Ha22yX/Gridopoly/Mechanical/BoardBase/README.md

# Gridopoly 棋盘底板

## 当前交付：16 模块中空环形底板 Full16 R1

2026-10-15，用户提供三张实装照片，确认原三模块角落底板“完美兼容”；同时明确中央留空，允许分成两块或四块打印后稳固拼合。本轮采用 **4 个相同 L 形主件＋8 片连接片**，保持原 R2 孔位、16 mm 板底高度与底面平整设计。每主件承载一角三长；完整环为四角十二长，每边含共享角落共五块。

完整打印及装配说明见 [Full16_R1/README.md](Full16_R1/README.md)。文件入口：[Full16 R1交付目录](deliverables/Gridopoly_BoardBase_Full16_R1/) · [L形主件3MF](deliverables/Gridopoly_BoardBase_Full16_R1/01_L_Quarter_PRINT_4.3mf?raw=true) · [连接片3MF](deliverables/Gridopoly_BoardBase_Full16_R1/02_Splice_Bridge_PRINT_8.3mf?raw=true) · [可编辑Blender工程](deliverables/Gridopoly_BoardBase_Full16_R1/Gridopoly_Full16_R1.blend?raw=true) · [完整归档ZIP](deliverables/Gridopoly_BoardBase_Full16_R1.zip?raw=true)。主框 366 mm 见方，包含外侧连接耳的最大尺寸 406 mm 见方；每个主件 171.35 × 234.35 × 16.8 mm。中央名义 190 mm 见方开口，内侧连接耳局部伸入开口。

三模块实装反馈与新整盘状态分别记录：**原角落首件配合已由用户确认；新整盘的长—长接缝、整圈闭合及拼接承载仍待实装**。历史 R2 检查报告保留其生成时的未打印标志，不回写成新的实测数据。以下为已通过角落试装的 R2 几何与紧固件基线。

## 项目内模型与历史归档

全部底板设计、打印文件、可编辑工程和说明保存在仓库的 `Mechanical/BoardBase/` 内，以下使用可随仓库分发的相对链接；后续版本也按此规则保存，Downloads只作为可选分发副本。以下归档从原交付逐文件复制并核对，原模型、ZIP及冻结检查记录保持不变；包内旧Downloads路径仅记录当时的生成位置。历史STL/3MF保留用于比较和复现，公开文件不表示该历史版本适合新打印。

| 版本 | 项目内入口 | 使用状态 |
|---|---|---|
| Full16 R1 | [目录](deliverables/Gridopoly_BoardBase_Full16_R1/) · [ZIP](deliverables/Gridopoly_BoardBase_Full16_R1.zip?raw=true) | 当前16模块方案；全环打印、试装及拼接承载待验证 |
| 三模块R2 | [目录](deliverables/Gridopoly_BoardBase_Test_R2_PRINT_FRIENDLY/) · [ZIP](deliverables/Gridopoly_BoardBase_Test_R2_PRINT_FRIENDLY.zip?raw=true) | 用户已确认角落实装兼容的基线 |
| 三模块R1 | [历史目录](deliverables/Gridopoly_BoardBase_Test_R1_ONE_PIECE/) · [历史ZIP](deliverables/Gridopoly_BoardBase_Test_R1_ONE_PIECE.zip?raw=true) | 旧底面螺母槽方案，已被R2取代，不作为当前打印依据 |
| R0 | [历史目录](deliverables/Gridopoly_BoardBase_Test_R0/) | 已废弃的独立模块底座，不打印 |

## 三模块首件 R2 基线

基线版本：**R2_PRINT_FRIENDLY，几何复核通过，用户已确认角落实装配合正常**。保持一块连续 L 形底板，固定一个角落 PCB 和相邻两块长边 PCB；每板两颗对角螺丝。12 根支撑柱与底板一体打印，其中 6 根锁紧、6 根辅助承托和定位。照片没有确定所用螺钉的具体牙型、垫片厚度或抗拔强度。

针对 R1 底部螺母槽的槽顶悬空问题，R2 **取消全部底面螺母槽及螺丝通孔，改为从柱顶进入的盲孔与塑料专用螺钉**。打印时平底贴床、柱子向上，底板及柱子由下向上连续生长；不再依赖槽顶桥接。R1 保留归档，不再作为本版紧固件或打印说明。R0 独立模块底座及滑动连接方案仍已废弃。完整 16 模块继续要求一个整体底板、每模块固定位置。

## 交付文件

项目内交付目录：[Gridopoly_BoardBase_Test_R2_PRINT_FRIENDLY](deliverables/Gridopoly_BoardBase_Test_R2_PRINT_FRIENDLY/)；[完整归档ZIP](deliverables/Gridopoly_BoardBase_Test_R2_PRINT_FRIENDLY.zip?raw=true)。

| 文件 | 用途 |
|---|---|
| 整体底板：[3MF](deliverables/Gridopoly_BoardBase_Test_R2_PRINT_FRIENDLY/ONE_PIECE_Corner_Test_R2.3mf?raw=true) / [STL](deliverables/Gridopoly_BoardBase_Test_R2_PRINT_FRIENDLY/ONE_PIECE_Corner_Test_R2.stl?raw=true) | 整体底板打印模型，毫米单位、100% 比例；3MF 不含打印机或耗材预设 |
| 试孔片：[3MF](deliverables/Gridopoly_BoardBase_Test_R2_PRINT_FRIENDLY/Screw_Fit_Coupon_R2.3mf?raw=true) / [STL](deliverables/Gridopoly_BoardBase_Test_R2_PRINT_FRIENDLY/Screw_Fit_Coupon_R2.stl?raw=true) | 可选的螺钉试孔片，先用实际 PLA 与螺钉选择孔径；不是单模块底座 |
| [Gridopoly_OnePiece_Corner_Test_R2.blend](deliverables/Gridopoly_BoardBase_Test_R2_PRINT_FRIENDLY/Gridopoly_OnePiece_Corner_Test_R2.blend?raw=true) | 可编辑场景；默认仅显示打印底板，PCB 参考对象隐藏，可在 Outliner 中取消隐藏；参考对象不打印 |
| `fixture_frame.png` / `fixture_assembled.png` | 底板及装板示意 |
| `mounting_post_section.png` | 实际模型柱截面，说明顶开盲孔和实心底部；仅供查看 |
| `fixture-config.json` / `rebuild_in_blender.py` | 参数及重建来源；重建时新建 R2 场景，保留原有 R1 场景 |
| `verification-report.json` / `assembly-verification.json` | 本版导出网格及装配几何复核记录，须以文件实际版本和状态为准 |
| `README.md` | 本说明 |

不要把 Blender 中的参考 PCB、螺钉、相机或背景地面一起导出打印。试孔片与底板分别导出，避免误认为两个零件需要拼装。

## 尺寸与孔柱

| 项目 | R2 名义值 |
|---|---|
| 底板外接尺寸 | 151 × 151 mm，L 形连续实体 |
| 平板厚度 | 3.5 mm，底面平整、无螺母槽 |
| PCB 底面离桌面 | 16 mm |
| PCB 板厚 | 用户提供约 1.6 mm |
| 最大打印高度 | 16.8 mm，包含未锁紧孔内的定位销 |
| 支撑柱与 PCB 接触外径 | 6 mm |
| 六个锁紧柱盲孔 | 候选直径 2.5 mm，从柱顶向下深 10 mm，孔底距桌面 6 mm |
| 盲孔顶端导向沉孔 | 直径 3.6 mm、深 1.2 mm；孔周接触环保持外径 6 / 内径 3.6 mm |
| 辅助定位销 | 直径 2.8 mm、高 0.8 mm |
| 辅助承托 | 每板第三点与主柱等高；第四点低 0.2 mm，避免四点硬顶 |
| 最大板底突出 | 用户测得两种模块均约 8.1 mm |
| 元件与底板顶面的名义余量 | 16 − 8.1 − 3.5 = **4.4 mm** |

按 PCB 接口文件的原方向、器件面俯视：角落板锁紧左上 TL 和右下 BR；长边板各锁紧右上 TR 和左下 BL。PCB 在底板上旋转后，仍使用其本板对应的这两个孔。孔柱坐标、板间候选间距和一体底板关系均沿用 R1。

## 紧固件与先试孔

- **塑料专用盘头自攻／螺纹成形螺钉：6 颗**，公称螺纹外径 **3.0 mm**、头下长度 **10 mm**，头部外径不超过 **6 mm**。这不是原 R1 的 M3 机螺钉；不要按“M3×10 机螺钉”代购，也不用沉头螺丝压 PCB。
- **垫片：6 片**，内径约 **3.2 mm**、外径不超过 **6 mm**、厚 **1.0 mm**。两片 0.5 mm 可叠为一组，此时共需 12 片。
- **不使用螺母**，也不需要底板拼接螺丝。

名义入柱深度为 10 − 1.6 − 1.0 = **7.4 mm**；扣除顶部 1.2 mm 导向段后，位于小孔段的长度为 **6.2 mm**，实际完整牙型啮合还须扣除螺钉尖端。盲孔底名义余量为 10 − 7.4 = **2.6 mm**。这些为尺寸链计算，不是拧紧或抗拔实测。

**2.5 mm 是待试配的孔径，不代表适合所有 3 mm 螺钉。** 孔径要随塑料、牙型及打印结果选择；[TR 塑料螺钉安装指南](https://www.trfastenings.com/knowledge-base/fasteners-for-plastic/plas-tech-30-installation-guide)也按具体材料和螺钉几何给出孔径建议，其表格不是本 PLA 打印件的验证结果。

建议先打印 **34 × 14 × 16 mm** 的试孔片。三个柱中心依次为 (6,7)、(17,7)、(28,7) mm，孔径依次为 **2.4、2.5、2.6 mm**；(0,0) 角的缺角靠近 **2.4 mm** 端。使用将要装配的同一螺钉，并用约 2.6 mm 的非 PCB 垫块模拟板厚及垫片，控制入柱深度。徒手缓慢试拧，选择能够形成螺纹、轻夹紧且不劈裂或滑牙的孔；不可大力拧入代替选孔。若 2.5 mm 不合适，先改底板孔径再重印，不能整体缩放底板。此结构不适合频繁拆装。

## H2D / PLA 首印

底板平面贴床、柱子向上，保持毫米单位和 100% 比例。151 × 151 mm 可在 H2D 上平放。按 0.4 mm 喷嘴给出起始建议：0.20 mm 层高、4 道墙、顶底各 5 层、约 20% 填充；实际以所用 PLA 和喷嘴配置为准。

R2 从结构上取消了底部槽顶桥接，按无需全局支撑的方向设计；仍需在 Bambu Studio 逐层预览检查柱根、盲孔、导向口与定位销，并确认没有悬空的参考 PCB 被误导入。必要时可加约 5 mm 外侧裙边来降低大平底翘曲。清除毛边后再试装，不要改变整体比例。

原始交付时未执行 Bambu Studio 切片或实打印；2026-10-15 用户随后提供打印件照片并确认角落配合正常。该反馈不能扩展为新 16 模块底板的切片、强度或全环实装通过。

## 首次试装

1. 先完成试孔片配合检查；底板打印冷却后确认平整、柱子无裂纹，孔内无毛边。
2. 先不通电，将一角两长 PCB 自然插好并保持共同板面。不装螺丝，三板应一起自由落到孔柱上；不能拉扯或压弯连接器来对孔。
3. 检查板底元件和焊点不碰底板，柱顶只接触孔周安全环面，USB/DC 等接口与工具仍有操作空间。渲染图不包含全部元件和插头。
4. 每板只在指定两个对角孔放垫片、装螺钉，交替缓慢轻拧到刚好夹紧。遇到显著阻力、柱裂或空转立即停止；不使用电动工具强拧，不靠锁紧力消除翘曲或孔位误差。
5. 检查三板仍共面、底板不摇晃、螺钉不顶穿孔底，接口可插拔。其余辅助柱无需螺钉。

**角落—长边的固定位置已由本次三模块实装反馈确认。** g = 9 mm 原先由用户约 12 mm（角落—长边）、15 mm（长边—长边）的主体直边间距扣除长边接口凸出量推算；新增长边—长边位置仍需在 Full16 R1 的一个 L 形主件上先试装。成功的角落首件不包含长—长接缝，也不等于完整闭环已验证。本设计没有滑块或可调安装位置。

## 检查状态与来源

R2 已独立复核本版导出物：主件为一个闭合连通实体，4944 个唯一顶点、9884 个三角面，尺寸 151 × 151 × 16.8 mm；试孔片也是一个闭合实体，1366 个唯一顶点、2728 个三角面，尺寸 34 × 14 × 16 mm。两者均无边界边、非流形边、反向接边或退化面。各 3MF 采用毫米单位、单对象，几何与对应 STL 一致，压缩包 CRC 检查通过。

按柱向上、沿 +Z 逐层打印的方向，除 z=0 贴床底面外，两件模型均未检测到向下悬挑面（侧壁浮点角度噪声容差 0.01°）。底板与三块带孔 PCB 参考板材的布尔相交体积各小于 1×10⁻¹³ mm³，属数值舍入级别。这些检查不等于切片、打印或元件实物配合验证，也不证明塑料螺纹强度。R1 的板框和孔位来源继续沿用；本段网格结果属于重新检查的 R2。

PCB 来源为长边 PCB2_1 / `7840864f79449b47` 和角落 PCB2_5 / `6f97d7be5a40dd66`。冻结接口从当前工程、Gerber 与钻孔文件核对板框、名义 Ø3.5 mm 安装孔和外径 6 / 内径 3.6 mm 的安全支撑环。111 个底部 XY 排除区仍缺逐件 Z，最高突出采用用户约 8.1 mm 的量测。

冻结数据：[mechanical-interface.json](interfaces/pcb-interface-2026-10-15/mechanical-interface.json)，SHA256：`e78d4cbc840f58c6564f7e6513c5992925e54811c4d39e5e01467c7390e53df6`。交接包内旧 14 mm 高度、可调支架或滑移建议被整体固定底板要求覆盖，原始包不改写。当前实板批次尚未与制造文件哈希绑定，必须通过首件确认实物配合。

## 完整 16 模块方案沿革

继续采用**拼合后整体承力的底板，固定 4 个角落和 12 个长边模块**。2026-10-15 用户已确认角落首件配合，并授权分块打印。

按 g = 9 mm，PCB 周边外宽为 2×80 + 3×54 + 4×9 = **358 mm**；加两侧各 4 mm 余边后主框约 **366 mm**，超过 H2D 常规单喷嘴平放范围 325×320 mm（[Bambu H2D 官方规格](https://cdn1.bambulab.com/documentation/h2d/en/H2D_Laser_Full_Combo_20250305.pdf)）。现已落实为 [Full16 R1 四块主件方案](Full16_R1/README.md)，每道拼缝由内、外两片连接片固定，底板自身承担拼接连接。原三模块文件保持不变，整盘新增模型单独检查和交付。
