Ha22yX/Gridopoly/Docs/gallery/README.md

# From my workbench / 实物照片集

[← English README](../../README.md) · [← 中文README](../../README.zh-CN.md) · [PCB files / PCB设计](../hardware/README.md) · [Print files / 打印模型](../../Mechanical/README.md)

From an empty circuit board to something I can pick up and play with. These are the real parts behind Gridopoly, including the awkward in-between stages.

从一块还没焊元件的PCB，到能拿在手里的棋盘。这些照片记录的是Gridopoly实际做出来的样子，也包括装配到一半的过程。

**All 11 photos added on October 18, 2026 are below.** Click a photo for a larger, unannotated JPEG. The photos show several prototype stages; use the hardware and model guides for current assembly files. Original HEIC files remain untouched; these web copies have been resized, converted to sRGB, and stripped of camera metadata.

**本次11张照片都在下面。** 点击可以查看较大的无标注JPEG。照片包含不同阶段的原型，复刻时请以硬件和模型文档为准。HEIC原文件没有改动；仓库提供缩放、转换为sRGB并移除拍摄元数据的网页版本。

## The whole board / 先看整盘

<table>
  <tr>
    <td align="center" valign="top">
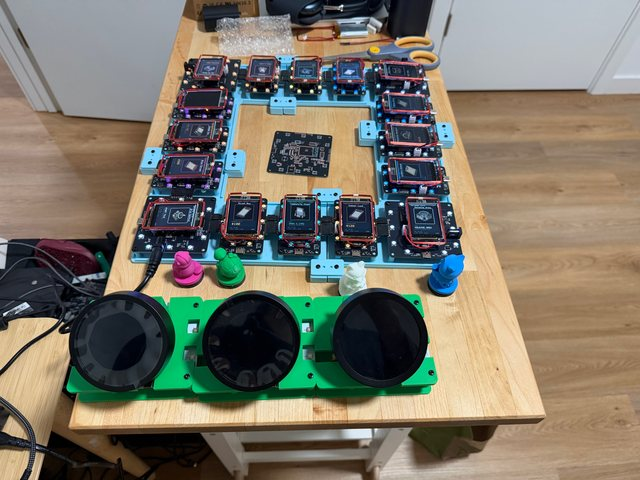
[picture p5: .github/assets/photos/2026-10-18/thumbs/gridopoly-workbench.jpg]
The powered 16-tile board, four pieces and three player consoles in this photo.
      <br />
      <strong>The board on my workbench<br />工作台上的整套原型</strong><br />
      <sub>The powered 16-tile board, four pieces and three player consoles in this photo.<br />照片里是已点亮的16格棋盘、4枚棋子和3台玩家控制器。<br />IMG_1957.HEIC</sub>
    </td>
    <td align="center" valign="top">
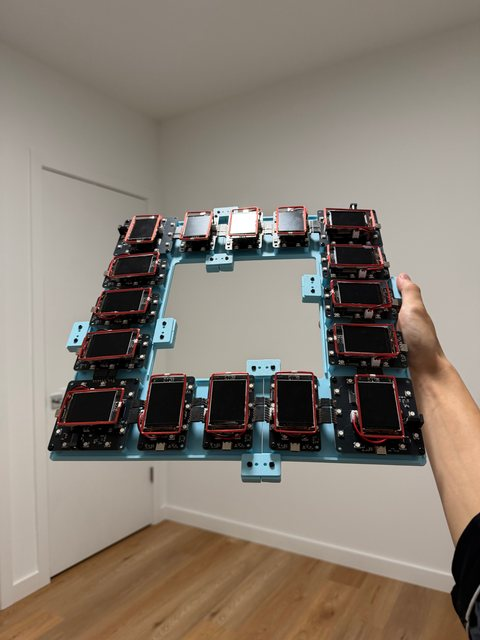
[picture p6: .github/assets/photos/2026-10-18/thumbs/assembled-board-frame.jpg]
The assembled board held upright, with the displays off.
      <br />
      <strong>Sixteen modules, one frame<br />16块模块，拼成一整盘</strong><br />
      <sub>The assembled board held upright, with the displays off.<br />竖起来看的整盘结构；拍摄时屏幕未点亮。<br />IMG_1949.HEIC</sub>
    </td>
  </tr>
</table>

## A controller of your own / 每个人的控制器

<table>
  <tr>
    <td align="center" valign="top">
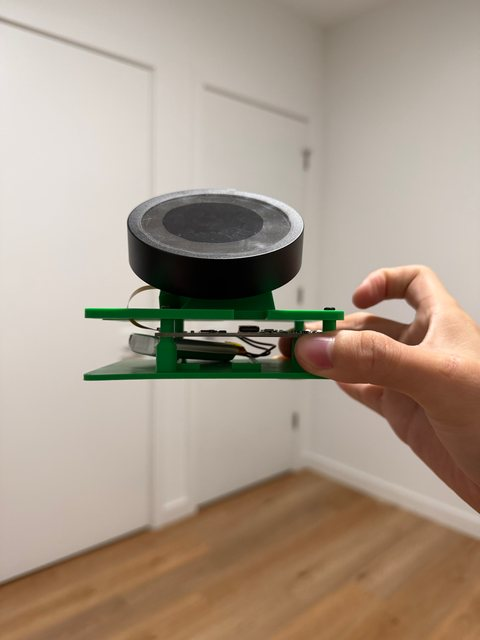
[picture p7: .github/assets/photos/2026-10-18/thumbs/player-console-side.jpg]
The round screen, power board and battery share one printed stand.
      <br />
      <strong>A controller, from the side<br />玩家控制器的侧面</strong><br />
      <sub>The round screen, power board and battery share one printed stand.<br />圆屏、供电板和电池装进同一套打印支架。<br />IMG_1947.HEIC</sub>
    </td>
    <td align="center" valign="top">
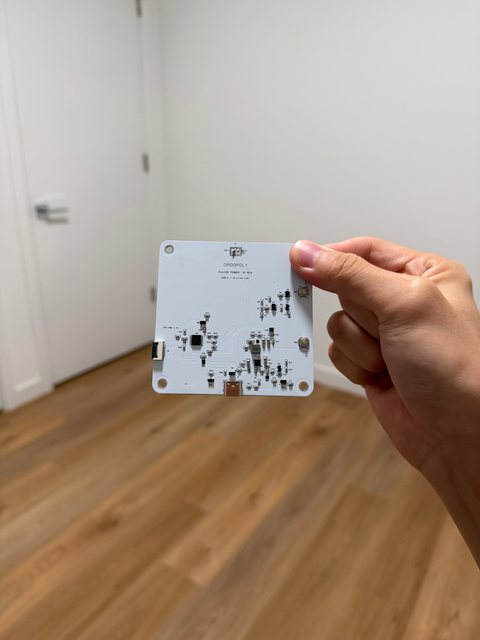
[picture p8: .github/assets/photos/2026-10-18/thumbs/player-power-board.jpg]
The photographed prototype is marked PLAYER POWER R1 RC4.
      <br />
      <strong>The player power board<br />玩家供电板</strong><br />
      <sub>The photographed prototype is marked PLAYER POWER R1 RC4.<br />照片中的原型板标有PLAYER POWER R1 RC4。<br />IMG_1951.HEIC</sub>
    </td>
    <td align="center" valign="top">
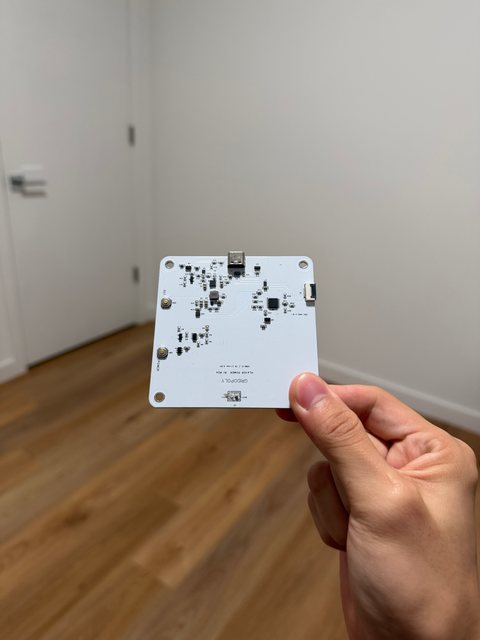
[picture p9: .github/assets/photos/2026-10-18/thumbs/player-power-board-reverse-view.jpg]
A close look at the player power PCB and its connectors.
      <br />
      <strong>Another look at the power board<br />换个角度看供电板</strong><br />
      <sub>A close look at the player power PCB and its connectors.<br />玩家供电PCB和接口的近照。<br />IMG_1950.HEIC</sub>
    </td>
  </tr>
</table>

## What goes into a tile / 拆开看一个格子

<table>
  <tr>
    <td align="center" valign="top">
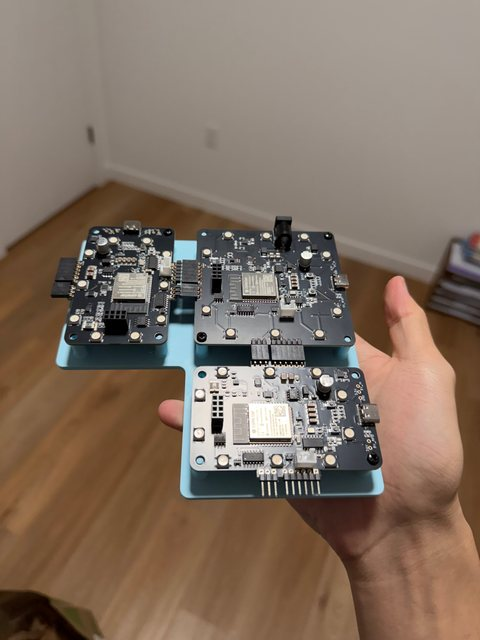
[picture p10: .github/assets/photos/2026-10-18/thumbs/tile-corner-assembly.jpg]
One corner PCB and two long tile PCBs on a printed base.
      <br />
      <strong>How a corner joins the board<br />角落与长边怎样相连</strong><br />
      <sub>One corner PCB and two long tile PCBs on a printed base.<br />一块角落PCB与两块长边PCB，固定在打印底座上。<br />IMG_1948.HEIC</sub>
    </td>
    <td align="center" valign="top">
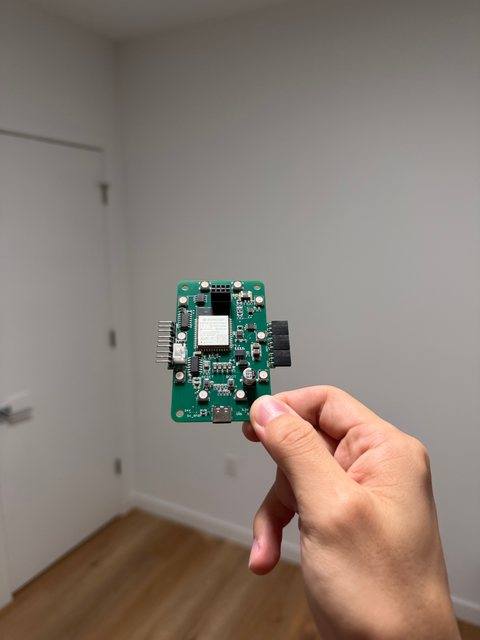
[picture p11: .github/assets/photos/2026-10-18/thumbs/long-tile-pcb.jpg]
The populated long tile PCB, with its ESP32 module and perimeter LEDs.
      <br />
      <strong>Before fitting the display<br />安装屏幕之前</strong><br />
      <sub>The populated long tile PCB, with its ESP32 module and perimeter LEDs.<br />焊好元件的长边PCB，可以看到ESP32模组和周围的LED。<br />IMG_1952.HEIC</sub>
    </td>
    <td align="center" valign="top">
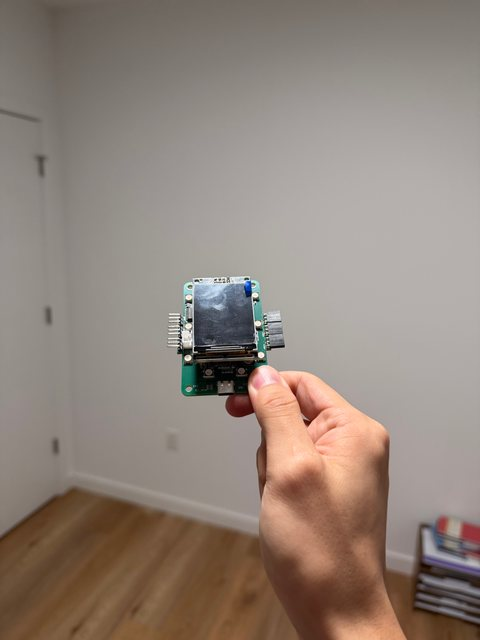
[picture p12: .github/assets/photos/2026-10-18/thumbs/long-tile-with-display.jpg]
The same style of long tile module with the LCD in place.
      <br />
      <strong>With the display fitted<br />装上屏幕之后</strong><br />
      <sub>The same style of long tile module with the LCD in place.<br />长边模块装上LCD后的样子。<br />IMG_1953.HEIC</sub>
    </td>
  </tr>
  <tr>
    <td align="center" valign="top">
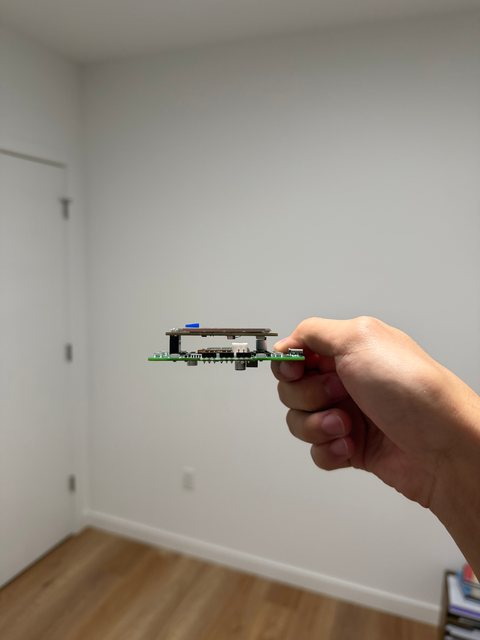
[picture p13: .github/assets/photos/2026-10-18/thumbs/tile-display-side.jpg]
A side view of the LCD, PCB and mounting standoffs.
      <br />
      <strong>A little space underneath<br />屏幕下面留出的空间</strong><br />
      <sub>A side view of the LCD, PCB and mounting standoffs.<br />从侧面看LCD、PCB和安装支柱之间的距离。<br />IMG_1954.HEIC</sub>
    </td>
    <td align="center" valign="top">
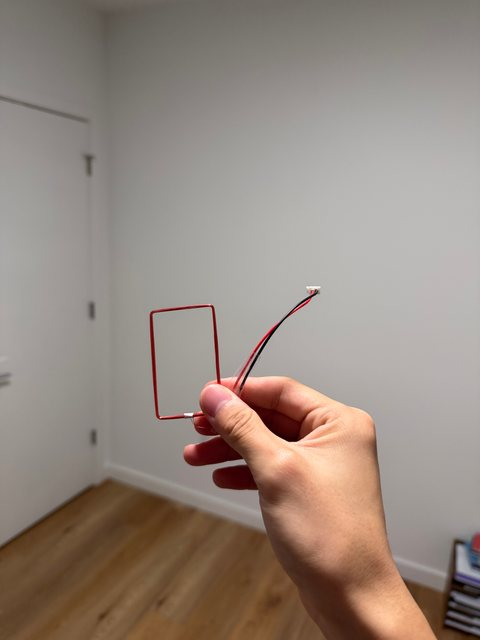
[picture p14: .github/assets/photos/2026-10-18/thumbs/rfid-coil.jpg]
The rectangular RFID antenna before mounting around a display.
      <br />
      <strong>The coil around each tile<br />每个格子的读卡线圈</strong><br />
      <sub>The rectangular RFID antenna before mounting around a display.<br />围到屏幕周围之前的矩形RFID天线。<br />IMG_1955.HEIC</sub>
    </td>
    <td align="center" valign="top">
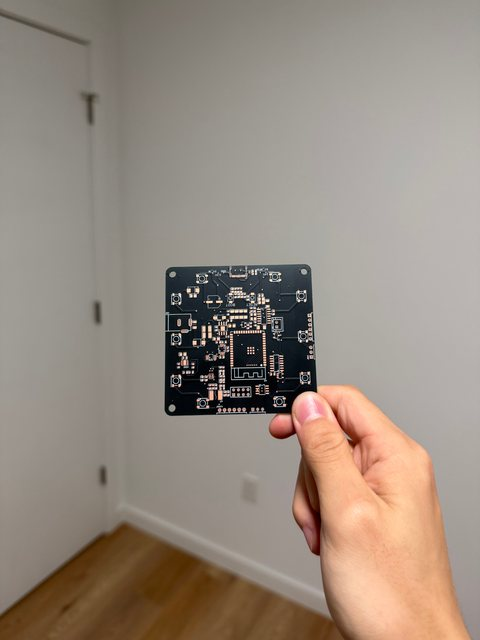
[picture p15: .github/assets/photos/2026-10-18/thumbs/unpopulated-tile-pcb.jpg]
An unpopulated tile PCB: the traces and component pads are visible.
      <br />
      <strong>Before the components go on<br />还没有焊上元件的时候</strong><br />
      <sub>An unpopulated tile PCB: the traces and component pads are visible.<br />尚未贴装的格子PCB，能看到走线和元件焊盘。<br />IMG_1956.HEIC</sub>
    </td>
  </tr>
</table>

## A few labels help / 加上引导线看结构

These are edited, annotated guides based on the real photos. The unannotated views above and below remain available for comparison. / 下面是基于实拍照片制作的标注版；上方和下方保留无标注版本，方便对照。

<table><tr>
<td width="33%" align="center"><a href="../../.github/assets/photos/2026-10-18/annotated/player-console-annotated.jpg">Player console / 玩家控制器, with component labels and leader lines</a><br /><strong>Player console / 玩家控制器</strong></td>
<td width="33%" align="center"><a href="../../.github/assets/photos/2026-10-18/annotated/tile-corner-annotated.jpg">Tile connections / 格子连接, with component labels and leader lines</a><br /><strong>Tile connections / 格子连接</strong></td>
<td width="33%" align="center"><a href="../../.github/assets/photos/2026-10-18/annotated/rfid-piece-annotated.jpg">Figure + tag / 角色与标签, with component labels and leader lines</a><br /><strong>Figure + tag / 角色与标签</strong></td>
</tr></table>

<details>
<summary><strong>Earlier build photos / 之前的开发照片（4张）</strong></summary>

<table>
<tr>
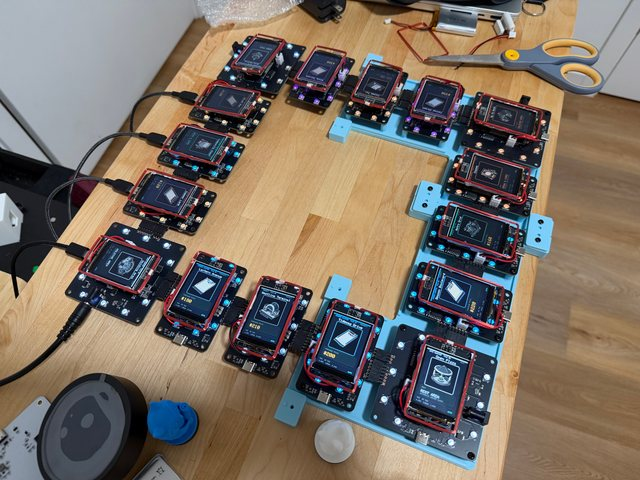
[picture p16: .github/assets/photos/2026-10-18/thumbs/gridopoly-16-tile-board-earlier.jpg]
An earlier workbench view / 早期整盘工作台照片
<td width="50%" align="center"><br /><sub>An earlier workbench view / 早期整盘工作台照片</sub></td>
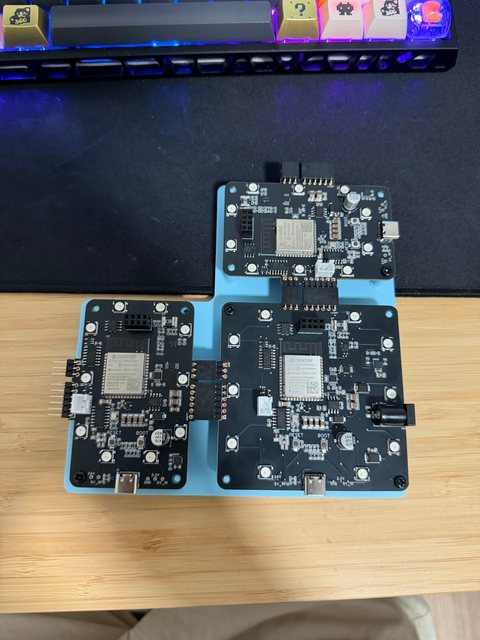
[picture p17: .github/assets/photos/2026-10-18/thumbs/gridopoly-pcbs-and-base-earlier.jpg]
Tile PCBs and a corner base / 格子PCB与角落底座
<td width="50%" align="center"><br /><sub>Tile PCBs and a corner base / 格子PCB与角落底座</sub></td>
</tr>
<tr>
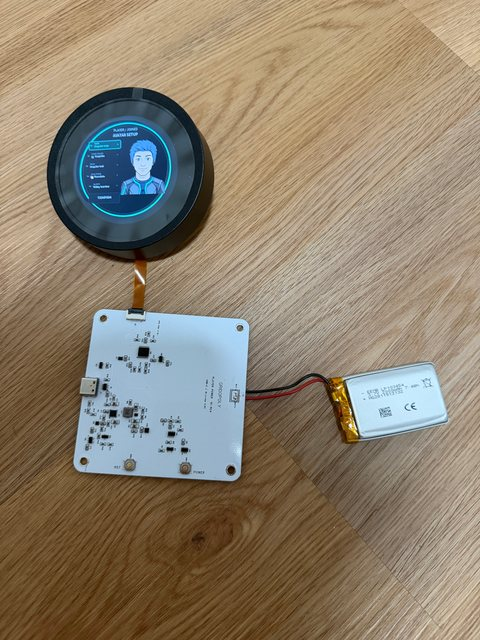
[picture p18: .github/assets/photos/2026-10-18/thumbs/gridopoly-player-console-and-power-earlier.jpg]
Player screen, PCB and battery / 玩家屏、供电板和电池
<td width="50%" align="center"><br /><sub>Player screen, PCB and battery / 玩家屏、供电板和电池</sub></td>
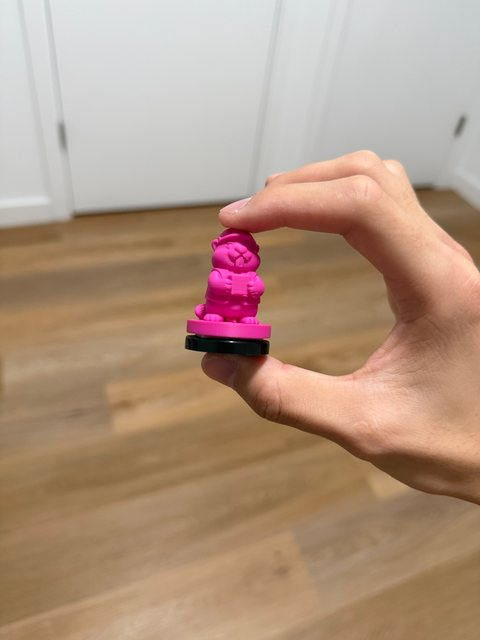
[picture p19: .github/assets/photos/2026-10-18/thumbs/gridopoly-rfid-piece-earlier.jpg]
Printed figure and RFID tag / 打印角色与RFID Tag
<td width="50%" align="center"><br /><sub>Printed figure and RFID tag / 打印角色与RFID Tag</sub></td>
</tr>
</table>

</details>

[Photo sources and editing notes / 照片来源与标注说明](../../.github/assets/photos/README.md) · [Back to the documentation / 返回文档中心](../README.md)
