Ha22yX/Gridopoly/Firmware/TileModule/README.md

# Gridopoly 单格模块正式固件

这是格子模块的正常游戏固件工程。当前源码候选版本为 V0.37，增加地产建房图的RAM按需下载，保留V0.36屏幕旋转180°、V0.35低亮灯效、板型配置、ORDER直邻信标与权威RFID配对（含Tag发布重试）、WS2812B-B-V6时序和有界灯光维护：模块上电后连接树莓派专用热点，
通过HTTP心跳注册、接收显示状态并上报实际ORDER上游。RS485仍未启用。
测试程序仍独立保存在 `Firmware/TileModuleTests/`，不得把循环跑灯、纯色屏幕等
首板测试流程并入本工程。

正式 ESP32-S3 构建明确排除 `demo_engine.cpp`；该文件只保留给 native 状态模型测试，
不会进入格子模块正式固件，也不会在未分配时生成任何本地地产页面。

## V0.37 建房图 RAM 缓存

0级图及非地产图继续嵌入固件，不请求新资源。只有当前已分配地产的`artworkKey`＋`buildingLevel=1..5`进入下载，1～4为房屋、5为旅馆；不会按地图序号选图，也不在分配时预抓五级。权威`assignment.buildingLevel`缺失兼容为0，非整数或超出0～5拒绝；无主及非地产投影为0。

图片路径固定为`/assets/development/v1/tile/{artworkKey}-l{level}.rgb565`，HTTP主机/端口和心跳共用`tile_http_endpoint.h`及本地配置。独立单worker只保留一个在途请求，初始250～2000ms错峰，失败1s起指数退避到30s加jitter，并尊重503/429的Retry-After。离线不启动HTTP，重连错峰；切换地产、退回0级和重复心跳不能清除服务端退避。

160×160 RGB565 LE图必须有精确51200字节Content-Length和共享目录中的CRC；不接受压缩、分块、截断或错误图。最多5张ready＋1张staging，图像PSRAM payload上限307200字节（栈/队列/HTTP对象另计），仅RAM保存，重启清空。下载线程只写staging，主显示线程核对选择代号后发布；切换期间的旧结果丢弃，绘图lease防止LRU回收正在读取的图。分配失败或HTTP错误保留固件0级图和准确等级徽标，不阻塞主循环等网络。

`ART PROBE a1-rivet-row 1`使用同一生产worker/CRC/缓存，显示明显TEST预览，30秒后恢复最新权威页面；可换成目录中任一地产key与1～5级。`ART STATUS`输出请求、发布、命中、内存和失败情况；`ART STOP`立即恢复。该有界本地预览不修改分配、资产、Tag或服务器状态，也不暂停RFID/ORDER。内存按需分配后保留复用，所以`peak_ram`等于当前分配图像字节数。

普通候选仍基于已部署V0.36隔离源码叠加本轮差异，排除共享树中旧COM8 stage2诊断。导出清单记录两份共享头的哈希；若直接用含诊断的共享main构建，清单会标记`normalFirmware=false`，不得用于普通批量更新。测试、候选及实物边界见[专项报告](../../Docs/firmware/tile-development-artwork-cache-2026-10-16.md)。

## V0.36 屏幕方向与恢复（V0.37保留）

`board_config.h`统一指定硬件`kDisplayRotation=2`；LCD和逻辑页面均保持240×320，页面及底栏canvas固定rotation0。整页差分、160×160图片、底栏局部刷新、无PSRAM直接绘制及诊断页均交由同一ST7789方向寄存器旋转，不倒序像素、不交换宽高或额外平移坐标。

已核对固定Adafruit ST7735/ST7789 1.11.0实现：240×320的两组行列偏移均为0；rotation0的MADCTL为MX|MY|RGB，rotation2为RGB，MV不置位。初始化和`DISPLAY SAFE`/恢复时都先在8MHz写入rotation2，再恢复所选绘图速率；显示shadow随控制器初始化失效，下一次提交完整页面。默认SPI仍8MHz，背光保持150。

初始化及`STATUS`新增`DISPLAY-ORIENTATION`，正常应为`rotation=2 degrees=180 width=240 height=320 canvas_rotation=0 footer_rotation=0`。该记录是驱动软件状态，并非LCD寄存器读回或实物方向验收。正常long/corner候选由`59efe7a`基线叠加`5522d179`已提交低亮变更与本次方向/版本差异生成，不含COM8 stage2 RFID诊断；旧V0.35候选和冻结包保留。实际写验、方向/裁切/亮度目视由设备台账另记，构建通过不等于已部署。

## V0.35 灯环亮度与维护（V0.36保留）

所有正常灯效在原有颜色和动画计算后统一缩为V0.34驱动幅值的四分之一（整数向下取整），覆盖连接/故障、地区/所有者/占用、出发/目标及全部配对状态。目标双闪峰值由RGB(23,62,51)变为(5,15,12)，配对成功由(11,54,23)变为(2,13,5)，出发峰值由(59,35,18)变为(14,8,4)；周期和优先级不变。低于4的旧输出量化为0，目标双闪间隔因此为全黑。实际观感需单板目视，不能把驱动幅值比例当作测得的视觉亮度。

`showPixels`在所有发送前强制每通道不超过16/255；当前正常场景的实际最大通道为15/255。维护RGB仍固定8/255并通过同一硬上限，不重复乘四分之一。`kMaximumLedChannel`现在是执行中的上限，V0.34中它只有定义/测试约束，不能只改旧常量就认为已经调暗。没有远程亮度API，`BRIGHTNESS`仍只控制LCD，本轮没有提高背光。

本轮normal long/corner低亮候选从已部署`59efe7a`源基线叠加LED变更独立构建、默认8MHz，不包含COM8的stage2 RFID试读入口。工作区保留该独立诊断源码；直接从当前完整工作区重构建与本轮隔离候选不等价，应核对candidate源码清单。V0.35构建时16板仍为V0.34；2026-10-16开始V0.36逐板升级，实际版本与目视结果见[本次更新](../../Docs/firmware/tile-display-rotation-2026-10-16.md)，旧冻结包不回写。

采用实际 WS2812B-B-V6 数据表的参数：RMT计数16MHz/62.5ns，0码高312.5ns/低937.5ns，1码高625ns/低625ns，显式帧间低电平350µs。V0.33的1码低电平500ns低于该型号580ns最小值；原常规50ms帧间隔已经满足复位时间，不把原80µs显式延时说成所有帧均未复位。

原生ESP-IDF RMT后端核对实际计数时钟，记录初始化、写入、20ms完成等待和停止错误；发送失败后停止自动续发。`STATUS`或`LED STATUS`输出requested_rgb、实际计数时钟、attempted/completed/failed、错误阶段和维护剩余时间。completed仅表示外设完成，不证明数据线波形或实际灯色。

仅显式串口维护命令可以暂时覆盖游戏灯效：`LED OFF 1..30`秒输出全黑；`LED RED|GREEN|BLUE 1..30`秒固定单通道8/255，其余两通道为0；到期永久恢复当前游戏灯效，`LED AUTO`可以提前恢复。没有全白/高亮模式，不写NVS、房间、Tag或服务器分配，重启即回普通模式。未知参数和超长串口整行被拒绝，不执行截断前缀。`BRIGHTNESS`仍只控制LCD背光。

2026-10-15的新时序为软件修正候选，灯环纯白的具体实物根因仍需受控验证；构建或主机测试不能代替真实颜色、功耗及整盘验收。精确型号依据[厂家数据表第4页](https://atta.szlcsc.com/upload/public/pdf/source/20251224/2F6ED8FFFF9D3044AED3CCAA3E4BF0D9.pdf)。

## 当前功能

- ORDER_OUT经Q1开漏每6秒发送本机bootId/seq/CRC信标，GPIO10 LOW为释放，HIGH使下游线LOW；GPIO9经现有RC接收实际邻居信标，不使用Wi-Fi注册先后推断线序。
- 独立1ms定时状态机不等待HTTP或显示循环；超过6ms调度间断释放输出并弃帧，接收持续低150ms撤销上游；新有效帧15秒过期，同序号不会刷新证据。完整协议见 [ORDER协议](../../Docs/firmware/tile-order-protocol.md)。
- 心跳保留所有Tag字段，新增order boot/上游boot/seq/age/valid。服务器负责物理图与手动锚点推导；source=order保留在串口，不把旧服务端auto注册分配当物理排序。
- 同一固件按工厂MAC选择显示速率：本机配置的已验证COM6身份使用40MHz，其他模块回8MHz；无屏模块SPI只写不等待像素读回，可正常运行网络/ORDER。

- 自动连接 gridopoly 专用热点，默认服务器为 10.42.0.1:80。
- 模块不保存 BSSID 或频道，使用全信道 SSID 扫描；未关联满 10 秒时先取消失效的底层连接尝试再重新扫描，同时关闭 modem sleep、使用 19.5 dBm 发射功率。
- Wi-Fi 关联、DHCP 和 HTTP 是三个独立恢复阶段：关联每 10 秒重试，关联成功后给 DHCP 30 秒完整窗口；HTTP 不可达只重建 TCP 请求，不再拆掉健康的 Wi-Fi 与租约。
- 设备 ID 与模块 ID 始终使用 ESP32-S3 工厂 MAC；每次启动只生成一次本地无线会话 MAC，避免实体 RST 后被 AP 中残留的旧 station 阻塞，且不影响服务器手动分配。
- 每 2 秒通过 HTTP/1.1 持久连接向 /api/tile-modules/heartbeat 续租，避免反复 TCP/ARP 握手；服务器租约为 15 秒。
- 心跳 JSON 携带当前完整 Tag 报告：`tagReaderState`、本地 `tagRevision`、最多 6 个规范化 UID 和 `overflow`；稳定集合或读卡状态变化时立即补发一次，不等待下一个 2 秒周期。
- 网络缓存锁暂时不可用时，主循环会重试最新完整 Tag 报告；相同本地 UID 集合不会抑制失败重试，成功后的重复扫描也不会额外增加 revision。该修复不改变 HTTP wire 或读卡场时序。
- 只有 `stable` 且未溢出的完整集合可参与服务器自动到达；`scanning`、`fault` 和 `overflow=true` 只用于诊断，不会误触发游戏动作。
- 心跳响应携带 `movementCue`：目标格整圈绿色双闪，出发格整圈橙色呼吸；同一移动只在 revision 或 cue 内容变化时重置动画。
- 当前ORDER能力模块按物理链锚点或合法32环分配；无锚开链显示等待，不按注册顺序自动占格。只有缺少ORDER能力的旧模块保留最低空闲mapIndex自动认领兼容路径。
- 网页手动改派后立即显示新格，旧格同时释放；目标被其他在线模块占用时服务器返回冲突。
- Wi-Fi 或服务器暂时不可达时保留最后一次有效分配；首次收到服务器分配前只显示联网状态页，不显示本地默认地产。
- ST7789 240×320 竖屏正式界面，以 160×160 格子图片为视觉主体。
- INA226 实时显示 5V 电压、电流和功率。
- HTRC110 未检测到标签时每 400ms 发起一次只读 HITAG S Advanced UID REQUEST；单标签最多五次尝试内三次响应一致后，首页底部显示 32 位 UID。
- UID 响应发生碰撞时，固件选择时间上最早的完整 Advanced SOF，在同一载波会话中按真实首碰撞位展开 HITAG S AC SEQUENCE 前缀树；命令包含协议 CRC-8，结果去重、排序并最多保留 6 个 UID。
- 每个模拟采样相位连续确认两次碰撞；一次多标签复检最多执行三轮同相位枚举并合并 UID 集合，避免强耦合标签暂时遮蔽另一枚标签时把 `TAGS 2` 降成 `TAG 1`。
- 多标签集合每 500ms 复检；底栏显示总数并每 1.5 秒轮播一个 UID，例如 `TAGS 2  1/2 8EFA259D`，串口 `STATUS` 一次列出全部 UID。
- 每个已确认 UID 独立累计缺失证据：一次漏读继续保留，连续两次漏读即可缩减集合或显示 `NO TAG`；偶发边缘读数只降低证据一级，不再重新开始长计时。多标签移除通常在 0.5～1 秒内生效。
- 防碰撞树在单次开场 300ms 工作预算内运行，绝对场持续时间上限 350ms；每次扫描都检查 `ANTFAIL`、350mA 总电流、180mA 场增量、4.65V 欠压和 `TXDIS=1` 关场回读。
- 所有 RFID 命令仅包含 UID REQUEST 和 AC SEQUENCE，不发送 SELECT、READ、WRITE 或任何标签存储器写命令。
- 10 颗 WS2812 作为一个格子的整体灯环：正常状态下未购买显示地区色、已购买显示所有者色；移动提示优先于这些常态灯效。
- 服务器将 Tag 与玩家一对一绑定；目标格稳定读到该玩家 Tag 时，由服务器执行与玩家屏手动 `ConfirmPosition` 相同的权威事务，玩家屏手动确认入口始终保留。
- 正常占用状态仍使用整圈同步呼吸，不使用单颗玩家槽位灯。
- 内置完整 36 张 Grid City Street V3 设备图片：22 个地产、4 个交通、2 个设施、
  2 个卡片、2 个税费和4个角落；服务器分配任一正式 artworkKey 都可直接显示。
- 未分配状态明确显示启动、连接 Wi-Fi、注册服务器、在线等待分配或自动重连；整圈 LED 同步显示相应状态色。
- 连接页只在联网语义状态变化时整页绘制；500ms 动画仅更新省略号小区域，34px 底栏先在 RGB565 内存画布中完整合成，再一次性传到屏幕，避免“先清黑、后逐项写字”产生频闪。
- V0.29 起页面在 PSRAM 中合成，再与已提交影像比较，只传变化区域；相邻相同跨度行共用地址窗口。取消 assignment 一秒后补刷。分配失败明确报告 DIRECT_FALLBACK。
- ST7789 默认保持 8 MHz；所有像素传输均先复制到对齐内部 RAM 行缓冲。历史首板 Wi-Fi 活跃时 20MHz 不可靠，不能把新的 RAM 路径或无崩溃当作高频画面验证通过。
- `config/display.local.h` 为本机忽略配置，未配置时正常运行8MHz。当前模块 tile-288485ba9fe8 的40MHz实际换页已获用户“明显改善，图文完整”确认，故本机配置40MHz；通用ST7789V资料不保证此速率，其他板应单独验证。格式参见 `config/display.example.h`。
- `DISPLAY SPEED hz seconds` 仅开启 5～300 秒有界时钟实验，支持 8000000、16000000、20000000、26666667、32000000、40000000 Hz。到期自动回独立8MHz恢复档、重置控制器已知配置并恢复正常页面，恢复档不会随本机正常速率变化。实际硬件分频可能低于请求值，查看 DISPLAY-CLOCK/FRAME 日志。
- `DISPLAY FRAME` 不清屏、不重置，强制完整提交当前页面；`DISPLAY SAFE` 结束实验、以8MHz重新初始化控制器并恢复正常页面，重启才重新采用本机正常速率。超过16000像素的提交记录实际时钟、行范围、像素数和提交耗时。
- PlatformIO 串口监视器固定禁用 DTR/RTS，关闭监视器不会再复位 ESP32-S3、释放服务器租约或让屏幕回到 CONNECTING。
- USB Serial/JTAG 诊断输出使用 5ms 有限超时；服务器长期离线时即使没有打开串口监视器，日志缓冲满也只丢日志，绝不阻塞 Wi-Fi 重连与 HTTP 心跳任务。
- 未购买资产显示 PURCHASE PRICE 与黄色金额；已购买资产显示 OWNED BY、所有者名字、玩家席位色和建设状态。
- 顶部色带和图片边框始终显示资产所属地区颜色；include/tile_ui_theme.h 与玩家圆屏共享视觉 token 约定。
- 串口可打开诊断页、调节背光并查询当前状态。
- 上电时 RS485 DIR、ORDER_OUT 保持安全低电平。
- HTRC110 外部 4 MHz 时钟稳定 15 ms 后，正式固件立即三次尝试写入并读回
  `Config Page 1 TXDIS=1`；只有受保护的短时 UID 扫描才启用场，所有退出路径都重新验证关场。

当前界面使用 Adafruit GFX 内置 ASCII 字体和项目已有的完整 StreetV3 正式图片。服务器 DTO
已经接入 TileState；尚未内置的地图图片会显示 ARTWORK PENDING，但名称、类型、地区色、
价格和所有者仍可正常同步。中文字库尚未内置。36张原创素材供16/24/32/40地图复用，格数不等于独立图片数量；新artworkKey仍需显式加入资源。
## 构建与烧录

```powershell
pio test -d Firmware/TileModule -e native
pio run -d Firmware/TileModule -e tile_esp32s3
pio run -d Firmware/TileModule -e tile_esp32s3 -t upload
pio device monitor -d Firmware/TileModule -b 115200
```

目标硬件为 ESP32-S3-WROOM-1-N16R8；PlatformIO 已配置 16MB Flash、OPI PSRAM、
USB CDC、Arduino 框架、Adafruit GFX 和 Adafruit ST7789。

## 联网配置与状态

Wi-Fi 密码不得写入仓库。格子固件优先读取自己的 config/secrets.local.h；若不存在，
开发工作区会复用 Firmware/PlayerConsole/config/secrets.local.h 中已经配置且被 Git
忽略的 GRIDOPOLY_WIFI_UDP_SSID、GRIDOPOLY_WIFI_UDP_PASSWORD 和 channel。

屏幕左下角标签状态：

| 标签 | 含义 |
| --- | --- |
| `TAG SCANNING` | 正在等待首次稳定 UID |
| `TAG 8EFA259D` | 已确认一个 HITAG S256 32 位 UID（示例） |
| `TAGS 2  1/2 8EFA259D` | 同时检测到 2 个标签，当前显示第 1 个；每 1.5 秒轮播 |
| `TAG NO TAG` | 已确认的 UID 连续两次缺失，通常 0.5～1 秒内完成离场确认 |
| `TAG UNSTABLE` | 仅首次启动尚无稳定状态时可能显示；运行中不再覆盖上一组稳定 UID |
| `TAG RFID ERROR` | 数字接口、天线、电源或关场安全检查失败 |

屏幕右下角状态：

| 标签 | 含义 |
| --- | --- |
| WIFI | 正在连接专用热点 |
| SERVER | 已连 Wi-Fi，正在建立服务器心跳 |
| AUTO | 旧无ORDER能力模块的最低空闲格兼容分配；当前V0.33主要使用物理ORDER/手动分配 |
| MANUAL | 当前格来自网页手动分配 |
| NO TILE | 当前地图没有可认领的空闲格 |
| NET ERR | HTTP/JSON/服务器暂时不可用 |

串口 STATUS 会输出 moduleId、deviceId、HTTP 状态、RSSI、服务器 revision、当前分配、完整稳定 UID 集合以及 movement cue/player/revision。

## 标签相对强度与相邻格定位边界

HTRC110 没有可直接读取的连续 RSSI/dBm 寄存器。`READ_PHASE` 测得的是天线谐振相位，
用于选择解调采样时间；`AMPCOMP` 只能比较当前解调幅度是否高于芯片先前保存的一个参考值。
当前 PCB 也只把 HTRC110 的 `SCLK`、`DIN`、`DOUT` 数字接口连接到 ESP32，没有模拟幅度 ADC 通道，
因此正式固件不得把相位值、功耗或单次成功读取伪装成真实信号强度。

后续相邻格定位可以实现一个经过实机校准的 `qualityScore`，但它表示“本格读取可信度”，不是物理 RSSI：

- 在 HTRC110 的四档可编程接收增益下重复只读 UID；越低增益仍能稳定解码，通常表示耦合越强。
- 合并同一测量轮次的有效 UID 比例、可用采样相位宽度和 AC2K 脉冲时序抖动，并按每块板的中心/边缘样本归一化。
- 相邻线圈必须由服务器分时开启，不能同时持续发 125kHz 场；服务器只比较同一轮、同一 UID 的报告。
- 服务器使用领先分差和连续多轮滞回选择获胜格；接近边界且分数相近时上报 `AMBIGUOUS`，不得来回跳格。

若需要可跨模块校准的连续模拟幅度，下一版 PCB 应从安全分压后的接收路径增加缓冲、包络/峰值保持、
钳位保护和 ESP32 ADC 输入，或改用带 RSSI 输出的读卡前端。不得把 `ANT_TAP_HV` 直接接到 ESP32 ADC。
## 图片资源

当前固件内置 36 张 `Assets/GridCity/StreetV3/device/` 的 160×160 PNG，经构建工具
转换为 RGB565 并存入 Flash，不依赖 SD 卡或文件系统。源图片更新后运行：

```powershell
python Firmware/TileModule/tools/generate_tile_artwork.py
```

生成文件位于 `Firmware/TileModule/src/assets/`，每个文件带源图 SHA-256，便于确认
固件图片与项目美术资源一致。
## 串口命令

| 命令 | 作用 |
| --- | --- |
| `DIAG` | 打开或关闭硬件诊断页 |
| `REDRAW` | 重新初始化 ST7789 并强制重绘当前权威页面 |
| `RESTART` | 软件重启 ESP32-S3，用于完整启动时序验证 |
| `BRIGHTNESS 0..255` | 调节屏幕背光 PWM |
| `STATUS` | 输出当前格子状态和功耗 |
| `HELP` | 显示命令帮助 |
| `RFID DEBUG ON` | 输出原始边沿数、SOF 起点、碰撞位、采样相位和 AC 分支结果 |
| `RFID DEBUG OFF` | 关闭原始 RFID 诊断输出 |

## 实机验收重点

1. 上电后先显示 CONNECTING / WI-FI，不得短暂显示 Rivet Row 或其他本地地产。
2. Wi-Fi 成功后显示 WI-FI CONNECTED / REGISTERING；服务器无分配时显示 SERVER ONLINE / WAITING FOR TILE。
3. 服务器返回真实 assignment 后才切换资产页，且图片、价格、所有者与分配一致。
4. 服务器返回 `departure` 时 10 颗 LED 同步橙色呼吸；返回 `destination` 时同步绿色双闪，且不出现单颗玩家槽位灯。
5. V0.35全部LED发送各通道不超过16/255，正常场景当前最多15/255；RGB维护单通道固定8/255。USB调试不进行全白满载。
6. 屏幕底部功耗值稳定刷新，切换 LED 场景时数值变化合理。
7. `DIAG` 页面显示 ST7789、INA226、WS2812 状态，并确认 RS485/ORDER 保持安全。
8. 同时放入两枚 HITAG S256 时，`STATUS` 连续至少 60 秒保持两个去重 UID；短暂弱帧不得让底栏跳成一个或零个标签。
9. 稳定集合变化后不等待常规周期即可在服务器全局 Tag 列表看到更新；把已绑定玩家 Tag 放到目标格后只自动确认一次，到达后 cue 回到 `none`。
10. `scanning`、`fault` 或 `overflow=true` 不得触发自动到达；玩家屏的 `I'M THERE` 仍可完成相同流程。

## 暂不包含

- RS485 格子总线协议。Wi-Fi/HTTP 当前承担首版服务器数据源。
- 任意尺寸完整ORDER环映射：当前仅32格/4角环有服务端实现，开放链和双板锚点已有功能；完整32实体尚待验收。
- 相邻格同时读到同一 UID 时的强度仲裁；当前只有目标格的稳定完整报告参与到达判断。
- 中文字库、新artworkKey扩展和运行时图片资源传输；当前36张素材可被不同地图位置复用。

后续正式接入主控时，将 RS485 解码后的数据写入 `TileState`，显示和 LED 渲染继续
使用当前状态模型。

## V0.33 批量板型和配对候选

`tile_esp32s3` 默认上报 `moduleRole=unknown`；`tile_esp32s3_long` 和 `tile_esp32s3_corner` 分别固定上报 long/corner。GPIO13 为 NC，不读浮空脚猜板型，不烧 eFuse，不从 MAC/OUI 推断角色。板型不是地图位置，服务端根据实际 ORDER 边、四角间距和稳定设备身份决定逻辑角落。unknown 不能用于完整32格闭环自动映射。

两类profile使用当前硬件基线相同的N16R8、GPIO、240×320/硬件rotation2和10颗LED；订单对应制造revision与实际外接面板需首件核验。显示默认8MHz，忽略文件`config/display.local.h`中40MHz覆盖仍严格只对既有已验证MAC生效，不能给全批开启40MHz。

正常候选构建与清单导出（不烧写）:

```powershell
python -m platformio run -d Firmware/TileModule -e tile_esp32s3_long -e tile_esp32s3_corner -t candidate
```

每个 build 环境输出 `candidate.json`、`candidate-sources.json`，记录 sourceDigest、gitRevision、真实烧录segments/offset/SHA256/flash参数。未提交源码由独立源清单定位，gitRevision不是“所有源文件都已提交”的声明。清单中的源码只含路径与哈希，不能拷贝凭据；批量烧录交主任务 release 工具按实体确认的 MAC/role 清单执行。不要整片复制某块Flash或擦写eFuse。role选错必须重刷正确profile，当前没有持久化role覆盖来源。

每次 HTTP 心跳上报 moduleRole/firmwareVersion，并扩展 tagScanSeq/tagAgeMs/tagFresh。完整可信stable、无overflow、扫描完成年龄严格小于5000ms才fresh；旧缓存重传不能改年龄，扫描内容相同仍更新scanSeq，tagRevision只在内容变化时递增。未完成碰撞树、保留缺失消抖结果均不能作为新绑定证据。pairingRoomId/pairingSessionId在实际扫描开始锁定，新HTTP会话不能直接盖章旧库存。

服务器的独立 pairing 对象带 active/roomId/sessionId/revision/state/playerId/playerName/leaseMs；模块只消费自己心跳返回的提示。配对时覆盖正常移动灯效与页面：蓝色等待放入，绿色提示配对成功拿回，橙色提示清空、已绑定换Tag、多Tag或读卡异常。旧模块可保留原session的“拿回”提示，同时另一模块接待下一玩家。active=false、网络失败或lease过期立即在下一主循环撤下配对提示；不在模块端自决绑定或到达。

配对页用内置ASCII字体显示玩家编号与可显示的名字（非ASCII名字字符显示问号），不冒称已有中文字库。模块只读RFID UID，不写Tag存储器。32环和配对回归是主机模拟/生产逻辑测试，不替代32实体电气验收、实际拿放与显示目视确认。
