Ha22yX/Gridopoly/PCB Files/CornerModule/LayoutCandidate-2026-09-21/README.md

# 角落模块布局布线候选版

**未通过制造放行，请勿直接投产。** 已保存于角落 PCB2_2；218 件，17 件机械固定器件保持原位。

- [完整变更与未完成验收](../../../Docs/hardware/corner-pcb-layout-candidate-2026-09-21.md)
- [可打开的原生候选文档](corner-layout-candidate.epro2)
- [六层检查图](six-layer-review.png)
- [身份和网表核对](identity-verification.json)
- [保存数据及实际地铜的独立检查](native-readback-copper-audit.json)

原生 DRC 返回 Error: undefined。24V 的 0.3 mm 规则、USB 阻抗和电源/制造验证尚未完成；详见文档。现有截图和独立几何通过不能视为生产批准。
