Ha22yX/Gridopoly/PCB Files/PlayerConsolePower/ProductionReadiness-2026-10-14/README.md

# 玩家屏幕控制与供电 PCB：2026-10-14 全面投产复核

**结论：当前工程和本次新导出的 Gerber 未发现旧 BAT 短路，也未发现新的确定性致命错接；但暂不能无条件投产放行。** 充电器与成品电池包的电压容差、FPC实物配合、U1散热焊盘工艺及首件充电/USB/欠压/遥测测试尚未闭合。普通电脑默认USB口还存在100mA输入的明确使用限制。

这是一份已完成的静态审查与证据归档，**不是已通过实板测试的制造发布包**。本轮未改电路、PCB位置或走线，未上电、未烧录、未替换旧订单。当前PCB丝印仍为R1 RC5，J3钻孔为0.9mm；此快照不能等同于旧RC5 ZIP，也绝不能用文件名代替哈希。

## 1. 审查对象与可追溯结果

- 工程：Gridopoly → 玩家屏幕控制板 → Schematic2/P1、P2、PCB1；PCB UUID `847ec1f4dfc5086a`。
- 日期按America/New_York为2026-10-14；机器UTC时间已为10月15日，详见capture-time.json/current-snapshot.json。
- 80×80mm、四角R5、双层、68件全顶面、243元件焊盘、536线段、82过孔、41命名网络；另有4个机械孔焊盘。
- 原生PCB严格检查：0条问题；原理图：致命0、错误0、警告43（已取得用户提供的完整分类，未清除原生警告）。
- SCH/PCB/现场快照/BOM/CPL逐项一致：68器件、243脚、MPN、C编号、封装、阻容值、位置与旋转无差异；21个未分配网络端点分别处理，未错误合并NC。
- 导出的实际Gerber铜多边形独立检查：0短路、0开路、0 NC误接、0缺铜端点；检查包括BAT_PACK/GND隔离，不能只靠网表推定。
- 审查结束重新读回P1/P2/PCB1，全部非DOCHEAD图元逐行相同；仅导出头的client/updateTime/version变化，见end-state-check.json。

| 文件 | SHA-256 |
|---|---|
| current-Gerber.zip | `ff1d6610f86817b8abf856b8e372c66f574020b3824ed76b2c69375bd793d031` |
| PCB1-netlist.json | `7fee63bcac5412992a08d29fca70b60ab0c1b5f33aa76a67780f44741f8a7125` |
| schematic-netlist.json | `d9e4665240d30dd23e839e6bb02fd68e9e5dcf05a7ec9245d7a2b428de0e7098` |
| current-snapshot.json | `514525b69079c1752307edff7b40681068bd6d8691afb7db4ee0688ce93eb4a3` |

全部证据文件的校验值见SHA256SUMS.json。原生BOM/CPL扩展名虽然为.csv，内容是Tab分隔；BOM-all68.csv/CPL-all68.csv仅作无损逗号格式转换，没有更改物料或坐标。

## 2. 已完成的功能静态核对

| 用户要求 | 当前电路与核验结果 | 尚未取得的证据 |
|---|---|---|
| USB充电 | BQ24074电源路径、CE、TS、ISET、ILIM、TMR和EP连接正确；充电典型约500mA，来源不足会下降 | 成品包充电容差；充电曲线、终止与温升 |
| 电池供屏 | TPS61023引脚与局部电感/电容/反馈拓扑正确；PWM典型约4.95V；C8/C9两颗10µF仍在 | 实际最低电量启动、Wi-Fi突发、供电峰值及纹波 |
| 电源按键 | MAX16054控制升压EN，按键常通组接线正确 | 长按、抖动、插拔、实际关机耗流 |
| 欠压关机 | TPS3808/Q1清除锁存逻辑正确；SYS_RAW典型3.30V，公差估算约3.16–3.44V；恢复不自启 | 实际掉电阈值/负载干扰/恢复按键；长期存放保护靠电池包 |
| USB烧录/调试 | USB-C正反插数据脚、ESD、U7通道/关机隔离接线正确 | 实际全片烧写校验、连续日志、恢复下载、信号质量 |
| 电量/电压 | MAX17048与SC18IM704供电、UART交叉、I²C、复位和上拉正确；底板无需烧程序 | 屏幕固件接入；约100kHz实测；SOC模型误差 |
| 充电状态 | CHG/PGOOD低有效信号接桥接GPIO，能由屏幕查询 | CHG高非唯一“满电”，需实际状态转换验证 |

详细逐脚/数值/原厂依据：[电源](power-review.md)、[USB与遥测](usb-telemetry-review.md)、[布局与制造](layout-manufacturing-review.md)。这些是设计证据，表内功能没有被标成实板PASS。

## 3. 投产前必须闭合的具体事项

### 电池充电规范及独立保护

BQ24074保证充电稳压范围上限4.23V；本轮重新获取的EEMB LP103454公开电芯文件为4.200±0.020V，上限4.22V。相差10mV，**不代表已证明实际过充，但不能按最坏公差证明相容**。需要所购成品电池包的正式允许电压/充电电流与保护规格；若仍只允许4.22V，必须选保证上限满足的充电方案或兼容电池包。改R1只能调电流，不能修正恒压上限。[TI](https://www.ti.com/lit/ds/symlink/bq24074.pdf)、[EEMB](https://eemb.oss-accelerate.aliyuncs.com//uploads/20230310/238a3765db60b3d0c770182b3e44cd4c.pdf)

欠压电路只关闭屏幕升压器，电池仍连接管理电路；本板没有裸电芯独立过放/短路切断和反接保护。应限定使用有过充、过放、过流/短路保护的1S电池包，确认实际插合极性；不能把长期接裸电芯视为已保护。J3.1=GND、J3.2=BAT_PACK。用户不装外部温度探头的选择保持，TS固定10k做法符合芯片用法，但没有电芯温度测量。

### 电脑USB的100mA输入限制

普通USB-A转C、默认电流USB-C来源时，U1最大输入100mA；屏幕厂家最大背光条件典型320mA@5V，关闭背光也典型100mA@5V，加上转换损耗后不够。因此**无电池或空电池时，不能保证在普通电脑口启动或烧录；运行时也可能继续耗电池**。

当前可接受的使用条件是电池电量充足，或采用带数据且广播至少1.5A能力的USB-C主机；高电流档板上典型限制约894mA。屏幕关机时USB通道不可烧录，需要先开机。如果产品要求所有普通电脑口无电池也能直接烧录，则须改供电/电流授权方案，不能靠说明文字消除该缺口。[屏幕厂家规格](https://github.com/VIEWESMART/UEDX48480021-MD80ESP32-2.1inch-Touch-Knob-Display/blob/main/information/UEDX48480021-MD80ET%20V1.1%20SPEC.pdf)

### J2排线配合与实际峰值

当前J2为FPC-05F-10PH20/C2856798，下接点、10针、0.5mm、0.30mm级尾端。用户已确认针数、间距和触点观察方向，但没有尾端厚度及插合通断证据。必须断电确认屏幕5V接J2.10、地接J2.8、USB极性与RX/TX对应，并验证锁扣/接触面/补强厚度。

单接点额定500mA，屏幕典型320mA，不能直接判为过载；但没有峰值与接点温升数据，不能保证余量。机械焊脚接地不增加FPC信号触点供电能力。[供应商规格](https://www.lcsc.com/product-detail/C2856798.html)

### U1散热焊盘的过孔与钢网

实际钢网有U1 EP开口，不能误报成“没钢网”。但四个约0.30mm热孔全部位于锡膏开口中，顶面露孔、底面盖油；普通盖油不等于填孔。需要代工确认经过验证的塞孔/填孔/盖孔及锡膏方案，并检查首件EP焊接质量与温升。这是制造良率/散热风险，尚无证据证明必然失效。J3实际0.9mm孔径也应与插件焊接工艺确认。[布局证据](layout-manufacturing-review.md)

### 正确版本的首件功能与制造资料

USB两段D−各有2个过孔，D+没有，局部参考地不连续；对12Mbps目标不据此断言必坏，但也没有波形/运行证据证明可靠。需实际正反插、枚举、完整上传校验、持续日志、关机隔离和恢复下载。厂家该版本旋钮按压接GPIO0，可试按住旋钮再按底板RST进入ROM；实际屏幕版本仍需确认。

遥测建议维持默认约99kHz I²C；4.7k上拉没有400kHz裕量证明。CHG高可能是已完成、未充电或异常，不能单独显示“满电”。屏幕固件适配必须纳入首件验收，本轮不修改或部署软件。

制造交付仍需确认标准型SMT物料、J1混合焊接、J3插件焊接和工厂预览。当前无专用测试点，后续小批可利用可达电容/接口焊盘测试。P2旧注释称J2不装、J3/J4焊线盘、未接探头禁充，与实际设计不符；正式源文件发布前必须修正，不能照旧字样漏装J2/J3。当前归档保持原始设计证据，没有静默删除这些注释。

## 4. 原理图警告的具体结论

用户提供的43条警告分为：两条重复同名网络（GND/GND、SCREEN_IO3V3/SCREEN_IO3V3）及器件属性与供应商编号不匹配。不是43个已证实电气短路，也不能笼统忽略。

本次核对30个料号：18个库中精确匹配，12个供应商产品页补查；68件BOM与原理图/PCB匹配。发现库属性中的旧说明/链接/字段名等差异，未发现错料或阻容值错配证据。J1库中250mA字段与厂家同型号3A/5A资料冲突，已按较低3A核验仍满足板上约0.97A输入，四个VBUS触点均已连接，无需因此换座。原生告警没有被清除，完整记录见[警告核验](schematic-warning-review.md)及[supplier-property-review.json](supplier-property-review.json)。

## 5. 与已经收到的故障板分开判断

用户实际打样的 `Gridopoly_PCB1_20260927_204456.zip`（SHA256 `2344f34c45307a879c9a3274bddd53681152dcf42d9fb47637cb690d554405b6`）已证明J3.2顶层保留三条接地铜桥；当前新包没有它们。旧批所有板BAT约0.2Ω的实物故障未返修，继续保持电池、USB、屏幕断开。**本轮静态通过不会改变旧批的禁用状态。** [旧包短路证据](../OrderPackageAudit-2026-10-14/README.md)

## 6. 放行记录与附件

状态：`STATIC_REVIEW_COMPLETE / PRODUCTION_RELEASE_HOLD / NO_PHYSICAL_VALIDATION`。

关闭以上规范、接口和制造事项后，用一块正确新板或经确认修复并排除损伤的单板完成[首件验收表](first-article-acceptance.md)，再决定整批生产。若设计或工艺修改，须重新绑定同版源文件、Gerber、BOM、CPL及哈希并重查受影响项。

- [文件一致性报告](source-bom-cpl-consistency.md)、[铜层独立结果](copper-connectivity-review.json)、[实际铜层局部图](layout-review-copper.png)
- [原生PCB DRC](pcb-drc-current.json)、[原理图原始警告](schematic-warnings-user.txt)、[结束时未改图证明](end-state-check.json)
- [BOM](BOM-all68.csv)、[CPL](CPL-all68.csv)、[Gerber证据包，未放行](current-Gerber.zip)
- 本目录附复核脚本；铜层脚本依赖gerbonara 1.6.3、Shapely 2.1.2，布局图另需Pillow；重跑会重写对应结果，应在副本中进行。源文件、报告和制造层已用SHA256SUMS.json冻结。
