Ha22yX/Gridopoly/PCB Files/PlayerConsolePower/ProductionAudit-2026-10-05/README.md

# 玩家屏幕供电板：已下单后的全面复核

日期：2026-10-05，America/New_York。用户确认“已下单，尚未收到”。本次检查的是嘉立创EDA现场“玩家屏幕控制板 / Schematic2 P1、P2 / PCB1”，读取时间为 2026-10-05 05:09:40 UTC。**未发现新的确定性错接或铜层短断路，但存在充电电压容差未闭合、普通电脑口供电受限及尚未实测的接口/USB问题，不能承诺到货即全部功能正常。**

本次没有修改电路、布局、订单、固件或冻结制造文件。现场设计与 RC5 的电气和机械图元相同；订单实际提交文件尚未取得，不能仅凭当前工程相同就证明订单使用了 RC5。

## 优先处理的发现

### 1. 新增：充电器与所购电池的电压容差未完全重合

EEMB 官网提供的 LP103454 电芯规格为充电限制电压 **4.200±0.020 V**，而 BQ24074 的 BAT 稳压保证范围为 **4.16–4.23 V**。充电器上限比这份电池规格上限高 **10 mV**。这是器件规格边界，不是已经测到本板过压，也不代表全部板都会产生4.23V；但此前只看“都是4.2V”不足以证明全公差兼容。[EEMB官方规格，第3页](https://eemb.oss-accelerate.aliyuncs.com//uploads/20230310/238a3765db60b3d0c770182b3e44cd4c.pdf) · [TI BQ24074，第12页](https://www.ti.com/lit/ds/symlink/bq24074.pdf)

这份 EEMB 文件来自标准电芯页面，并未绑定用户购买的 Amazon 成品电池包批次。需要取得成品包充电规格；若同样要求最高4.22V，首板筛查必须测电池端稳压终值，并计入仪表误差。单次室温合格仍不证明全温度范围合格。**在成品包允许值与充电器保证值匹配前，不将该组合标为完整验证通过。**

已制板的应对：先核实实际电池包规范，再有条件地做受控充电测试；若不能匹配，改用经规格确认接受该容差的受保护1S电池包，或另版更换具有合适精度/较低设定值的充电电路。R1只控制电流，不能修正4.2V稳压精度；不用串联二极管压降充当可靠的终止电压调整。本轮不凭推测返工或覆盖RC5。

### 2. 确认：普通电脑口不能保证边运行边充电

U1 EN1接地。U5在CC检测到默认电流时，OUT1高阻，Q2关闭，EN2低，U1处于 **USB100模式（典型95mA，最大100mA）**。CC广播1.5A或3A时，OUT1低使Q2开启，输入限流变成约0.894A。仅换成C口外形并不保证高电流广播；普通A-to-C连接通常落在前一档。[BQ24074，第7、11页](https://www.ti.com/lit/ds/symlink/bq24074.pdf) · [TUSB320LAI，第16页表3](https://www.ti.com/lit/ds/symlink/tusb320lai.pdf)

厂家屏幕满背光典型5V/320mA，即1.6W；100mA档即使按5V计算也只有0.5W，转换后更少。因此普通电脑口下开屏/烧录依赖电池补充，电量可能继续下降，低电量或无电池时不能保证启动。现有板可采用“先给电池充电，再接电脑上传”；支持至少1.5A广播并提供数据的电脑USB-C口也可测试。不要直接把EN1拉高：EN2为高时会进入挂起档，而不是得到更大电流。

默认USB供电下自动升至500mA、挂起功耗控制、BC1.2识别均不是本板现有功能；若要求任意电脑口下无电池烧录或持续净充电，需要另版电源控制设计。

### 3. 仍待闭合的实物事项

- **J2**：当前物理脚10=5V、8=GND、2=D+、1=D−；与用户要求的镜像映射一致。C2856798是下接点、0.5mm/10Pin、尾厚0.30±0.03mm、供应商标称500mA/触点。实际排线厚度、装入后的端到端针序和最高工作电流仍未验证；不是任意翻面均可插。320mA典型值不能代替最大负载。[接口规格](https://www.lcsc.com/product-detail/C2856798.html)
- **USB布线**：铜连接正确，但仍存在局部不成对、D−换层、线宽变化和参考地中断，未证明90Ω或实际信号质量。本板使用ESP32-S3的Full-Speed原生USB；不能用“只有12Mbps”替代上传、持续日志、拔插及恢复测试。
- **原理图警告**：原生API仍仅返回41条warn数量，明细未取得。此版本3.2.203的返回不能代替逐条分类；未调低检查规则或隐藏警告。21个设计NC脚已人工核对用途，但不能推定41条警告都由NC产生。
- **电池和热**：欠压切断屏幕，监控/电量计仍接电池；须使用适配的受保护电池包。按用户要求保留固定TS电阻，不测电芯温度。满亮度同时充电时，线性充电器与封闭底座温升仍需测量。

## 各功能的电路核对

| 功能 | 本次核对结果 | 实际使用条件 |
| --- | --- | --- |
| USB-C充电 | BQ24074的IN/BAT/OUT/CE/TS/散热焊盘及ISET/ILIM连接符合对应引脚；R1=1.78k，典型500mA；R2=1.8k，高电流档典型894mA；ITERM悬空采用内部终止比例 | 不是所有USB源都能提供500mA充电；需解决上述电压容差与温升验证 |
| USB-C无电池唤醒 | TUSB320LAI在VDD为0时仍提供CC Rd，未发现必须先有电池才能取得VBUS的逻辑死锁 | 大负载启动仍受所连接电源广播/限流影响；无电池电量读数无意义 |
| 电池供屏 | TPS61023输出标称0.6×(1+732/100)=4.992V；L1为1µH，C8/C9两颗10µF仍存在；VIN、SW、EN、FB及输出隔离方向正确 | 需要验证最低电池电压下的启动和Wi-Fi负载瞬态 |
| POWER和RST按键 | 厂家内部常通的1/2同网、3/4接地；此前持续拉地错误未回归 | POWER控制整屏电源；RST只复位屏幕，不复位独立桥接芯片 |
| 欠压关机 | TPS3808低有效RESET经Q1反相到MAX16054高有效CLEAR；标称SYS_RAW约3.30V；100k CT设置约300ms恢复延迟 | 考虑公差约3.16–3.44V，检测点不是电池插头；回弹后仍需按键开机；不是电池包永久断开 |
| USB上传和调试 | J1两组D+/D−合并、D1 ESD、U7通道选择/OE均正确；USB有VBUS且屏幕已开机才通路有效，U7具有断电隔离规格 | 首次/异常固件恢复可能需要屏幕BOOT/GPIO0配合RST；原生USB正常时支持自动下载和串口/JTAG功能，实际固件、驱动和工具仍须验收 |
| 电池电压/SOC | MAX17048 VDD接电池、CTG/QSTRT/EP接地；CELL在17048内部不连接，外接电池符合手册；I²C上拉至开关后的3.3V | SOC为估算；无电池/掉电/休眠后的读值不能当成有效测量 |
| 充电状态 | U9 GPIO0/1分别读CHG_N/PGOOD_N；开漏状态用10k上拉至屏幕3.3V；UART RX/TX交叉 | GPIO保持输入；CHG高可能是充满、停止或故障，不能单独显示“已充满”；底板无需烧录 |
| J3极性 | 1=GND、2=BAT_PACK；元件面朝前、USB-C在下，左负右正；原理图、PCB和丝印一致 | 商品图匹配不是实物测量；本板没有反接保护，接电池前测极性 |

器件依据：[TPS61023](https://www.ti.com/lit/ds/symlink/tps61023.pdf)、[TPS3808](https://www.ti.com/lit/ds/symlink/tps3808.pdf)、[MAX16054](https://www.analog.com/media/en/technical-documentation/data-sheets/MAX16054.pdf)、[TS3USB221A](https://www.ti.com/lit/ds/symlink/ts3usb221a.pdf)、[SC18IM704](https://www.nxp.com/docs/en/data-sheet/SC18IM704.pdf)、[MAX17048](https://www.analog.com/media/en/technical-documentation/data-sheets/MAX17048-MAX17049.pdf)。屏幕[厂家资料](https://github.com/VIEWESMART/UEDX48480021-MD80ESP32-2.1inch-Touch-Knob-Display)列BOOT=GPIO0；[乐鑫说明](https://docs.espressif.com/projects/esp-idf/en/stable/esp32s3/api-guides/usb-serial-jtag-console.html)明确原生USB上传、控制台/JTAG及失效后的GPIO0复位恢复条件。

## 本轮实际验证及证据边界

- 从桥接重新读回 **68件、243焊盘、536线段、82过孔、2块地铜**，严格PCB DRC为0；原理图与PCB每脚网络均一致。
- 当前网表、器件属性、全部几何与RC5相同。源码差别仅文档头时间/client及183条走线记录的ticket；忽略这些元数据后全部图元一致，包括地铜。没有把记录顺序变化当作改线。[比较结果](current-vs-rc5.json)
- 在临时副本重新执行RC5的34项布局/制造核对、11项J3核对，均通过；原始RC5报告未覆盖。[布局结果](layout-verification.json) · [J3结果](j3-connector-verification.json)
- 使用本轮读取的焊盘、过孔、线段，独立重新解析RC5归档Gerber正负铜图形：**41个电气网络无几何短路、断路、误连NC或缺失终端铜**。连通不证明板厂钻镀质量、信号完整性、热性能或接插件实物针序。[铜层结果](copper-connectivity-review.json)
- RC5清单37个文件SHA-256均保持原值。未访问板厂订单，订单制造文件、DFM/装配确认不在已核验范围。钻孔解析仍有原生G90头位置语法提示，11项结果通过不等于解析过程零提示。
- 原生原理图明细受当前API返回限制；本会话没有Computer Use所需node_repl，不能直接展开并读取桌面警告。已向用户请求警告列表文字，不伪造分类结果。

本轮只做设计与制造文件静态复核。没有执行充电、烧录、串口/JTAG、负载、欠压、热或电量遥测实板测试；板子尚未收到。首板按[到货验证表](arrival-tests.md)逐项留实测记录；当前状态是**已下单待到货，功能验收未完成**。
