Ha22yX/Gridopoly/PCB Files/PlayerConsolePower/ProductionAudit-2026-09-27/README.md

# 当前玩家底板审查过程证据

2026-09-27。本目录是本轮读取编辑器的原始快照及分析，不是制造交付包。最终候选在相邻 [Layout-2026-09-27-RC3](../Layout-2026-09-27-RC3/README.md)。

读取时已经是536段走线、82个过孔，J3在上方(40,5) mm，和归档RC2不同。本线程没有回退这些调整；只把BAT+/BAT−文字移到实际焊线孔旁并改RC3版本丝印。

- `before-*`、P1/P2及PCB/原理图网表：修正丝印前的实际读取；PCB严格DRC为0项。
- `NativeExports`：修改前原生导出，含重复via钻孔及原生UTF-16 TSV；不要上传此目录当最终规范制造文件。
- `silkscreen-fix.json`：本次三项丝印变化及保存/DRC读回。
- `verify-copper-connectivity.py` / `copper-connectivity-review.json`：修改前实际铜层连通检查。最终RC3目录另对最终制造ZIP运行了同一算法，均未发现短断路。
- `calculate-power-paths.py` / `power-path-resistance.json`：当前几何的一阶导体压降估算，假设/排除项写在JSON内；不是场/热仿真或负载额定证明。丝印修改前后走线、过孔、器件几何一致。

铜层算法曾在开发时误用TOP焊盘未生效的hole元数据而把USB VBUS错误跨层，现只按MULTI镀通焊盘和实际过孔连接两层；不能把该算法调试中间结果当成已确认的硬件短路。最终报告与实际92个PTH/2个NPTH及82个过孔匹配。

原理图仍有41条未取得明细的告警，FPC、电池及首板验证未完成。没有软件修改、烧录、采购或制造放行。
