Ha22yX/Gridopoly/Mechanical/PlayerTokens/references/animal-team-v1/README.md

# Gridopoly 四角色棋子：图片转 3D 参考

日期：2026-10-01。状态：外观概念参考，尚未生成或验证可打印模型。

| 图片 | 角色 | 主要轮廓 |
| --- | --- | --- |
| 01-fox-trader.png | 狐狸交易员 | 尖耳、短外套、贴腹终端、粗尾巴 |
| 02-beaver-builder.png | 河狸建筑师 | 安全帽、门牙、怀抱积木、宽厚身体 |
| 03-owl-planner.png | 猫头鹰规划师 | 大眼面盘、卷地图、蓝色身体 |
| 04-turtle-gardener.png | 乌龟园艺师 | 龟壳、短腿、背部叶片、绿色身体 |

## 图片转 3D 的使用方式

每次只上传一个角色的单张原图。保留圆形底座、完整主体及与身体相连的配件。

用户确定的尺寸是底面直径 30 mm，用于粘贴 tag。图片只能表达形状，不能提供准确毫米尺寸。转换后在建模软件中把底座外径设为 30 mm，确保底面平整。底座厚度建议先按 3–4 mm、总高约 35–45 mm 进行样件设计；这些是建议值，尚未定稿。

底面暂不增加凹槽，待实际 tag 的直径、厚度和胶层尺寸确认后再决定。不要把图片中的底座比例视为准确尺寸。

打印前检查：封闭网格、单一连通实体、脚与底座连接、道具和主体连接、耳朵/叶片/尾巴的最小厚度，以及背面补全是否合理。最小厚度和支撑方案应按实际打印工艺与材料确定。

猫头鹰最终图带有短耳簇及少量羽毛浮雕；这些属于生成结果，允许建模时进一步简化。颜色主要用于区分角色，不要求多色打印才能识别。

## 文件来源

使用内置 imagegen 生成。原图在默认生成目录保留，此目录保存项目副本。最终使用的提示词记录在 prompts.json；猫头鹰使用简化提示词重新生成。

本目录不更改 PCB、原理图、固件或既有生产文件。
