Ha22yX/Gridopoly/Mechanical/BoardBase/interfaces/pcb-interface-2026-10-15/README.md

# 棋盘底板机械接口 · 2026-10-15

用于先制作 **1 块角落＋2 块相邻长边**的可调固定测试件。每块使用两个对角螺丝，器件面朝同一方向。此包由 PCB 会话只读提取交给 3D 会话，**没有修改 PCB、电路、串口或共享 Git 索引，也不是电气投产放行**。

## 建模入口

- [mechanical-interface.json](mechanical-interface.json)：板框直线/圆弧、孔位、接口锚点、装配变换、用户实测与候选参数。
- [mounting-holes.csv](mounting-holes.csv)：8 个安装孔。
- [bottom-exclusions.csv](bottom-exclusions.csv)：111 个底面器件或插件尾脚 XY 避让包围框；已含建议的 0.5 mm 横向余量。
- [connector-anchors.csv](connector-anchors.csv)：连接器库锚点，**不是外壳边界或插拔净空**。
- [底面详细数据](reviews/bottom-review/bottom-clearance.json)：当前库实体层投影＋实际焊盘几何、底面 48/46 件、通孔尾脚和逐件未知 Z。
- [孔周制造几何核查](reviews/layout-review/mechanical-current-geometry.json)及[器件本体交叉核查](support-body-crosscheck.json)。

## 坐标、板框与孔

统一为 **顶视图，X 向右、Y 向下**。原点是含长边侧凸部分的板框最大外接矩形左上角；底面数据也投影在这一顶视坐标内，不镜像。两种板均 JIN 公针在左，长边 JOUT 母座在右，角落 JOUT 在上，USB J1 在下。

原始 PCB 单位 mil：`x=(原X+114.6798)×0.0254`，`y=(-3.2735-原Y)×0.0254`。Z=0 为 PCB 底面，正向朝顶面。JSON 保存源文件的精确圆弧和小数；建模名义尺寸可在 0.001 mm 内规整。

| 板型 | 外形 | 左上 TL | 右上 TR | 右下 BR | 左下 BL | 建议锁紧孔 |
|---|---|---|---|---|---|---|
| 长边 | 最大 54×80 mm，四外角 R4；主体 X=3～51，中间侧凸 Y≈27～53 | 7.191, 4.191 | 46.815, 4.191 | 46.815, 75.83885 | 7.191, 75.83885 | TR＋BL |
| 角落 | 80×80 mm，R4 | 4, 4 | 76, 4 | 76, 76 | 4, 76 | TL＋BR |

8 个孔均经本次实际 Gerber/DRL 确认为 **NPTH Ø3.499998 mm，建模名义 Ø3.5 mm**。源 `CIRCLE` 的 68.8976 mil 是半径，不能误读成孔径。长边轮廓有约 0.000353 mm 的原始端点舍入差，不应把这类数值噪声设计成实物台阶。

所有孔周 **外径 6 mm、内孔 3.6 mm 的绝缘接触环**均未越板、未压当前导出铜/阻焊开窗/底面钢网；另以完整 Ø6 圆盘检查底面库实体＋焊盘及插件尾脚包围框（各加 0.5 mm），8 处均无相交。此直径是已核对的建议值，**不是可任意放大的最大值**。长边右下孔较靠近 C202，优先用另一对对角孔；剩余两个孔可承托但不额外锁紧。螺丝头/垫圈若超过 6 mm，要重新检查顶面器件和铜层。

PCB 孔为间隙孔，可采用合适的 M3 螺丝；螺纹应位于可更换 PLA 柱、螺母或相应紧固件内，不在 PCB 上自攻。具体螺丝长度、PLA 孔径和打印收缩由 3D 测试件确定。

## 实板反馈与高度

已直接读取 3D 会话的用户答复：打印机 **Bambu H2D、PLA**；两种板自然插合后保持同一平面；板厚约 **1.6 mm**、底面最大突出均约 **8.1 mm**。这些标为 `user_measured_approx`／`user_observed_natural_assembly`，未赋予虚构公差，也未把整板最大值分摊为每颗器件高度。

当前 CAD 层厚相加为 **1.538351 mm**，与用户约 1.6 mm 分别保留；CAD 和实物厚度不是同一证据。逐件器件高度、焊点和裁脚突出仍为 `null`。

3D 会话的首件候选：PCB 底面离桌 **14 mm**，底筋顶部离桌 **3.5 mm**，按 8.1 mm 近似突出得到名义余量 **2.4 mm**。这是首件参数，需扣除实物和打印误差；不能让高器件或焊点承担支撑力。开底框架和可更换等高支撑柱可保留调整能力。

## 接口配合与板间距

现行接口为 6 针＋3 针、2.54 mm 弯脚通孔公母座。当前 8 个实例的位置/方向/器件及封装 ID 与 9/21 归档一致；旧 C92159/C22373927 不等高组合已非当前设计。厂家截面支持贴合安装时名义中心约 1.25 mm；这是推导尺寸，不是组合 Z 公差。**本批实物共面已有用户自然装配确认，应统一 PCB 基准面。** 长边 JOUT3 的 0.127 mm 偏差在插入轴方向，不是 Z 台阶。

详见[连接器复核及原厂图](reviews/connectors-review/connectors-review.md)。USB、DC 电源、屏幕插头的线缆外壳和操作空间尚未实测，数据中留空；固定件不能挡住接口口部、插拔路径或抓取位置。

用户另报角落—长边约 **12 mm**、长边—长边约 **15 mm**，但测量边界未明确。**若量的是主体直边**：前者减一个 3 mm 凸出、后者减两个 3 mm 凸出，均得凸出板边之间 `g≈9 mm`。因此 JSON 将 9 mm 仅列为 `inferred_from_user_approx` 的可调首件候选；真实接缝字段仍为 `null`。

6 针配合焊盘排距离 `D = g + 4.59699868 mm`。候选 g=9 时 D≈13.596999 mm；历史 D=14.5 mm 只是演示，不能用作已测尺寸。沿连接轴 ±3 mm 滑移是 3D 首件的设计选项，不是连接器允许松插范围。应先自然插合，再调整底座位置固定；不能拉扯 PCB 迎合螺丝孔。

以角落原点 (0,0) 放置：左侧长边同向，平移 `(-54-g左,0)`；上侧长边顶视逆时针 90°，坐标变换 `(x,y)→(y,-x)`，再平移 `(0,-g上)`。该变换按同一编号 6 针对接，不翻板。完整周边扩展若为 4 角落＋每边 n 块长边，则数量 `4+4n`、名义外宽 `160+54n+(n+1)g`；这不是把 4×4 矩阵全铺满的定义。

## 版本与来源边界

- 本次桥接只读导出：长边 **PCB2_1 / 7840864f79449b47**，141 件、底面 48 件；角落 **PCB2_5 / 6f97d7be5a40dd66**，152 件、底面 46 件。
- 本包 [evidence](evidence/) 包含两板源、原生 epro2（含封装）、当前焊盘快照和本次导出 Gerber；源文件头的时间是本次导出生成值，不能充当最后设计修改时间。
- 当前相关机械/布局图元与 `PCB Files/DesignAudit-2026-09-21/` 一致；也与 10/15 自动备份的板框/孔位交叉一致。长边名称含“投产版本”的备份机械图元一致，不因此证明某批实物来自该文件。
- 角落备份 **PCB2_3 / 67209140b298d3fc** 为 218 件旧 PD 版，排除；不能用它的底面布局替代本次 152 件 DC24 版。
- 未得到当前实物批次对应制造文件哈希，故仍保留 `physical_revision_match` 限制。首次放板需核对孔距、自然接缝、底面净空、插头通道与无应力锁紧。

数据已具备可调测试件建模条件。3D 会话负责模型、打印参数、STL/3MF 和首次装配；PCB 会话负责此接口数据与后续有明确差异的核对。
