Ha22yX/Gridopoly/Mechanical/PUBLICATION.md

# 3D 模型完整公开清单

更新：2026-10-16。[当前优先打印与下载方法](README.md)。

本清单覆盖 30 个 STL、28 个 3MF（其中 5 个为原始输入），以及 15 个正式 Blender 工程。
当前版、历史版和原始输入分别标注；不通过重新建模或重新打包删减历史内容。全部模型对象已上传GitHub，并用独立空缓存取回、逐个核对SHA256及大小。详见[发布与下载验证](../Docs/mechanical/model-publication-2026-10-16.md)。

[逐文件大小及 SHA256](public-model-inventory.json) · [完整待提交路径](publish-paths.txt) · [被忽略但需纳入的正式文件](publish-ignored-paths.txt)

## 模型文件

| 文件 | MiB | 用途 / 版本状态 |
| --- | ---: | --- |
| [BoardBase/deliverables/Gridopoly_BoardBase_Full16_R1/01_L_Quarter_PRINT_4.3mf](BoardBase/deliverables/Gridopoly_BoardBase_Full16_R1/01_L_Quarter_PRINT_4.3mf?raw=true) | 0.167 | print_model / current_full16_candidate_physical_fit_pending |
| [BoardBase/deliverables/Gridopoly_BoardBase_Full16_R1/01_L_Quarter_PRINT_4.stl](BoardBase/deliverables/Gridopoly_BoardBase_Full16_R1/01_L_Quarter_PRINT_4.stl?raw=true) | 0.778 | print_model / current_full16_candidate_physical_fit_pending |
| [BoardBase/deliverables/Gridopoly_BoardBase_Full16_R1/02_Splice_Bridge_PRINT_8.3mf](BoardBase/deliverables/Gridopoly_BoardBase_Full16_R1/02_Splice_Bridge_PRINT_8.3mf?raw=true) | 0.013 | print_model / current_full16_candidate_physical_fit_pending |
| [BoardBase/deliverables/Gridopoly_BoardBase_Full16_R1/02_Splice_Bridge_PRINT_8.stl](BoardBase/deliverables/Gridopoly_BoardBase_Full16_R1/02_Splice_Bridge_PRINT_8.stl?raw=true) | 0.063 | print_model / current_full16_candidate_physical_fit_pending |
| [BoardBase/deliverables/Gridopoly_BoardBase_Full16_R1/Gridopoly_Full16_R1.blend](BoardBase/deliverables/Gridopoly_BoardBase_Full16_R1/Gridopoly_Full16_R1.blend?raw=true) | 1.373 | editable_design / current_full16_candidate_physical_fit_pending |
| [BoardBase/deliverables/Gridopoly_BoardBase_Test_R0/Corner_TEST_R0.stl](BoardBase/deliverables/Gridopoly_BoardBase_Test_R0/Corner_TEST_R0.stl?raw=true) | 0.190 | print_model / historical_revision_not_default_print_choice |
| [BoardBase/deliverables/Gridopoly_BoardBase_Test_R0/Gridopoly_Corner_Test_R0.blend](BoardBase/deliverables/Gridopoly_BoardBase_Test_R0/Gridopoly_Corner_Test_R0.blend?raw=true) | 0.341 | editable_design / historical_revision_not_default_print_choice |
| [BoardBase/deliverables/Gridopoly_BoardBase_Test_R0/Incoming_Long_TEST_R0.stl](BoardBase/deliverables/Gridopoly_BoardBase_Test_R0/Incoming_Long_TEST_R0.stl?raw=true) | 0.240 | print_model / historical_revision_not_default_print_choice |
| [BoardBase/deliverables/Gridopoly_BoardBase_Test_R0/Outgoing_Long_TEST_R0.stl](BoardBase/deliverables/Gridopoly_BoardBase_Test_R0/Outgoing_Long_TEST_R0.stl?raw=true) | 0.236 | print_model / historical_revision_not_default_print_choice |
| [BoardBase/deliverables/Gridopoly_BoardBase_Test_R1_ONE_PIECE/Gridopoly_OnePiece_Corner_Test_R1.blend](BoardBase/deliverables/Gridopoly_BoardBase_Test_R1_ONE_PIECE/Gridopoly_OnePiece_Corner_Test_R1.blend?raw=true) | 0.273 | editable_design / historical_revision_not_default_print_choice |
| [BoardBase/deliverables/Gridopoly_BoardBase_Test_R1_ONE_PIECE/ONE_PIECE_Corner_Test_R1.3mf](BoardBase/deliverables/Gridopoly_BoardBase_Test_R1_ONE_PIECE/ONE_PIECE_Corner_Test_R1.3mf?raw=true) | 0.079 | print_model / historical_revision_not_default_print_choice |
| [BoardBase/deliverables/Gridopoly_BoardBase_Test_R1_ONE_PIECE/ONE_PIECE_Corner_Test_R1.stl](BoardBase/deliverables/Gridopoly_BoardBase_Test_R1_ONE_PIECE/ONE_PIECE_Corner_Test_R1.stl?raw=true) | 0.406 | print_model / historical_revision_not_default_print_choice |
| [BoardBase/deliverables/Gridopoly_BoardBase_Test_R2_PRINT_FRIENDLY/Gridopoly_OnePiece_Corner_Test_R2.blend](BoardBase/deliverables/Gridopoly_BoardBase_Test_R2_PRINT_FRIENDLY/Gridopoly_OnePiece_Corner_Test_R2.blend?raw=true) | 0.418 | editable_design / fitted_three_module_reference |
| [BoardBase/deliverables/Gridopoly_BoardBase_Test_R2_PRINT_FRIENDLY/ONE_PIECE_Corner_Test_R2.3mf](BoardBase/deliverables/Gridopoly_BoardBase_Test_R2_PRINT_FRIENDLY/ONE_PIECE_Corner_Test_R2.3mf?raw=true) | 0.091 | print_model / fitted_three_module_reference |
| [BoardBase/deliverables/Gridopoly_BoardBase_Test_R2_PRINT_FRIENDLY/ONE_PIECE_Corner_Test_R2.stl](BoardBase/deliverables/Gridopoly_BoardBase_Test_R2_PRINT_FRIENDLY/ONE_PIECE_Corner_Test_R2.stl?raw=true) | 0.471 | print_model / fitted_three_module_reference |
| [BoardBase/deliverables/Gridopoly_BoardBase_Test_R2_PRINT_FRIENDLY/Screw_Fit_Coupon_R2.3mf](BoardBase/deliverables/Gridopoly_BoardBase_Test_R2_PRINT_FRIENDLY/Screw_Fit_Coupon_R2.3mf?raw=true) | 0.025 | print_model / fitted_three_module_reference |
| [BoardBase/deliverables/Gridopoly_BoardBase_Test_R2_PRINT_FRIENDLY/Screw_Fit_Coupon_R2.stl](BoardBase/deliverables/Gridopoly_BoardBase_Test_R2_PRINT_FRIENDLY/Screw_Fit_Coupon_R2.stl?raw=true) | 0.130 | print_model / fitted_three_module_reference |
| [PlayerConsoleStand/outputs/models/Gridopoly_Player_Console_Stand_CW47_5.blend](PlayerConsoleStand/outputs/models/Gridopoly_Player_Console_Stand_CW47_5.blend?raw=true) | 0.170 | editable_design / fitted_screen_interface_reference |
| [PlayerConsoleStand/outputs/models/Gridopoly_Player_Console_Stand_CW47_5.stl](PlayerConsoleStand/outputs/models/Gridopoly_Player_Console_Stand_CW47_5.stl?raw=true) | 0.200 | print_model / fitted_screen_interface_reference |
| [PlayerConsoleStand/outputs/models/Gridopoly_Player_Console_Stand_CW50.blend](PlayerConsoleStand/outputs/models/Gridopoly_Player_Console_Stand_CW50.blend?raw=true) | 0.170 | editable_design / historical_revision_not_default_print_choice |
| [PlayerConsoleStand/outputs/models/Gridopoly_Player_Console_Stand_CW50.stl](PlayerConsoleStand/outputs/models/Gridopoly_Player_Console_Stand_CW50.stl?raw=true) | 0.200 | print_model / historical_revision_not_default_print_choice |
| [PlayerConsoleStand/outputs/models/Gridopoly_Player_Console_Stand_M4_Pin_Down.stl](PlayerConsoleStand/outputs/models/Gridopoly_Player_Console_Stand_M4_Pin_Down.stl?raw=true) | 0.201 | print_model / historical_revision_not_default_print_choice |
| [PlayerConsoleStand/outputs/models/round_display_test_stand.blend](PlayerConsoleStand/outputs/models/round_display_test_stand.blend?raw=true) | 0.170 | editable_design / historical_revision_not_default_print_choice |
| [PlayerConsoleStand/outputs/models/round_display_test_stand.stl](PlayerConsoleStand/outputs/models/round_display_test_stand.stl?raw=true) | 0.200 | print_model / historical_revision_not_default_print_choice |
| [PlayerConsoleStandV2/deliverables/Gridopoly_Player_Stand_V2_R1/01_Upper_CW47_5.3mf](PlayerConsoleStandV2/deliverables/Gridopoly_Player_Stand_V2_R1/01_Upper_CW47_5.3mf?raw=true) | 0.068 | print_model / historical_revision_not_default_print_choice |
| [PlayerConsoleStandV2/deliverables/Gridopoly_Player_Stand_V2_R1/01_Upper_CW47_5.stl](PlayerConsoleStandV2/deliverables/Gridopoly_Player_Stand_V2_R1/01_Upper_CW47_5.stl?raw=true) | 0.258 | print_model / historical_revision_not_default_print_choice |
| [PlayerConsoleStandV2/deliverables/Gridopoly_Player_Stand_V2_R1/02_Battery_Tray.3mf](PlayerConsoleStandV2/deliverables/Gridopoly_Player_Stand_V2_R1/02_Battery_Tray.3mf?raw=true) | 0.028 | print_model / historical_revision_not_default_print_choice |
| [PlayerConsoleStandV2/deliverables/Gridopoly_Player_Stand_V2_R1/02_Battery_Tray.stl](PlayerConsoleStandV2/deliverables/Gridopoly_Player_Stand_V2_R1/02_Battery_Tray.stl?raw=true) | 0.140 | print_model / historical_revision_not_default_print_choice |
| [PlayerConsoleStandV2/deliverables/Gridopoly_Player_Stand_V2_R1/03_Spacer_12mm.3mf](PlayerConsoleStandV2/deliverables/Gridopoly_Player_Stand_V2_R1/03_Spacer_12mm.3mf?raw=true) | 0.006 | print_model / historical_revision_not_default_print_choice |
| [PlayerConsoleStandV2/deliverables/Gridopoly_Player_Stand_V2_R1/03_Spacer_12mm.stl](PlayerConsoleStandV2/deliverables/Gridopoly_Player_Stand_V2_R1/03_Spacer_12mm.stl?raw=true) | 0.024 | print_model / historical_revision_not_default_print_choice |
| [PlayerConsoleStandV2/deliverables/Gridopoly_Player_Stand_V2_R1/03_Spacer_8mm.3mf](PlayerConsoleStandV2/deliverables/Gridopoly_Player_Stand_V2_R1/03_Spacer_8mm.3mf?raw=true) | 0.006 | print_model / historical_revision_not_default_print_choice |
| [PlayerConsoleStandV2/deliverables/Gridopoly_Player_Stand_V2_R1/03_Spacer_8mm.stl](PlayerConsoleStandV2/deliverables/Gridopoly_Player_Stand_V2_R1/03_Spacer_8mm.stl?raw=true) | 0.024 | print_model / historical_revision_not_default_print_choice |
| [PlayerConsoleStandV2/deliverables/Gridopoly_Player_Stand_V2_R1/Gridopoly_Player_Stand_V2_R1.blend](PlayerConsoleStandV2/deliverables/Gridopoly_Player_Stand_V2_R1/Gridopoly_Player_Stand_V2_R1.blend?raw=true) | 0.332 | editable_design / historical_revision_not_default_print_choice |
| [PlayerConsoleStandV2/deliverables/Gridopoly_Player_Stand_V2_R2_FPC60/01_Connection_Plate_R2.3mf](PlayerConsoleStandV2/deliverables/Gridopoly_Player_Stand_V2_R2_FPC60/01_Connection_Plate_R2.3mf?raw=true) | 0.022 | print_model / historical_revision_not_default_print_choice |
| [PlayerConsoleStandV2/deliverables/Gridopoly_Player_Stand_V2_R2_FPC60/01_Connection_Plate_R2.stl](PlayerConsoleStandV2/deliverables/Gridopoly_Player_Stand_V2_R2_FPC60/01_Connection_Plate_R2.stl?raw=true) | 0.108 | print_model / historical_revision_not_default_print_choice |
| [PlayerConsoleStandV2/deliverables/Gridopoly_Player_Stand_V2_R2_FPC60/02_Screen_Support_CW47_5_R2.3mf](PlayerConsoleStandV2/deliverables/Gridopoly_Player_Stand_V2_R2_FPC60/02_Screen_Support_CW47_5_R2.3mf?raw=true) | 0.064 | print_model / historical_revision_not_default_print_choice |
| [PlayerConsoleStandV2/deliverables/Gridopoly_Player_Stand_V2_R2_FPC60/02_Screen_Support_CW47_5_R2.stl](PlayerConsoleStandV2/deliverables/Gridopoly_Player_Stand_V2_R2_FPC60/02_Screen_Support_CW47_5_R2.stl?raw=true) | 0.234 | print_model / historical_revision_not_default_print_choice |
| [PlayerConsoleStandV2/deliverables/Gridopoly_Player_Stand_V2_R2_FPC60/03_Battery_Cradle_R2.3mf](PlayerConsoleStandV2/deliverables/Gridopoly_Player_Stand_V2_R2_FPC60/03_Battery_Cradle_R2.3mf?raw=true) | 0.014 | print_model / historical_revision_not_default_print_choice |
| [PlayerConsoleStandV2/deliverables/Gridopoly_Player_Stand_V2_R2_FPC60/03_Battery_Cradle_R2.stl](PlayerConsoleStandV2/deliverables/Gridopoly_Player_Stand_V2_R2_FPC60/03_Battery_Cradle_R2.stl?raw=true) | 0.066 | print_model / historical_revision_not_default_print_choice |
| [PlayerConsoleStandV2/deliverables/Gridopoly_Player_Stand_V2_R2_FPC60/04_Battery_Lid_R2.3mf](PlayerConsoleStandV2/deliverables/Gridopoly_Player_Stand_V2_R2_FPC60/04_Battery_Lid_R2.3mf?raw=true) | 0.006 | print_model / historical_revision_not_default_print_choice |
| [PlayerConsoleStandV2/deliverables/Gridopoly_Player_Stand_V2_R2_FPC60/04_Battery_Lid_R2.stl](PlayerConsoleStandV2/deliverables/Gridopoly_Player_Stand_V2_R2_FPC60/04_Battery_Lid_R2.stl?raw=true) | 0.026 | print_model / historical_revision_not_default_print_choice |
| [PlayerConsoleStandV2/deliverables/Gridopoly_Player_Stand_V2_R2_FPC60/05_Spacer_6mm_R2.3mf](PlayerConsoleStandV2/deliverables/Gridopoly_Player_Stand_V2_R2_FPC60/05_Spacer_6mm_R2.3mf?raw=true) | 0.006 | print_model / historical_revision_not_default_print_choice |
| [PlayerConsoleStandV2/deliverables/Gridopoly_Player_Stand_V2_R2_FPC60/05_Spacer_6mm_R2.stl](PlayerConsoleStandV2/deliverables/Gridopoly_Player_Stand_V2_R2_FPC60/05_Spacer_6mm_R2.stl?raw=true) | 0.024 | print_model / historical_revision_not_default_print_choice |
| [PlayerConsoleStandV2/deliverables/Gridopoly_Player_Stand_V2_R2_FPC60/Gridopoly_Player_Stand_V2_R2_FPC60.blend](PlayerConsoleStandV2/deliverables/Gridopoly_Player_Stand_V2_R2_FPC60/Gridopoly_Player_Stand_V2_R2_FPC60.blend?raw=true) | 0.356 | editable_design / historical_revision_not_default_print_choice |
| [PlayerConsoleStandV2/deliverables/Gridopoly_Player_Stand_V2_R3_EAR_REINFORCED/01_Connection_Plate_R2.3mf](PlayerConsoleStandV2/deliverables/Gridopoly_Player_Stand_V2_R3_EAR_REINFORCED/01_Connection_Plate_R2.3mf?raw=true) | 0.022 | print_model / current_player_R3_candidate_physical_fit_pending |
| [PlayerConsoleStandV2/deliverables/Gridopoly_Player_Stand_V2_R3_EAR_REINFORCED/01_Connection_Plate_R2.stl](PlayerConsoleStandV2/deliverables/Gridopoly_Player_Stand_V2_R3_EAR_REINFORCED/01_Connection_Plate_R2.stl?raw=true) | 0.108 | print_model / current_player_R3_candidate_physical_fit_pending |
| [PlayerConsoleStandV2/deliverables/Gridopoly_Player_Stand_V2_R3_EAR_REINFORCED/02_Screen_Support_CW47_5_R3.3mf](PlayerConsoleStandV2/deliverables/Gridopoly_Player_Stand_V2_R3_EAR_REINFORCED/02_Screen_Support_CW47_5_R3.3mf?raw=true) | 0.069 | print_model / current_player_R3_candidate_physical_fit_pending |
| [PlayerConsoleStandV2/deliverables/Gridopoly_Player_Stand_V2_R3_EAR_REINFORCED/02_Screen_Support_CW47_5_R3.stl](PlayerConsoleStandV2/deliverables/Gridopoly_Player_Stand_V2_R3_EAR_REINFORCED/02_Screen_Support_CW47_5_R3.stl?raw=true) | 0.251 | print_model / current_player_R3_candidate_physical_fit_pending |
| [PlayerConsoleStandV2/deliverables/Gridopoly_Player_Stand_V2_R3_EAR_REINFORCED/03_Battery_Cradle_R2.3mf](PlayerConsoleStandV2/deliverables/Gridopoly_Player_Stand_V2_R3_EAR_REINFORCED/03_Battery_Cradle_R2.3mf?raw=true) | 0.014 | print_model / current_player_R3_candidate_physical_fit_pending |
| [PlayerConsoleStandV2/deliverables/Gridopoly_Player_Stand_V2_R3_EAR_REINFORCED/03_Battery_Cradle_R2.stl](PlayerConsoleStandV2/deliverables/Gridopoly_Player_Stand_V2_R3_EAR_REINFORCED/03_Battery_Cradle_R2.stl?raw=true) | 0.066 | print_model / current_player_R3_candidate_physical_fit_pending |
| [PlayerConsoleStandV2/deliverables/Gridopoly_Player_Stand_V2_R3_EAR_REINFORCED/04_Battery_Lid_R2.3mf](PlayerConsoleStandV2/deliverables/Gridopoly_Player_Stand_V2_R3_EAR_REINFORCED/04_Battery_Lid_R2.3mf?raw=true) | 0.006 | print_model / current_player_R3_candidate_physical_fit_pending |
| [PlayerConsoleStandV2/deliverables/Gridopoly_Player_Stand_V2_R3_EAR_REINFORCED/04_Battery_Lid_R2.stl](PlayerConsoleStandV2/deliverables/Gridopoly_Player_Stand_V2_R3_EAR_REINFORCED/04_Battery_Lid_R2.stl?raw=true) | 0.026 | print_model / current_player_R3_candidate_physical_fit_pending |
| [PlayerConsoleStandV2/deliverables/Gridopoly_Player_Stand_V2_R3_EAR_REINFORCED/05_Spacer_6mm_R2.3mf](PlayerConsoleStandV2/deliverables/Gridopoly_Player_Stand_V2_R3_EAR_REINFORCED/05_Spacer_6mm_R2.3mf?raw=true) | 0.006 | print_model / current_player_R3_candidate_physical_fit_pending |
| [PlayerConsoleStandV2/deliverables/Gridopoly_Player_Stand_V2_R3_EAR_REINFORCED/05_Spacer_6mm_R2.stl](PlayerConsoleStandV2/deliverables/Gridopoly_Player_Stand_V2_R3_EAR_REINFORCED/05_Spacer_6mm_R2.stl?raw=true) | 0.024 | print_model / current_player_R3_candidate_physical_fit_pending |
| [PlayerConsoleStandV2/deliverables/Gridopoly_Player_Stand_V2_R3_EAR_REINFORCED/Gridopoly_Player_Stand_V2_R3_EAR_REINFORCED.blend](PlayerConsoleStandV2/deliverables/Gridopoly_Player_Stand_V2_R3_EAR_REINFORCED/Gridopoly_Player_Stand_V2_R3_EAR_REINFORCED.blend?raw=true) | 0.370 | editable_design / current_player_R3_candidate_physical_fit_pending |
| [PlayerTokens/models/hi3d-30mm/deliverables/Hi3D_30mm/Hi3D_30mm.3mf](PlayerTokens/models/hi3d-30mm/deliverables/Hi3D_30mm/Hi3D_30mm.3mf?raw=true) | 23.730 | print_model / current_30mm_tokens_print_validation_pending |
| [PlayerTokens/models/hi3d-30mm/deliverables/Hi3D_30mm/Hi3D_30mm.blend](PlayerTokens/models/hi3d-30mm/deliverables/Hi3D_30mm/Hi3D_30mm.blend?raw=true) | 92.424 | editable_design / current_30mm_tokens_print_validation_pending |
| [PlayerTokens/models/hi3d-30mm/deliverables/Hi3D_30mm/Hi3D_30mm.stl](PlayerTokens/models/hi3d-30mm/deliverables/Hi3D_30mm/Hi3D_30mm.stl?raw=true) | 73.590 | print_model / current_30mm_tokens_print_validation_pending |
| [PlayerTokens/models/hi3d-remaining-30mm/deliverables/Gridopoly_30mm_Remaining/Beaver_30mm.3mf](PlayerTokens/models/hi3d-remaining-30mm/deliverables/Gridopoly_30mm_Remaining/Beaver_30mm.3mf?raw=true) | 22.530 | print_model / current_30mm_tokens_print_validation_pending |
| [PlayerTokens/models/hi3d-remaining-30mm/deliverables/Gridopoly_30mm_Remaining/Beaver_30mm.blend](PlayerTokens/models/hi3d-remaining-30mm/deliverables/Gridopoly_30mm_Remaining/Beaver_30mm.blend?raw=true) | 90.009 | editable_design / current_30mm_tokens_print_validation_pending |
| [PlayerTokens/models/hi3d-remaining-30mm/deliverables/Gridopoly_30mm_Remaining/Beaver_30mm.stl](PlayerTokens/models/hi3d-remaining-30mm/deliverables/Gridopoly_30mm_Remaining/Beaver_30mm.stl?raw=true) | 68.318 | print_model / current_30mm_tokens_print_validation_pending |
| [PlayerTokens/models/hi3d-remaining-30mm/deliverables/Gridopoly_30mm_Remaining/Gridopoly_Three_Tokens_30mm.blend](PlayerTokens/models/hi3d-remaining-30mm/deliverables/Gridopoly_30mm_Remaining/Gridopoly_Three_Tokens_30mm.blend?raw=true) | 278.117 | editable_design / current_30mm_tokens_print_validation_pending |
| [PlayerTokens/models/hi3d-remaining-30mm/deliverables/Gridopoly_30mm_Remaining/Owl_30mm.3mf](PlayerTokens/models/hi3d-remaining-30mm/deliverables/Gridopoly_30mm_Remaining/Owl_30mm.3mf?raw=true) | 25.428 | print_model / current_30mm_tokens_print_validation_pending |
| [PlayerTokens/models/hi3d-remaining-30mm/deliverables/Gridopoly_30mm_Remaining/Owl_30mm.blend](PlayerTokens/models/hi3d-remaining-30mm/deliverables/Gridopoly_30mm_Remaining/Owl_30mm.blend?raw=true) | 95.611 | editable_design / current_30mm_tokens_print_validation_pending |
| [PlayerTokens/models/hi3d-remaining-30mm/deliverables/Gridopoly_30mm_Remaining/Owl_30mm.stl](PlayerTokens/models/hi3d-remaining-30mm/deliverables/Gridopoly_30mm_Remaining/Owl_30mm.stl?raw=true) | 78.756 | print_model / current_30mm_tokens_print_validation_pending |
| [PlayerTokens/models/hi3d-remaining-30mm/deliverables/Gridopoly_30mm_Remaining/Turtle_30mm.3mf](PlayerTokens/models/hi3d-remaining-30mm/deliverables/Gridopoly_30mm_Remaining/Turtle_30mm.3mf?raw=true) | 23.574 | print_model / current_30mm_tokens_print_validation_pending |
| [PlayerTokens/models/hi3d-remaining-30mm/deliverables/Gridopoly_30mm_Remaining/Turtle_30mm.blend](PlayerTokens/models/hi3d-remaining-30mm/deliverables/Gridopoly_30mm_Remaining/Turtle_30mm.blend?raw=true) | 92.696 | editable_design / current_30mm_tokens_print_validation_pending |
| [PlayerTokens/models/hi3d-remaining-30mm/deliverables/Gridopoly_30mm_Remaining/Turtle_30mm.stl](PlayerTokens/models/hi3d-remaining-30mm/deliverables/Gridopoly_30mm_Remaining/Turtle_30mm.stl?raw=true) | 73.293 | print_model / current_30mm_tokens_print_validation_pending |
| [PlayerTokens/sources/hi3d-originals/Hi3D(2).3mf](PlayerTokens/sources/hi3d-originals/Hi3D%282%29.3mf?raw=true) | 31.195 | original_input / original_not_ready_to_print |
| [PlayerTokens/sources/hi3d-originals/Hi3D(3).3mf](PlayerTokens/sources/hi3d-originals/Hi3D%283%29.3mf?raw=true) | 31.132 | original_input / original_not_ready_to_print |
| [PlayerTokens/sources/hi3d-originals/Hi3D(4).3mf](PlayerTokens/sources/hi3d-originals/Hi3D%284%29.3mf?raw=true) | 31.132 | original_input / original_not_ready_to_print |
| [PlayerTokens/sources/hi3d-originals/Hi3D(5).3mf](PlayerTokens/sources/hi3d-originals/Hi3D%285%29.3mf?raw=true) | 31.331 | original_input / original_not_ready_to_print |
| [PlayerTokens/sources/hi3d-originals/Hi3D.3mf](PlayerTokens/sources/hi3d-originals/Hi3D.3mf?raw=true) | 30.799 | original_input / original_not_ready_to_print |

## 冻结包与配套资料

下列 ZIP 保持原始字节，其内容可能与单独模型重复；已检查压缩包 CRC。

| 包 | MiB |
| --- | ---: |
| [BoardBase/deliverables/Gridopoly_BoardBase_Full16_R1.zip](BoardBase/deliverables/Gridopoly_BoardBase_Full16_R1.zip?raw=true) | 12.946 |
| [BoardBase/deliverables/Gridopoly_BoardBase_Test_R1_ONE_PIECE.zip](BoardBase/deliverables/Gridopoly_BoardBase_Test_R1_ONE_PIECE.zip?raw=true) | 4.151 |
| [BoardBase/deliverables/Gridopoly_BoardBase_Test_R2_PRINT_FRIENDLY.zip](BoardBase/deliverables/Gridopoly_BoardBase_Test_R2_PRINT_FRIENDLY.zip?raw=true) | 5.504 |
| [BoardBase/interfaces/pcb-interface-2026-10-15/evidence/corner-current-Gerber.zip](BoardBase/interfaces/pcb-interface-2026-10-15/evidence/corner-current-Gerber.zip?raw=true) | 0.194 |
| [BoardBase/interfaces/pcb-interface-2026-10-15/evidence/long-current-Gerber.zip](BoardBase/interfaces/pcb-interface-2026-10-15/evidence/long-current-Gerber.zip?raw=true) | 0.191 |
| [PlayerConsoleStandV2/deliverables/Gridopoly_Player_Stand_V2_R1.zip](PlayerConsoleStandV2/deliverables/Gridopoly_Player_Stand_V2_R1.zip?raw=true) | 9.253 |
| [PlayerConsoleStandV2/deliverables/Gridopoly_Player_Stand_V2_R2_FPC60.zip](PlayerConsoleStandV2/deliverables/Gridopoly_Player_Stand_V2_R2_FPC60.zip?raw=true) | 9.464 |
| [PlayerConsoleStandV2/deliverables/Gridopoly_Player_Stand_V2_R3_EAR_REINFORCED.zip](PlayerConsoleStandV2/deliverables/Gridopoly_Player_Stand_V2_R3_EAR_REINFORCED.zip?raw=true) | 7.481 |
| [PlayerTokens/models/hi3d-remaining-30mm/deliverables/Gridopoly_30mm_Remaining/Gridopoly_Three_Tokens_30mm_Print.zip](PlayerTokens/models/hi3d-remaining-30mm/deliverables/Gridopoly_30mm_Remaining/Gridopoly_Three_Tokens_30mm_Print.zip?raw=true) | 71.540 |
| [PlayerTokens/references/gridopoly-four-token-monochrome-v2.zip](PlayerTokens/references/gridopoly-four-token-monochrome-v2.zip?raw=true) | 5.334 |
| [PlayerTokens/references/gridopoly-four-token-references-v1.zip](PlayerTokens/references/gridopoly-four-token-references-v1.zip?raw=true) | 4.787 |

PDF、预览、参数、重建脚本、原始接口证据和检查报告也在机器清单内。

## 保留在本地的恢复材料

6 个 `.blend1` 自动备份、2 个 `_Working.blend` 中间检查点和 Python 缓存不进入本次模型发布；对应正式 Blender 工程及全部 STL/3MF 已列入。忽略规则或 Git 属性由主会话管理。

## 验证范围

对比上一轮归档，165 个文件的 SHA256 全部未变，所有现存 STL/3MF 都出现在清单。
84条LFS文件路径对应73个独立对象（重复文件共享对象），合计1,365,369,470字节；全部从GitHub取回并通过独立SHA256与大小核对。模型公开不增加新的实物打印、配合或承载证据。
