Ha22yX/Gridopoly/Docs/hardware/development-handoff-2026-09-22.md

# 硬件开发汇报与总指挥交接

> **2026-10-15 现行效力补充：** 下文保留2026-09-22原阶段事实、未完成项和审核记录，不作为今天的设备状态。当前16板已完成V0.34部署并接入24V；用户将线圈略抬高于LCD后确认16板均可识别Tag，服务端也记录16个reader stable。ALFA USB热点已实证16格＋4屏共20台同时关联/注册，唯一16节点ORDER环ready、0～15及四角0/4/8/12自动分配通过；Pi软件重启后自动启动并恢复原房间，最终16格＋3屏有121.18秒观察。见[USB部署与启动验收](../firmware/usb-ap-deployment-2026-10-15.md)、[线圈装配反馈](../firmware/tile-rfid-screen-coupling-2026-10-15.md)及[当前交接](../CURRENT-DEVELOPMENT-HANDOFF.md)。

> 当前ORDER支持闭环，旧“无链首即冲突”和必须切断ORDER的建议已被后续实现替代；RS485仍未启用，不能据ORDER闭环证明A/B总线可闭环。三模块R2底板已获用户试装反馈，整盘Full16 R1的新接缝与承载另验。上述进展不等于量化电压/纹波/温升/启动浪涌、最终结构射频、无家庭网络冷上电或完整实体对局通过；玩家电池板的充电、欠压与热验收也仍未完成。现行待办以[供电验收](power-system-acceptance.md)、[首板清单](bring-up-checklist.md)和当前交接为准，本次文档整合未做新硬件测试。

> 2026-09-27效力补充：保留本阶段设计/只读审计证据。后续已实现V0.33角色profile、32节点ORDER环及配对，旧“ORDER拒绝环/板型待实现”不再是当前软件状态；RS485仍禁用。另有独立玩家电池底板候选；最新入口见[硬件索引](README.md)和[当前交接](../CURRENT-DEVELOPMENT-HANDOFF.md)，未重新做本文件的硬件实测。

日期：2026-09-22。来源：Gridopoly · PCB设计任务。用户要求汇报本任务所有开发并同步全部硬件相关文档。本轮只更新文档、读取既有记录并向总指挥交接，未修改EDA工程、业务固件、部署设备或进行新一轮硬件实测。

## 当前应采用的方案

- **两种棋盘PCB**：长边PCB2_1，原理图262b1ccbed23ba63/PCB7840864f79449b47；角落PCB2_5，原理图ae9c8047ce85d7f8/PCB6f97d7be5a40dd66。日期备份和旧PCB2_2不作为当前交付。
- 角落80×80mm；长边主体约48×80mm、局部最大宽约54mm。采用用户确认1.6mm六层、外层1oz，最终内层铜与叠层需制造方确认。
- 用户已取消USB-C PD→24V。角落改J301 DC5.5×2.1mm中心正极，外接稳压24V；采购建议24V/5A（120W）且具过流/短路保护。**整盘60W仍是设计目标，非120W制造放行；每板约1W负载预算仍有效。**
- 两板共用TPS26621受控支路和LMR16030SDDAR降压，保留J1本地USB5V/调试、TPS2121、INA226。GPIO11/12用于INA226，GPIO13 NC，不再有PD芯片/编程依赖。
- 板间每侧6Pin+3Pin：6Pin的1/2/3=24V、4=ORDER、5=A、6=B，另3Pin全GND。不是旧15触点磁吸，也不是把各模块负载电气串联。

## 本任务已做的开发沿革

| 工作 | 修改/结果 | 证据与当前效力 |
| --- | --- | --- |
| 接任与连接器核查 | 确认工程身份、区分备份；调查公母连接器配合 | [接任](pcb-design-handoff-2026-09-19.md)、[旧选型](connector-selection-2026-09-19.md)为历史；现行型号见pcb-variants |
| 原角落PCB清理 | 147个独立焊盘转原生过孔，保留位置/网络/钻孔/铜径/阻焊；当时独立焊盘归零 | 提交92291a2；不把该结果扩大到长边板或当前新入口 |
| 原角落局部布局 | 调整输入旁路/自举与电源回路、地过孔及5个铺铜，绕开ESP32天线下信号 | 提交49ae287；固定接口约束下射频净空仍待验证，旧DRC不能证明当前PCB通过 |
| 旧PD24方案 | 绘制STUSB4500及升降压入口，后改0–60W四开关、门限/连接器与补偿复核 | 3ec1dbd、2c91d0c、849dc6c、8f9d907、6466b1c；用户后来明确取消，不能再采购/实施 |
| 两板接入保护 | 两板新增U201、R201/R202/R204/R205/R206、C202/C203共8件；U23从PDDAR/C90665换为SDDAR/C136648，6脚改外接SS | e7e04cb、9f5c68f；原17件+新增8件，不是新增25件；当前仍保留 |
| 旧PD接入主控 | GPIO11/12共享I²C，GPIO13复位，删除J101，增加C128等 | 1ac9121；已随PD撤销，NVM驱动未开发且现在无需开发 |
| 文档整合 | 两板身份、供电、固件及验收路线整理 | 3fe38ab；本轮继续纠正其中过期PD正文和候选版本混淆 |
| 旧PD全板重排 | 218件候选，固定17件坐标/角度/层不动，重新分区/布线及独立检查 | [历史布局候选](corner-pcb-layout-candidate-2026-09-21.md)；原生DRC未放行，后被直流改版替代 |
| 改直接24V | 删除PD区72件、加入J301/F301/D301/D302/C301/C302共6件，角落净减66件至152；保留146件位置/层/角度，GPIO13改NC | [DC24变更](corner-dc24-input-2026-09-21.md)，工作树导出存在，尚不能称完整制造包已提交 |
| 导入更新修复 | 新6件复用旧PD唯一ID导致重复添加；删除36件重复和6件残留，重建一致独立ID/Channel ID，统一描述后重开验证 | [SyncRepair](../../PCB%20Files/CornerModule/DC24-2026-09-21/SyncRepair/README.md)：152件无重复、网表差异0；当时剩26间距/51未连接，不作当前重新DRC结果 |
| 供电原理图复核 | 角落35件97引脚、长边29件84引脚；181项引脚断言及公共参数核查通过 | 0ffe1cf、[审查](power-schematic-audit-2026-09-21.md)、[脚本](../../Tools/check_power_schematic_20260921.py)；用户排除PCB/屏幕/线圈，不冒称全板无问题 |
| 接口几何核查 | 四种连接组合36针方向/网络匹配；4角+28长边的32板模型名义闭合 | b2399ba、[接口审查](interconnect-audit-2026-09-21.md)；14.5mm排距只是模型假设，非制造间隙 |
| BOM与电源采购核对 | 角落13张匹配提示逐项核对；发现R26/R30缺料及用户商品插头尺寸不符 | [BOM](bom-review-2026-09-21.md)、[适配器](external-24v-supply.md)；无替料、下单或已锁库存 |

## 供电审查的准确结论

J301中心正→F301 4A→D301 SS56B→24V_BUS；D302 SMBJ26A及1µF/100nF对地。每板24V_BUS经U24→U201→U23→5V，本地保护不串在下游贯通电源中。U201 HP_RTN/EP与系统GND的处理已按手册核对，FLT控制U23 EN，配置不依赖MCU启动。

U201限流标称约152mA（估算144–161mA），UVLO标称19.16V、OVP28.16V；U23输出标称4.963V，外接软启动典型约0.55s。该限流意味着不能按U23“3A”宣称整块板可供5V/3A。单板约1W合理性核查通过，不证明任意LED全白/背光组合都合格。

60W总线下D301约1.8W发热是按0.7V压降计算的示例，尚无实测温升。U201后的输入电容充电模型不等于整个冷启动峰值；40路同时触及限流可能合计约5.74–6.42A，24V/5A电源也不能保证这个过载状态正常运行。只允许单点直流输入，未实现全盘60W自动限流或多源均流。

## 必须让总指挥掌握的未完成项

1. **数据闭环冲突**：全部板接口直接首尾连接会同时闭合A/B与ORDER。当前TileOrderTopology源码无链首时返回conflict/cycle；RS485应按线型总线，R15两板现为DNP。建议末段专用转接只通过24V/GND、断开ORDER/A/B，数据两端按总线配置终端；尚未设计/制造/验证这个转接件。
2. **机械待验证**：长边JOUT3相对JOUT1有0.127mm插入方向偏移；不是针序横向错位。跨厂家公母接触高度、行程、接缝与最后一处刚性闭合装配仍需实物验证。没有移动用户固定接口。
3. **PCB待放行**：现角落同步已修复但仍未完成入口/全部支路的最终布局布线、DRC、散热及制造检查；长边不能凭原理图审查视为PCB通过。旧候选独立检查和旧过孔优化PASS不适用于当前全部工程。
4. **采购**：C165751（R26/R30 23.7kΩ1%0603）截图库存0。C22912仅候选，尚未替换或确认当前贴片库存。LED1为黄、WS2812为RGB、X1为5V4MHz有源；同料多行BOM不删位号。用户展示的24V5A电源选项为5.5×2.5mm，不符合5.5×2.1mm要求，极性/成色/实际输出未确认。
5. **固件**：PD驱动取消；待开发板型/revision、低功耗启动/USB维护、INA226有效性、LED/背光预算和多板恢复。RS485尚未启用。见[直流供电固件要求](../firmware/module-power-firmware.md)。
6. **实物验证**：单板→2～3板→16/24/32/40板的冷启动、纹波/动态、断环、压降、温升、插拔及故障恢复尚未完成。用户最近要求不检查屏幕/线圈，不得把排除项算通过。

## 软件与设备状态边界

本PCB任务没有为此次直流供电改版编译/烧录TileModule、服务器或玩家屏；设备现版本本轮未重读。项目旧记录中ORDER V0.32双板验证、COM6指定40MHz等属其他端已有成果，不计作本轮新增或当前整盘实测。完整业务、玩家屏视觉与性能待办仍由总指挥维护，本轮未覆盖其既有改动。

## 后续责任与Git交接

| 负责方 | 具体下一步 |
| --- | --- |
| 总指挥 | 审阅本报告与文档差异，按共享索引规则串行提交明确文档范围；把PD待办移除、将数据断点列为整盘前置条件，协调硬件/格子/服务器任务 |
| PCB/硬件 | 在获授权的后续实施范围内落实闭合转接与机械配合，完成当前直接24V两板布局布线、同版导出和制造检查 |
| 格子固件 | 实现/验证明确板型、功耗和测量故障语义；保留当前业务兼容，不加入PD启动依赖 |
| 服务端/网页 | 依据已冻结拓扑验证ORDER扩容/恢复；任何能力字段先版本化，不伪造整盘功率测量 |
| 实物验收 | 按[供电清单](power-system-acceptance.md)与[首板清单](bring-up-checklist.md)记录测量与失败，由用户提供实体装配/负载窗口 |

本轮开始HEAD为b2399ba，共享工作树已有多端Docs、EDA工程、备份删除和服务器改动。已保留它们，未暂存或提交共享索引；交由总指挥统一审核。文档当前更新不等于已有未提交EDA/导出被提交，更不能提交整个目录夹带工程缓存或删除旧备份。

本轮对所有hardware顶层文档按“现行规范/原日期审查/历史记录”更新效力或正文，另更新Docs总索引、当前交接、硬件相关固件入口/指南/路线以及根README；新增外接电源选型和当前供电固件规范。本次验证为链接/文档一致性检查，不重跑硬件或软件功能测试。

文档验证结果：本轮更新/新增31份Markdown；涉及文档内相对路径链接全部存在，git diff --check在本轮明确文档范围通过。未重跑181项电气检查或进行新硬件测量；报告引用的是2026-09-21原始审查。当前轮差异清单和与轮前内容的补丁保存在本机临时目录gridopoly-docs-handoff-20260922，供总指挥区分共享工作树原有改动。

## 总指挥文档审核（2026-09-22）

已逐份审核本次31份文档的变更及新增全文，区分PD历史、当前直流方案与待验收项；修正文档更新日期与原BOM核查时间、旧候选DRC与当前PCB状态，以及5A适配器建议与实际采购的措辞。整盘联调前须冻结ORDER/A/B数据断点，或完成另行批准的新拓扑实现；本次未安排新的EDA或设备操作。

提交范围仅为本次清单中的31份Markdown，包含原工作树已有、现经审核纳入的直流入口及历史布局候选文档和入口说明。它们引用的DC24/LayoutCandidate等工作树工程导出并未随文档提交；是否可用于制造仍按对应验证边界判断。本次未重做硬件电气验证。
