Ha22yX/Gridopoly/Docs/hardware/esp32-s3-pin-map.md

# Gridopoly 单格模块引脚与接口定义

> 2026-10-15现行效力：本页引脚/网络表以9/21两板导出为接线基线；下述“入口布局布线未完成”是当时阶段状态，不代表当前实板仍未布线。现16板已接入24V，抬高线圈后基础识别及服务端16个reader stable、唯一ORDER环/四角自动分配已有证据；量化电气、最终结构射频与完整实体对局仍另验。现行入口见[硬件索引](README.md)、[试玩记录](../firmware/trial16-release-2026-10-15.md)与[供电验收](power-system-acceptance.md)，本次未重导或修改EDA。

> 2026-09-22文档同步：[硬件入口](README.md)汇总直接24V、BOM与接口结论；[开发汇报](development-handoff-2026-09-22.md)区分历史修改、已验证及待验收。原日期的核查数据未在本轮重新测量。

> 2026-09-21 历史变更：用户已取消角落 PD→24V，改为 5.5×2.1mm 中心正极的直接24V输入；见[当前直流入口设计](corner-dc24-input-2026-09-21.md)。该次角落改为PCB2_5；原理图与PCB器件/网络已更新，当时入口布局布线和整盘验收待完成。

> 当前角落已删除整套PD源及配置电路；GPIO11/12仅服务原INA226，GPIO13标为NC。

接线导出基线：2026-09-21；现行效力补充：2026-10-15

本文接线表依据 2026-09-21 两种原理图导出，共同核心沿用早期PCB复核。
该次角落直接24V改版已完成器件关联/焊盘网络同步修复，但当时布局布线和制造检查未完成；长边新增电源区当时也未获PCB放行。历史导出不构成当前完整PCB验收或实物制造版本证明。

## 1. 当前硬件快照

- 长边 PCB2_1 / 7840864f79449b47；角落 PCB2_5 / 6f97d7be5a40dd66，详见[板型对照](pcb-variants.md)。
- 两板 ESP32-S3-WROOM-1-N16R8，16MB Flash、8MB Octal PSRAM；现有六层铜。
- J4 为2×4屏幕母座；10颗WS2812由GPIO21驱动。
- 母线24V_BUS；每侧6Pin+3Pin共9触点，3正极/3地/A/B/ORDER。
- U23当前原理图为LMR16030SDDAR；U201受控接入保护。角落另有J301直接24V输入。
- GPIO11/12仍为CURRENT_SCL/SDA；GPIO13不再接PD。
- 历史144器件/136 BOM统计已过期，制造数量从最终两板快照分别导出。

## 2. 电源域

| 网络 | 含义 |
| --- | --- |
| `24V_BUS` | 模块间直通的 24V 母线 |
| `HP_RAW` | U24 后、U201 前的输入；D6/C53 接此处 |
| `HP_RTN` | U201 局部参考/EP，不得与 GND 短接 |
| `24V_BUCK_IN` | U201 受控输出后的本地降压输入 |
| `5V_FROM_24` | U23 降压后的原始 5V |
| `5V_FROM_24_FUSED` | U8 自恢复保险丝后的本地 5V 支路 |
| `USB_VBUS` | USB Type-C 输入的 5V |
| `USB_5V_FUSED` | U7 自恢复保险丝后的 USB 5V 支路 |
| `5V_SELECTED` | TPS2121 输出、R31 分流电阻之前 |
| `5V_IN` | R31 之后的本模块主 5V |
| `5V_RFID` | FB1 滤波后的 RFID 5V |
| `3V3_SYS` | TPS62160DGKR 输出的系统 3.3V |
| `GND` | 全板公共地 |

完整供电路径：

```text
24V_BUS
   |
  U24 2920L150/60GR
   |
HP_RAW → U201 TPS26621（限流/限速）
   |
24V_BUCK_IN
   |
  U23 LMR16030SDDAR
   |
  L2 8.2uH
   |
5V_FROM_24
   |
  U8 2016L300/16MR
   |
5V_FROM_24_FUSED -----> U9 TPS2121 IN1

USB_VBUS
   |
  U7 2016L300/16MR
   |
USB_5V_FUSED ---------> U9 TPS2121 IN2

U9 OUT -> 5V_SELECTED -> R31 10mΩ -> 5V_IN
                                            |
                                            +-> U25 TPS62160DGKR -> 3V3_SYS
                                            +-> FB1 -> 5V_RFID
                                            +-> WS2812

3V3_SYS ---------------------------------------> 屏幕 J4
```

`24V_BUS`在输入、输出连接器之间直通。U24只保护本模块的降压支路，不会切断
下游模块的母线。

## 3. ESP32-S3 物理引脚

N16R8 使用 Octal PSRAM，GPIO35、GPIO36、GPIO37 不可作为普通外设引脚。
ESP32-S3 的 GPIO 均不耐受 5V。

| U3 Pin | 模块引脚 | 当前网络 | 功能 | 状态 |
| ---: | --- | --- | --- | --- |
| 1 | GND | `GND` | 地 | 已连接 |
| 2 | 3V3 | `3V3_SYS` | 主控供电 | 已连接 |
| 3 | EN | `MCU_EN` | 10kΩ上拉、1µF对地、RESET | 已连接 |
| 4 | GPIO4 | `LCD_RST` | 屏幕复位 | 已连接 |
| 5 | GPIO5 | `LCD_DC` | 屏幕数据/命令 | 已连接 |
| 6 | GPIO6 | `LCD_MOSI` | 屏幕 SPI 数据 | 已连接 |
| 7 | GPIO7 | `LCD_SCLK` | 屏幕 SPI 时钟 | 已连接 |
| 8 | GPIO15 | `LCD_CS` | 屏幕片选 | 已连接 |
| 9 | GPIO16 | `LCD_BL_PWM` | 屏幕背光 PWM | 已连接 |
| 10 | GPIO17 | `ESP_RFID_SCLK` | HTRC110 串行时钟 | 已连接 |
| 11 | GPIO18 | `ESP_RFID_DIN` | 发往 HTRC110 的数据 | 已连接 |
| 12 | GPIO8 | `ESP_RFID_DOUT` | 来自 HTRC110 的数据 | 已连接 |
| 13 | GPIO19 | `USB_DM_MCU` | USB D- | 已连接 |
| 14 | GPIO20 | `USB_DP_MCU` | USB D+ | 已连接 |
| 15 | GPIO3 | - | 启动配置相关 | 未连接，谨慎使用 |
| 16 | GPIO46 | - | 启动配置、仅输入 | 未连接，谨慎使用 |
| 17 | GPIO9 | `ESP_ORDER_IN` | 顺序检测输入 | 已连接 |
| 18 | GPIO10 | `ESP_ORDER_OUT` | 顺序开漏输出控制 | 已连接 |
| 19 | GPIO11 | `CURRENT_SCL` | INA226 I2C SCL | 已连接 |
| 20 | GPIO12 | `CURRENT_SDA` | INA226 I2C SDA | 已连接 |
| 21 | GPIO13 | 无连接 | 预留 | 两板未连接；角落已加NC |
| 22 | GPIO14 | `RS485_DIR` | RS485 DE 与 /RE | 已连接 |
| 23 | GPIO21 | `ESP_LED_DATA_3V3` | WS2812 数据 | 已连接 |
| 24 | GPIO47 | - | 扩展 | 未连接 |
| 25 | GPIO48 | - | 扩展 | 未连接 |
| 26 | GPIO45 | - | 启动配置相关 | 未连接，谨慎使用 |
| 27 | GPIO0 | `MCU_BOOT` | BOOT 按键/下载模式 | 已连接 |
| 28 | GPIO35 | 内部 Octal PSRAM | 不可外用 | 禁止使用 |
| 29 | GPIO36 | 内部 Octal PSRAM | 不可外用 | 禁止使用 |
| 30 | GPIO37 | 内部 Octal PSRAM | 不可外用 | 禁止使用 |
| 31 | GPIO38 | - | 扩展 | 未连接 |
| 32 | GPIO39 | - | 扩展/JTAG | 未连接 |
| 33 | GPIO40 | - | 扩展/JTAG | 未连接 |
| 34 | GPIO41 | - | 扩展/JTAG | 未连接 |
| 35 | GPIO42 | - | 扩展/JTAG | 未连接 |
| 36 | GPIO44/RXD0 | `U3_RXD0` | RS485 UART 接收 | 已连接 |
| 37 | GPIO43/TXD0 | `U3_TXD0` | RS485 UART 发送 | 已连接 |
| 38 | GPIO2 | - | 扩展 | 未连接 |
| 39 | GPIO1 | - | 扩展 | 未连接 |
| 40 | GND | `GND` | 地 | 已连接 |
| 41 | EPAD/GND | `GND` | 模组地/散热焊盘 | 已连接 |

旧文档曾将 INA226 写成 GPIO12/13；当前正确值为 GPIO11=SCL、
GPIO12=SDA。两种板均保留INA226总线及原4.7k上拉，角落已删除STUSB4500支路；GPIO13未连接。

## 4. 固件板级定义

```cpp
#pragma once

#define PIN_LCD_RST          4
#define PIN_LCD_DC           5
#define PIN_LCD_MOSI         6
#define PIN_LCD_SCLK         7
#define PIN_LCD_CS          15
#define PIN_LCD_BL_PWM      16

#define PIN_RFID_SCLK       17
#define PIN_RFID_DIN        18
#define PIN_RFID_DOUT        8

#define PIN_ORDER_IN         9
#define PIN_ORDER_OUT       10

#define PIN_CURRENT_SCL     11
#define PIN_CURRENT_SDA     12
#define INA226_I2C_ADDR   0x40

#define PIN_RS485_DIR       14
#define PIN_RS485_TX        43
#define PIN_RS485_RX        44

#define PIN_LED_DATA        21

#define PIN_USB_DM          19
#define PIN_USB_DP          20
#define PIN_BOOT             0
```

INA226 初始化：

```cpp
Wire.begin(PIN_CURRENT_SDA, PIN_CURRENT_SCL); // SDA=12, SCL=11
```

GPIO 数字只应在一个板级头文件中维护，业务代码不要散落裸数字。

## 5. 屏幕接口 J4

J4 为 `DS1023-2*4SF11`，LCSC `C92271`。PCB 当前焊盘网络如下：

| J4 Pin | 网络 | ESP32-S3 | 屏幕信号 |
| ---: | --- | --- | --- |
| 1 | `GND` | - | GND |
| 2 | `3V3_SYS` | - | 3V3 |
| 3 | `LCD_BL_PWM` | GPIO16 | PWR/BL |
| 4 | `LCD_CS` | GPIO15 | CS |
| 5 | `LCD_SCLK` | GPIO7 | SCL |
| 6 | `LCD_MOSI` | GPIO6 | SDA |
| 7 | `LCD_DC` | GPIO5 | WR/DC |
| 8 | `LCD_RST` | GPIO4 | RST |

该顺序与旧文档中的 J2 顺序相反，是公母连接器面对面插合后的镜像结果。制作
线束、封装或转接板时必须同时核对 Pin 1 标记和观察方向，不能只按视觉左右顺序。

接口没有 MISO，ST7789 当前为只写 SPI，ESP32 不能从屏幕读回像素或寄存器。

## 6. USB Type-C 接口 J1

| J1 引脚组 | 网络 | 连接 |
| --- | --- | --- |
| A4/B9、B4/A9 | `USB_VBUS` | 经 U7 到 TPS2121 IN2 |
| A5 | `USB_CC1` | 5.1kΩ 到 GND |
| B5 | `USB_CC2` | 5.1kΩ 到 GND |
| A6/B6 | `USB_DP` | D1 ESD、22Ω、`USB_DP_MCU`、GPIO20 |
| A7/B7 | `USB_DM` | D1 ESD、22Ω、`USB_DM_MCU`、GPIO19 |
| A8/B8 | - | NC |
| A1/B12、B1/A12 | `GND` | 公共地 |
| SHELL 1～4 | `GND` | 当前直接接公共地 |

D1 为 `TPD2EUSB30DRTR`。USB D+/D- 应按 90Ω 差分阻抗布线，D1 靠近
Type-C，22Ω串联电阻靠近 ESP32。

CC1/CC2 只声明本板为受电设备。当前没有读取上游电源宣告能力，不能默认任意
电脑 USB 口都能持续提供 3A。

## 7. 当前板间接口：6Pin + 3Pin

两板当前接口相同：JIN1/JOUT1 的1/2/3为24V_BUS，4为ORDER_IN/OUT，5为BUS_A，6为BUS_B；JIN3/JOUT3的三个脚全为GND。
型号、机械方向和实际镜像核对见[PCB板型](pcb-variants.md)与[互连规范](module-interconnect-5wire.md)。旧五组3Pin磁吸针序不再使用。

## 8. ORDER 顺序检测

```text
JIN1.4 ORDER_IN -> R16 1kΩ -> ESP_ORDER_IN / GPIO9
                                      |
                                      +-> R17 10kΩ -> 3V3_SYS
                                      +-> C24 100nF -> GND

GPIO10 / ESP_ORDER_OUT -> R18 1kΩ -> Q1 Gate
                                      |
                                      +-> R19 100kΩ -> GND

Q1 Source -> GND
Q1 Drain  -> ORDER_OUT -> JOUT1.4
```

Q1 为 2N7002 开漏输出。下一级通过 R17 上拉，避免相邻模块的 3.3V 电源
被直接并联。

## 9. RS485

U6 为 `SN65HVD75DR`，3.3V 半双工收发器。

| U6 Pin | 名称 | 当前网络 |
| ---: | --- | --- |
| 1 | R | `U3_RXD0` -> GPIO44 |
| 2 | /RE | `RS485_DIR` |
| 3 | DE | `RS485_DIR` |
| 4 | D | `U3_TXD0` <- GPIO43 |
| 5 | GND | `GND` |
| 6 | A | `BUS_A` |
| 7 | B | `BUS_B` |
| 8 | VCC | `3V3_SYS` |

配套电路：

- C23：100nF，VCC 到 GND。
- R14：10kΩ，将 `RS485_DIR` 下拉，上电默认接收。
- R15：120Ω，跨 `BUS_A/B`，DNP，仅物理总线两端装配。
- D4：SM712，保护 `BUS_A/B`，应靠近信号触点。

## 10. 125kHz RFID

### 10.1 数字接口

| 方向 | ESP32 | 电平转换 | HTRC110 |
| --- | --- | --- | --- |
| ESP32 -> HTRC110 | GPIO17 `ESP_RFID_SCLK` | U5 通道1，3.3V转5V | `HTRC_SCLK` |
| ESP32 -> HTRC110 | GPIO18 `ESP_RFID_DIN` | U5 通道2，3.3V转5V | `HTRC_DIN` |
| HTRC110 -> ESP32 | GPIO8 `ESP_RFID_DOUT` | U4，5V转3.3V | `HTRC_DOUT_5V` |

### 10.2 HTRC110 U1

| U1 Pin | 名称 | 当前网络/连接 |
| ---: | --- | --- |
| 1 | VSS | `GND` |
| 2 | TX2 | `U1_TX2`，调谐电容组 |
| 3 | VDD | `5V_RFID` |
| 4 | TX1 | `U1_TX1` -> R9 27Ω/1W -> C13 100nF -> 天线 |
| 5 | MODE | `GND` |
| 6 | XTAL1 | `RFID_CLK_4M` |
| 7 | XTAL2 | NC |
| 8 | SCLK | `HTRC_SCLK` |
| 9 | DIN | `HTRC_DIN` |
| 10 | DOUT | `HTRC_DOUT_5V` |
| 11 | NC | NC |
| 12 | CEXT | `RFID_CEXT`，C7 100nF 到 GND |
| 13 | QGND | `RFID_QGND_FILT`，C8 100nF 到 GND |
| 14 | RX | `U1_RX` -> R8 270kΩ -> `ANT_TAP_HV` |

X1 为 4MHz、5V 有源振荡器，供电接 `5V_RFID`，输出接 `RFID_CLK_4M`。

### 10.3 天线 J3

| J3 Pin | 网络 | 用途 |
| ---: | --- | --- |
| 1 | `ANT_COIL_A` | 外部线圈第一端 |
| 2 | `ANT_TAP_HV` | 外部线圈第二端和 RX 采样点 |

调谐电容接在 `ANT_TAP_HV` 与 `U1_TX2` 之间：

- C14～C17：4 × 1nF
- C18：220pF
- C19、C20：DNP 调试焊盘
- 标称总值：约 4.22nF

当前格子固件使用HITAG S256；下列EM4100/TK4100段落保留为早期协议说明，不是现行驱动待办或当前多标签能力结论，现行验收见[首板清单](bring-up-checklist.md)。

4.22nF 在 125kHz 理想对应约 384µH。最终必须使用实际线圈，在屏幕和结构件
安装完成后测量并调谐。固件仍需完成 EM4100/TK4100 Manchester 解码、
奇偶校验和 ID 提取。

EM4100/TK4100 不提供防冲突机制。多个棋子同时位于同一线圈场内时，数据会
叠加并通常导致校验失败或读数不稳定；固件应上报“无有效帧/疑似碰撞”，不得
承诺同时识别多个标签。

## 11. WS2812 LED 阵列

GPIO21 已实际连接，不再是规划项。

```text
GPIO21 / ESP_LED_DATA_3V3
   -> U5 Pin 9 (3A)
   -> U5 Pin 8 (3Y) / LED_DATA_5V_RAW
   -> R38 330Ω
   -> LED_DATA_01
   -> U12 -> U13 -> U14 -> U15 -> U16
   -> U17 -> U18 -> U19 -> U20 -> U21
```

| LED | DIN | DOUT |
| --- | --- | --- |
| U12 | `LED_DATA_01` | `LED_DATA_02` |
| U13 | `LED_DATA_02` | `LED_DATA_03` |
| U14 | `LED_DATA_03` | `LED_DATA_04` |
| U15 | `LED_DATA_04` | `LED_DATA_05` |
| U16 | `LED_DATA_05` | `LED_DATA_06` |
| U17 | `LED_DATA_06` | `LED_DATA_07` |
| U18 | `LED_DATA_07` | `LED_DATA_08` |
| U19 | `LED_DATA_08` | `LED_DATA_09` |
| U20 | `LED_DATA_09` | `LED_DATA_10` |
| U21 | `LED_DATA_10` | NC |

U12～U21 均由 `5V_IN` 供电、接 `GND`，每颗旁边配置一颗 100nF
去耦电容 C42～C51。U22 为 `5V_IN` 上的 470µF/10V 阵列储能电容。

WS2812 按串行级联工作，ESP32 使用一根数据线即可为每颗 LED 设置不同颜色。

## 12. 24V 转本地 5V

U23 为 `LMR16030SDDAR`，LCSC `C136648`。

| U23 Pin | 名称 | 当前网络/连接 |
| ---: | --- | --- |
| 1 | BOOT | `BUCK24_BOOT`，C56 100nF 到 SW |
| 2 | VIN | `24V_BUCK_IN` |
| 3 | EN | `HP_RUN`，U201 FLT 与 R206 控制 |
| 4 | RT/SYNC | `BUCK24_RT`，R39 49.9kΩ 到 GND |
| 5 | FB | `BUCK24_FB` |
| 6 | SS | `HP_SS`，C203 2.2µF 到 GND |
| 7 | GND | `GND` |
| 8 | SW | `BUCK24_SW` |
| 9 | EP | `GND` |

关键外围：

| 器件 | 参数 | 作用 |
| --- | --- | --- |
| U24 | 2920L150/60GR，1.5A hold/3A trip | 本模块 24V 支路保护 |
| D6 | SMBJ30A | Pin1接HP_RAW、Pin2接GND |
| C52/C55 | 2 × 2.2µF/100V | 输入陶瓷电容 |
| C53 | 100nF/100V | HP_RAW侧输入高频去耦 |
| C54 | 47µF/63V | 输入储能 |
| C56 | 100nF | BOOT-SW |
| D3 | SS510 | 续流二极管，Pin1接SW、Pin2接GND |
| L2 | 8.2µH | 输出电感 |
| C35～C38 | 4 × 22µF/16V | 输出滤波 |
| R34/R35 | 100kΩ/17.8kΩ | 5V 反馈分压 |

U201及R201/R202/R204/R205/R206/C202/C203共8件新增器件详见[直接24V供电复核](power-schematic-audit-2026-09-21.md)。U23换型、HP_RUN、HP_SS及HP_RTN必须一起同步PCB；本地限流约144–161mA，不再按5V/3A作为整板可用额定。

角落原PD入口USB1已删除，改为J301直接24V输入；本节J1仍保留。

## 13. 双路 5V 与电流检测

U9 为 `TPS2121RUXR`：

- IN1：`5V_FROM_24_FUSED`
- IN2：`USB_5V_FUSED`
- OUT：`5V_SELECTED`
- ST：`PWRMUX_STATUS`
- ILM：`PWRMUX_ILIM`
- SS：`PWRMUX_SS`

配置网络：

| 器件 | 连接/数值 |
| --- | --- |
| R20/R21 | IN1 到 PR1 为 9.1kΩ，PR1 到 GND 为 4.7kΩ |
| R22/R23 | IN2 到 CP2 为 10kΩ，CP2 到 GND 为 4.7kΩ |
| R26/R27 | IN1 到 OV1 为 23.7kΩ，OV1 到 GND 为 5.1kΩ |
| R30/R28 | IN2 到 OV2 为 23.7kΩ，OV2 到 GND 为 5.1kΩ |
| R24 | `PWRMUX_STATUS` 通过 10kΩ上拉到 3.3V |
| R25 | `PWRMUX_STATUS` 到 `PWRMUX_PR1_CFG`，1MΩ |
| R29 | ILM 到 GND，36kΩ |
| C25 | SS 到 GND，100nF |

`PWRMUX_STATUS` 没有连接到 ESP32 GPIO，而是参与 TPS2121 的硬件优先级/
迟滞网络。固件不能直接判断当前由 USB 还是 24V 支路供电。

U10 为 `INA226AIDGSR`，地址 `0x40`：

```text
5V_SELECTED -> R31 10mΩ -> 5V_IN -> 本模块全部负载
```

| U10 Pin | 名称 | 当前网络 |
| ---: | --- | --- |
| 1 | A1 | GND |
| 2 | A0 | GND |
| 3 | ALERT | NC |
| 4 | SDA | `CURRENT_SDA` -> GPIO12 |
| 5 | SCL | `CURRENT_SCL` -> GPIO11 |
| 6 | VS+ | `3V3_SYS` |
| 7 | GND | GND |
| 8 | VBUS | `5V_IN` |
| 9 | VIN- | `5V_IN` |
| 10 | VIN+ | `5V_SELECTED` |

R31 为 10mΩ、2W、1%，不是 10MΩ。PCB 上必须从 R31 两端分别引 Kelvin
采样线到 VIN+ 和 VIN-。

R32、R33 分别将 SDA、SCL 以 4.7kΩ上拉到 `3V3_SYS`。ALERT Pin 3 当前
未连接，固件应轮询测量值。

推荐固件基线：

```text
Current_LSB = 100uA/bit
Calibration = 0x1400
Power_LSB   = 2.5mW/bit
```

未写 Calibration 寄存器时 Current 和 Power 会保持为零。完整初始化和换算见
[固件开发指南](../firmware/firmware-development-guide.md)。

## 14. 5V 转 3.3V

U25 使用可调输出 `TPS62160DGKR`，当前反馈网络设置为约 3.3V：

| U25 Pin | 当前连接 |
| ---: | --- |
| 1 PGND | `GND` |
| 2 VIN | `5V_IN` |
| 3 EN | `5V_IN`，上电自动使能 |
| 4 AGND | `GND` |
| 5 FB | 反馈中点；R7 312kΩ 到 `3V3_SYS`，R36 100kΩ 到 GND |
| 6 VOS | 直接检测 `3V3_SYS` 输出节点 |
| 7 SW | `BUCK3V3_SW` -> L1 2.2µH -> `3V3_SYS` |
| 8 PG | 当前未连接 |

输入为 C39 10µF 和 C40 100nF；输出为 C2 22µF。反馈公式按
`VOUT = 0.8V * (1 + 312k/100k)` 计算，标称约 3.296V。L1 必须使用满足
TPS62160 峰值电流要求的屏蔽功率电感，不能只按 2.2µH 容值选择普通信号电感。

## 15. 测试点与指示灯

| 位号 | 网络 |
| --- | --- |
| TP1 | `5V_IN` |
| TP2 | `3V3_SYS` |
| TP3 | `GND` |
| TP4 | `5V_RFID` |
| TP5 | `24V_BUCK_IN` |

TP1～TP5 加入 PCB，但不加入 BOM。

D2 与 R7 组成 3.3V 电源指示灯：

```text
3V3_SYS -> D2 -> R7 2.2kΩ -> GND
```

它是电源灯，不是固件运行状态灯。ESP32 软件复位时不会熄灭，只有 3.3V
掉电时才会熄灭。

按键：

| 位号 | 功能 | 连接 |
| --- | --- | --- |
| SW1 | BOOT | 按下将 `MCU_BOOT`/GPIO0 拉低 |
| SW2 | RESET | 按下将 `MCU_EN` 拉低 |

## 16. 特殊布线网络

| 网络 | 要求 |
| --- | --- |
| `USB_DP`/`USB_DM` | 90Ω差分阻抗，同层、同参考面、少过孔、组内等长 |
| `BUS_A`/`BUS_B` | 差分成对、连续参考地、避免长支线 |
| `BUCK24_SW` | 最小铜区和最短回路，远离 RFID、USB、天线 |
| `BUCK_SW` | 最小铜区和最短回路，远离敏感信号 |
| `ANT_COIL_A`/`ANT_TAP_HV` | 短、远离数字边沿和开关节点，按高交流电压留间距 |
| `U1_TX1`/`U1_TX2`/`U1_RX` | RFID 模拟网络，按天线区集中布局 |
| `5V_SELECTED`/`5V_IN` | 主电流网络，R31使用宽铜与Kelvin采样 |
| `24V_BUS` | 6触点汇流，使用宽铜皮而非普通信号线 |
| `LED_DATA_01`～`LED_DATA_10` | 按物理 LED 顺序短接，避免靠近 RFID RX |

只有 USB D+/D- 需要严格长度匹配。RS485 A/B 应保持相近长度，但不需要 USB
级别的严格等长。SPI 和 WS2812 在本板距离内以短、连续参考地优先。

## 17. 维护规则

1. 原理图变更后，用嘉立创EDA API读取 PCB 焊盘网络再更新本文档。
2. 固件 GPIO 只从本文档和统一板级头文件派生。
3. 新选贴片器件优先要求嘉立创贴装库存不少于 1000。
4. 位号、网络、Footprint、MPN、LCSC 在原理图、PCB、BOM 和文档中保持一致。
5. 屏幕和 JOUT1 必须保留镜像针序说明。
6. DRC 为零不代表电路安全；电源方向、极性、载流、阻抗和实物装配仍需人工复核。
7. 固件启动顺序、默认 GPIO 状态和驱动参数以
   [固件开发指南](../firmware/firmware-development-guide.md)为准。
