Ha22yX/Gridopoly/Docs/hardware/hardware-baseline.md

# Gridopoly 硬件基线

> **2026-10-15 当前状态：** 棋盘为长边 PCB2_1（141 件，底面 48 件）和角落 PCB2_5（152 件，底面 46 件），当前原生机械/布局图元与 9/21 归档一致；用户已确认两种实板自然插合后同面、共面。16 块计划格子均为 V0.34，用户已接入 24V，并在线圈略高于 LCD 后确认 16 板均能识别 Tag；服务端也观察到全部 reader stable。ALFA AWUS036ACM USB 热点已实证 16 格＋4 屏共 20 台同时关联/注册，16 节点唯一 ORDER 环及 0～15 自动分配、四角 0/4/8/12 已通过。上述结果不替代电气量测、完整实体游戏或玩家电池功能验收；36 台与无家庭网冷上电仍待验。见[USB 部署与现场证据](../firmware/usb-ap-deployment-2026-10-15.md)、[RFID 装配记录](../firmware/tile-rfid-screen-coupling-2026-10-15.md)及[机械冻结接口](../../Mechanical/BoardBase/interfaces/pcb-interface-2026-10-15/mechanical-interface.json)。

> 2026-09-22文档同步：[硬件入口](README.md)汇总直接24V、BOM与接口结论；[开发汇报](development-handoff-2026-09-22.md)区分历史修改、已验证及待验收。原日期的核查数据未在本轮重新测量。

> 2026-09-21 历史变更：用户取消角落 PD→24V，改为 5.5×2.1mm 中心正极的直接24V输入；见[直流入口设计](corner-dc24-input-2026-09-21.md)。角落改为PCB2_5；该日记录原理图与PCB器件/网络已更新，入口布局布线和整盘验收待完成。后续状态见本页当前更新，保留当日记录。

更新：2026-10-15（设计与实机证据分别按原始核查日期）。当前是长边、角落两种棋盘 PCB；旧 PD [布局布线候选版](corner-pcb-layout-candidate-2026-09-21.md)已被直接 24V 改版替代。现有实板已完成 USB 分批写验，并用于 24V 接入后的 16 板读卡及闭环运行；当前机械接口也已从原生工程及 Gerber 复核；不能再把 9/21 的“布局布线待完成”直接当作当前板仍无布线的结论。实板批次尚未与制造文件哈希绑定，棋盘电气制造放行与整盘验收仍未闭合。

## 设计源

工程为 Gridopoly，本地工作工程为 `PCB Files/Gridopoly.eprj2`。两种板的 UUID、接口、机械约束与导出优先级见[两种 PCB 设计](pcb-variants.md)。`Gridopoly-current.epro2` 及日期备份不保证与编辑中工程一致。

旧 2026-07-31 的 144 器件/136 BOM 数量只描述当时单板快照，已不能代表两种当前板。最终采购数量必须从各自下单快照导出；不要将原理图图元数、连接引脚数与 BOM 元件数混用。

## 共同硬件

| 子系统 | 当前原理图基线 |
| --- | --- |
| MCU | U3 ESP32-S3-WROOM-1-N16R8 / C2913202 |
| LCD | ST7789，240×320，只写 SPI；J4 DS1023-2*4SF11 / C92271 |
| RFID | U1 HTRC11001T/03EE,11 / C501317；外部 4MHz 有源振荡器；线圈需装配调谐 |
| RGB | U12～U21，10 × WS2812B-B-V6 / C52941391 |
| RS485 | U6 SN65HVD75DR / C57928，硬件预留；当前计划格子 V0.34 未启用传输 |
| ORDER | GPIO9 输入、GPIO10 经 Q1 开漏输出；当前物理信标 + HTTP 上报 |
| 支路保护 | U201 TPS26621DRCR / C1848341，新增 7 个配套阻容 |
| 24V→5V | U23 LMR16030SDDAR / C136648，外接 SS；替代旧 PDDAR |
| 本地电源选择 | U9 TPS2121RUXR / C485916 |
| 本地电量 | U10 INA226AIDGSR / C49851；R31 10mΩ 2W 1% / C346923 |
| 3.3V | U25 TPS62160DGKR |

板间接口为每侧 9 触点（3 正极、3 地、A/B/ORDER 各 1），详见[互连定义](module-interconnect-5wire.md)。J1 是本地 USB 5V/调试口；角落 J301 为直接24V入口。

## 当前供电路径

```text
角落 J301 → F301保险丝 → D301反接/回灌阻断 → 24V_BUS（D302 TVS及C301/C302对地）
                                                                          │
板间 24V_BUS 直通 ── 本板 U24 → HP_RAW → U201 → 24V_BUCK_IN → U23 → 5V_FROM_24
                                                              5V_FROM_24 → U8 → TPS2121 IN1
本板 J1 USB_VBUS → U7 ────────────────────────────────────────────────────────→ TPS2121 IN2
TPS2121 OUT → 5V_SELECTED → R31 → 5V_IN → TPS62160 → 3V3_SYS
                                      └→ FB1 → 5V_RFID
```

U201 只保护本地支路，不串在下游总线中；HP_RTN/EP 不是 GND。INA226 只测本板 5V 侧，不能直接测整盘 24V 总功率。PWRMUX_STATUS 未接 MCU；RFID 振荡器 OE 硬件上拉，不能虚构软件关断 GPIO。

## 电源能力及边界

- 当前入口是稳压24V直流电源，选型建议24V/5A（120W），5.5×2.1mm中心正极；额定电源功率不等于板端允许负载；单板或16–40模块、总负载60W为设计目标。
- 母座5.5×2.1mm中心正极。总线电压随输入及D301/线缆压降变化，不再有PD或24V升压闭环。
- PD NVM、GPIO13复位与旧67.13W计算取消。INA226仍仅测本板5V功率。
- 保留本地U201限流/软启动及U23降压；约1W模块的原限制仍适用，全白LED与外设功率需重新预算。
- 直接24V已由用户接入16板；线圈略高于LCD后16板读卡和服务端reader stable已有证据。这是运行/识别结果，尚缺绑定实板制造版本、同版电气/制造复核、启动浪涌、轻满载纹波、压降、散热与插拔测试；40板同时启动能力也未验证。不得宣称已稳定投产。
- 当前设计默认一个直流注入点，不承诺多适配器均流。详情见[直接24V入口](corner-dc24-input-2026-09-21.md)。

## 板层与发布门槛

现有 PCB 沿用 Top、Inner1～Inner4、Bottom 共 6 铜层。用户指定1.6mm六层板、外层1oz；具体介质、内层铜厚与 USB 90Ω 阻抗表仍需板厂确认；板厂叠层变化需重新算线宽与回流。

保留 C19/C20 RFID 调谐及 R15 终端 DNP 意图，并从最终 BOM 再核对。测试点不采购。剩余器件属性匹配类原理图警告按用户要求暂不修；这不豁免电气、封装、焊接方向、网络和 PCB DRC。

当前尚缺：两板实物批次与最终制造包对应、电气/制造放行、24V 启动浪涌和冷启动、轻满载纹波/动态、触点与 D301 温升及压降、插拔/短路瞬态、不同 Tag/姿态及装配条件下的读卡余量、射频覆盖，以及 Full16 底板首装与承载。16 板识别和真实 ORDER 环已通过，但不等于以上量测或完整实体对局验收。原三模块底板配合已获用户确认，全环机械公差和受力仍待验。PD NVM 固件、镜像与协商需求已取消。9/21 新增供电原理图 181 项引脚断言通过，见[供电复核](power-schematic-audit-2026-09-21.md)；不等于上述实测通过。
每次接口变化同时更新原理图、PCB、板级配置及文档；允许明确记录“原理图已改、PCB 待同步”，禁止把两个阶段写成一个已完成状态。

## 当前棋盘固定底板

当前交付为 [Full16 R1](../../Mechanical/BoardBase/Full16_R1/README.md)：四个相同 L 形主件＋八片连接片，每主件一角三长，组成四角十二长的固定底板。主框 366×366 mm，含外侧连接耳最大 406×406 mm；单主件 171.35×234.35×16.8 mm。中央名义 190×190 mm 开口有内耳局部占用。布局、孔位、网格/3MF 和参考 PCB 干涉检查通过，新增长—长接缝、完整切片打印、全环共面及拼接承载尚待实装。

原[三模块 R2](../../Mechanical/BoardBase/README.md)的 151×151 mm 角落首件已由用户照片及反馈确认配合正常；它是 Full16 延续的基础，不再是最终整盘交付。保持每板两颗对角螺丝、平板厚 3.5 mm、PCB 底面离桌 16 mm、接触环外径 6 / 内径 3.6 mm。用户提供板厚约 1.6 mm、底面突出约 8.1 mm，名义净空 4.4 mm；CAD 层厚合计 1.538351 mm 单独保留。Full16 采用 3.0×10 mm 塑料专用盘头螺钉、候选 Ø2.5 mm 盲孔和 1 mm 垫片，螺钉共 48 颗（PCB 32、连接片 16）；不是 M3 机螺钉配螺母槽。现模型使用主体直边角—长 12 mm、长—长 15 mm，后者仍需一个 L 主件首装确认，不能用螺丝拉扯接头吸收偏差。冻结接口和旧检查报告不回写；旧 14 mm 架高及滑移提案仅供追溯。

## 玩家终端与独立电池底板

本页六层、24V及INA226描述仅适用于棋盘模块。玩家为MD80ET 480×480圆屏，当前独立[电池底板](player-usbc-battery-base-2026-09-27.md)候选为 **PLAYER POWER R1 RC6-TP**：80×80mm/R5双层、76组件（68实装＋8裸测试点）、251焊盘、555线段、84过孔、41网；实装仍为67件SMT＋1件PH2.0插件、标准型SMT。J3.1=GND、J3.2=BAT_PACK（正极），不能沿用RC4相反极性；J2反向焊盘映射与厂家FPC逻辑针号分开。测试点增量及静态检查通过，整板仍未制造放行，见[RC6-TP归档](../../PCB%20Files/PlayerConsolePower/Testpoints-2026-10-15/README.md)。

电池底板MAX17048＋SC18IM704通过UART1、TX43/RX44查询；实现已构建但所有已部署玩家固件均为 `BatteryBoard=none`，这些GPIO不表示玩家使用棋盘RS485。COM7底板据用户报告已修复、带电池，经底板USB烧录普通22ca后屏幕稳定且无明显发热；COM27/28底板也已返修并接电池，普通dfc4等待页获正常反馈，这三台固件不变。COM29同样获用户返修、接电池确认；旧dfc4/16MHz曾有频闪和偏移，改为 `716ff623…`、12MHz正常游戏诊断构建后，用户确认静止等待页正常，频闪与错位消失。动态页面和24FPS/42ms仍待测。

COM29的120秒有界日志已停止，135秒观察结束并释放串口；普通12MHz无诊断日志候选 `3da4c493…` 已构建、未部署。旧板载 AP 的 7 台关联瓶颈已由 USB 热点迁移解决，已有 20 台同时关联/注册证据；用户随后关闭 COM7，Pi 软件重启后按实际开启的 16 格＋3 屏连续观察。不能再以旧 7 台限制作为当前 COM29 部署阻塞，普通候选部署窗口仍由主会话协调；冻结 v4 未改。四屏曾在线及局部目视通过不等于电池板充电、欠压、电压/SOC或温升验收。具体版本和历史失败见[COM29显示记录](../firmware/player-com29-display-progress-2026-10-15.md)，设备与时间见[设备台账](../firmware/current-device-connections.md)。

玩家机械底座当前为 [V2 R3 EAR_REINFORCED](../../Mechanical/PlayerConsoleStandV2/revisions/R3_EAR_REINFORCED/README.md)，针对 R2 左安装耳根部过薄加固；只需替换/重打 02 屏幕支架，01/03/04/05 沿用 R2。PCB 原孔、按钮、USB-C、J2、CW47.5 配合和约 60 mm 排线路径保持；网格、根部截面和参考装配检查已交付，实际新版打印、耳根受力、排线松弛及整机温升仍待验。本次文档更新没有新增 PCB 电路设计，玩家电路仍为 RC6-TP。
