Ha22yX/Gridopoly/Docs/hardware/pcb-variants.md

# 长边模块与角落模块：当前 PCB 设计

> **2026-10-15 当前证据：** 当前长边141件/底面48件、角落152件/底面46件；两板机械/布局源与9/21归档一致，本次已导出Gerber/DRL复核板框、圆弧、Ø3.5非金属化安装孔和孔周支撑区。用户确认自然拼接同面共面；板厚约1.6mm、最大底面突出约8.1mm。来源为[冻结机械接口](../../Mechanical/BoardBase/interfaces/pcb-interface-2026-10-15/mechanical-interface.json)，不能据此认定当前实物批次已与制造文件哈希对应。

> 2026-09-22文档同步：[硬件入口](README.md)汇总直接24V、BOM与接口结论；[开发汇报](development-handoff-2026-09-22.md)区分历史修改、已验证及待验收。原日期的核查数据未在本轮重新测量。

> 2026-09-21 历史变更：用户取消角落 PD→24V，改为 5.5×2.1mm 中心正极的直接24V输入；见[直流入口设计](corner-dc24-input-2026-09-21.md)。角落改为PCB2_5；当日记录原理图与PCB器件/网络已更新，入口布局布线和整盘验收待完成。该日待办不代替本页后续状态。

更新：2026-10-15。本文记录两种棋盘 PCB 的当前身份、接口与机械交接；历史设计、静态复核和实物验收分别记录。

2026-09-27曾补充玩家USB-C电池底板为独立第三种PCB；其当前候选已是[RC6-TP](../../PCB%20Files/PlayerConsolePower/Testpoints-2026-10-15/README.md)，80×80mm双层、76组件（68实装＋8裸测试点）/251焊盘/555线段/84过孔/41网，不能套用棋盘六层/24V/GPIO。棋盘long/corner仍由显式profile指定，不存在自动形状识别引脚。计划16格均已完成V0.34写验；用户现已接入24V，线圈略高于LCD后确认16板均能识别Tag，服务端16个reader也均stable。USB ALFA热点已有16格＋4屏共20台同时关联/注册证据，唯一16节点ORDER环和0～15自动分配、四角0/4/8/12已实证；软件另支持24/32/40环。完整实体游戏、电气量测、36台容量及无家庭网冷上电仍待验，见[USB现场验收](../firmware/usb-ap-deployment-2026-10-15.md)、[RFID装配结果](../firmware/tile-rfid-screen-coupling-2026-10-15.md)及[试玩记录](../firmware/trial16-release-2026-10-15.md)。本次仅更新证据，未新增PCB电路版本。

## 两种板型

| 项目 | 长边模块 | 角落模块 |
| --- | --- | --- |
| 工程树 | 长边模块 / Schematic1 / p1 | 角落模块 / Schematic1_1 / p1 |
| 原理图 UUID | `262b1ccbed23ba63` | `ae9c8047ce85d7f8` |
| PCB | PCB2_1 | PCB2_5 |
| PCB UUID | `7840864f79449b47` | `6f97d7be5a40dd66` |
| 当前组件 / 底面组件 | 141 / 48 | 152 / 46 |
| 外形 | 主体约48×80mm，接口凸出处最大宽约54mm；机械尺寸以最终制造图为准 | 80 × 80 mm，圆角方板 |
| 板间公母接口 | 相对边 | 相邻边；俯视时母座在公针所在边顺时针 90° 的边，例如左公、上母 |
| 本地 24V→5V 保护 | TPS26621 + LMR16030SDDAR | 相同 |
| 外部24V源入口 | 无 | J301 DC圆孔母座 + F301/D301/D302/C301/C302 |
| J1 USB | 本地 5V/调试 | 本地 5V/调试 |
| GPIO11/12 | INA226 | INA226 I²C |
| GPIO13 | 未连接 | 未连接（NC） |

旧名 Board1 对应长边开发沿革，不能再代表唯一 PCB。日期命名的备份不作为当前交付板。
两种棋盘板都不是独立的 480×480 玩家圆形终端；后者仍由 Firmware/PlayerConsole 管理。

## 共同核心与接口

共同核心为 ESP32-S3-WROOM-1-N16R8、J4 2×4 ST7789 接口、HTRC110、10 颗 WS2812B-B-V6、INA226、RS485 和 ORDER。J4 是屏幕 8Pin 母座，与已删除的 PD 编程排针 J101 无关。

2026-09-21 两份原理图导出网表一致采用每侧 **6Pin + 3Pin，共 9 触点**，不是旧版 15 触点磁吸结构：

| 位号 | 器件 | 立创编号 | 网表针序 |
| --- | --- | --- | --- |
| JIN1 | HX PZ2.54-1x6P WZ，弯插公针 | C32713265 | 1/2/3=24V_BUS，4=ORDER_IN，5=BUS_A，6=BUS_B |
| JOUT1 | LAIL-PM2.54-6P-W，弯插母座 | C54973819 | 1/2/3=24V_BUS，4=ORDER_OUT，5=BUS_A，6=BUS_B |
| JIN3 | PZ254R-11-03P，弯插公针 | C492411 | 1/2/3=GND |
| JOUT3 | LAIL-PM2.54-3P-W，弯插母座 | C54973822 | 1/2/3=GND |

数字相同是网表事实，不能代替实物对插验证。必须按实际封装 Pin1、正反面、弯脚方向、中心高度和插入行程核对：电源对电源、地对地、A 对 A、B 对 B、OUT 对 IN。禁止照旧文档把 JOUT1.3 当 ORDER。
每侧仅有 3 个正极及 3 个地触点；不得再按 6 个并联触点计算载流能力，也不得把额定单触点电流简单相加当长期能力。

## 已完成的角落 PCB 工作

以下是 USB PD 电源原理图扩展前的 PCB 记录，不代表后来的全部供电电路已经布线。

- `92291a2`：147 个独立焊盘转换为原生过孔，保留位置、网络、钻孔、铜径、阻焊等；原生板级过孔从 56 变为 203，独立焊盘剩余 0。元件封装内焊盘保持不变。
- `49ae287`：优化 C53 输入旁路与 C56 自举电容位置、局部电源回路及部分冗余走线；补充地过孔，重建 5 个铺铜。
- 将穿过 ESP32 天线下方的多层信号线绕开，建立约 18×6 mm 禁布区。受固定 J4 与接口限制，未满足完整 15 mm 周边净空，射频性能仍需实测。
- 保持 80×80 板框、J4、10 颗 LED、板间连接器和安装孔位置。用户取消 LED 整体重排后，最终没有把它写成已完成的 LED 重定位。
- 当时原生严格 DRC 错误列表为空；独立铜重叠和小于 4mil 间距检查为 0。独立 DSN 检查不包含铺铜，不能作为后来新增电源电路的验收。

记录：[过孔核对](../../PCB%20Files/CornerModule/pad-to-via-verification.json)、[布局布线核对](../../PCB%20Files/CornerModule/layout-routing-verification.json)、[当时 PCB 导出](../../PCB%20Files/CornerModule/PCB2_2.epcb)。

## PCB 实施状态与旧候选沿革

历史角落 PCB2_2 曾完成218器件的重排/布线候选，固定17器件保持原位。随后用户取消PD，该候选不再是当前制造版本。9/21直流改版记录为PCB2_5共152器件、入口关联重复已修复，而布局布线与制造放行当时仍列待办；见[该阶段候选记录](corner-pcb-layout-candidate-2026-09-21.md)。旧218器件候选的独立检查包含原生地铜连通证据，但原生DRC返回错误；这些历史结果不能替代当前152器件直流版的验收。

10/15已只读冻结当前两板源、封装、焊盘及Gerber，确认相关机械/布局图元与9/21归档一致；没有在该机械任务中重新布线或进行整板电气放行。现有16块实板已完成USB分批写验，后续24V接入、线圈抬高后的读卡及真实ORDER闭环已有运行证据；不能继续把历史待办写成当前板未布线，也不能用这些结果代替纹波、压降、温升、保护及完整实体游戏验收。两种板本地电源区的9/21统计均为原有17件＋新增8件，共25件，不是新增25件。

## 当前机械底板与孔位

以器件面顶视、最大板框左上角为原点、X向右/Y向下：长边四孔为(7.191,4.191)、(46.815,4.191)、(46.815,75.83885)、(7.191,75.83885)，优先右上＋左下锁紧；角落四孔为(4,4)、(76,4)、(76,76)、(4,76)，优先左上＋右下锁紧。两板圆角R4，孔均NPTH名义Ø3.5mm。Ø6/内孔Ø3.6绝缘接触环通过实际制造层及底面器件外廓加0.5mm余量的检查，不能任意扩大。

当前整盘交付为[Full16 R1](../../Mechanical/BoardBase/Full16_R1/README.md)，四个相同L主件＋八片连接片，每主件一角三长。主框366×366mm，含耳最大406×406mm，单主件171.35×234.35×16.8mm；名义190mm方形中央开口局部被内耳占用。模型保持16mm板底高度、3.5mm平板、Ø6/Ø3.6接触环及每板两颗对角螺丝；底面突出约8.1mm对应名义4.4mm净空。使用3.0×10mm塑料专用盘头螺钉、候选Ø2.5mm盲孔与1mm垫片；不是M3机螺钉。

原[三模块R2](../../Mechanical/BoardBase/README.md)151×151mm首件已由用户照片及反馈确认配合正常，Full16延续其孔位和角—长关系；该反馈不覆盖新增长—长15mm主体直边间距、全环公差和拼接承载。Full16布局/网格/3MF/参考装配检查通过，仍须先打印一个L验证四板自然落柱，再做整盘切片打印与试装。冻结接口的原始g=9mm推算及14mm架高、滑移/R1螺母槽记录保留，不当作现行装配说明。

玩家底座是独立的[V2 R3安装耳加固版](../../Mechanical/PlayerConsoleStandV2/revisions/R3_EAR_REINFORCED/README.md)：只替换02屏幕支架，其余四种零件沿用R2，PCB固定接口和约60mm排线路径不变；新版打印、耳根承载及完整实物试装待验。此机械更新不改变RC6-TP电路或制造放行状态。

## 证据优先级

| 范围 | 现有导出与记录（是否已提交须另查Git） |
| --- | --- |
| 当前机械接口与实际制造层 | [10/15冻结接口](../../Mechanical/BoardBase/interfaces/pcb-interface-2026-10-15/README.md)，原始14mm/可调建议已由R2基线及当前[Full16 R1](../../Mechanical/BoardBase/Full16_R1/README.md)覆盖；冻结文件保持原样 |
| 最新角落同步修复 | [SyncRepair](../../PCB%20Files/CornerModule/DC24-2026-09-21/SyncRepair/README.md)，优先于父目录初版快照 |
| 两板供电核查网表 | [DesignAudit](../../PCB%20Files/DesignAudit-2026-09-21/)及[供电核查](power-schematic-audit-2026-09-21.md)，角落152件、长边141件 |
| 当前计算边界 | [供电核查](power-schematic-audit-2026-09-21.md)；PowerIntegrity中PD环路及R120计算仅为历史 |
| 器件采购 | [BOM复核](bom-review-2026-09-21.md)及最终同版导出；旧PD的C128/R120不再采购 |
| 编辑中的完整工程 | PCB Files/Gridopoly.eprj2；本地未提交变化须另核对，不能认为与上述导出自动相同 |

PD24 → Hotplug → PowerIntegrity → PDProgramming 是角落电源记录的先后顺序；旧文件保留用于追溯，不能相互覆盖。最新 DC24 记录取代角落 PDProgramming；长边仍参考 PowerIntegrity。下单前必须生成同一工程快照的原理图、PCB、BOM、坐标和 Gerber。
