Ha22yX/Gridopoly/Docs/hardware/player-usbc-battery-base-2026-09-27.md

# 玩家圆屏 USB-C 电池底板

更新：2026-10-15。底板独立于长边/角落棋盘模块，不接24V总线；屏幕内已有ESP32-S3，通过10Pin软排线连接本板。当前数字候选、旧打样批次与已返修实物必须分开判断。

## 当前实物与普通固件

| 最后设备记录 | 普通固件 | 底板／电池与已获反馈 | 尚未确认 |
| --- | --- | --- | --- |
| COM7 | `22ca08e6…` | 用户报告已自行返修、已接电池；经底板USB四段写验及启动联网通过；屏幕稳定、无明显发热 | 定量电流/温升、充放电、欠压保护及UART遥测 |
| COM27、COM28 | `dfc4b7e5…` | 两块底板已返修且接电池；升级后用户确认两台等待新游戏页正常 | 其他页面、精确输入及电池全项验收 |
| COM29 | 12MHz正常游戏诊断构建 `716ff623…` | 用户确认已返修、接着电池；静止等待页画面正常、频闪与错位消失 | 动态页面、24FPS/42ms及电气/遥测仍待验 |

COM29的120秒有界日志已停止，135秒观察结束并释放串口。普通12MHz无诊断日志候选 `3da4c493…` 已构建、未部署；此前7台关联造成的刷写暂缓属于历史排查：USB热点部署后已有16格＋4屏共20台同时关联/注册证据，该容量阻塞已解除；普通12MHz候选仍未部署，需另行安排，不能把网络恢复当作已经升级。见[USB热点部署](../firmware/usb-ap-deployment-2026-10-15.md)。COM7/27/28固件和冻结v4不变；旧dfc4/16MHz在COM29的失败与12MHz后目视通过分别见[显示记录](../firmware/player-com29-display-progress-2026-10-15.md)。

全部已部署固件保持 **`BatteryBoard=none`**，表示电池遥测关闭，不表示实物没有电池。09:39:03.375 UTC服务器曾有四台online/eligible；之后USB热点22:07:58及22:18:49 UTC快照又证实16格＋4屏同时接入。COM7随后由用户关机，Pi软件重启后的持续验证按实际开启的16格＋指定3屏完成，不能记作第四屏故障。上述均为带时间证据，不是实时在线保证。历史“所有实物未返修、断开USB”的要求不再套用于已明确返修的COM7/27/28/29，也不能因此推定其他旧板已修好。USB烧录与联网通过、用户无明显发热/显示正常反馈，不代替充电、放电、温升、保护或UART测量。来源：[设备台账](../firmware/current-device-connections.md)、[16格试玩记录](../firmware/trial16-release-2026-10-15.md)。

后续启用电池遥测应从当前源码单独生成候选；9月旧`b40e1701…`不含本轮输入修复，不作为本轮最终升级。启用版会初始化SC18IM704、写MAX17048 MODE=0并按需清CONFIG.SLEEP，不改变BQ24074的硬件充电/输入限流接线。实际返修细节及实板与RC6-TP归档的对应关系仍待核对。本次文档整合未操作EDA或串口。

## 当前数字候选与历史故障包

**PLAYER POWER R1 RC6-TP**包含8个单排通孔测试点：间距8mm、孔1.0mm/铜盘2.2mm，顶底丝印仅网络名；76组件（68实装＋8裸测试点）、251焊盘、555线段、84过孔、41网。原68件、82旧过孔、原走线物理路径及板框/安装孔保持；新增15段0.30mm测试支路及USB_VBUS支路2个过孔，部分原线仅分割。完整PCB DRC 0，原理图43条既有警告无新增；实际铜层连通及8点钻孔/铜/阻焊/钢网/丝印检查通过。**静态检查通过范围和投产HOLD继续保留，不把数字候选变更当作旧实物返修。**

| 文件／阶段 | SHA256与证据边界 |
| --- | --- |
| [当前RC6-TP Gerber](../../PCB%20Files/PlayerConsolePower/Testpoints-2026-10-15/README.md) | `bff4f65a4de8f07b44090f04ccfda05d3c57241564201dea600e5bc1f85e09d3`；测试点增量与静态制造层检查 |
| [10月14日全面审查基线](../../PCB%20Files/PlayerConsolePower/ProductionReadiness-2026-10-14/README.md) | `ff1d6610f86817b8abf856b8e372c66f574020b3824ed76b2c69375bd793d031`；68件/243脚/41网，J3孔0.9mm，原43条警告已分类并核对30料号，未清除 |
| [旧打样故障ZIP](../../PCB%20Files/PlayerConsolePower/OrderPackageAudit-2026-10-14/README.md) | `2344f34c45307a879c9a3274bddd53681152dcf42d9fb47637cb690d554405b6`；`Gridopoly_PCB1_20260927_204456.zip`，不可重新用于投产 |

**10/14历史故障结论：**旧打样包在J3.2/BAT+顶层保留三条0.254mm地铜桥，BAT_PACK与GND实际相连；它早于9/27 20:57:30修复后的RC5。该错误足以解释用户当时报告所有板BAT约0.2Ω，且不与SYS_RAW约18.92kΩ、5V_SCREEN几MΩ矛盾。当时尚未返修，因此原报告要求断开电池/USB/屏幕；该时点记录保持冻结，后续具体实物状态以上表为准。当前工程DRC0不能为这份错误旧包放行。

10/5历史检查时用户已下单、尚未收到；当时现场68件/243脚、536线段/82过孔、41网检查通过，不能替代后来实际订单包核查。该轮新增BQ24074上限4.23V与EEMB公开电芯4.22V上限的容差缺口，至今仍需成品包规格及终止电压验证。来源：[10月5日复核](../../PCB%20Files/PlayerConsolePower/ProductionAudit-2026-10-05/README.md)、[到货验证计划](../../PCB%20Files/PlayerConsolePower/ProductionAudit-2026-10-05/arrival-tests.md)。

历史沿革：[RC5制造归档](../../PCB%20Files/PlayerConsolePower/Layout-2026-09-27-RC5/README.md)、[RC5投产复核](../../PCB%20Files/PlayerConsolePower/Layout-2026-09-27-RC5/production-review.md)、[制造说明](../../PCB%20Files/PlayerConsolePower/Layout-2026-09-27-RC5/manufacturing-notes.md)、[原理图连接约束](../../PCB%20Files/PlayerConsolePower/DesignDraft-2026-09-27/design-contract.json)、[连接核对](../../PCB%20Files/PlayerConsolePower/DesignDraft-2026-09-27/connectivity-audit.json)。RC1～RC5冻结文件保留追溯，不拼用旧线宽、计数或J3极性。

9/27[原理图审查](../../PCB%20Files/PlayerConsolePower/DesignDraft-2026-09-27/schematic-comprehensive-review.md)曾修正SW1/SW2内部常通组：1/2接控制、3/4接地，并同步PCB。旧79项检查未覆盖此机械短接，修复后81项静态检查通过；位号已统一SW1/SW2，POWER/RST功能丝印及按键位置保留。此历史检查不等于整板实物验收。

## 1. 用户已确定的要求

| 项目 | 要求 |
| --- | --- |
| 位置/形状 | 独立底座内；以用户最新分配的80×80 mm、R5板框为准，替代早期40–50 mm设想 |
| USB | 一只 USB-C 母座，下边居中、开口朝外；充电、上传、调试共用 |
| 屏幕连接 | 屏幕自带软排线插入本板连接器 |
| 电池安装 | 不安装在 PCB 上；外置电池以正、负两根线连接本板 |
| 手动关机 | 板上增加电源开关，切断屏幕供电，仍可充电 |
| 自动关机 | 低电压时由硬件关闭屏幕；禁止只靠软件或等待电池保护板跳闸 |
| 电压/电量/充电状态 | MAX17048＋SC18IM704，通过原排线 RX/TX 主动查询；底板无单独固件 |
| 充电温度探头 | 用户明确取消；TS 采用固定 10kΩ，不检测电芯温度 |
| 当前所购电池 | EEMB LP103454，商品图标称3.7V、2000mAh、7.4Wh，Amazon B08HQWXQ6Y；实际外形尺寸、允许电流及插头极性仍需按到货规格/实物核验 |
| 早期电池候选（历史） | 淘宝103450、3.7V、2000mAh，商家曾标52×34×10mm；这些尺寸不能套用到当前EEMB LP103454 |
| 首批数量 | 5–10 块，优先选择贴装库存充足的常用器件 |

电池尺寸不限制本板长宽，电池腔和导线空间由底座另行容纳。本板没有电池托架。当前为两层铜、标称1.6 mm、1 oz，全部器件顶面；四孔、USB-C、J2和两按键沿用用户指定位置。旧棋盘板的六层叠层不沿用。

当前安装结构见[玩家底座V2 R3](../../Mechanical/PlayerConsoleStandV2/revisions/R3_EAR_REINFORCED/README.md)：只替换02屏幕支架，其余01/03/04/05沿用R2，PCB四孔、USB-C、J2和按钮位置不变。R3数字加固不代表新件已打印或完成排线/电池实装。

## 2. 厂家资料核对

当前项目玩家屏型号为 `UEDX48480021-MD80ET`（触摸版）。依据厂家 V1.1 规格书第 6、8、9 页：外部接口 10Pin/0.5mm；输入范围 4.0–5.5V，典型 5V；最大背光条件下典型工作电流 320mA，关闭背光典型 100mA，建议电源 5V/1A。这些是厂家典型数据，不是本项目峰值实测。[厂家规格书](https://github.com/VIEWESMART/UEDX48480021-MD80ESP32-2.1inch-Touch-Knob-Display/blob/830a74e6354aa482d382401bdb222a5efe82c917/information/UEDX48480021-MD80ET%20V1.1%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)

因此单节 3.7V 锂电池不能直接接屏幕 VCC；放电后电压会低于模块工作范围，需要稳定的 5V 输出。USB 使用屏幕 ESP32-S3 的原生 USB（GPIO19 D−、GPIO20 D+），无需新增 USB-UART 芯片。[Espressif 原生 USB 文档](https://docs.espressif.com/projects/esp-idf/en/stable/esp32s3/api-guides/usb-serial-jtag-console.html)

### 外部软排线逻辑接口

| 厂家外部接口序号 | 信号 | 本板预期连接 |
| --- | --- | --- |
| 1 | VCC | `5V_SCREEN`，受开关与欠压控制 |
| 2 | ADC（资料存在 GPIO3/GPIO4 差异） | 首版明确 NC，不连接电池 |
| 3 | GND | 本板地 |
| 4 | NC | 不连接 |
| 5 | NC | 不连接 |
| 6 | RX | `SCREEN_RX` ← SC18IM704 TX（U9.11） |
| 7 | TX | `SCREEN_TX` → SC18IM704 RX（U9.10） |
| 8 | RST | 复位按键对地，不接 5V 上拉 |
| 9 | D+ | USB 数据通道 D+ |
| 10 | D− | USB 数据通道 D− |

**这是屏幕外部接口的逻辑序号；底板J2焊盘号按用户要求反向对应，见下表。** 厂家 V1.0 内部原理图 J1/J2 与外部接口表的连接器编号/针数不一致；不能照抄其中任一连接器编号。[厂家原理图](https://github.com/VIEWESMART/UEDX48480021-MD80ESP32-2.1inch-Touch-Knob-Display/blob/830a74e6354aa482d382401bdb222a5efe82c917/Schematic/UEDX48480021-MD80ET-V1.0%20SC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)

用户已确认实物排线为 10 针、0.5 mm，并确认以下观察方向：**金属触点面朝向观察者，排线从下向上，左起第 1 根是 5V、第 3 根是 GND**。此视角下左至右为 `1:5V / 2:ADC / 3:GND / 4:NC / 5:NC / 6:RX / 7:TX / 8:RST / 9:D+ / 10:D−`。翻到背面后左右会相反；该观察方向不直接等于任意母座的 PCB 焊盘编号。

J2 使用 C2856798（FPC-05F-10PH20）候选母座，**已加入 BOM 和 PCB**，机械匹配仍待验证。候选为下接点，厂家图纸规定适配尾端厚度 0.30±0.03 mm；图纸标出的 Circuit 1 仍需与封装和实际装入姿态逐项对应。[候选母座厂家图纸](https://atta.szlcsc.com/upload/public/pdf/source/20210922/C2856798_585375641076BAD9204C7157365D9EB8.pdf)

屏幕机械图 FPC VIEW 中的 **0.35 mm 是金手指宽度，不是尾端总厚度**，不可用它判断母座厚度兼容性。尾端含补强片的厚度、插入深度、触点载流和端到端通断仍待确认。5V/1A 电源能力不等于排线或母座已允许长期通过 1A；不能只凭针数、间距和左右顺序就冻结封装。

经销商网页及用户最新接口截图把 ADC 标为 GPIO3，厂家触摸版规格书及原理图标为 GPIO4；厂家触摸版的 GPIO3 已用于 LCD VSYNC。**首版将外部第 2 脚保留不接**，电池电压与 SOC 改由 MAX17048 经 UART 桥接查询；不能因为接口序号相同就认定内部 GPIO 相同。[经销商页面](https://spotpear.cn/wiki/ESP32-S3-2.1-inch-Round-Rotary-LCD-Screen-Knob-Display.html)

2026-09-27 按用户最新要求，J2候选母座已加入BOM并实际导入PCB；1–10焊盘网络整组反转，11/12固定焊脚仍接GND。下面的“屏幕逻辑针号”仍按厂家外部接口表，不能与底板J2焊盘号混用。

| 底板J2焊盘 | 网络 | 屏幕逻辑针号 |
| --- | --- | --- |
| 1 | SCREEN_DM | 10 |
| 2 | SCREEN_DP | 9 |
| 3 | SCREEN_RST | 8 |
| 4 | SCREEN_TX | 7 |
| 5 | SCREEN_RX | 6 |
| 6 | NC | 5 |
| 7 | NC | 4 |
| 8 | GND | 3 |
| 9 | NC，ADC不使用 | 2 |
| 10 | 5V_SCREEN | 1 |
| 11、12 | GND，固定焊脚 | 不属于10根信号线 |

反转通过重建J2短线/网络端口及NC标记实现，不改符号和封装的原始焊盘编号。网表与PCB焊盘已逐脚一致；排线尾端厚度、母座接触面和插入后的实物通断仍待核实。

## 3. 电路架构

```text
USB-C VBUS → 输入保护/输入限流 → 带电源路径的充电管理 → SYS_RAW
                                      ↕ BAT             │
                              B+ / B− 两线电池           ├→ 5V升压 → 5V_SCREEN → 排线VCC
                                                        │       ↑ EN
                                                        └→ 欠压检测 → 开关锁存控制
USB-C D+/D− → 低电容ESD → USB数据开关 → 排线D+/D−
USB-C CC1/CC2 → Type-C电流能力识别 → 充电管理输入限流选择
排线 RX/TX ↔ SC18IM704 ↔ I²C ↔ MAX17048（BAT_PACK 常供电）
                   ↑ GPIO0/1
             BQ24074 CHG/PGOOD
5V_SCREEN → 现有 U8 3.3V → USB数据开关＋SC18IM704
```

`5V_SCREEN` 不连接 USB VBUS。USB 供电与电池供电由电源路径管理，防止电池经升压输出向电脑供电。充电管理位于屏幕开关之前，因此关闭屏幕后仍可充电。

### 当前原理图选型（尚未制造放行）

| 功能 | 候选 | 选择依据 / 未冻结项 |
| --- | --- | --- |
| 单节充电及电源路径 | BQ24074 | 可独立管理系统负载和充电；500mA 充电为目标，实际受 USB 能力、温升及电池限制 |
| 5V 升压 | TPS61023 | 支持关闭时输出隔离；按 5V/1A 电源能力评估，电感、电容、温升及排线载流尚待核算 |
| 按键开关锁存 | MAX16054AZT+T | 按一次开、再按一次关；CLEAR 强制关机，解除 CLEAR 后仍需重新按键 |
| 欠压检测 | TPS3808G01DBVR + 输出反相 | 可调阈值，目标 SYS_RAW 下降约 3.3V 关断；替代库存偏低的 TPS3840 候选。回升后延时解除强制关闭，仍需按键开机 |
| USB-C 电流识别 | TUSB320LAI，UFP/GPIO 模式 | 根据来源声明的电流能力限流；不要求 PD 协商 |
| USB 数据隔离 | TS3USB221A | 无 USB VBUS 或屏幕关闭时断开数据线；需配局部 3.3V 供电、控制及 ESD |
| 电量计 | MAX17048G+T10，U10 | 单节电池电压与 SOC；BAT_PACK 常供电，100nF 去耦，不承担过放切断 |
| 串口桥接 | SC18IM704PWJ，U9 | 排线 RX/TX 转 I²C；GPIO0/1 读 CHG/PGOOD；复用 U8，不需要底板程序或外部晶振 |
| 机械接口 | USB-C、10Pin FPC 母座、J3 PH2.0-2P电池插座、电源/复位按键 | USB-C 候选 TYPE-C-31-M-12 已查库存；FPC 尾端厚度、封装方向和接点载流仍待确定 |

充电芯片的系统优先分配与反向阻断能力参见 [BQ24074 数据手册](https://www.ti.com/lit/ds/symlink/bq24074.pdf)。升压器开关电流规格不能当成 5V 输出电流，外围器件和关闭泄漏须按 [TPS61023 数据手册](https://www.ti.com/lit/ds/symlink/tps61023.pdf)复核。

### 欠压与开关的具体控制关系

TPS3808G01 的低有效开漏 RESET 经上拉和反相后接 MAX16054 的高有效 `CLEAR`；按键接 `IN` 与 GND；`OUT` 控制升压 `EN`。两个控制芯片由开关前的 `SYS_RAW` 供电。升压 EN 设默认下拉，防止控制电源上升/下降过程误启动。不能将低有效 RESET 直接接 CLEAR，否则控制极性相反。

欠压发生时 CLEAR 清除开机锁存；电压回升只是解除关机强制条件，不重新置位锁存。恢复充电后，用户按键开机。插入 USB 默认仅进入可充电状态，不自动点亮已经关闭的屏幕。USB 供电充足时，低电量电池可以继续充电，屏幕可由外部电源支撑。[MAX16054 数据手册](https://www.analog.com/media/en/technical-documentation/data-sheets/MAX16054.pdf)

阈值采用上臂 715kΩ、下臂 100kΩ，`0.405×(1+715/100)=3.30075V`；当前C5=10nF、R6=100k分别实现滤波与典型300ms恢复延时；按参考±2%、电阻各±1%和SENSE漏电估算，下降阈值约3.16–3.44V。该候选不再声称具有旧草案的独立 3.5V 恢复阈值。监测点为 SYS_RAW，电池端还包含电源路径与导线压降；不能写成精确电量百分比。最终需验证电阻/检测器公差、抗扰、上电复位和保持按键时的清零优先级。[TPS3808 数据手册](https://www.ti.com/lit/ds/symlink/tps3808.pdf)

2026-10-14补充：欠压关屏没有断开全部电池耗电，必须使用具有独立过充/过放/过流保护的1S电池包。300ms是恢复延时，不是欠压触发需持续300ms。TPS61023按PWM典型反馈595mV及732k/100k计算约4.95V；C8/C9两颗10µF仍在，5V下典型有效总容量约11µF。详细公差与厂家曲线见本页顶部的10月14日全面审查基线。

## 4. 使用状态约定

| 状态 | 屏幕 | 电池/USB 行为 |
| --- | --- | --- |
| 仅电池、按键开机、电量正常 | 电池经升压供电 | USB 数据通道断开 |
| 再按一次关机 | 硬件关闭 5V_SCREEN | 无 USB 时只保留低功耗管理电路 |
| 插 USB、屏幕保持关闭 | 关闭 | 给电池充电；不会枚举或上传屏幕程序 |
| 插 USB、按键开机 | 外部电源优先，必要时电池补充 | 有数据能力的线缆及主机可上传、串口日志和调试 |
| 运行中欠压 | 硬件关断并锁存 | 电压反弹不会自动重启 |
| 欠压后接充电器 | 默认保持关闭 | 先恢复供电/充电条件，再按键启动 |
| 无电池、USB来源经CC宣告至少1.5A | 按POWER后具备启动供电条件，仍需实测 | 上传还须主机及数据线；默认电流或A-to-C不保证，见第5节 |
| USB 来源能力不足 | 降低充电电流；可由电池补足负载 | 不保证一边运行一边净充电；电池耗尽时仍会关机 |

硬件自动关机表示停止屏幕供电，不等于固件已经实现保存进度/关机动画。欠压保护不依赖玩家固件或游戏网络在线。

## 5. USB 输入电流与上传边界

当前电路使用TUSB320LAI识别CC电流能力，不因USB-C外形而固定从所有电脑端口索取1A；有源CC控制器已提供Rd，不再并联一组5.1kΩ。[TUSB320LAI 数据手册](https://www.ti.com/lit/ds/symlink/tusb320lai.pdf)

**RC6-TP实际接线为BQ24074 EN1固定接低，EN2由CC高电流许可信号控制。** 未获得许可时EN1=0、EN2=0，输入限流为100mA；CC宣告1.5A或3A时EN2变高，进入R2=1.8kΩ设定的ILIM档，典型约894mA（约0.9A），不是1.5A/3A直通。Q2为PNP MMBT3906，使CC电源未建立或输出高阻时默认不给高电流许可。TUSB320 VBUS检测支路为三颗300kΩ串联的900kΩ（1%时891–909kΩ）；887kΩ缺料是当时选型沿革，不是本次库存查询。[BQ24074输入模式](https://www.ti.com/lit/ds/symlink/bq24074.pdf)

**无电池时，电脑C-to-C有条件可用，尚未实测验收。** 需要电脑端口确实宣告至少1.5A、线缆支持USB数据，并按POWER打开屏幕；还要验证实际启动浪涌、持续负载、线损与转换损耗。仅能充电的线/端口即使供电足够，也不能上传或调试。普通默认电流或A-to-C在本板仍落入100mA档，5V输入功率约0.5W；厂家屏幕最大背光典型320mA@5V约1.6W，尚不含底板损耗，不能保证启动和稳定运行。屏幕320mA是典型值，不是峰值保证。

无电池不会被独立的电池存在检测禁止开机：U1的OUT建立`SYS_RAW`，再供U2升压与U3/U4开关、欠压控制；U4检测`SYS_RAW`而不是`BAT_PACK`。按POWER后若输入不足使系统电压跌落，欠压链会清除开机锁存，需要电源恢复后重新按键。U7数据开关由屏幕侧电源供电，关机或欠压锁关也会断开USB通讯，不能把这种掉线直接归因于USB线或软件。此结论由RC6-TP归档原理图/PCB网表复核，未进行新的实物测量。

**传统电脑口的500mA路径不能只靠屏幕固件枚举解除：**当前EN1硬连低电平，软件不能把它改为500mA选择状态。若以后要支持该模式，需要硬件控制路径修改，并配套枚举、描述符、暂停及实际电源预算验证；当前不承诺任意电脑无电池运行、运行时净充电或完整USB电源合规。

USB上传/调试和屏幕侧UART桥接本身不要求安装电池，前提是相关电源已稳定建立；SC18IM704由屏幕侧3.3V供电。但MAX17048由BAT_PACK供电，无电池时其电压/SOC不能作为有效电池状态，查询可能失败或返回无意义数据。现有普通固件仍为`BatteryBoard=none`，没有无电池遥测实测结论。

原生 USB 上传复用现有 HWCDC/USB Serial-JTAG。屏幕关闭时不能上传，需要先开机。应用程序禁用 USB 等异常情况下，需验证按住屏幕旋钮（GPIO0）并按本板复位进入 ROM 下载的恢复流程；不能保证所有损坏固件都能自动进入下载模式。

USB数据开关的局部3.3V由5V_SCREEN产生；无VBUS时OE保持关闭，屏幕掉电时依靠开关断电隔离。仍需实测电源未建立时控制脚与数据脚的漏电，避免USB数据经保护结构给关机屏幕回灌。[TS3USB221A 数据手册](https://www.ti.com/lit/ds/symlink/ts3usb221a.pdf)

## 6. 电池、功耗与充电

选用普通 **1S、标称 3.7V、充满 4.2V** 的受保护锂电池。用户候选 2000mAh 尚需确认实际容量、保护板、最大充电电流、连续/峰值放电电流和温度范围；“耐高温80℃”不等于允许80℃充电，“输入4.2–5.0V”也不是可直接给电芯施加5V的依据。

建议核实电池可持续输出至少 2A，并留启动峰值余量。该值来自设计储备：5W 输出、3.3V 输入、85% 假设效率时约需 1.78A，实际以器件、排线和实测负载为准。J3改为PH2.0-2P直插座C131337，1脚GND/BAT−、2脚BAT_PACK/BAT+；电池端配PHR-2兼容插头，保留线材应力释放。连接器有方向性不等于反接保护，必须核对电池插头针序。

在 3.7V×2Ah=7.4Wh、屏幕 5V×0.32A=1.6W、转换效率假设85–90%下，理想估算约3.9–4.2小时。考虑提前欠压关机、电池容量误差、Wi-Fi与亮度变化，前述“约3–4小时”仅是选型估计，不是续航验收结果。

充电目标约500mA，R1=1.78kΩ（2000mAh 的约0.25C），最终上限不得超过电池数据手册。TMR 接 R20=68kΩ，快速充电安全定时约9小时典型；不是承诺9小时充满，低输入能力、热调节和系统分流均会影响充电。线性充电器需检查低电池电压、运行负载与封闭底座内的发热；不得以芯片热调节功能替代热设计。

2026-10-05补充：EEMB官网LP103454电芯手册写充电限制电压4.200±0.020V；BQ24074保证范围为4.16–4.23V，尚未证明全公差匹配。需要确认用户购买的成品包规范并核验终止电压；保护板不是正常充电稳压器，R1也不能调整终止电压。这个问题及已下单板的处理边界见[新复核](../../PCB%20Files/PlayerConsolePower/ProductionAudit-2026-10-05/README.md)。

用户明确不安装温度探头，已删除 J4，改为 R21=10kΩ 将 BQ24074 TS 接地，这是芯片规定的不使用 TS 监测时的接法。电池仍只有 B+/B− 两根线，不会因缺少外接探头而禁止充电。**本板没有电芯温度检测；芯片自身热调节不等同于电池温度保护。** 充电仍须符合所选电池的电流和环境温度范围。[BQ24074 TS 接法，10.2.2.3](https://www.ti.com/lit/ds/symlink/bq24074.pdf)

欠压关机后仍有微小静态电流，不能保证长期搁置绝不继续放电；电池包本身仍需要过充、过放、过流/短路保护。

## 7. 当前80×80 mm布局与布线

用户固定的下边中心为USB-C、左边为J2、右边为POWER/RST。USB与ESD沿左下区域连接J2；充电/升压位于右下，MAX17048在其上方；桥接和屏幕局部稳压靠近J2；欠压与锁存在POWER附近。当前RC6-TP保持原68个实装封装的位置、原82个过孔、全部原走线物理路径、板框/四孔、J1/J2和两个按钮位置。J3仍在上方(40,5) mm，PCB顶视图左负右正，孔距2.0mm；沿用10月14日快照的0.9mm孔径，旧RC5归档的0.8mm不能代替当前版。

当前为76组件（68实装＋8裸测试点）、251焊盘、555线段、84过孔、41网。测试支路新增15段0.30mm走线及USB_VBUS支路2个过孔，部分原线段仅分割、物理路径保留。最终完整PCB DRC为0；独立制造铜层检查无短路、断路、NC误接或缺铜，8个测试点的钻孔、铜环、阻焊、钢网和双面丝印检查通过。此结论限定本轮测试点增量；此前充电、FPC、USB、温升及实板验收的HOLD继续保留。[RC6-TP归档](../../PCB%20Files/PlayerConsolePower/Testpoints-2026-10-15/README.md)。

### RC6-TP 单排测试点

8个镀铜通孔均在本轮归档板内坐标Y=22.5mm，左至右间距8mm；孔径1.0mm、铜盘直径2.2mm。下表TP编号仅为设计内部位号，板上双面丝印只印对应网络名；测试点为裸焊盘，不新增贴装元件。测试支路供测量使用，不作为外部负载供电接口。

| 从左至右 | 内部位号 | 网络 / 双面丝印 | X（mm） | Y（mm） | 测量用途 |
| --- | --- | --- | ---: | ---: | --- |
| 1 | TP7 | GND | 8 | 22.5 | 地参考 |
| 2 | TP3 | 5V_SCREEN | 16 | 22.5 | 屏幕5V输出 |
| 3 | TP4 | SCREEN_IO3V3 | 24 | 22.5 | 屏幕侧逻辑3.3V |
| 4 | TP8 | GND | 32 | 22.5 | 地参考 |
| 5 | TP5 | USB_VBUS | 40 | 22.5 | USB输入电压 |
| 6 | TP2 | SYS_RAW | 48 | 22.5 | 充电电源路径输出 / 升压输入 |
| 7 | TP1 | BAT_PACK | 56 | 22.5 | 电池端电压 |
| 8 | TP6 | POWER_EN | 64 | 22.5 | 开关锁存 / 升压使能信号 |

当前部分USB主机侧和5V主线已改为0.6mm，RC2的1.15mm/0.20mm说明不再覆盖这些走线。USB仍有局部不成对、D−换层和参考地中断，未验证90Ω或完整USB性能；上方具体设备的写验成功只覆盖对应连接与操作窗口。早期RC3按标称铜厚/孔铜估算，5V→J2在500mA时铜路径压降约29mV，J3→U1在1A时约69mV；RC5的J3末端已改接，该数值保留为历史参考，不是本版实测，也不含线材、连接器、地回流和芯片损耗。U1有四个EP散热孔，仍需首板热与负载测试。

J2 C2856798供应商标称500mA/触点、下接点、尾端0.30±0.03mm。屏幕320mA是典型值，不能代替最大电流；目前没有证据将该接口当成1A接口。实物厚度、针序/接触匹配和实际峰值负载必须核实。当前原理图仍为43条原警告、无新增；两条同名重复网络及器件属性差异已分类，30料号身份已核对，原生警告未清除。电池参数及制造/实测仍待闭合；完整电路审查见[10月14日基线](../../PCB%20Files/PlayerConsolePower/ProductionReadiness-2026-10-14/README.md)，本次测试点验证见[RC6-TP归档](../../PCB%20Files/PlayerConsolePower/Testpoints-2026-10-15/README.md)。

2026-09-27用户确认采用**标准型SMT**，接受当时订单页面比经济型多约2天的预计交期（实际以订单为准）。U5=TUSB320LAIRWBR/C132554在当时匹配页面不支持经济型，现保留器件及电路；本次未重新查询贴装类别或交期。标准型选择不代表原理图告警、排线/电池或首板验收已闭合；RC2冻结文件保持。10/14查明旧打样J3.2地铜短路时实物尚未返修，后续返修状态按页首各板分别记录。[器件页面](https://jlcpcb.com/partdetail/TexasInstruments-TUSB320LAIRWBR/C132554)

## 8. 固件后续与验收

PCB文档整合未操作串口；四屏普通固件的实际部署见页首，电池遥测均未启用。已完成UART电量/充电状态查询的原理图接线，另有[固件接口约定](player-battery-telemetry-interface-2026-09-27.md)。底板没有可编程主控，屏幕固件负责9600/8N1查询、解析及显示；厂家触摸版资料已交叉对应TX43/RX44，见[GPIO原图证据](player-screen-uart-gpio-evidence-2026-09-27.md)。源码和主机回归已接入，构建结果见[固件接入记录](../firmware/player-battery-telemetry-progress-2026-09-27.md)；实物复用与首板UART通信仍须验证。USB上传与调试继续使用原生USB，不占用这条查询UART。

U9 随屏幕断电，I²C 和充电状态上拉均接 `SCREEN_IO3V3`；U10 保留电池供电。GPIO6 上电拉高、VREFP 接 VDD；U10 CTG/QSTRT/EP 接地。电量计保持 EnSleep=0，允许正常休眠估算但不进入停止跟踪的 sleep。避免屏幕关机充电后仍显示旧电量，也避免每次屏幕启动都重置电量计。[SC18IM704](https://www.nxp.com/docs/en/data-sheet/SC18IM704.pdf)、[MAX17048](https://www.analog.com/media/en/technical-documentation/data-sheets/MAX17048-MAX17049.pdf)

CHG 低有效，但不是电池电流测量；CHG 高可能表示充满、再充电、禁用或无有效输入，不能强制显示100%。PGOOD 用于判断有效外部输入，CHG 约2Hz闪烁需作为定时故障候选处理。MAX17048 SOC 是估算值，不替代硬件欠压关机。

制造前及首板验收至少覆盖：

1. 实物排线端到端通断、Pin1、正反插方向、接触电流与电池极性。
2. USB 正反插、C-to-C 与 A-to-C；输入限流、空电池、无电池、插拔及启动瞬态。
3. 满亮度+Wi-Fi 负载下 5V 纹波、压降和热；关闭屏幕后 5V 放电与待机电流。
4. 用限流可调源模拟电池逐渐下降，核对实际欠压阈值、恢复阈值、保持按键、反复插拔和关断锁存；不通过过放真实电芯进行测试。
5. 关机充电、运行充电、充电终止、器件温升、向 USB VBUS/屏幕数据脚回灌电流。
6. 正常固件上传、串口日志、USB 调试和 ROM 恢复；电池供电与 USB 供电切换时不丢失必要状态。
7. UART 查询电压、SOC 与万用表/已知负载比较；开关机、USB插拔、关机充电后的SOC连续性；CHG/PGOOD极性、再充电与定时故障解释。
8. 最终 ERC、引脚/封装交叉检查、PCB DRC、BOM与装配方向检查；通过不替代上述实物验收。

## 9. 首批库存核对

首批按用户确认的 5–10 块筛选。以下为 2026-09-27 查询到的国内贴装库存，不是已锁料数量；下单前需按每板用量、损耗和交期重新核对。完整查询字段、时间和商品来源见 [库存快照](../../PCB%20Files/PlayerConsolePower/DesignDraft-2026-09-27/sourcing-snapshot.json)。

| 功能 / 型号 | 立创编号 | 查询时贴装库存 |
| --- | --- | ---: |
| BQ24074RGTR 充电管理 | C54313 | 816 |
| TPS61023DRLR 升压 | C919459 | 37,516 |
| MAX16054AZT+T 按键锁存 | C79401 | 1,946 |
| TPS3808G01DBVR 欠压检测 | C19653 | 18,221 |
| TUSB320LAIRWBR USB-C 识别 | C132554 | 3,783 |
| TS3USB221ARSER USB 数据开关 | C128396 | 92,234 |
| AP2112K-3.3TRG1 局部稳压 | C51118 | 42,274 |
| TYPE-C-31-M-12 USB-C 母座 | C165948 | 449,835 |
| USBLC6-2SC6 数据线 ESD | C7519 | 44,267 |
| MAX17048G+T10 电量计 | C2682616 | 26,112 |
| SC18IM704PWJ UART/I²C 桥接 | C5190383 | 25 |

SC18IM704 本次查询时贴装库存仅25颗、商城零售库存10颗，覆盖首批5–10板基础用量，但余量有限且未锁料；下单时须优先复核这一项，不能称为库存充裕。MAX17048 本次查询贴装库存26,112颗。

BQ24074 虽未达到优先筛选的 1,000 颗，816 颗仍足够首批数量及损耗，因此保留；不能误写成所有芯片均超过 1,000 颗。TPS3840PL33DBVR（49 颗）和 TPS3840PL34DBVR（149 颗）退出当前欠压选型。商城现货与贴装库存分开记录，空字段表示未取得数据，不表示零库存。

## 10. 实现沿革和当前核对范围

2026-10-15本轮仅增加8个裸通孔测试点；当前PCB为76组件/251焊盘，实装仍为68件。最新检查、制造引用与测试点表见页首及第7节。以下器件接入、243脚和RC5计数为历史基线，不能代替本轮导出文件。

同一块“玩家屏幕控制板”、同一个 Schematic2 下仍是两页，对应现有 PCB1：P1（443216bbada87fe6）28个符号，负责充电、升压、欠压和开关；P2（9eb230ca6fd4b303）40个符号，负责USB、接口及电量查询。共68个器件符号，没有新增第三页或第二块PCB。本轮新增 U9/U10、R22–R28、C18–C20；R21 代替原 J4 温度探头接口。

实际网表及PCB均为68个器件（已包含J2）；222个连接脚、21个空网络脚与预期一致，J2另有12个符号引脚完成端点/NC检查。位号、唯一编号无重复。新增3颗电容的模糊料号匹配已更正为 C1591、100nF、C0603。另做了81项料号、供电、芯片引脚和原有电源/USB连接保留检查，见 electrical-review.json；未发现这些检查范围内的不一致。这些结果不替代电路性能和实板验收。

RC5入BOM共68个器件、30种料号，其中67件SMT加J3直插座C131337；其查询库存76,900，未锁料。J3需要插件焊接或后焊，已经加入BOM/CPL，不再按裸孔排除。电池端用PH2.0/PHR-2匹配插头并核对正负极。J2机械匹配仍待验证，J4已移除。PCB243个引脚网络与原理图一致；初次导入的封装修正及其后SW1/SW2各2、3脚修正沿革保留在DesignDraft。本次RC5目录完成34项机械、连接、布线结构与制造引用核对，另有11项J3极性/钻孔/保持性检查通过。

历史RC5原理图SCH DRC曾返回41条warning汇总（更早快照40条），当时尚未取得分类；截至本轮为43条原警告，已分类但未清除。此项与PCB严格DRC返回0项分开记录。旧原理图SVG有已删除文字缓存，不能作为视觉QA通过证据；新PCB预览来自本次实际Gerber并已检查。

当前剩余事项（2026-10-15）：旧订单J3.2地铜短路已定位；COM7/27/28/29已有用户返修反馈，其他旧板不能据此推定已修复，实物与数字候选的对应关系仍待核对。新候选需闭合FPC厚度/方向/通断/峰值、受保护电池包充电容差、U1热孔/钢网及插件装配，以及充放电、欠压、热、完整USB和UART验证。原理图43条警告已分类，30料号身份已核对，原生警告未清除。无电池供电条件及固定EN1限制见第5节；没有无电池实测通过结论。旧故障ZIP、10/14基线和RC6-TP均独立冻结，静态增量通过不等于量产放行。本次仅更新文档，未改EDA或操作串口；共享Git索引由总指挥管理。

## 11. J3电池插头采购方向（RC6-TP沿用RC5极性）

用户已购EEMB LP103454 3.7V/2000mAh（Amazon B08HQWXQ6Y），并将原理图和PCB的J3两脚互换。当前J3为JST B2B-PH-K-S(LF)(SN)/C131337，配PH2.0两针PHR-2线端。**1脚接GND/BAT−（黑），2脚接BAT_PACK/BAT+（红）。**

这里的“2.0mm”指相邻触点的中心间距。本板要求的是 **JST PH系列、2针、2.0mm间距**，线端插壳为PHR-2兼容件，板端为B2B-PH-K-S(LF)(SN)。仅标“JST 2.0”或外观相近不能证明可配合；采购应同时核对系列、针数、插壳结构和线序。

线端插壳侧面能看到金属的孔是端子保持窗口，不是FPC排线的单面金手指；“一面露金属、一面不露”不能定义连接器规格，也不能判断正负极。JST脚号规定触点位置，电池线束的红黑接法需另行核对。

| 固定观察方向 | 左侧／第1脚 | 右侧／第2脚 |
| --- | --- | --- |
| PCB元件面朝向观察者，USB-C在下 | J3.1：GND，BAT−，黑线 | J3.2：BAT_PACK，BAT+，红线 |
| 线端保持窗口朝向观察者，出线向上、插接端向下 | 插壳1脚：黑线、负极 | 插壳2脚：红线、正极 |

以上是RC5与所示EEMB商品图的对应关系；其他角度必须先转换观察方向，不能直接照抄左右位置。

- PCB元件面、USB-C朝下观察：J3左负右正。插座位置和180°旋转不变。
- Amazon商品图：金属端子保持窗口朝观察者、出线在左、插接端在右，红线上、黑线下。顺时针转90°后，出线朝上、插接端朝下；按JST图纸1脚在左，对应黑负，2脚红正，与RC5相符。
- 若商家图采用此前“出线朝下、插接端朝上、保持窗口朝前”的方向，本版对应左红右黑，即该图的“2.0红黑”。这只是特定图片方向的称呼，订购应明确PHR-2兼容、黑1红2。
- 原RC4为红1黑2，制造包与本版相反，保留为历史；后续制造应提交同一版RC6-TP资料并由工厂确认，不能仅改EDA界面或拼用旧包。
- 本轮发现翻转后的旧地铜接触新正极焊盘，6项间距错误已通过重铺铜修复；严格DRC 0及最终Gerber41网无短路/断路已复核。
- 本文未收到独立的插头极性量测记录；更换电池或连接另一块板前，应在断开状态下用万用表核对实际极性。部分已返修板带电池工作不代表任意同壳插头均同极性；本板无电池反接保护。

依据：[JST官方PH图纸第3页Housing/No.1 circuit](https://www.jst-mfg.com/product/pdf/eng/ePH.pdf)、[本版极性证据](../../PCB%20Files/PlayerConsolePower/Layout-2026-09-27-RC5/battery-polarity-review.json)、[11项J3核对](../../PCB%20Files/PlayerConsolePower/Layout-2026-09-27-RC5/j3-connector-verification.json)。图纸核对不等于实物对插通过。
