Ha22yX/Gridopoly/Docs/hardware/power-system-acceptance.md

# 直接24V统一供电验证与制造放行

更新：2026-10-15。状态：**16板功能联调已有实物证据，量化电气验收与制造放行仍未完成**。本轮仅整合既有记录，未执行新测试。只覆盖角落PCB2_5、长边PCB2_1；独立玩家USB-C电池板另见[玩家底板](player-usbc-battery-base-2026-09-27.md)。9/21曾只审核新增供电原理图，该历史范围不能代替当前整板及整盘验收要求；PCB、屏幕、线圈、机械和实际供电仍须按各自证据判断。

当前16板（12长边＋4角落）均已完成V0.34写验，用户已接入24V供电。线圈略抬高于LCD后，用户确认16板均可识别Tag；服务端随后记录16个reader全部stable。ALFA USB热点已取得16格＋4屏共20台同时关联/注册证据；唯一16节点ORDER环ready、0～15自动分配及四角0/4/8/12通过，Pi软件重启后自动启动并恢复原房间。重启后按用户实际开启的16格＋3屏连续观察121.18秒；20台记录不等于36台容量或长期稳定性保证。来源：[USB部署与启动验收](../firmware/usb-ap-deployment-2026-10-15.md)、[线圈装配反馈](../firmware/tile-rfid-screen-coupling-2026-10-15.md)、[试玩记录](../firmware/trial16-release-2026-10-15.md)。

13板灯效已有用户确认，COM16/17/18仍待单独目视；原故障COM19继续隔离。以上功能结果不关闭下方量化电压、纹波、温升、启动浪涌、插拔与保护验收，也不代表最终结构的完整射频验收或实体整局通过。Pi软件重启与完全断电、家庭网络不可用的冷上电分别验收。

## 当前证据与能力边界

9/21[新增供电原理图复核](power-schematic-audit-2026-09-21.md)核对角落35件/97引脚、长边29件/84引脚，181项断言及公共参数检查通过，未发现U201 TPS26621、U23 LMR16030SDDAR控制、反馈、软启动和供电方向的确定错误。此为该次静态检查范围，不是整板器件数量或实测结果。10/15机械只读复核为当前长边141件/底面48件、角落152件/底面46件，相关机械/布局图元与9/21归档一致；实物批次制造哈希仍待绑定。

旧USB-PD/LM5176/R120的4448工况相位裕量与48工况小信号计算仅属于已取消方案，**不能作为当前直流入口的稳定性证据**。当前U201欠压启动标称19.16V、过压关断28.16V、限流约152mA；受控充电与U23软启动均为约半秒的典型估算，不能当生产上下限。

建议24V/5A稳压适配器，5.5×2.1mm中心正极、单点注入。60W是整盘母线取电目标，约1W是每板预算，120W电源铭牌不提高板端额定值；16块板也不能强行均摊满60W。D301串联压降会使24V_BUS低于电源输出；按0.7V、约2.6A估算有约1.8W发热，尚待PCB散热与实测。

## 必须冻结的条件

记录两板PCB revision、同版BOM/Gerber/坐标、固件Git/app SHA、适配器型号与实测输出、插头极性/尺寸、线缆、模块数、ORDER环/开链连接方式、A/B线型断点及端点终端、每段正负回路电阻、环境温度、仪器带宽和测点。没有PD NVM或20V5A协商验收项。

板层使用用户指定1.6mm六层、外层1oz；内层铜和介质以板厂最终叠层为准。40mΩ/段仅是曾用压降模型假设，必须由实际触点、铜及电流分配验证或重算，不能直接签为板厂指标。

用户已确认自然插合的PCB同面共面、实测板厚约1.6mm和最大底面突出约8.1mm。[三模块首件R2](../../Mechanical/BoardBase/README.md)已获用户打印件配合正常的反馈；整盘现采用[Full16 R1](../../Mechanical/BoardBase/Full16_R1/README.md)四个相同L主件＋八片连接片，保持16mm板底高度。三模块反馈不覆盖新增长边—长边接缝、全环闭合、螺纹抗拔及拼接承载；这些仍须实装验收。旧14mm/滑移提案不作为现行安装要求。

## 验收矩阵

| 阶段 | 操作与留证 | 放行条件 |
| --- | --- | --- |
| 无电核查 | 当前两板网表、BOM、PCB，J301中心/外套/开关脚，F301/D301/D302极性，HP_RTN/EP及Kelvin | 无误接，接口逐针导通正确，原生同步无重复件 |
| PCB制造 | 全板DRC、未布线、板外器件、散热铜、过孔和天线净空 | 同一制造包无未处理的关键违规，不能用历史候选PASS替代 |
| USB维护 | J1单独供电，LED关闭/低背光，检查5V/3.3V | 不超来源电流预算；不依赖不存在的PD配置 |
| 单板24V | 限流实验室电源，观察HP_RAW、HP_RUN、24V_BUCK_IN、5V及3.3V | 先充电再启动，电压满足所有负载工作范围，无打嗝或快速升温 |
| 输入选择 | USB与24V分别供电及切换 | 无反灌、非预期掉电，记录切换波形 |
| 空载/轻载 | 单角落、无其他模块，反复开关 | 无持续重试或超压，记录静态功耗 |
| 逐级扩容 | 当前16板已有功能联调证据，补做量化负载测量；新硬件版本仍从2～3块起步，24/32/40块另验 | 电源端/最远端电压、各路纹波、温升和功能均满足冻结限值 |
| 同时启动 | 全部放电后接J301，冷/热态和适配器限流模式测试 | 无持续打嗝；最远端跨过最坏UVLO；不把输入预充模型当整个冷启动峰值 |
| 负载阶跃 | 单板与全盘实际最坏灯效/显示/RFID组合 | 无持续振荡；电压过冲/跌落不越过器件和业务连续运行限值 |
| 温升/压降 | 热稳定后测D301、F301、插座、每段触点、转换器 | 额定及降额要求满足；实际回路电阻超假设时重新计算 |
| 插拔/断环 | 近源/远端逐个接入、断开和复接 | 记录接触弹跳、健康节点复位与恢复；不预先承诺任意热插拔零扰动 |
| 故障恢复 | 受控、限流条件下检查短路/过载与恢复 | 局部保护动作可解释，元件不过额定；F301不按精密限流器使用 |
| 拓扑/机械 | 逐针对插、实际插入行程、固定孔位与无应力闭合；共面已获用户反馈，精确公差另验 | 当前16格唯一ORDER环、0～15及四角0/4/8/12自动分配已验；实体断环/重接、锚点改派及目录24/32/40实体另验。A/B仍禁用，启用前须合格线型断点与两端终端，不能借ORDER闭环证明RS485可用 |
| 业务恢复 | Pi软件重启后的服务/原房间恢复已有证据；继续验实际掉电/复接后身份、ORDER、HTTP、Tag与移动gate | 不重复到达/结算；原始日志、失败及固件身份完整 |

D302为SMBJ26A（角落母线入口），D6为SMBJ30A（本地HP_RAW），两者位置和额定不同；型号数字不是精密钳位电压。错误高电压、反接、短路等测试须按冻结的元件能力与限能方法执行，不直接对未验证样机施加无界故障。

## 采购与放行

- 使用当前最终BOM；旧PD的USB1、J101、STUSB4500、LM5176、C128、R120等不再采购。角落新入口为J301/F301/D301/D302/C301/C302。
- R26/R30 C165751库存0为9/21用户截图，当时替代料未入设计；本次未查库存，不把历史记录当实时缺料。下单重查规格与贴片库存，原13张匹配提示见[BOM核查](bom-review-2026-09-21.md)。
- 屏幕、RFID线圈未包含在9/21新增供电原理图审核范围。10/15抬高线圈后的用户识别反馈与16个reader stable是新增功能证据；最终壳体下的谐振/损耗、读距、边缘/多Tag/相邻线圈及完整显示仍须分别验收，不将基础识别等同全部射频项目通过。
- 每项保存原始测量和失败，不只写通过。PCB、电源样机、机械与整盘实测均完成后，才可发布稳定运行的产品能力。
