Ha22yX/Gridopoly/Docs/hardware/connector-selection-2026-09-19.md

# 3-pin 串联接口选型核查（2026-09-19）

> **2026-10-15 当前状态补充：** 本文为9/19选型历史，不是当前采购清单。当前两板采用6Pin＋3Pin弯脚通孔接口：JIN1 C32713265、JOUT1 C54973819、JIN3 C492411、JOUT3 C54973822；型号、针序见[PCB板型](pcb-variants.md)。10/15当前实例的位置/方向/器件及封装ID与9/21归档一致，用户已确认自然拼接后PCB同面共面；旧C92159/C22373927组合的高度问题不能套用于本批现行组合。未重新查库存，下面数量仅为9/19快照。

机械装配以[整体底板首件R2](../../Mechanical/BoardBase/README.md)为准：一角两长、151×151mm连续L形、PCB底面离桌16mm、每板两颗对角螺丝、Ø6/Ø3.6接触环；3.0×10mm塑料专用螺钉与候选Ø2.5mm盲孔仍需试孔片和首装，尚未切片打印。冻结接口包中的14mm架高/滑移建议保留历史；g=9mm仅在用户约12/15mm量自主体直边的条件下成立，不能当精确已测插合间距。

> 2026-09-22效力说明：本文保留原阶段证据；其中“当前/待实现”仅指当时。现行板为长边PCB2_1、角落PCB2_5，角落直接24V，PD电路、NVM及旧218器件布局不再作为交付。两板支路保护保留，以[供电复核](power-schematic-audit-2026-09-21.md)为准。当前采购/开发入口见[硬件索引](README.md)和[汇报](development-handoff-2026-09-22.md)。

> 2026-09-21归档说明：以下为此前只读选型历史，已撤回候选及当时接口不作为当前BOM。两板当前6Pin+3Pin型号和针序见[PCB板型](pcb-variants.md)。

## 2026-09-19 范围与状态（历史）

当时用户补充：公座和母座均须为90°弯脚插件，排除之前给出的卧贴公母座C5242196 / C5142236。两款均已撤回，截至9/19该轮结束尚无同时通过结构、共面尺寸与 >=100 库存核查的最终替代组合；后续现行组合见上方更新。

用户要求相邻 PCB 平齐对插，候选件在立创商城或 EDA 器件库任一库存至少 100；2026-09-19 最新澄清不限定 SMT，也不要求商城与贴装库同时有货。本次为只读选型，未替换器件、修改 PCB 或下单。

当时Bridge已连通，故障是EDA扩展此前未允许外部交互；该次地址为127.0.0.1:49620，不代表当前桥接运行状态。读取项目为Gridopoly，PCB2_1 UUID 7840864f79449b47。

## 当时器件（2026-09-19 运行中 EDA 读回）

- JIN1–3：BOOMELE 2.54-1*3P 正弯针，C92159，HDR-TH_3P-P2.54-H-M-BW7.2-P。
- JOUT1–3：HC-PM254-8.5H-1x3PW-02A，C22373927，HDR-TH_3P-P2.54_HC-PM254-8.5H-1X3PW。
- 这与更早文档中的五组磁吸接口不同；该段为当日读回，不能替代上方现行6Pin＋3Pin清单。

当时公座为触点高于塑壳的弯针，母座孔位在贴板塑壳中间。图纸支持该旧组合安装后的对插中心不在同一高度。选型应比较PCB安装面到触点中心的距离，不能比较商品页的塑高（不同朝向时含义不同）。

C92159 图纸标总高 4.50 mm、方针 0.64 mm；按塑壳安装面及针截面推算触点中心约 4.18 mm。C22373927 横截面厚 2.50 mm，孔位居中，按贴板安装推算约 1.25 mm。这是尺寸链推算，未经实物量测。

## 已撤回的卧贴候选（不符合用户要求的 90° 弯针）

库存为 2026-09-19 02:17 EDT 本次直接读取 LCSC 商品页 stockNumber 的快照，非搜索摘要，未预留。

| 角色 | 型号 | 料号 | 商城库存 | EDA 封装 |
|---|---|---|---:|---|
| 卧贴公座 | X6511WRS-03H-C60D48 | C5242196 | 7680 | HDR-SMD_3P-P2.54-H-M-W13.3-N |
| 卧贴母座 | X6511FRS-03-C85D30 | C5142236 | 1815 | HDR-SMD_3P-P2.54-H-F-L11.5 |
| 当时母座（该阶段保留方案） | HC-PM254-8.5H-1x3PW-02A | C22373927 | 3450 | HDR-TH_3P-P2.54_HC-PM254-8.5H-1X3PW |

用户明确要求 90° 弯针。以下库存记录保留为研究历史，C5242196 / C5142236 不再推荐，也不得据此替换 PCB。

XKB 两件均为 3Pin、2.54 mm、3 A，EDA 有系统库符号、封装、3D 模型及扩展库标记。公座图纸给出 6 mm 配合针长度；母座为卧贴。这组为卧贴结构，不满足用户此次指定的 90° 弯针要求；之前将它列为推荐属于选型错误。

## 2026-09-19 尚未验证项（针对当时方案）

1. 公座图纸未明确标注 PCB 安装面至触点中心的垂直尺寸和该尺寸公差；同系列以及 3D 外观不等于共面保证。须取得明确尺寸或样品对插核实。现有图纸不足以承诺零高度差。
2. 用 C5242196 替换现有公座的方案也已撤回，不符合 90° 弯针要求。
3. 原公座为通孔，新公座为 SMT，不是原孔位直接替换：需重新布置焊盘、板边距离和插入行程，并检查三组连接器的位置与引脚镜像。
4. 焊点需有结构支撑来承受模块插拔；并核对串联供电电流、现行网络及插拔寿命。本轮没有完成电气或机械整体审核。
5. 当时不推荐只按“反弯针”名称购买；另查的C52097669图纸触点仍在塑壳上方，不能解决该旧组合的高度问题。

## 来源

- 当时公座：[C92159](https://www.lcsc.com/product-detail/C92159.html)，[厂家尺寸图](https://datasheet.lcsc.com/datasheet/pdf/5f82fad7c5167ece80377120bead9dd6.pdf?productCode=C92159)
- 当时母座：[C22373927](https://www.lcsc.com/product-detail/C22373927.html)，[厂家尺寸图](https://datasheet.lcsc.com/datasheet/pdf/910fcd809578df666c46f0c800392412.pdf?productCode=C22373927)
- 候选公座：[C5242196](https://www.lcsc.com/product-detail/C5242196.html)，[厂家尺寸图](https://datasheet.lcsc.com/datasheet/pdf/02b58914122f86030e6378b69d7d3f44.pdf?productCode=C5242196)，[JLCPCB 条目](https://jlcpcb.com/partdetail/XKBConnection-X6511WRS_03HC60D48/C5242196)
- 候选母座：[C5142236](https://www.lcsc.com/product-detail/C5142236.html)，[厂家尺寸图](https://datasheet.lcsc.com/datasheet/pdf/eb545a179d17d1795a97d6a9302c67a3.pdf?productCode=C5142236)

尺寸图已下载并逐页渲染检查。本次证据缓存位于 C:/Users/kicof/AppData/Local/Temp/gridopoly-connector-research/；缓存不纳入产品源码。此文件交主会话统一 Git 归档，不操作共享暂存区。
