Ha22yX/Gridopoly/Docs/hardware/interconnect-audit-2026-09-21.md

# 长边／角落板间接口核查（2026-09-21）

> **2026-10-15 效力更新：** 本文保留9/21原始核查及当时的软件结论。当前长边141件/底面48件、角落152件/底面46件；只读复核确认相关机械/布局图元与9/21归档一致。用户已确认两种实板自然拼接同面共面，板厚约1.6mm、最大底面突出均约8.1mm。现行ORDER支持目录16/24/32/40环，下文当时“拒绝环”和“断开ORDER”的建议不再适用；RS485仍禁用，A/B启用前仍须线型拓扑与终端验证。见[当前互连定义](module-interconnect-5wire.md)、[机械冻结接口](../../Mechanical/BoardBase/interfaces/pcb-interface-2026-10-15/mechanical-interface.json)。

当前安装件为[整体底板首件R2](../../Mechanical/BoardBase/README.md)：一角两长、每板两颗对角螺丝，151×151mm连续L形；PCB底面离桌16mm、平板厚3.5mm、孔周接触环Ø6/Ø3.6。固定件采用3.0×10mm塑料专用螺钉、候选Ø2.5mm顶开盲孔，2.4/2.5/2.6mm试孔片尚未打印试拧。名义底部净空4.4mm，几何检查不能替代首装。冻结原包中的14mm架高、滑移/可调支架提案不改写，已由R2覆盖；g=9mm只在用户约12/15mm测量来自主体直边时成立，仍待首件确认。

> 2026-09-27效力补充：保留本阶段设计/只读审计证据。后续已实现V0.33角色profile、32节点ORDER环及配对，旧“ORDER拒绝环/板型待实现”不再是当前软件状态；RS485仍禁用。另有独立玩家电池底板候选；最新入口见[硬件索引](README.md)和[当前交接](../CURRENT-DEVELOPMENT-HANDOFF.md)，未重新做本文件的硬件实测。

> 2026-09-22文档同步：[硬件入口](README.md)汇总直接24V、BOM与接口结论；[开发汇报](development-handoff-2026-09-22.md)区分历史修改、已验证及待验收。原日期的核查数据未在本轮重新测量。

9/21核查结论：**当时两种 PCB 的互连针序和二维拼接方向兼容，名义位置可以围成矩形周边；不能把这等同于全部插成闭环后，机械和通信均已可靠验收。**该次只读检查没有移动锁定接口或修改电路。10/15自然共面反馈与当前几何复核不关闭完整环的机械、电气和实体通信验收。

## 证据与范围

9/21读取角落 PCB2_5（6f97d7be5a40dd66）与长边 PCB2_1（7840864f79449b47）的实时源文件、接口焊盘坐标、网络，并重新导出两页原理图接口。备份板未作为该次当前板使用。以下证据保持原日期，不替换成10/15的导出或实测。

- [接口坐标、板框与原理图网络摘录](interconnect-audit-2026-09-21/evidence.json)
- [二维拼接计算](interconnect-audit-2026-09-21/closure-model.json)
- [可重跑几何计算脚本](interconnect-audit-2026-09-21/check_geometry.py)
- [32 模块拼接示意](interconnect-audit-2026-09-21/32-module-layout.svg)

源码单位 mil，1 mil=0.0254mm。API 焊盘坐标有小数舍入，元件中心来自原始源文件。图中以 14.5mm 焊盘排间距离为演示假设，不是制造尺寸；矩形闭合计算证明名义几何兼容，不证明实体对插公差或插拔行程。图只画简化板框和接口参考点，没有绘制连接器壳体。

## 针序与方向

|接口|器件|信号|
|---|---|---|
|JIN1|HX PZ2.54-1x6P WZ / C32713265，弯公针|1/2/3=24V_BUS，4=ORDER_IN，5=BUS_A，6=BUS_B|
|JOUT1|LAIL-PM2.54-6P-W / C54973819，弯母座|1/2/3=24V_BUS，4=ORDER_OUT，5=BUS_A，6=BUS_B|
|JIN3|PZ254R-11-03P / C492411，弯公针|三个针均为 GND|
|JOUT3|LAIL-PM2.54-3P-W / C54973822，弯母座|三个针均为 GND|

两板输入公针同位置、同方向。长边左公右母；角落左公上母。装配时保持器件面朝同一面，角落依次旋转 90°，连接每板的 OUT 母座与下一板 IN 公针，无须翻到背面。

核对了长边→长边、长边→角落、角落→长边、角落→角落四种组合，共 36 个针位；沿针排方向偏差为 0（API 分辨率内）。6Pin 按编号 1→1 至 6→6 对应；3Pin 的外侧两个编号在对插时反向，但它们全是 GND，不构成错接。

针距 2.54mm，6Pin 与 3Pin 组中心沿接口边距离 13.462mm。没有发现旋转后 24V 对地、A/B 互换或 ORDER 接到电源的错误。

## 位置与机械边界

|位置|6Pin 中心（mil）|3Pin 中心（mil）|角度|
|---|---|---|---|
|两板 JIN|(-25,-1770)|(-25,-1240)|6Pin +90°；3Pin -90°|
|长边 JOUT|(1920,-1770)|(1925,-1240)|均 +90°|
|角落 JOUT|(1652.0467,-94.5779)|(1122.0467,-94.5779)|均 180°|

**长边 JOUT3 比 JOUT1 沿插入方向前移 5mil=0.127mm。**这不是沿针排方向错位，不会因此让 24V 接到邻针；但是两组母座的焊盘排不共线，插合深度不能直接当作完全一致。角落的两组输出焊盘排共线。

本轮读取并查看四个器件的厂家机械图：2.54mm 针距、单排结构相符；两种公针名义配合针长度为 6mm，但图示 4.30mm 与 4.4mm 的弯折尺寸并不相同；母座图示 8.50mm 壳体深度。公针来自韩下、兴飞，母座来自莱联，资料没有给出这套跨厂家组合的对插容差保证。不能仅凭封装中心共线，承诺贴板装配后两个插头同时插到底。

这些弯针、母座会占用板间空间，**当前接口不是板边零间隙拼接结构**。最终接缝宽度、插入深度、接触高度和最后一处刚性闭环的装配方式，需要实物对插或明确的组合机械尺寸确认。没有在本轮擅自将 0.127mm 偏差改掉，也没有凭库丝印发布外壳尺寸。

厂家图纸（本轮已下载查看）：

- [韩下 6Pin 公针](https://atta.szlcsc.com/upload/public/pdf/source/20250627/A98220D60208B80A167749D0E63EBB9E.pdf)
- [兴飞 3Pin 公针](https://atta.szlcsc.com/upload/public/pdf/source/20240923/0BB0AE042338FD36B1C6C43771D9547C.pdf)
- [莱联 6Pin 母座](https://atta.szlcsc.com/upload/public/pdf/source/20260526/F72FB14A65EA7442DF2017F3AFC567A6.pdf)
- [莱联 3Pin 母座](https://atta.szlcsc.com/upload/public/pdf/source/20260526/B580BB038DF5DA78FDAB8C8BE61190BE.pdf)

## 能围成什么棋盘

采用 4 个相同角落，各旋转 90°，相对两边放相同数量的长边模块，名义几何可以闭合。例：4 个角落 + 28 个长边，每边 7 个长边，共 32 块；计算闭合误差约 1e-13mm，为浮点误差。此结果依赖相同接缝采用相同的名义插入间距，不包括加工及装配公差。

一般周边矩形计数为 `N=4+2a+2b`，a、b 分别为一条横边、一条竖边的长边模块数量（不含角落）。这代表周边棋盘，并非把二维矩阵全部铺满。实际板框中角落为 80×80mm；长边主体约 48×80mm，两侧连接器位置各凸出约 3mm，最大宽约 54mm。

## 全部闭合后的电气问题

当前 JIN/JOUT 的 BUS_A、BUS_B 在每板直接贯通。如果最后一板也全部接回第一板，A/B 会构成闭合环。TI 的 RS485 设计指南推荐线形菊花链，环形网络可能产生反射，不能以直流导通证明通信稳定。两板 U6 为 SN65HVD75DR；本轮实时网表中两板 R15=120Ω 均设为不加入 BOM，即默认没有装终端。没有断点、指定两端和终端配置的完整闭环，不能按可靠 RS485 总线放行。

来源：[TI RS485 设计指南](https://www.ti.com/lit/an/slla272d/slla272d.pdf)、[TI 拓扑培训（含 Ring network avoid）](https://e2e.ti.com/cfs-file/__key/telligent-evolution-components-attachments/13-143-00-00-00-26-49-53/IIF_2D00_Training_5F00_RS485_2D00_Design-Guidelines.pdf)。

**以下两段为9/21的软件限制与历史建议，已被后续ORDER环实现替代。** 当时 `Server/RaspberryPi/src/TileOrderTopology.h:172` 在所有节点都有上游、找不到链首时将拓扑标为 `conflict/cycle`，这是当时源代码行为，不是对设备已部署版本的断言。物理最后一段把 ORDER_OUT 接回第一板 ORDER_IN 并形成完整已识别环，会与当时的排序逻辑冲突。

9/21曾建议：**棋盘机械外形闭合，最后一处连接仅让24V/GND贯通，断开ORDER和A/B，让数据链保留首尾；在数据链两端配置终端，其余板R15不装。**该专用转接件当时未实施，现行ORDER不应按此历史提案断环。RS485未启用；未来A/B的线型断点和两端终端另行设计，不通过松插、错位插或弯断针脚实现。

接口方向和针序结论继续保留；当前仍需首件确认固定接缝和无应力锁紧，并完成正常24V供电、RFID与实体环验收。9/21核查与10/15机械复核都不等于整盘电气制造放行；计划16板V0.34分批联网也不代表同时在线闭环通过，见[当前试玩记录](../firmware/trial16-release-2026-10-15.md)。
