Ha22yX/Gridopoly/Docs/hardware/corner-led-white-2026-10-15.md

# 角落模块 COM19 持续白灯：独立只读核查记录

记录日期：2026-10-15，America/New_York。范围为已有设计归档、已有采集日志及厂家资料；本轮未操作串口、未修改或烧录固件、未修改任何 PCB 工程或历史制造归档。

**结论：已找到当前 LED 发送参数与归档型号的明确规格不符，但尚未定位持续白灯的唯一根因。原故障板保持断电隔离，等待受控实物验证。替换板的任何成功结果都不能证明原板已修好。**

## 设备与事件边界

| 对象 | 已知身份与状态 | 证据边界 |
| --- | --- | --- |
| 原故障角落 | batch02，COM19，MAC `a4:cb:8f:c6:26:24`；正常 V0.33，app 摘要前缀 `761bd36f` | 主会话、格子任务报告已写验并联网；已有 ROM 身份记录另存本证据包 |
| 白灯现象 | 用户确认整圈持续纯白、特别亮、无呼吸；USB 供电、未接 24 V | 用户目视反馈，经总指挥转述；本核查未直接目视实物 |
| 完整断电复现 | USB 与两侧连接断开 10 秒，再独立 USB 供电观察 15 秒，仍持续白；随后拔 USB | 用户操作结果由总指挥转述。排除仅一次上电遗留，不能排除每次重现的时序、供电或装配问题 |
| 第一块角落 | COM15，据主会话为相同 app | 未被报告白灯不等于已通过灯环验收；未获得两块实际贴装 BOM 的逐项对照 |
| 新替换角落 | COM10，PnP MAC `a4:cb:8f:c1:e1:34` | 记录交接时总指挥报告已识别、准备审阅候选后烧录；本记录不宣称已写验或灯环通过 |

主会话已授权格子任务修正源码、进行 host 回归并准备普通候选；截至本记录交接点，硬件核查方未执行部署。后续版本与部署证据由格子任务、总指挥维护，不用本记录代替。

## 归档硬件核对

核对输入为 `DesignAudit-2026-09-21` 的角落、长边 pinmap，以及角落 DC24 `SyncRepair/fixed-schematic.net`。原文件路径及 SHA-256 见[证据清单](../../PCB%20Files/CornerModule/LEDWhite-2026-10-15/manifest.json)，相关元件完整属性和引脚摘录见[归档接线证据](../../PCB%20Files/CornerModule/LEDWhite-2026-10-15/archived-led-power-extract.json)。这些是设计归档，**不是 COM19 的实际装配 BOM、板厂替料或焊接检验结果**。

- 灯圈为 U12–U21，共 10 颗 `WS2812B-B-V6`，立创编号 `C52941391`。归档每颗 1 脚接 `5V_IN`、3 脚接 GND；4 脚为库标注 DIN，2 脚为 DOUT。
- 数据路径：U3 的 GPIO21（模块 23 脚）→ `ESP_LED_DATA_3V3` → U5 `74HCT125D,653` 的 9 脚输入、8 脚输出 → `LED_DATA_5V_RAW` → R38 330 Ω → `LED_DATA_01` → U12.4。
- U12.2 经 `LED_DATA_02` 到 U13.4，依次级联至 U21.4；U21.2 留空。U5 的 10 脚 OE 接地，通道常使能；14 脚接 `5V_IN`，7 脚接地。
- U5、U10、R31、R38、U12–U21 的器件型号、数值和命名网络在上述角落/长边资料中一致。未发现归档中角落灯数或接线与固件 10 灯定义不一致的证据。
- USB 可以给灯圈供电：J1 `USB_VBUS` → U7 自恢复保险 → U9 TPS2121 电源选择 → `5V_SELECTED` → R31 10 mΩ → `5V_IN`。LED 没有独立电源开关；未接 24 V 不代表灯圈断电。
- LED 通道 OE 常开，归档 GPIO21 数据网上未见独立外部下拉。MCU 初始化前的输入状态以及上电黑帧时机需要检查；这一点不足以解释已持续发送时仍然全白。

## 已确认的时序不符

采用准确型号的 Worldsemi 厂家手册，已由两名审查者视觉核对第 4 页，而非套用旧 WS2812 的常见时序。原始 [PDF](../../PCB%20Files/CornerModule/LEDWhite-2026-10-15/WS2812B-B-V6-manufacturer.pdf)及[第 4 页图](../../PCB%20Files/CornerModule/LEDWhite-2026-10-15/WS2812B-B-V6-page4-timing.png)已保存；[来源](https://atta.szlcsc.com/upload/public/pdf/source/20251224/2F6ED8FFFF9D3044AED3CCAA3E4BF0D9.pdf)。

故障版本参数由格子任务报告，并在本轮核查时从 `Firmware/TileModule/src/main.cpp` 读到：RMT tick 125 ns，0 码为 3 高/7 低，1 码为 6 高/4 低，显式帧后等待 80 µs，每 50 ms 更新一帧。源码此后可能正在修订，不能把未来工作树内容当作故障固件快照。

| 参数 | V6 第 4 页规格 | 故障版本设置 | 结论 |
| --- | --- | --- | --- |
| T0H | 220–380 ns | 375 ns | 范围内，但距上限仅 5 ns |
| T0L | 580–1000 ns | 875 ns | 名义值范围内 |
| T1H | 580–1000 ns | 750 ns | 名义值范围内 |
| T1L | 580–1000 ns | 500 ns | **低于下限 80 ns，明确不符合** |
| 数据周期 | ≥1.25 µs | 1.25 µs | 名义值满足 |
| 复位低电平 | 280 µs 以上 | 显式等待 80 µs；另有帧间空闲 | 不能只用 80 µs 判断实际复位不足 |

总指挥确认 HAL 配置 idle LOW。若实际输出确实在约 50 ms 帧间持续为低，实际复位间隔已经足够；因此不把“80 µs 小于手册值”直接列为持续白灯的原因。应检查首帧、连续调用及实测空闲电平。

交给固件任务的候选参数为实际 tick 62.5 ns：0 码 `5H/15L` = 312.5/937.5 ns；1 码 `10H/10L` = 625/625 ns；两者周期均 1.25 µs，并显式保持复位低电平至少 350 µs。这是待实现、待验证的建议，不是本记录已部署的修复。须核对 `rmtSetTick` 的实际返回值，并在条件允许时测 R38 后首灯输入波形；转换器延迟、负载及低压均可能改变实际脉宽。

## 供电与 INA 读数的解释

[Nexperia 74HC/HCT125 Rev.8](https://assets.nexperia.com/documents/data-sheet/74HC_HCT125.pdf)第 3 页表 5规定 **74HCT125 的推荐 VCC 为 4.5–5.5 V**。同一手册中 74HC125 的 2–6 V 范围不能套用到已归档的 HCT 型号。已通过网页工具读取原厂 PDF；直接下载返回 403，证据包不声称保存了该 PDF。

现有日志经离线提取保存为[遥测摘录](../../PCB%20Files/CornerModule/LEDWhite-2026-10-15/telemetry-extract.json)。25 秒只读采集元数据标明仅发 STATUS、无 reset、无 flashWrite；本记录没有重新采集。

- 早先约 45 秒观察，COM19 约 4.105–4.131 V、591.3–609.0 mA；后续 25 秒观察约 4.054–4.080 V、596.8–612.3 mA。原日志还记录历史 peak=649.5 mA，该 peak 不等于此次窗口内测得峰值。
- 同批三块 long 先前约 4.235–4.294 V、110–141 mA，供电环境与校准未经过本任务仪表验证。
- 如果万用表在 U5.14 对 U5.7、或 TP1 对 GND 也确认约 4.1 V，则 HCT 缓冲器低于保证工作范围。这是有效排查线索，**不是已经证明的白灯根因**；long 的日志电压也低于 4.5 V，更不能据此解释只有这一块白灯。
- INA226/R31 采样的是整板 `5V_IN` 负载，包含屏幕、MCU、RFID 和 LED，不能将 0.6 A 全部归给灯环。总线电压读数不依赖电流 Calibration 寄存器；电流依赖校准、换算及实际分流电阻，日志不是已校准电流表结果。[TI INA226 手册](https://www.ti.com/lit/ds/symlink/ina226.pdf)
- 若电流确为 0.6 A，正常 10 mΩ 的 R31 仅约 6 mV 压降；不能用它解释约 0.9 V 的整体电压差。应比较 USB 插口、保险、MUX 与 5V_IN 各点，并区分供电跌落是异常负载的原因还是结果。

## 最小后续验证与负责人

原故障板当前保持断电隔离；不以接入 24 V 或长期全白运行作为诊断办法。这是故障隔离措施，不是判定器件损坏。后续实物操作由总指挥安排明确窗口。

1. **格子任务**：完成精确 V6 时序修正、回归和候选构建，准备全黑、低亮单红/绿/蓝诊断；亮度控制应作用于灯环，现有 BRIGHTNESS 仅控制 LCD。
2. **总指挥协调实物方**：异常板与正常角落用同一数据线、同一 USB 口分别短时对照；先测 `USB_VBUS`、TP1/LED VDD 的 `5V_IN` 对 GND，必要时测 U5.14 对 7，确认电压后判断黑帧和低亮颜色响应。未经安排，本任务不通电或占串口。
3. **若黑帧仍无效**：在供电满足规格时检查 U5.9、U5.8、R38 后 U12.4 波形；再核对实装 LED/缓冲器料号、首灯焊接和级联。仅凭全白、0.6 A 或反复复位不足以决定换灯。
4. **总指挥**：分别记录原故障板和替换板的 app、波形/电压及目视结果。替换板成功仅证明该组合在该板上通过，原 COM19 保持未修复，直到它自身复验通过。

本记录没有更新玩家供电板，也不改变其 RC6-TP 的既有验收边界。没有 Git 暂存或提交；共享索引由总指挥处理。
