Ha22yX/Gridopoly/Docs/hardware/batch32-firmware-audit-2026-09-25.md

# 32模块批量固件：硬件只读审计

> 2026-09-27效力补充：保留本阶段设计/只读审计证据。后续已实现V0.33角色profile、32节点ORDER环及配对，旧“ORDER拒绝环/板型待实现”不再是当前软件状态；RS485仍禁用。另有独立玩家电池底板候选；最新入口见[硬件索引](README.md)和[当前交接](../CURRENT-DEVELOPMENT-HANDOFF.md)，未重新做本文件的硬件实测。

审计日期：2026-09-25。整理日期：2026-09-26。范围：28个长边模块、4个角落模块的角色识别、MCU接口、ORDER闭环可行性和批量烧录所需硬件参数。

本报告记录PCB任务已发给总指挥、格子固件和服务器任务的只读结论。仅新增本文，不修改旧文档、EDA工程、PCB、备份、固件或Git索引；没有烧录、实物测量或再次开展制造审查。总指挥负责引用及Git收尾，各端新开发的实现/构建/部署状态须查其后续报告，不能由本文推定。

## 1. 订单制造revision尚未证实

主任务转述用户已下单32块板，不等于已有订单文件与本地工程对应的证据。审计时嘉立创EDA桥服务存在，但连接窗口数为0，无法从活动编辑器重新导出网表。

只读SQLite连接（`mode=ro`）检查本地`PCB Files/Gridopoly.eprj2`：文件最后写入时间为`2026-09-22T04:19:32.610180Z`；最新project_structures记录为id 1262、ticket 726042，包含以下身份：

| 板型 | 原理图页面UUID / 内部version | PCB名称、UUID / 内部version |
| --- | --- | --- |
| 角落 | ae9c8047ce85d7f8 / 1790045246817 | PCB2_5、6f97d7be5a40dd66 / 1790046233143 |
| 长边 | 262b1ccbed23ba63 / 1789968723803 | PCB2_1、7840864f79449b47 / 1789970686416 |

这些version是编辑器内部记录，**不是制造revision**。工程另有“备份 长边模块 2026-9-21（投产版本）”，不能凭名称确定订单采用哪一板。本轮未找到绑定2026-09-25订单的同版Gerber、BOM、坐标及哈希清单，因此不能证明今天下单板与下列网表完全一致，也不凭旧未布线记录判断实际订单状态。

最后可核验的电气基线是[2026-09-21供电审查](power-schematic-audit-2026-09-21.md)的两份网表；本次没有从本地工程历史增量重建一份新网表。

| 网表 | 元件数 | SHA-256 |
| --- | ---: | --- |
| [corner-sch.net](../../PCB%20Files/DesignAudit-2026-09-21/corner-sch.net) | 152 | `63c47fe8e557dd2e07d68bb5b36063b73ed984224917a683a8f047caed304681` |
| [long-sch.net](../../PCB%20Files/DesignAudit-2026-09-21/long-sch.net) | 141 | `01e99b30a572e93d2c359f35c2414c173ab88769c03af49de586e6798cc95d46` |

2026-09-26整理本文时再次读取上述文件计算SHA，仍与审计值相同。订单对应关系和首件核对由主任务后续补齐；不阻止以明确基线开展独立固件开发。

## 2. 没有可靠的自动long/corner识别信号

逐一比较上述两网表，U3的全部41个封装引脚网络完全相同。角落仅比长边多`J301/F301/D301/D302/C301/C302`及`TP1～TP5`；两板共同IC型号一致。

- 没有已发现的板型ID电阻strap、EEPROM或角落独有的可探测数字器件。
- GPIO13对应U3.21，两板均为空网/NC；其他空脚的浮空电平也不能充当角色识别依据。
- 两板都有INA226，A0/A1均接GND，地址同为0x40。扫描到INA226或读取芯片标识不能区分角色。
- J301是无MCU检测连接的直流入口，PWRMUX_STATUS未连接MCU；电源电压、电流或插入适配器也不能可靠判断板形。
- 旧STUSB4500已删除，不得以0x28是否应答区分角落。MAC可作为人工登记身份的键，不能由MAC/OUI推断PCB形状。

因此默认角色应为`unknown`，不能把缺器件响应、NC脚电平或异常测量自动解释成`long`或`corner`。固件角色必须由显式构建配置或经确认的provision记录确定。

## 3. 批量固件所需共同参数

下表是网表、[引脚定义](esp32-s3-pin-map.md)以及审计时`Firmware/TileModule/include/board_config.h`、`src/main.cpp`、`platformio.ini`的共同基线，不是新批次实物验收。

| 功能 | 两板共同参数 | 量产限制 |
| --- | --- | --- |
| MCU/存储 | ESP32-S3-WROOM-1-N16R8；16MB Flash、8MB Octal PSRAM | 审计时配置为qio_opi、opi、default_16MB.csv；首件核对实装器件与分区，不凭串口名判断板型 |
| LCD软件基线 | ST7789、240×320、SPI MODE0；RST4、DC5、MOSI6、SCLK7、CS15、BL16；无MISO | 原理图J4只证明接口，不能证明本批外接屏控制器/分辨率/玻璃方向或BL驱动 |
| LCD旋转/频率 | 审计时main.cpp使用rotation=0；默认8MHz | rotation=0是软件默认，不是量产安装朝向证明；40MHz只允许已实测设备白名单，不能推到32板 |
| RGB | U12～U21，共10颗WS2812B-B-V6；GPIO21 | 两板数量一致，按GRB数据与实际物理顺序验证；不能凭默认亮度认为功耗已达标 |
| RFID | HTRC110；SCLK17、DIN18、DOUT8；外部5V、4MHz有源振荡器 | 两板接口一致；本轮未检查线圈/调谐或实装外设 |
| ORDER | 输入GPIO9，输出GPIO10驱动Q1；低释放、高拉低下一板线路 | 不是GPIO10直接推挽驱动跨板线；闭环机制见下一节 |
| RS485 | TX43、RX44、DIR14；SN65HVD75 | 本审计建议继续禁用发送、DIR保持低；ORDER闭环支持不等于RS485环形可用 |
| USB/BOOT | USB D−19、D+20；BOOT GPIO0 | J1为本地USB5V/调试，角落无PD维护依赖 |
| INA226 | SCL11、SDA12、0x40；R31=10mΩ | 只测本地5V侧，非全盘24V；审计时Calibration=0x1400，对应100µA/bit基线，须实物校准 |
| GPIO13 | 两板NC | 不初始化为PD_RESET，不作为role strap |
| 本地供电 | U201输入限流标称约152mA；U23输出标称4.963V | 约1W/板是设计预算；不能按U23的3A额定推定整板可提供5V/3A |

J4针序在两板一致：1 GND、2 3V3_SYS、3 BL/PWM、4 CS、5 SCLK、6 MOSI、7 DC、8 RST。没有证据将角落屏独立配置为240×240或必然旋转90°；屏幕配置应与实际显示模组和安装方向独立绑定。

## 4. ORDER可以闭合发现，A/B是另一种电气结构

### ORDER每段是独立直邻链路

两份网表均为：

```text
前一板JOUT1.4 → 本板JIN1.4 ORDER_IN → R16 1kΩ → ESP_ORDER_IN/GPIO9
                                                      ├─ R17 10kΩ → 3V3_SYS
                                                      └─ C24 100nF → GND

本板GPIO10 → R18 1kΩ → Q1 Gate（R19 100kΩ下拉）
                      Q1 Source → GND
                      Q1 Drain  → ORDER_OUT/JOUT1.4 → 下一板输入
```

本板ORDER_IN与ORDER_OUT不是同一贯通网。审计时`include/order_link.h`的Transmitter每6秒编码**本机**boot、sequence和CRC；Link::tick分别更新接收器和发送器，不把收到的上游帧转发成下游帧。`src/order_link_io.cpp`每次启动生成随机非零boot，GPIO10控制Q1，1ms定时采样；15秒失效和采样延迟处理属于现有协议边界。

因此首尾闭合后仍是32段独立直邻链路，不会成为32个发送器共享同一根ORDER导线，也不是波形绕环无限转发。各节点可独立收发，不必先选出全环主节点才开始发信标。**可用既有直邻信标作为新环协议底层**，但仍需32板电气、调度抖动、掉线/重启和供电噪声实测。

旧服务器“无链首即conflict/cycle”是既有软件限制；总指挥已开展闭合ORDER环开发。新实现须明确完整有向环、唯一地图锚点、方向、角色数量/间距、过期边和重启映射，并验证冲突处理。本文不证明新代码已完成、已部署或环发现已实机通过。

boot是临时运行身份，不能用它做永久role记录。稳定deviceId/MAC和本次boot须建立有效映射，重启时撤销旧boot证据。4角/28长边、相邻角落间7长边是目标装配约束，可用于检查已provision角色，不能当作自动读取硬件role的证据。

### A/B每板直通，闭合后是共享电气环

BUS_A、BUS_B从JIN到JOUT直通；全部首尾对插会形成实际A/B环，两板R15在审查网表中均为DNP。ORDER的新环协议不能解决RS485反射、终端和支线问题。当前Wi-Fi/HTTP业务与ORDER可独立开发，RS485保持禁用；日后启用仍需单独冻结物理拓扑并验证。

旧文档建议断开ORDER/A/B是旧链协议下的方案。针对主任务本次“不改已下单PCB、开发闭合ORDER”的新目标，**不把ORDER断点当必需硬件改动**；A/B的限制仍保留，也不建议为本轮任务修改PCB或人为折断针脚。

## 5. 角落相对转向固定，绝对朝向未知

[接口几何审查](interconnect-audit-2026-09-21.md)记录：同一器件面朝上时，角落左侧IN公针、上侧OUT母座，方向关系固定；四角依次旋转90°可构成名义矩形周边。不能由此推断哪颗角落是绝对北向、START或屏幕显示旋转。

PCB没有方向传感器。地图锚点/起点、corner角色、屏幕旋转应分别表达；改变地图锚点不应偷偷改写硬件role。机械对插行程、跨厂家高度、接缝、长边JOUT3沿插入轴0.127mm偏差等沿用原审查限制，不在此次重复制造检查，也不以几何模型宣称实物已验收。

## 6. 推荐的角色烧录与持久化方法

首批可选择显式long/corner构建profile，或统一镜像加设备provision记录。两种方式都保留unknown默认，不自动猜测。

1. 形成32个稳定MAC/deviceId绑定的清单，经实际板形/标签确认28 long、4 corner，记录固件哈希和操作结果。COM口仅用于当次连接，不是永久身份。
2. provision至少包含schema版本、role、hardwareRevision、设备身份、batch和完整性校验；订单revision未证明时明确unknown，不从PCB2_5之类编辑器名称伪造制造revision。displayRotation可另配置。
3. 写入后commit、读回校验、重启验证，再计为烧录完成。构建role与持久化role矛盾时报告冲突并暂停自动拓扑分配，不能静默覆盖。
4. 建议在最终分区表中设置独立factory NVS，与Wi-Fi/房间/运行状态隔离；正常业务只读打开，维护流程才允许写入。损坏或版本不支持返回unknown，不在通用NVS恢复逻辑中顺带擦掉工厂区。
5. 若本批先保留原分区，可用独立namespace及应用层保护，但它不能抵御整个NVS擦除。OTA/日常升级须保留role；全片擦除会丢失记录，批量工具须根据MAC清单重新provision。
6. 不复制带设备身份、网络凭据或角色数据的同一整片Flash镜像到全部板；不烧eFuse来确定可更正的long/corner角色。

Espressif [NVS接口文档（v4.4，ESP32-S3）](https://docs.espressif.com/projects/esp-idf/en/v4.4/esp32s3/api-reference/storage/nvs_flash.html)提供独立NVS分区和只读handle接口。具体分区表、API和只读flag须核对实际Arduino/ESP-IDF版本，不能直接照搬新SDK特性；本审计未实施分区或provision工具。

## 7. 交付与剩余责任

| 状态/责任方 | 结果或下一步 |
| --- | --- |
| PCB审计 | 两份网表SHA、U3全部41脚相同性、共同外设参数及角落差异已核对；没有硬件自动role证据 |
| 本轮文档 | 仅新增本文；未暂存/提交，主任务负责引用、审核和Git收尾 |
| 总指挥 | 绑定实际订单制造包/revision与批次清单，冻结角色和地图锚点契约；不以本文充当制造放行 |
| 格子固件 | 实施profile/provision与故障语义、保持共同引脚及8MHz保守显示基线，区分源码/构建/烧录/首件验证 |
| 服务器 | 实施并验证有向闭合ORDER环、角色与锚点、TTL和重启映射；未有效配置的设备不猜角色 |
| 实物验证 | 首件核对实际屏幕/装配与网表，再逐步扩到32板；当前没有新增烧录或32板运行证据 |

本有界只读审计和指定新文档阶段至此结束；不追加PCB修改、后台监测或新的制造审查。
