Ha22yX/Gridopoly/Docs/hardware/corner-dc24-input-2026-09-21.md

# 角落模块改为直接 24V DC 输入

> 2026-09-22文档同步：[硬件入口](README.md)汇总直接24V、BOM与接口结论；[开发汇报](development-handoff-2026-09-22.md)区分历史修改、已验证及待验收。原日期的核查数据未在本轮重新测量。

更新：2026-09-21。用户取消 USB-C PD→24V，指定 DC 5.5×2.1 mm、中心正极。本记录替代所有旧 PD 源、PD 配置及其功率冗余结论。

## 已完成和边界

- 角落原理图 `ae9c8047ce85d7f8` 已保存。删除 PD 区 72 个器件及专属连线、注释，新增 6 个器件，净减少 66 个；现有物理器件共 152 个。
- 当前关联 PCB 是 **PCB2_5 / 6f97d7be5a40dd66**。旧 PCB2_2 及日期备份不是本次目标。
- PCB 已删除对应 72 个器件、创建 6 个新封装并核对焊盘网络；146 个保留器件的位置、层和角度与修改前一致。新入口器件暂列在板框右侧，尚未布局布线；部分旧支路保护器件本来就在板外。因此本次不是生产就绪版本。
- 长边模块、备份板、本地 J1 USB、显示 J4、LED、板间接口、本地 24V→5V 与 U201 支路保护未作设计更改。
- GPIO13 原 PD_RST 连接已删除并加 NC；GPIO11/12 原 INA226 I²C 保持。取消 STUSB4500、PD NVM 配置和首次 J1 写入依赖。现有业务固件未修改。

## 电路和器件

```text
J301.1（中心+）→ DC24_IN → F301 → DC24_FUSED → D301.A
                                                   D301.K → 24V_BUS
J301.2（外套−）→ GND                               │
J301.3（开关脚）→ NC                     D302、C301、C302 → GND
```

| 位号 | 型号 / 立创编号 | 用途 |
| --- | --- | --- |
| J301 | XKB DC-005-5A-2.0 / C381116 | 额定24V/5A；厂家图纸指定配对插头5.5×2.1mm，插入深度9mm；1正极、2负极、3开关触点 |
| F301 | S1206-F-4.0A / C553923 | 4A、32VDC、1206快断保险丝；分断能力35A |
| D301 | MDD SS56B / C14651 | 60V/5A串联肖特基，反接阻断及反向回灌阻断 |
| D302 | BORN SMBJ26A / C152100 | 单向TVS，K接总线、A接地；26V截止，非精密24V钳位器 |
| C301 | CL21B105KBFNNNE / C28323 | 1µF/50V/X7R/0805 |
| C302 | CL10B104KB8NNNC / C1591 | 100nF/50V/X7R/0603 |

全部新增料号在检索到的立创库存页面有货，快照及来源在[新增BOM](../../PCB%20Files/CornerModule/DC24-2026-09-21/input-bom-stock.csv)。网页库存不是下单锁定库存，也不等同于贴片基础库。
母座的“2.0”是中心针直径，厂家图纸配对插头内径为2.1mm；不能用商品名称中的6.2mm入口尺寸代替插头外径。参考[立创母座页](https://item.szlcsc.com/353348.html)。

## 供电能力与验收

- 采用稳压且具备过流/短路保护的24V电源，当前选型建议24V/5A（120W），单点给总线供电。60W是负载设计目标，不是本次已经验证的连续能力；端口、铜皮、板间触点及散热仍需验收。
- 24V_BUS不再有升压闭环，电压约为电源电压减去D301、保险丝、线缆和接点压降。60W负载约2.5–2.6A。按0.7V压降估算D301约1.8W发热，需足够散热铜皮并实测；该估算不是温升合格证明。
- 早期24V/3A（72W）仅作为60W目标的起步等级，后续为启动和损耗余量建议24V/5A（120W）；仍须实测适配器启动/限流与温升。120W不是本板额定可输出功率；不要继续引用旧PD方案的67.13W/24.32V等计算。
- 单个角落独立工作无需配置PD。电源按负载自然提供电流，无需数模块改变电压；系统仍有自身静态功耗。
- F301不提供受控上电或主动限流；TVS只处理限定能量的瞬态，不能长期吸收错误高电压。全盘启动与热插拔依赖所选适配器、原U201软启动和布线；原PD环路分析不能证明新方案通过。
- 验收包括空载/单板/60W、最低输入与最远节点压降、满载温升、全部模块同时启动、逐个接入/断开、电源短路恢复。接触顺序、接插件耐流和浪涌尚须实物确认。
- 默认只接一个24V电源。串联二极管防回灌不意味着允许多电源均流或功率叠加。

## 验证证据

[导出目录](../../PCB%20Files/CornerModule/DC24-2026-09-21/)保存原理图、网表、PCB源和原生epro2快照。
原理图前后逐引脚对比：保留器件仅U3.21由PD_RST改为NC，其余连接不变；新增器件极性与网络逐项断言通过。PCB焊盘网络按位号/引脚与原理图对照通过，保留布局核对通过，无PD_命名残留铜线。
原理图DRC API返回 `[{"type":"warn","count":2}]`；未提供警告全文，本轮不宣称警告已全部消除。PCB尚未完成新入口布线、全板DRC与制造放行。

## 导入更新重复添加问题修复

2026-09-21，现场发现6件新入口与旧PD件复用内部唯一ID，反复导入累积重复件。已通过原生API删除36件重复件及6件旧PD残留，为新入口两端重分配独立唯一ID并统一描述。保存关闭重开后152件无重复，原生网表不一致错误为0；剩26项间距、51项未连接，PCB仍未投产放行。之前仅基于源文件的同步检查不足，此次以原生重开DRC结果修正。最新工程快照采用[SyncRepair](../../PCB%20Files/CornerModule/DC24-2026-09-21/SyncRepair/README.md)，父目录旧快照仅追溯。
