Ha22yX/Gridopoly/Docs/hardware/corner-pcb-layout-candidate-2026-09-21.md

# 角落 PCB 全板重排与布线候选版（2026-09-21）

> 2026-09-22效力说明：本文保留原阶段证据；其中“当前/待实现”仅指当时。现行板为长边PCB2_1、角落PCB2_5，角落直接24V，PD电路、NVM及旧218器件布局不再作为交付。两板支路保护保留，以[供电复核](power-schematic-audit-2026-09-21.md)为准。当前采购/开发入口见[硬件索引](README.md)和[汇报](development-handoff-2026-09-22.md)。

> 2026-09-21 最新变更：用户已取消角落 PD→24V，改为 5.5×2.1mm 中心正极的直接24V输入；见[替代设计](corner-dc24-input-2026-09-21.md)。本文保留为历史记录，PD电路/固件/功率计算不再适用于当前板。

历史状态：**当时保存到角落 PCB2_2，未制造放行；现已被PCB2_5直流版替代。** 原生严格 DRC 多次返回 `Error: undefined`；独立几何检查不替代嘉立创EDA完整规则检查、厂家 DFM 或电源样机测试。

## 范围和约束

本次只修改角落 PCB `d03bb2d6c85bb69d`。长边 PCB、两个原理图及日期备份没有修改。用户已授权删除旧走线和重新布局。保持 80×80 mm 圆角外形、四个安装孔；采用现有 JLC06161H-3313 六层叠层、1.6 mm 板厚、外层 1 oz。内部铜厚记录为 0.0152 mm，不按外层 1 oz 计算。

17 个固定器件的原始坐标、旋转和所在层逐字段相等：J1、USB1、JIN1、JIN3、JOUT1、JOUT3、J4、U12～U21。其余器件重新分区和分面。218 个器件全部保留，顶面 110、底面 108；需要双面贴装。元件引脚网络与本次开始时已同步的 PCB 网表一致，差异为 0。

## 实施内容

- 清除旧板级走线、过孔与铺铜，从新布局重新布线；不是沿用原先未完成的飞线状态。
- MCU/逻辑位于左侧；大电感、四 MOS 和电流采样位于右侧功率区；PD 控制/输入保护在右侧及背面，本地降压区位于下半部。重新摆放贴近引脚的自举、去耦、栅极及保护设置阻容。
- 24V_BUS 主干在 L3/L4 使用并行 2.54 mm 铜线，分支采用对应较窄线宽；功率网络使用多过孔换层。主回流区域追加 11 个地过孔，并将 320 段电源/地线在几何允许时加宽。上述数量描述此次修订，不能直接等同额定载流认证。
- L2/L5 为地参考，顶底层补地铜；实际生成的铜皮已参与独立连通检查。U201 的 HP_RTN 继续与 GND 分离。
- USB 主干在底面成对布线，参考 L5 地铜；主干线宽 0.15 mm、边缘间距 0.16 mm。插座/ESD 和电阻附近仍有局部换层与分支，阻抗与端到端差分检查尚未完成；不能把先前主干长度差当作最终整个 USB 网络验收结果。
- 使用原生过孔。最终 481 个板级过孔，不包括封装内图元。常用过孔铜径/钻孔为 0.45/0.20、0.60/0.30、0.65/0.30 mm。存在焊盘内过孔，须采用填孔并盖铜工艺并由板厂确认，不可直接当普通开口过孔下单。
- 重排可见丝印，避免覆盖焊盘；部分密集区位号隐藏，装配时使用装配坐标/位号图。天线禁止布线/铺铜区域约为 x=10.5～29.5、y=−20～−13.9 mm；固定接口条件下完整射频净空仍需验证。

## 已有验证证据

| 检查 | 候选版结果 | 限制 |
| --- | --- | --- |
| 器件及网表 | 218 件；引脚网络差异 0 | PCB 与本次基线比较 |
| 固定器件 | 17 件坐标/角度/层完全不变 | identity-verification.json |
| 同面元件包络 | 未发现低于 0.2 mm 的包络间距 | 由封装几何建模，非完整三维装配验证 |
| 独立铜间距 | 异网小于约 0.152 mm 为 0；短路为 0 | 未包含所有自定义 DRC 规则 |
| 实际保存数据和地铜 | 未连通网络 0；短路 0 | 对保存的 LINE/VIA 和原生 POURED 建模，圆弧离散近似 |
| 过孔钻孔 | 孔间距低于约 0.3 mm 为 0 | 板级过孔之间及过孔对封装通孔；不是完整厂家钻孔验收 |
| 原生严格 DRC | 失败，`Error: undefined` | 未获得可放行的检查报告 |

## 尚未放行的项目

1. 必须取得原生严格 DRC 结果并清除制造相关错误。已经请用户在当前 PCB2_2 手动运行检查并提供结果；不是要求用户批准未检查设计。
2. 原工程为 24V_BUS 单独设置 0.3 mm 爬电规则。保守的同层几何预筛有 **46 个对象对** 小于 0.3 mm（含内层以及封装自有焊盘），不等于 46 条原生爬电错误。需逐项按外层路径、焊盘约束和规则适用性判断并修正，尚未豁免或关闭该规则。一般 0.152 mm 检查通过不能代替此项。
3. 主干由最初 3 mm 调整为两层并联 2.54 mm，已符合现有通用线宽上限；没有关闭间距规则。最终宽度仍需结合铜厚与散热验证 60 W 工作状态。
4. USB 实际端到端差分长度、过孔/分支、90 Ω 阻抗及生产叠层待确认；总分支长度不是端到端差分长度。
5. 60 W 下的电源环路、铜温升、MOS/电感散热、地回流、Kelvin 采样以及满盘启动/热插拔必须完成针对当前 PCB 的电气复核和样机测试。原理图理论结果不能替代新布局验证。
6. 板厂需要确认填孔盖铜、0.2 mm 钻孔、最小线宽/间距、双面装配、阻焊桥、板边和连接器固定脚。最终 BOM/坐标/Gerber 必须来自同一个通过验收的工程快照。

未生成用于直接下单的制造包。当前文件是继续检查和迭代的候选工程。

## 文件

候选快照：[`LayoutCandidate-2026-09-21`](../../PCB%20Files/CornerModule/LayoutCandidate-2026-09-21/README.md)。其中 `.epro2` 为包含库数据的原生文档，`.epcb` 为保存的 PCB 源码；`.dsn` 为离线走线几何，不能替代原生 PCB。六层预览由原生地铜与候选走线几何绘制，不是嘉立创EDA窗口截图。JSON 记录检查范围和限制，manifest.json 记录哈希。
