Ha22yX/Gridopoly/Docs/hardware/corner-usbc-pd-24v-schematic-2026-09-20.md

> 历史版本：本页针对早期 TPS55340 / 20V 3A 方案。当前入口已改为 0–60W 设计，请以 [2026-09-21 设计复核](corner-usbc-pd-24v-60w-review-2026-09-21.md) 和最新导出为准。

> 2026-09-22效力说明：本文保留原阶段证据；其中“当前/待实现”仅指当时。现行板为长边PCB2_1、角落PCB2_5，角落直接24V，PD电路、NVM及旧218器件布局不再作为交付。两板支路保护保留，以[供电复核](power-schematic-audit-2026-09-21.md)为准。当前采购/开发入口见[硬件索引](README.md)和[汇报](development-handoff-2026-09-22.md)。

> 2026-09-21 最新变更：用户已取消角落 PD→24V，改为 5.5×2.1mm 中心正极的直接24V输入；见[替代设计](corner-dc24-input-2026-09-21.md)。本文保留为历史记录，PD电路/固件/功率计算不再适用于当前板。

> 历史阶段记录：后续已增加两板紧凑支路保护、R120=5.6k及角落ESP32配置PD（删除J101）。当前状态见[硬件基线](hardware-baseline.md)、[理论复核](unified-power-theory-review-2026-09-21.md)与[最新PD连接](corner-pd-esp32-programming-2026-09-21.md)；下文“当前”、旧库存及验证数字只对应本阶段。

# 角落模块 Type-C → 24V_BUS 原理图

日期：2026-09-20。已在嘉立创EDA的角落模块 `Schematic1_1 / p1` 中绘制并保存。本文件取代同日规划文档中的候选器件方案。后续全面复核发现并修正了连接器额定电压与保护阈值裕量问题；详见 [电气复核](corner-usbc-pd-24v-electrical-review-2026-09-20.md)。**状态 HOLD：24 模块冷启动、输入瞬态、环路与温升未验证，不能签核为可量产或保证一次启动。**

## 修改范围与文件

仅在用户矩形内修改供电电路；经用户明确同意，USB1 从额定 5V 的 C2765186 换成额定 20V/3A 的 C42418793，24V_BUS 端口在框内移位。框外原有图元逐项比较无变化。未更新 PCB 或边长模块。USB1 更换了实际库器件及封装，后续 PCB 不能继续沿用旧母座封装而不检查。

矩形原生坐标：X=1330…2295，Y=-890…-210。目标页面 UUID：`ae9c8047ce85d7f8`。

`PCB Files/CornerModule/PD24/` 保存：完整页面原生 `.esch` 快照、嘉立创EDA导出的 Protel2 网表、供电区域 SVG/PNG、BOM 与库存、验证结果。原生快照用于复核和恢复当前页面，不是包含完整器件库的独立工程包。

## 电路与额定目标

USB1 → STUSB4500 协商与两级 P-MOS 输入开关 → TPS55340 升压 → TPS26600 输出限流/防倒灌 → 24V_BUS。

按 24 个模块、每个 1W，预计母线负载约 24W/1A；电源连续输出设计目标 24V/1.5A。使用明确支持单口 20V/3A 的 60W 或 65W PD 电源和合格 3A C-C 线。其他负载、模块启动峰值及每格降压损耗需另核算。

本电路从 Type-C 初始 5V 独立启动 PD，不依赖尚未上电的 ESP32。USB1 的数据线和 SBU 不连接。新口原始电源不接原调试 USB 的 VBUS 或 5V_IN。

| 功能 | 器件与设置 |
| --- | --- |
| PD | U101 STUSB4500QTR；CC1/CC2 与对应 dead-battery 脚相连；ADDR0/1 接地 |
| 输入资格 | Q101 受 VBUS_EN_SNK 控制；Q102 受 POWER_OK2 控制；需要两者同时有效，避免 POWER_OK2 拔线后的保持状态误启动 |
| 输入保护 | U104 TVS2200；D104 ESDA25W；两个 MOS 的栅源分别用 12V 齐纳保护 |
| 升压 | U102 TPS55340RTER，非同步拓扑，L101 10µH，D101 SS54；R110=95.3kΩ，约 500kHz |
| 输出设定 | R112=187kΩ、R113=10kΩ，升压节点约 24.21V；经过 eFuse 导通压降，母线约 24V |
| 环路初值 | R111=2.55kΩ、C115=100nF、C116=100pF；需按实际电容偏压衰减与负载验证 |
| 输出保护 | U103 TPS26600PWPR；R115=169kΩ，欠压开启约 21.30V；R117=220kΩ，过压约 27.37V；限流标称约 1.68A |
| 输出启动 | C117=220nF，计算输出斜坡约 42.6ms；MODE 经 402kΩ 接 RTN，为限流后锁存故障模式 |

TPS26600 内置背靠背 MOS，负责输出反向阻断和 ORing；不另叠加此前规划中的 LM74700。**PD_RTN 与系统 GND 是不同网络**，U103 的裸露焊盘、编程电阻和 dV/dt 电容按手册接 RTN。SHDN# 利用内部上拉，故障后断开该入口电源复位；未将 SHDN# 错接到 24V。

正常按一个角落接电源使用。多个入口的防倒灌设计不代表保证均流、功率叠加或无缝切换。无效/不足的 PD 合同不应启动母线。

## 必须执行：STUSB4500 NVM 配置

U101 不能按未经核对的出厂默认值直接投产。配置要求已写在原理图框内：

| 配置项 | 要求 |
| --- | --- |
| PDO1 | 5V / 0.5A，仅控制电路启动 |
| PDO2 | 20V / 3A |
| PDO count | 2；禁用第三 PDO |
| POWER_ONLY_ABOVE_5V | 1 |
| POWER_OK_CFG | 2（二进制 10，配置 2） |
| REQ_SRC_CURRENT | 0，使用配置的受电电流要求 |
| I²C 地址 | 0x28 |

J101 从 1 至 5：GND、外部编程器 3.3V、SCL、SDA、RESET。3.3V 仅供 I²C 上拉；写入时 USB 电源必须给 U101 的 VDD 供电。按 ST 官方工具/流程生成配置、写入、读回并重新插拔验证。本次没有生成或烧录经硬件验证的 NVM 字节镜像。

## 选型与库存

新增 50 个物理元件，并更换原 USB1；当前供电 BOM 共 51 个元件、27 个料号，查询时全部至少 100 件。最低为 L101 `C2041441`，182 件。复核时查询的新母座 C42418793 为 3765 件，R115 的 C137791 为 13700 件，R117 的 C22961 为 1339800 件。具体型号、位号与来源在 `BOM-stock.csv`。库存为查询时快照，采购时重新确认。

## 已完成的核对

- 嘉立创EDA原生网表导出成功；更换母座后 190 个物理引脚（包含 USB1 和明确不连接的引脚）与设计网络逐项相符。
- 新增器件都有库器件/封装关联；无重复位号；引脚均在框内。
- 原有框外内容与修改前原生源逐项比较无变化。新增电路和原 USB1 的变更均位于用户框内。
- 规则检查 API 返回 3 条警告，没有返回错误/致命错误项。当前 3.2.203 API 仅给分类数量，未返回警告明细，因此没有把这 3 条警告签核为已解决。
- 从原生导出 SVG 复核画面，并修正文字重叠及一个输出端口位置冲突。

## 制板与样机仍需验证

连续 1.5A 和效率是设计目标，未做样机实测。PCB 阶段需实现升压开关回路、电感/二极管/输入输出电容邻近放置、IC 散热裸露焊盘与足够铜面积。10µF 陶瓷电容按 20–24V 直流偏压核算有效容量；补偿参数需环路/负载阶跃确认。TPS55340 的 5A 开关能力不能直接当作 24V 输出 5A。

上电验证依次覆盖：NVM 读回、插头正反插、仅 5/9/15V 或 20V 电流不足的源不能启动、20V/3A 成功启动、24 个模块实际并联电容与负载启动、额定负载温升/纹波、短路锁存复位、拔线与重协商、母线已经带电时插入第二个入口的反向电流。软件 DRC 和网表一致性不能替代这些电源验证。

## 数据手册

- [STUSB4500](https://www.st.com/resource/en/datasheet/stusb4500.pdf)
- [TPS55340](https://www.ti.com/lit/ds/symlink/tps55340.pdf)
- [TPS2660](https://www.ti.com/lit/ds/symlink/tps2660.pdf)
- [LCSC 元件与库存明细](../../PCB%20Files/CornerModule/PD24/BOM-stock.csv)
