Ha22yX/Gridopoly/Docs/hardware/pcb-design-handoff-2026-09-19.md

# PCB 设计任务接任记录

> 2026-09-22效力说明：本文保留原阶段证据；其中“当前/待实现”仅指当时。现行板为长边PCB2_1、角落PCB2_5，角落直接24V，PD电路、NVM及旧218器件布局不再作为交付。两板支路保护保留，以[供电复核](power-schematic-audit-2026-09-21.md)为准。当前采购/开发入口见[硬件索引](README.md)和[汇报](development-handoff-2026-09-22.md)。

> 2026-09-21归档说明：本文保留接任时状态；后续过孔、布局、两板供电及PD连接见[当前交接](../CURRENT-DEVELOPMENT-HANDOFF.md)与[两种PCB](pcb-variants.md)。本次仅将已有记录纳入文档索引，不把接任工作当本次设计修改。

日期：2026-09-19（America/New_York）。本次仅阅读与接任，未修改原理图、PCB、固件或设备，未运行 DRC、导出制造文件或发起制造。

## 职责与协作

负责原理图、PCB 布局布线、引脚与接口、电源及信号完整性，并与固件任务协调接口变更。具体设计范围由后续用户任务确定。

遵守根目录 AGENTS.md：保留全部已有未提交修改；不切换分支、重置或清理工作树；共享 Git 索引与提交由主任务统一处理。本记录为新增交接文档，尚未由 PCB 任务暂存或提交。

| 任务 | ID |
| --- | --- |
| 主任务 | 01a074be-4f3e-7d40-9aac-9f794be8de4b |
| 服务器 | 01a07e9a-1ccd-76b0-b141-2361b149f958 |
| 玩家屏幕 | 01a07e9a-1e6a-7572-8cf4-f3185ca61195 |
| 格子模块 | 01a07e9a-2067-7e91-a9f6-803e02d818d7 |

## 文件与设计基线

实际可访问根目录为 `Z:/Files/我的项目/Gridopoly`；环境提供的 `Z:/sata11-13515273888/Files/我的项目/Gridopoly` 本次检查不可访问。

- 工作工程：`PCB Files/Gridopoly.eprj2`，27,410,432 字节，文件头为 SQLite；Git 已有未提交修改，必须保留。
- 可移植快照：`PCB Files/Gridopoly-current.epro2`，3,754,323 字节，文件头为 ZIP；不能假定与当前工作工程相同。
- 历史备份：`PCB Files/Gridopoly_backup/`，包含多份按日期命名的 `.epro2`。
- [硬件基线](hardware-baseline.md)记录的当前原理图为 `Board1/Schematic1/P1`，PCB 为 `Board1/PCB2_1`（UUID `7840864f79449b47`）。其 6 层铜、144 个器件、136 个 BOM 项等数字来自 2026-07-31 文档快照，本次没有重新打开 EDA 或通过 API 验证。

接任时文件 SHA-256，仅用于标识本次读取对象：

```text
Gridopoly.eprj2         d7b6f7d518f5486af37cfa8682e4907bf9235ef76d2964e7a9469328cf26b851
Gridopoly-current.epro2 3fea6c9331274f259f64852183701b053bec8add5ed8cbbbe4976af2675d1c91
```

## 已了解的接口

- 格子模块文档基线：ESP32-S3-WROOM-1-N16R8；24V 母线经本地降压形成 5V，与 USB 5V 经 TPS2121 选择；INA226 测本模块分流电阻后的负载，TPS62160 产生 3.3V。
- 格子屏为 240×320 ST7789，另有 HTRC110 RFID、10 颗 WS2812 和 RS485 硬件。GPIO 表以[引脚文档](esp32-s3-pin-map.md)及 `Firmware/TileModule/include/board_config.h`交叉核对。
- ORDER 使用 GPIO9 输入、GPIO10 驱动 2N7002 栅极；GPIO10 高表示下游线路被拉低，低表示释放。当前 V1 为独立物理信标加 HTTP 上报，见 [ORDER 协议](../firmware/tile-order-protocol.md)。
- 玩家屏是独立的 Viewe `UEDX48480021-MD80ET` 2.1 英寸 480×480 模组，不能套用格子板的引脚表。

## 后续设计前需核实

1. 用户要修改的板卡、目标问题、实际已制板版本，以及当前工作工程与可移植快照的差异；本次只确认目录与文件头，没有审计数据库内部网表、布局或布线。
2. 现有硬件文档也有未提交修改。[旧互连文档](module-interconnect-5wire.md)中的 RS485 令牌枚举与已部署 ORDER V1 不同，后续文档整理需保留硬件针序并明确协议适用版本。
3. 文档列出的待验证项目包括最终叠层/铜厚/USB 阻抗、DRC 与未布线、连接器镜像及机械防反接、母线压降与温升、电源纹波/热设计、装配后的 RFID 调谐。本次未验证这些项目，也不据此判定当前 PCB 已可投产。
4. 2026-09-09 双板 ORDER 已有真实联调记录；第二块当时读卡器为 `fault`，且曾在下载模式停留，随后恢复运行。这些是历史现象，不足以直接认定 PCB 缺陷。玩家屏频闪/错位的视觉验收也仍有历史待确认记录。
5. COM6/COM8/COM7 和树莓派地址均为历史连接信息，本次没有占用串口、查询在线设备或重刷固件，后续实机工作须重新核实。

本次接任完成，等待用户具体 PCB 设计任务。
