Ha22yX/Gridopoly/Docs/hardware/unified-power-theory-review-2026-09-21.md

# 角落与长边模块统一供电理论复核（2026-09-21）

> 2026-09-22效力说明：本文保留原阶段证据；其中“当前/待实现”仅指当时。现行板为长边PCB2_1、角落PCB2_5，角落直接24V，PD电路、NVM及旧218器件布局不再作为交付。两板支路保护保留，以[供电复核](power-schematic-audit-2026-09-21.md)为准。当前采购/开发入口见[硬件索引](README.md)和[汇报](development-handoff-2026-09-22.md)。

> 2026-09-21 最新变更：用户已取消角落 PD→24V，改为 5.5×2.1mm 中心正极的直接24V输入；见[替代设计](corner-dc24-input-2026-09-21.md)。本文保留为历史记录，PD电路/固件/功率计算不再适用于当前板。

> 2026-09-21 更新：角落模块已取消 J101，STUSB4500 改由 GPIO11/12 共享 I²C、GPIO13 复位，VSYS 接 3.3V，首次经 J1 USB 调试口供电配置。长边模块 GPIO13 仍未连接。详见 [PD 主控配置连接](corner-pd-esp32-programming-2026-09-21.md)。

## 结论与签核边界

正常统一供电架构合理：单个角落接入合格 USB PD 电源，产生约 24V 总线，角落及长边模块从总线受控取电。现有计算支持单模块及 16–40 个约 1W 模块的正常供电方案。没有发现需要推翻架构的逻辑问题。

本结论是有条件的工程理论复核，不是“所有工况已证明稳定”。尚未完成实际 PCB、电源样机、PD NVM 编程读回及热插拔测试。任意接触顺序、接触弹跳、短路或断环瞬间不重启，不能在此签核。剩余器件属性 DRC 警告按用户要求保留。

## 必须满足的条件

- 电源单口支持 20V/5A（100W），使用 5A e-marker 线。输入端按最低 18V 计算；STUSB4500 必须实际写入并读回所需 PDO/NVM，不能只放芯片就认为已协商成功。
- 60W 指主电源 24V 总线出口的总预算，含后续连线及分支损耗；不是 60W 末端净负载再额外加线损。72W 是设计检验点，不是保证可持续输出的额定值。
- 每模块以约 1W 使用。分支限流约 144–161mA，不能因为总电源有 60W 就认为少量模块可各自消耗数瓦或从本地 5V 任意取 3A。
- 每段正极与地回路合计电阻应控制在 40mΩ 以内（包含热态走线、连接器及接触电阻）；这项要求尚未在 PCB/实物上确认。线电感、布线及散热也必须符合设计。
- 启动估算假设每模块 5V 总有效电容不超过 1mF，5V 降压效率至少 85%，主转换器效率至少 90%。效率是设计假设，尚非实测保证。

## 本次修改与连通性

角落 R120 从 6.8kΩ 改为 5.6kΩ，选用 0603WAF5601T5E / C23189；未增加元件，保留原位号、UID gge215、0603 封装、坐标及连线。供应商、制造商、显示值、阻值属性均已更新；不继续处理器件标准化提示。查询时国内即时库存 869000，记录见 r120-stock.json，库存不代表预留。

此前已对两种模块的未使用引脚补充 NC，并整理部分供应商属性；本次最终导出与复核前网表比较，长边 423、角落 691 个已连接引脚的网络映射全部不变。PCB 尚未同步这次电源原理图改动，不能直接用旧 PCB 投产。

本阶段 corner/long-schematic 是R120复核快照。角落后续最新网表已移至PCB Files/CornerModule/PDProgramming；长边仍以PowerIntegrity为准。此处691引脚是主控PD编程改动之前的数目，最新角落为685。Hotplug 目录的原理图、图片与旧计算是前一版本记录；其 BOM-stock.csv 已将 R120 更新为 C23189，最新 R120 库存证据在本目录。

## 主环路

依据 TI LM5176 Quickstart Tool SNVC208 v1.0.2 的斜坡补偿、电流模式功率级和补偿网络公式重新实现小信号模型，并以增量负导纳近似扩展恒功率负载。它不是 TI 官方开关级 SPICE 仿真。

最终补偿：R120=5.6kΩ，C121=2.2µF，C122=1nF。4448 组随机与边界组合中，最低计算相位裕量约 52.8°，最低增益裕量约 14.4dB；6.8kΩ 时扩大边界扫描曾出现约 43.7°，因此调整现有电阻。

扫描含输入 18–21V、功率至 72W、主输出有效电容 160–270µF、ESR 5–40mΩ、电感 ±20%、频率 270–330kHz、补偿电容变化和采样斜坡偏差。控制器跨导 ±25% 与部分综合参数范围为工程假设，不能称为厂家保证的全部最坏组合；边界扫描并非穷举所有温度/公差。

48 组分布式小信号网络模型未出现右半平面极点。但该模型简化了 PTC 及输入小电容位置，eFuse 仅按导通状态处理，没有完整非线性反向截止、保护状态机；只用于排查稳定工作点附近风险，不用于验证微秒级接触瞬态。局部降压器使用厂家内部补偿，其完整闭环未与主电源建立开关级联合模型。

## 线损与断环

在源端最低 23.89V、40 个模块平均分担 60W 末端负载的额外压力测试下：

| 回路条件 | 最远点电压 | 总线损耗 |
|---|---:|---:|
| 完整圆环，每段回路 40mΩ | 23.38V | 0.87W |
| 断成单端长链，每段回路 40mΩ | 21.77V | 3.75W |
| 断成单端长链，每段回路 75mΩ | 19.56V | 见模型输出 |

第三种条件可能低于最高约 20.05V 的分支启动门限，因此不能承诺接触电阻任意增大或断环后仍可靠重启。上表 60W 是故意采用的末端压力测试，源端还要支付线损，不能与实际 60W 出口预算混淆。电气上模块并联取电，物理连接呈圆环。

## 整盘启动

按电容与软启动电流边界估计，主电源软启动最长约 619ms；分支输入受控上升最快约 311ms。结合最早 UVLO 门限，主电源到达最终电压至本地降压启动间仍约有 154ms 的计算余量。

40 个模块、每模块 5V 电容 1mF、采用快于典型值的软启动假设，5V 电容充电折算到总线的峰值约 4.19W。60W 出口负载预算加此充电项约 64.19W；18V 输入、最低电流限制及 90% 效率假设给出约 67.13W 可用功率，约余 2.93W。不能再重复把 60W 净末端负载加上线损套入该余量。

LMR16030 的软启动电流部分数据仅为典型值，本模型额外假设电流上浮 50%，不是厂家保证值。UVLO、FLT/EN 时序及实际大电容仍需样机验证。正常 40×1W 情况比上述 60W 出口压力条件更宽裕。

## 插拔瞬态尚未签核

分支 eFuse 能控制大电容充电、限流并实施保护，但总线接触瞬态仍有风险。前级约 100nF 电容在 24.74V 下储能约 30.6µJ；无阻尼理想 LC 阶跃可达两倍电压，这只是边界说明，不是预测本板会达到 49.48V。主电源大电容位于反向阻断器件前，不能假设它吸收所有总线侧回灌能量。

SMBJ30A 的实际钳位、连接器接触顺序、地线先后、弹跳与布线寄生需要共同检查；FLT 接本地 EN，异常期间可能主动停机。插入保护的存在不等于周围模块绝不会重启。

模型图中的 ±60W 阶跃是固定工作点线性外推，不是从断电到整盘启动，也不是实际拔除全部模块的非线性波形。1W 阶跃均匀分布在 40 个节点，不代表单块局部热插入。本报告不使用这些曲线作为热插拔通过的证据。

## 复现与资料

运行 `python power-integrity-review.py`，需 numpy、scipy、matplotlib。输出 JSON 与 PNG；默认随机种子固定。没有运行官方加密 PSpice 模型，没有硬件实测。

- [TI LM5176 数据手册](https://www.ti.com/lit/ds/symlink/lm5176.pdf)
- [TI SNVC208 计算工具](https://www.ti.com/tool/download/SNVC208)
- [TI TPS2662 数据手册](https://www.ti.com/lit/ds/symlink/tps2662.pdf)
- [TI LMR16030 数据手册](https://www.ti.com/lit/ds/symlink/lmr16030.pdf)
- [R120 国内商城](https://item.szlcsc.com/23916.html)

只读提取的官方计算工作簿 SHA256：`2692ee8d838c25ed72a07802ed5f18e2b6e2d01d11ab938214afb8a121ebdbc0`。
