Ha22yX/Gridopoly/Mechanical/PlayerConsoleStand/outputs/reports/cw50_ccw10_delivery.md

# Gridopoly Player Console Stand CW50 Delivery

## Rotation Change

The complete mating-interface pattern changed from 60.0 degrees clockwise to
50.0 degrees clockwise. This is a 10.0-degree counterclockwise rotation from
the prior CW60 model. The three M4 alignment pins, the 3.1 mm and 4.1 mm
locator holes, the 9.0 mm FPC groove, and the C-ring opening are rotated as one
rigid pattern.

## Delivered Files

- `C:\Users\Administrator\Desktop\Gridopoly\Mechanical\PlayerConsoleStand\outputs\models\Gridopoly_Player_Console_Stand_CW50.stl`
- `C:\Users\Administrator\Desktop\Gridopoly\Mechanical\PlayerConsoleStand\outputs\models\Gridopoly_Player_Console_Stand_CW50.blend`
- `C:\Users\Administrator\Desktop\Gridopoly\Mechanical\PlayerConsoleStand\outputs\renders\Gridopoly_Player_Console_Stand_CW50_interface.png`

The named CW50 STL and BLEND are byte-identical copies of the regenerated
parameterized working outputs. The prior `Gridopoly_Player_Console_Stand_M4_Pin_Down.stl`
delivery was not overwritten.

## Geometry Verification

- STL SHA-256: `11BE8BF9063D931CFB2F2B4D3505F45D6D8FA115D9B923C231074676305BBA57`
- BLEND SHA-256: `53CB00C3CE02F5B7667EDCEBB3EAC53825A957C2A899E0FE3289D581FD07D361`
- STL bounds: `94.0 x 82.0 x 45.864471 mm`
- STL triangles: `4200`
- STL connected components: `1`
- STL non-manifold edges: `0`
- STL degenerate triangles: `0`
- BLEND connected components: `1`
- BLEND non-manifold edges: `0`
- Declared mating-pattern rotation: `50.0 degrees clockwise`
- M4 pin 3 local center: `(1.5628335990023734, -8.863269777109872) mm`
- C-ring: `34.5 mm ID`, `40.0 mm OD`, `7.6 mm height`, `9.0 mm opening`
- M4 pins: `2.9 mm diameter`, `18.0 mm PCD`
- Locator holes: `3.1 mm / 4.1 mm diameter`, `20.0 mm PCD`
- FPC groove: `9.0 mm width`, `2.0 mm depth`
- Stand mating angle: `35.0 degrees`

`scripts/verify_stand.py` completed with `VERIFICATION PASS`. Its measured
mesh data confirms the named artifact's byte-identical STL has printable,
closed/manifold geometry with no degenerate triangles.

## Test Results

All mechanical unit tests passed after regeneration: `41` total.

- `tests/test_stand_parameters.py`: 9 passed
- `tests/test_build_contract.py`: 5 passed
- `tests/test_geometry_build.py`: 13 passed
- `tests/test_verify_stand.py`: 12 passed
- `tests/test_render_outputs.py`: 2 passed
