Ha22yX/Gridopoly/Mechanical/BoardBase/interfaces/pcb-interface-2026-10-15/reviews/connectors-review/connectors-review.md

# 长边＋角落连接器机械只读复核（2026-10-15）

结论：本次 **2 块长边＋1 块角落采用统一 PCB 基准面**。用户最新已经确认三块实板自然插合后可以共面；单板不能平放是底面高器件先接触桌面，不应据此抬高或降低某块 PCB。此用户事实来自主线程转述，本审核没有接触实物。

当前保存源的 8 个接口实例全部与 2026-09-21 归档的位号、实例 ID、UID、封装 ID、器件 ID、坐标、角度、正面层一致。旧 3 针连接器高度问题不能再当作现行实物“不共面”的证据。此次没有操作 EDA、串口、Git 或修改仓库；只在本 temp 子目录保存报告、JSON 和厂家资料。

## 当前四种接口与接触高度

| 位号 | 当前归档型号／料号 | 厂家图直接给出的机械尺寸 | 对插中心 Z |
|---|---|---|---|
| JIN1 | HX PZ2.54-1x6P WZ / C32713265 | 6 针、2.54 mm 间距、2.50 mm 塑壳截面，外露配合针 6.00±0.20 mm | 塑壳贴板、触点居中时名义约 1.25 mm |
| JIN3 | PZ254R-11-03P / C492411 | 3 针、2.54 mm 间距、2.50 mm 塑壳截面，外露配合针 6.00±0.25 mm | 同上，名义约 1.25 mm |
| JOUT1 | LAIL-PM2.54-6P-W / C54973819 | 6 针、2.54 mm 间距、2.50±0.20 mm 塑壳截面，插入轴方向壳深 8.50±0.20 mm | 同上，名义约 1.25 mm |
| JOUT3 | LAIL-PM2.54-3P-W / C54973822 | 3 针、2.54 mm 间距、2.50±0.20 mm 塑壳截面，插入轴方向壳深 8.50±0.20 mm | 同上，名义约 1.25 mm |

四种厂家 PDF 均下载、渲染并目视核查。**1.25 mm 是按贴合安装及居中截面的尺寸链推导，不是厂家单独给出的 PCB 基准面至中心高度及组合公差规格。** 用户确认支持本次实际共面装配，不代表审核独立测得该 Z 数值或验证其他批次。6 针和 3 针均可按相同名义接触 Z 建模；底板统一 datum，精细 connector body 尺寸以图纸/实物为准。

男针图上的 4.30 mm（6 针）和 4.4 mm（3 针）是弯折相关的轴向尺寸，不是安装后的接触 Z；母座“塑高 8.5”在弯脚安装后是插入轴方向壳深，也不能拿来当 PCB 上方高度。这些差异可能改变接触行程，而不要求 PCB 错层。

厂家原图（本目录包含同名 PDF 与 PNG）：

- [JIN1 韩下 6 针](https://atta.szlcsc.com/upload/public/pdf/source/20250627/A98220D60208B80A167749D0E63EBB9E.pdf)
- [JIN3 兴飞 3 针](https://atta.szlcsc.com/upload/public/pdf/source/20240923/0BB0AE042338FD36B1C6C43771D9547C.pdf)
- [JOUT1 莱联 6 针](https://atta.szlcsc.com/upload/public/pdf/source/20260526/F72FB14A65EA7442DF2017F3AFC567A6.pdf)
- [JOUT3 莱联 3 针](https://atta.szlcsc.com/upload/public/pdf/source/20260526/B580BB038DF5DA78FDAB8C8BE61190BE.pdf)

## 位置、方向与插拔空间

原始保存源使用 mil；以下角度是源文件角度，所有接口在 layerId=1。两板公针在左侧朝外，长边母座在右侧朝外，角落母座在上侧朝外；保持器件面一致，角落在平面内旋转，不翻到背面。

| 板型／接口 | X,Y (mil) | 角度 |
|---|---|---|
| 两板 JIN1 | -25,-1770 | +90° |
| 两板 JIN3 | -25,-1240 | -90° |
| 长边 JOUT1 | 1920,-1770 | +90° |
| 长边 JOUT3 | 1925,-1240 | +90° |
| 角落 JOUT1 | 1652.0467,-94.5779 | 180° |
| 角落 JOUT3 | 1122.0467,-94.5779 | 180° |

- 针距 **2.54 mm**；每侧 6 针和 3 针组中心相距 **13.462 mm**。
- 独立重算归档 API 焊盘的长→长、长→角、角→长、角→角共 36 个横向针位比较：误差为 0（归档坐标精度内）。最新源的接口位置/方向/ID没有变化；没有重新调用 API 提取实时封装焊盘。
- 长边 JOUT3 比 JOUT1 沿插入轴前移 **0.127 mm**，仍然存在。它不是针排方向错针，也不是 Z 台阶；不应为追求视觉齐平擅自移动已可插合的接口。角落输出两组焊盘排共线。
- 公针外露配合段标称 6 mm，不等于已经确定的必要插入/拔出行程；母座有效接触起点、最终插深和实物插合余量还未给出测量值。外壳必须留平面内插拔通道，不能挡住插头伸出、母座口或抓取位置。
- 角落两边的插拔方向互相垂直。三块组合按先后顺序连接即可保留运动自由度；整盘最后一处刚性闭合，以及未来拆中间一块的办法，需要结构装配顺序，不应靠扭板或斜插实现。

## 接缝尺寸仍须保持参数化

“可以共面”已经由用户确认；**精确板间距未给出**。旧几何演示采用 14.5 mm 的两组 6 针焊盘排距离，只是画图假设，不能升级成制造尺寸。

按现有源板框在接口位置的轮廓中心线，公端焊盘排到板边约 2.27786692 mm，母端 6 针排到板边约 2.31913176 mm。若实物插合后两板 6 针焊盘排距离为 D，则接口凸出处板边净距约：

`g = D - 4.59699868 mm`

旧演示 D=14.5 mm 会得到 g≈9.903 mm；**这仍是示例，不是已测接缝**。长边主体是约48 mm宽、接口凸出处约54 mm最大宽，不能混用主体边和接口凸出处的缝宽。优先从用户已插好的 2 长＋1 角测量 D 或对应板边间隙，再固定模型参数。不要改 PCB 接口位置来迎合示例接缝。

## 历史问题与当前事实分离

2026-09-19 历史检查使用 C92159 公针／C22373927 母座，推导中心约4.18／1.25 mm，属于旧器件；后来撤回的 C5242196／C5142236 卧贴候选也不在现行接口中。2026-09-21 归档原理图已经是上表四种器件；本次最新保存源仍对应同一组 device/footprint ID。可以确认设计已经替换旧组合，不应继续拿旧型号做外壳高度基准。

实际本批自然共面由用户确认。此只读复核未拍读实装厂家标识、未核实组装采购替代料，也未测配合公差/插深。模型可按共同 PCB datum 继续，底部高器件通过底座悬空/避让处理；支撑点落在合适安装孔或无器件支撑区，不让连接器或器件壳体充当支脚。

## 证据文件

- `connectors-review.json`：完整源路径、SHA256、接口对比、厂家资料与结论边界。
- `manufacturer-sources.json`：四份厂家 PDF 的来源 URL 与 SHA256。
- 最新保存源：上级目录 `long-current.source.jsonl` / `corner-current.source.jsonl`。
- 历史源：仓库 `PCB Files/DesignAudit-2026-09-21/{long,corner}-pcb.source`；归档部件映射与焊盘证据：`Docs/hardware/interconnect-audit-2026-09-21/evidence.json`。

如果“三种 PCB”是指长边、角落、玩家电池底板：玩家底板没有这组 6＋3 针板间接口，不属于本次刚性对插链；本次依据主线程明确范围只针对 **2 长＋1 角**。
