Ha22yX/Gridopoly/Mechanical/BoardBase/interfaces/pcb-interface-2026-10-15/reviews/layout-review/mechanical-layout-review.md

# 当前长边板／角落板机械接口独立核验

以 2026-10-15 当前只读导出的原生 PCB、Gerber 与 NPTH 钻孔为准；本次没有修改 PCB。下列支撑尺寸是夹具设计建议，不是已实物试装通过的结论。

统一坐标：PCB 顶视投影，最大板框外接矩形左上角为 (0,0)，X 向右、Y 向下，单位 mm。底面图也按此坐标显示，不进行左右镜像。用户已确认自然拼接时各 PCB 同面、共面。

| 板 | 最大外形 | 孔径 | 建议每板两颗螺丝 |
|---|---|---|---|
| long | 53.999999 × 80.000048 | NPTH Ø3.499998 | TR (46.814999, 4.191000)；BL (7.190999, 75.838853) |
| corner | 80.000000 × 80.000000 | NPTH Ø3.499998 | TL (4.000000, 4.000000)；BR (76.000000, 76.000000) |

两类板圆角名义 R4。角落板为 80×80 圆角矩形，四孔为 (4,4)、(76,4)、(76,76)、(4,76)。长边板不能用 54×80 整矩形替代：主体横向 x=3..51，侧凸范围到 x=0/54，侧凸位于 y≈27..53。完整圆弧、直线段及其端点、圆心、半径、方向见 JSON。板框尺寸按 Gerber 中心线计算，未误加 0.127/0.254 mm 绘图线宽。

长边板源圆弧角为 89.9956°，相邻段端点有最大约 0.000353 mm 差异；这是源文件亚微米差异。机械设计可用名义 R4 和 54×80 外接尺寸，精确追溯保留 JSON 原值。

安装孔的源数据是多层 FILL/CIRCLE，68.8976 mil 为半径。实际 Drill_NPTH_Through.DRL 也明确输出 Ø3.499998 mm，排除把半径误当孔径的风险。两板各四孔均为非金属化孔。

建议绝缘支撑柱接触环外径 Ø6、中心净孔 Ø3.6；固定螺丝／垫圈的实际外廓也应按该位置余量核对。所有八孔的此接触环均未越过板边，未覆盖底层铜、底层阻焊开窗内裸铜或底层钢网。优选长边 TR+BL 是为了避开 BR 附近 C202；不需要变动现有 PCB 孔。

| 板/孔 | 距裸露底铜（孔心） | Ø6 支撑与底件+0.5mm禁入框最小间隙 | 最近底件/焊脚区域 |
|---|---:|---:|---|
| long/TL | 8.165 | 4.714 | C43 |
| long/TR | 7.453 | 3.952 | C49 |
| long/BR | 4.000 | 0.501 | C202 |
| long/BL | 4.024 | 8.740 | C46 |
| corner/TL | 12.906 | 9.357 | C43 |
| corner/TR | 12.120 | 8.599 | C49 |
| corner/BR | 13.160 | 9.612 | C51 |
| corner/BL | 13.007 | 9.460 | C45 |

间隙计算使用另一个审核代理从当前库提取的底面 body 投影与焊盘合并外接框，并加 0.5 mm XY 余量；也覆盖顶面通孔器件在背面的引脚/焊接区域。该检验已通过，但库外廓仍不能替代实物焊锡堆高和插件引脚实际长度。

厚度需要区分两种证据：用户实测近似板厚 **1.6 mm**；当前 EDA 物理层厚数值相加为 **1.538351 mm**。后者仅为项目堆叠计算值，不能用它否定实测或当作已下单厚度。

底面实体需要悬空避让，不能用整片平托板压在 PCB 背面。底面审核记录用户测得整板最大突出约 8.1 mm；若 PCB 底面距台面 14 mm、底部筋顶高 3.5 mm，名义剩余净空为 2.4 mm（14−8.1−3.5）。这是设计算术余量，最终仍需打印试装、实物偏差和螺丝紧固后复核。

当前 live 与 10/15 工程备份中相同 UUID 的板框和孔记录一致。未把历史 LayoutCandidate 或不同 UUID 的备份图形当作本次已装配板的依据。三板之间的实际拼接边缝、连接器伸出与插合深度由接口审核和用户实测合并确定；本报告只提供每块板的局部机械坐标。

交付文件：`mechanical-current-geometry.json`（完整线/弧、孔、支撑验算和源 SHA256）；`long-actual-bottom-support-map.png`、`corner-actual-bottom-support-map.png`（实际 Gerber 底铜、开窗、丝印、钻孔，橙圈为建议支撑）。
