Ha22yX/Gridopoly/Docs/firmware/player-battery-arc-ui-2026-10-17.md

# 玩家屏弧形电池图标（2026-10-17）

用户要求把底部文字电量改为手机式电池图标，并稍作弯曲，贴合圆屏外圈；随后追加充电指示防抖。源码检查点为 `885d0ff7`、边界修正 `a435dc41`、显示防抖 `be04e40b`。本项接续 [COM28 电量恢复](player-battery-com28-charged-2026-10-17.md)，只修改显示，不改桥接协议、采样、充电控制、触摸或游戏状态。

> 后续实际版本：三台已继续更新[42f63258恢复版](player-battery-warm-recovery-2026-10-17.md)，COM27/28为3fc85e8a、COM29为3dee6b70。弧形UI保持不变；用户确认本轮未手动断电，三台电量自行出现、画面正常。下文1078afd0/3e7b2169及COM28刷后失败保留为本轮UI首版历史证据，不当作当前版本。

## 显示规则

| 状态 | 图标 |
| --- | --- |
| 51–100% | 绿色，内部填充随实际百分比变化 |
| 16–50% | 黄色，内部填充随实际百分比变化 |
| 0–15% | 红色填充；真实0%保持空心并显示0% |
| 电量无效或过期 | 灰色空心，内部显示 `--`，不沿用旧填充 |
| 新鲜的有效外部输入＋充电指示 | 电池内部增加闪电；不因此强制显示100% |
| 充电/供电指示异常候选 | 内部增加黄色 `!`，不把候选直接当作硬件确诊 |

电池内部保留整数百分比。充电指示不可用或未激活时不显示闪电；无闪电不等于断开外部电源。原来的 `POWER -- / EXT / NO EXT` 字样退出常驻界面，原始供电状态仍保留在采样数据与诊断中。

## 实现

- 外壳和内部填充与主圆环共用屏幕中心 `(240,240)`，整体位于底部圆环外侧，带右侧电池凸点。
- 范围为 `(196,447,96,25)`，四角均在238px安全圆内；不覆盖页面内容、按钮或手写画布。
- LVGL弧线＋小范围矢量绘制，不增加位图素材、下载或整屏缓存。小于1度的填充尾部使用凸四边形补齐，避免整数弧度造成约6%才变化一次。
- 独立顶层对象不加入焦点、不接收触摸，不重建游戏页；显示值不变时不主动失效重绘。无闪烁/呼吸动画。
- 保留现有3秒电量、350ms底层供电状态过期门槛；未知电量与真实0%分开。充电图标的短暂保留见下节。

## 充电显示防抖

底层GPIO原有约75ms去抖，仍可能将较长的瞬态传到页面。本次增加独立显示滤波，不修改原始GPIO、底层故障检测、充电电路或电池百分比：

- 正常充电/不充电和供电组合异常，须有持续 **1500ms** 的新鲜一致读数才改变图标。只有不同GPIO采样时间才能推进确认，重复绘制同一快照不算新证据。
- 正常状态候选遇到不同信号、未知状态或超过350ms采样间隙时重新计时。
- 临时GPIO未知/过期可保留原图标，但距最后有效样本**最多1000ms**，随后清除；这只是显示宽限，不将底层过期状态重新标有效。
- 桥接通信明确失效时立即清除旧充电图标。底层已经观察至少2秒、确认约2Hz节律的故障候选立即显示 `!`；恢复正常须再稳定1500ms，不把故障闪烁平滑成正常充电。
- 此功能抑制显示跳变，不证明现场供电已经稳定，也不能修复持续数秒的真实充电停止。

## 验证与部署

真实LVGL生产渲染夹具 **30项通过**，覆盖31个页面和弹窗/建房页/手写区域，保留手写笔迹、页面版本和输入焦点。21项界面检查之外新增9项时序检查：充电确认、短跳变、持续停止、旧样本重复绘制、短漏采/过期上限、明确失联、故障立即提示、稳定恢复和计时回绕。生成100/96/51/50/25/15/5/1/0%、充电和未知的像素预览，已目视检查。

初次预览发现右端凸点被对象边界裁去少量像素，已扩大横向边界并减少底部空白，重新执行21项回归通过。初次全量构建 `production-20261017-192658-3e555f490c514a5ba3f557d883e5566e` 因该修正主动取消，未烧录，不复用其产物。

第二次正常16MHz构建 `production-20261017-192806-752a151261cc4f31b0eb9385f5d1b526` 因用户追加防抖需求主动取消，未烧录。用户明确授权COM27、COM28、COM29三台一起更新；COM27/28保持16MHz，COM29保留此前验证稳定的12MHz配置，不能混刷。

### 已完成的三台部署

| 配置 | 隔离构建 | 完整应用SHA-256 |
| --- | --- | --- |
| 16MHz | `production-20261017-193549-fbfed98af28c4005a05f33c6165bd9d0` | `1078afd08481bd22d303d63c9817bea43bffd4fed91a89f5bf90dcab915f9b51` |
| 12MHz | `production-20261017-193722-3910e5381ffc4478ac92fa6a95c6b1de` | `3e7b21699c871cfebd43cbd20e1f7e035a29ea4fbe15d7adcd122bfbb3658559` |

两份构建源均为`be04e40b`，2146项冻结源与工作树一致，彼此源一致，四段哈希及分区核验通过。应用分别1,945,344/1,945,488字节，保留3MiB应用分区、core1/mode3、HWCDC、独立电量任务和原板型。相对70a910b6只有显示和显示防抖源变化，未改电池协议。COM28在19:56:15、COM27在19:58:03、COM29在19:59:40 EDT完成完整MAC保护的四段写验和hard-reset，未擦除NVS、未创建房间或注入游戏动作。

| 设备/窗口 | 实测结果 |
| --- | --- |
| COM28刷后 | 请求90秒，28.328秒时USB读取异常终止并释放；6/6完整电量组均无效。版本可读，但InspectBridge返回5/5后配置检查失败，首错1289ms，零UART超时。没有原始5字节，不能确定哪个寄存器异常。 |
| COM28重新开机后 | 30.016秒被动复查，7组中1组截断排除，6/6完整组有效；SOC92%、4109–4114mV，TO66、任务最大间隔57ms、零超时。用户说明上传后需关机重开才恢复。 |
| COM27刷后 | 90.157秒，19组中1组截断排除，18/18完整组有效；SOC91%、4085–4098mV，TO67、最大间隔57ms、零超时。 |
| COM29刷后 | 85.093秒，17/17完整组有效；SOC90%、4080–4103mV，TO67、最大间隔53ms、零超时。 |

三台均继续现有room993580118、各自席位（28=1、29=2、27=3）；这是串口窗口内的业务信息，未独立重新抓取服务器全局快照。成功窗口无捕获到的复位/恐慌标记，COM28第一次USB异常原样保留。所有采集结束均释放串口。

用户依次确认COM28“图标完整，画面正常”，COM27/29“两台图标和画面都正常”。这关闭本次弧形图标布局/当前画面验收；充电显示防抖有主机时序证据，持续真实充电状态及硬件电量精度不因此认证。上传后电量恢复单独继续见[热重启恢复](player-battery-warm-recovery-2026-10-17.md)。

本机证据：

- `C:/Users/kicof/AppData/Local/GridopolyPlayerTools-3311/battery-arc-debounce-20261017/`：防抖联合版真实LVGL夹具、PPM预览和候选核验工具。
- `C:/Users/kicof/AppData/Local/GridopolyPlayerBatteryRuntime/battery-arc-ui-debounce-20261017.log`：30项结果。
- 同目录 `battery-arc-debounce-production-20261017.log`：最终编译记录；此前两次取消的日志独立保留。
- 同目录`battery-arc-com27/28/29-20261017-flash.json`及`battery-arc-com27/28/29-20261017-COM*.log/.summary.json/.battery.json`分别保存逐台写验和观测；COM28复查为`battery-arc-com28-recheck-20261017-COM28.*`。

本次界面检查不替代实体屏幕频闪/错位观察、长期电量精度或COM28尚未闭合的手写问题。
