Ha22yX/Gridopoly/Docs/firmware/player-battery-warm-recovery-2026-10-17.md

# 玩家屏上传后电量恢复（2026-10-17）

本项接续[弧形电池及充电防抖](player-battery-arc-ui-2026-10-17.md)。用户发现刚上传固件时读不到电量，关机重开才恢复；主会话继续处理，不把三台UI验收当作电量启动问题已经修复。

## 已有现场证据

COM28写入`1078afd0…`后，SC18IM704 1.0.2版本回复正常；6组完整遥测均在InspectBridge（action16）失败，错误BridgeConfig=4、收到5/5字节、零超时。`cfg_seen=0/to_reg=00`只表示未接受配置，**不是实际读到09=00**。旧日志没有该5字节原文，无法确认异常字段。重开后6组有效SOC92%、约4.11V。COM27/29本轮刷后已有18/17组有效SOC；不能说每台每次都会复现。

## 分析与修改

确定的软件缺口：InspectBridge对02/03端口模式的前置要求过严，遇到异常保留值就回到Sync，始终无法执行已有的安全输入模式初始化。源码检查点`42f63258`修改为：

1. 保留700ms同步、版本校验和5字节配置读取。
2. 保存首次及最近Inspect原始寄存器，顺序为02、03、07、08、09；与“已通过配置”标记分开。日志从10行扩为12行，仍每5秒一次、启动后120秒结束，每行最多63字节且USB空间不足不阻塞。
3. 07必须13、08必须00、09必须66或67；不符合仍拒绝，绝不写07/08/09。
4. 02/03可以保留其他初值，进入现有`57 02 00 03 55 50`输入模式初始化；不改充电控制、不驱动CHG/PGOOD、不改电量计估算。
5. 写后仍等100ms，完整验证`00 55 13 00 原09`，之后执行原MAX17048配置/状态/复位标记验证，全部通过才公布电量。写入无效不能放行。

`fix`记录端口修复尝试次数，不冒充修复成功。首次寄存器原文保留到下次主控启动，不被重试或后续正常配置覆盖。TO66仍没有硬件SCL超时，完全失去响应的桥接或总线硬挂不一定能由此恢复。

启动UART干扰是候选原因，尚未实证：当前冻结配置为ROM日志always-on、UART0/115200，GPIO43/44恰好也是底板通信物理引脚；应用稍后才把UART1映射到它们并使用9600。应用使用USB HWCDC不能关闭更早的ROM输出。700ms静默可结束未完成命令，不能撤销已执行的寄存器修改。没有物理波形及异常原始5字节，不把这一推测写成已确定根因。[Espressif默认串口与启动日志](https://docs.espressif.com/projects/esptool/en/latest/esp32s3/advanced-topics/boot-mode-selection.html)、[NXP协议及输入模式](https://www.nxp.com/docs/en/data-sheet/SC18IM704.pdf)。

## 验证状态

- 协议回归82项通过：包括仅主控重启保留桥接、02/03分别及同时异常恢复、运行中标记丢失、恢复写不生效拒绝、07/08/09异常仍拒绝、原始证据保留、旧复位假SOC/过期/故障节律回归。
- 独立服务五场景24项＋生产调用时钟顺序1项通过，UART仍仅由core0工作任务操作，USB诊断仍在主循环锁外。
- 首轮测试81项通过、1项失败，是12行诊断的夹具观察窗口仍只留10行长度；扩到12行时长后82项通过。失败日志保留，不是实机失败。
- 16MHz/12MHz普通恢复版已完成隔离构建、候选独立核验及三台写验。用户明确确认本轮没有手动关机/断电，三台电量自行出现、画面正常；COM28另完成一次连续上传复测。逐台证据见下节。

本机证据位于`C:/Users/kicof/AppData/Local/GridopolyPlayerBatteryRuntime/`；候选复核脚本及主机测试位于`C:/Users/kicof/AppData/Local/GridopolyPlayerTools-3311/battery-warm-recovery-20261017/`。

## 最终构建和写入

| 配置 | 隔离构建 | 完整应用SHA-256 | 应用文件字节数 |
| --- | --- | --- | --- |
| 16MHz，COM27/28 | `production-20261017-200335-821f25cba59e4c9b8a49ae0c080fdb45` | `3fc85e8ad88281244123fc70e57b62966f0f6e85f458cc89a8ef4da639603725` | 1,945,696 |
| 12MHz，COM29 | `production-20261017-200345-f05369fd43a94921b3ac1b27127be23e` | `3dee6b705fd9a12bd5707b53ac6fb621438caaf2c14faddfc73a225cb45f7347` | 1,945,856 |

两份均冻结于42f63258，2146项源文件逐项核对，彼此源一致且仍与当前工作树一致。相对上一轮弧形UI固件，只改`battery_telemetry.h/.cpp`和`battery_diagnostics.h`三份生产源；四段哈希、ELF对应、3MiB应用分区、16MB布局、普通生产模式、电池板型、core1/mode3及16/12MHz分别核验通过。没有将编译内存摘要当作实际二进制文件大小。

依次对COM28、COM28复测、COM27、COM29执行完整MAC保护的四段写验和hard-reset；保留NVS，未发送游戏命令或修改房间/资产。每次刷后立即启动有界被动采集，不再发复位命令。用户确认一直未手动关机或拔掉供电，三台电量和画面正常。COM7未操作，格子固件及Pi未更新。

| 设备/窗口 | 四段写验完成（10/17 EDT） | 有界采集 | 有效电量 | 原始Inspect / 最大服务间隔 |
| --- | --- | --- | --- | --- |
| COM28首次 | 20:26:36 | 90.125秒；19组中1组截断排除，18/18完整组有效 | 89%，4068–4090mV | `00 55 13 00 66` / 54ms |
| COM28连续再上传 | 20:28:37 | 60.140秒；13组完整，首组boot1506ms仍初始化且无错误，其后12组有效 | 88–89%，4084–4101mV | `00 55 13 00 66` / 57ms |
| COM27 | 20:29:34 | 90.156秒；19组中1组截断排除，18/18完整组有效 | 88%，4059–4081mV | `00 55 13 00 67` / 57ms |
| COM29 | 20:30:09 | 90.078秒；19组中1组截断排除，18/18完整组有效 | 87%，4065–4076mV | `00 55 13 00 66` / 56ms |

四个窗口均零UART超时、无捕获到的复位/panic标记、无串口异常，结束后全部关闭串口。MAX版本0012、I²C F0、单位/新鲜度/配置标记核验通过；无效初始化样本不当作0%或有效电量。COM29本次TO读回66，而上一轮UI版窗口为67；本轮仍只读取07/08/09，没有人为写回67。原始首次值与最近Inspect一致、修复尝试计数0。各屏恢复原room993580118及原席位，正常快照同步不等于主动注入游戏动作或重新认证服务器全局状态。

逐台证据前缀为`battery-warm-com28-20261017`、`battery-warm-com28-repeat-20261017`、`battery-warm-com27-20261017`、`battery-warm-com29-20261017`；各自`-flash.json`记录写验，`-COMxx.log/.jsonl/.summary.json/.battery.json`记录12行遥测、实际时长和端口释放。时间字段以字符串中的实际时区偏移为准，上表统一为EDT；对应UTC为次日00时。

**结论边界：** 本轮三台上传后无需手动断电即可读到电量，COM28连续两次通过。所有Inspect原始端口值都已是正常`00/55`，`fix=0`，因此实机没有触发“异常02/03被修回”的分支；该分支有主机回归，尚无故障现场恢复证据。此前配置失败缺少原始5字节，仍不能唯一归因UART启动干扰，也不宣称彻底排除所有偶发上传失败。完全失联或07/08/09异常仍不能保证纯软件恢复；若复现，新日志可保留原始证据。
