Ha22yX/Gridopoly/Docs/firmware/player-battery-bridge-compat-2026-10-17.md

# 玩家电量桥接兼容修改（2026-10-17）

> 10/17晚实机追加：COM28已安装含本项源码的70a910b6（16MHz），四段写验通过。刷后原无响应状态持续；用户同时断开USB和电池后，电量恢复显示，新启动连续有效SOC为96%、约4.14V。姓名页面和手写尚未现场验收，COM27/29未升级。见[最新COM28现场](player-battery-com28-charged-2026-10-17.md)。下文早期“未部署”仅对应当时阶段；不将本次电量恢复外推为手写修复或长期稳定性验收。

状态：兼容源码检查点`1cfc7f8b8ecfe346893ce183c4e46f8995962060`；主机回归通过，联合触摸诊断候选已构建并独立核验，等待实机对照。用户让COM27/28/29充电并要求先做理论验证；本阶段没有串口、复位或烧录。当前COM27/28仍首版8ef6c051（16MHz），COM29仍二版df9f1282（12MHz），不能把本修改算作已部署。

## 依据和问题范围

COM29二版在首次组读到SC18IM704 1.0.2后失去应答，120秒内零有效SOC；独立采样最大服务间隔54ms，后续最近失败不断覆盖首次失败，不能确定最早失败指令。详见[现场记录](player-build-battery-rollout-2026-10-16.md)。

[NXP官方支持](https://community.nxp.com/t5/Other-NXP-Products/SC18IM704-internal-register-7-8-and-9-write-freezes-chip-access/m-p/1579139)确认部分批次写内部07/08/09后会冻结，甚至写相同值也可能触发；版本字符串不足以判定批次。当前首/二版恰好写这些寄存器，符合现象，是强候选原因；尚未做同一块板的避写对照，不能认定已实证根因。

## 最新协议

1. 保留9600/8N1、700ms空闲同步、结构校验的16字节VP版本。
2. 新增动作InspectBridge（编号16，旧动作编号不变），只读`52 02 03 07 08 09 50`。02接受55/00，03须55，07/08须13/00，09须66/67。其它值拒绝，不通过写时钟/超时“修复”。
3. 唯一内部配置写为`57 02 00 03 55 50`，随后严格读回5字节。00和01均为输入模式，GPIO0/1不驱动CHG/PGOOD，GPIO6及外部启动上拉保持。[NXP手册Table5/6](https://www.nxp.com/docs/en/data-sheet/SC18IM704.pdf)
4. 电压/SOC发布前读02，须收到完整1字节00；GPIO读`52 04 02 50`，第二字节须00。桥接复位后02回55，启动OK或默认I2CStat=F0不能冒充有效电量；真实SOC4F4B仍可接受。
5. 不写07/08/09，包括重试路径。MAX MODE清零/按需清CONFIG.SLEEP及I2CStat检查保持，不Quick-Start/POR、不改RCOMP/HIBRT/充电电流。默认约99kHz在MAX允许范围。[MAX17048手册](https://www.analog.com/media/en/technical-documentation/data-sheets/MAX17048-MAX17049.pdf)

默认TO66的TE=0意味着**没有硬件SCL超时**。若先前为67则保留，不主动启用。180ms软件期限和700ms静默只保证应用不无限等UART、可以恢复不完整UART指令；不能恢复所有I²C硬挂。底板U9 RESET为独立RC，没有MCU可控复位，故卡死可能需要屏幕供电重启。兼容修改有这项明确限制，不声称等价于硬件超时保护。

## 日志及采样边界

保留二版独立UART所有者任务、完整快照、新鲜度和资源失败处理。GP_BAT开机120秒窗口、每5秒一组、每行最多63字节、整行可写才发送；最新一组10行，前8行保持，新增：

- `cfg_seen / to_reg / hw_to / at`：最近一次初始化读回、硬件超时位与配置完成时刻；是缓存证据，失联后不能当实时状态。
- `first=动作/操作 e=错误 rx=实收/应收 at=时刻`：首次协议失败锁存；后续VP超时和恢复不覆盖，原最近失败字段继续更新。首次失败为空时动作为255、错误为0。

日志退出不停止电量采样。无效/过期只显示未知，未新增假百分比或用CHG反推满电。单独电压相近不能证明SOC模型精度。

## 软件验证

- 75项协议/日志回归通过。包含有写冻结行为的字节设备模型：旧指令正对照确实冻结，新路径在TO66/67及重试均无07/08/09写；异常端口/钟速/TO在任何配置写之前拒绝；复位OK不冒充SOC/GPIO，短包、超时、真实0%及计时回绕仍有效覆盖。
- 默认关闭与启用的实际adapter线程模拟24项、实际render快照取时顺序1项通过。UART始终由worker拥有、USB始终主循环锁外，主循环停顿不停止采样；任务/UART/缓冲失败明确不可用。
- 首次运行74通过/1失败：新增前置读取改变了多余版本字节的拒绝阶段，旧测试只接受Framing；实际在精确配置核验处拒绝BridgeConfig，未发布样本。修正断言验证两种合法拒绝方式及link/sample无效，后续75全通过。原日志保留，未放宽生产协议。
- PCB会话只读复核实际网表和源码，未发现CHG/PGOOD驱动、GPIO6上拉或旧09标记遗漏；其审阅不替代实物验证。

证据目录：`C:/Users/kicof/AppData/Local/GridopolyPlayerBatteryRuntime/compat-20261017/`，含修改前备份、首次和最终测试日志、主机产物。没有上传凭据、原厂Flash或串口原始私有状态。

## 下一步与负责方

玩家屏会话已完成默认关闭、30秒截止的TOUCH TRACE，25项诊断及116项真实输入/手写回归通过；已冻结并完成一份16MHz、显式电量板型的联合生产候选，主会话独立核对通过。该候选用于充电后的COM28定位，COM29继续保留12MHz，不能给它刷16MHz。源、构建、安装和用户目视分别记录。

实机恢复后由主会话核对完整MAC，再按新的用户可用时间安排同板避写初始化、有效电量、触摸原始/变换/画布坐标及采样/绘制时延。当前COM28根因仍未证实，不把低电量或USB干扰当定论，不用任意断笔阈值掩盖漏采。

## 联合候选产物（未部署）

源码检查点：电量兼容`1cfc7f8b`，触摸诊断`3d2b7aed50ac98f2824b857c6cac3c6d461973a6`。构建基准如实保留冻结时的1cfc7f8b，不因后续提交重写。run为`production-20261017-000905-3a4cc098d95742088b3657364bdadf1c`，本机ToolRoot为`C:/Users/kicof/AppData/Local/GridopolyPlayerTools-3311/`。

- 应用SHA-256：`916171342beaa77ff4785dda6fe24a96ecf6fbb04575cc7688be890a0145bc67`，实际bin为1939728字节；Arduino程序占用1939586字节，低于3MiB app0。
- candidate SHA-256：`0fd0e1ffe4153b04700e51769a0f27a896ad393d78c79eb27aa9de30a27ea10a`。
- source manifest SHA-256：`274717c4fcfcba1d64899602ed14d4cb27f9ecded4427867f373815b1e847d64`；2145项冻结和当前源逐项相同，相对二版只有预期11个生产输入变化。
- ELF SHA-256：`02ad014df5b4b9d8b0ccdd4189f307c36a4265081ec49197f75570039c911a2a`，与应用内嵌SHA一致。
- 正常Wi-Fi生产模式，vendor16MHz、BatteryBoard=viewe-md80et-v10、DisplayDiagnostic=none，core1/mode3与40行bounce保持；四段0/8000/E000/10000哈希通过，非应用段与二版相同，分区不重叠且在16MiB Flash内。

主会话独立证据为`compat-20261017/candidate-verification-root.json`及同名log。没有使用旧对象绕过冻结检查，也没有启动设备刷写。这份16MHz候选只能用于对应的16MHz设备，不能替换COM29所需12MHz配置。当前仍待充电后COM28触摸及避写初始化实测，未标正式发布。
