Ha22yX/Gridopoly/Docs/firmware/player-battery-com28-charged-2026-10-17.md

# COM28 充电后电量不可用：实机排查（2026-10-17）

状态：用户报告已充满并接回电脑，COM28 已恢复现场排查；本次只操作 COM28。已安装兼容候选 `70a910b6…`，**同时断开USB和电池后电量已恢复，用户确认显示**。COM27/29 没有重新接入或升级，仍沿用原部署。时间为 2026-10-17 EDT，原始证据使用 UTC。

## 现场与升级

- 唯一 ESP32 USB 是 COM28，完整 MAC `dc:b4:d9:07:81:b0`；正常联网 `10.42.0.54`，room993580117、self1，Tag 配对状态保留。未注入游戏操作。
- 19:11:40 EDT 起，旧版无复位采集 25.047 秒。收到 5 组中的 4 组完整旧五行日志，均无有效电量；`link=0 / mv_ok=0 / io_ok=0 / e=Timeout`。缓存曾读到 SC18IM704 1.0.2，但没有有效 MAX 电压/SOC。这不是读取到 0V 或 0%。
- 首次升级尝试因本机 Python 未加载既有 esptool 包而在建立串口前退出，没有写入。改用已有 GridopolyReleaseTools/python-packages 的固定 esptool 5.3.1 重试，未安装或替换依赖。
- 19:13:08–19:13:26 EDT，MAC/16MiB/原分区检查、四段写入与读回校验成功，保留 NVS，完成一次明确的 ESP32 hard-reset；**没有给供电底板断电**。
- 已装应用完整 SHA-256：`70a910b6c927616c9c65cc5c2b76f8307c98ef94006d57e2941900f21d024071`。来源及四段清单见[等待页候选](player-ready-names-2026-10-17.md)。保持16MHz、core1/mode3、电量板型开启，含避写SC18寄存器、独立采样、默认关闭的手写诊断及等待页名字修复。

## 刷后真实结果

19:13:27 EDT 起采集120.109秒，24组十行均完整，**0组有效电量**。最大采样任务服务间隔55ms，累计131次超时。首次失败锁存为BridgeVersion/Read、`rx=0/16`，boot1393ms；后续同样没有版本应答，`cfg_seen=0 / i_seen=0`。这次初始化尚未进入配置或电量计读数阶段，寄存器00等初值不能当真实读回。

采集窗口内正常联网，无panic、brownout或重启标记；有界采集已经结束并关闭串口。不能把写验通过当电量、姓名显示或手写已实机验收。

## 断电对照与恢复结果

用户先报告按POWER关开后仍不显示。19:16:56 EDT（23:16:56 UTC）起45.015秒被动记录，程序uptime仍为210386～250397ms，与19:13启动连续，未观察到重新计时；没有GP_BAT是因为已超过开机120秒日志窗口，不能当作新的桥接失败记录，也不能把这一步当已证明电路完全断电。

随后用户同时拔下USB和电池，等待10秒后重新接入，明确反馈“电量出现”。23:19:54 UTC起记录捕获到新启动11.574秒后的电量日志，配置完成时刻为boot1378ms。20组中第3组只有5行（启动素材日志期间诊断输出不全），不计完整样本；第4～22组共**19组完整有效电量**，覆盖boot16.575～106.607秒：

- 实读SOC **96%**，电压 **4.131～4.145V**；原始VCELL/SOC换算一致，样本与GPIO新鲜度均满足上限。
- SC18IM704版本1.0.2、MAX版本0012；`link=1 / mv_ok=1 / io_ok=1 / e=0 / i=F0`。
- 采样任务最大服务间隔56ms，累计超时0，首次错误为空；`cfg_seen=1 / to_reg=66 / hw_to=0`。
- 正常联网、原room993580117/self1保持；未注入游戏操作。电量计比例是有效读数，不是容量精度标定或充满认证。

恢复确认后主会话主动Ctrl-C结束采集，进程退出码1，原watcher最终events文件未写出，原始jsonl/log完整保留并另存收尾说明；没有把它写成正常到时退出。随后6.031秒无复位重新打开/关闭COM28成功，`closed=true`、无异常，uptime130～135秒连续，确认串口已释放且设备继续运行。当前不再需要重复拔电池。

## 结论与边界

本次已确认**旧状态下电量通信无回应，兼容固件加真正断电后恢复有效读数及显示**，不能把之前的“--”解释成电池没电。旧固件写07/08/09、[NXP已确认的写入冻结问题](https://community.nxp.com/t5/Other-NXP-Products/SC18IM704-internal-register-7-8-and-9-write-freezes-chip-access/m-p/1579139)、本次同板恢复互相吻合，支持该兼容方案；没有故意重刷旧版复现冻结，也没有测量掉电波形，故不宣称唯一芯片级根因已排他证明。

新版本不再写这些寄存器，保留输入配置标记、完整事务检查和失败显示未知。实读TO66表示硬件SCL超时未启用；主机超时不能保证自行恢复所有硬挂，当前PCB没有MCU可控U9复位，限制继续保留。未改充电电流、SOC模型、Quick-Start/POR或游戏状态。COM27/29未升级；COM28手写与姓名页面仍是独立待验项。

## 证据

本机 `C:/Users/kicof/AppData/Local/GridopolyPlayerBatteryRuntime/`：

- `charged-com28-before-20261017-COM28.*`：旧版25秒无复位日志与分析。
- `charged-com28-compat-20261017-flash.json`：首次本机依赖缺失，设备未写。
- `charged-com28-compat-20261017-attempt2-flash.json`：实际写验成功及复位记录。
- `charged-com28-after-20261017-COM28.*`：新版本120秒失败日志、闭合句柄记录和分析。
- `charged-com28-powercycle-20261017-COM28.*`：首次POWER操作后45秒记录，uptime未归零。
- `charged-com28-fullpower-20261017-191954.*`：双路断电后恢复日志、19组完整有效样本与主动停止说明。
- `charged-com28-release-20261017-COM28.*`：重新打开/关闭串口与无复位存活检查。

负责方：主会话继续实机恢复与部署台账；玩家屏会话暂停串口争用。COM28手写问题另保留，不因本次安装诊断版而标修复。
