Ha22yX/Gridopoly/Docs/firmware/player-handwriting-com28-2026-10-16.md

# COM28 姓名手写卡顿、连笔与位置异常排查（2026-10-16）

> 10/17晚实机追加：COM28已安装含本项源码的70a910b6（16MHz），四段写验通过。刷后原无响应状态持续；用户同时断开USB和电池后，电量恢复显示，新启动连续有效SOC为96%、约4.14V。姓名页面和手写尚未现场验收，COM27/29未升级。见[最新COM28现场](player-battery-com28-charged-2026-10-17.md)。下文早期“未部署”仅对应当时阶段；不将本次电量恢复外推为手写修复或长期稳定性验收。

当前任务：用户反馈 COM27、COM29 在游戏开始的手写板正常，COM28 卡顿、不顺畅、连笔，墨迹位置与实际触摸不符。用户要求并行分析和实际修复。主会话负责设备、串口、页面和对局；玩家屏会话已完成源码/日志分析，并按主会话安排实现最小运行时诊断；正常联合候选已构建并核验，实机采集尚未开始。本文是进行中的专项报告，不能把分析完成当作故障修复完成。

## 当前基线与职责

- COM27 与 COM28 在用户报告时运行同一 16MHz v1 应用 `8ef6c051d1cb8422350db9659ceb715917d9bdfe456cfe10fcb1c9ce213aa6b5`。同程序但仅一台异常，使运行状态/负载、触摸硬件或面板差异都仍是候选，不能直接判定其一。
- 已交付电量 v2 保持冻结：源码提交 `bb7281c8d98cd987e10f7d9dda90ecc617f57c58`，16MHz `1344a9d1…`、12MHz `df9f1282…`；输入/手写路径相对 v1 未改。COM29 已由主会话写入 12MHz v2，但电量实测失败；COM27/28 仍为 v1。目前三台均由用户充电，暂停串口、复位与刷机。本专项没有操作设备、房间或任何实机输入。
- 原理图与 PCB 由 PCB 设计会话负责。本专项不改已完成的 battery 报告、既有构建目录或候选清单；后续代码变更必须重新冻结。
- 本机只读分析证据目录：`C:/Users/kicof/AppData/Local/GridopolyPlayerTools-3311/handwriting-com28-20261016/`。

## 已核实的输入与绘制路径

1. `lvgl_v8_port.cpp` 的 `touchpad_read` 由 LVGL 输入定时器调用，设定周期为 10ms，实际周期受同一个 LVGL task、全局递归锁、绘制和帧完成等待影响。这里直接执行 `Touch::readPoints(&point, 1, 0)`，无独立触摸采样任务或触摸点队列。
2. 当前冻结外部库为 ESP32_Display_Panel 1.0.3；板配置使用 CST820 驱动、I2C0、400kHz、SCL15/SDA16；触摸 INT/RST 均为 -1。`readPoints` 的 timeout=0 只控制中断等待，随后仍同步调用 I2C 读取，不等同于整个读取无耗时。
3. `TouchInputState` 接受 0 为真实释放、正数且坐标在 0..479 为有效接触。负值/越界返回不可用：LVGL 控件按下状态最多保留 100ms；手写路径会立即调用 `uiHandwritingTouchUnavailable`，断开墨迹接触并阻止据此触发识别。
4. 有效点直接到 `uiHandwritingRecordTouch`，画布局部坐标为屏幕坐标减去实际对象左上角。设计矩形为 `{78,112,324,220}`，`pointInsideCanvas` 用 `lv_obj_get_coords` 的实际位置，未采用每台设备不同的校准值。板初始 swap/mirror 均 0，固件 rotation 为 0。
5. 当前接触保持时，`uiHandwritingSamplesShouldConnect(bool, …)` 有意不按时间差断笔。源码回归明确要求 140ms 调度间隔内持续接触仍连线；真实释放、离开画布或不可用读数会断笔。如果一次真实抬手再落笔完全发生在两次读取之间，软件只见两个 pressed 点，会连接。这是确定的观测能力限制，尚未证明 COM28 的现场就是该机制，不能凭此加任意时间断笔阈值。
6. 墨迹记录上限 1024 点；16ms 批量 flush 到 canvas，绘制与采样都在 LVGL 锁保护下。`drawnPointCount` 与 `pointCount` 区分待绘点，画线使 canvas 失效；真实显示还需后续 LVGL 绘制和帧交换。当前日志没有采样到绘制或到实际显示的时延。
7. 主循环中的 `touchQueue` 是 DELETE/DONE 等按钮动作队列，不是轨迹点队列。手写同页更新保留 canvas，不因普通网络 revision 重建。抬手满 1200ms 后尝试异步识别；识别 task 创建失败时存在同步识别回退，这会在主循环持有 LVGL 锁时运行。是否在 COM28 实际发生尚无日志。

## 已有日志能证明什么

`existing-log-analysis.json` 记录四份现有日志的路径、SHA 和提取结果：

- v1 COM28 启动下载期曾 free heap=5652、largest=1140；COM27 同期样本为 15336/7668。COM28 后期恢复约 16176/7668，COM27 后期也约 16188/7668。可能存在启动资源差异，但没有识别 task 分配失败或同步识别耗时证据，不能直接归因低内存。
- 主会话新采集 `handwriting-before-v2-COM28.log` 共 45.094 秒、234 行、90 条缺字警告；无已记录的 I2C 读失败、无触摸 action。警告是默认名字“诺瓦”缺字，属于已知字体限制，本专项不扩字体范围。没有原始坐标或采样时标，也没有确认这一窗口正在复现手写动作，不能把安静日志当手写验收。
- 三台初始化都报 `IC id: 0`，不是 COM28 独有证据；当前驱动只打印 ID，没有因此失败。不能据此断言芯片型号错误。
- UART1 电量 RX44/TX43 与触摸 I2C15/16 分开，已查板配置 RGB/背光/旋钮没有直接复用这两脚；电量初始化在板、LVGL、旋钮初始化之后。没有发现直接引脚/总线冲突。COM29 新电量首失效与热复位分析由主会话/PCB 会话负责，不能用电量调度修复推断触摸已修复。

## 现场旧固件诊断能力与不足

现场 v1/v2 固件可用命令为 `INPUT TRACE ON\n`、`INPUT TRACE OFF\n`，ON 自动 90 秒停止。`serviceInputTrace` 输出的是旋钮 AB 相位、按键/应用输入事件；常规 `GRIDOPOLY_TOUCH` 只打印按钮 action。这些都不包含触摸读返回值、原始坐标、采样间隔或墨迹时延，不能满足本次定位，不建议为此开启无关的 INPUT TRACE。

`TOUCH TRACE` 已在下述新候选实现；现场旧固件不支持，不能向现设备发送后声称已生效。

## 最小诊断实现（2026-10-17，候选通过构建，实机窗口暂停）

实现可开关的 `TOUCH TRACE ON/OFF`，默认关闭、开启后 30 秒自动停止，保留正常功能，不加第二次 I2C 读取：

- 在现有 `readPoints` 前后取单调时钟，记录 sequence、callback gap、read duration、return count/error、变换前 raw x/y 与返回 screen x/y。
- 原始坐标可通过已有 `esp_lcd_touch_config_t.process_coordinates` 回调取得。冻结库在 get_xy 后、mirror/swap 前调用它；零触点不会调用，必须单独记录 release/无 raw，不沿用上一点。保留原回调语义。这里的 raw 是驱动解码后的变换前坐标，不是完整 15 字节寄存器帧；当前驱动丢弃的事件位和原始 count 不冒称已采集。
- 手写 owner 同时记录 canvas 实际原点/局部坐标、画布接触/界面按下/最新存储点连线状态、点数及待绘点数、最老待绘点 age、实际 draw duration/最大延迟；包含识别 task 是否存在、同步回退次数/耗时。无触摸点队列，不能把诊断日志队列时延说成输入排队。
- 回调只写固定小环形缓冲，主机实测核心状态 568 字节、输出状态 136 字节（合计 704 字节，含 8×64 字节记录环）；另有少量 UI 指标、坐标回调与同步状态，目标机实际占用见后文 ELF 核对；溢出计数显式记录，绝不阻塞输入。USB 主循环在 LVGL 锁外输出完整短行（每行 <=63 字节、检查完整容量），限制每轮输出，带 seq 便于发现缺行；每秒摘要及结束摘要保留采样失败、gap、延迟与 drop 计数。关闭时只保留轻量开关判断。
- 已覆盖的主机测试包括：关闭零输出、开启/自动截止与 millis 回绕、全/短 TX 不阻塞、环形缓冲溢出显式计数、raw 缺失与 0/release/-1 区分、同 seq 字段一致、采样/断笔行为等价。不得把诊断强行变成独立触摸线程、修改触摸阈值或直接校准 COM28。

充电暂停解除且主会话协调正常候选部署后，才安排 COM28 一次约 20–30 秒、COM27 一次同样动作对照：画布内部五个位置缓慢点按/停留/抬手，随后分别横线、竖线，最后两笔之间明确抬手并停约半秒。记录预期位置与可见墨迹；使用当前页且由用户正常操作，不注入姓名或点击 DONE。

判断顺序：raw 自身跳动/不随手指或 release 不到 -> 控制器/链路分支；raw 正常但 screen/local 映射错误 -> 坐标分支；回调 gap/I2C 耗时大并漏 release -> 采样调度/通信分支；点序列正确但 draw backlog/耗时大 -> 绘制分支。原始点正常但用户仍见延迟时还需帧呈现证据，单凭 draw 完成不能证明屏幕已经显示。

目前没有唯一确定的 COM28 根因。新源码只加入诊断，不修改触摸阈值、坐标转换、连笔判定或识别算法。主会话同时完成 SC18 兼容修改，联合候选保持正常 16MHz 显示配置；旧 v1/v2 归档不改。玩家屏会话负责实现、构建、回归与证据交接，主会话负责充电后的部署窗口、实机复现和最终验收。

## 运行时使用和字段含义

仅在后续主会话协调的实机窗口使用，当前不发送命令。向已部署新候选的 USB 控制台发送 `TOUCH TRACE ON\n`；必须收到 `GP_TOUCH READY sid=… ms=… window=30000` 后才开始复现。提前结束用 `TOUCH TRACE OFF\n`。`GP_TOUCH END sid=… why=… ms=…` 中 why=1 为主动停止，why=2 为 30 秒自动截止。所有时间以设备启动为基准，不是墙钟时间。

每个样本最多六行，按同一 `id` 关联；READY/END 的 sid 划定会话。缺行或跳号不能补成观测到的触摸事件：

```text
GP_T id=… ms=… dt=… rd=… r=…
GP_T id=… raw=…,… scr=…,… f=…
GP_T id=… loc=…,… org=…,…
GP_T id=… g=… n=… d=… age=…
GP_T id=… du=… lag=… rec=… fb=…
GP_T id=… da=… fu=…
```

| 字段 | 含义与限制 |
| --- | --- |
| ms / dt / rd / r | 读取结束观测时刻 ms、回调起点间隔 μs、现有 readPoints API 耗时 μs、返回值。rd 包含驱动/库开销，不是纯 I2C 线上的传输时间；ms 不是触摸控制器硬件时间戳。 |
| raw / scr | 变换前驱动解码坐标、API 返回的屏幕坐标。raw 是否存在看 f 的 bit0；释放/错误时 scr 可为保留的上一坐标，不能当新接触点。未读取完整控制器寄存器帧或驱动丢弃的事件位。 |
| loc / org | scr 减当前画布实际原点、实际画布原点。只有有效画布内接触时 loc 才表示有效墨迹位置。 |
| g / n / d / age | 当前 capture generation、存储点数、已绘点数、最老待绘点的年龄 ms。age 不是诊断输出队列延迟。 |
| du / lag / da | 最近一次完成的 canvas flush 耗时 μs、该 flush 中最老待绘点直到完成的延迟 ms、完成时刻 ms。它们是缓存指标，并不表示每次采样都画了一次；用 da 区分新旧。canvas 绘制结束不等于 LCD 已可见。 |
| rec / fb / fu | 识别 task 是否存在、该诊断会话内同步识别回退次数、最近一次回退耗时 μs。fb 为饱和 uint16 计数；未实测 COM28 是否发生回退。 |

`f` 为位掩码：1=raw 存在；2=有效控制器样本（含有效释放）；4=LVGL 界面仍为 pressed；8=画布存在；16=画布接触有效；32=**最新已存储墨迹点**连接前一点（不表示本次回调必然新增点）；64=正返回值但坐标越界。读取不可用时 f 的 pressed 位可能因既有 100ms 保持仍为 1，同时墨迹接触已断开，不应误读为固件继续写入坏点。

摘要约每秒输出，也在正常退出前输出最终统计：

```text
GP_TS t=… n=… d=… tx=…
GP_TS e=… u=… g=… r=…
GP_TS du=… lag=…
```

t=设备时刻 ms；n=捕获样本数；d=诊断环形缓冲满时丢弃的记录数；tx=输出样本过期或意外短写次数；e=无效样本数；u=返回零触点的**样本数，不是实际抬手次数**；g/r=最大回调间隔/API 读取耗时 μs；du/lag=最大 canvas 绘制耗时 μs/待绘延迟 ms。即使环满，摘要仍统计所有捕获样本。

## 开销、并发和数据完整性边界

- `readPoints` 仍只调用一次；通过已有坐标处理回调旁观变换前坐标，并转调原回调。新增诊断不分配堆、不建立任务。
- LVGL owner 只填记录和短临界区拷贝；主循环在 LVGL 锁外输出，每轮最多四个完整短行。每行不超过 63 字节，完整容量不足不开始写。
- USB 意外短写只计数并推进，不拼接重试剩余字节；日志仍可能缺行。已取出但未完成输出的记录超过 250ms 丢弃；停止后最多保留 2 秒输出窗口。USB 不通时可能收不到 END，不能把其缺失解读为输入持续采集。
- 8 条环形缓冲有意限制静态内存，繁忙时可丢诊断记录；这不等于实际触摸点被丢弃，亦不能将缺失的 release 直接证明为控制器未上报。对照应优先检查 d/tx、完整记录和摘要。
- 默认关闭及完成后不会进行诊断队列拷贝/锁操作/USB 输出。仍保留静态内存和轻量开关、回调转发开销，不声称 CPU 或 RAM 绝对零开销。开启后的额外计时与输出也可能扰动调度，实机对照需保留未开启时的用户观察。
- 初次主机测试发现旧回调可能使用旧时刻使新会话提前过期；已修正为先校验 session，再判定超时，并覆盖时钟回绕/跨会话时刻。初次失败保留在 trace-tests.log，最终结果见下表。

## 主机验证与构建状态

| 验证 | 当前结果 | 证据 |
| --- | --- | --- |
| touch_trace 核心与实际适配器 | 25 PASS / 0 FAIL，包含并发生产者、USB 锁外输出、关闭、容量不足/短写、环满、30 秒截止、回绕、跨会话保护 | trace-tests-final.log；命令 tools/test-touch-trace.ps1 |
| 真实输入/手写源码运行时回归 | 116 PASS / 0 FAIL；新增 7 项覆盖画布实际原点、pending age、flush 完成时标、释放断笔、开关保持墨迹/generation、不可用输入边界和同步识别回退 | runtime.log；命令 tools/test-input-runtime.ps1 |
| SC18 兼容路径 | 主会话报告 75 项电量测试、24 项适配器与 1 项渲染调用顺序通过；PCB 会话静态复核未发现具体缺陷 | 本专项未重复执行；详见 player-battery-bridge-compat-2026-10-17.md |
| ESP32 正常联合候选 | 构建退出 0；2145 项冻结源、当前源、四个刷写段、分区和 ELF 内嵌 SHA 全部一致 | 下述 run、build-vendor.log、candidate-verification.json |
| COM28 根因与修复实测 | 未完成；三台充电，暂停全部设备操作 | 不以主机 PASS、编译成功或旧日志替代 |

冻结 run：`C:/Users/kicof/AppData/Local/GridopolyPlayerTools-3311/runs/production-20261017-000905-3a4cc098d95742088b3657364bdadf1c/`。
`inputs.json` 的真实基线为 `1cfc7f8b8ecfe346893ce183c4e46f8995962060`，包含主会话 SC18 兼容检查点及本专项冻结时尚未提交的触摸诊断源码；最终产物以 candidate-sources.json 的逐文件 SHA 为准，不把工作区后续提交回填为构建基线。

配置：production、vendor 16MHz、viewe-md80et-v10、displayDiagnostic=none、Arduino core 3.3.11、正常 HWCDC/16MiB Flash/3MiB APP/OPI PSRAM、显示 core1/mode3。没有启动第二个 12MHz 构建，没有刷写任何设备；已核对全部冻结源、四个刷写段、ELF 内嵌哈希和静态 RAM 增量。

## 最终候选与交接

源码检查点：触摸诊断 `3d2b7aed`；电量兼容 `1cfc7f8b`。构建冻结基线仍为上述 `1cfc7f8b8ecfe346893ce183c4e46f8995962060`，其逐文件清单包含随后提交的触摸代码。未修改原候选清单追填提交。

- 候选清单：`C:\Users\kicof\AppData\Local\GridopolyPlayerTools-3311\runs\production-20261017-000905-3a4cc098d95742088b3657364bdadf1c\candidate.json`；SHA-256 `0fd0e1ffe4153b04700e51769a0f27a896ad393d78c79eb27aa9de30a27ea10a`。
- 冻结源码清单 SHA-256：`274717c4fcfcba1d64899602ed14d4cb27f9ecded4427867f373815b1e847d64`，共 2145 项；快照与检查时工作区源文件逐项相同。
- 应用：1939728 字节，SHA-256 `916171342beaa77ff4785dda6fe24a96ecf6fbb04575cc7688be890a0145bc67`。
- ELF SHA-256：`02ad014df5b4b9d8b0ccdd4189f307c36a4265081ec49197f75570039c911a2a`，与应用描述符中的完整 ELF SHA 一致。
- 正常固件标记、16MHz、电量底板开关、core1/mode3、HWCDC 和独立电量任务均已核对；不含 SelfTest 或显示诊断配置。
- 四个刷写段逐一重算 SHA；非应用三段与此前正常固件相同。应用装入 3MiB app 分区；各分区无重叠且均处于 16MiB Flash 内。

| 偏移 | 文件 | 字节 | SHA-256 |
| --- | --- | --- | --- |
| `0x0` | `PlayerConsole.ino.bootloader.bin` | 19968 | `31b3c1be45dc5a76aa85c82540d6787b675e711eaf11021a5eea7e36f469c6de` |
| `0x8000` | `PlayerConsole.ino.partitions.bin` | 3072 | `ace02503447d0f470692e65fa76002f2d77a92dc81cd3813d8aa66718d716da9` |
| `0xE000` | `boot_app0.bin` | 8192 | `f94c5d786a7a8fab06ac5d10e33bf37711a6697636dc037559ea19cc410a17f0` |
| `0x10000` | `PlayerConsole.ino.bin` | 1939728 | `916171342beaa77ff4785dda6fe24a96ecf6fbb04575cc7688be890a0145bc67` |

目标机 ELF 的静态内部 RAM 核算（`.dram0.data + .dram0.bss + .noinit`）：

- 旧 v2 16MHz：125560 字节；本联合候选：126368 字节；**合计增加 808 字节**。这一总增量同时包含电量兼容状态和触摸诊断，不能全算作触摸。
- 识别出的触摸诊断状态符号合计 749 字节，其中核心环/统计为 568 字节、输出状态为 136 字节；完整符号和各段增量见 `memory-verification.json`。
- 这是链接期静态内存，不是 COM28 运行时 free heap、最大连续堆块或 task 栈余量；没有设备数据，不能保证低内存工况的手感或识别任务分配。

归属清单 `handoff-files.json` 包含本专项 12 个源码/测试文件及此报告；电量源码和 README 归主会话。`host-test-summary.json` 保存最终测试计数和日志 SHA。所有本机证据位于开头目录；构建产物/缓存不进入 Git。

本轮交付的是已构建的诊断与兼容候选，**未部署、未证明 COM28 根因、未验收实际修复**。COM27/28 仍运行 `8ef6c051…`，COM29 仍运行 `df9f1282…`。主会话负责在用户充电结束并协调设备窗口后核对完整 MAC、安排候选验证及手写对照；玩家屏会话接收证据后继续针对已证实的分支修复。PCB 审查继续由 PCB 设计会话负责。
