Ha22yX/Gridopoly/Docs/firmware/development-roadmap-2026-09-21.md

# 软件、固件与实体验收路线图

更新：2026-10-15晚间。文件名为兼容旧链接保留；本页是当前待办。[当前交接](../CURRENT-DEVELOPMENT-HANDOFF.md)汇总实际版本，[设备台账](current-device-connections.md)提供带时间状态，历史记录不自动覆盖本页。

## 已闭合的阶段

- 计划12长边＋4角落均已分批部署normal V0.34，COM12拔线中断后完整恢复；13板灯效有独立用户确认。
- 用户24V已给16板供电，线圈略抬LCD后16板Tag识别获确认；服务器16 reader stable。
- USB AWUS036ACM热点已部署，20台同时关联/注册已有证据；四服务开机启动、USB重新枚举及Pi软件重启恢复通过，7台关联阻塞已解除。
- 真实16节点唯一ORDER环ready，0～15自动分配、corner0/4/8/12通过；四尺寸16/24/32/40仍分别区分软件回归与实物验收。
- 输入批处理/焦点刷新、手写、等待页修复已有实现与部署；COM27/28等待页正常，COM29 12MHz诊断等待页正常。最新普通12MHz尚未部署。
- Full16 R1和玩家底座V2 R3已交付数字模型；三模块角落首件已获用户配合正常反馈。

## 下一轮优先顺序

| 优先级 | 负责方 | 可执行工作与关闭条件 |
| --- | --- | --- |
| P0 | 主会话＋格子 | [V0.36旋转180度＋低亮合并更新](tile-display-rotation-2026-10-16.md)16板分批写验/联网及当前页面目视均通过；下一步在整盘恢复后检查实际游戏页面。四分之一驱动幅值及16/255上限已部署 |
| P0 | 主会话＋玩家屏 | 安排COM29普通12MHz `3da4c493…` 同布局升级及正常版本目视；当前`716ff623…`日志已结束可继续玩，不将网络容量列为阻塞 |
| P0 | 玩家屏＋主会话 | 真实Avatar页面精确慢/快正反卡点与UI焦点、姓名页及游戏动态页面；记录实际版本、帧率及最大间隔，关闭≥24FPS/42ms目标和历史Retarget57ms问题 |
| P0 | 主会话＋服务器＋格子＋玩家屏 | 四屏同时开启时由用户新建16格局，逐人Tag配对/拿回/重复UID/多Tag、外貌姓名到开始游戏；当前三真人boundMask7不代替四真人全流程 |
| P0 | 主会话＋服务器＋格子 | 正常掷骰→MoveGuide首帧→目标灯→正确Tag自动到达；验提前放入、重复识别、手动到达、断线/重启后席位/移动/财务幂等，完成实体一局至终局 |
| P1 | 格子＋主会话 | 16环上锚点改派、物理断环撤回/重接恢复及不同上电顺序；V0.36下完整游戏页面/图文（COM16/17/18当前页及低亮已确认）；24/32/40实体另验 |
| P1 | PCB＋格子 | 仪表对照INA226、整盘启动峰值/欠压/温升/插拔，相邻线圈和多Tag矩阵；保持4.65V保护，约1W/板不是实测保证 |
| P1 | PCB＋玩家屏 | RC6-TP制造HOLD项、真实电池容差/保护/充电/USB/FPC/欠压/热；另建包含最新输入/显示改动的电池遥测启用候选并验证UART/SOC状态条 |
| P1 | 3D | Full16先打印一个L验新增长—长接口与自然落柱，再全环；玩家只02换R3，验切片耳根、孔位、60mmFPC松弛和承载；六页中文图文装配PDF已交付 |
| P1 | 服务器＋主会话 | USB未来32格＋4屏及调试余量、反复启动DHCP租约累积、无家庭网真实冷上电；20台和软件重启通过不代表这三项通过 |
| P2 | 服务器 | 独立复现并评估旧上下文/新room并发一致性；当前代码窗口尚不能解释已恢复的同16格Waiting现象 |

重开局等待页这次未再现：150组观察、230次真实回包和用户确认正常；没有源码修复。[故障记录](newgame16-assignment-observation-2026-10-15.md)保留复发时的采集步骤。不要通过伪造心跳、Tag、掷骰或分配制造验收通过。

## 发布和历史约束

`trial16-2026-10-15-v4`含V0.34、dfc4/16MHz、ea6e服务，**不含COM29的12MHz修复和USB新部署配置**。每次发布记录源码/依赖清单、profile、app SHA、完整MAC、制造revision、写验与运行；候选构建、部署、视觉、性能、电气分别留证。原厂布局不匹配时先独立备份/迁移，同布局升级不等于第一次迁移。

人工ORDER锚点目前在服务重启/换room/board清除；玩家席位/Tag持久化是另一机制。COM19持续隔离；COM8诊断板不计计划16板，也不应混入严格全在线环。四台玩家底板均有返修/接电池用户报告，不能继续写成全部未返修；这也不代表电气验收结束。

保持RS485禁用，先另行落实A/B线型断点与两端终端/偏置；ORDER闭环不等于RS485允许闭环。旧PD/NVM取消。游戏uint8轮次回绕、未实现机器人自动谈判及长期自然终局限制保留。没有定时续派、后台自动刷写或自动清房间。
