Ha22yX/Gridopoly/Docs/firmware/portable-wifi-selection-2026-10-15.md

# 便携棋盘的 USB Wi-Fi 选型

更新：2026-10-15。用户希望带出门后仍能独立游玩，已确认购买 **ALFA AWUS036ACM Long-Range Dual-Band AC1200，MediaTek MT7612U，双天线、USB 3.0**。现已到货、识别并部署；20台同时接入/注册、设备自动恢复与Pi软件重启自启动已有证据，最终持续观察为16格＋3屏（另一屏由用户关闭）。36台和完全脱离家庭网的冷上电仍待实测，见[部署记录](usb-ap-deployment-2026-10-15.md)。

## 需求与现状

- 当前16格＋4屏需要20台无线设备；最终32格＋4屏需要36台，另需留手机/电脑管理连接余量。
- 现有ESP32-S3模块使用2.4GHz 802.11 b/g/n；5/6GHz标称速率和Wi-Fi 6/7等级不能直接说明本项目的接入容量。[Espressif规格](https://www.espressif.com/en/products/socs/esp32-s3)
- 迁移前用户已给16格接24V；当时Pi内置热点连续只观察到7台活跃关联（3屏＋4格），用户关闭一屏后多一格上线。DHCP未耗尽，服务端无拒绝注册证据，精确芯片限制未直接读取。此历史瓶颈已不再阻塞当前16格＋4屏，原始读数保留在[实机调查](ap-capacity-investigation-2026-10-15.md)。

## 选型依据与边界

[ALFA产品规格](https://www.alfa.com.tw/products/awus036acm_1)确认AWUS036ACM使用MT7612U，支持2.4/5GHz、Linux和USB 3.0；[厂家Linux支持页](https://docs.alfa.com.tw/Support/Linux/MT7612U/)列出Raspberry Pi OS支持及主线内核驱动。已核对的[Amazon商品](https://www.amazon.com/dp/B08BJS8FXD)标题与芯片匹配。购买和到货记录按准确型号核对，其他相似后缀不自动视为同一硬件。

Linux 6.18的[mt76x02定义](https://github.com/torvalds/linux/blob/v6.18/drivers/net/wireless/mediatek/mt76/mt76x02.h)含128项WCID资源，[站点分配代码](https://github.com/torvalds/linux/blob/v6.18/drivers/net/wireless/mediatek/mt76/mt76x02_util.c)用该表分配关联站点，包含USB/AP路径。这是选择它进一步验证36台接入的驱动依据，**不是厂家保证128个客户端，也不是本项目36台稳定联网证据**。供电、固件、现场2.4GHz干扰、广播和实际HTTP/UDP负载仍需验收。

截图中的TP-Link AC600/AX1800/BE6200/BE6500不能按数字选容量最大者。只有AC600的T2U Plus具体型号在截图中展开，其他选项不能仅凭速率档认定硬件revision；查到的对应官方产品页没有给出Pi Linux下36台AP的保证。后续已由用户明确选择AWUS036ACM，不再把这些型号列为采购待选。

## 当前部署与已验证范围

树莓派保持唯一游戏服务器；AWUS036ACM以持久接口 `gpusb0`、独立 `mt76x2u` 射频提供2.4GHz `gridopoly` 热点。已核对USB ID `0e8d:7612`、永久MAC `00:c0:ca:be:2a:df`，按用户确认的美国使用地设置US／信道6／HT20。SSID与原密码、服务器 `10.42.0.1`、HTTP80／UDP4242及广播发现保持；内置 `wlan0` 用于管理/可选上网。旧 `ap0` 已退出游戏地址，不能同时持有 `.1/24`。

- 2026-10-15 22:07:58和22:18:49 UTC两个快照均16格＋4屏、20台同时关联并注册；这不是36台或20台长时间满负载测试。
- USB驱动解绑/重绑后约6.9秒自动恢复AP/DHCP/watchdog；初次规则失败曾安全回退，修正后的设备事件恢复已通过。真实物理拔插另验。
- 22:19 UTC实际Pi软件重启后，四服务自动启动，早于家庭网wait-online完成；原房间/业务恢复。用户关闭COM7后，独立121.18秒观察为16格＋指定3屏全部在线。
- 16格唯一ORDER环、0～15自动分配、四角0/4/8/12及16个reader stable已实证；用户后续同尺寸新局的150组观察与230次真实心跳也正常。首次等待页异常未定因，未以恢复冒充修复，见[观察记录](newgame16-assignment-observation-2026-10-15.md)。

配置生成器与维护窗口是两件事：[USB工具](usb-ap-deployment-2026-10-15.md)只做只读核验、生成私有候选和校验，不包含apply、安装或自动回退。已完成的现场迁移由独立维护步骤实施，不能把该工具当作一键切换器。旧eth0方案的20项离线用例不等于USB验收；USB到货后的定向回归为23项通过。

## 未完成的实物验收

完全断电且家庭路由器不可用的冷上电、真实USB物理拔插、离线素材和完整实体游戏仍需验证；32格物理环、32格＋4屏＝36台并加入管理终端的持续运行也未完成。驱动表大小、地址池或连接限额均不能代替实测。重复整盘上电应记录历史DHCP租约及剩余地址，不能靠清租约掩盖随机MAC带来的地址积累。

当前热点配置依据实际美国使用地；外出换国家后重新核验监管域与可用信道，不假定一次配置适用于任意地点。服务器会话负责后续网络实施，主会话审核和协调设备窗口；本轮文档更新不进行新的现场操作。

相关记录：[当前交接](../CURRENT-DEVELOPMENT-HANDOFF.md)、[旧以太网外置AP方案](external-ap-deployment-2026-09-26.md)。USB路径以自己的实机记录为准，旧eth0路径仍未现场部署。
