Ha22yX/Gridopoly/Docs/product/product-goals.md

# Gridopoly 产品目标说明

更新：2026-10-15晚间。当前16格试玩与最新实物边界见[当前交接](../CURRENT-DEVELOPMENT-HANDOFF.md)，具体待办见[路线图](../firmware/development-roadmap-2026-09-21.md)。产品目标与已经验收的结果分别表述。

## 项目概述

Gridopoly 是一款 DIY 模块化电子地产经营桌游。它保留实体桌游围坐游玩的体验，同时通过智能棋盘格子、电子棋子、玩家控制屏幕和树莓派主控系统，让传统棋盘游戏具备自动识别、动态显示、灯效反馈和软件扩展能力。

本项目的目标不是复制任何现有商业桌游的品牌、地图、美术、卡牌文字或视觉设计，而是基于“地产经营、移动、交易、资产管理”这类桌游机制，探索一种全新的电子化实体桌面游戏系统。

## 核心目标

Gridopoly 的核心目标是做出一套“每个棋盘格子都能感知、显示并响应游戏状态”的实体电子棋盘。

每个棋盘格子是独立电子模块，当前已实现的硬件组成包括：

- 小型显示屏，用于显示地块信息、价格、归属、状态和提示。
- ESP32-S3 主控模块，用于处理本地显示、灯效和通信。
- RFID 相关识别单元，用于棋子或格子身份识别。
- LED 环，用于展示地块状态、玩家颜色、事件反馈和动画效果。
- 模块连接接口，用于在相邻格子之间传输电源和通信信号。

所有格子模块连接在一起，由树莓派作为中央主控，统一管理游戏规则、玩家数据、棋盘状态、交易结算、事件触发和多设备同步。

## 玩家体验目标

Gridopoly 希望让传统实体桌游变得更有互动感和沉浸感，同时保留面对面游玩的社交体验。

玩家体验目标包括：

- 自动或半自动识别玩家棋子所在位置。
- 通过格子屏幕和 LED 环清晰展示当前状态。
- 每位玩家拥有独立控制屏幕，可查看余额、资产、交易和可执行操作。
- 使用电子支付和自动结算，减少纸币、手动记账和计算租金的繁琐过程。
- 长期可探索棋子震动反馈；当前实物为只读UID的RFID Tag，未实现棋子主动供电、马达或无线控制。
- 支持软件控制的动态事件、规则变化、主题地图和扩展玩法。

这个项目的重点不是把桌游变成纯电子屏幕游戏，而是让真实棋盘、真实棋子和数字系统结合起来，让玩家仍然能移动棋子、观察棋盘、谈判交易，并感受到桌面上正在发生变化。

## 硬件平台目标

Gridopoly 应该被设计成一个模块化、可扩展、可迭代的硬件平台，而不是一块固定不可变的棋盘。

硬件设计目标包括：

- 每个棋盘格子都可以独立测试、替换和调试。
- 支持不同类型的格子，例如地产格、事件格、惩罚格、奖励格、交通格和特殊行动格。
- 后续可以更换棋盘布局，扩展更多格子或不同形状的地图。
- 使用价格合理、容易购买、适合 DIY 制作的元器件。
- 第一版 PCB 尽量保持简单，方便快速打样、焊接和排查问题。
- 为整块棋盘提供稳定的电源分配和通信方式。

当前先以12长边＋4角落做16格试玩，已完成16板V0.34分批部署，另有4台玩家屏同时在线的历史记录；后续扩展28长边＋4角落。仍按首件、小批、全盘逐级验收，联网和写验不等于完整游戏通过。

## 当前两种PCB与供电目标

当前试玩为12长边＋4角落和最多4个玩家屏；32格是后续扩展目标。长边PCB2_1与角落PCB2_5共用本地保护，角落J301直接稳压24V输入，5.5×2.1mm中心正；默认单点供电。24V/5A为适配器建议，60W整盘与约1W每板仍需实测；USB-PD、NVM与旧20V5A要求已取消。

全在线16/24/32/40 ORDER环与实际4角落自动映射、1～4合格屏补机器人至4席、顺序Tag配对均已实现并回归；单模块与开放链也可配对。24V已接入；线圈抬高后16板识别获用户确认，服务器16 reader stable、唯一16环/正确四角映射已有实证。USB热点已实现16格＋4屏20台同时接入，开机服务及软件重启恢复通过。四真人完整实体游戏、后续32实物/36客户端、无家庭网冷上电及整盘电气仍待验，RS485仍禁用。详见[当前交接](../CURRENT-DEVELOPMENT-HANDOFF.md)。

另有80×80mm双层玩家电池底板RC6-TP设计候选，包含USB-C、充电/供电、开关和硬件欠压、电量/状态遥测；未制造放行，遥测固件默认关闭、未部署。它不接棋盘24V总线。

## 当前 V1.0 硬件边界

当前单格模块已经确定为 ESP32-S3、ST7789、10 颗 WS2812、HTRC110、
RS485、ORDER、24V 分布供电和本地电流检测。它仍处于首板验证阶段，不代表
已经完成量产或完整棋盘验证。

当前 RFID 使用 HITAG S256（100～150kHz 工作范围，实体标签标称 125/134.2kHz）。
V0.27 已实现 Advanced UID REQUEST、单标签 32 位 UID 确认和同一线圈内最多 6 个 UID
的 AC SEQUENCE 防碰撞树枚举，并通过 COM12 两枚实体标签 `8EFA259D`、`8EFA24DF` 连续 60 秒稳定识别验收。协议、CRC、最早 SOF 选择、同相位碰撞确认、三轮集合并集和
按 UID 独立累计的快速离场证据均已进入正式固件；多标签量产能力仍取决于完成中心、边缘、叠放、移动和
相邻线圈干扰测试。在该实机矩阵全绿前，游戏规则仍应允许对同格多棋子事件进行玩家确认。
格子模块现将完整稳定 Tag 集合汇总到服务器；服务器负责 Tag 与玩家的一对一绑定，并在绑定
Tag 被目标格稳定检测时执行与手动到达相同的权威事务。移动期间，出发格整圈橙色呼吸、目标
格整圈绿色双闪。玩家屏手动确认继续保留；相邻线圈对同一 Tag 的强度仲裁尚未实现。

## 软件目标

Gridopoly 的软件系统应当把“本地硬件控制”和“全局游戏逻辑”分开。

每个格子上的 ESP32-S3 主要负责本地任务，例如显示屏刷新、LED 动画、模块身份识别、状态上报和与主控通信。树莓派负责全局任务，例如玩家账户、资产数据、游戏规则、回合流程、交易结算、事件系统和游戏存档。

软件已有地图目录、电子事件、资产/交易、存档恢复与调试工具；自定义规则、多种游戏模式及联网对战仍是后续扩展。持续目标包括：

- 可配置棋盘地图。
- 自定义规则和不同游戏模式。
- 电子事件卡和随机事件。
- 玩家账户和资产管理。
- 游戏保存与继续。
- 模块调试和硬件测试工具。
- 后续联网对战或手机/网页伴随界面。

## 设计原则

Gridopoly 的设计应遵循以下原则：

- 模块优先：每个格子都应该能独立理解、测试和替换。
- 实体优先：电子系统用于增强桌游体验，而不是取代实体桌游。
- 易于扩展：新的地图、规则、格子类型和主题包应该可以逐步加入。
- 交互清晰：玩家应该能明确知道发生了什么、谁付了钱、为什么棋盘状态发生变化。
- 适合 DIY：硬件结构、元器件选择和文档都应方便制作、焊接、调试和复现。
- 保持原创：项目名称、美术风格、地图设计、卡牌内容和产品识别应与现有商业桌游保持区分。

## 近期里程碑

1. 核对订单实物revision、长边/角落制造资料和对插，保留已完成16板的MAC/profile/写验台账，后续烧录使用trial16-2026-10-15-v4。
2. 16实体ORDER环及四角0/4/8/12已验，继续实体锚点改派、断环恢复和未来32格扩展；RS485另行设计，不借ORDER通过放行A/B闭环。
3. 四屏自动发现、逐人Tag配对、多reader取回提示与外貌姓名并行，完成真实对局至终局和断电恢复。
4. 复验精确旋钮与Avatar手感、优化Retarget长帧和游戏动态视觉；COM27/28等待页正常，COM29 12MHz诊断等待页正常、普通12MHz待部署。保留已确认手写行为，分别关闭性能与页面验收。
5. 完成棋盘功耗策略、INA226有效性及单板至整盘启动/温升/插拔、RFID相邻线圈与36无线客户端验证。
6. 关闭RC6-TP剩余警告/FPC/电池参数与制造条件，按各返修板实际情况验证USB/充电/欠压/遥测；电池固件另建发布包。
7. 按源码、构建、部署、功能、视觉、电气分别留证发布。具体责任见[路线图](../firmware/development-roadmap-2026-09-21.md)。

## 长期愿景

Gridopoly 的长期目标是成为一套可复用的电子桌游硬件平台。第一种玩法可以聚焦于地产经营、资产竞争和玩家交易，但同一套模块化棋盘未来也可以支持不同主题、不同地图、不同规则和不同类型的互动游戏。

如果项目持续完善，Gridopoly 可以发展为一个开源硬件项目、创客展示项目、工程教育项目，或者成为新型可编程实体桌游平台的基础。
