Ha22yX/Gridopoly/PCB Files/PlayerConsolePower/ProductionReadiness-2026-10-14/first-article-acceptance.md

# 新版本首件验收记录（尚未执行）

使用对应审查哈希的正确新板，或已明确返修并排除器件损伤的单板。当前旧批BAT硬短路板不能直接进入通电步骤。本表不记录虚构PASS。

| 项目 | 方法与判定依据 | 当前结果 |
|---|---|---|
| 文件对应 | 订单接收的Gerber/BOM/CPL与放行哈希一致；68位号、J1混合USB座、J3插件均落实 | 待执行 |
| 装配 | 检查极性、QFN焊接、U1 EP工艺；代工对热孔/钢网给出方案，首件必要时X-ray | 待执行 |
| 断电短路 | 电池/USB/屏幕全断开，测BAT/GND、SYS_RAW/GND、5V_SCREEN/GND；观察稳定值及双表笔方向；不得存在持续接近表笔短接电阻的情况 | 待执行 |
| 电池/排线极性 | 实际插合时J3.1负/J3.2正，屏幕5V→J2.10、GND→J2.8；0.3mm级厚度、锁扣、D+/D−、RX/TX/RST逐一核对 | 待执行 |
| 仅USB关屏 | 使用有明确限流的5V源检查VBUS、SYS_RAW、逻辑供电；屏幕保持关、充电可工作；无异常发热/过流 | 待执行 |
| 电池开关机 | 合规受保护电池或实验室适配电源模拟电池；覆盖工作电压范围、按键短/长按、空载及实际屏负载；5V_SCREEN在屏4.0–5.5V输入范围内 | 待执行 |
| 低电量启动/峰值 | 最大背光、Wi-Fi发送、启动浪涌；示波器捕捉供电最低值与纹波，排线接点电流/压降/温升不超规格 | 待执行 |
| 充电 | 电压低至高、关屏与开屏，记录BAT电流方向/恒流/恒压/终止、系统分配和充电时长；实际电池包正式允许值优先 | 待执行 |
| 温升 | 实际封闭底座、低电量边充边用、规定环境范围；测U1/电池/连接器温度，不以芯片热保护代替电池温度合格 | 待执行 |
| 欠压 | 缓降电池模拟电压，记录SYS_RAW及BAT实际关机点；符合设计公差；电压回升不自动循环启动；充电恢复后能按键启动 | 待执行 |
| 关机漏流 | 无USB关机、欠压关机分别测BAT耗流；确认长期存放由电池独立保护兜底 | 待执行 |
| USB供电档位 | 默认100mA来源及1.5A广告来源分别验证；记录有电/低电/无电池状态，不把仅高电流源成功扩大到普通电脑口 | 待执行 |
| USB数据 | 两种C口方向，正常数据线、反复枚举、完整烧写+读回校验、持续日志/调试、USB插拔与关机隔离；无复位循环/反向供电 | 待执行 |
| 下载恢复 | 确认屏幕GPIO0旋钮版本，按住旋钮+RST能进入ROM，异常应用后能恢复下载 | 待执行 |
| 电量/状态 | 屏幕固件经U9读MAX17048电压/SOC/CHG/PGOOD；100kHz级总线稳定，掉电重启恢复，无电池/读失败不冒充有效读数 | 待执行 |

不得将本表未执行项计作通过。首件记录应包含板号、物料批次、电池型号和保护规格、固件版本、供电/数据线条件、测量仪表、波形/温度/实际读数及操作者。
