Ha22yX/Gridopoly/PCB Files/PlayerConsolePower/ProductionReadiness-2026-10-14/native-PCBinfo.txt

工程标题: 		Gridopoly
板子标题: 		玩家屏幕控制板
PCB 标题: 		PCB1
时间: 		2026-10-14 22:57:27

板子尺寸: 		80mm x 80mm
层: 		总计 22, 铜箔层 2

器件: 		30
封装: 		19
元件: 		总计 68,顶层 68,底层 0
焊盘: 		总计 247, 顶面表贴 237,底面表贴 0,金属化孔 10, 非金属化孔 0
网络: 		总计 41, 未布线 0
测试点: 		网络总数 41, 有测试点的网络 0, 测试点覆盖率 0%
 		总计 0, 顶面测试点 0, 底面测试点 0

挖槽区域: 		2
过孔: 		总计 82, 通孔 82, 盲埋孔 0
铺铜区域: 		2
导线长度: 		1141.876mm
