Ha22yX/Gridopoly/PCB Files/PlayerConsolePower/ProductionReadiness-2026-10-14/power-review.md

# 玩家屏供电板：独立电源审查

审查日期：2026-10-14（America/New_York）。范围：本轮重新捕获的 PCB1-netlist.json、schematic-netlist.json、current-snapshot.json、P1/P2 源码；只读，未操作 EDA 或改制造文件。输入 SHA-256 和计算值见 power-calculations.json。此报告只覆盖电源功能，不代替主报告的铜层、装配、USB信号和实际制造包检查。

**结论：电源网表未发现新的确定性致命错接；尚不足以释放为无条件量产。** 必须闭合电池包允许充电电压、受保护电池要求以及正确制造版本的实板电源验证。不能用本轮静态符合替代真实充放电、温升和瞬态测试。

## 可确认的电路与参数

| 部分 | 最新快照与核验 | 结果 |
| --- | --- | --- |
| U1 BQ24074RGTR | 13=USB_VBUS；2/3=BAT_PACK；10/11=SYS_RAW；4 CE、8 VSS、17 EP接地；15 ITERM悬空；R21=10k将TS接地 | 引脚、电源路径方向和默认终止方式正确；用户选择不装NTC的固定电阻做法得到TI明确支持，未要求加回NTC |
| U1 充电电流 | R1=1.78k/1%；ISET系数797/890/975 AΩ | 典型500mA，含1%电阻的保证范围约443–553mA；不是每种USB源都能达到 |
| U1 输入限流 | EN1固定0；EN2=USB_HIGH_CURRENT；R2=1.8k/1% | 默认USB100典型95mA/最大100mA；EN2高时约894mA，含公差825–965mA。按电气表KILIM=1610计算，手册应用示例1550不是该范围的现行典型值 |
| U1 定时与TS | R20=68k，R21=10k | 快充安全计时典型9.07h，参数范围约6.73–11.45h；DPPM/热调节等会延长实际计时。TS典型0.75V有效，但没有电芯温度测量 |
| U2 TPS61023DRLR | 1 FB→R9/R10；2 EN→POWER_EN；3 VIN→SYS_RAW；4 GND；5 SW→L1；6 VOUT→5V_SCREEN | 六脚对应正确，关机有输入输出隔离。L1是1µH，不是直流跨地短路 |
| U2 输出 | R9=732k/1%，R10=100k/1%；PWM反馈典型595mV | 典型4.9504V。仅参考值和电阻公差约4.742–5.165V；FB漏电等还会增添误差，不能称保证5.000V。旧0.6×8.32=4.992V可作近似设计值 |
| U3 MAX16054AZT+T | 1按键到地，2地，3 UV_CLEAR，4反相OUT悬空，5 POWER_EN，6 SYS_RAW；C6=100nF | 逻辑和去耦正确。CLEAR高强制关机，重新恢复电压不会自行按键开机 |
| U4 TPS3808G01DBVR/Q1 | U4 1→Q1栅极、2地、3 MR→SYS_RAW、4 CT经R6=100k到SYS_RAW、5 SENSE分压、6 VDD→SYS_RAW；Q1 2源极地、3漏极UV_CLEAR | 欠压RESET低使Q1截止，R7将CLEAR拉高，极性正确；正常电压时Q1拉低CLEAR |
| 欠压阈值 | R3=715k/1%，R4=100k/1%，C5=10nF | SYS_RAW典型3.30075V；考虑参考±2%、电阻±1%、SENSE±25nA，约3.16–3.44V。阈值检测点不是电池插头，负载下还叠加U1/布线压降 |
| 欠压延时 | R6=100k设CT=VDD模式；分压等效电阻约87.7k | 300ms是恢复释放延时，不是欠压需持续300ms才关机；C5形成约0.877ms滤波。需实测Wi-Fi峰值负载是否误关机 |
| U6/U8 AP2112K-3.3 | 各1/3为对应5V输入，2地，4 NC，5=CC_3V3/SCREEN_IO3V3；输入输出均1µF加相应100nF | SOT25引脚和典型稳定电容配置正确。U8只供桥接/USB开关等逻辑，屏幕主负载在5V侧，并非让小LDO承担屏幕全部功率 |

依据：TI [BQ24074 Rev.N](https://www.ti.com/lit/ds/symlink/bq24074.pdf) §7、§8.5、§9.3；TI [TPS61023 Rev.B](https://www.ti.com/lit/ds/symlink/tps61023.pdf) §5、§6.5、§8；ADI [MAX16054](https://www.analog.com/media/en/technical-documentation/data-sheets/MAX16054.pdf) 引脚表和CLEAR逻辑；TI [TPS3808 Rev.N](https://www.ti.com/lit/ds/symlink/tps3808.pdf) §6.5、§7.3；Diodes [AP2112](https://www.diodes.com/assets/Datasheets/AP2112.pdf) SOT25引脚和典型电路。本轮重新获取厂家文档，不以旧报告作为逐脚核验依据。

## 尚未闭合的投产条件

### P1：充电电压保证范围与电池规格不完全重叠

U1 BAT稳压保证4.16–4.23V；本轮重新取得的EEMB LP103454官方规格（2019-04-29，第3页）为4.200±0.020V。上界相差10mV。这不证明已制板实际过充，但无法按最坏公差证明当前“U1+所购电池包”组合完全符合规格。该标准电芯文档也不能代替Amazon具体成品电池包批次规范。

闭合办法：取得所用受保护电池包允许充电电压的正式规格；若最高仍为4.22V，采用保证上限满足该限制的充电器/设定，或选择正式允许该充电容差的电池包。R1只改电流，不改稳压值；不能用串联普通二极管代替精确限压。室温测一块板合格不等于全公差/全温度合格。

[EEMB厂家文件](https://eemb.oss-accelerate.aliyuncs.com//uploads/20230310/238a3765db60b3d0c770182b3e44cd4c.pdf) 已保存到 power-datasheets/eemb-lp103454.pdf。

### P1（电池使用条件）：欠压关屏不等于彻底断开电池

当前没有电池包串联背靠背保护MOS，也没有J3反接保护。U4只控制升压EN；U1、U3、U4、电量计和分压继续连接BAT/SYS_RAW。仅健康电压下R7/Q1支路就约37µA（3.7V），R3/R4再耗约4.54µA，还未计各芯片静耗。长期搁置仍会消耗电池，不能承诺对裸电芯永久防过放。

投产BOM/使用要求必须限定为具有独立过充、过放和过流/短路保护、极性已验证的1S锂离子电池包。若必须支持无保护两线裸电芯，需在底板增加专用电池保护及正确串联MOS；不能只改欠压阈值。当前带保护电池的具体保护阈值和持续放电能力仍要用成品包规格确认。

### P1（功能范围）：普通电脑默认USB电流不能支撑全部功能

U1默认最大100mA输入，包括充电和系统用电。单靠约0.5W输入不能保证5V屏启动、满亮度运行和边运行边充电；USB烧录正常也可能消耗电池。TUSB320的电流广播分档由另一份接口审查核验。

如保持当前设计，规范应写明电脑默认电流端口上传需要电池有足够电量；采用有数据且广播足够电流的USB-C口另行验证。若要求任意电脑口在无电池或空电池状态均能烧录、运行，需要完善USB电源协商/枚举后限流设计；不要直接固定EN1高，因为EN2同时高会进入挂起。

### P1（验收门槛）：封闭底座温升、启动及掉电切换尚未实测

举例估算：5V输入、3.0V电池、500mA充电仅电池支路就约1W线性损耗；还要加输入到SYS_RAW的系统通路损耗。U1具热调节，可能降充电电流，但它不测电芯温度，也不能据此证明底座内温升合格。不要直接套用JEDEC多层测试板的44.5°C/W来保证本双层板。

保持用户不装NTC的要求；记录电池允许的充电环境（该EEMB文件0–45°C）并实测实际底座。制造验证至少覆盖：低电池电压下启动/满背光/Wi-Fi突发、USB插拔切换、边运行边充电的BAT电流方向与温升、欠压锁停后恢复及按键重开。

## 被动件额定与实际有效值

- C2/C3/C7/C8/C9均CL21A106KAYNNNE，10µF、25V、0805、X5R；C8/C9两颗输出电容仍在，没有丢失。
- 三星厂家典型DC偏压曲线显示5V下每颗约剩5.5µF，两颗约11µF，而非有效20µF。该组合通常仍高于TPS61023要求的4µF有效下限，需把公差、温度、老化一并纳入量产替料标准，不能仅凭“10µF/25V”任意替料。C2为BQ电池端单颗电容，其有效容量裕量更小，应确认最坏工况仍满足4.7µF推荐下限。
- L1官方系列表：MWSA0402S-1R0MT，1µH±20%，DCR最大27mΩ，Isat行5.60/7.00A，Irms行5.40/6.00A；正常屏负载下没有发现电感额定明显不足。仍应以实际峰值电流及温升检查，不把“7A”当任意环境持续电流。
- USB输入、3.3V逻辑的1µF/50V及100nF/50V电压额定充足；电阻支路没有发现超额定功耗。均为静态估算，不包含反接、插错电源等异常外部条件。

[三星厂家产品页](https://product.samsungsem.com/cn/mlcc/CL21A106KAYNNN.do)；[三星典型曲线原稿（DigiKey托管）](https://media.digikey.com/pdf/Data%20Sheets/Samsung%20PDFs/CL21A106KAYNNNE_Char.pdf)；[顺络厂家系列手册](https://www.sunlordinc.com/uploads/files/20230303/MWSA-S%C2%A0series%C2%A0of%C2%A0SMD%C2%A0Power%C2%A0Inductor.pdf)。对应PDF本轮已下载，三星曲线已渲染阅读；图为典型值，不能当成保证最小值。

## 本报告不作出的结论

未宣称现有故障板可直接通电，未改J3/铜皮，未替代订单短路报告，未宣称已完成真实USB烧录/调试、SOC精度、屏幕接插件实物和整机认证。电源逐脚符合是必要条件，不是“完美投产”的充分证据。负责人：PCB主任务结合其他审查决定新制造包释放；用户/硬件测试方完成受控首板验收。
