Ha22yX/Gridopoly/PCB Files/PlayerConsolePower/Layout-2026-09-27-RC2/independent-review.md

# RC2 主任务交付复核

2026-09-27。本轮仅将有证据的 USB 布局改善归档为新制造候选，没有下单或更新现场固件。RC1 的冻结文件继续保留。

## 变更与副本复验

主任务收到稳定清单后核对本目录 36 项交付 SHA-256，均与文件一致。复制相邻 RC1/RC2 目录到临时审查目录，未在冻结目录执行会重写报告的检查脚本。

- `verify-layout.cjs` 的 34 项检查通过；`verify-usb-routing.cjs` 的 10 项检查通过。68 件的位置、243 脚网络及原有非 USB 走线/过孔与 RC1 一致；没有新增 D+ 过孔。
- HOST D− 底层铜长从 4.189 mm 降至 0.998 mm，网络过孔从 3 个降至 2 个；J1.B7 至 U7 的实际测量路径不再换层。SCREEN D− 底层铜长从 2.776 mm 降至 1.550 mm，其总平面长度略增加，不能写成全部路径均变短。
- 主任务查看了最终 Gerber 生成的顶底预览、修改区域和 RC2 丝印，并重新运行交付的 `verify-reference-copper.py`。原报告由同算法的临时脚本生成；本轮确认改为直接读取相邻 ZIP 的交付脚本也可运行。
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
