Ha22yX/Gridopoly/.github/assets/gridopoly-raspberry-pi.png

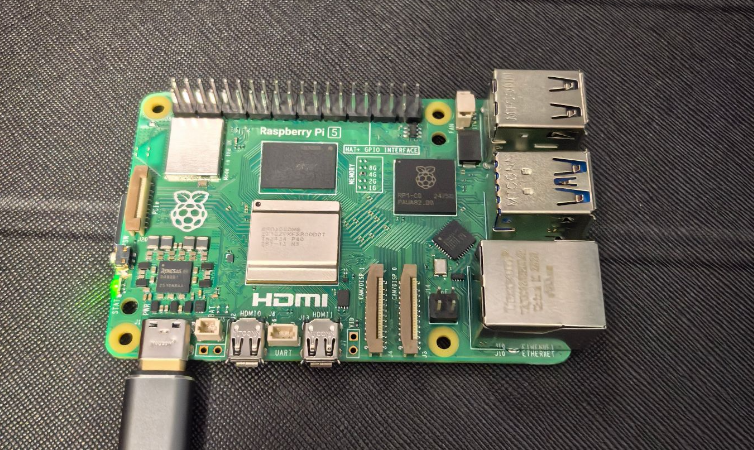
.github/assets/gridopoly-raspberry-pi.png
