Ha22yX/Gridopoly/.github/assets/gridopoly-tile-module.png

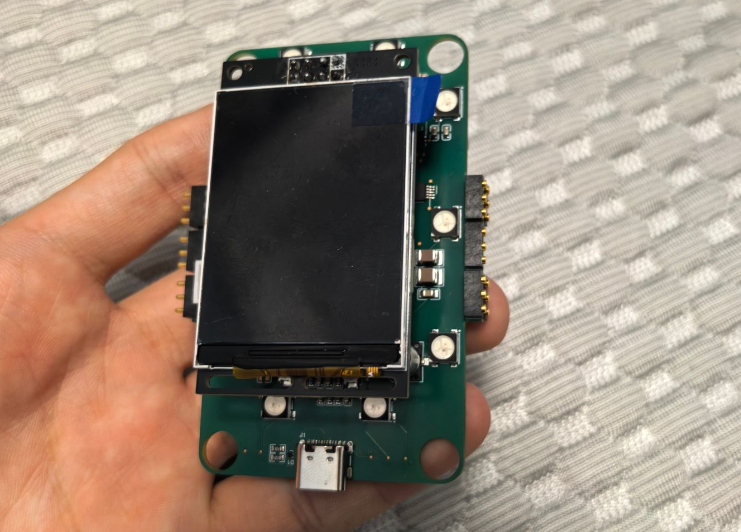
.github/assets/gridopoly-tile-module.png
