Ha22yX/Gridopoly/.github/assets/gridopoly-tile-pcb.png

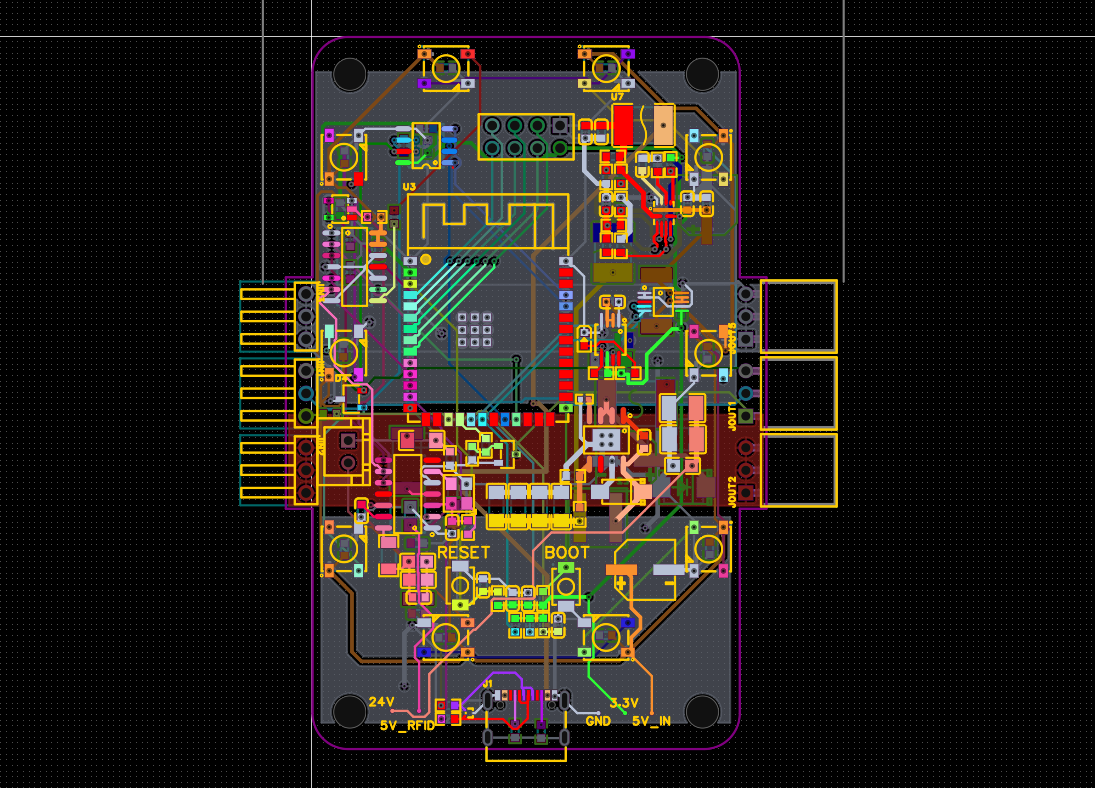
.github/assets/gridopoly-tile-pcb.png
