Ha22yX/Gridopoly/Assets/GridCity/DevelopmentV1/device/a2-copper-lane-l5.png

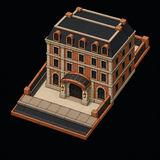
Assets/GridCity/DevelopmentV1/device/a2-copper-lane-l5.png
