Ha22yX/Gridopoly/Assets/GridCity/DevelopmentV1/device/b2-tideway-drive-l1.png

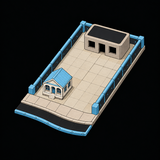
Assets/GridCity/DevelopmentV1/device/b2-tideway-drive-l1.png
