Ha22yX/Gridopoly/Assets/GridCity/DevelopmentV1/device/b2-tideway-drive-l5.png

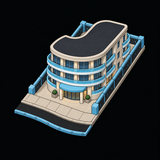
Assets/GridCity/DevelopmentV1/device/b2-tideway-drive-l5.png
