Ha22yX/Gridopoly/Assets/GridCity/DevelopmentV1/device/b3-beacon-boulevard-l0.png

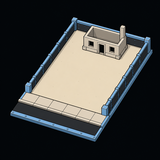
Assets/GridCity/DevelopmentV1/device/b3-beacon-boulevard-l0.png
