Ha22yX/Gridopoly/Assets/GridCity/DevelopmentV1/device/c1-canvas-street-l3.png

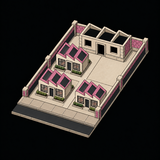
Assets/GridCity/DevelopmentV1/device/c1-canvas-street-l3.png
