Ha22yX/Gridopoly/Assets/GridCity/DevelopmentV1/device/c2-bloom-terrace-l1.png

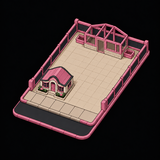
Assets/GridCity/DevelopmentV1/device/c2-bloom-terrace-l1.png
