Ha22yX/Gridopoly/Assets/GridCity/DevelopmentV1/device/c2-bloom-terrace-l5.png

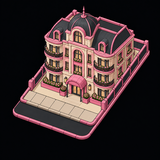
Assets/GridCity/DevelopmentV1/device/c2-bloom-terrace-l5.png
