Ha22yX/Gridopoly/Assets/GridCity/DevelopmentV1/device/c3-aurora-avenue-l3.png

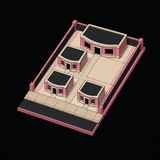
Assets/GridCity/DevelopmentV1/device/c3-aurora-avenue-l3.png
