Ha22yX/Gridopoly/Assets/GridCity/DevelopmentV1/device/d3-meridian-avenue-l3.png

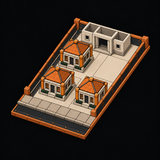
Assets/GridCity/DevelopmentV1/device/d3-meridian-avenue-l3.png
