Ha22yX/Gridopoly/Assets/GridCity/DevelopmentV1/device/e1-pulse-street-l2.png

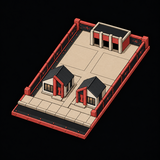
Assets/GridCity/DevelopmentV1/device/e1-pulse-street-l2.png
