Ha22yX/Gridopoly/Assets/GridCity/DevelopmentV1/device/e2-prism-boulevard-l2.png

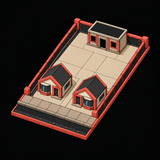
Assets/GridCity/DevelopmentV1/device/e2-prism-boulevard-l2.png
