Ha22yX/Gridopoly/Assets/GridCity/DevelopmentV1/device/e2-prism-boulevard-l4.png

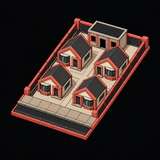
Assets/GridCity/DevelopmentV1/device/e2-prism-boulevard-l4.png
