Ha22yX/Gridopoly/Assets/GridCity/DevelopmentV1/device/e3-nova-avenue-l2.png

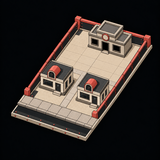
Assets/GridCity/DevelopmentV1/device/e3-nova-avenue-l2.png
