Ha22yX/Gridopoly/Assets/GridCity/DevelopmentV1/device/e3-nova-avenue-l3.png

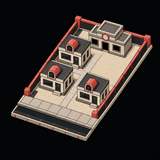
Assets/GridCity/DevelopmentV1/device/e3-nova-avenue-l3.png
