Ha22yX/Gridopoly/Assets/GridCity/DevelopmentV1/device/e3-nova-avenue-l4.png

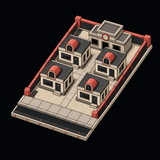
Assets/GridCity/DevelopmentV1/device/e3-nova-avenue-l4.png
