Ha22yX/Gridopoly/Assets/GridCity/DevelopmentV1/device/f1-sunstep-terrace-l3.png

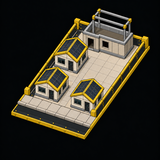
Assets/GridCity/DevelopmentV1/device/f1-sunstep-terrace-l3.png
