Ha22yX/Gridopoly/Assets/GridCity/DevelopmentV1/device/f2-helix-way-l5.png

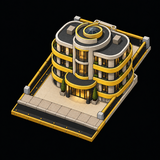
Assets/GridCity/DevelopmentV1/device/f2-helix-way-l5.png
