Ha22yX/Gridopoly/Assets/GridCity/DevelopmentV1/device/f3-horizon-drive-l5.png

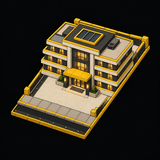
Assets/GridCity/DevelopmentV1/device/f3-horizon-drive-l5.png
