Ha22yX/Gridopoly/Assets/GridCity/DevelopmentV1/device/g1-canopy-lane-l5.png

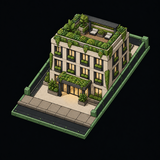
Assets/GridCity/DevelopmentV1/device/g1-canopy-lane-l5.png
