Ha22yX/Gridopoly/Assets/GridCity/DevelopmentV1/player/a1-rivet-row-l2.png

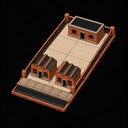
Assets/GridCity/DevelopmentV1/player/a1-rivet-row-l2.png
