Ha22yX/Gridopoly/Assets/GridCity/DevelopmentV1/player/b1-lantern-avenue-l1.png

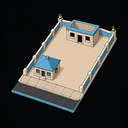
Assets/GridCity/DevelopmentV1/player/b1-lantern-avenue-l1.png
