Ha22yX/Gridopoly/Assets/GridCity/DevelopmentV1/player/b2-tideway-drive-l4.png

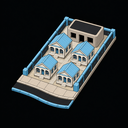
Assets/GridCity/DevelopmentV1/player/b2-tideway-drive-l4.png
