Ha22yX/Gridopoly/Assets/GridCity/DevelopmentV1/player/b3-beacon-boulevard-l1.png

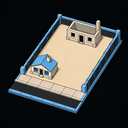
Assets/GridCity/DevelopmentV1/player/b3-beacon-boulevard-l1.png
