Ha22yX/Gridopoly/Assets/GridCity/DevelopmentV1/player/c1-canvas-street-l3.png

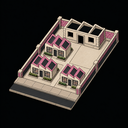
Assets/GridCity/DevelopmentV1/player/c1-canvas-street-l3.png
