Ha22yX/Gridopoly/Assets/GridCity/DevelopmentV1/player/c1-canvas-street-l4.png

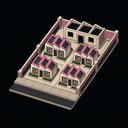
Assets/GridCity/DevelopmentV1/player/c1-canvas-street-l4.png
