Ha22yX/Gridopoly/Assets/GridCity/DevelopmentV1/player/d3-meridian-avenue-l5.png

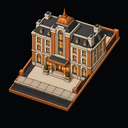
Assets/GridCity/DevelopmentV1/player/d3-meridian-avenue-l5.png
