Ha22yX/Gridopoly/Assets/GridCity/DevelopmentV1/player/f1-sunstep-terrace-l2.png

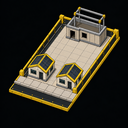
Assets/GridCity/DevelopmentV1/player/f1-sunstep-terrace-l2.png
