Ha22yX/Gridopoly/Assets/GridCity/DevelopmentV1/player/f2-helix-way-l0.png

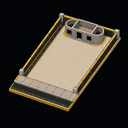
Assets/GridCity/DevelopmentV1/player/f2-helix-way-l0.png
