Ha22yX/Gridopoly/Assets/GridCity/DevelopmentV1/player/h1-crown-promenade-l5.png

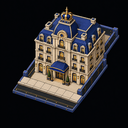
Assets/GridCity/DevelopmentV1/player/h1-crown-promenade-l5.png
