Ha22yX/Gridopoly/Assets/GridCity/DevelopmentV1/player/h2-grand-meridian-l3.png

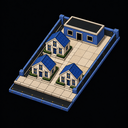
Assets/GridCity/DevelopmentV1/player/h2-grand-meridian-l3.png
