Ha22yX/Gridopoly/Assets/GridCity/DevelopmentV1/review/district-a.png

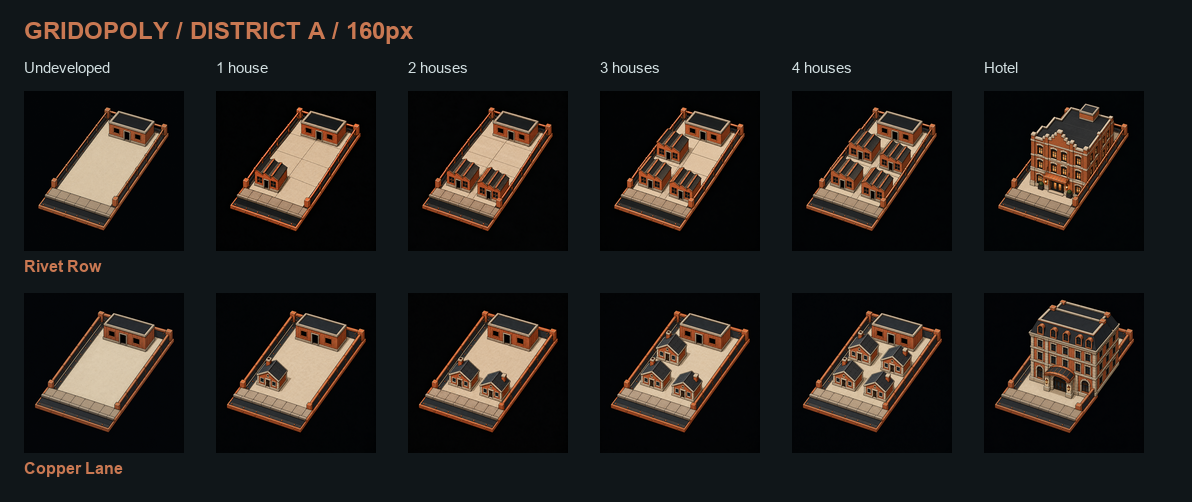
Assets/GridCity/DevelopmentV1/review/district-a.png
