Ha22yX/Gridopoly/Assets/GridCity/DevelopmentV1/review/district-c.png

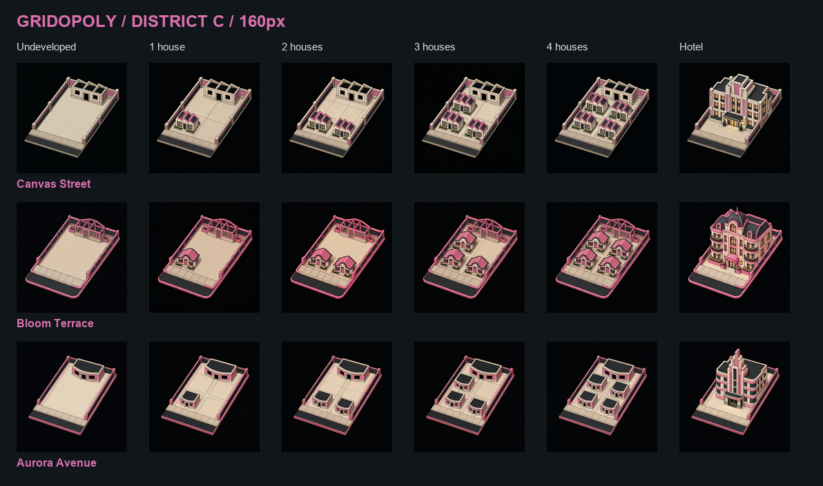
Assets/GridCity/DevelopmentV1/review/district-c.png
