Ha22yX/Gridopoly/Assets/GridCity/DevelopmentV1/review/district-e-128.png

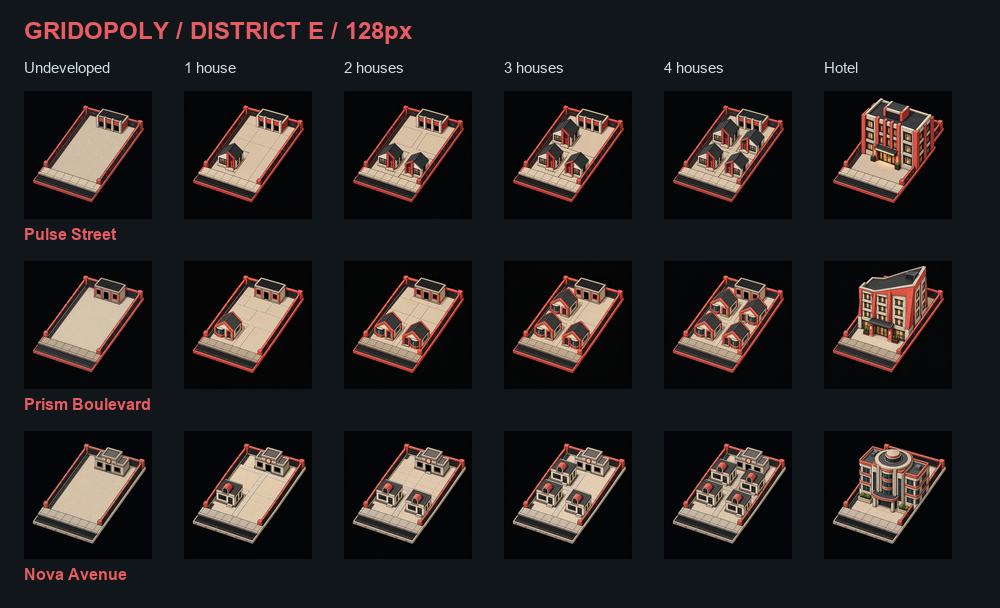
Assets/GridCity/DevelopmentV1/review/district-e-128.png
