Ha22yX/Gridopoly/Assets/GridCity/Production/source/a1-copper-row.png

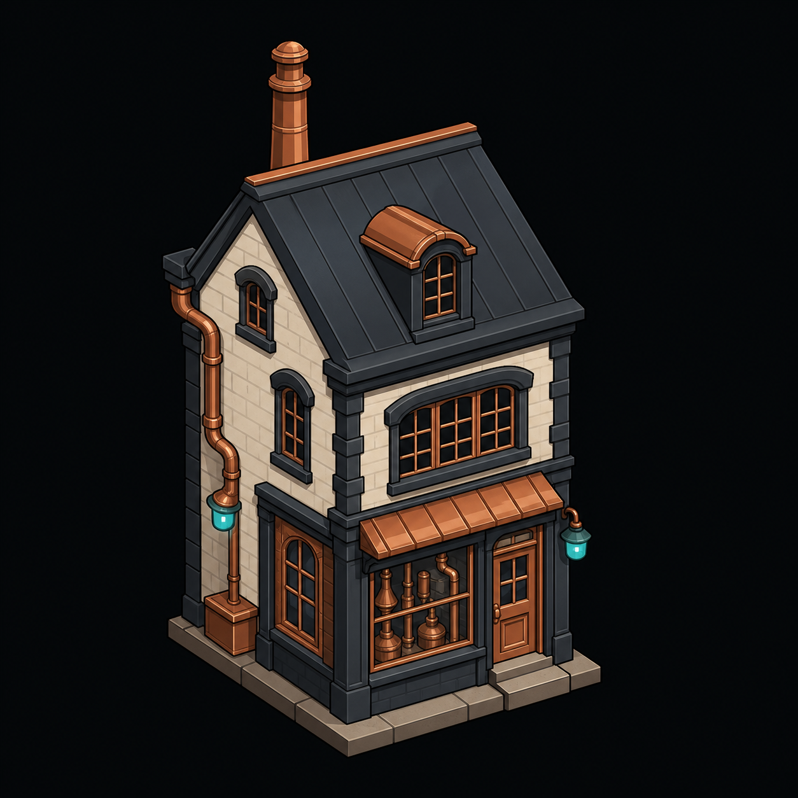
Assets/GridCity/Production/source/a1-copper-row.png
