Ha22yX/Gridopoly/Assets/GridCity/Samples/device/utility_quantum_grid_160.png

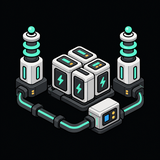
Assets/GridCity/Samples/device/utility_quantum_grid_160.png
