Ha22yX/Gridopoly/Assets/GridCity/Samples/exploration/property_neon_harbor_detailed_exploration.png

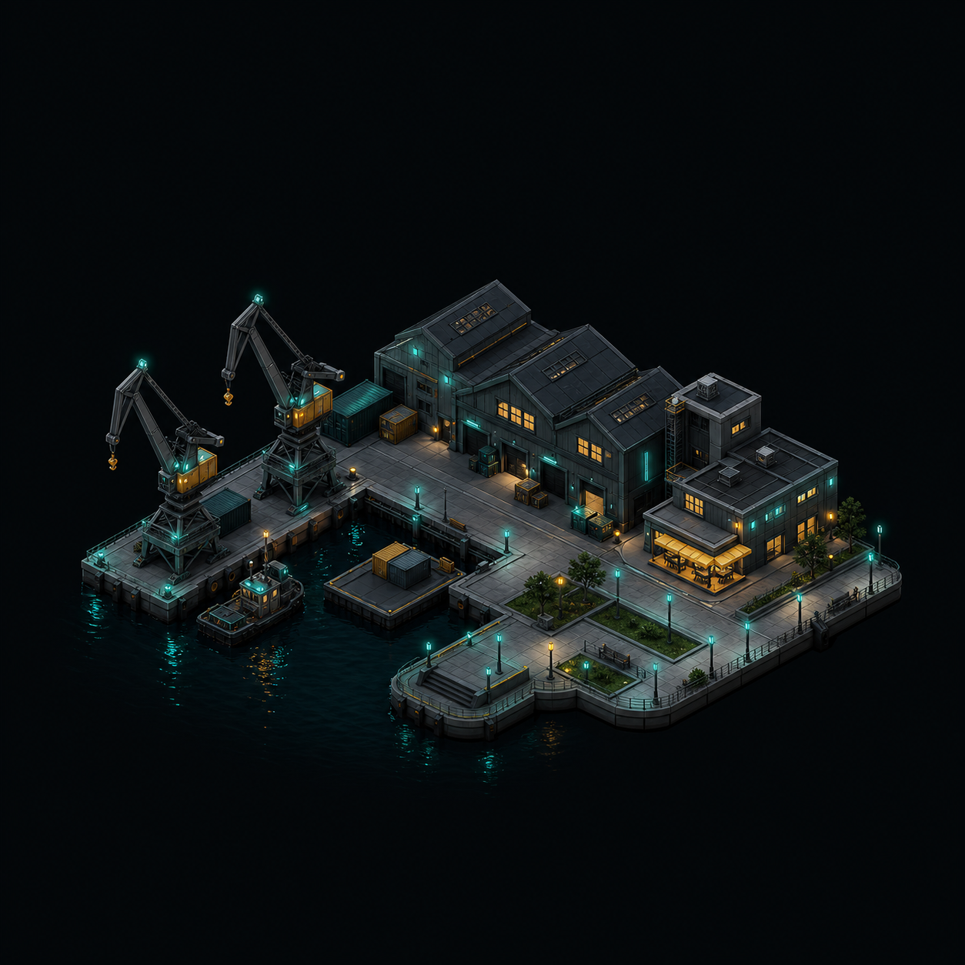
Assets/GridCity/Samples/exploration/property_neon_harbor_detailed_exploration.png
