Ha22yX/Gridopoly/Assets/GridCity/Samples/exploration/transit_cloudrail_central_lowpoly3d_exploration.png

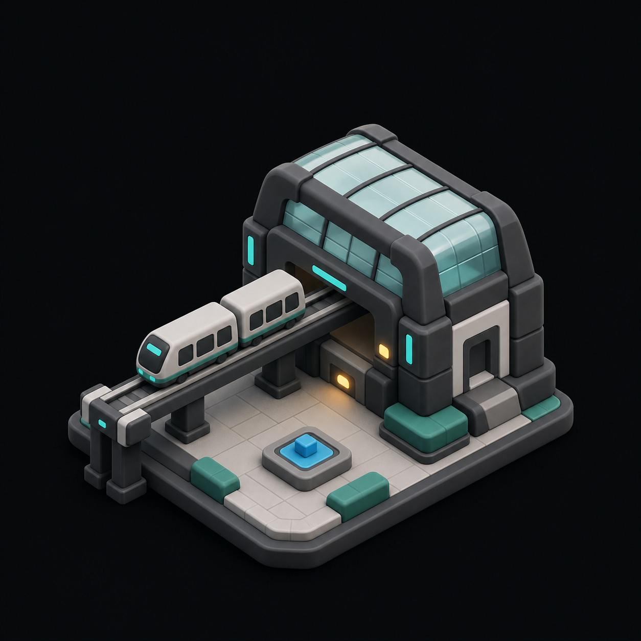
Assets/GridCity/Samples/exploration/transit_cloudrail_central_lowpoly3d_exploration.png
