Ha22yX/Gridopoly/Assets/GridCity/Samples/exploration/utility_quantum_grid_lowpoly3d_exploration.png

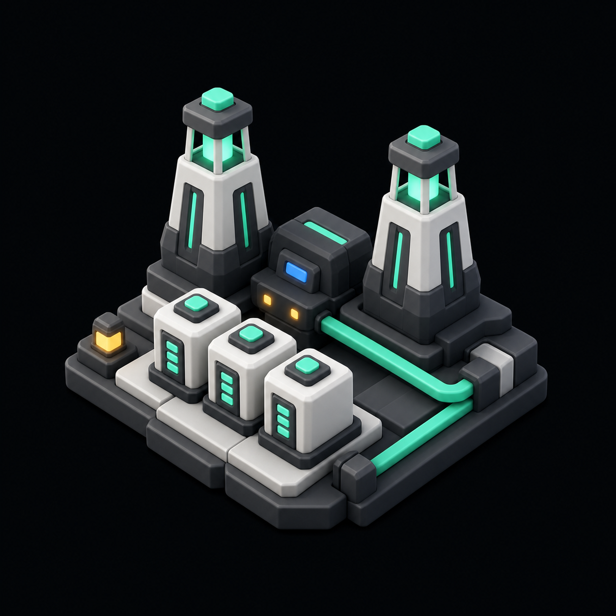
Assets/GridCity/Samples/exploration/utility_quantum_grid_lowpoly3d_exploration.png
