Ha22yX/Gridopoly/Assets/GridCity/Samples/source/property_neon_harbor_master.png

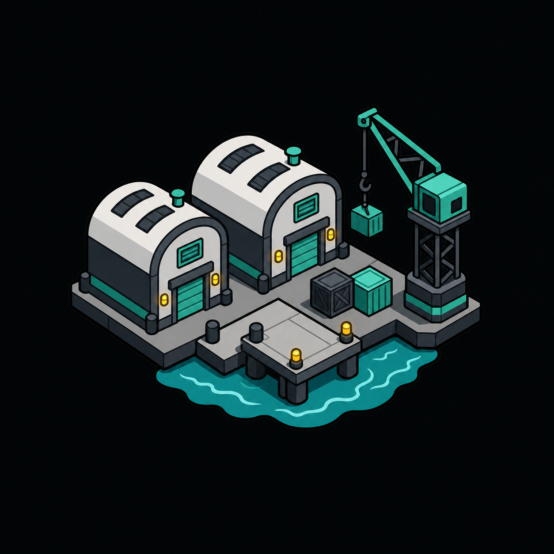
Assets/GridCity/Samples/source/property_neon_harbor_master.png
