Ha22yX/Gridopoly/Assets/GridCity/Samples/source/transit_cloudrail_central_master.png

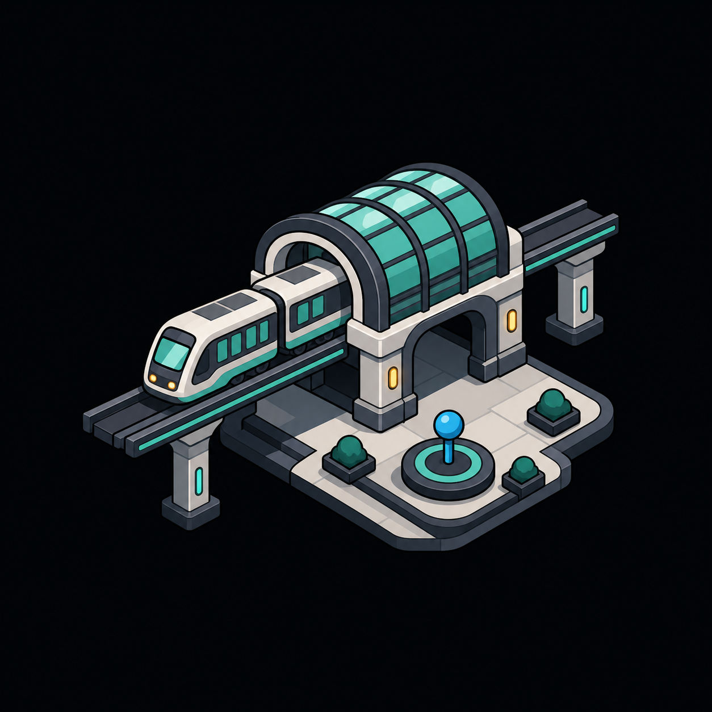
Assets/GridCity/Samples/source/transit_cloudrail_central_master.png
