Ha22yX/Gridopoly/Assets/GridCity/StreetV3/device/corner-civic-hold.png

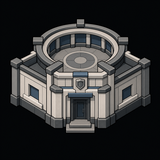
Assets/GridCity/StreetV3/device/corner-civic-hold.png
