Ha22yX/Gridopoly/Assets/GridCity/StreetV3/device/cover-chance.png

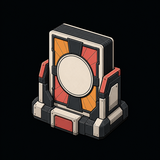
Assets/GridCity/StreetV3/device/cover-chance.png
