Ha22yX/Gridopoly/Assets/GridCity/StreetV3/device/cover-community-fund.png

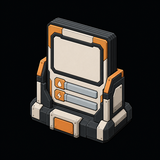
Assets/GridCity/StreetV3/device/cover-community-fund.png
