Ha22yX/Gridopoly/Assets/GridCity/StreetV3/device/cover-luxury-tax.png

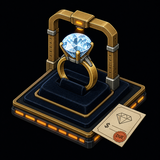
Assets/GridCity/StreetV3/device/cover-luxury-tax.png
