Ha22yX/Gridopoly/Assets/GridCity/StreetV3/device/d3-meridian-avenue.png

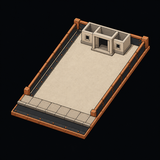
Assets/GridCity/StreetV3/device/d3-meridian-avenue.png
