Ha22yX/Gridopoly/Assets/GridCity/StreetV3/device/utility-bluewater-works.png

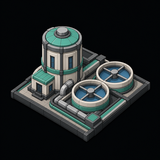
Assets/GridCity/StreetV3/device/utility-bluewater-works.png
