Ha22yX/Gridopoly/Assets/GridCity/StreetV3/review/asset-contact-sheet.png

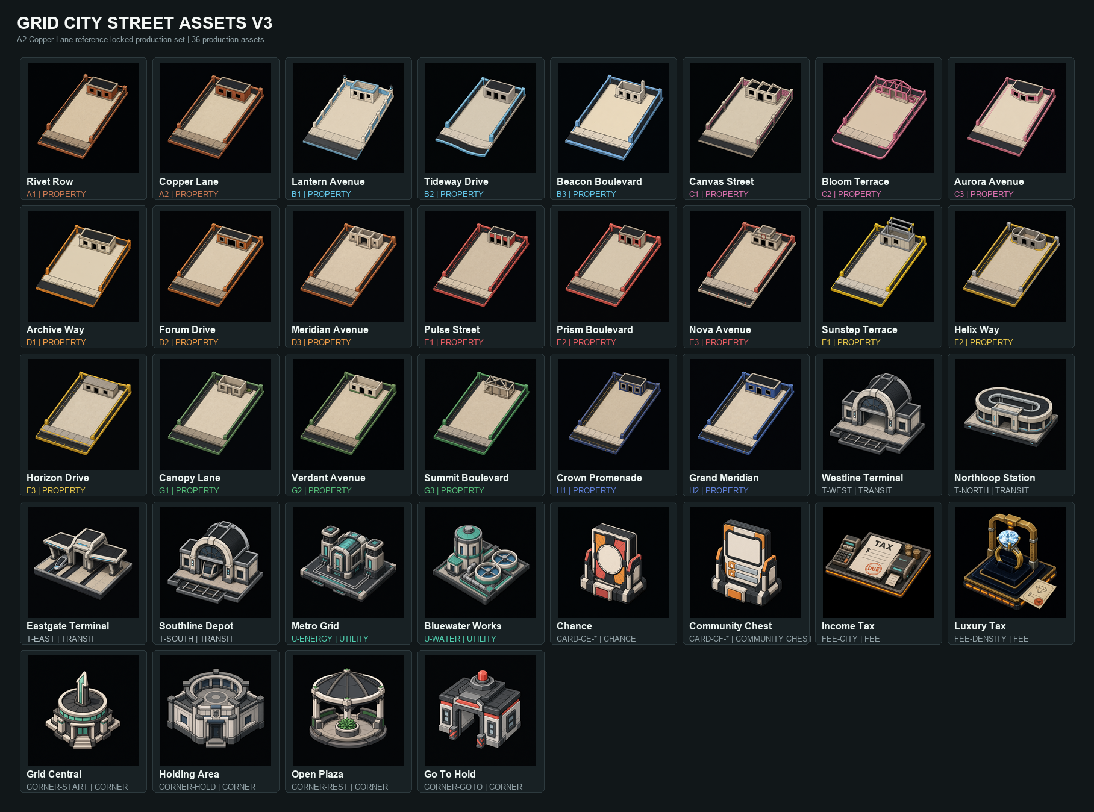
Assets/GridCity/StreetV3/review/asset-contact-sheet.png
