Ha22yX/Gridopoly/Assets/GridCity/StreetV3/source/transit-northloop-station.png

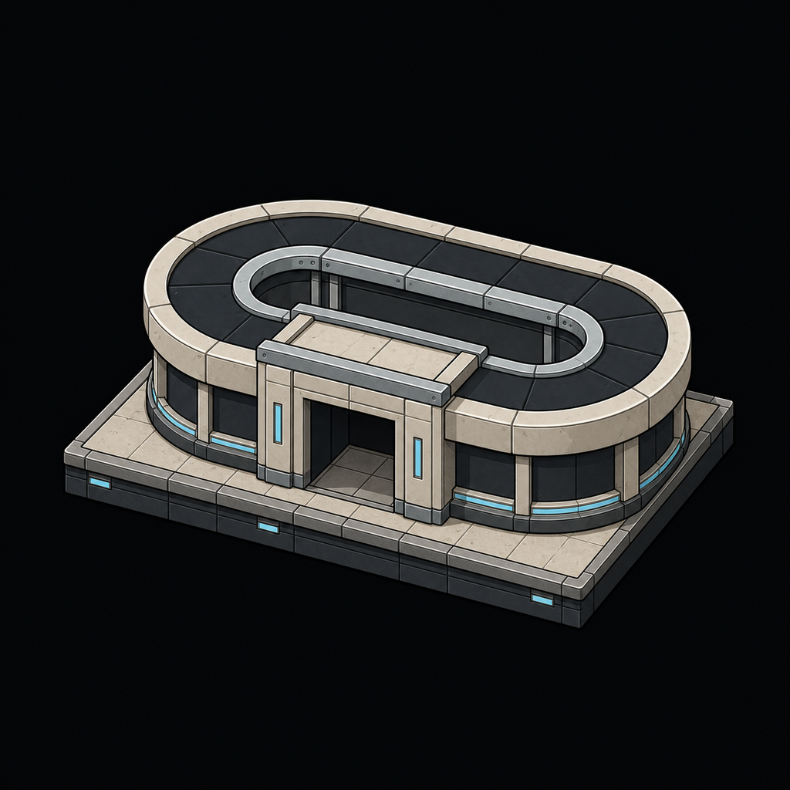
Assets/GridCity/StreetV3/source/transit-northloop-station.png
