Ha22yX/Gridopoly/Assets/GridCity/StreetV3/source/transit-southline-depot.png

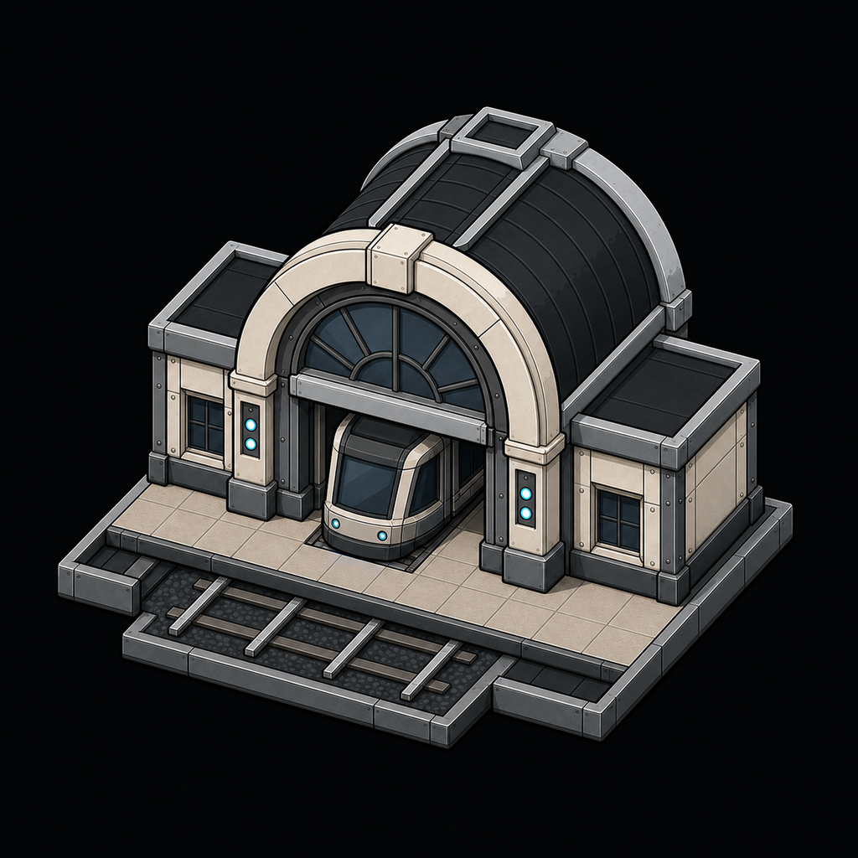
Assets/GridCity/StreetV3/source/transit-southline-depot.png
