Ha22yX/Gridopoly/Assets/GridCity/UnifiedV2/source/02-civic-grant.png

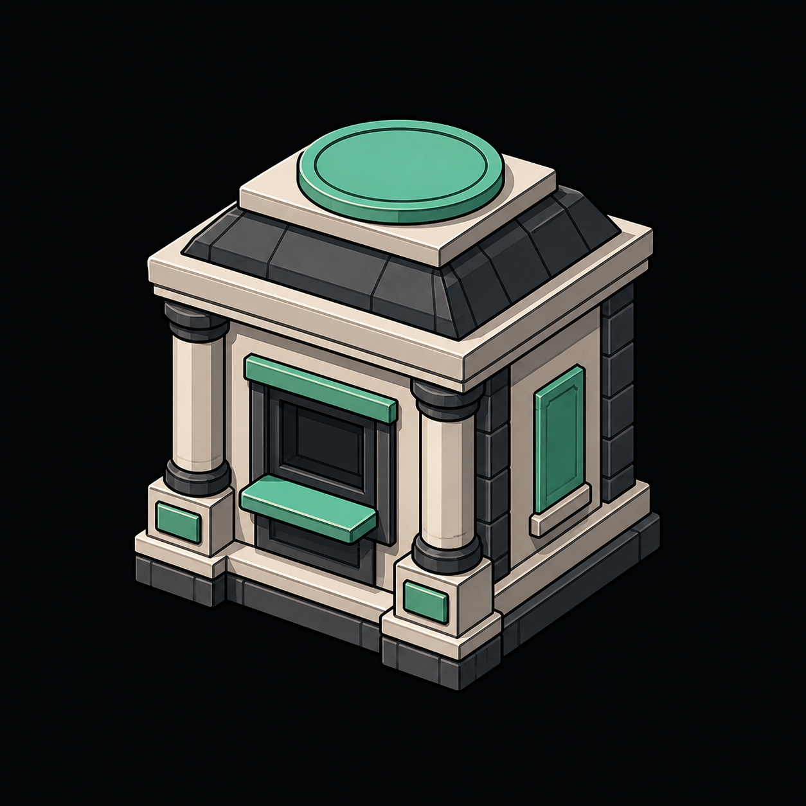
Assets/GridCity/UnifiedV2/source/02-civic-grant.png
