Ha22yX/Gridopoly/Assets/GridCity/UnifiedV2/source/03-copper-yard.png

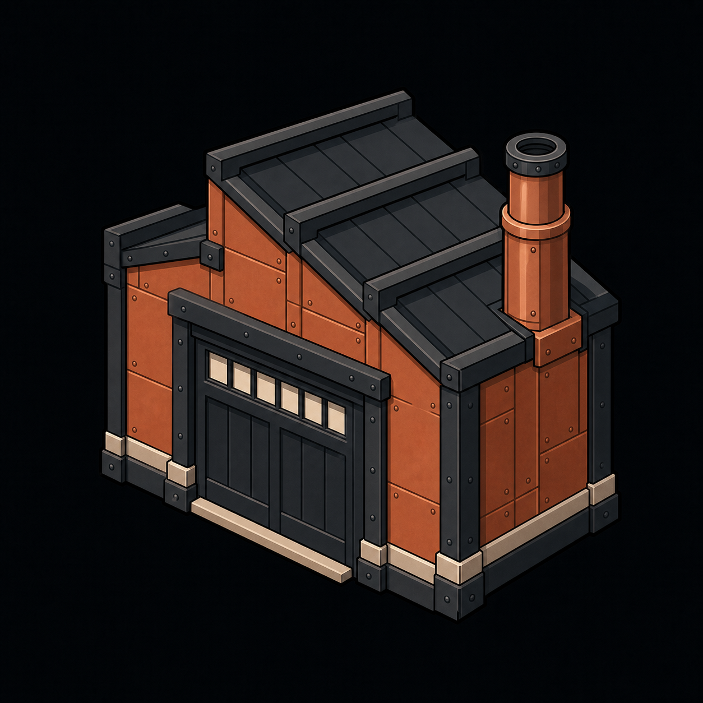
Assets/GridCity/UnifiedV2/source/03-copper-yard.png
