Ha22yX/Gridopoly/Assets/GridCity/UnifiedV2/source/08-tideway-commons.png

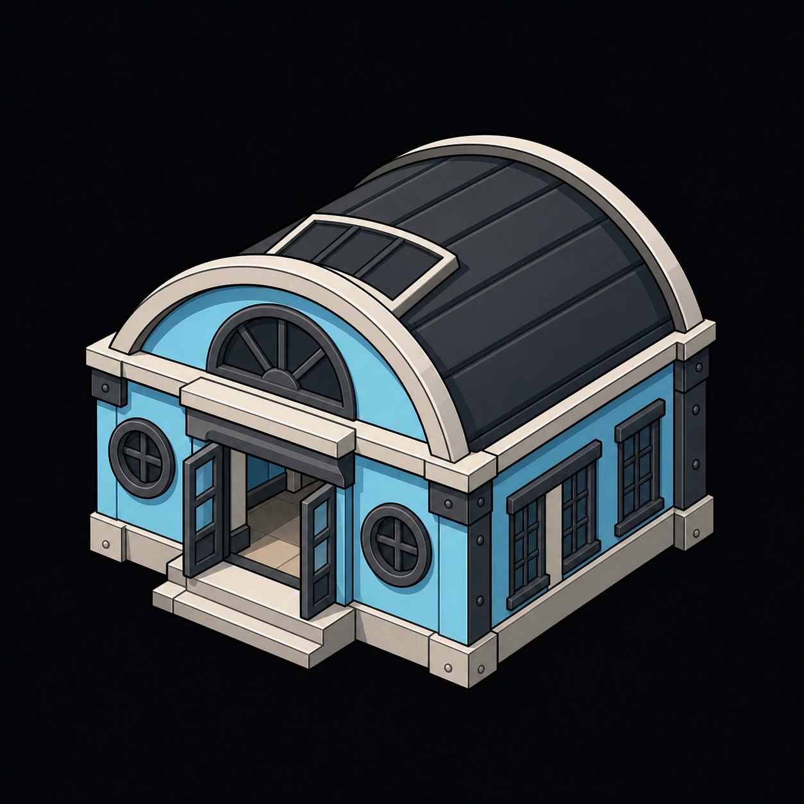
Assets/GridCity/UnifiedV2/source/08-tideway-commons.png
