Ha22yX/Gridopoly/Assets/GridCity/UnifiedV2/source/09-beacon-arcade.png

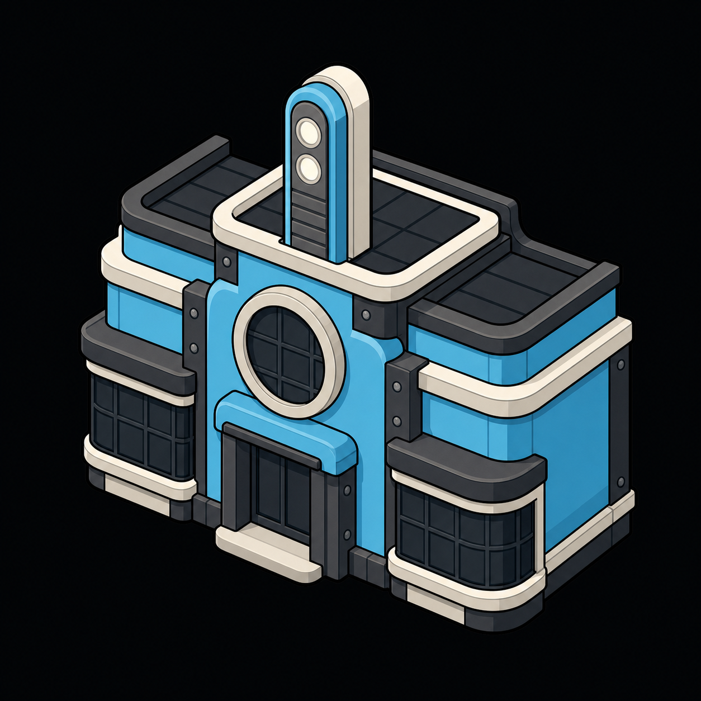
Assets/GridCity/UnifiedV2/source/09-beacon-arcade.png
