Ha22yX/Gridopoly/Assets/GridCity/UnifiedV2/source/11-canvas-court.png

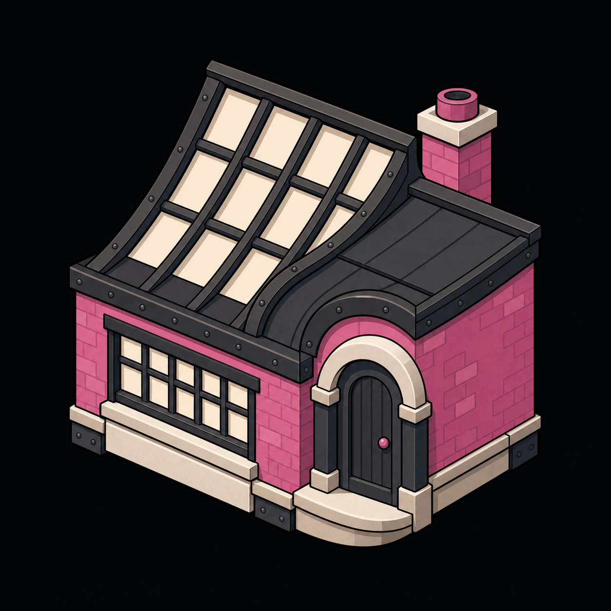
Assets/GridCity/UnifiedV2/source/11-canvas-court.png
