Ha22yX/Gridopoly/Assets/GridCity/UnifiedV2/source/17-neighborhood-fund.png

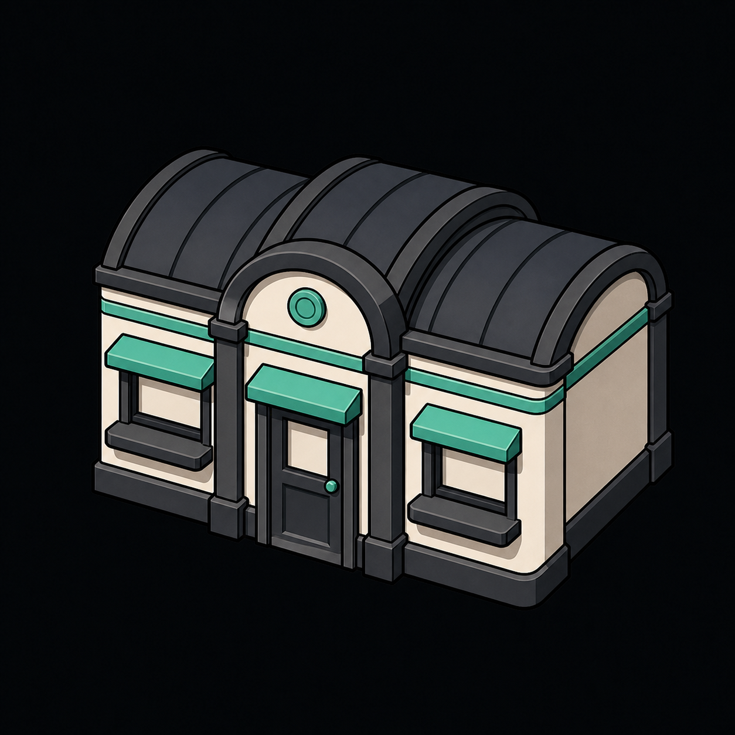
Assets/GridCity/UnifiedV2/source/17-neighborhood-fund.png
