Ha22yX/Gridopoly/Assets/GridCity/UnifiedV2/source/18-forum-library.png

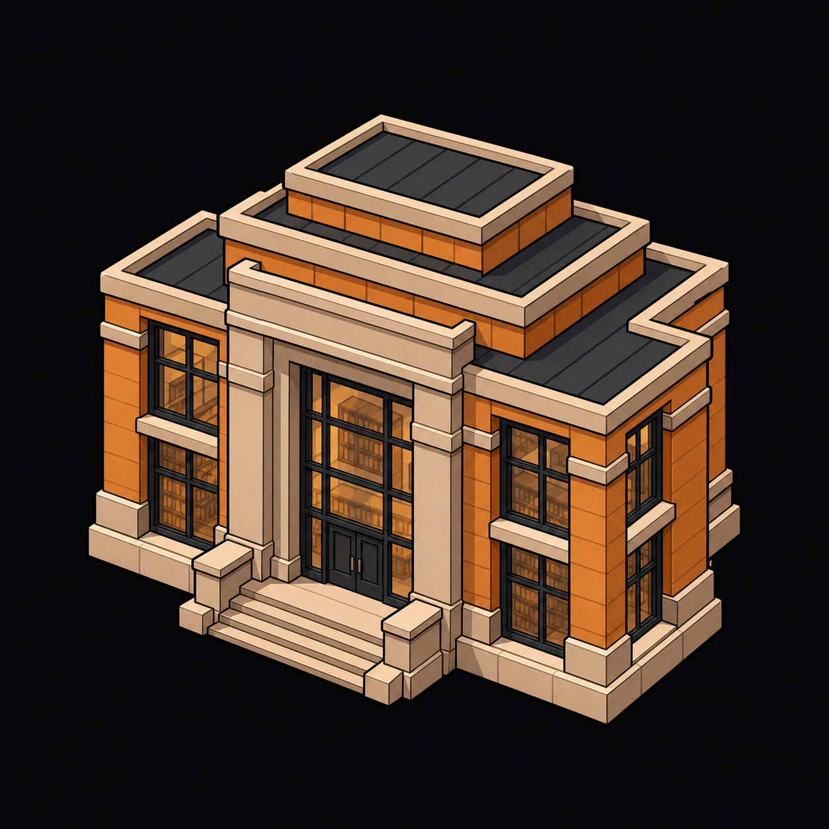
Assets/GridCity/UnifiedV2/source/18-forum-library.png
