Ha22yX/Gridopoly/Assets/GridCity/UnifiedV2/source/24-nova-commerce-center.png

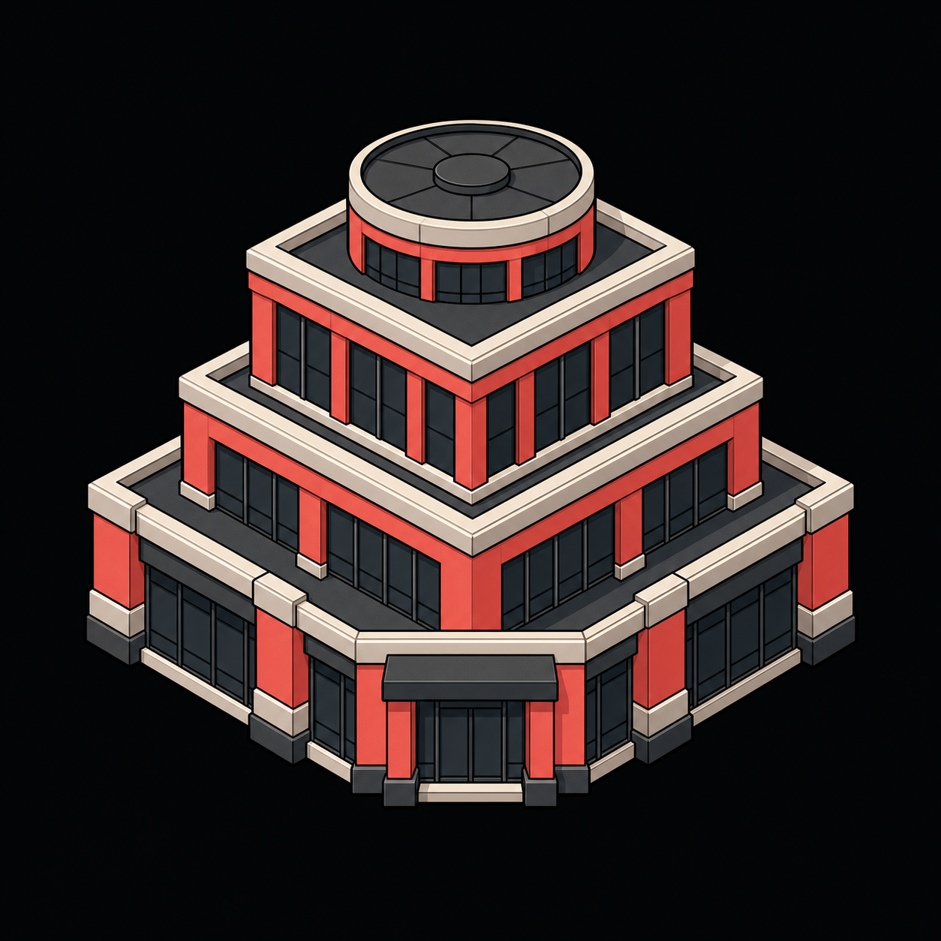
Assets/GridCity/UnifiedV2/source/24-nova-commerce-center.png
