Ha22yX/Gridopoly/Assets/GridCity/UnifiedV2/source/26-sunstep-terrace.png

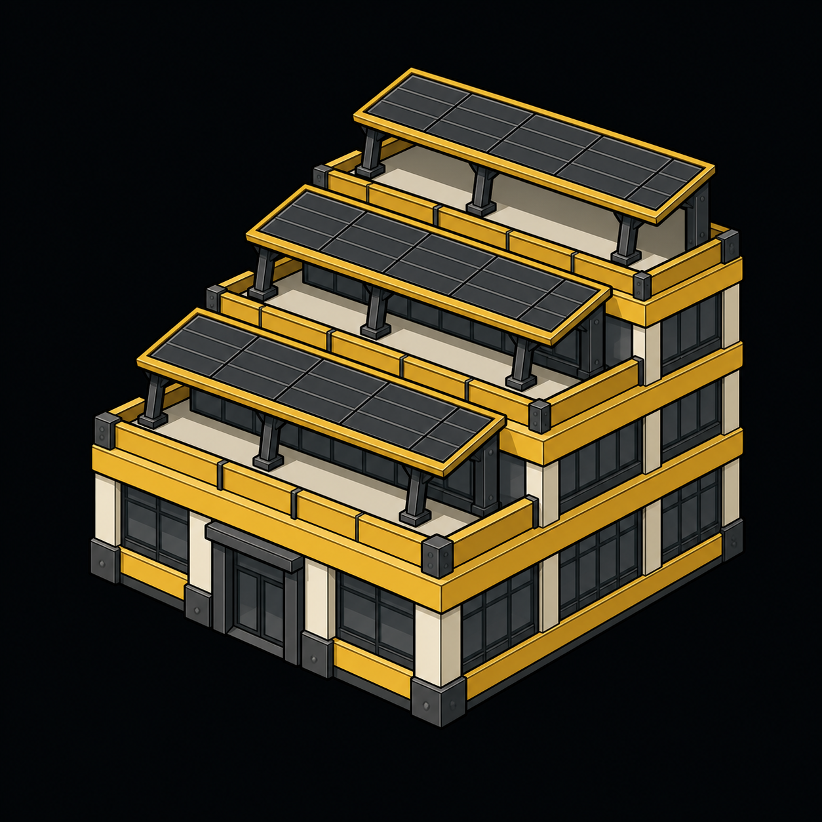
Assets/GridCity/UnifiedV2/source/26-sunstep-terrace.png
