Ha22yX/Gridopoly/Assets/GridCity/UnifiedV2/source/29-horizon-labs.png

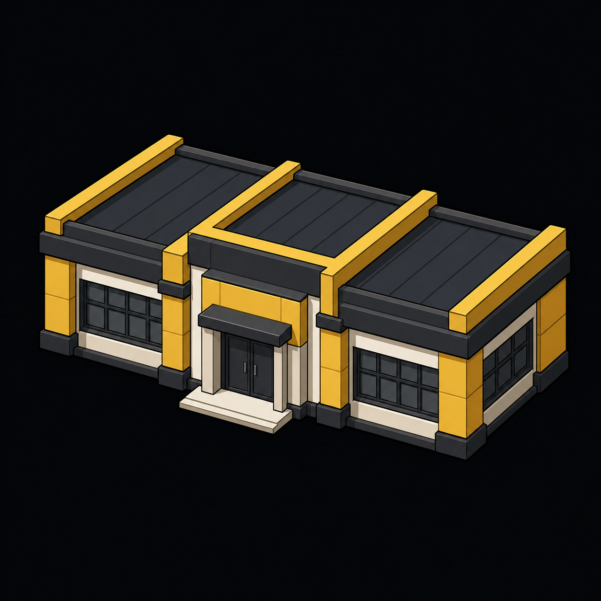
Assets/GridCity/UnifiedV2/source/29-horizon-labs.png
