Ha22yX/Gridopoly/Assets/GridCity/UnifiedV2/source/32-verdant-spire.png

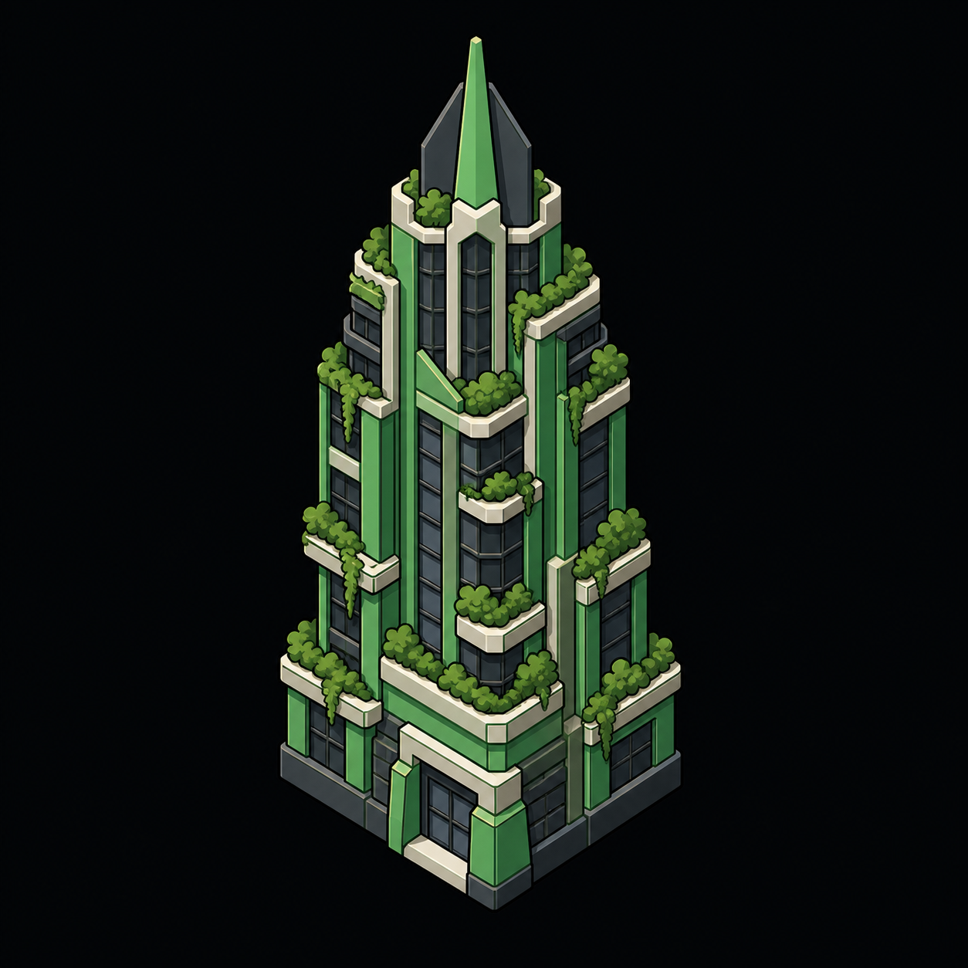
Assets/GridCity/UnifiedV2/source/32-verdant-spire.png
