Ha22yX/Gridopoly/Mechanical/BoardBase/deliverables/Gridopoly_BoardBase_Full16_R1/01_full_frame.png

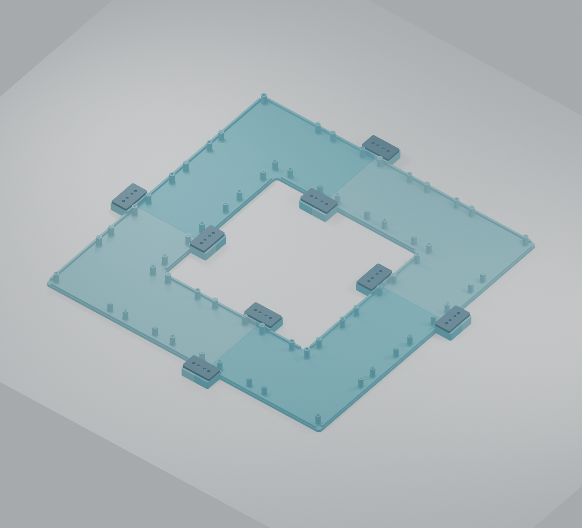
Mechanical/BoardBase/deliverables/Gridopoly_BoardBase_Full16_R1/01_full_frame.png
