Ha22yX/Gridopoly/Mechanical/BoardBase/deliverables/Gridopoly_BoardBase_Full16_R1/02_with_16_pcbs_reference.png

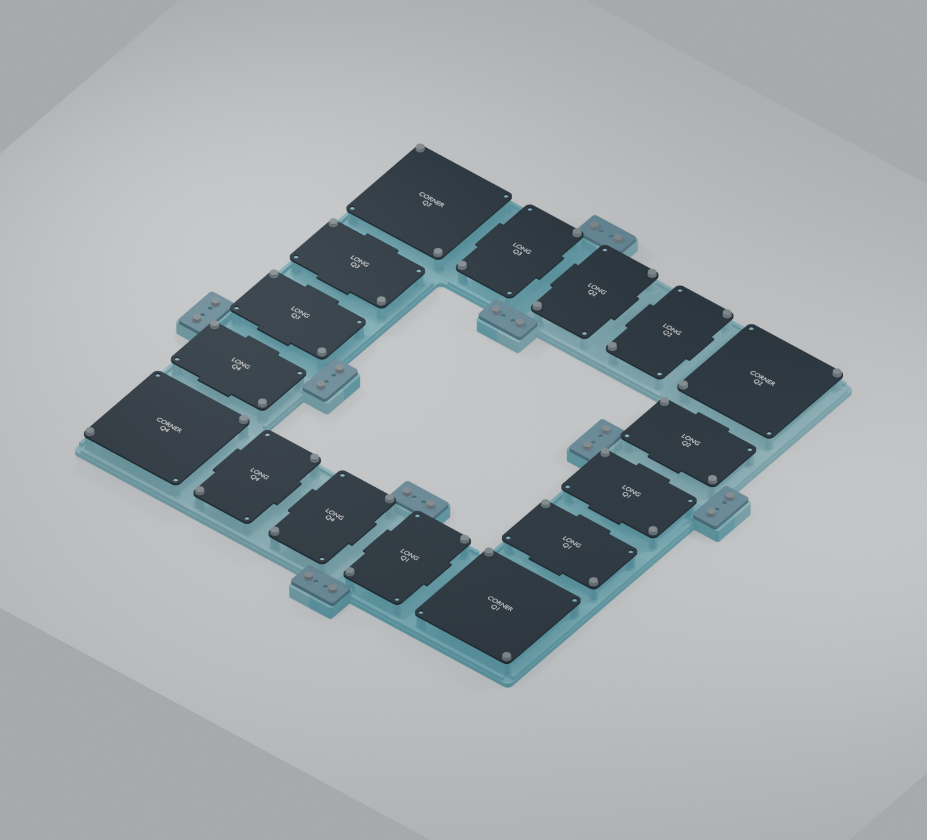
Mechanical/BoardBase/deliverables/Gridopoly_BoardBase_Full16_R1/02_with_16_pcbs_reference.png
