Ha22yX/Gridopoly/Mechanical/BoardBase/deliverables/Gridopoly_BoardBase_Full16_R1/03_top_layout.png

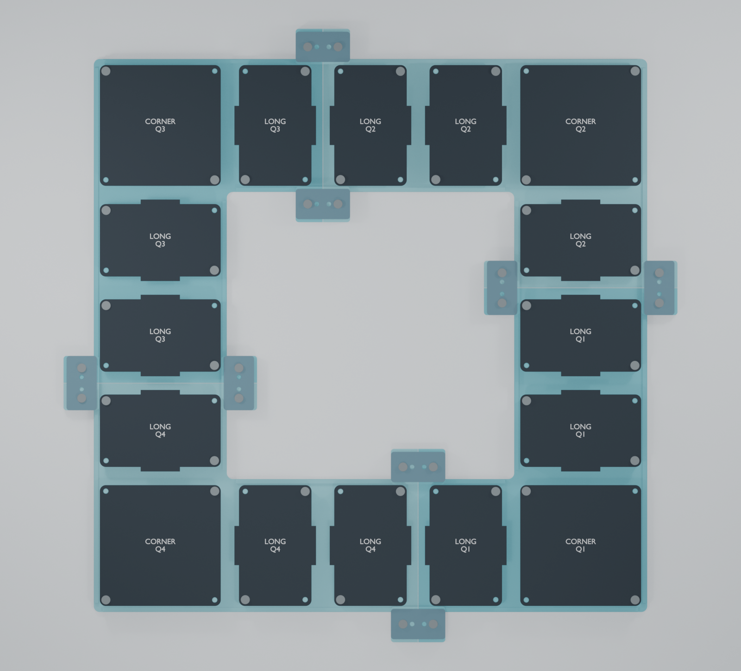
Mechanical/BoardBase/deliverables/Gridopoly_BoardBase_Full16_R1/03_top_layout.png
