Ha22yX/Gridopoly/Mechanical/BoardBase/deliverables/Gridopoly_BoardBase_Full16_R1/05_joint_detail.png

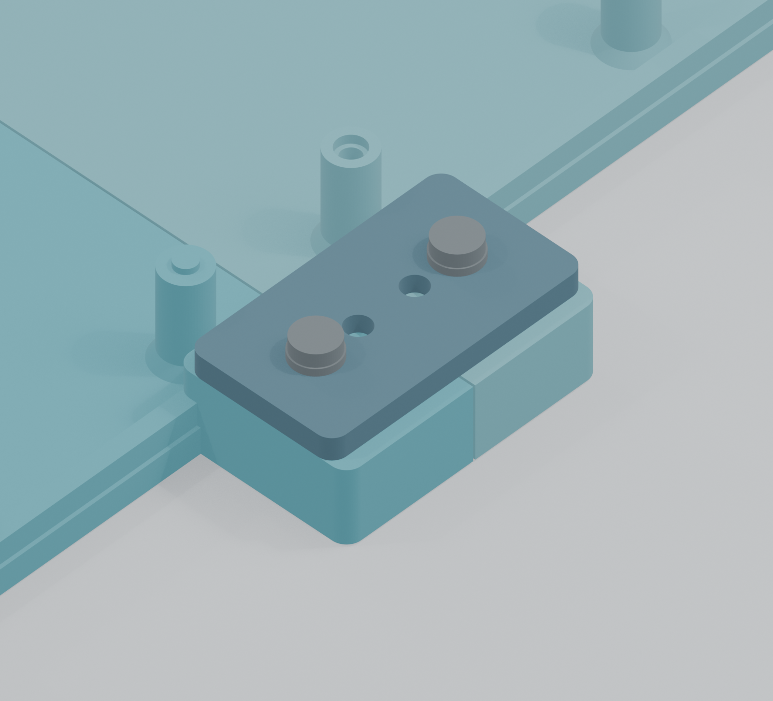
Mechanical/BoardBase/deliverables/Gridopoly_BoardBase_Full16_R1/05_joint_detail.png
