Ha22yX/Gridopoly/Mechanical/BoardBase/interfaces/pcb-interface-2026-10-15/reviews/layout-review/long-actual-bottom-support-map.png

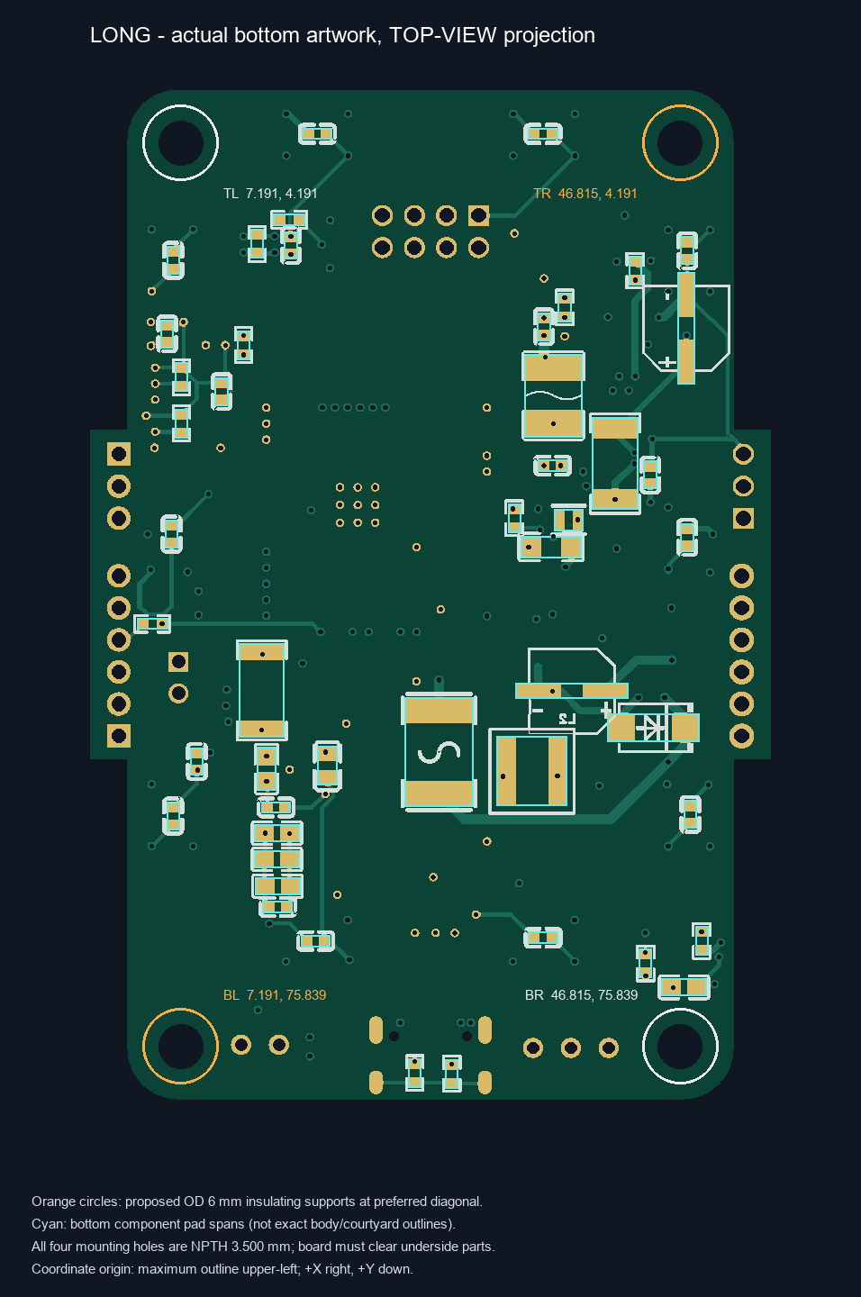
Mechanical/BoardBase/interfaces/pcb-interface-2026-10-15/reviews/layout-review/long-actual-bottom-support-map.png
