Ha22yX/Gridopoly/Mechanical/BoardBase/references/fit-photos-2026-10-15/1-Photo-1.jpg

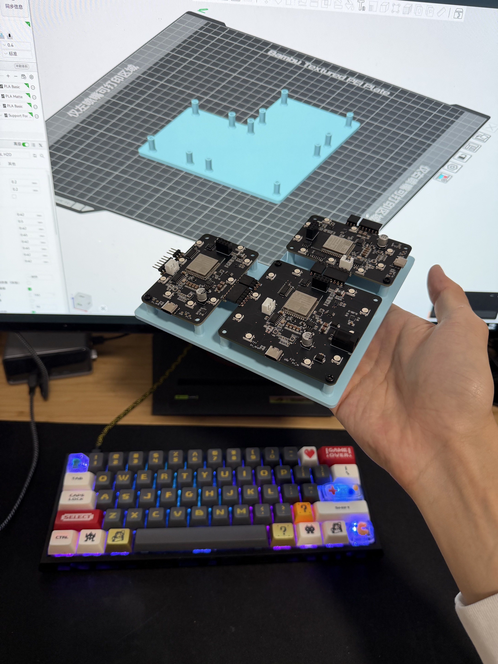
Mechanical/BoardBase/references/fit-photos-2026-10-15/1-Photo-1.jpg
