Ha22yX/Gridopoly/Mechanical/BoardBase/references/fit-photos-2026-10-15/3-Photo-3.jpg

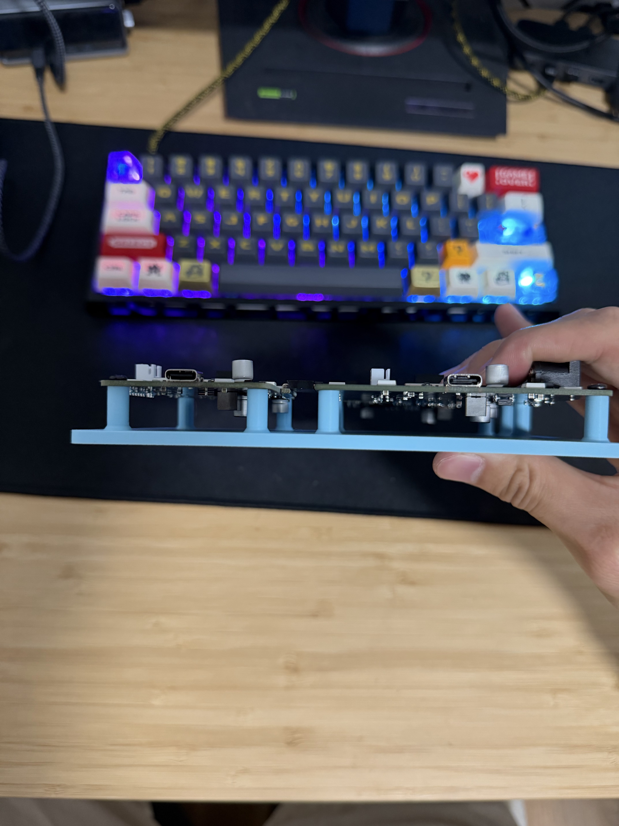
Mechanical/BoardBase/references/fit-photos-2026-10-15/3-Photo-3.jpg
