Ha22yX/Gridopoly/Mechanical/PlayerConsoleStand/outputs/renders/Gridopoly_Player_Console_Stand_CW50_interface.png

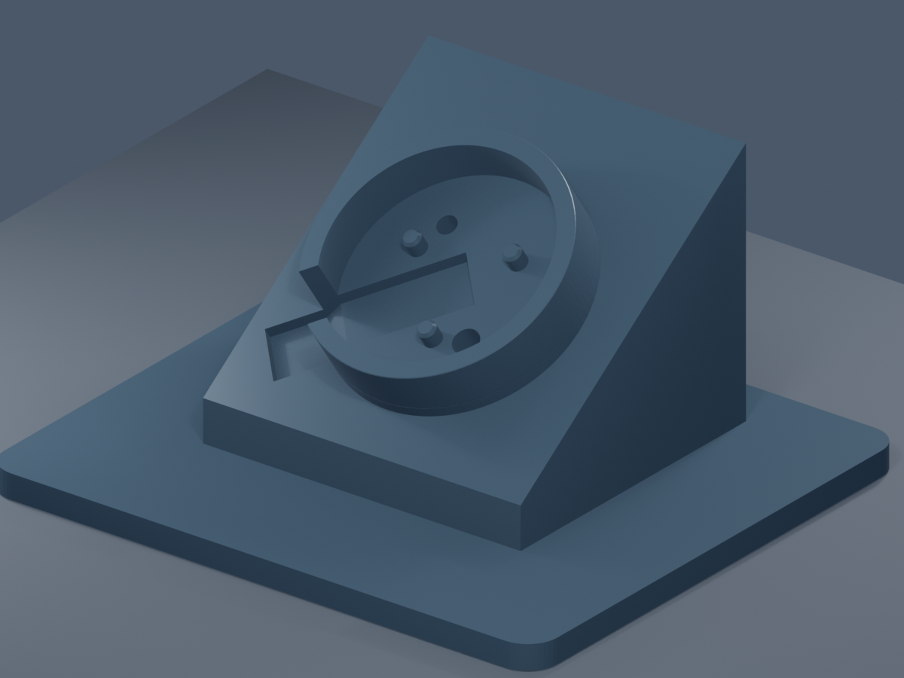
Mechanical/PlayerConsoleStand/outputs/renders/Gridopoly_Player_Console_Stand_CW50_interface.png
