Ha22yX/Gridopoly/Mechanical/PlayerConsoleStandV2/deliverables/Gridopoly_Player_Stand_V2_R1/03_Tray_Access.png

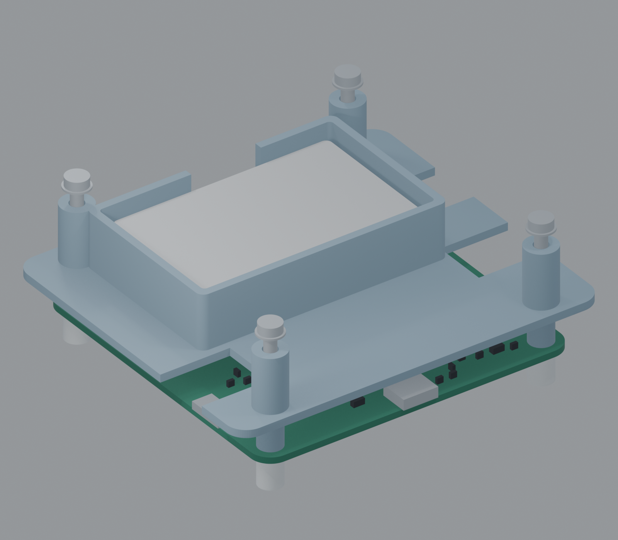
Mechanical/PlayerConsoleStandV2/deliverables/Gridopoly_Player_Stand_V2_R1/03_Tray_Access.png
