Ha22yX/Gridopoly/Mechanical/PlayerConsoleStandV2/deliverables/Gridopoly_Player_Stand_V2_R1/04_PCB_Access.png

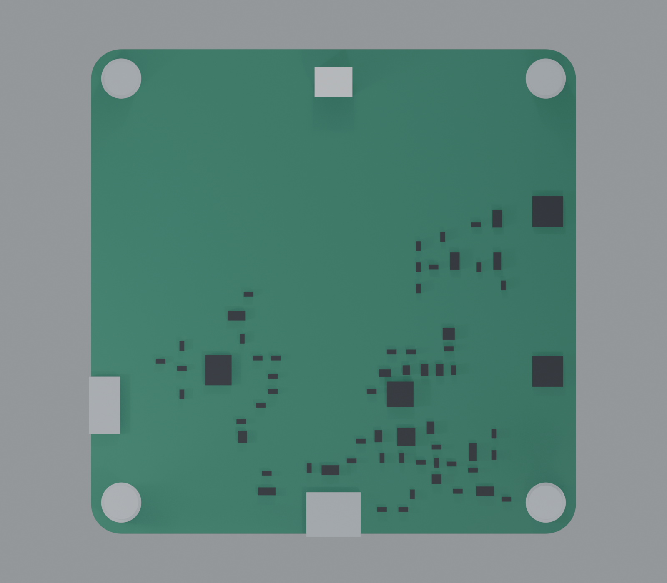
Mechanical/PlayerConsoleStandV2/deliverables/Gridopoly_Player_Stand_V2_R1/04_PCB_Access.png
