Ha22yX/Gridopoly/Mechanical/PlayerConsoleStandV2/deliverables/Gridopoly_Player_Stand_V2_R3_EAR_REINFORCED/preview-left-foot-R2-before.png

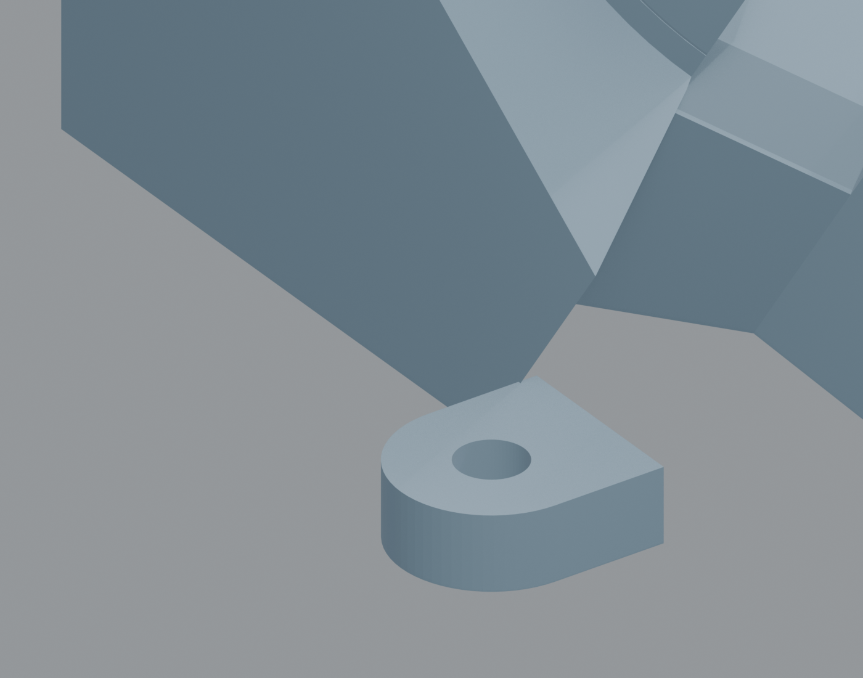
Mechanical/PlayerConsoleStandV2/deliverables/Gridopoly_Player_Stand_V2_R3_EAR_REINFORCED/preview-left-foot-R2-before.png
