Ha22yX/Gridopoly/Mechanical/PlayerConsoleStandV2/interfaces/player-power-2026-10-15/jst-ph-p3-reference.png

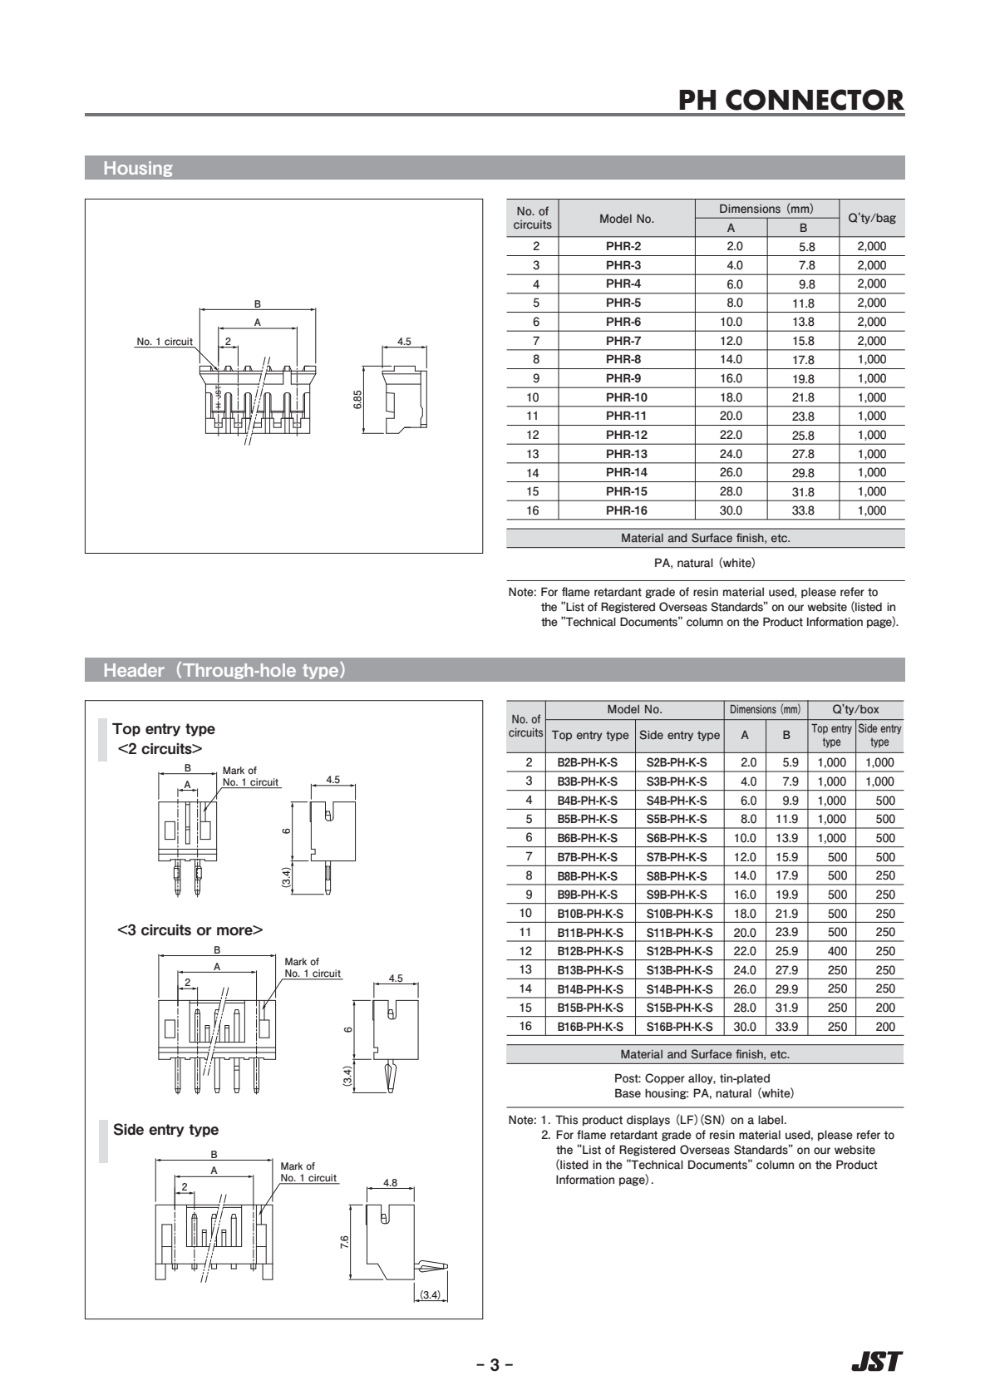
Mechanical/PlayerConsoleStandV2/interfaces/player-power-2026-10-15/jst-ph-p3-reference.png
