Ha22yX/Gridopoly/Mechanical/PlayerTokens/models/hi3d-30mm/deliverables/Hi3D_30mm/Hi3D_30mm_preview.png

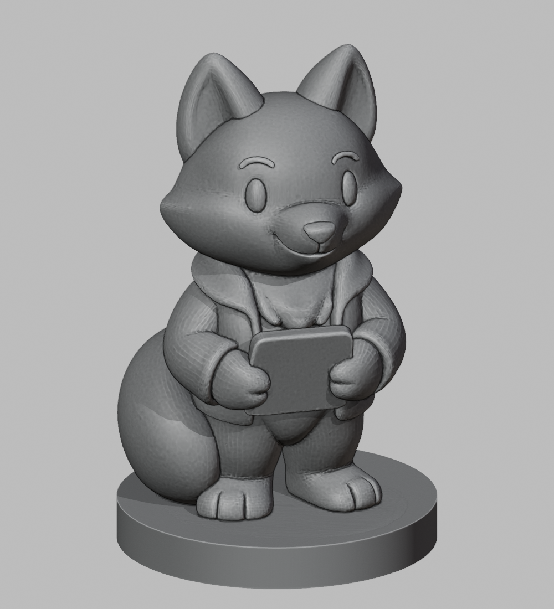
Mechanical/PlayerTokens/models/hi3d-30mm/deliverables/Hi3D_30mm/Hi3D_30mm_preview.png
