Ha22yX/Gridopoly/Mechanical/PlayerTokens/models/hi3d-remaining-30mm/deliverables/Gridopoly_30mm_Remaining/Owl_30mm_preview.png

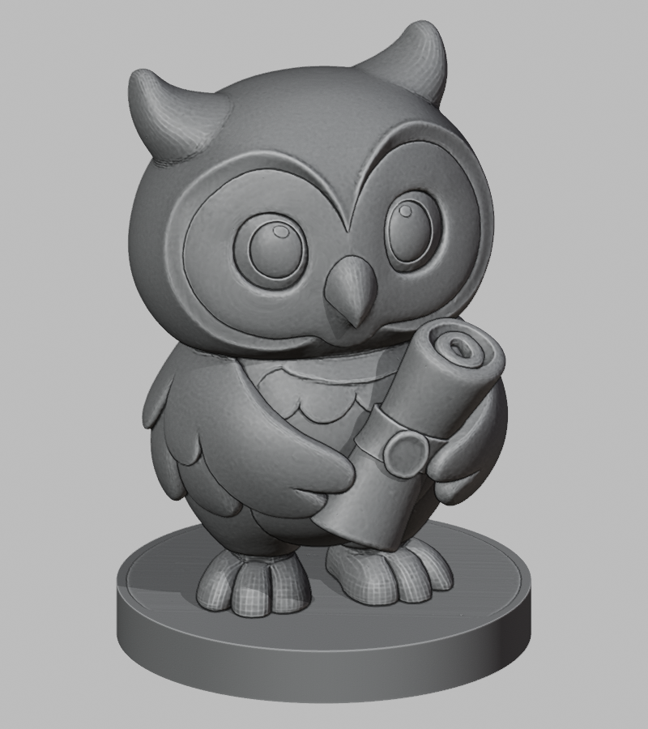
Mechanical/PlayerTokens/models/hi3d-remaining-30mm/deliverables/Gridopoly_30mm_Remaining/Owl_30mm_preview.png
