Ha22yX/Gridopoly/Mechanical/PlayerTokens/models/hi3d-remaining-30mm/deliverables/Gridopoly_30mm_Remaining/Three_Tokens_Blender_Overview.png

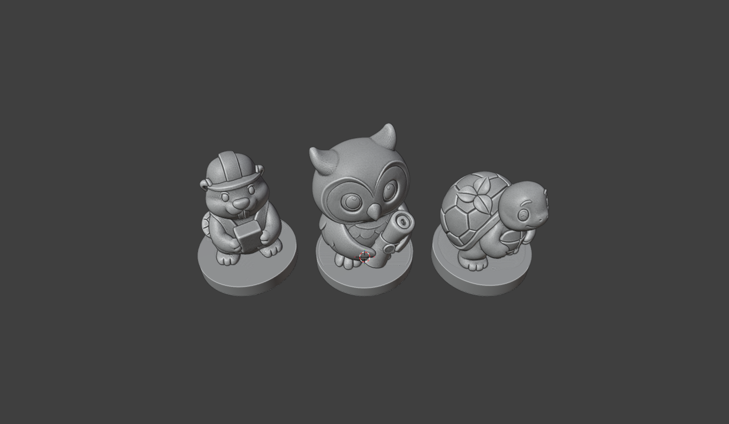
Mechanical/PlayerTokens/models/hi3d-remaining-30mm/deliverables/Gridopoly_30mm_Remaining/Three_Tokens_Blender_Overview.png
