Ha22yX/Gridopoly/Mechanical/PlayerTokens/references/animal-team-monochrome-v2/01-fox-trader.png

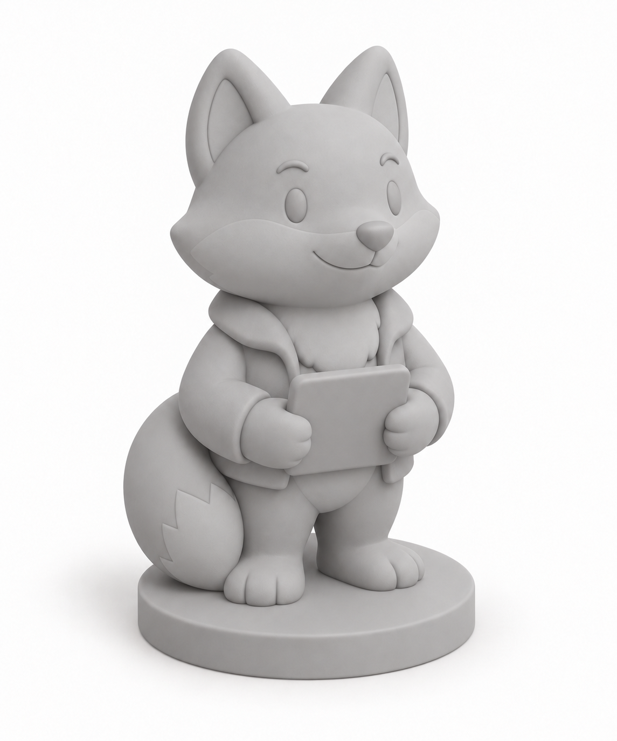
Mechanical/PlayerTokens/references/animal-team-monochrome-v2/01-fox-trader.png
