Ha22yX/Gridopoly/Mechanical/PlayerTokens/references/animal-team-monochrome-v2/03-owl-planner.png

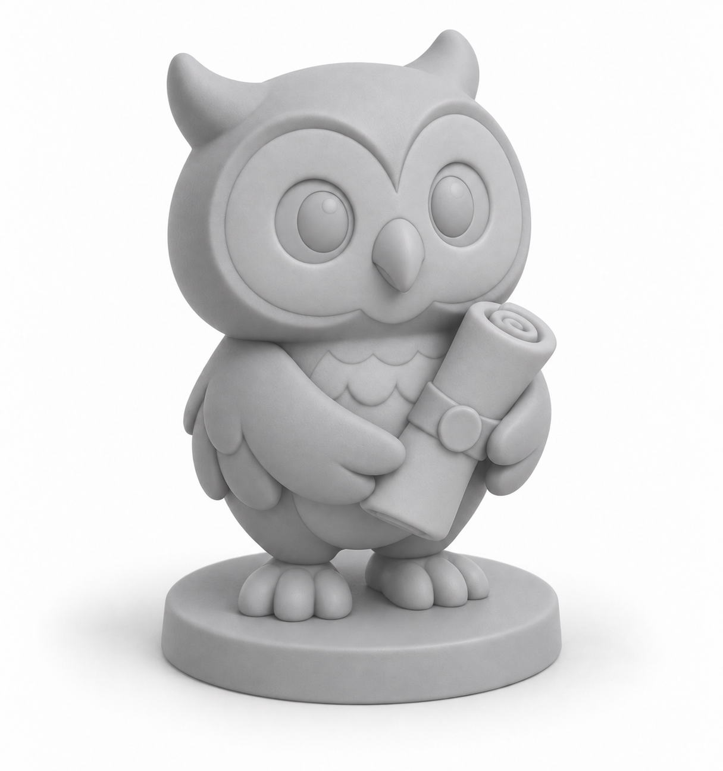
Mechanical/PlayerTokens/references/animal-team-monochrome-v2/03-owl-planner.png
