Ha22yX/Gridopoly/Mechanical/PlayerTokens/references/animal-team-monochrome-v2/04-turtle-gardener.png

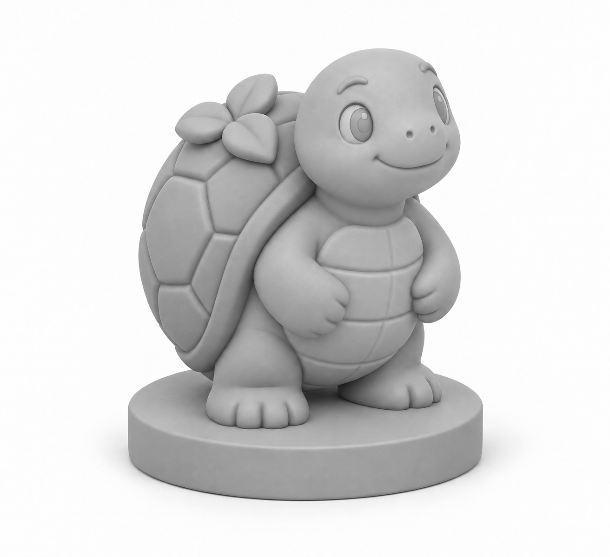
Mechanical/PlayerTokens/references/animal-team-monochrome-v2/04-turtle-gardener.png
