Ha22yX/Gridopoly/Mechanical/PlayerTokens/references/animal-team-v1/01-fox-trader.png

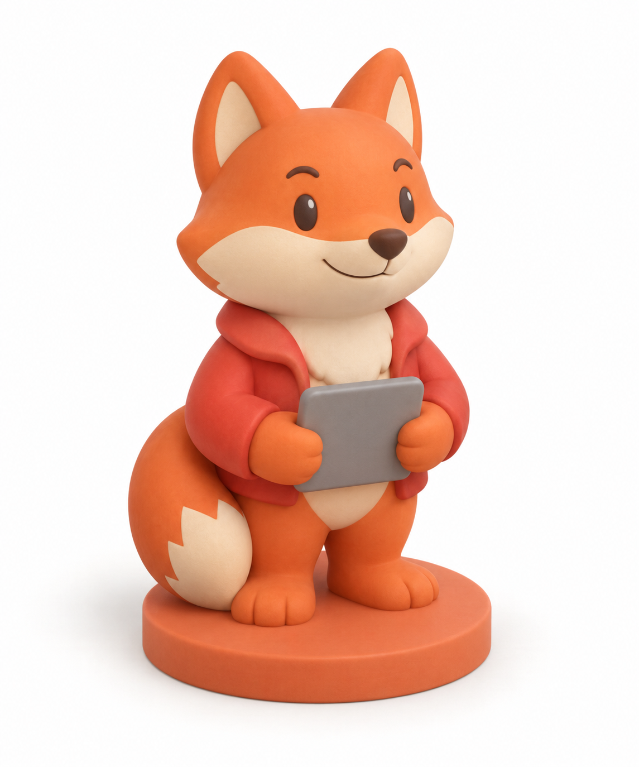
Mechanical/PlayerTokens/references/animal-team-v1/01-fox-trader.png
