Ha22yX/Gridopoly/Mechanical/PlayerTokens/references/animal-team-v1/04-turtle-gardener.png

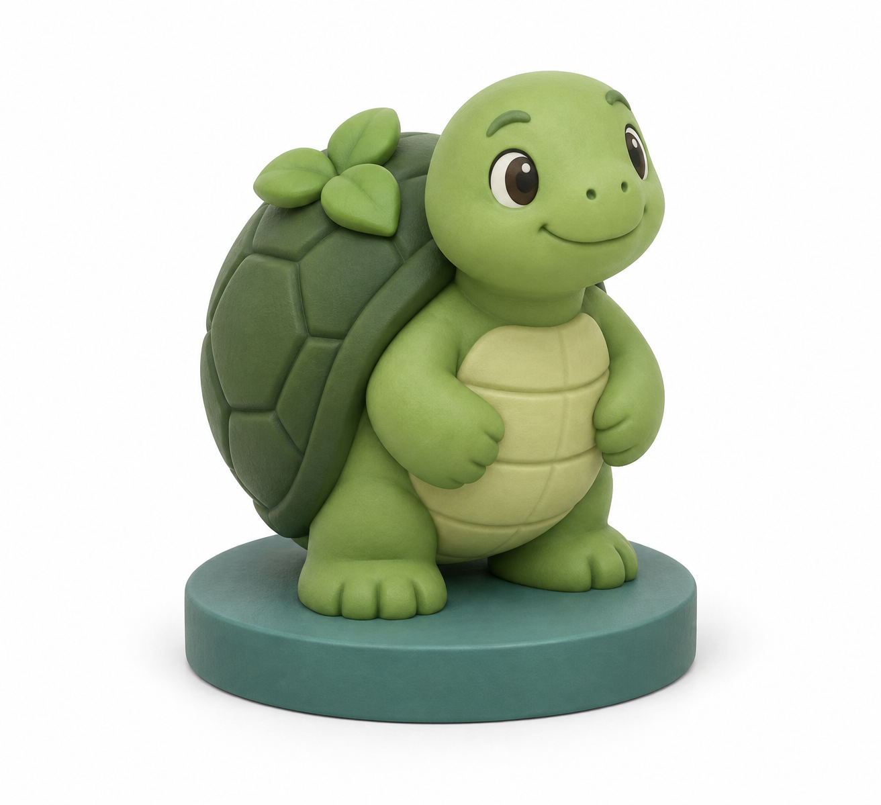
Mechanical/PlayerTokens/references/animal-team-v1/04-turtle-gardener.png
