Ha22yX/Gridopoly/PCB Files/PlayerConsolePower/DesignDraft-2026-09-27/fpc-orientation.png

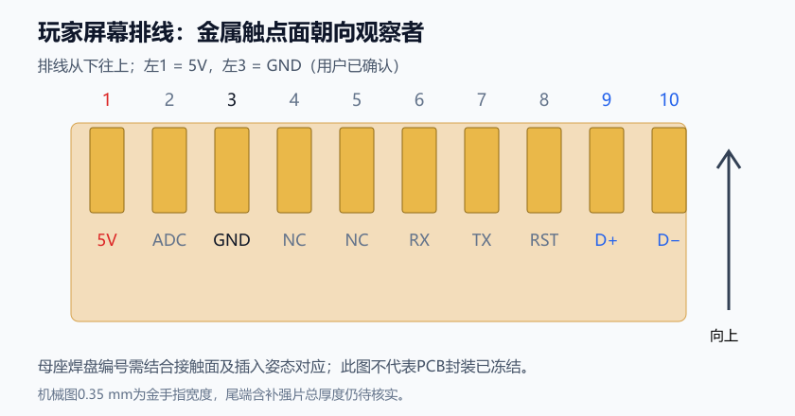
PCB Files/PlayerConsolePower/DesignDraft-2026-09-27/fpc-orientation.png
