Ha22yX/Gridopoly/PCB Files/PlayerConsolePower/ProductionReadiness-2026-10-14/screen-viewe-schematic-landscape.png

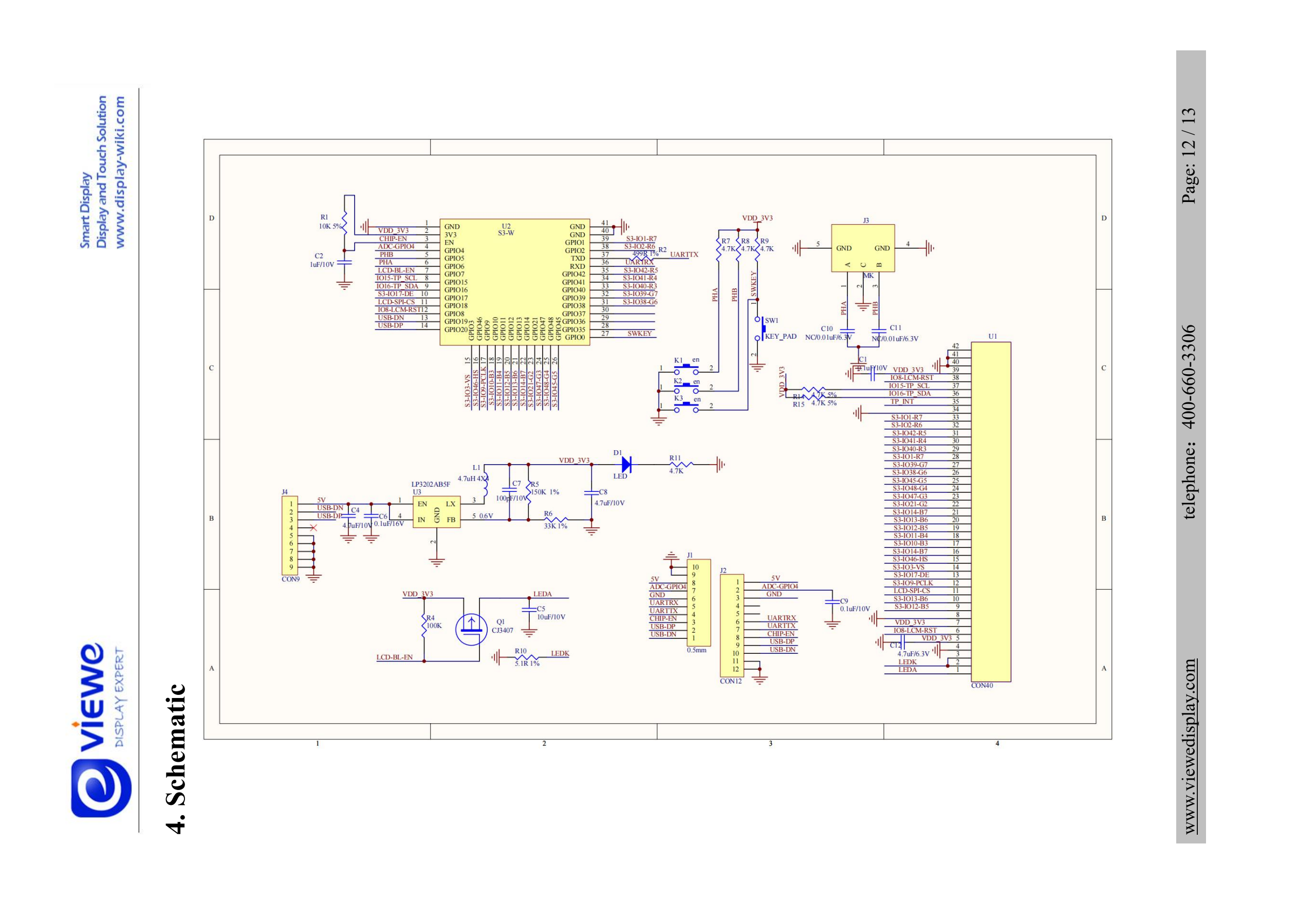
PCB Files/PlayerConsolePower/ProductionReadiness-2026-10-14/screen-viewe-schematic-landscape.png
