Ha22yX/Gridopoly/PCB Files/PlayerConsolePower/ProductionReadiness-2026-10-14/source-bom-cpl-consistency.md

# 原理图、PCB、实时焊盘、BOM/CPL 一致性审查

日期：2026-10-14（America/New_York）；实时快照：2026-10-15T02:55:10.983Z。本轮只读本地五份已导出文件，未调用桥接、未改源工程。

**结果：PASS，发现差异 0 项。** 这表示文件之间一致，不表示器件库参数、实物方向或电气功能全部正确。

| 比较项目 | 数量/结果 |
| --- | --- |
| 原理图 / PCB / 实时器件 / 展开BOM / CPL位号 | 均68，位号集合一致，无重复 |
| 原理图引脚 / PCB引脚 / 实时封装焊盘 | 均243，编号与每脚字面网络一致 |
| 非空命名网络 / 空网络端点 | 41 / 21 |
| BOM原始分组 / 合计数量 | 30组 / 68件，逐行数量与位号数一致 |
| SCH与PCB的MPN、供应商编号、封装ID/名、Device ID/名、Value | 68件一致 |
| BOM的MPN、供应商编号、封装名、Value | 展开68件一致 |
| CPL的Device、封装名、Value、注释、供应商、引脚数量 | 68件一致 |
| CPL中心和参考坐标 | mil×0.0254且保留Y符号；最大误差0.000001260mm，低于0.000051mm舍入容差 |
| CPL角度 | 68件按模360一致，−90°与270°视为相同 |
| CPL面层 | 68件均T，对应实时layer 1与PCB TopLayer |

## NC与别名规则

空网络串不代表一个共同的网络。21个空串引脚分别以位号.脚号标识，比较时只确认同一端点在三份数据里均未分配网络；没有把这些端点相互连通。本轮没有为了通过而将不同的NC/$1N/$2N等别名折叠。任何非空名称都按字面保持独立；如果其中存在实际铜连接，须由独立Gerber几何审查发现。

NC端点：J1.B8, J1.A8, J2.6, J2.7, J2.9, U1.15, U3.4, U5.5, U5.6, U5.8, U5.9, U6.4, U7.3, U7.4, U8.4, U9.5, U9.6, U9.7, U9.8, U9.14, U10.5。

## 差异和证据边界

无内容/电气/坐标差异；浮点及导出末位舍入在上述阈值内。

native-BOM.csv和native-CPL.csv实际为TSV，本次按制表符及引号解析。BOM/CPL不携带封装ID，只能核对其封装名；封装ID比较来自SCH/PCB网表。实时快照不携带MPN，使用其唯一ID、焊盘与位置完成对应，未虚构该字段检查。

这项检查不解决供应商库属性是否准确、库符号物理脚序是否正确、Gerber铜是否符合网表、贴装极性、热/电源/USB性能、实物测试，以及订单是否使用这份包。相关结论必须分别引用对应审查。

完整逐件字段、243端点对应的命名网络/21项NC清单、比较次数及五份输入SHA-256，见同目录[source-bom-cpl-consistency.json](source-bom-cpl-consistency.json)。
