Ha22yX/Gridopoly/PCB Files/PlayerConsolePower/DesignDraft-2026-09-27/bom-draft.csv

Designators | LCSC | MPN | Description | Footprint | Per board | For 10 boards | SMT stock snapshot | Manufacturing released
U1 | C54313 | BQ24074RGTR | 1.5A USB友好型锂离子电池充电器和电源路径管理IC | QFN-16_L3.0-W3.0-P0.50-TL-EP1.7 | 1 | 10 | 816 | NO
U2 | C919459 | TPS61023DRLR | 升压型 3A 500mV~5.5V | SOT-563_L1.6-W1.2-P0.50-LS1.6-BR | 1 | 10 | 37516 | NO
U3 | C79401 | MAX16054AZT+T | 带去抖动和±15kV ESD保护的开/关控制器 | TSOT-23-6_L2.9-W1.6-P0.95-LS2.8-TL | 1 | 10 | 1946 | NO
U4 | C19653 | TPS3808G01DBVR | 低静态电流、可编程延迟监控电路 | SOT-23-6_L2.9-W1.6-P0.95-LS2.8-BR | 1 | 10 | 18221 | NO
C1, C11, C12, C14, C15 | C15849 | CL10A105KB8NNNC | 1uF ±10% 50V | C0603 | 5 | 50 | 6786794 | NO
C2, C3, C7, C8, C9 | C15850 | CL21A106KAYNNNE | 10uF ±10% 25V | C0805 | 5 | 50 | 5536601 | NO
R1 | C22849 | 0603WAF1781T5E | 厚膜电阻 1.78kΩ ±1% | R0603 | 1 | 10 | 18748 | NO
R2 | C4177 | 0603WAF1801T5E | 厚膜电阻 1.8kΩ ±1% | R0603 | 1 | 10 | 418914 | NO
C4, C6, C10, C13, C16, C17, C18, C19, C20 | C1591 | CL10B104KB8NNNC | 100nF ±10% 50V | C0603 | 9 | 90 | 1866601 | NO
R3 | C23237 | 0603WAF7153T5E | 715kΩ ±1% 100mW 厚膜电阻 | R0603 | 1 | 10 | 3532 | NO
R4, R5, R6, R7, R8, R10, R16, R17, R18, R19 | C25803 | 0603WAF1003T5E | 厚膜电阻 100kΩ ±1% | R0603 | 10 | 100 | 22815271 | NO
C5 | C1589 | CL10B103KB8NNNC | 10nF ±10% 50V | C0603 | 1 | 10 | 2120989 | NO
Q1, Q3 | C8545 | 2N7002 | 1个N沟道 耐压:60V 电流:115mA | SOT-23-3_L2.9-W1.3-P1.90-LS2.4-BR | 2 | 20 | 1750780 | NO
SW1, SW2 | C318884 | TS-1187A-B-A-B | 5.1*5.1*1.5mm 立贴 轻触开关 | SW-SMD_4P-L5.1-W5.1-P3.70-LS6.5-TL_H1.5 | 2 | 20 | 576056 | NO
L1 | C408332 | MWSA0402S-1R0MT | 1uH ±20% 7A | IND-SMD_L4.4-W4.2 | 1 | 10 | 20229 | NO
R9 | C23239 | 0603WAF7323T5E | 厚膜电阻 732kΩ ±1% | R0603 | 1 | 10 | 21650 | NO
R20 | C23231 | 0603WAF6802T5E | 68kΩ ±1% 100mW 厚膜电阻 | R0603 | 1 | 10 | 1068940 | NO
U5 | C132554 | TUSB320LAIRWBR | USB Type-C 配置通道逻辑和端口控制器 | X2QFN-12_L1.6-W1.6-P0.40-TL | 1 | 10 | 3783 | NO
J1 | C165948 | TYPE-C-31-M-12 | Type-C 母 卧贴 | USB-C_SMD-TYPE-C-31-M-12_1 | 1 | 10 | 449835 | NO
U6, U8 | C51118 | AP2112K-3.3TRG1 | 3.3V 600mA 6V | SOT-25-5_L2.9-W1.6-P0.95-LS2.8-BL | 2 | 20 | 42274 | NO
Q2 | C2143 | MMBT3906 2A(RANGE:100-300) | hfe=100~300 PNP 电流:0.2A 电压:40V | SOT-23-3_L2.9-W1.3-P1.90-LS2.4-BR | 1 | 10 | 261180 | NO
D1 | C7519 | USBLC6-2SC6 | 单向ESD 5.25V截止 峰值脉冲电流：5A | SOT-23-6_L2.9-W1.6-P0.95-LS2.8-BL | 1 | 10 | 44267 | NO
U7 | C128396 | TS3USB221ARSER | TS3USB221A ESD保护、高速USB2.0 (480-Mbps) 1:2多路复用器和解复用器开关，带单使能 | UQFN-10_L2.0-W1.5-P0.50-BL | 1 | 10 | 92234 | NO
R11, R12, R13 | C23024 | 0603WAF3003T5E | 300kΩ ±1% 100mW 厚膜电阻 | R0603 | 3 | 30 | 597968 | NO
R14, R15, R21, R24, R25, R26, R27, R28 | C25804 | 0603WAF1002T5E | 厚膜电阻 10kΩ ±1% 100mW | R0603 | 8 | 80 | 22870241 | NO
U9 | C5190383 | SC18IM704PWJ | UART到I²C总线桥接器 | TSSOP-16_L5.0-W4.4-P0.65-LS6.4-BL | 1 | 10 | 25 | NO
U10 | C2682616 | MAX17048G+T10 | 3uA单节/双节电池电量计，带ModelGauge算法 | TDFN-8_L2.0-W2.0-P0.50-BL-EP1.2 | 1 | 10 | 26112 | NO
R22, R23 | C23162 | 0603WAF4701T5E | 厚膜电阻 4.7kΩ ±1% | R0603 | 2 | 20 | 23298171 | NO
J2 | C2856798 | FPC-05F-10PH20 | 10-pin 0.5mm FPC socket; candidate, mechanical verification pending | FPC-SMD_10P-P0.50_XUNPU_FPC-05F-10PH20 | 1 | 10 | 13038 | NO
