Ha22yX/Gridopoly/PCB Files/CornerModule/DC24-2026-09-21/input-bom-stock.csv

Designator | LCSC | MPN | Footprint | ObservedStock | Source | CheckedDate | Note
J301 | C381116 | DC-005-5A-2.0 | DC-IN-TH_DC-005-5A-2.0 | 29185 | https://item.szlcsc.com/product/jpg_353348.html | 2026-09-21 | 网页库存快照，非锁库；C302国内页面缓存较旧，全球页当天仍显示有货
F301 | C553923 | S1206-F-4.0A | F1206 | 3100 | https://item.szlcsc.com/product/jpg_574960.html | 2026-09-21 | 网页库存快照，非锁库；C302国内页面缓存较旧，全球页当天仍显示有货
D301 | C14651 | SS56B | SMB_L4.6-W3.6-LS5.3-RD | 168000 | https://item.szlcsc.com/product/jpg_15319.html | 2026-09-21 | 网页库存快照，非锁库；C302国内页面缓存较旧，全球页当天仍显示有货
D302 | C152100 | SMBJ26A | SMB_L4.6-W3.6-LS5.3-RD | 6890 | https://item.szlcsc.com/product/jpg_163440.html | 2026-09-21 | 网页库存快照，非锁库；C302国内页面缓存较旧，全球页当天仍显示有货
C301 | C28323 | CL21B105KBFNNNE | C0805 | 639270 | https://item.szlcsc.com/product/jpg_29074.html | 2026-09-21 | 网页库存快照，非锁库；C302国内页面缓存较旧，全球页当天仍显示有货
C302 | C1591 | CL10B104KB8NNNC | C0603 | 2258700 | https://item.szlcsc.com/product/jpg_1943.html | 2026-09-21 | 网页库存快照，非锁库；C302国内页面缓存较旧，全球页当天仍显示有货
