Ha22yX/Gridopoly/Mechanical/BoardBase/interfaces/pcb-interface-2026-10-15/reviews/bottom-review/bottom-component-envelopes.csv

board | ref | manufacturer_part | footprint | x_mm | y_mm | body_xmin | body_ymin | body_xmax | body_ymax | union_xmin | union_ymin | union_xmax | union_ymax | exclusion_xmin | exclusion_ymin | exclusion_xmax | exclusion_ymax | height_below_pcb_mm | height_evidence
long | C5 | CL10B104KB8NNNC | C0603 | 14.75642 | 56.881773 | 13.931021 | 56.456374 | 15.581818 | 57.307173 | 13.655797 | 56.431853 | 15.855437 | 57.331013 | 13.155797 | 55.931853 | 16.355437 | 57.831013 |  | not measured per component
long | C6 | CGA0805X5R226M250MT | C0805 | 13.99442 | 53.833773 | 13.344027 | 52.808375 | 14.644812 | 54.859171 | 13.320517 | 52.127823 | 14.669257 | 55.539043 | 12.820517 | 51.627823 | 15.169257 | 56.039043 |  | not measured per component
long | C7 | CL10B104KB8NNNC | C0603 | 8.467441 | 53.250147 | 8.042041 | 52.424749 | 8.89284 | 54.075546 | 8.018267 | 52.150683 | 8.917427 | 54.350323 | 7.518267 | 51.650683 | 9.417427 | 54.850323 |  | not measured per component
long | C14 | TCC0805COG102J251BT | C0805 | 14.882155 | 63.126958 | 13.856757 | 62.476565 | 15.907553 | 63.77735 | 13.178277 | 62.452923 | 16.586957 | 63.801663 | 12.678277 | 61.952923 | 17.086957 | 64.301663 |  | not measured per component
long | C15 | TCC0805COG102J251BT | C0805 | 14.824078 | 61.017892 | 13.79868 | 60.367499 | 15.849476 | 61.668284 | 13.119857 | 60.344723 | 16.528537 | 61.693463 | 12.619857 | 59.844723 | 17.028537 | 62.193463 |  | not measured per component
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
corner | C302 | CL10B104KB8NNNC | C0603 | 64.888867 | 63.447714 | 64.063469 | 63.022315 | 65.714265 | 63.873113 | 63.787777 | 62.997753 | 65.989957 | 63.896913 | 63.287777 | 62.497753 | 66.489957 | 64.396913 |  | not measured per component
