Ha22yX/Gridopoly/Mechanical/BoardBase/interfaces/pcb-interface-2026-10-15/connector-anchors.csv

board | ref | anchor_x_mm | anchor_y_mm | source_rotation_ccw_deg | mount_side
long | J1 | 26.99999934 | 76.327 | 0 | top
long | J3 | 7.00941956 | 46.59477346 | -90 | top
long | J4 | 26.99999934 | 11.2198531 | 180 | top
long | JIN1 | 2.27786692 | 44.8748531 | 90 | top
long | JOUT1 | 51.68086692 | 44.8748531 | 90 | top
long | JIN3 | 2.27786692 | 31.4128531 | -90 | top
long | JOUT3 | 51.80786692 | 31.4128531 | 90 | top
corner | J1 | 39.99999874 | 76.327 | 0 | top
corner | J3 | 20.00941896 | 46.59477346 | -90 | top
corner | J4 | 39.99999874 | 11.2198531 | 180 | top
corner | JIN1 | 2.27786692 | 44.8748531 | 90 | top
corner | JOUT1 | 44.8748531 | 2.31913176 | 180 | top
corner | JIN3 | 2.27786692 | 31.4128531 | -90.00000000000001 | top
corner | JOUT3 | 31.4128531 | 2.31913176 | 180 | top
corner | J301 | 69.46086692 | 46.5258531 | 180 | top
