Ha22yX/Gridopoly/Assets/GridCity/StreetV3/device/corner-hold-order.png

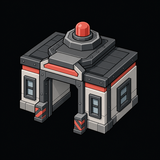
Assets/GridCity/StreetV3/device/corner-hold-order.png
