Ha22yX/Gridopoly/PCB Files/PlayerConsolePower/OrderPackageAudit-2026-10-14/independent-j3-comparison.png

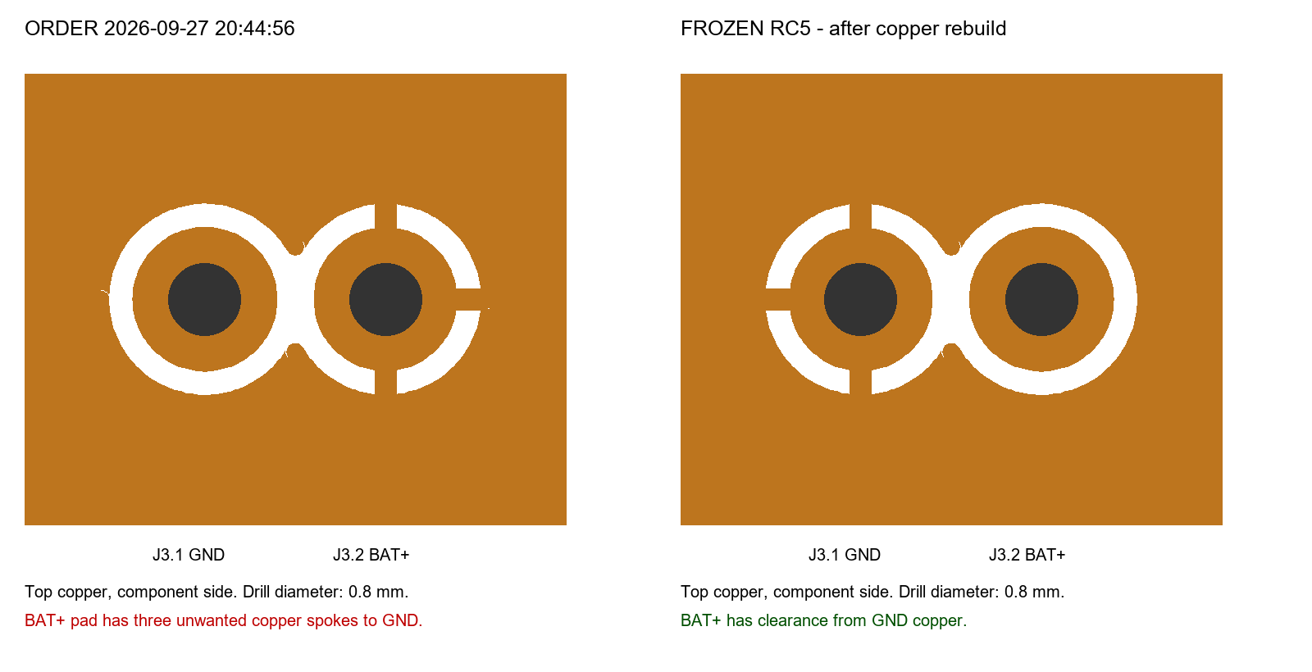
PCB Files/PlayerConsolePower/OrderPackageAudit-2026-10-14/independent-j3-comparison.png
