Ha22yX/Gridopoly/(list of files, cad)

Other CAD files:
Mechanical/BoardBase/deliverables/Gridopoly_BoardBase_Full16_R1/01_L_Quarter_PRINT_4.3mf
Mechanical/BoardBase/deliverables/Gridopoly_BoardBase_Test_R0/Incoming_Long_TEST_R0.stl
Mechanical/BoardBase/deliverables/Gridopoly_BoardBase_Test_R1_ONE_PIECE/ONE_PIECE_Corner_Test_R1.3mf
Mechanical/PlayerConsoleStand/outputs/models/round_display_test_stand.stl
Mechanical/PlayerConsoleStandV2/deliverables/Gridopoly_Player_Stand_V2_R1/03_Spacer_12mm.3mf
Mechanical/PlayerConsoleStandV2/deliverables/Gridopoly_Player_Stand_V2_R2_FPC60/05_Spacer_6mm_R2.3mf
Mechanical/PlayerConsoleStandV2/deliverables/Gridopoly_Player_Stand_V2_R3_EAR_REINFORCED/01_Connection_Plate_R2.stl
Mechanical/PlayerTokens/models/hi3d-30mm/deliverables/Hi3D_30mm/Hi3D_30mm.3mf
Mechanical/PlayerTokens/models/hi3d-remaining-30mm/deliverables/Gridopoly_30mm_Remaining/Owl_30mm.3mf
Mechanical/PlayerTokens/sources/hi3d-originals/Hi3D.3mf
Mechanical/BoardBase/deliverables/Gridopoly_BoardBase_Full16_R1/02_Splice_Bridge_PRINT_8.3mf
Mechanical/BoardBase/deliverables/Gridopoly_BoardBase_Test_R0/Corner_TEST_R0.stl
Mechanical/BoardBase/deliverables/Gridopoly_BoardBase_Test_R2_PRINT_FRIENDLY/ONE_PIECE_Corner_Test_R2.3mf
Mechanical/PlayerConsoleStand/outputs/models/Gridopoly_Player_Console_Stand_M4_Pin_Down.stl
Mechanical/PlayerConsoleStandV2/deliverables/Gridopoly_Player_Stand_V2_R1/02_Battery_Tray.3mf
Mechanical/PlayerConsoleStandV2/deliverables/Gridopoly_Player_Stand_V2_R2_FPC60/02_Screen_Support_CW47_5_R2.3mf
Mechanical/PlayerConsoleStandV2/deliverables/Gridopoly_Player_Stand_V2_R3_EAR_REINFORCED/05_Spacer_6mm_R2.stl
Mechanical/PlayerTokens/models/hi3d-remaining-30mm/deliverables/Gridopoly_30mm_Remaining/Beaver_30mm.3mf
Mechanical/BoardBase/deliverables/Gridopoly_BoardBase_Test_R0/Outgoing_Long_TEST_R0.stl
Mechanical/PlayerConsoleStand/outputs/models/Gridopoly_Player_Console_Stand_CW50.stl
Mechanical/PlayerConsoleStandV2/deliverables/Gridopoly_Player_Stand_V2_R1/03_Spacer_8mm.3mf
Mechanical/PlayerConsoleStandV2/deliverables/Gridopoly_Player_Stand_V2_R2_FPC60/01_Connection_Plate_R2.3mf
Mechanical/PlayerConsoleStandV2/deliverables/Gridopoly_Player_Stand_V2_R3_EAR_REINFORCED/02_Screen_Support_CW47_5_R3.3mf
Mechanical/PlayerTokens/models/hi3d-remaining-30mm/deliverables/Gridopoly_30mm_Remaining/Turtle_30mm.3mf
Mechanical/PlayerConsoleStandV2/deliverables/Gridopoly_Player_Stand_V2_R1/01_Upper_CW47_5.3mf
Mechanical/PlayerConsoleStandV2/deliverables/Gridopoly_Player_Stand_V2_R2_FPC60/04_Battery_Lid_R2.3mf
Mechanical/PlayerConsoleStandV2/deliverables/Gridopoly_Player_Stand_V2_R3_EAR_REINFORCED/03_Battery_Cradle_R2.3mf
Mechanical/PlayerConsoleStandV2/deliverables/Gridopoly_Player_Stand_V2_R2_FPC60/03_Battery_Cradle_R2.stl
Mechanical/BoardBase/deliverables/Gridopoly_BoardBase_Full16_R1/01_L_Quarter_PRINT_4.stl
Mechanical/BoardBase/deliverables/Gridopoly_BoardBase_Full16_R1/02_Splice_Bridge_PRINT_8.stl
Mechanical/BoardBase/deliverables/Gridopoly_BoardBase_Full16_R1/Gridopoly_Full16_R1.blend
Mechanical/BoardBase/deliverables/Gridopoly_BoardBase_Test_R0/Gridopoly_Corner_Test_R0.blend
Mechanical/BoardBase/deliverables/Gridopoly_BoardBase_Test_R1_ONE_PIECE/Gridopoly_OnePiece_Corner_Test_R1.blend
Mechanical/BoardBase/deliverables/Gridopoly_BoardBase_Test_R1_ONE_PIECE/ONE_PIECE_Corner_Test_R1.stl
Mechanical/BoardBase/deliverables/Gridopoly_BoardBase_Test_R2_PRINT_FRIENDLY/Gridopoly_OnePiece_Corner_Test_R2.blend
Mechanical/BoardBase/deliverables/Gridopoly_BoardBase_Test_R2_PRINT_FRIENDLY/ONE_PIECE_Corner_Test_R2.stl
Mechanical/BoardBase/deliverables/Gridopoly_BoardBase_Test_R2_PRINT_FRIENDLY/Screw_Fit_Coupon_R2.3mf
Mechanical/BoardBase/deliverables/Gridopoly_BoardBase_Test_R2_PRINT_FRIENDLY/Screw_Fit_Coupon_R2.stl
Mechanical/PlayerConsoleStand/outputs/models/Gridopoly_Player_Console_Stand_CW47_5.blend
Mechanical/PlayerConsoleStand/outputs/models/Gridopoly_Player_Console_Stand_CW50.blend
Mechanical/PlayerConsoleStandV2/deliverables/Gridopoly_Player_Stand_V2_R1/01_Upper_CW47_5.stl
Mechanical/PlayerConsoleStandV2/deliverables/Gridopoly_Player_Stand_V2_R1/02_Battery_Tray.stl
Mechanical/PlayerConsoleStandV2/deliverables/Gridopoly_Player_Stand_V2_R1/03_Spacer_12mm.stl
Mechanical/PlayerConsoleStandV2/deliverables/Gridopoly_Player_Stand_V2_R1/03_Spacer_8mm.stl
Mechanical/PlayerConsoleStandV2/deliverables/Gridopoly_Player_Stand_V2_R1/Gridopoly_Player_Stand_V2_R1.blend
Mechanical/PlayerConsoleStandV2/deliverables/Gridopoly_Player_Stand_V2_R2_FPC60/02_Screen_Support_CW47_5_R2.stl
Mechanical/PlayerConsoleStandV2/deliverables/Gridopoly_Player_Stand_V2_R2_FPC60/04_Battery_Lid_R2.stl
Mechanical/PlayerConsoleStandV2/deliverables/Gridopoly_Player_Stand_V2_R2_FPC60/Gridopoly_Player_Stand_V2_R2_FPC60.blend
Mechanical/PlayerConsoleStandV2/deliverables/Gridopoly_Player_Stand_V2_R3_EAR_REINFORCED/02_Screen_Support_CW47_5_R3.stl
Mechanical/PlayerConsoleStandV2/deliverables/Gridopoly_Player_Stand_V2_R3_EAR_REINFORCED/Gridopoly_Player_Stand_V2_R3_EAR_REINFORCED.blend
Mechanical/PlayerTokens/models/hi3d-30mm/deliverables/Hi3D_30mm/Hi3D_30mm.blend
Mechanical/PlayerTokens/models/hi3d-30mm/deliverables/Hi3D_30mm/Hi3D_30mm.stl
Mechanical/PlayerTokens/models/hi3d-remaining-30mm/deliverables/Gridopoly_30mm_Remaining/Beaver_30mm.blend
Mechanical/PlayerTokens/models/hi3d-remaining-30mm/deliverables/Gridopoly_30mm_Remaining/Beaver_30mm.stl
Mechanical/PlayerTokens/models/hi3d-remaining-30mm/deliverables/Gridopoly_30mm_Remaining/Gridopoly_Three_Tokens_30mm.blend
Mechanical/PlayerTokens/models/hi3d-remaining-30mm/deliverables/Gridopoly_30mm_Remaining/Owl_30mm.blend
Mechanical/PlayerTokens/models/hi3d-remaining-30mm/deliverables/Gridopoly_30mm_Remaining/Owl_30mm.stl
Mechanical/PlayerTokens/models/hi3d-remaining-30mm/deliverables/Gridopoly_30mm_Remaining/Turtle_30mm.blend
Mechanical/PlayerTokens/models/hi3d-remaining-30mm/deliverables/Gridopoly_30mm_Remaining/Turtle_30mm.stl
Mechanical/PlayerTokens/sources/hi3d-originals/Hi3D(2).3mf
Mechanical/PlayerTokens/sources/hi3d-originals/Hi3D(4).3mf
Mechanical/PlayerTokens/sources/hi3d-originals/Hi3D(5).3mf
