Ha22yX/Gridopoly/PCB Files/PlayerConsolePower/Testpoints-2026-10-15/independent-testpoint-manufacturing-review.md

# 单排测试点独立制造文件复核

本报告仅对应本目录最新单排 RC6-TP 的实际导出文件。复核结果：**8 个测试点制造几何通过；导出铜连接分析通过。**

- Gerber SHA256：`bff4f65a4de8f07b44090f04ccfda05d3c57241564201dea600e5bc1f85e09d3`
- 8 个孔位均位于 y≈22.5 mm，x≈8、16、24、32、40、48、56、64 mm。
- 顶视图从左到右：GND、5V_SCREEN、SCREEN_IO3V3、GND、USB_VBUS、SYS_RAW、BAT_PACK、POWER_EN。
- 实际 PTH 钻孔表为 1.000001 mm；8 个孔均金属化，未出现在 NPTH 表。
- 实际顶/底铜圆形光圈直径为 2.19964–2.200001 mm，名义孔环宽约 0.600 mm。
- 顶/底阻焊开窗直径为 2.30124–2.301601 mm；全部 8 点无钢网开口。
- 新增 USB_VBUS 两枚过孔为实际 0.300 mm 孔、0.600 mm 铜盘，顶底盖油。
- 顶底 16 个网络名均存在；所有测试点默认位号已隐藏。已查看实际 Gerber 渲染：底面实体视图文字方向正确，标签无重叠、无压孔。
- 旧 68 个器件（含焊盘状态）、82 个原过孔、板框和四个安装孔均未改变。旧 536 段线的全部几何、线宽、层、网络被保留；3 条在分支接入点分割成共线段。当前总走线段为 555，总过孔为 84。

导出铜的独立几何连通分析覆盖 251 个器件焊盘、84 个过孔、555 段走线和 41 个电气网络：未检出断路、异网短路、NC 误接、缺失铜或走线未覆盖。分析采用 Gerber 深浅极性布尔运算，圆弧近似精度 1 μm；网络按真实导出铜和已声明金属化连接关联。

## 可视化与证据

- `actual-testpoints-top.png`：实际顶层铜、开窗、丝印和钻孔。
- `actual-testpoints-bottom.png`：实际底层实体观看方向，已整体镜像。
- `actual-testpoints-top-bottom.png`：两面合图。
- `independent-testpoint-manufacturing-review.json`：逐测试点孔径、铜盘、开窗、钢网、丝印间距与原设计保留比较。
- `independent-row-copper/copper-connectivity-review.json`：独立连接分析。
- `testpoint-row-route-plan.json` / `.png`：规划依据，非制造输出。

## 范围与版本边界

最初分散布局及修复过程中的中间导出均已过时，不能制造；曾出现的 0.10 mm 误导出孔和四个焊盘丢失铜环问题，已在上述 SHA256 的实际文件中确认消除。现在交付必须使用同一最终包，不应混用历史 Gerber、BOM 或坐标文件。

本复核验证测试点改动及制造几何/网络保持，不代替整板原理图审核、原生最终网表一致性确认或实物通电测试；未据此声称实物充电、烧录或电池极性已实测。测试支线宽 0.30 mm，供探测与调试使用，不作为负载电源接口。
