Ha22yX/Gridopoly/PCB Files/PlayerConsolePower/ProductionReadiness-2026-10-14/layout-manufacturing-review.md

# 玩家屏幕供电板：独立 PCB 布局与制造审查

审查日期：2026-10-14（America/New_York）。只读审查，未改动 EDA、PCB、板框、孔或器件位置。

## 结论

当前新导出的铜层未发现电池短路、跨网络铜箔短接或声明网络的断路。布局/制造范围内未找到足以证明该版本必然不能工作的新增致命错误。**这不是“完美投产”的放行结论。** U1 底部焊盘的过孔/钢网工艺、J2 实际排线机械配合、USB 信号质量及首件功能仍未形成实物验证证据；必须与电气原理图审查合并决定放行。

不得使用此结论替已下单旧文件背书。本报告仅对应同目录 `current-Gerber.zip` 和 `current-snapshot.json`。

## 输入与独立验证

- 快照时间：2026-10-15T02:55:10.983Z。
- `current-Gerber.zip`：重新导出的生产层；`PCB1-before.source.jsonl`、`PCB1-netlist.json`：当前工程源与网表。
- `native-BOM.csv`、`native-CPL.csv`、`native-PCBinfo.txt`：原生导出；虽然扩展名 csv，实际分隔符是 Tab。
- CPL 独立逐行比对：68 个唯一位号全部存在于快照，XY 误差均小于 0.01 mm，归一化旋转一致，均为顶层。CPL 的 SMD 字段对 J1、J3 标记 No；J1 是有通孔外壳固定脚的混合 USB 座，不能误当成没有表贴数据脚的纯通孔件；J3 为实际通孔电池座。
- 用 gerbonara 解析正负极性 Gerber，再由 Shapely 合并真实铜多边形，以焊盘和真实过孔连通顶底层。检查 243 个元件焊盘、82 个过孔、536 条线段、41 个电气网络；104 个顶层、29 个底层铜多边形。
- 结果：0 个短路、0 个开路、0 个 NC 误连接、0 个无铜焊盘、0 个线段缺铜。详见 `copper-connectivity-review.json`。该脚本不利用器件内部连接替代 PCB 连线。
- 243 个元件焊盘不含 4 个机械安装孔；原生报告合计 247 个焊盘。不能把两种统计差异当漏件。
- `layout-metrics.json` 保存新的钢网、阻焊、热孔、USB 参考地、板边及线宽测量；`layout-review-copper.png` 是据实际导出 Gerber 绘制并人工查看的四区图。

## 需要完成的制造质量确认

### U1 BQ24074：钢网存在，4 个热孔位于锡膏开口中

- U1 中心为 x=52.0、y=64.0 mm（元件面看，USB-C 在下，y 向下）。EP 铜焊盘约 1.7×1.7 mm，带倒角，连接 GND。
- EP 钢网是**单块约 1.5×1.5 mm、带倒角的开口**，实际面积 **2.1938827 mm²**。源属性中 `topPasteMask=-3937` 是关闭默认封装钢网，另有自定义钢网输出；不能据该属性声称 U1 没有钢网。
- 热孔为 4 个 Ø0.29972 mm，中心在 (51.6,63.6)、(52.4,63.6)、(51.6,64.4)、(52.4,64.4) mm。
- 实际 GTS/GTP 显示：每个孔**顶面全露孔、上方全有钢网开口**；GBS 显示底面盖油。孔内铜连接可建立散热路径，但底面盖油并不证明过孔被树脂填平。
- 制造风险：锡膏进入孔内、EP 空洞和焊接量变化；若散热焊接不足，可能更早进入热调节、降低充电电流。这是装配工艺风险，**不是已证明必坏、也不是电池铜箔短路**。
- 建议确认代工采用的过孔处理与钢网方案，检查首件 EP 焊接质量及低电量边充边用温升。可采用代工批准的填孔/堵孔方案，或重新设计经过验证的钢网避孔方案；不要把普通盖油直接写成“填孔”。
- [TI BQ24074 数据手册](https://www.ti.com/lit/ds/symlink/bq24074.pdf) 要求 EP 接地并作为散热连接，封装示例要求对锡膏下的孔采取填、堵或盖孔措施。最终工艺仍须结合代工能力确认。

### U10 MAX17048：EP 尺寸与网络匹配，未见 EP 内过孔

- 中心 (59,47) mm，EP 铜约 1.2×0.8 mm，钢网面积 **0.959996 mm²**，近 100% 覆盖，EP 内无过孔。
- 与 T822+3 封装标称 EP 1.2×0.8 mm、引脚节距 0.5 mm 相符；1、4、6、EP 接 GND，2/3 接 BAT_PACK 的当前铜网没有交叉短接。
- 100% EP 钢网不等于必有桥连；量产前可让代工结合钢网厚度确认焊接量和器件漂浮风险。当前钢网多边形未同时覆盖两个不同电气网络。
- 来源：[ADI MAX17048 数据手册](https://www.analog.com/media/en/technical-documentation/data-sheets/MAX17048-MAX17049.pdf)、[ADI TDFN 21-0168 封装图](https://mds.analog.com/api/public/content/tdfn_21-0168.pdf)。

### J3 电池插座：电气铜网已隔离，孔径需按制造规格确认

- MPN：B2B-PH-K-S(LF)(SN)，C131337；2.0 mm 节距；当前元件面左脚 1=GND，右脚 2=BAT_PACK。
- 原生实际钻孔文件显示 **Ø0.900024 mm**，焊盘直径约 1.6002 mm，环宽约 0.3501 mm；不是 API 元数据误读得到的 0.09 mm。
- [JST PH 官方图](https://www.jst-mfg.com/product/pdf/eng/ePH.pdf)给出 PCB 参考孔 Ø0.7 +0.1/0 mm，并说明硬质玻纤板可考虑更大孔径。因此 0.9 mm 超出参考图通常尺寸，但不能据此断言不能插或会短路；需要明确它是下单成品孔要求还是刀具值，并确认填锡和机械固定。
- J3 是通孔件，CPL 中应按非 SMD 装配方式处理；采购与贴装服务必须包含它。不能只核对顶部 68 个器件便宣称全部适合一次表贴回流。
- 电池线序仍以实际插头插合方向确认，不能单凭照片上红线位于左/右断言极性通用。

### J2 软排线插座仍需实物配合证据

- 当前 BOM 为 FPC-05F-10PH20 / C2856798；信号焊盘节距 0.5 mm，10 根信号脚，2 个壳体地焊盘。
- 当前网络镜像定义：1 D−，2 D+，3 RST，4 SCREEN_TX，5 SCREEN_RX，6/7 NC，8 GND，9 NC，10 5V_SCREEN；这与已讨论的反向连接定义一致，未擅自再翻转。
- 名称还标有 `(CANDIDATE)`，实际排线插入端厚度未确认。线宽/间距不等于带补强的插入厚度；只有实际配合或屏幕/连接器双方规格相符，才可关闭此项。不能只凭 DRC 放行机械配合。

## 电源布局检查

- U1 的 C1、C2、C3 分别处于 IN、BAT、OUT 附近，未发现去耦电容误接网络。C1 正端到 U1 IN 焊盘中心直线距离约 1.3 mm，C2 BAT 正端到最近 BAT 脚约 2.5 mm，C3 到 OUT 脚约 3.2 mm；均有直接铜线，非绕全板连接。
- U2 TPS61023 的输入 C7、输出 C8/C9/C10 与 L1 位于局部电源区域。C7 10µF，C8/C9 各 10µF，C10 100nF，名义输出电容 20.1µF。不能用名义容量替代工作电压下有效容量和负载瞬态测试。
- C7 正端到 U2 VIN 焊盘中心约 1.75 mm；最近输出 C8 到 VOUT/GND 脚中心约 2.3 mm。L1 SW 端至 U2 SW 约 4 mm；热回路未跨板，也未发现 FB 铜线穿过 SW 节点。
- R9/R10 在 U2 的 FB 侧，反馈走线与 SW 位于不同侧；输出采样从输出电容区域引回。当前拓扑未发现明显错误，但还需示波器验证低电量启动、屏幕/无线负载瞬态和 SW 过冲。
- 底层总体有大面积 GND，电源区有 GND 过孔。U1 线性充电的真实热性能不能由铜面积或 DRC 推定。
- [TI TPS61023 数据手册](https://www.ti.com/lit/ds/symlink/tps61023.pdf)要求输入/输出电容同时靠近电源与地脚、缩短 SW 和高频输出回路。此板可见的电源布置基本遵循该方向，尚无波形证据证明所有负载条件满足规格。

## USB 走线：有可用拓扑，未证明信号完整性

| 网络 | 全部声明线段长度 | 线宽 | 过孔 |
|---|---:|---|---:|
| USB_HOST_DP | 24.0134 mm | 0.20 / 0.25 / 0.60 mm | 0 |
| USB_HOST_DM | 23.8170 mm | 0.20 / 0.25 / 0.60 mm | 2 |
| SCREEN_DP | 22.9682 mm | 0.25 / 0.60 mm | 0 |
| SCREEN_DM | 25.0466 mm | 0.25 / 0.60 mm | 2 |

这里是整网线段总长，包括 USB-C 汇合支线，不是已求得的单一路径端到端长度，也不是“长度匹配认证”。D− 两段均有额外换层，D+ 不换层；几何上有不同线宽及参考面变化。

- 按“信号中心线正对另一面必须是 GND”的严格几何判据，四网分别约 1.79/5.05/5.18/6.68 mm 不满足。详细坐标见 `layout-metrics.json` 的 `noGroundSegments`。包括接插件逃线、跨其他信号/电源，以及换层附近；该判据不包含侧边同层回流，不能直接等同于功能失败。
- 当前铜层图显示局部穿越下层电源及信号通道，无法从 DRC 0 推定回流连续或 90 Ω 差分阻抗。板层记录约 1.51 mm FR4，不具备阻抗场解或板厂阻抗确认记录。
- 对 ESP32-S3 使用的 Full-Speed USB，不应把此布局直接判成必然无法烧录；但也不能宣称已满足 USB 信号质量。需要真实屏幕、实际排线与正常数据线完成双面插 USB-C、反复枚举、上传、持续日志/调试以及开关机插拔验证。若要进一步提高设计余量，优先整理 D+/D− 同层同过孔及连续参考地，保留用户固定接口位置。

## 封装与制造几何

- U1 为 16 脚+EP、0.5 mm 节距；U2 SOT563 6 脚、0.5 mm 节距；U5 X2QFN12，0.4 mm 节距，**该封装没有需另补的中心 EP**；U7 UQFN10，0.5 mm 节距，没有被漏接的编号 EP；U9 TSSOP16，0.65 mm 节距；U10 为 8 脚+EP、0.5 mm 节距。封装引脚数、排布与导出铜焊盘没有明显少脚/多脚问题。
- U3/U4 为 6 脚，U6/U8 为 5 脚，均导出完整焊盘。具体引脚功能由电气审查核对，不用符号标签替代芯片真值表。
- 所有元件位于顶层；2 层铜；80×80 mm，四角 R5。没有擅自恢复早期 40×40/50×50 讨论尺寸，用户后续固定的轮廓是现行约束。
- 顶/底铜均未越板框，最小铜到边约 **0.2565 mm**。
- 当前普通线宽最小 **0.18 mm**；过孔钻孔约 **0.2997/0.3048 mm**，环宽约 **0.1499/0.1524 mm**；未发现不合理微孔要求。
- 全部不同网络中，本次测得最小铜隙约 **0.14818 mm**（底层 PGOOD_N/SCREEN_RST），另有 0.15 mm 的 U3 周边间距；这需要与所选工厂/铜厚实际能力匹配，不应将原规则的轨到轨 0.102 mm 与焊盘 0.152 mm 混为一个绝对阈值。
- 4 个固定安装孔中心 (5,5)/(75,5)/(75,75)/(5,75) mm，Ø3.4 mm，为无网络金属化孔，周围有铜/器件禁布区。板厂和结构必须继续采用现有孔位及安装方式。
- 顶层丝印与阻焊开口有很少量几何相交，测得约 0.0489 mm²；通常由 CAM 裁切，可能影响文字完整性，不能据此判为电气短路。丝印解析跳过了 Gerber 中零半径退化弧，因此数值是可解析图元的统计。

## 测试和最终生产包

- 原生 PCB 信息显示 **0 专用测试点、测试点覆盖率 0%**。当前样板可以利用电容及接口焊盘手测，但尚没有自动测试夹具的可达点/覆盖记录。
- 需要冻结一套来源一致的 Gerber、钻孔、BOM、CPL、装配图，并在下单后核对工厂接收文件的哈希/预览。仅在 EDA 内复检不能阻止再次提交旧 ZIP。
- 本次 Gerber SHA-256：`ff1d6610f86817b8abf856b8e372c66f574020b3824ed76b2c69375bd793d031`；快照 SHA-256：`514525b69079c1752307edff7b40681068bd6d8691afb7db4ee0688ce93eb4a3`。任何后续改动都应重新导出和检查，不能沿用这里的哈希结论。
- 首件至少测：未上电 BAT/GND 绝缘；限流供电；低电量到充满过程与温升；电源键、欠压关断及关断耗流；电脑 USB 数据枚举/下载/日志；MAX17048 电压/SOC 和 CHG/PGOOD 读数。当前报告没有这些实测结果。
- 数字铜网通过、组装可制造、实物功能通过是三层不同证据；本次完成了第一层和第二层的静态审查，未把它们替换成第三层。

## 附件

- `layout-metrics.py` / `layout-metrics.json`：可复现指标；依赖 gerbonara 1.6.3、Shapely 2.1.2、Pillow。
- `verify-current-copper-layout.py` / `copper-connectivity-review.json`：新导出铜层连通性审查。
- `layout-review-copper.png`：升压、充电、USB 顶层及 USB 底层参考地视图。
- `JST-PH-official.pdf`、`JST-PH-pattern.png`、`BQ24074-official.pdf`、`BQ24074-pattern.png`：官方图纸核对资料。
