Ha22yX/Gridopoly/Mechanical/PlayerConsoleStandV2/revisions/R3_EAR_REINFORCED/assembly_guide/Gridopoly_Player_Stand_R3_Assembly_Guide_CN.pdf

GRIDOPOLY / 玩家控制屏幕

# 玩家屏幕底座 R3

图文装配说明 / Bambu H2D · PLA打印件

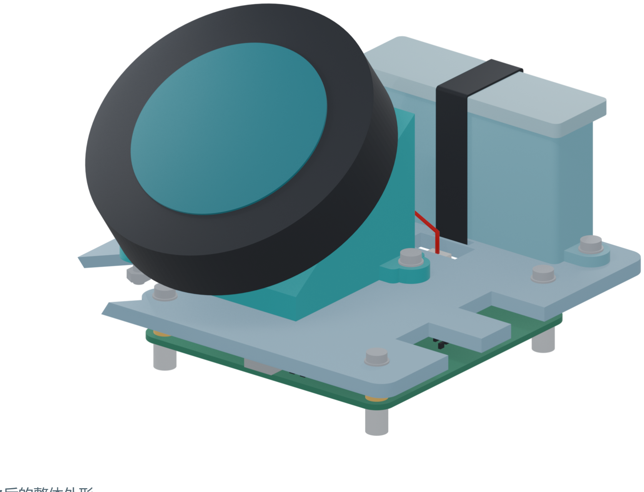
[picture p134: figure]

R3 加固版 · 毫米 mm · 装配参考 | 01 / 06

装好之后的整体外形

## 先固定上部零件，再装PCB，最后连接屏幕与电池。

本说明适用于：02屏幕支架使用R3加固版；01连接板、03电池仓、04仓盖、05隔柱继续使用R2。全套为5

### 种打印件，共8个实体。

只替换02支架。 已打印的其他四种零件可继续使用。模型已完成几何检查；整机实物装配和60mm软排线余量仍 需首次试配。

# 准备零件与紧固件

先清理孔内毛刺，再按清单分好螺丝。M3螺丝长度均指头下长度。

## 打印件

文件 / 零件 | 数量 | 识别要点
01 连接板 R2 | 1 | 大平板，带安装孔和接口缺口
02 屏幕支架 R3 | 1 | 斜面圆环；两侧有加宽螺丝耳
03 电池仓 R2 | 1 | 上方开放，侧面有出线缺口
04 电池仓盖 R2 | 1 | 装配时内凹面朝下
05 间隔柱 R2 | 4 | 高6mm，外径约6mm，通孔Ø3.6mm

## 另需准备

配件规格 | 数量 | 安装位置
M3×18螺丝 | 4 | 连接板 → PCB → 尼龙底脚
M3×12螺丝 | 4 | 屏幕支架2颗、电池仓2颗
M3平垫片，约0.5mm厚 | 8 | 每颗螺丝头下各1片
普通M3六角螺母，约2.4mm厚 | 4 | 支架和电池仓下方
Ø6×8mm，M3贯通内螺纹尼龙底脚 | 4 | PCB下方；不是6mm打印隔柱
宽10mm、长约180-200mm软绑带 | 1 | 固定电池仓盖
约0.5mm柔软绝缘薄垫 | 1 | 电池仓底部

工具：与螺丝头匹配的螺丝刀，以及扶住M3螺母的小扳手或尖嘴钳。本版不需要自攻螺丝或热熔螺母。

# ① 先把上部零件装到连接板

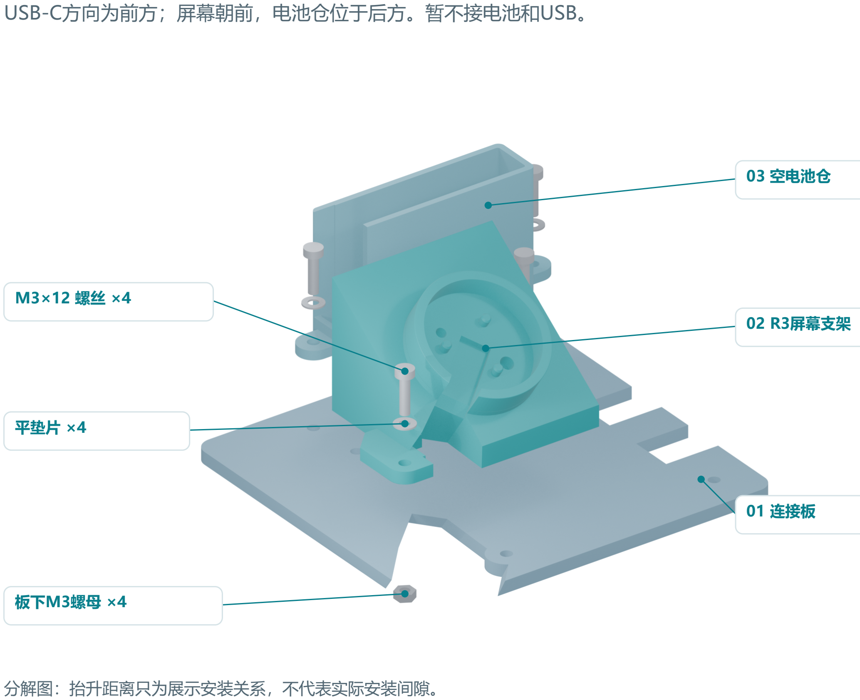
[picture p135: figure]
USB-C方向为前方；屏幕朝前，电池仓位于后方。暂不接电池和USB。; 平垫片 ×4; 板下M3螺母 ×4; 03 空电池仓; 02 R3屏幕支架; 01 连接板; 分解图：抬升距离只为展示安装关系，不代表实际安装间隙。

## 1 固定R3屏幕支架

对齐两个安装耳与连接板的孔。每孔使用1颗M3×12、1片垫片和1个M3螺母；从连接板下面扶住螺母， 轻拧到贴合。

## 2 固定空电池仓

将电池仓放在连接板后方，出线缺口朝J3方向。另用2颗M3×12、2片垫片、2个螺母固定。

两处共同顺序： 螺丝头 → 垫片 → 安装耳 → 连接板 → 螺母。先完成这一步，再装PCB，便于操作下侧螺母。

# ② 安装PCB、隔柱和底脚

PCB元件面朝上。四个主安装点使用M3×18，不另加普通螺母。

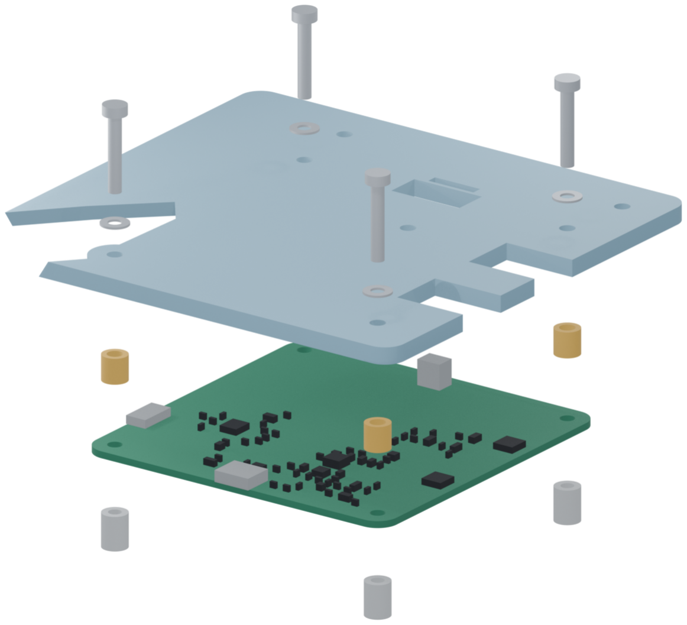
[picture p136: figure]

### 每个安装点

M3×18螺丝头

0.5mm垫片

4mm连接板

6mm打印隔柱

1.6mm PCB

8mm内螺纹底脚

顺序示意，不按比例

## 3 四角放入6mm间隔柱

在PCB四个孔处各放1个6mm打印隔柱，再放上已装好支架和电池仓的连接板。对齐四孔，避免用螺丝强 行拉正。

## 4 从上方穿入M3×18

每颗螺丝头下放垫片，穿过连接板、隔柱和PCB，拧入下面的8mm尼龙内螺纹底脚。四角交替轻拧，保持 PCB平整。

检查下面的空间： 螺母、螺丝尖端及打印件都应避开器件和焊点。不要随意换更长的螺丝，也不要把6mm隔柱 与8mm底脚混用。

# ③ 放入屏幕，试配软排线

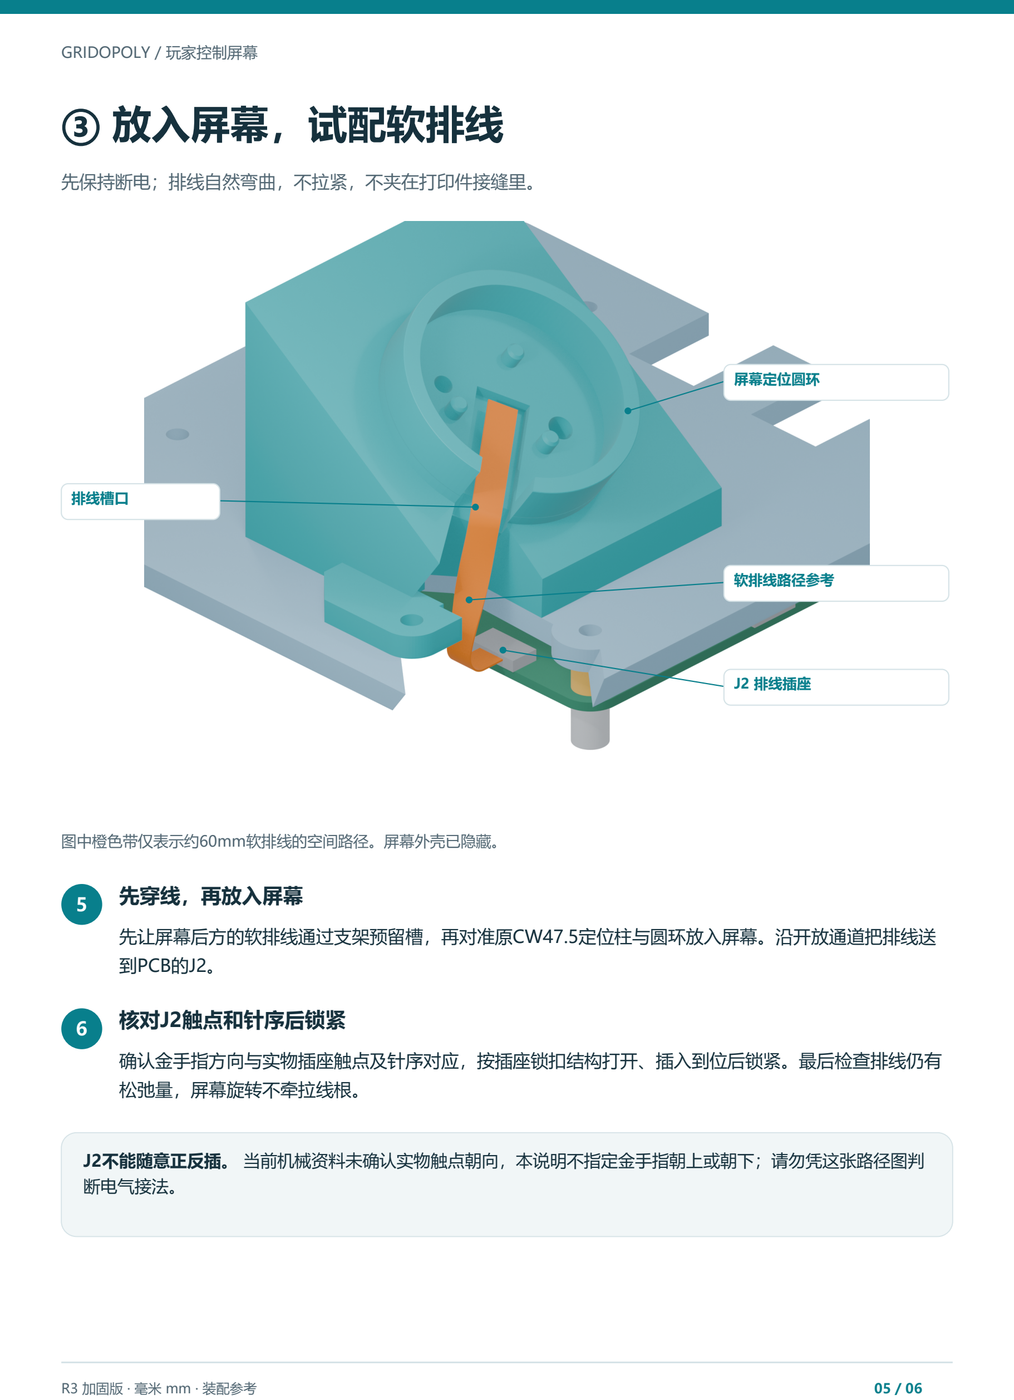
[picture p137: page 5]

先保持断电；排线自然弯曲，不拉紧，不夹在打印件接缝里。

屏幕定位圆环

排线槽口

软排线路径参考

J2 排线插座

图中橙色带仅表示约60mm软排线的空间路径。屏幕外壳已隐藏。

## 5 先穿线，再放入屏幕

先让屏幕后方的软排线通过支架预留槽，再对准原CW47.5定位柱与圆环放入屏幕。沿开放通道把排线送 到PCB的J2。

## 6 核对J2触点和针序后锁紧

确认金手指方向与实物插座触点及针序对应，按插座锁扣结构打开、插入到位后锁紧。最后检查排线仍有 松弛量，屏幕旋转不牵拉线根。

J2不能随意正反插。 当前机械资料未确认实物触点朝向，本说明不指定金手指朝上或朝下；请勿凭这张路径图判 断电气接法。

# ④ 放电池、盖仓盖，完成检查

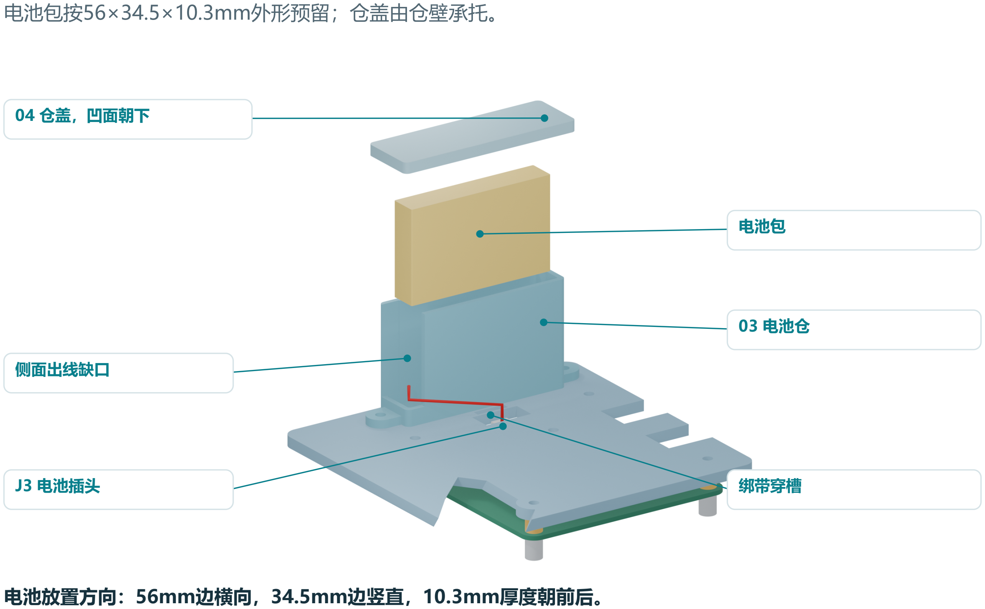
[picture p138: figure]
电池包按56×34.5×10.3mm外形预留；仓盖由仓壁承托。; 04 仓盖，凹面朝下; 电池包; 03 电池仓; 侧面出线缺口; J3 电池插头; 绑带穿槽; 电池放置方向：56mm边横向，34.5mm边竖直，10.3mm厚度朝前后。

## 7 放电池并接J3

仓底放约0.5mm绝缘薄垫。电池线从开放缺口引出，经过操作窗到J3；确认插头极性与PCB对应后再接入。 不能夹住线根或挤压电池软包。

## 8 盖好仓盖，固定软绑带

仓盖内凹面朝下。软绑带穿连接板专用槽并绕过后沿，只收紧到盖子不松脱。

## 通电前逐项确认

四角稳固、PCB平整，下面没有金属件碰到器件或焊点。

USB-C可插拔，POWER/RST可按，旋钮可自由转动。

排线和电池线不受拉扯，电池与仓盖之间没有挤压。

搬动时握住底座，屏幕沿用定位配合，未被四颗PCB螺丝锁死。
