Ha22yX/Gridopoly/Docs/firmware/player-build-battery-rollout-2026-10-16.md

# 三台玩家屏：建房入口与电量显示升级

状态：进行中。首版三台已部署；第二版仅COM29已写入，独立任务工作但电量初始化仍失败，不能认定已修复。用户现让COM27/28/29均先充电，要求理论验证，暂停全部三台串口、复位及烧录；COM27/28仍为首版。新增COM28手写卡顿、连笔和位置偏差任务正在并行排查。日期采用现场America/New_York；原始日志使用UTC。

用户要求升级当前接电脑的三台玩家屏，并在屏幕显示当前电量；本轮同时接入前一轮规划的首页建房入口。源码、主机回归及构建由玩家屏会话负责，主会话负责身份核对、受保护写验、现场观察与 Git 交付。实现报告见[玩家屏构建记录](player-build-battery-2026-10-16.md)。

## 设备与升级前状态

用户确认三台均通过已返修供电底板连接电脑，且接着电池。USB 设备序列号已与完整 MAC 核对，写入时还会在 ROM 与下载 stub 内核对 MAC；端口号本身不作为身份依据。

| 端口 | 完整 MAC | 升级前应用 | 保留的显示时钟 |
| --- | --- | --- | --- |
| COM27 | dc:b4:d9:02:bf:88 | dfc4b7e547a129fd5b500396a2a1f0e3866edf80b53d6684f0830d0539340cb6 | 16 MHz |
| COM28 | dc:b4:d9:07:81:b0 | dfc4b7e547a129fd5b500396a2a1f0e3866edf80b53d6684f0830d0539340cb6 | 16 MHz |
| COM29 | 20:6e:f1:ba:c9:04 | 716ff623b5a4a9a31a9ce7ff6757ce344ecf56ea56f1eb3844b3ad1a0cfb5739 | 12 MHz |

2026-10-17 02:27:52 UTC（10/16 22:27:52 EDT）开始，各采集约 30 秒被动日志：三台均有 Wi-Fi status=3、原房间 Tag 配对状态；窗口内无重启、panic、brownout 标记，采集结束关闭所有句柄。没有在此窗口读取旧 Flash，因此旧应用身份引用此前写验记录。原应用均关闭电池遥测，没有电量日志；这不表示没有物理电池。

升级前只读服务器快照为 room993580116/version23、phase0，三真人席位 1/2/3 加一机器人，16 个格子模块、ORDER ready。保留已有 Tag/身份流程；不注入新局、掷骰、资产或建房动作制造验收结果。COM7 未接入本轮更新范围。

## 电量接口核对

PCB 会话只读核对原订单、RC5 与 RC6-TP 的相关连接，未发现针脚、极性或协议的不兼容：UART1 TX43/RX44、9600/8N1，SC18IM704 桥接 MAX17048，GPIO0=CHG_N、GPIO1=PGOOD_N，均低有效。归档一致不能替代三块返修实物的通信应答。

启用板型为 `viewe-md80et-v10`。验收需看到桥接版本、MAX 版本、I²C 正常状态、有效且未过期的电压/SOC 样本，并与实际页面显示核对。电量条显示电量计估算的百分比；外接输入、充电指示与 SOC 含义分开。读失败或过期显示未知，不能因插着 USB 或 CHG 未激活就显示 100%。

驱动初始化配置桥接输入/I²C/超时、清电量计 MODE 睡眠许可并按需清 CONFIG.SLEEP；不是纯只读查询，但不改变充电器电流设置、不触发 Quick-Start/POR。细节见[接口约定](../hardware/player-battery-telemetry-interface-2026-09-27.md)。

## 源码与构建前检查

源码与测试检查点为 `ac52ba75a4f7ad360bde14a3142470702dcf3081`，共20份明确的玩家屏文件。操作/渲染回归109项、电量驱动及有界日志52项、电量UI21项、显示/电池组合22项通过。主会话独立目视了建房、旅馆和均匀建造提示页面；底部电量没有遮挡内容。主机图中的78%为夹具数据，不是设备读数。

两份生产构建使用相同2142项源码快照，主会话逐项哈希核验通过；冻结时的Git基准为 `c2cc32d3ca0f56d9cea3f0f1be2d85912c5f5c53`，不因随后提交检查点改写清单。16MHz源码清单摘要为 `6f0086739732044e8f9d45e3bc08d8622f508a8de4258636d81c6e05d1348aad`，12MHz为 `465b855d0ee939db19f3dcb8a44c51536df85d49984a76c3d6f37715c5a1550d`；两者生产模式、启用电池、显示诊断关闭，配置只相差显示时钟。二进制写验另记下节。

## 写验与现场验收

两份首版候选通过源码快照、四段哈希、正常生产模式、电池板型和每台显示配置核验后逐台写入。受保护 worker 检查完整 MAC、16 MB 容量和已有分区一致，不 erase-all、不初始化 NVS。旧版本四段文件已独立重新核验，保留回退来源。

| 设备 | 首版应用SHA-256 | 四段写验完成UTC | 启动后观察 |
| --- | --- | --- | --- |
| COM27 | `8ef6c051d1cb8422350db9659ceb715917d9bdfe456cfe10fcb1c9ce213aa6b5` | 2026-10-17 03:09:16.842 | 45秒：6个有效样本，约3.626–3.663V、5%；启动有Timeout，后续恢复；另45秒被动日志无重启标记 |
| COM28 | 同上，16MHz | 2026-10-17 03:15:44.325 | 45秒：6个有效样本，约3.453–3.474V、rawSOC0096=0.5859%，整数显示0%；启动有Timeout后恢复 |
| COM29 | `83b8d53edbf9d183eb64757c872ec688c08af1787305004d0e06c805f27123db` | 2026-10-17 03:16:27.572 | 50秒加后续45秒：bridge版本可读，gauge始终0000、Timeout、没有有效SOC；不能记录为0% |

COM28/29在编译期间曾未枚举；身份检查因此停止在写入前。用户接回后重新核对完整MAC才执行上表写入。三台均恢复原房间席位；日志未见panic、brownout或窗口内非预期重启。硬复位属于明确的刷写后动作，不能记为零复位。以上采集均有截止并释放串口。

三台均至少一次返回 `SC18IM704 1.0.2`；COM27/28进一步核验MAX版本0012、I2cStatus F0。COM29的I2cStatus00和gauge0000可能仍是未到达相应步骤的初值，不能称实际读回0，不是“电池0V/0%”或已证实MAX损坏。用户确认一台显示 `--% POWER --`，与该无效状态对应；未明确确认三台全部无频闪/错位。后续要用失败步骤/RX计数区分初始化调度、桥接和I²C路径。COM29首版窗口没有头像下载日志，不能把其故障直接归因下载。显示正常与电量可用分别验收，不能仅凭写验宣告本轮完成。

## COM27的5%反馈与独立电压对照

用户质疑5%不变，并说明此前关机用充电器充过较长时间。首轮rawSOC为053B=5.23046875%，UI按整数截断显示5%，并非写死常量。2026-10-17 03:14:10 UTC仅复位ESP32、未重刷、未复位电量计，重新采集125.062秒：24组完整日志，21组有效，1组初始化未就绪，id5/19为Timeout。有效SOC由0510=5.0625%→04FA=4.9765625%→04E4=4.890625%，固件pct由5变4；用户尚未独立确认LCD上的4%。

该窗口电压3643→3626→3646→3626mV。用户万用表独立读得 **3.640V**，与相近时点遥测3.646V相差6mV，支持电压通路和单位正确；并非严格同步校准，不能由此证明SOC准确或电池已充满。电量计默认模型、负载、实际充电条件仍需分别核对；本轮未使用电压线性换算替代SOC，没有Quick-Start/POR、HIBRT或RCOMP改写。

用户补充此前关机充电使用USB-A电源及A转C线。归档底板EN1固定低，默认CC档限流100mA；CC明确宣告≥1.5A才进入约894mA输入档。对标称2000mAh电池，从空充满仅按100mA理想恒流计算约20小时，实际更久；因此“充过较长时间”不等于充满。该条件支持继续检查充电效果，但不证明实际板上限流档或净电池电流已实测。后续可在相同测量条件下对比已知高电流CC电源关屏充电前后的电压/SOC，不能修改百分比迎合预期。

MODE1000的HibStat在读取时为1，CONFIG971C的SLEEP为0。两字段在首版中只在初始化/重新同步时读回，后续日志打印的是缓存，不能声称每5秒均重新读取或全程保持hibernate。VCELL变化间隔约45秒，与[厂家低功耗更新周期](https://www.analog.com/media/en/technical-documentation/data-sheets/MAX17048-MAX17049.pdf)相符，但短窗SOC不变不等于冻结。GPIO4C低2位00只表示外部输入有效、充电指示有效，不代表测得净充电电流。

第二窗口在21.694秒和91.758秒出现超时，分别在下一5秒采样点恢复；91秒时头像下载早已结束，并与身份/快照resync同窗，不能称“仅开机下载期间”。主循环服务间隔超过180ms时，即使响应已缓冲也会超时；具体单次原因仍缺服务间隔与失败步骤证据。COM29首版始终未就绪，因此本轮继续实现独立UART采样与有界定位日志，不靠放宽期限或把无效数据当有效来通过验收。

## COM29重新上电后的恢复

用户对无数据那台电池端独立测得3.455V。随后按要求保留电池，仅用底板POWER关屏、等待5秒再开，反馈“重开后出现电量了”。该操作同时重启屏幕和屏幕侧桥接供电，因此不能据此唯一归因SC18旧状态或ESP32调度；没有主动对MAX发送POR/Quick-Start。

03:23:58.708 UTC起采集45.094秒，实际覆盖约boot51.7–95.1秒：9组完整样本，8组有效，gauge0012、I2cF0、GPIO4C、MODE1000/CONFIG973C初始化缓存。有效电压3.433–3.451V；原始SOC006B→0067→0063，即约0.418%→0.402%→0.387%，整数显示0%。这与此前无数据时的默认0值是不同证据。用户万用表与恢复后3.451V接近，但时间和负载并非严格同步，不能认证SOC精度。

boot71.704秒还有一个Timeout样本，下一5秒采样点恢复；窗口没有panic或重启标记。独立采样修复继续进行。另见现有CJK字形缺失警告，本轮没有修改字体或注入游戏状态，保留日志、不将其写成整局显示已通过。

## 第二版独立采样修复（仅COM29已部署，实机未通过）

本轮修复的源码检查点为 `bb7281c8`，13份玩家屏源/测试文件。UART1及协议状态机由core0/优先级2/3072字节栈的独立任务拥有，每约5ms服务一次；主循环取短锁完整快照，只负责显示和有界USB日志。快照后再取时间，避免新的采样时间被误判过期。创建任务、分配UART缓冲或安装UART失败明确显示不可用；失败初始化释放UART资源，默认关闭板型不创建任务或UART。

协议180ms期限、700ms空闲重同步、电压/SOC 3秒和GPIO 350ms新鲜度均保留。日志增加服务最大间隔、累计Timeout、失败阶段/RX长度、实际I²C状态时间，并将MODE/CONFIG标为缓存。每组8条、单条不超过63字节、120秒后停止日志，不停止采样。

主机协议59项、实际adapter线程模拟24项、真实render调用顺序1项、LVGL电量UI21项均通过。模拟包含主循环5秒不调用采样仍更新、并发快照、worker停顿后失效、完整响应晚于期限仍拒绝、恢复后计数保留和资源失败路径。它们不能证明ESP32实际调度、栈余量或屏幕目视结果。先前109项操作/渲染和22项显示组合验证保留于首版源检查点，本轮没有修改这些功能。

两份新生产候选从同一2142项源码冻结；冻结基准是 `ac52ba75`，相对首版仅ino和4份电量生产文件变化。两档分别保留16/12MHz，均已完成生产构建和独立候选核验；实际写入与运行结果如下。

## 第二版COM29写验和保留的失败

第二版16MHz应用为 `1344a9d12a6776c21b85e0f4b34c16de4f137ee53c24f9965cd65c19e8f85ee2`，12MHz为 `df9f1282b04e009d336fe10d186f3265446b8a1e8d2d7484a9a89ce209f4a631`。完整冻结来源、ELF、分区和四段核验见实现报告。两份候选正常生产、启用电量，显示诊断关闭。

编译期间三台曾从USB断开；用户接回开机后，03:49:48 UTC服务器快照确认room993580116/version47，三个完整deviceId仍在原席位。03:52前后只给COM29写入第二版，ROM/stub身份及四段写验成功、保留原分区/NVS。COM27/28没有写入第二版，仍分别使用首版16MHz应用8ef6c051。

03:52:17.151 UTC开始120.000秒无命令被动采集：24组8行完整，零有效电压/SOC。首组boot1510ms确实已读到SC18IM704 1.0.2，但gauge0000、i_seen=0。随后累计Timeout升至131，最近失败为BridgeVersion（fail1/op1）rx0/16；服务最大间隔54ms、快照heartbeat age0–5ms，未见panic/重启。这证明独立任务运行，不能用主循环超过180ms解释该窗口的持续无应答。首次具体失败可能发生于首两组之间，后续最近失败字段已覆盖它；不能把最后一次VP超时误写成上电从未读到版本，也不能将MAX0000/I²C00当真实读回。

用户未执行这次POWER对照，而是回复“好像就是没有电，我先充吧，你先解决别的”。因此暂停COM29设备操作，保留无数据结果；低电量是用户猜测，未被本轮诊断证实为桥接失联原因。COM29此前首版POWER关开恢复只属前一窗口，不外推第二版已恢复。

PCB会话查到[NXP官方社区已确认问题](https://community.nxp.com/t5/Other-NXP-Products/SC18IM704-internal-register-7-8-and-9-write-freezes-chip-access/m-p/1579139)：部分SC18IM704写07/08/09后失去响应，版本号1.0.2不能可靠区分受影响批次。当前初始化确实写这些寄存器，现象高度吻合；尚无不写这些寄存器的同板对照，记录为强候选原因，兼容路径源码及主机测试已完成，尚未实机部署，见[兼容修改报告](player-battery-bridge-compat-2026-10-17.md)。不能简单删除09写入却保留67校验，也不能静默取消复位检测或将软件期限说成硬件总线恢复保证。

## COM28新增手写问题

用户报告COM27/29手写良好，COM28卡顿、连笔、显示轨迹与实际位置不一致。03:52:53.458 UTC对COM28首版无命令采集45.094秒，设备在线、无重启；含缺字警告，没有原始触摸坐标或采样间隔，不能据此确定根因。玩家屏会话正在检查CST820输入、坐标变换和采样/绘制链路，并实现默认关闭的有界触摸诊断；未注入触摸、改房间或替用户提交姓名。现有INPUT TRACE只覆盖旋钮/按键，不能当触摸证据。USB与仅电池的现场对照未执行：用户回复COM27/28似乎也没电，先充电、要求理论验证。故不将低电量、USB干扰或某一种采样机制写成实证根因；继续默认关闭的有界诊断及主机回归。

## 充电期间的软件验证与候选

用户要求先做理论验证后，没有再打开任何串口、复位或刷写。兼容源码检查点1cfc7f8b、触摸诊断检查点3d2b7aed；协议75项、实际adapter24项与render顺序1项、触摸诊断25项、真实输入/手写116项回归通过。新16MHz正常联合候选应用916171342beaa77ff4785dda6fe24a96ecf6fbb04575cc7688be890a0145bc67已构建；主会话独立核对2145项源、四段、分区与ELF通过。

候选默认关闭TOUCH TRACE；只有后续用户设备可用时才安排30秒实机对照。它不改变手写算法，不能标COM28卡顿/连笔/偏移已修复；也尚未证明避写初始化解决实际桥接失联。COM27/28仍首版、COM29仍二版，具体产物见[兼容报告](player-battery-bridge-compat-2026-10-17.md)及[手写报告](player-handwriting-com28-2026-10-16.md)。

## 证据位置与边界

本机证据目录：`C:/Users/kicof/AppData/Local/GridopolyPlayerBatteryRuntime/`，含升级前 USB 身份、三台被动串口、服务器快照、旧版本四段校验和受保护升级工具快照。构建及源码证据另由实现报告索引。

电量显示实测不等于电芯容量校准、净充电电流、保护阈值或温升验收。首页建房规则的主机测试也不替代真实游戏中的建造扣款、格子换图及下一次租金结算；当前房间仍在身份设置阶段。
