Ha22yX/Gridopoly/Mechanical/BoardBase/deliverables/Gridopoly_BoardBase_Test_R0/SUPERSEDED_DO_NOT_PRINT.txt

R0 已废弃：用户要求三模块和完整16模块均使用一个整体固定底板。请使用 ../Gridopoly_BoardBase_Test_R1_ONE_PIECE/。R0 独立支架和滑动连接不再作为制造依据。
