Ha22yX/Gridopoly/Mechanical/BoardBase/deliverables/Gridopoly_BoardBase_Full16_R1/04_single_quarter_print_4.png

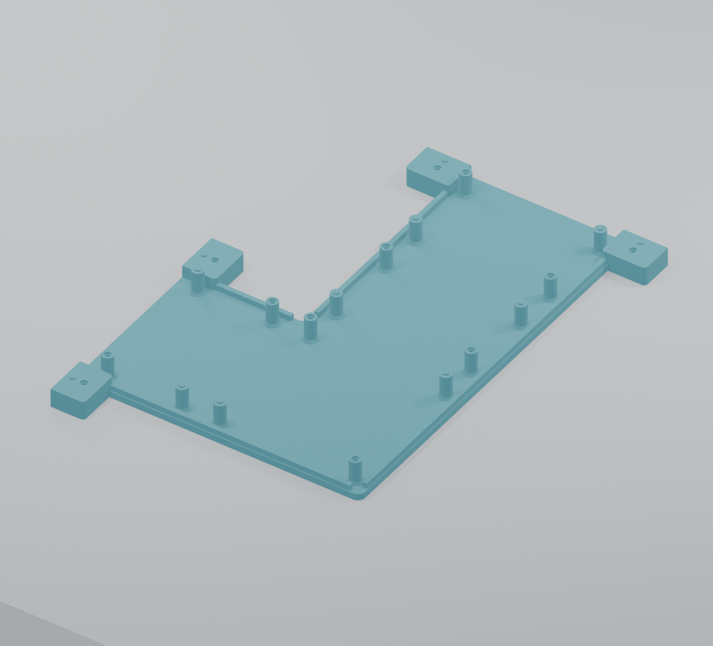
Mechanical/BoardBase/deliverables/Gridopoly_BoardBase_Full16_R1/04_single_quarter_print_4.png
