Ha22yX/Gridopoly/Mechanical/BoardBase/deliverables/Gridopoly_BoardBase_Test_R0/fixture_assembled.png

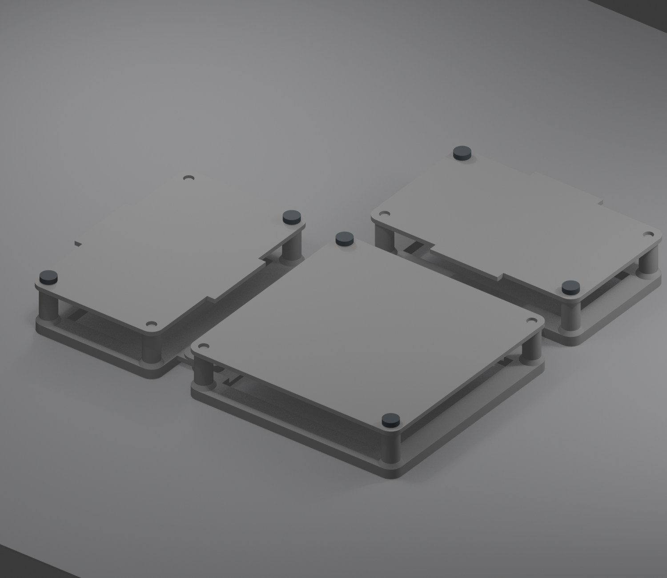
Mechanical/BoardBase/deliverables/Gridopoly_BoardBase_Test_R0/fixture_assembled.png
