Ha22yX/Gridopoly/Mechanical/BoardBase/deliverables/Gridopoly_BoardBase_Test_R1_ONE_PIECE/fixture_assembled.png

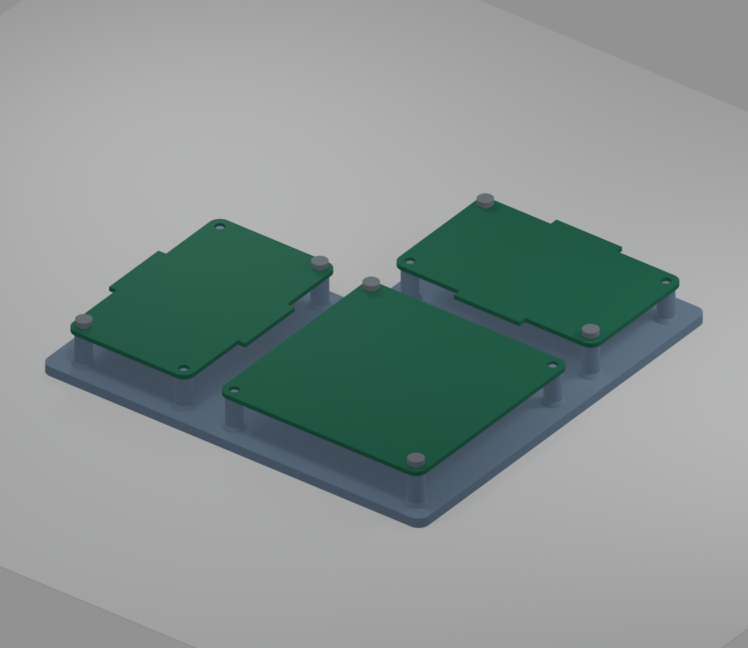
Mechanical/BoardBase/deliverables/Gridopoly_BoardBase_Test_R1_ONE_PIECE/fixture_assembled.png
