Ha22yX/Gridopoly/Mechanical/BoardBase/deliverables/Gridopoly_BoardBase_Test_R2_PRINT_FRIENDLY/fixture_frame.png

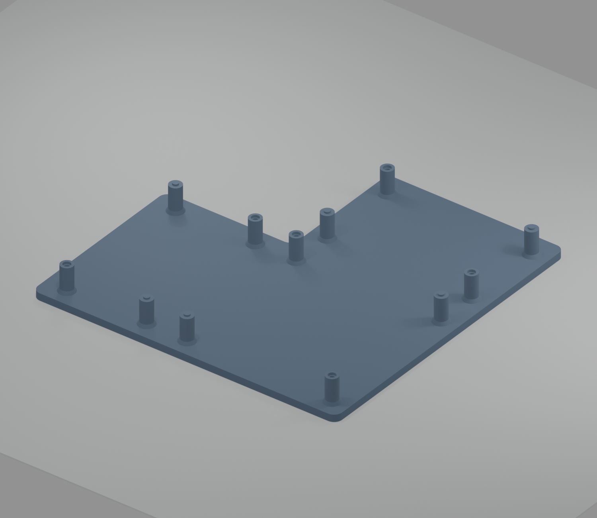
Mechanical/BoardBase/deliverables/Gridopoly_BoardBase_Test_R2_PRINT_FRIENDLY/fixture_frame.png
