Ha22yX/Gridopoly/Mechanical/BoardBase/deliverables/Gridopoly_BoardBase_Test_R2_PRINT_FRIENDLY/mounting_post_section.png

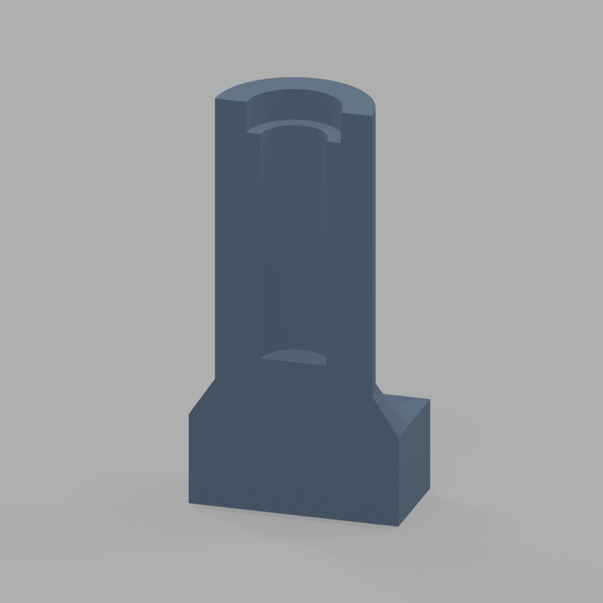
Mechanical/BoardBase/deliverables/Gridopoly_BoardBase_Test_R2_PRINT_FRIENDLY/mounting_post_section.png
