Ha22yX/Gridopoly/Mechanical/PlayerConsoleStand/outputs/renders/stand_assembled.png

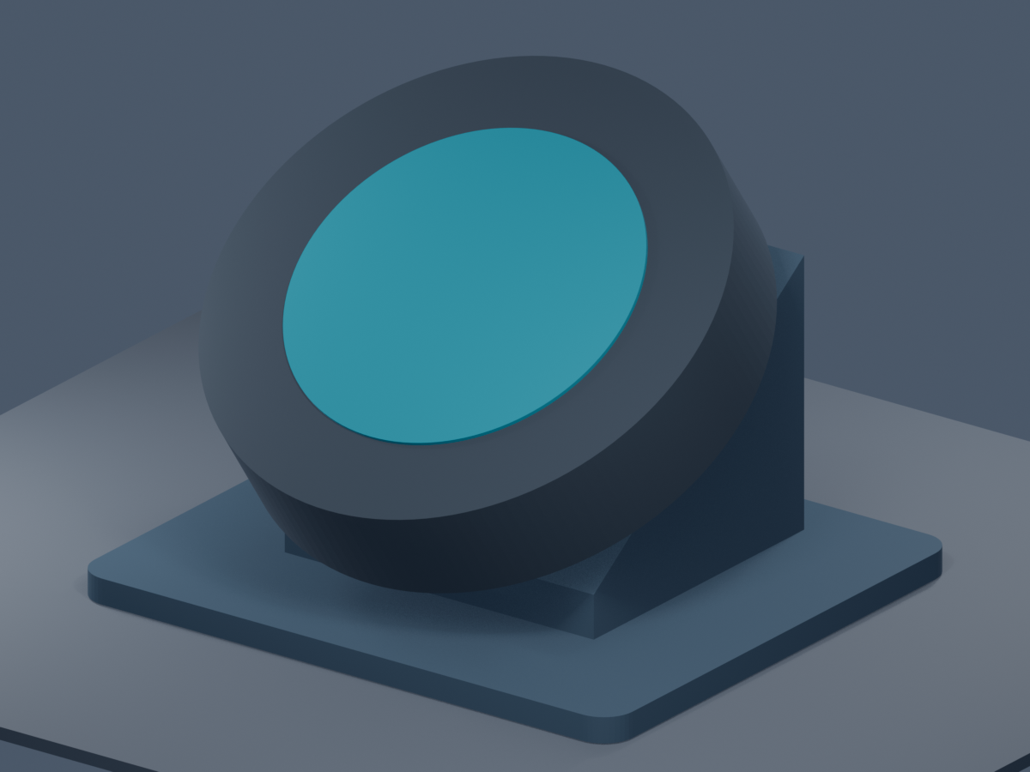
Mechanical/PlayerConsoleStand/outputs/renders/stand_assembled.png
