Ha22yX/Gridopoly/Mechanical/PlayerConsoleStandV2/deliverables/Gridopoly_Player_Stand_V2_R1/01_Assembly.png

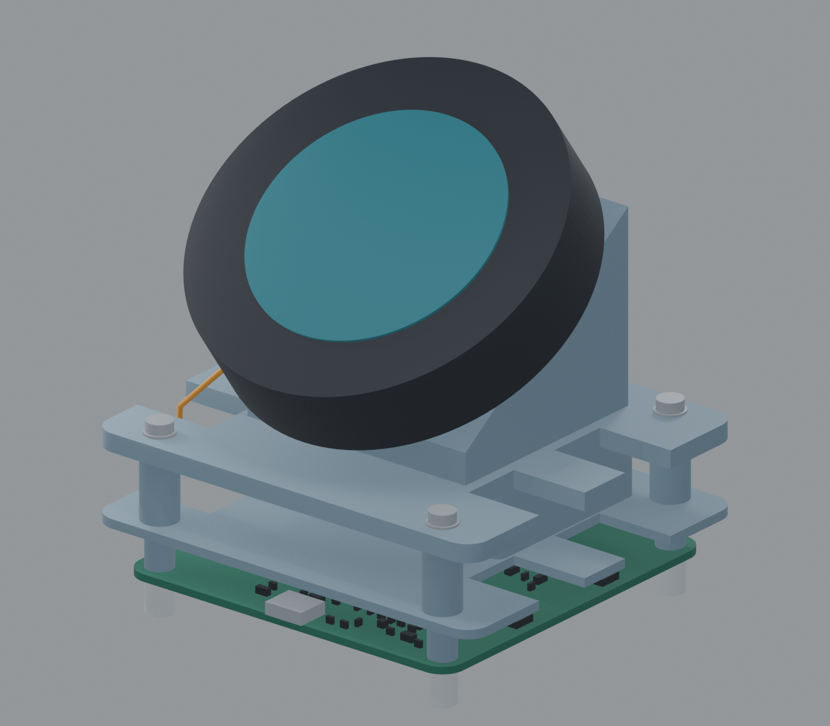
Mechanical/PlayerConsoleStandV2/deliverables/Gridopoly_Player_Stand_V2_R1/01_Assembly.png
