Ha22yX/Gridopoly/Mechanical/PlayerConsoleStandV2/deliverables/Gridopoly_Player_Stand_V2_R2_FPC60/preview-assembly.png

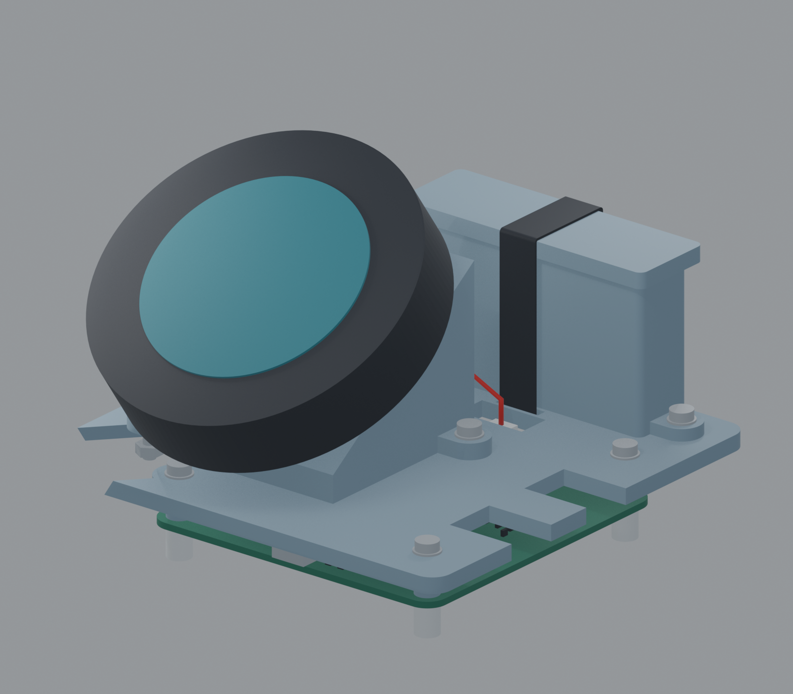
Mechanical/PlayerConsoleStandV2/deliverables/Gridopoly_Player_Stand_V2_R2_FPC60/preview-assembly.png
