Ha22yX/Gridopoly/Mechanical/PlayerConsoleStandV2/revisions/R3_EAR_REINFORCED/assembly_guide/assets/00_assembled.png

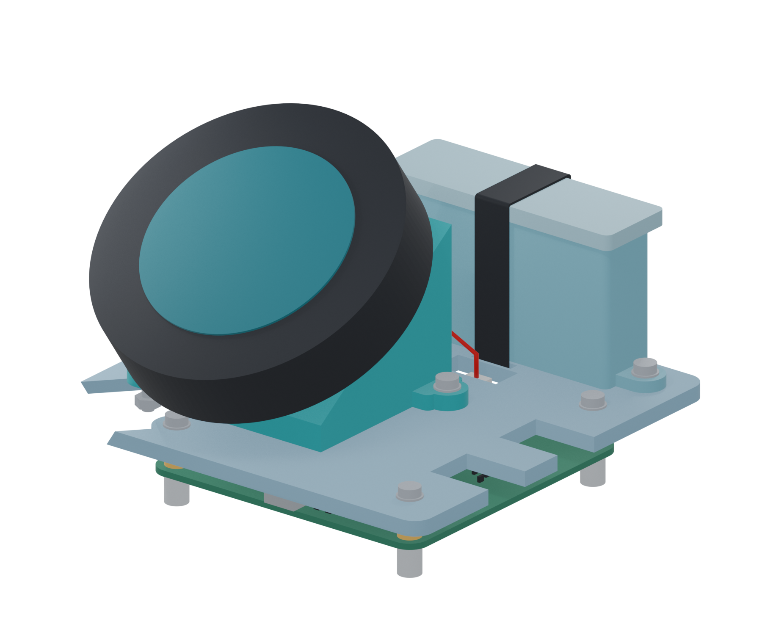
Mechanical/PlayerConsoleStandV2/revisions/R3_EAR_REINFORCED/assembly_guide/assets/00_assembled.png
