Ha22yX/Gridopoly/Mechanical/PlayerConsoleStandV2/revisions/R3_EAR_REINFORCED/assembly_guide/assets/02_pcb_stack.png

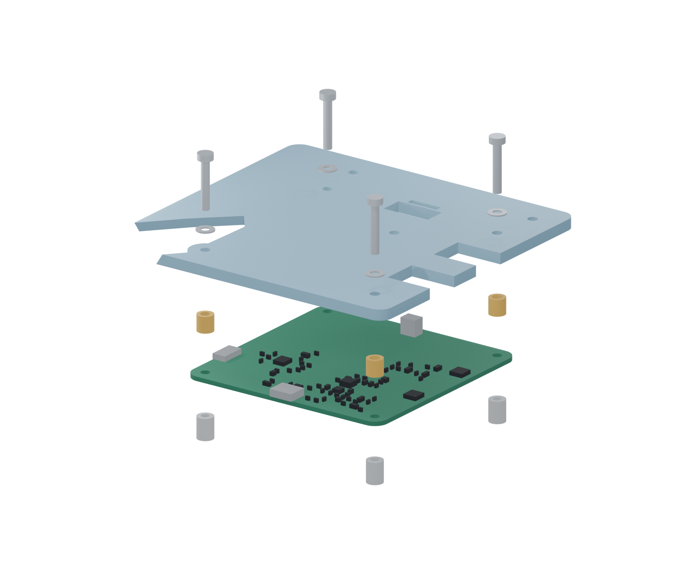
Mechanical/PlayerConsoleStandV2/revisions/R3_EAR_REINFORCED/assembly_guide/assets/02_pcb_stack.png
