Ha22yX/Gridopoly/Mechanical/PlayerConsoleStandV2/revisions/R3_EAR_REINFORCED/assembly_guide/assets/03_fpc_route.png

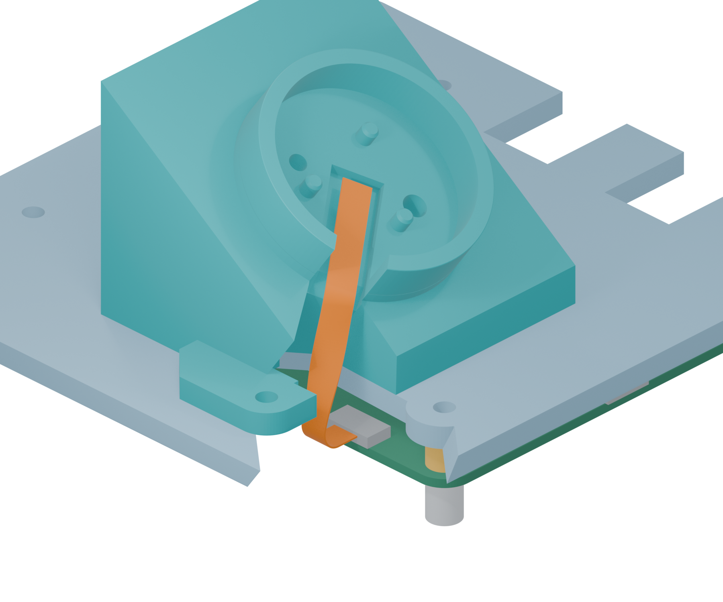
Mechanical/PlayerConsoleStandV2/revisions/R3_EAR_REINFORCED/assembly_guide/assets/03_fpc_route.png
