Ha22yX/Gridopoly/Mechanical/PlayerTokens/references/animal-team-monochrome-v2/02-beaver-builder.png

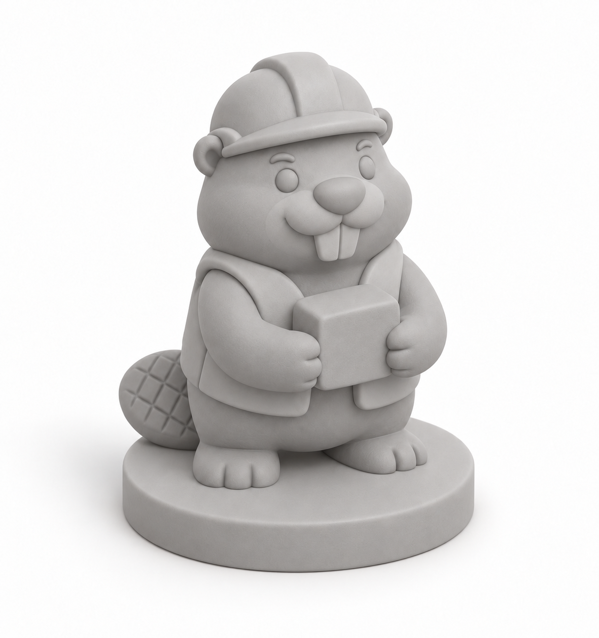
Mechanical/PlayerTokens/references/animal-team-monochrome-v2/02-beaver-builder.png
