Ha22yX/Gridopoly/PCB Files/CornerModule/LayoutCandidate-2026-09-21/assembly-placement-review.png

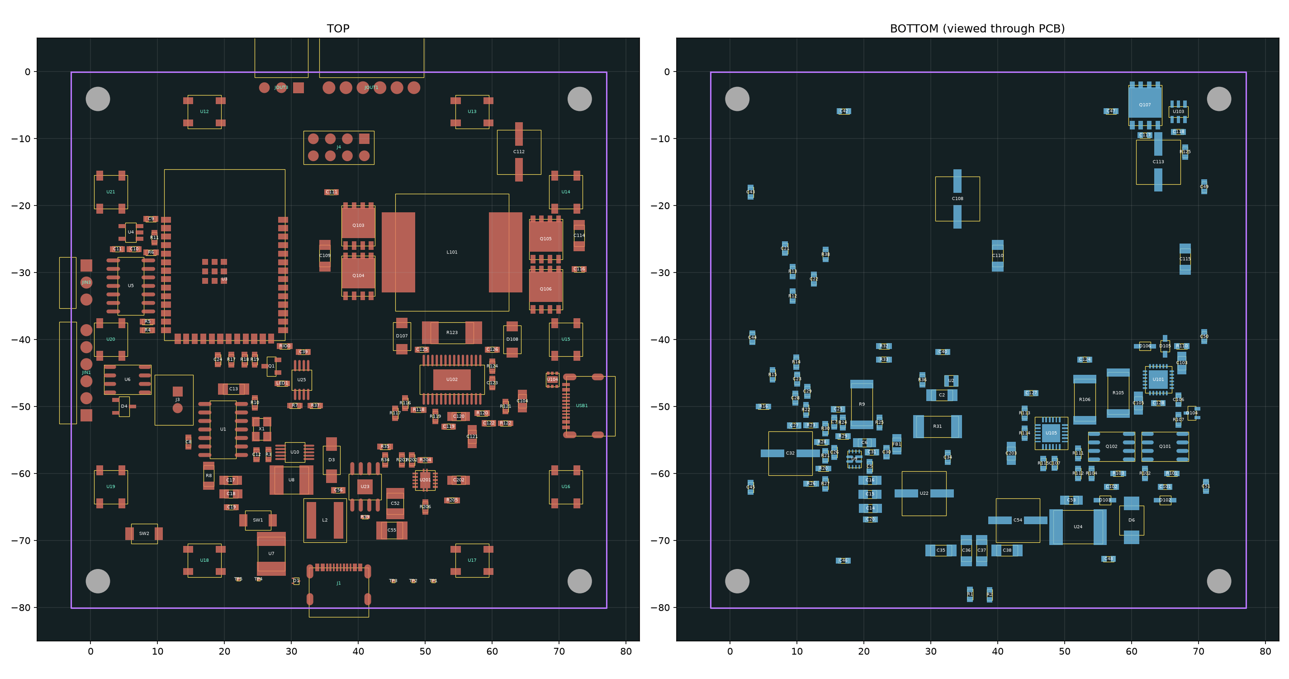
PCB Files/CornerModule/LayoutCandidate-2026-09-21/assembly-placement-review.png
