Ha22yX/Gridopoly/PCB Files/PlayerConsolePower/Layout-2026-09-27-RC2/pcb-bottom-fabrication-preview.png

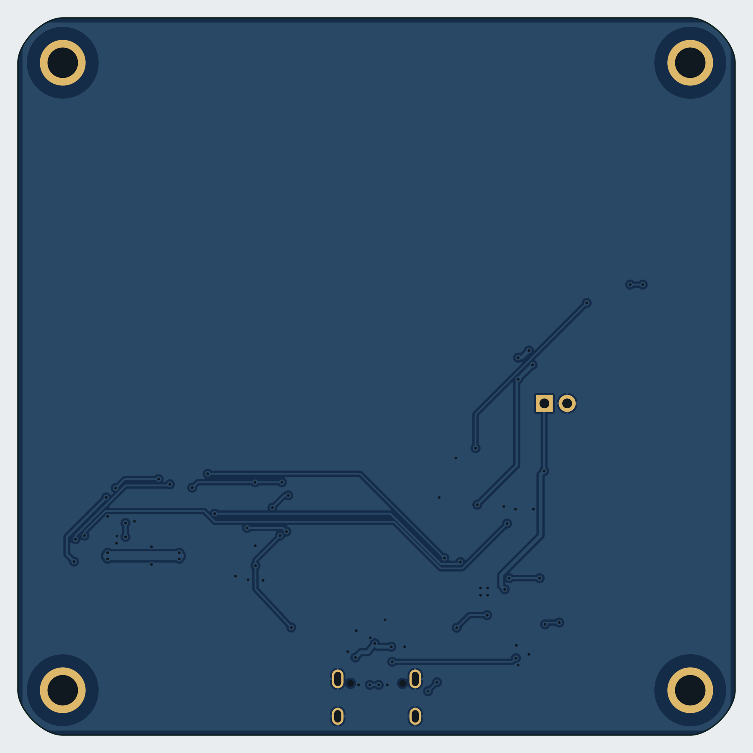
PCB Files/PlayerConsolePower/Layout-2026-09-27-RC2/pcb-bottom-fabrication-preview.png
