Ha22yX/Gridopoly/Firmware/TileModuleTests/README.md

# Tile Module Hardware Tests

This directory contains isolated bring-up firmware for the Gridopoly tile PCB.
Nothing here is linked into the production tile firmware.
