Ha22yX/Gridopoly/Firmware/TileModuleTests/HostRegression/README.md

# Tile firmware host regression

This standalone CMake project runs the four existing Unity native suites and
tests selected production firmware routines with deterministic RTOS, Serial,
and RMT boundaries. It does not connect to a device or server.

`extract_fixture.py` copies the actual inventory publication, network-cache
update, movement-change comparison, and LED-rendering routines into the build
directory. Only hardware boundaries are stubbed. Expected source boundaries
are explicit; extraction fails if they move. The output is generated and must
not be committed. This test does not compile the entire Arduino application,
exercise real scheduler contention, or verify emitted LED electrical signals.

The fault-injection cases cover a failed cache lock followed by an identical
inventory, replacement with the latest complete inventory, and preservation of
reader state/UID/overflow/revision consistency. The pre-fix V0.27 source fails
the first two cases. LED cases cover all ten pixels, channel limits, smooth
green breathing, orange breathing, unchanged movement through a resync, and
return to the normal tile color.

V0.35 introduced final-send clamping (now `led_scene::sendPixels`). Cases exercise all
connection and pairing states (including success), idle/owner/occupied colors,
unchanged pulse periods, and the lower destination/departure RGB amplitudes.
Direct oversized pixels are capped at 16 on all ten LEDs without cumulative
dimming. The fixed 8/255 maintenance RGB/off commands reach that same boundary
and expire into the current scene without changing the network snapshot.

V0.38 uses the actual value-snapshot projection and header-only scene evaluator.
The destination is a 2400 ms smoothstep breath, interpolated at final wire RGB
resolution from (1,3,2) to (5,15,12). The boundary test samples every 20 ms across
two periods: all green levels 3..15 occur, no off interval, each RGB channel
changes by at most one, and green stays dominant. The separate `led_scene` suite
checks symmetry, rounded extrema, clock wrap, late sampling without restarting,
producer stalls, copied input ownership, lease expiry and bounded preview return
to the latest real scene. It uses the production Animator, not a duplicate waveform.
These deterministic checks do not measure FreeRTOS deadlines; `LED STATUS` reports
actual maximum frame gap and late frames for subsequent device acceptance.

Cue resends and global server/movement revisions no longer reset phase. Mode,
player, assignment availability or tile identity changes do. The protocol has no
stable move ID, so two identical cues with an unobserved intermediate `none`
remain indistinguishable. `LED DESTINATION 1..30` and `LED DEPARTURE 1..30` run
the same scene functions locally, expire from command issue time and can be
cancelled with `LED AUTO`; they never change network/game/Tag state.

Pairing regression retains the production RF freshness gates: an incomplete scan
can preserve stable displayed UIDs while reporting fresh=false; a later complete
identical inventory refreshes scan sequence/age without changing tag revision.
The real `publishTagStatus` empty-set wrapper is tested through removal debounce
and the next fully fresh empty scan. Client safety thresholds are unchanged.

V0.36 additionally extracts the actual display initialization, controller recovery
and `DisplaySink` routines. The existing boundary suite checks that MADCTL rotation
is set at the safe rate before restoring the selected SPI speed, both canvases
remain unrotated, either PSRAM allocation failure keeps the same panel orientation,
and recovery invalidates the submitted shadow before repainting. Full-page,
artwork-sized, footer and last-pixel writes retain their logical windows and row
order. These hardware-call fakes do not emulate rotation or prove optical output;
the fixed Adafruit driver implementation is reviewed separately. The existing
`display_diff` suite still covers changed spans, full refresh and retry behavior.

V0.37 adds `development_artwork`, which compiles the production cache and
streaming downloader against bounded transport/allocation boundaries and real
RGB565 files. Eleven cases cover exact length/CRC/LE pixels, truncation, wrong
encoding, timeouts, 503/429, offline and Retry-After across assignment changes,
L0/non-property exclusion, one in-flight request, stale generations including
A-B-A, five-ready/one-staging capacity, pinned LRU entries, failed allocation,
millis rollover, fresh boot state and bounded probe commands. A real host thread
downloads into staging while the display owner holds a lease and changes the
selection. `network_contract` also runs real server serialization through tile
parsing for levels 0-5, downgrade, missing legacy fields and invalid types. These
tests do not claim ESP scheduling/heap measurements or physical image acceptance.

The ORDER suite drives the production V1 transmitter/receiver at 1 ms intervals
with both 16 and 32 independent links. It checks direct neighbors, one broken
wire expiring without stopping other transmitters, reconnection with a newer
frame, and one restarted node changing only its successor's upstream identity.
This is a timing/state-machine simulation, not an electrical ring test.

The network-contract suite also extracts the production server tile projection,
HTTP assignment/heartbeat serialization, and device `parsePayload`. It links
the actual BoardCatalog and Grid City visual catalog, covering all 16 tiles
(including corners 0/4/8/12), artwork/prices, a changed manual anchor,
assignment revocation/recovery, and all active pairing states on an unassigned
reader suppressing movement. Only clock/RSSI/Serial boundaries are stubbed;
the private `projectTile` qualifier is removed to call its unchanged body.
The server topology solver, live HTTP, physical Tag operations, and display
appearance are outside this suite. No online heartbeats are fabricated.

Use a dedicated output directory. Unity defaults to the dependency installed
by `pio test -d Firmware/TileModule -e native`; use `-DUNITY_ROOT=...` if needed.

```powershell
cmake -S Firmware/TileModuleTests/HostRegression -B C:/GridopolyBuilds/tile-native -DCMAKE_BUILD_TYPE=Debug
cmake --build C:/GridopolyBuilds/tile-native --config Debug
ctest --test-dir C:/GridopolyBuilds/tile-native -C Debug --output-on-failure
```

The normal ESP32 build remains required before deploying firmware.
Debug is sufficient for these deterministic host checks and avoids the long
MSVC Release optimization of the header-only decoder fixture.

The WS2812 suite uses the production encoder, maintenance parser/state and
transmission controller. It checks all byte values against the exact
WS2812B-B-V6 timing table, GRB/MSB ordering across ten pixels, buffer bounds,
dim single-channel/off commands, invalid input, permanent expiry across clock
wrap, and rejection of an overlong serial line with an otherwise valid prefix.
Fault injection covers wrong counter clock, initialization/write/completion
errors, retained stop errors and refusal to retry after a failed transmission.
The firmware-boundary suite also exercises the actual render path restoring
the current movement scene after maintenance expires without changing the
network snapshot. These checks do not measure GPIO21, the level shifter, DIN,
LED current, or visible color. A driver completion is not optical acceptance.
