Ha22yX/Gridopoly/Mechanical/BoardBase/deliverables/Gridopoly_BoardBase_Test_R1_ONE_PIECE/README.md

# Gridopoly 整体棋盘底板 · 三模块首件 R1

当前版本：**R1_ONE_PIECE，待打印试装**。本次交付是一块连续的 L 形底板，同时固定一个角落 PCB 和与其相邻的两块长边 PCB；每块板的位置固定，每块只用两个对角螺丝。12 根支撑柱与底板一体打印，其中 6 根用于螺丝固定，另外 6 根辅助承托、定位。

用户已明确要求完整 16 模块也使用一个整体底板、每模块位置固定。此前 R0 的独立模块支架及滑动连接方案已废弃，不再作为打印或装配依据。

## 交付文件

输出目录：`C:/Users/kicof/Downloads/Gridopoly_BoardBase_Test_R1_ONE_PIECE/`

| 文件 | 用途 |
|---|---|
| `ONE_PIECE_Corner_Test_R1.3mf` | 推荐导入 Bambu Studio 的毫米单位模型，仅一个打印实体；不含打印机或耗材预设 |
| `ONE_PIECE_Corner_Test_R1.stl` | 同一打印实体的 STL，导入时使用毫米、100% 比例 |
| `Gridopoly_OnePiece_Corner_Test_R1.blend` | Blender 可编辑场景，含独立的 PCB 与螺钉示意对象 |
| `fixture_frame.png` / `fixture_assembled.png` | 底板及装板示意；绿色 PCB 和金属色螺丝不属于打印件 |
| `fixture-config.json` / `rebuild_in_blender.py` | 参数与重建来源；重建脚本只在新建空场景使用，会清空当前场景对象 |
| `verification-report.json` | 独立导出网格检查与尺寸记录 |
| `assembly-verification.json` | 底板与三个 PCB 板材参考实体的相交检查 |
| `README.md` | 本说明 |

3MF 为便于导入，将 STL 的坐标整体平移 (+67, +4, 0) mm；几何、孔距和尺寸相同。不要把 Blender 场景中的参考 PCB、螺钉或背景地面一起导出打印。

## 当前尺寸与安装方式

| 项目 | R1 名义值 |
|---|---|
| 底板外接尺寸 | 151 × 151 mm，L 形连续实体 |
| 平板厚度 | 3.5 mm |
| PCB 底面离桌面 | 16 mm |
| PCB 板厚 | 按用户提供的约 1.6 mm |
| 最大打印高度 | 16.8 mm，包含未锁紧孔内的定位销 |
| 支撑柱与 PCB 接触直径 | 6 mm |
| 锁紧柱螺丝通孔 | 3.6 mm |
| 未锁紧孔定位销 | 直径 2.8 mm，高 0.8 mm |
| 辅助承托 | 每板第三点与主柱等高；第四点低 0.2 mm，避免四点硬顶 |
| 底面螺母槽 | 对边 5.8 mm、深 2.6 mm，供普通 M3 六角螺母 |
| 最大板底突出 | 用户测得两种模块均约 8.1 mm |
| 元件与底板顶面的名义余量 | 16 − 8.1 − 3.5 = **4.4 mm** |

统一从 PCB 器件面俯视，按 PCB 接口文件的原方向：角落板使用左上 TL 和右下 BR 孔锁紧；两块长边板各使用右上 TR 和左下 BL 孔锁紧。相邻长边在底板上旋转后仍保持其本板对应的这两个孔。

## 螺丝采购规格

- **M3 × 18 mm 普通圆头/盘头机螺钉：6 颗**。18 mm 指头下长度，螺丝头外径不超过 6 mm。不使用沉头螺丝压 PCB。
- **垫片：6 片**，内径约 3.2 mm、外径不超过 6 mm、厚 **1.0 mm**。可用两片 0.5 mm 叠成一组，此时需要 12 片。
- **普通 M3 六角螺母：6 颗**，名义对边 5.5 mm、高约 2.4 mm；不使用更高的尼龙锁紧螺母。

名义长度链为 16 + 1.6 + 1.0 − 18 = **0.6 mm**，即螺钉末端应在底面上方。螺母贴合槽顶时，螺纹名义重叠约 **2.0 mm**。尺寸公差和端部倒角会影响实际啮合，首装检查能拧入数圈且不凸出底面。这里只需手拧轻夹紧，不是高预紧承力结构。

垫片厚度已由早期草稿的 0.5 mm 改为 1.0 mm，以增加螺钉底部余量；模型孔柱尺寸没有因此改变。

## H2D / PLA 首印建议

本件 151 × 151 mm 可在 H2D 上平放打印。导入 3MF 后使用实际安装的喷嘴和 PLA 配置，保持 100% 比例、底板平面贴床、柱子向上。以下按 0.4 mm 喷嘴给出起始设置，不是已实测的切片工程：

- 层高 0.20 mm；4 道墙；顶底各 5 层；约 20% 填充。
- 先不开全局支撑。底面螺母凹槽在槽顶有短桥接，切片预览应检查桥接、螺丝孔和定位销是否完整。
- 需要时加约 5 mm 外侧裙边以降低大平底翘曲；清除裙边后再试装。
- 螺母槽、定位销和通孔需去除毛边；不要通过整体缩放模型调整孔径，否则 PCB 孔距也会改变。

尚未在 Bambu Studio 实际切片或实打印，未给出打印时长、耗材重量或材料强度保证。

## 首次试装顺序

1. 先不通电。把一角两长三个 PCB 自然插好，保持用户已确认的共同板面；观察接口是否完全就位。
2. 不装螺丝，先将三板一起落到整体底板的孔柱上。所有孔应自然对准，辅助定位销应自由进入，不应靠拉扯板子或压弯连接器对孔。
3. 检查板底最高元件、焊点与底板之间有余量，柱顶只接触孔周安全环面；确认 USB/DC 等接口及插头可以操作。渲染图不包含全部元件和线缆外壳。
4. 将 6 颗普通 M3 螺母从底面装入槽内，可先用少量胶带临时固定，避免翻转装配时脱落；胶带不能形成不平的脚垫。
5. 每块 PCB 只装两个指定对角螺丝和相应垫片，交替轻轻锁紧。无需再给其余两个辅助支撑点加螺丝。
6. 检查三板仍共面、底板不摇晃、螺丝末端和螺母均不凸底，且接口可插拔。不要用继续拧紧来消除翘曲、孔距不合或板面高度差。

**固定板间距仍是首件待核对项。** 当前取凸出板边间隙 g = 9 mm；这是在用户所量 12 mm（角落—长边）、15 mm（长边—长边）指主体直边的条件下，扣除长边每侧 3 mm 凸出后得到的推算。用户尚未确认测量边界，不能把 9 mm 当成精确实测值。若自然插合后孔位不能同时落下，请停止锁紧，反馈实测边界/间隙和偏差，修改固定模型后重印；本版没有滑块或可调安装位置。

## 检查结果与来源

原生 Blender 网格和独立导出的 STL 均为一个闭合连通实体。独立 STL 检查：4248 个唯一顶点、8516 个三角面，无边界边、非流形边、反向接边或退化面；尺寸 151 × 151 × 16.8 mm。12 根孔柱与冻结 PCB 接口坐标逐点对应，6 个锁紧孔均为推荐对角孔。底板与带孔 PCB 板材参考实体的相交体积仅为数值舍入级别；此检查不覆盖每颗元件实物高度、线缆运动及打印公差。

PCB 来源为长边 PCB2_1 / `7840864f79449b47` 和角落 PCB2_5 / `6f97d7be5a40dd66`。接口团队已从当前工程、Gerber 和钻孔文件核对板框、名义 Ø3.5 mm 安装孔，以及外径 6 mm / 内径 3.6 mm 的安全支撑环。111 个底部 XY 排除区中逐件 Z 仍未知，最高突出采用用户约 8.1 mm 的实测反馈。

冻结数据：[mechanical-interface.json](Z:/Files/我的项目/Gridopoly/Mechanical/BoardBase/interfaces/pcb-interface-2026-10-15/mechanical-interface.json)，SHA256：`e78d4cbc840f58c6564f7e6513c5992925e54811c4d39e5e01467c7390e53df6`。该历史交接包中的 14 mm 高度、可调支架或滑移建议已被 R1 的固定整体底板要求覆盖，包本身保持原始哈希不变。当前实板批次与制造文件尚未通过批次哈希绑定，必须以首件试装确认实物一致。

## 完整 16 模块的后续设计

完整方案继续采用 **一块整体底板，4 个角落 + 12 个长边，每个模块固定位置**。首件先核对自然接缝、孔距和底部空间，避免把尺寸误差复制到整盘。

按当前候选 g = 9 mm，PCB 周边外宽约 2×80 + 3×54 + 4×9 = **358 mm**；加两侧各 4 mm 底板余边后约 **366 mm**。这超过 H2D 的常规单喷嘴平放打印范围 325×320 mm（参见 [Bambu H2D 官方规格](https://cdn1.bambulab.com/documentation/h2d/en/H2D_Laser_Full_Combo_20250305.pdf)）。完整整体件的制造方式在首件验证后确定；没有把分块、独立底座或拼装底板当成用户已批准的方案。本次交付不包含已验证的完整 16 模块制造模型。
