Ha22yX/Gridopoly/PCB Files/PlayerConsolePower/ProductionAudit-2026-10-05/arrival-tests.md

# 玩家供电板到货验证表

2026-10-05制定，全部尚未执行。适用于本轮读取到的RC5同等设计，先确认订单实际版号。测试记录应包含板号、所用电池包、屏幕版型、USB线/端口、固件版本、仪表精度及测量值；不是仅勾选“可用”。

| 顺序 | 操作 | 观察/验收与异常处理 |
| --- | --- | --- |
| 1 断电检查 | 核对RC5版号、装配方向、J3插件实际焊接；电池、USB、屏幕均断开，测J3.1到GND及J3.2到BAT_PACK | 确认无电源短路；电容充电导致瞬间蜂鸣不等于短路。电池插头单独测极性，与板端对应后才连接 |
| 2 排线核验 | 在未上电时确认J2实际装入方向、补强厚度和通断 | 底板J2.10到屏VCC、J2.8到屏GND、J2.2到屏D+、J2.1到屏D−；不要把电源脚误插到USB信号脚。不能靠插得进去代替通断 |
| 3 电池单独供电 | 先不接USB，用已确认的受保护1S电池，检查关机/开机；有条件先用限流电源代替电池验证 | 关机5V_SCREEN应停止供电；开机标称4.992V。接屏后记录启动、最高亮度/Wi-Fi时5V谷值/纹波及电流；若FPC持续负载超出0.5A额定值，不继续长期运行 |
| 4 USB充电 | 先解决README中的电池包充电电压容差；以确认支持5V、CC至少1.5A的源，测试关屏与开屏 | 关屏可充电；典型恒流约500mA，公差、输入及热限制会改变实际值。记录CV最高电池端电压，包含仪表误差；不得超过实际电池包允许值。若仅采用现有公开规格，则上限4.22V；不能用电池保护板跳闸作为正常终止方式 |
| 5 电源切换和温升 | 电池正常、屏幕满亮度/无线工作，插拔USB；在最终底座装配中完成有界热测试 | 不应复位/失去显示；记录U1、电池附近和外壳温升。若热调节严重或超过器件/电池条件，停止并评估散热或减小充电电流；R1改约3.57k可把典型恒流降至250mA，但不能解决终止电压容差 |
| 6 USB烧录/调试 | 电池有充足电量，先按POWER开屏；用数据线接电脑，验证USB插头两个方向；上传已知可恢复的固件并做写后验证，检查重启与持续USB日志 | A-to-C默认档约100mA，不把电量下降当成充电芯片必坏。若普通端口不能稳定启动，先充电或改用广播至少1.5A且支持数据的主机端口；不用强行改EN脚绕过电源能力判断 |
| 7 下载恢复 | 固件USB不可用时，按住屏幕BOOT/GPIO0，再短按本板RST，释放RST后再松BOOT，检查ROM下载枚举 | 厂家板型/按压行为须实物确认；RESET不等于BOOT。若要求断点调试，另验USB Serial/JTAG、驱动/OpenOCD及固件配置，串口有日志不能代替断点调试通过 |
| 8 欠压关机 | 断开USB和实物电池，用可调限流电源代替电池，缓慢降低输入，记录SYS_RAW、电池端电压及5V状态 | 标称SYS_RAW约3.30V，保守公差约3.16–3.44V；切断后回升不自行开屏，再按POWER恢复。不将普通不能吸收电流的台式电源接成“电池”后开启USB充电 |
| 9 电量和状态 | 由玩家屏任务部署明确启用遥测的候选，用MAX17048测量值对比万用表，同时记录U9输入CHG/PGOOD | 底板无需固件。先验UART握手/电压，再验SOC；测试USB插拔、充电结束、屏幕RST、整板关开机、关屏充电后重开。GPIO0/1保持输入，CHG高不单独解释为充满 |
| 10 存放耗电与完成判定 | 测关屏静态电流，核验电池包保护规格；完成原理图41条警告分类及订单DFM/装配复核 | 欠压关屏不等于电池完全断开；不能长时间放置耗尽电池。只有记录完整且问题闭合后，才标相应功能通过 |

电池极性或FPC针序错误应在上电前解决；电压容差、USB供电和热问题按[本轮复核](README.md)处理。需要改板时另存新候选并同步原理图/PCB/制造文件；不改写已下单RC5证据。
