Ha22yX/Gridopoly/PCB Files/PlayerConsolePower/Layout-2026-09-27/bringup-checklist.md

# R1 首板验收记录（未执行）

所有“实际结果”初始为待测。不得填入理论值冒充测量。记录 PCB/固件版本、电池型号、排线方向、线缆、USB 来源和仪器。

## 上电前

| 项目 | 合格条件 | 实际结果 |
| --- | --- | --- |
| FPC 插入 | 厚度、接触面、锁扣与插入深度匹配；断电测得屏幕5V→J2.10、GND→J2.8、D+→J2.2、D−→J2.1 | 待测 |
| 电池 | 厂家确认1S/4.2V、保护、电流/温度范围；正负极实测与J3一致 | 待测 |
| 焊接 | 无桥连、错向、漏贴；重点QFN EP与USB-C细间距；确认两键松开不短地 | 待测 |
| 静态短路 | USB_VBUS/BAT_PACK/SYS_RAW/5V_SCREEN分别对地无非预期低阻 | 待测 |

## 电源与控制

使用限流电源、电子负载/电池模拟器进行可控测试。测试充电时，模拟器必须能吸收充电电流；普通只供电的台式电源不能直接作为充电电池替代品。

| 场景 | 检查与预期 | 实际結果 |
| --- | --- | --- |
| 电池供电/按键 | 建立SYS后按POWER开屏，5V目标约4.992V；再次按下关闭；RST松开不拉低，按下复位 | 待测 |
| 降压欠压试验 | 缓慢降低模拟电池，SYS检测典型约3.30V，考虑器件公差预计约3.16–3.44V；关机后不反复抖动重启 | 待测 |
| 恢复与锁存 | 电压恢复后按键重新开机；保持按键、USB插拔、空电池条件无异常自激 | 待测 |
| 高负载/瞬态 | 满亮度+Wi-Fi，测屏幕端电压、纹波、启动瞬态和U1/U2/L1温升；不得超过屏幕或电池限制 | 待测 |
| 关机待机 | 记录电池电流、5V放电、数据脚回灌；长期存放由电池包保护兜底 | 待测 |
| 充电 | 关闭/开启屏幕分别测电池电压、电流、终止和再充电；目标约500mA，温升/功率分配可能降低实际电流 | 待测 |
| USB输入限流 | 默认来源按100mA模式；C口1.5/3A宣告时切换约0.9A输入限流。不能因C口宣告3A就认为板子吸收3A | 待测 |

## USB 与遥测

| 场景 | 检查与预期 | 实际结果 |
| --- | --- | --- |
| 线缆与方向 | A-to-C、C-to-C均正反插验证；屏幕开启后稳定枚举 | 待测 |
| 上传/日志/恢复 | 多次完整上传、串口日志与调试，验证厂家ROM恢复/BOOT+RST操作；断电/重插不产生不可恢复状态 | 待测 |
| 电源交接 | 运行中插拔USB，电池辅助供电，检查掉电复位/USB重枚举行为 | 待测 |
| UART桥 | 屏幕TX/RX对应U9 RX/TX，3.3V；9600/8N1读版本，I²C与GPIO命令正确 | 待测 |
| 电压/SOC | VCELL与仪表比较；SOC为估算，不承诺线性或瞬时准确；错误时显示未知 | 待测 |
| 充电状态 | PGOOD/CHG低有效逻辑、再充电和故障闪烁正确解释；CHG高不强制100% | 待测 |
| 关机充电后 | U9关闭、U10继续跟踪；MAX17048 EnSleep保持0，重启后SOC连续，不每次重置电量计 | 待测 |

本表不替代 USB 电气合规测试或电池认证。对于本批5–10块，先记录首件结果，发现问题先回改电路/布局并重新检查，不将尚未测试的RC1自动转成量产版本。
