Ha22yX/Gridopoly/Docs/player-console/player-console-acceptance-tests.md

# Gridopoly 玩家圆屏验收测试

> 2026-10-15 状态澄清：本页是验收要求，当前结果见末尾状态表及[当前基线](current-player-console-baseline.md)。USB热点20台接入、16格闭环和三真人Tag配对已获证据，不等于四真人完整流程通过；COM27/28及COM29的静止等待页正常不等于所有页面通过。core0七场景性能PASS因频闪/错位撤回；core1历史Retarget max57ms与游戏页目视门槛仍未关闭。完整版本边界见[当前交接](../CURRENT-DEVELOPMENT-HANDOFF.md)。

状态：当前发布验收基线 2.0

更新日期：2026-10-15；本轮只整合既有证据，未重新执行设备或固件测试。

## 1. 范围

本文定义 2.1 英寸 480×480 圆形玩家终端的软硬件验收标准，并覆盖当前 Raspberry Pi
Wi-Fi/UDP 权威服务端联调。圆屏不运行完整规则引擎，但必须正确执行全部权威页面和输入流程。

## 2. 测试环境记录

每轮验收必须记录：

- 圆屏模块硬件版本、完整 MAC、设备 ID 和端口
- 实际底板/转接方式及返修状态
- ESP32-S3固件Git提交、应用SHA-256、sourceDigest、板型及 `BatteryBoard`、`DisplayClock`、`DisplayDiagnostic`；区分当前部署与待部署候选
- 资源包与协议版本
- 树莓派或协议模拟器版本
- 供电方式
- 屏幕亮度
- 物理安装、机械 60°和固件 0°配置
- 测试日期与测试人员

## 3. 启动与模式

| ID | 测试 | 步骤 | 通过标准 |
| --- | --- | --- | --- |
| BOOT-01 | 冷启动 | 正常固件断电后上电 | 无花屏，连接/等待新局直到真实身份到达；只有Demo构建进入Demo首页 |
| BOOT-02 | 隔离 Demo/SelfTest | 启动对应测试构建 | 数据与选定 fixture 一致，不连接或改写正式房间；历史五人 Demo 不代表正式席位数 |
| BOOT-03 | 正式模式 | 启动正式构建 | 不显示 Demo 数据或 Demo Lab 标记 |
| BOOT-04 | 资源缺失 | 移除一个非关键图片 | 显示安全占位图并输出日志 |
| BOOT-05 | 协议不兼容 | 模拟主版本不匹配 | 显示升级页，不进入房间 |

## 4. 方向与触摸

| ID | 测试 | 步骤 | 通过标准 |
| --- | --- | --- | --- |
| GEO-01 | 视觉正向 | 打开方向校准页并装入底座 | 十二点箭头正对玩家，文字水平 |
| GEO-02 | 默认角度 | 查看诊断配置 | 显示机械顺时针 60°、固件 0° |
| GEO-03 | 中心触摸 | 点击中心目标 | 误差小于 12 px |
| GEO-04 | 正交触摸 | 点击上下左右目标 | 每点误差小于 12 px |
| GEO-05 | 对角触摸 | 点击四个对角目标 | 每点误差小于 20 px |
| GEO-06 | 滑动方向 | 在旋转后的屏幕上上下滑动 | 逻辑列表与玩家视角一致 |
| GEO-07 | 边缘拒绝 | 点击圆外和不可见区域 | 不触发任何控件 |
| GEO-08 | 旋钮方向 | 顺、逆时针各旋转一格 | 焦点按玩家视角沿轮盘对应方向移动，二者互为反向 |
| GEO-09 | 双环同心 | 显示首页、拍卖和弹窗并测量外环 | 外环 `31,31,418,418`、内环 `44,44,392,392`，两者中心均为 `(240,240)`，上下左右间距一致 |

## 5. 布局与文字

| ID | 测试 | 数据 | 通过标准 |
| --- | --- | --- | --- |
| UI-01 | 等待首页 | 标准五人数据 | 外环、余额、位置和入口无重叠 |
| UI-02 | 临近首页 | 下一位是自己 | 当前玩家和提示无重叠 |
| UI-03 | 我的回合 | 骰子主操作 | 骰子是唯一明显主操作 |
| UI-04 | 长地产名 | 12 个汉字 | 单行省略，不推动其他控件 |
| UI-05 | 大额余额 | $12,345,678 | 动态缩小且不越出安全区 |
| UI-06 | 负面状态叠加 | 抵押、债务、断线 | 只显示最高优先级状态 |
| UI-07 | 最小触摸区 | 遍历全部按钮 | 主要目标至少 52×52 px |
| UI-08 | 地区色差异 | 显示全部地区 | 不依赖颜色也能识别状态 |
| UI-09 | 转义 UTF-8 字形 | 浏览四个转义地产名并触发债务刷新提示 | 14px/16px 均无方框或缺字 |
| UI-10 | 回合圆点与状态环 | 分别显示距离 0/1/3/5 人及“我的回合” | 始终 5 个固定圆点，实心数正确；我的回合外圈为绿色，骰子焦点仍为黄色 |

实物验收需要保存正面照片；截图模拟不能替代圆形玻璃、视角和亮度验证。

## 6. 旋钮与按压

| ID | 测试 | 操作 | 通过标准 |
| --- | --- | --- | --- |
| IN-01 | 单步旋转 | 慢转一格 | 焦点只移动一项 |
| IN-02 | 快速旋转 | 连续快速正反转 | 按真实detent保持有序消费，无假反向、跳项或越界；不要求未实现的加速策略 |
| IN-03 | 短按 | 按住少于 500ms | 执行当前普通操作一次 |
| IN-04 | 模糊按压 | 500–799ms 松开 | 不执行短按或返回 |
| IN-05 | 返回 | 按住至 800ms | 返回一级且只触发一次 |
| IN-06 | 首页手势 | 首页按住 3s | 进入 Demo Lab |
| IN-07 | 子页手势 | 子页按住 3s | 返回首页 |
| IN-08 | 触摸同步焦点 | 点击非当前焦点 | 旋钮焦点同步到该控件 |
| IN-09 | 旋钮完整操作 | 禁用触摸后运行核心场景 | 所有关键流程可完成 |
| IN-10 | 聚焦不改值 | 焦点落到金额后继续旋转 | 焦点移动，金额保持不变 |
| IN-11 | 旋钮编辑数值 | 聚焦金额，短按、旋转、再短按 | 仅编辑态改值，第二次短按退出编辑 |
| IN-12 | 触摸编辑数值 | 触摸非焦点金额两次，改值后再触摸 | 首次只聚焦，第二次进入编辑，末次退出 |
| IN-13 | 首页交易接收方 | 从首页进入交易并编辑接收方 | 按下前旋转不改人，编辑态旋转改人，再按退出 |
| IN-14 | 玩家交易锁定 | 从玩家详情发起交易 | 接收方固定为该玩家、显示锁定且不进入编辑焦点 |
| IN-15 | 编辑时切换字段 | 编辑金额时触摸其他字段 | 退出原编辑态并只聚焦新字段，新值不被同次点击修改 |
| IN-16 | 权威状态接管 | 编辑中应用主控快照或强制页面 | 编辑态清除，旋钮不再修改隐藏字段 |
| IN-17 | 首页整组滑动 | 在首页动作区左右滑动并释放 | 与旋钮单步到达相同动作，完整菜单整组过渡，且同次释放不再触发点击 |
| IN-18 | 列表边界回弹 | 在首项继续向上、在底部页脚继续向下滚动 | 只播放 8px/6px 短回弹，焦点、锚点、页码和动作均不变化 |
| IN-19 | 三项首页轮盘 | 等待阶段聚焦 `资产`，连续向左和向右旋转 | 左侧始终显示 `交易`、右侧始终显示 `玩家`，三个入口循环滚动且没有空槽 |
| IN-20 | 结束回合退场 | 聚焦并短按 `结束回合` | 按钮在 320ms 内淡出缩小，三个常驻入口同步补位；命令只发送一次且焦点按动作身份保留 |
| IN-21 | 快速机器人焦点保护 | 结束回合后让全部机器人在 1.2 秒内完成 | 等待菜单至少完整展示 1.2 秒，期间不会闪回 `骰子` 或把焦点硬拉到 `资产`，保持期结束后才进入新回合重点操作 |

## 7. 顶层确认弹窗

| ID | 测试 | 操作 | 通过标准 |
| --- | --- | --- | --- |
| MOD-01 | 出现时机 | 在危险操作上开始按压 | 立即出现弹窗和遮罩 |
| MOD-02 | 底层阻断 | 弹窗出现时触摸底层 | 底层不响应 |
| MOD-03 | 提前松开 | 持续 1199ms 后松开 | 命令数为零、进度归零，弹窗保持打开 |
| MOD-04 | 完成长按 | 持续至 1200ms 并继续按住和 tick | 只发送一次命令，界面稳定显示提交中 |
| MOD-05 | 收租弹窗 | 运行 E02 | 显示租金、付款玩家和地产 |
| MOD-06 | 付款弹窗 | 运行 E04 | 显示收款人、金额和用途 |
| MOD-07 | 交易弹窗 | 运行 T04 | 显示双方和锁定状态 |
| MOD-08 | 抵押弹窗 | 运行 E10 | 显示所得现金和停止收租警告 |
| MOD-09 | 进度层级 | 分别渲染 0%、50%、100% 进度 | 填充完整位于确认框内，不跨越边框、圆角、文字或外环倒计时 |
| MOD-10 | 自愿返回旋钮 | 在可取消弹窗聚焦“返回”并短按 | 不发送命令，关闭弹窗并恢复来源页面、锚点和焦点 |
| MOD-11 | 自愿返回触摸 | 触摸可取消弹窗的“返回” | 与旋钮返回结果完全相同 |
| MOD-12 | 强制无返回 | 打开强制付款、债务抵押确认或破产 | 不创建返回控件或绑定，普通返回和长按回首页均无效 |
| MOD-13 | 完成事件匹配 | 提交后先注入错误请求号，再注入正确非零请求号 | 错误事件不关闭；正确事件清除待处理并关闭一次 |
| MOD-14 | 重复完成 | 正确完成后重复注入同一事件 | 不重复退出、扣款、抵押或显示成功提示 |
| MOD-15 | 演示完成时限 | 分别提交收租和交易 | 150ms 内收到匹配 `CommandCompleted` 并退出弹窗 |
| MOD-16 | 流程覆盖 | 运行收租、交易、自愿抵押、强制付款、债务抵押确认 | 每种流程都遵守对应的返回权限、单次提交和事件匹配规则 |
| MOD-17 | 提交后不可返回 | 自愿弹窗达到 1200ms 后尝试返回 | 返回已移除或禁用，弹窗保持提交中直到匹配完成事件 |

## 8. 计时

| ID | 测试 | 条件 | 通过标准 |
| --- | --- | --- | --- |
| TIME-01（历史设想） | 收租20秒 | Demo可演示，正式服务端未实现 | 不列为当前正式链路已支持或PASS；详见当前游戏规则 |
| TIME-02 | 收租临界提交 | 截止前确认 | 以主控接收时间裁决 |
| TIME-03 | 付款弹窗本地倒计时 | 在线圆屏不操作直到期限 | 圆屏到期只提交一次逻辑付款请求，服务端幂等；不把此项扩写成屏幕离线后的Core定时扣款 |
| TIME-04 | 松开付款 | 提前松开 | 债务与原倒计时仍存在 |
| TIME-05 | 现金不足 | 余额不足 | 付款倒计时暂停 |
| TIME-06 | 恢复付款 | 筹款成功 | 使用新的授权窗口继续结算 |
| TIME-07 | 五屏同步 | 五块终端同时显示 | 视觉剩余时间差不超过 150ms |

所有权威截止时间由主控或协议模拟器判断，不能以屏幕动画结束作为通过依据。

### 8.1 掷骰、到达与抽卡时序

| ID | 测试 | 操作 | 通过标准 |
| --- | --- | --- | --- |
| FLOW-01 | 单次骰子时间线 | 点击 `DICE`，延迟返回骰子结果 | 动画立即开始；服务端结果只填充最终骰面，不从零重启动画 |
| FLOW-02 | 结果延后显示 | 在骰子仍滚动时返回步数 | 动画结束前不显示步数和目的地，结束后至少稳定显示 700ms |
| FLOW-03 | 到达页闸门 | 目的地同时产生购买或债务 | 必须先显示到达位置、归属和后续事件，权威页面不得提前覆盖 |
| FLOW-04 | 本人地产标记 | 让其他玩家在本人持有的地产产生到达、租金或债务事件 | HUD 与 `LIVE ACTIVITY` 对应行显示紧凑 `MY` 标签；地点名称不被拼接或换行，当前页面和焦点不变 |
| FLOW-05 | 标记历史稳定 | 记录带 `MY` 的活动后将该地产交易给其他玩家 | 已记录活动仍保留 `MY`；新所有权下产生的新活动不再显示标签 |
| FLOW-06 | 落地付款说明 | 分别落到他人地产、Income Tax 和 Luxury Tax 并确认到达 | 先显示 Card Result 风格的 `TileEvent`，含格子、原因、收款方、金额和现金；短按继续后才进入强制付款 |
| FLOW-07 | 付款说明幂等 | `TileEvent` 显示中及继续后重复注入同房间同版本债务重同步 | 显示中不被跳过；继续后不重开；付款命令仍只能由后续强制付款弹窗提交 |
| FLOW-08 | 非落地债务隔离 | 触发付款卡和掷骰前的限制区释放费 | 卡牌只使用 Card Result，释放费直接付款，均不额外显示 `TileEvent` |
| FLOW-09 | 手动到达永远可用 | 在只有一个格子模块、RFID 未连接和 Tag 未绑定三种情况下进入到达页 | `I'M THERE` 始终可见、可触摸并纳入旋钮焦点；只发送一次现有 `ConfirmPosition`，不出现 Tag 绑定入口 |
| FLOW-10 | RFID 权威自动到达 | 保持到达页不操作，由服务端确认 Tag 已到目标格并推进权威阶段 | 圆屏不读取 Tag、不猜位置；显示 `TILE ARRIVAL CONFIRMED` 至少 1.2 秒，再进入与手动确认相同的购买、债务、拍卖、抽卡或回合结束页面 |
| FLOW-11 | 自动到达重同步幂等 | 自动确认后重复注入同版本 State/Authority、full resync 和乱序补帧 | 不回到等待页、不重启 1.2 秒时限、不重复发送确认命令，后续页面和焦点保持权威结果 |
| DOUBLE-01 | 双骰结算顺序 | 掷出 4+4 并落到购买、抽卡或债务格 | 先完整处理落点；随后才显示 2 秒奖励页并在首页开放 `ROLL AGAIN` |
| DOUBLE-02 | 双六强调 | 掷出 6+6 | 结果页显示 `DOUBLES!`、`6 + 6 = 12`、`EXTRA ROLL EARNED`；奖励页显示 `DOUBLE SIXES` 和权威连续次数 |
| DOUBLE-03 | 第二次双骰警告 | 连续双骰次数达到 2 | 奖励页显示 `ONE MORE DOUBLE SENDS YOU TO HOLD`，但不修改服务端规则 |
| DOUBLE-04 | 第三次双骰 | 连续第三次掷出双骰 | 权威限制区流程接管，不显示奖励页，也不开放第四次掷骰 |
| DOUBLE-05 | 重同步与乱序 | 结算期间重同步，再注入重复或迟到的 DiceRolled | 奖励动画不重播，已经恢复的 `ROLL AGAIN` 不会退回待处理状态 |
| CARD-01 | Chance 抽卡 | 到达 Chance 并确认 | 先播放至少 1.4 秒抽卡动画，再显示卡名、说明和权威结果 |
| CARD-02 | Community Chest 抽卡 | 到达 Community Chest 并确认 | 使用对应卡组封面和绿色识别色，结果与事件卡号一致 |
| CARD-03 | 结果延迟 | 动画开始后延迟注入 `PlayerCardEvent/Drawn` | 动画等待权威卡牌数据且不重播、不闪回首页、不泄露结果；不得根据金额猜卡 |
| CARD-04 | 后续债务隔离 | 卡片会产生强制付款 | 结果页短按 `CONTINUE` 后只发送携带当前 `cardInstanceId` 的动作，先进入结算等待态，随后权威债务弹窗才可出现 |
| CARD-05 | 不可跳过 | 动画期间旋转、短按和触摸 | 不提前进入结果或后续页面；结果页可正常短按继续 |
| CARD-06 | 重复与旧事件 | 重复当前事件并注入旧实例的 `EffectApplied` | 不重复动画、不重复付款、不覆盖当前卡、不改变已确认结果 |
| CARD-07 | 揭示态重同步 | Authority v3 以 pending flags `0x03` 恢复 | 直接恢复当前卡牌结果页，不重播 1.4 秒动画，并允许当前实例继续一次 |
| CARD-08 | 结算态重同步 | Authority v3 以 pending flags `0x0F` 恢复 | 显示结算等待态，不再显示可操作的 `CONTINUE`，最终由权威结果或后续页面接管 |

## 9. Demo Lab

| ID | 测试 | 步骤 | 通过标准 |
| --- | --- | --- | --- |
| DEMO-01 | 场景目录 | 逐类浏览 | 所有文档场景均可选择 |
| DEMO-02 | 场景复位 | 修改状态后重开 | 恢复固定基线数据 |
| DEMO-03 | 手动步进 | 运行 B04 | 每次短按只推进一步 |
| DEMO-04 | 自动演示 | 完整循环一次 | 无死页，最终重新开始 |
| DEMO-05 | 2×模式 | 加速自动演示 | 显示明显 `DEMO 2×` 标记 |
| DEMO-06 | 确定性 | 同一场景运行两次 | 消息与最终状态一致 |
| DEMO-07 | 传输隔离 | 正式房间在线时运行检查 | Demo 不发送正式命令 |

## 10. Wi-Fi/UDP 与配对

| ID | 测试 | 故障/操作 | 通过标准 |
| --- | --- | --- | --- |
| NET-01 | 热点连接 | 树莓派热点启动 | 圆屏自动连接固定服务 |
| NET-02 | 座位认领 | 按下加入、主控分配 | 玩家色和槽位一致 |
| NET-03 | 自动恢复座位 | 断线重连 | 恢复原玩家，不重复认领 |
| NET-04 | 重复请求 | 重发相同 `request_id` | 返回原结果，不重复执行 |
| NET-05 | 版本缺口 | 丢弃一个增量 | 请求并应用完整快照 |
| NET-06 | 链路降级与重配 | 停止服务端下行 | 9 秒显示全局断链图标并禁用权威动作，15 秒废弃 session 并自动重新发现/配对 |
| NET-07 | 主控重启 | 运行 F02 | 等待恢复，不接受危险操作 |
| NET-08 | 过期命令 | 发送旧版本命令 | 拒绝并刷新快照 |
| NET-09 | 隐私 | 检查其他玩家消息 | 不包含私有卡片和第三方交易 |
| NET-10 | 日志脱敏 | 导出 USB 日志 | 无口令和完整会话令牌 |
| NET-11 | HMAC 损坏 | 翻转 envelope 或 inner frame 任一字节 | 数据报静默丢弃，不更新页面、版本、endpoint 或重放窗口 |
| NET-12 | UDP 重放窗口 | 重放同一 packet sequence，并注入窗口内乱序包 | 首包只应用一次，重复包拒绝，63 包范围内未见过的乱序包可正常应用 |
| NET-13 | 动作 UDP 重发 | 丢弃首个 ActionResult | 重发保留 inner sequence/requestId，但 UDP packet sequence 更新；服务端动作只执行一次 |
| NET-14 | PairAccept 会话绑定 | envelope 与 payload 使用不同或为零的 sessionId | 圆屏拒绝配对且不派生 session key；两处一致且非零才进入同步阶段 |

## 11. 规则界面场景

以下场景只验证圆屏表现和协议结果，不证明本地存在规则引擎：

- 无主地产购买和放弃
- 拍卖
- 地租机会和付款
- 完整地区组与建设
- 抵押、赎回和筹款
- 双方交易
- 限制区三种离开方式
- Chance 和 Community Chest
- 玩家破产和最终胜利

每个场景必须满足[玩家圆屏 Demo 场景](player-console-demo-scenarios.md)定义的最终页面、
焦点和状态摘要。

### 11.1 拍卖同步屏障

| ID | 测试 | 故障/操作 | 通过标准 |
| --- | --- | --- | --- |
| AUC-READY-01 | 少一个真人未 Ready | 两真人参与，只让一屏发送 Ready | 1.8 秒后停留同一 Live 舞台并显示 Ready x/y；Bid/Pass 禁用，不能回到 Opening 欢迎页，bot 不推进 |
| AUC-READY-02 | 最后一个 Ready | 第二屏发送当前 asset+generation 的 Ready | 只启动一次首位竞价，所有屏幕收到一致的新版本 |
| AUC-READY-03 | 重复 Ready | 重发完全相同 ActionRequest | 返回幂等结果，不增加版本、不重复启动 |
| AUC-READY-04 | 旧代次污染 | 新拍卖中发送上一 generation 或 asset | 请求被拒绝，ready mask 不变化 |
| AUC-READY-05 | Opening 中重连 | 已进入介绍页的屏幕断线并全量 resync | 若自身位仍缺失则重发 Ready，并正常解除屏障 |
| AUC-READY-06 | 多端一致 | Web、真人屏和 bot 混合参与 | required/ready mask、当前竞拍者、价格和结算版本一致 |
| AUC-LIFE-01 | 同 key 重同步 | Intro 或 Live 中连续接收同 room+generation+asset 的 State/Auth resync | Intro 总计只出现一次；Live 不回退 |
| AUC-LIFE-02 | Intro 中途重同步 | Intro 开始 900 ms 时收到同 key resync | 仍保持 Intro，到本地 1800 ms 截止后才进入 Live |
| AUC-LIFE-03 | 同房间低版本 | Live v12 时收到带 resync 的 TurnEnd v11 | 整个投影被忽略；phase、generation、asset 和 Live 页面均不变 |
| AUC-LIFE-04 | 已完成 key 迟到 | 结算后收到相同 generation+asset 的 active Authority | 写状态前拒绝；不重复 Result，不回滚 phase 或拍卖字段 |
| AUC-LIFE-05 | 新房间恢复 | 当前版本较高时收到新 room 的 v1 快照 | 允许版本回退、清除旧拍卖历史，并只为新 generation 展示一次 Intro |
| AUC-LIFE-06 | 统一视觉骨架 | 依次观察 Intro、Live waiting、Live bidding、Result | 标的图片、名称、主价格和余额保持同一位置与尺寸，仅底部状态区变化 |

### 11.2 活动通知与事件游标

| ID | 测试 | 故障/操作 | 通过标准 |
| --- | --- | --- | --- |
| ACT-SYNC-01 | 32 条全量历史 | 同房间重连并让服务端跨至少 3 个 batch 补发 32 条历史 | 所有条目进入历史；HUD 不逐条播放，只显示最新未见事件；Heartbeat 只在 reducer 应用后确认末序号 |
| ACT-SYNC-02 | 缺口与重复 | 连续收到 N、N+1、重复 N+1、再跳到 N+3 | 重复被忽略；N+3 不入队并触发 resync；累计确认停在 N+1 |
| ACT-SYNC-03 | 私密抽卡旁观 | 玩家 A 抽 Chance，玩家 B 在线旁观 | A 收到完整 Drawn；B 只收到 actor/target/amount/detail 全零的 kind 27 墓碑且不显示；双方随后收到公开 EffectApplied，序号连续 |
| ACT-SYNC-04 | 新事件覆盖 | 旧横幅仍显示时连续产生两条其他玩家事件 | 新横幅立即替换旧横幅；两条均保留在 LIVE ACTIVITY，不改变当前页面或焦点 |
| ACT-SYNC-05 | 冷启动历史 | 新屏加入已有事件的房间 | 历史列表恢复保留批次；最多只展示最新一条符合条件的历史横幅，不逐条重播 |

### 11.3 强制付款与筹资

| ID | 测试 | 故障/操作 | 通过标准 |
| --- | --- | --- | --- |
| DEBT-01 | 现金足够 | 服务端开放 `PayDebt` | 显示债权人、用途、应付额和现金；长按只提交一次付款 |
| DEBT-02 | 建筑优先变现 | 现金不足且同色组有建筑 | 不显示返回；可出售的最高建筑行显示半价所得，其他行提示均衡出售限制 |
| DEBT-03 | 逐栋出售 | 对可售建筑连续长按确认 | 每次只发送一次 `SellBuilding`；服务端更新后重新计算下一栋是否可售，不在本地预扣建筑或现金 |
| DEBT-04 | 建筑阻止抵押 | 同色组仍有任意建筑 | 该组地产不能勾选抵押；最后一栋售出并收到新 Authority 后才开放抵押 |
| DEBT-05 | 组合筹资 | 卖房所得仍不足，再选择多个空地 | 批量抵押后收到新 Authority；足额时自动回付款页，否则继续筹资 |
| DEBT-06 | 服务端判定破产 | 所有合法出售和抵押仍不足 | 只有 `DeclareBankruptcy` 出现在 Authority 后才显示破产入口；短按后才锁定提交状态 |
| DEBT-07 | 禁止本地误判 | 使用陈旧估值、动作拒绝或乱序快照 | 客户端不自行宣告破产；拒绝后等待/请求权威恢复，页面不逃逸 |
| DEBT-08 | 出售完成即足额 | 最后一栋出售后 Authority 改为 `PayDebt` | 先完成出售确认，再无跳帧地切回强制付款弹窗，原债务仅支付一次 |

## 12. 性能与稳定性

| ID | 测试 | 条件 | 通过标准 |
| --- | --- | --- | --- |
| PERF-01 | 常规帧率 | 首页和列表 | 目标 30 FPS，持续不低于 24 FPS |
| PERF-02 | 机械方向 | 在最终 60°连接面上播放动画 | 文字保持正向，无可见撕裂和未初始化像素 |
| PERF-03 | 输入延迟 | 旋转或按压 | 本地反馈小于 80ms，最大 120ms |
| PERF-04 | 图片切换 | 连续浏览 22 地产 | 无解码失败和内存持续下降 |
| PERF-05 | 两小时循环 | 自动运行全部场景 | 无重启、死锁或持续泄漏 |
| PERF-06 | 网络抖动 | 延迟 200ms、丢包 5% | 不重复提交，能够恢复快照 |
| PERF-07 | 最低连续内存 | 最复杂场景 | 满足实现计划设定的安全余量 |
| PERF-08 | 首页轮盘流畅度 | 连续旋转和左右滑动，220ms 过渡 | 单一同步时间轴驱动整组按钮；目标 30 FPS、持续不低于 24 FPS，相邻有效帧间隔不持续超过 42ms，位置/缩放/透明度无错帧且观感不低于列表滚动 |
| PERF-09 | 显示缓冲基线 | 检查实际构建清单和启动日志 | core1 LVGL、anti-tearing mode 3、2个显示缓冲、内部SRAM的 `480×40` RGB bounce buffer均生效；请求PCLK须匹配设备候选（COM29为12MHz，其余三屏为vendor16MHz），配置本身不替代目视/性能验收 |
| PERF-10 | 频闪与左缘残影 | Wi-Fi 下载、PSRAM 解码、弹窗长按和动画并行运行两小时 | 左侧圆弧无闪烁点、短线、行漂移、旧帧残影或间歇性整屏频闪 |
| PERF-11 | 无关缓存完成 | 停留在静态弹窗，同时完成其他页面图片下载 | 当前页不整屏重建；只在页面实际引用该资源时刷新对应内容 |

## 13. 素材验收

- 22 幅地产缩小到 128 px 后仍可彼此区分。
- 当前配方头像在公共头像尺寸下可辨；历史五名固定角色仅作兼容素材检查，不代替组件组合验收。
- 图片中没有伪文字、现实品牌或受保护桌游视觉。
- 图片不包含需要动态替换的名称和金额。
- 嵌入式字体/资源计入实际 3MiB 应用分区；HTTP 素材与运行时缓存分别核对，身份池 2304KiB、游戏期素材 1MiB。旧 4.5MB 资产设想不作为当前分区依据。
- 每个资源在清单中有稳定 ID、源文件、设备文件、尺寸、色深和版本。
- 地产与角色均为统一的平面 2D 欧美桌游卡通风格，不混入 3D 或日系动漫比例。

## 14. 发布判定

以下任何一项失败都阻止对应构建发布为已通过验收的版本；正式构建还须满足本页身份、联网和实体游戏门槛：

- 方向或触摸逆变换错误
- 关键文字或按钮遮挡
- 危险操作能够单击提交
- 重复付款、交易或掷骰
- 现金不足时出现负余额
- Demo 数据进入正式房间
- 两小时测试出现重启或持续内存泄漏
- 协议日志泄露热点口令或完整会话令牌

验收完成后保存测试记录、串口日志、关键页面照片和固件二进制校验值。

## 15. 开局头像创建验收

开局头像编辑器属于当前发布门禁。必须完整执行
[玩家开局头像创建规格](player-avatar-setup-spec.md)中的 `AVATAR-01` 至 `AVATAR-18`，并追加：

| ID | 场景 | 通过标准 |
| --- | --- | --- |
| AVATAR-19 | 组件统一预载 | 进入准备页后仅请求 30 个唯一 GAVC 路径；当前三层优先、最多 4 个并发 worker、完成后不重复请求；编辑期切换 preset 不产生 HTTP |
| AVATAR-20 | 本地换色 | 切换 20 种发色或 8 种肤色不产生 HTTP；45ms 稳定期后后台合成最新配方，由 LVGL 取得完成图；旧代次不覆盖新结果，延迟目标另行实测 |
| AVATAR-21 | 整图 golden | 配方 h7/c18/f4/s6/o9 的 132000B RGB565 结果与服务端逐字节一致，FNV64=`2db09660e5c5fdfa` |
| AVATAR-22 | 背景与加载 | 透明区和页面均为 `#061017`；无完整图时 spinner/LOADING PREVIEW，已有完整图时保留并显示 UPDATING PREVIEW；worker 不写前台或待交付图，不以未标记旧图冒充当前配方 |
| AVATAR-23 | Identity 版本门 | AvatarSetup/Countdown 期间 State/Auth/Roster 不推进 applied-state version，只有 IdentitySnapshot 可以推进 |
| AVATAR-24 | 异步完成恢复 | ConfirmAvatar 立即返回 AvatarGenerating 后，即使直接结果丢失，request-id-zero 高版本 Identity 的 avatarFinal bit 仍清除 SAVING 并进入 Name Setup |
| AVATAR-25 | Focus Stack 实机 | 五槽和确认按钮可读可操作；右侧裁剪视口与当前规格一致，半身像不异常缺失或覆盖左侧控件，没有多余头像圆框 |
| AVATAR-26 | 统一组件预加载 | 新房间先显示 0/30 进度；达到 30/30 后自动进入 Avatar Setup，初始预览无需先手动切换 preset 即可出现 |
| AVATAR-27 | 缓存生命周期 | 外貌、姓名、准备和倒计时之间切换不重复下载；进入 Active 后 30 个组件和 220×300 预览全部释放 |
| AVATAR-28 | 冷返回编辑 | 重启后直接恢复 Name Setup，再按 Back 时先进入统一预加载页；Identity resync 不会中断该用户动作 |
| AVATAR-29 | 隐形完成不重绘 | 后台组件、棋盘或最终头像完成时，只有当前实际引用该素材的页面允许重建，屏幕不得产生频闪 |
| AVATAR-30 | 手写静默窗：连续多笔、短暂停顿 | 最后一次手写区域触摸后的 1200ms 内绝不识别；每次新触摸重启静默计时并保留画板 |
| AVATAR-31 | 手写采样边界：同一笔延迟 UI 处理后再另写一笔 | 同一真实接触保持连线，不以 100ms 处理间隔断笔；真实抬起/区域外/不可用采样中断接触；短时失败不触发识别 |
| AVATAR-32 | 识别回归：覆盖 R/K、Y/T 等易混大写字母 | 先接受可信通用几何/笔画匹配，其余使用 int8 EMNIST 28×28 网络、0.45 logit 门槛和 28×40 笔画模板回退；可删除重写且不阻塞 UI/Heartbeat |

不得用固定角色或 legacy whole-preview 路由替代组件组合、确认屏障、机器人确定性随机、断线恢复、
素材缓存和全局头像一致性测试。

## 2026-10-15 当前实现与验收状态

[当前台账](../firmware/current-device-connections.md)记录部署身份。旧TIME-01收租窗口属于早期产品设想，服务端未实现前不作为当前版本功能PASS；付款测试须区分圆屏本地倒计时提交PayDebt与尚未实现的服务端独立期限扣款；保留作需求追溯，不靠修改游戏规则制造验收。

COM7当前为 `22ca08e6…`、COM27/28为 `dfc4b7e5…`（均16MHz）；COM29为 `716ff623…`、12MHz正常游戏诊断构建，120秒日志已停止，135秒采集结束并释放串口。普通12MHz候选 `3da4c493…` 已构建核验、未部署，仍待主会话安排写验和目视。USB热点已实证20台同时接入，旧7关联限制不再阻塞部署，COM7/27/28固件及冻结v4保持不变。COM29用户目视通过仅覆盖静止等待页，动态页面和24FPS/42ms仍待验，详见[COM29显示记录](../firmware/player-com29-display-progress-2026-10-15.md)。

18:47 EDT（22:47 UTC）最新快照为room993580116/version9，COM28/29/27分别席1/2/3在线、三真人加一机器人，Tag配对complete、boundMask7、AvatarSetup；COM7由用户关机。16格在线、唯一环自动分配及reader stable已通过。保留09:39 UTC旧room993580113/v11四屏在线但COM29 seat0的历史事实，不再将它作为当前入局状态。

| ID | 测试 | 通过标准与当前状态 |
| --- | --- | --- |
| SETUP-01 | 1/2/3/4合格屏自动建局 | 补足4席；0/5台拒绝；晚加入/断线不替换冻结席位；逻辑回归通过。最新room993580116/v9为三真人加一机器人，COM28/29/27席1/2/3、Tag complete/AvatarSetup；四真人完整身份流程仍待验 |
| SETUP-02 | 单个未分配reader/开放链 | 清场后新Tag绑定，提示拿回并进入外貌；已有单reader真实成功记录及本次三真人配对complete状态；指定同reader多人复用与拿回提示仍需逐项实物验收 |
| SETUP-03 | 多reader连续配对 | 尽量不用上一reader；已绑定者编辑与下一人配对并行；旧reader保留拿回提示。最新三真人配对complete已有服务端快照，具体reader轮换/拿回提示/并行编辑未逐项实物采证，四真人完整流程待验 |
| SETUP-04 | 重复UID/多Tag/旧缓存/离线 | 不误绑、不触发移动；重试校验room/session/revision；软件回归通过 |
| IN-NEW-01 | Avatar行慢/快正反切换 | 每格一步且无回跳，周期Identity保留焦点；当前COM7为22ca、COM27/28为dfc4、COM29为716ff623/12MHz，均包含既有输入修复。粗略四组24解码步与消费对应不替代精确物理卡点/Avatar手感，后两项待验 |
| IN-NEW-02 | 输入积压与短按 | 每轮最多16事件，保留正反/按键顺序，ButtonUp 后先处理页面，积压不误判长按；2ea95b4 含256项历史主机回归，真实高负载手感另验 |
| UI-NEW-01 | Avatar保留控件 | 只移动焦点时更新旧/新行及必要确认样式，不获取/重绘头像；源码及历史针对性回归已有证据，当前Avatar目视待验 |
| UI-NEW-02 | 等待页重复事件 | e6d6563：60次重试由120次整屏重建降至0，51+83项历史回归通过；COM27/28的dfc4等待页正常、COM7配对页稳定。COM29旧dfc4/16MHz等待页目视失败，改716ff623/12MHz后用户确认静止等待页正常、频闪和错位消失；不推广为动态页面或性能通过。LVGL性能叠层仍可定时flush，不把控件保留等同于完全无刷新 |
| NAME-NEW-01 | 三笔H/快写/后台快照 | 不早识别、不断笔、不清画布；9月修复已有用户确认，不能扩展为当前四台全部复验通过 |
| NAME-NEW-02 | DELETE、连续DELETE、DONE | 依序处理，墨迹先清、异步结果不复活；DONE成功提交再离页，拒识留画布；主机回归通过 |
| END-01 | 破产和最终胜者 | 正确显示终局，禁用已结束游戏的操作；核心/Web回归通过，实体整局待验 |
| BAT-01 | 默认遥测关闭 | 四台在用固件、待部署普通3da4及trial16 v4均BatteryBoard=none，不初始化UART、不显示假电量；none不表示物理上无电池 |
| BAT-02 | 启用电池遥测 | 未知与0%区分，EXT/CHG不冒称净充电，UI不抢焦点/破坏墨迹；9月27日主机44+18+4检查及启用构建通过，启用功能尚未部署/实测，返修板USB运行不替代遥测验收 |
| NET-NEW-01 | USB热点与真实16环 | 22:07:58及22:18:49 UTC两次16格＋4屏/20台关联认证注册；随后COM7关机，软件重启后16格＋3屏持续观察通过，唯一16节点环和正确自动映射/reader stable通过。未来36台、无家庭网断电冷启动及实体整局待验 |
| CFG-NEW-01 | 显示时钟与诊断分离 | 13e4de40独立配置DisplayClock和DisplayDiagnostic；既有18/18配置与15/15诊断窗口检查通过，普通12MHz 3da4已核验不含诊断日志/计数符号，仍未部署。默认vendor保持16MHz，不回写旧v4 |

玩家动画目标30FPS、持续≥24FPS及最大42ms门槛保持不变；core1历史Retarget max57ms仍未通过，原动态场景频闪/错位仍需相应版本目视。LVGL刷新定时器30ms、性能叠层FPS和frame-complete回调计数均不能替代有效动画帧测量；不能用上述逻辑回归、联网或静止等待页反馈关闭性能验收。

证据入口：[输入部署](../firmware/player-16-trial-progress-2026-10-15.md)、[等待页修复](../firmware/player-new-screen-display-progress-2026-10-15.md)、[第四台部署](../firmware/player-fourth-screen-flash-2026-10-15.md)、[COM29诊断与普通候选](../firmware/player-com29-display-progress-2026-10-15.md)、[USB热点部署](../firmware/usb-ap-deployment-2026-10-15.md)、[设备台账](../firmware/current-device-connections.md)、[历史电池遥测验证](../firmware/player-battery-telemetry-progress-2026-09-27.md)。本表引用各报告结果，不声称本次文档整合重跑了这些测试。
