Ha22yX/Gridopoly/PCB Files/PlayerConsolePower/Layout-2026-09-27-RC5/bringup-checklist.md

# RC5 首板检查 — 未执行

沿用[RC3完整首板检查](../Layout-2026-09-27-RC3/bringup-checklist.md)，但其中涉及旧J3焊线接口/极性的内容由以下RC5定义覆盖。下面没有任何实物项目被勾选通过。

- [ ] J3实装C131337，朝向与本版装配图一致，焊接可靠。
- [ ] 电池端为PH2.0/PHR-2兼容；实物黑线1脚、红线2脚，与商品图一致。
- [ ] 断电核对板上J3.1通GND、J3.2通BAT_PACK；PCB顶视USB-C在下时左负右正。
- [ ] 电池与板断开时用万用表测插头实际极性；红线是正极且装入指定2脚。本板无电池反接保护。
- [ ] 受保护1S/4.2V电池允许电流满足要求，插拔无需强压，线束留弯曲和应力释放空间。
- [ ] 逐项完成充电、切换、按键、欠压、温升、USB烧录调试及UART电量/充电状态测试。
- [ ] FPC实物/负载、41条原理图警告明细及板厂DFM闭合后再判断制造放行。
