Ha22yX/Gridopoly/Docs/design-records/plans/2026-08-03-test-game-server-p0-contract.md

# Gridopoly P0-Contract Implementation Plan

> **For agentic workers:** REQUIRED SUB-SKILL: Use superpowers:subagent-driven-development (recommended) or superpowers:executing-plans to implement this plan task-by-task. Steps use checkbox (`- [ ]`) syntax for tracking.

**Goal:** Freeze every shared protocol, event, state, admin, HTTP, trigger, bot, and content identity contract into canonical machine-readable schemas and independently reproducible exact-byte vectors before any server firmware is implemented.

**Architecture:** Human-authored JSON contract files use one small meta-schema with explicit numeric IDs, stable names, wire types, flags, cardinality, ranges, enums, ordering, visibility, and defaults. A deterministic Python standard-library generator validates the contracts, emits canonical JSON/hashes and C++ ID/layout headers, and builds binary goldens with an independent test decoder; no Arduino or game implementation is linked in P0.

**Tech Stack:** Python 3 standard library (`json`, `hashlib`, `struct`, `unittest`, `zlib` with explicit CRC wrappers), UTF-8 canonical JSON, generated C++17 headers, PowerShell entry scripts.

## Global Constraints

- The sole semantic source is `Docs/design-records/2026-08-02-esp32-test-game-server-design.md`; schemas make its missing byte-level choices explicit but may not change its semantics.
- IDs are explicit integers, never array indexes or language enum order.
- All multi-byte wire values are little-endian; bool is u8 0/1; strings are UTF-8 with explicit byte limits.
- CRC-32 is ISO-HDLC where the design says CRC32; SHA-256 covers exact canonical bytes described by each vector.
- Canonical JSON is UTF-8 without BOM/newline dependence, sorted object keys, compact separators, integer-only numeric schema values, and arrays kept in declared semantic order.
- Generated output is never hand-edited. `generate.py --check` must reproduce tracked bytes exactly.
- P0 creates no `.ino`, Wi-Fi, ESP-NOW, HTTP server, NVS/LittleFS writer, game engine, or COM5 image.

---

### Task 1: Contract meta-schema and deterministic canonicalizer

**Files:**
- Create: `GameData/schemas/contract-meta-v1.json`
- Create: `Tools/contracts/contract_model.py`
- Create: `Tools/contracts/canonical_json.py`
- Create: `Tools/contracts/generate.py`
- Test: `Tools/contracts/tests/test_contract_meta.py`
- Test: `Tools/contracts/tests/test_canonical_json.py`

**Interfaces:**
- Produces: `load_contract(path: Path) -> ContractDocument`
- Produces: `canonical_bytes(value: object) -> bytes`
- Produces CLI: `python Tools/contracts/generate.py --root . [--check]`
- Defines wire types: `U8`, `I8`, `U16`, `I16`, `U32`, `I32`, `U64`, `I64`, `BOOL`, `BYTES`, `UTF8`, `RECORD`, `RECORD_LIST`, `U8_LIST`, `U16_LIST`, `U32_LIST`.

- [ ] **Step 1: Write the failing meta-schema tests**

```python
def test_rejects_duplicate_field_ids(self):
    doc = fixture(fields=[field(1, "room_id", "U64"), field(1, "seat_id", "U8")])
    with self.assertRaisesRegex(ContractError, "duplicate field id 1"):
        validate_contract(doc)

def test_rejects_implicit_enum_values(self):
    doc = fixture(fields=[field(1, "phase", "U8", enum=["LOBBY", "IN_GAME"])])
    with self.assertRaisesRegex(ContractError, "explicit enum value"):
        validate_contract(doc)
```

- [ ] **Step 2: Run tests and verify RED**

Run:

```powershell
python -m unittest discover -s Tools/contracts/tests -p 'test_contract_meta.py' -v
```

Expected: import failure for absent `Tools.contracts.contract_model`, not a syntax or fixture error.

- [ ] **Step 3: Implement the minimal immutable model and validator**

Require exact top-level keys `contract_schema`, `contract_name`, `contract_version`, `namespace`, `definitions`; reject floats, duplicate IDs/names, missing range/max/cardinality, invalid defaults, unordered definitions, and unknown keys.

- [ ] **Step 4: Write canonical JSON behavior tests**

```python
def test_canonical_bytes_are_key_sorted_utf8_and_compact(self):
    value = {"中文": "格", "a": [2, 1], "z": {"b": 1, "a": 0}}
    self.assertEqual(
        canonical_bytes(value),
        b'{"a":[2,1],"z":{"a":0,"b":1},"\xe4\xb8\xad\xe6\x96\x87":"\xe6\xa0\xbc"}',
    )
```

- [ ] **Step 5: Run the canonicalizer test and verify RED, then GREEN**

Run the one test before implementation, implement with `json.dumps(..., ensure_ascii=False, sort_keys=True, separators=(",", ":"), allow_nan=False)`, and run the full two-file suite.

- [ ] **Step 6: Add generator check mode**

`--check` writes into a temporary directory, compares relative file sets and bytes, prints only differing paths, and returns 1 on drift. It must never rewrite tracked files in check mode.

- [ ] **Step 7: Commit Task 1 files when permitted**

```powershell
git add -- GameData/schemas/contract-meta-v1.json Tools/contracts
git commit -m "feat: add deterministic contract model"
```
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
