Ha22yX/Gridopoly/PCB Files/PlayerConsolePower/Layout-2026-09-27-RC4/bringup-checklist.md

# RC4 首板检查 — 未执行

沿用 [RC3 完整首板检查](../Layout-2026-09-27-RC3/bringup-checklist.md)。本轮仅完成静态检查，下面没有任何实物项目被勾选通过。

- [ ] J3 实装 C131337，插座朝向与装配图一致，焊接可靠。
- [ ] 电池端确认为 PH2.0/PHR-2 兼容，插拔无强压、线束留弯曲空间。
- [ ] 断电测量 J3.1 正极、J3.2 地；万用表核对电池插头实际极性。
- [ ] 受保护 1S 电池充放电电流符合要求；既有充电、切换、按键、欠压、温升、USB和UART电量/状态测试逐项完成。
- [ ] FPC 实物与负载、41条原理图警告明细、板厂DFM闭合后，才判断制造放行。
