Ha22yX/Gridopoly/PCB Files/PlayerConsolePower/Testpoints-2026-10-15/actual-testpoints-bottom.png

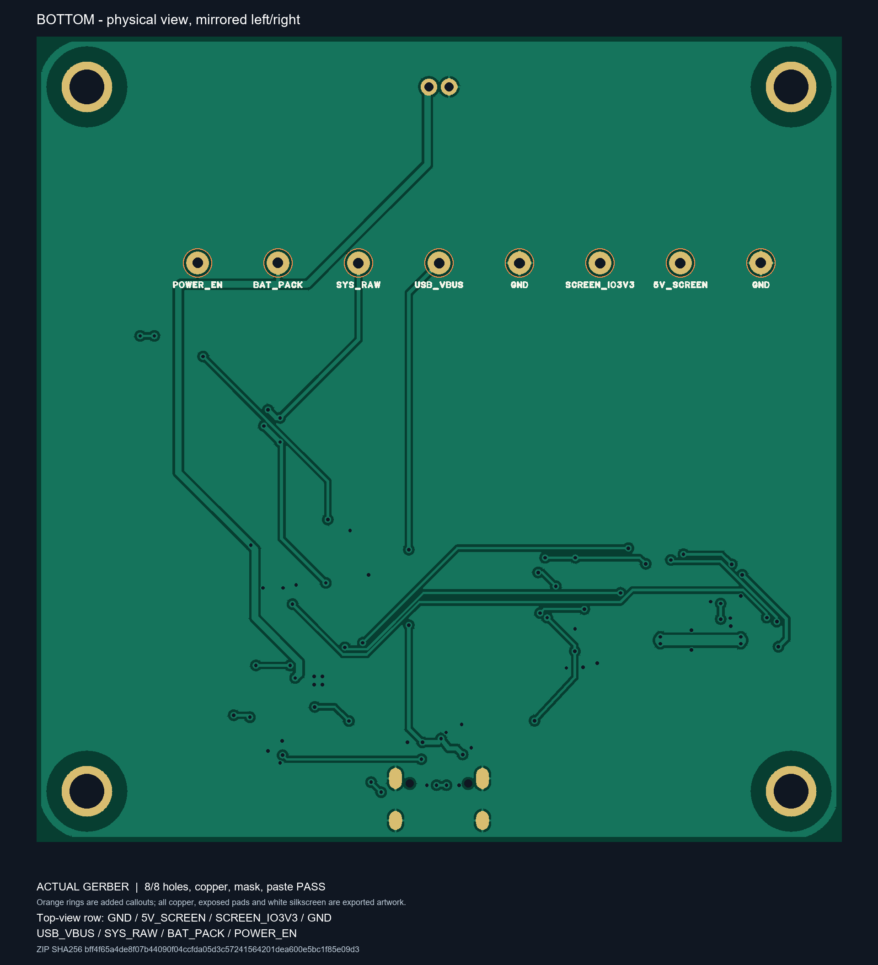
PCB Files/PlayerConsolePower/Testpoints-2026-10-15/actual-testpoints-bottom.png
