Ha22yX/Gridopoly/PCB Files/PlayerConsolePower/Testpoints-2026-10-15/P1-testpoints.png

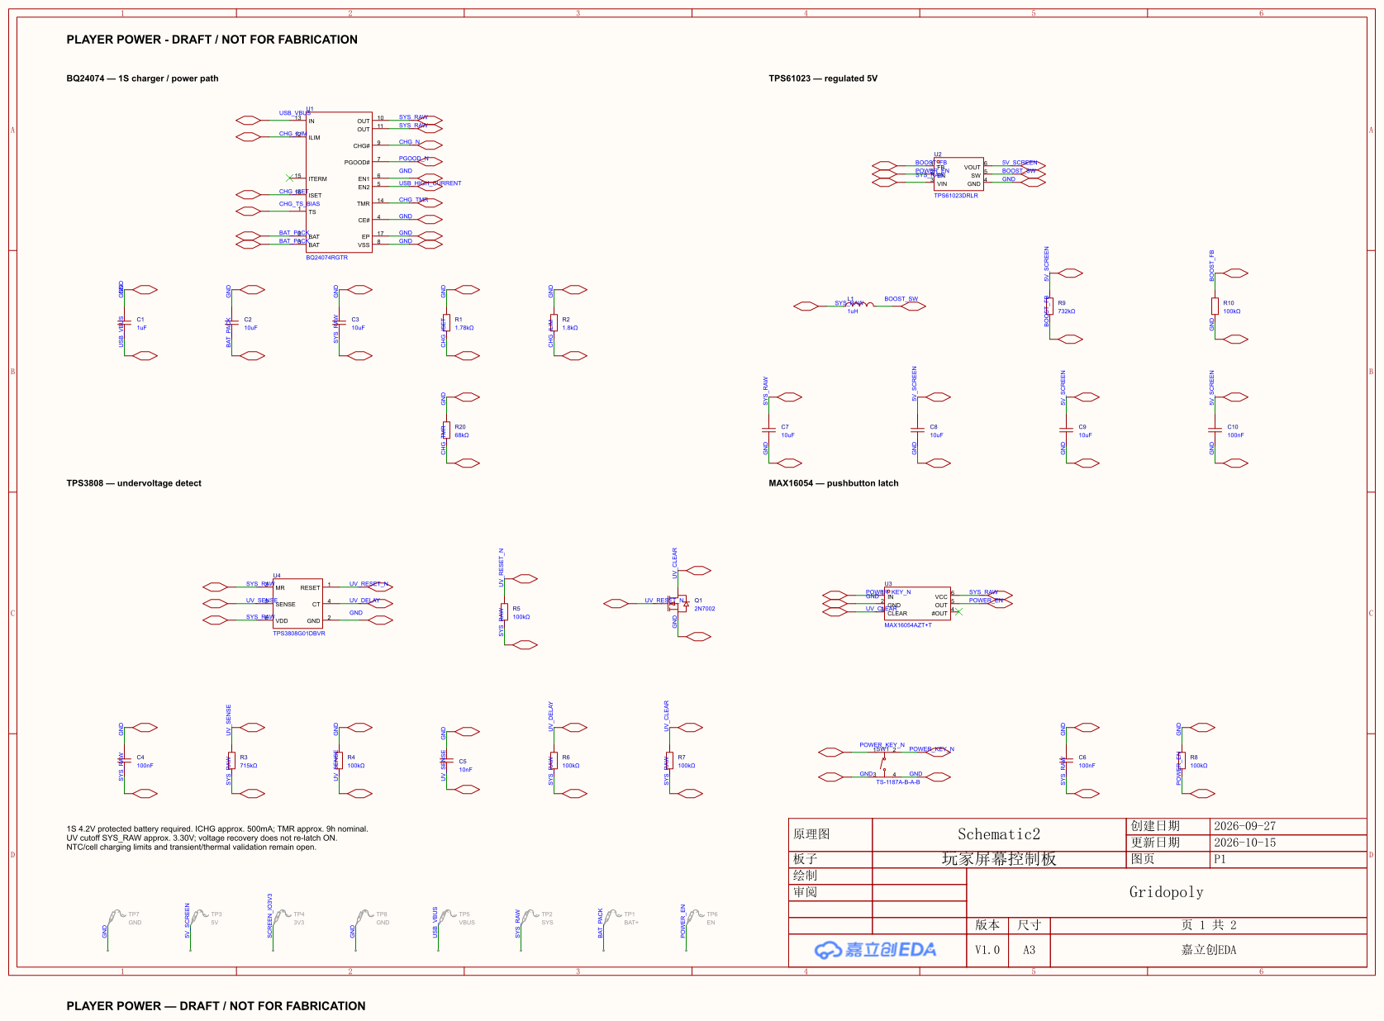
PCB Files/PlayerConsolePower/Testpoints-2026-10-15/P1-testpoints.png
