Ha22yX/Gridopoly/PCB Files/PlayerConsolePower/Testpoints-2026-10-15/testpoint-row-route-plan.png

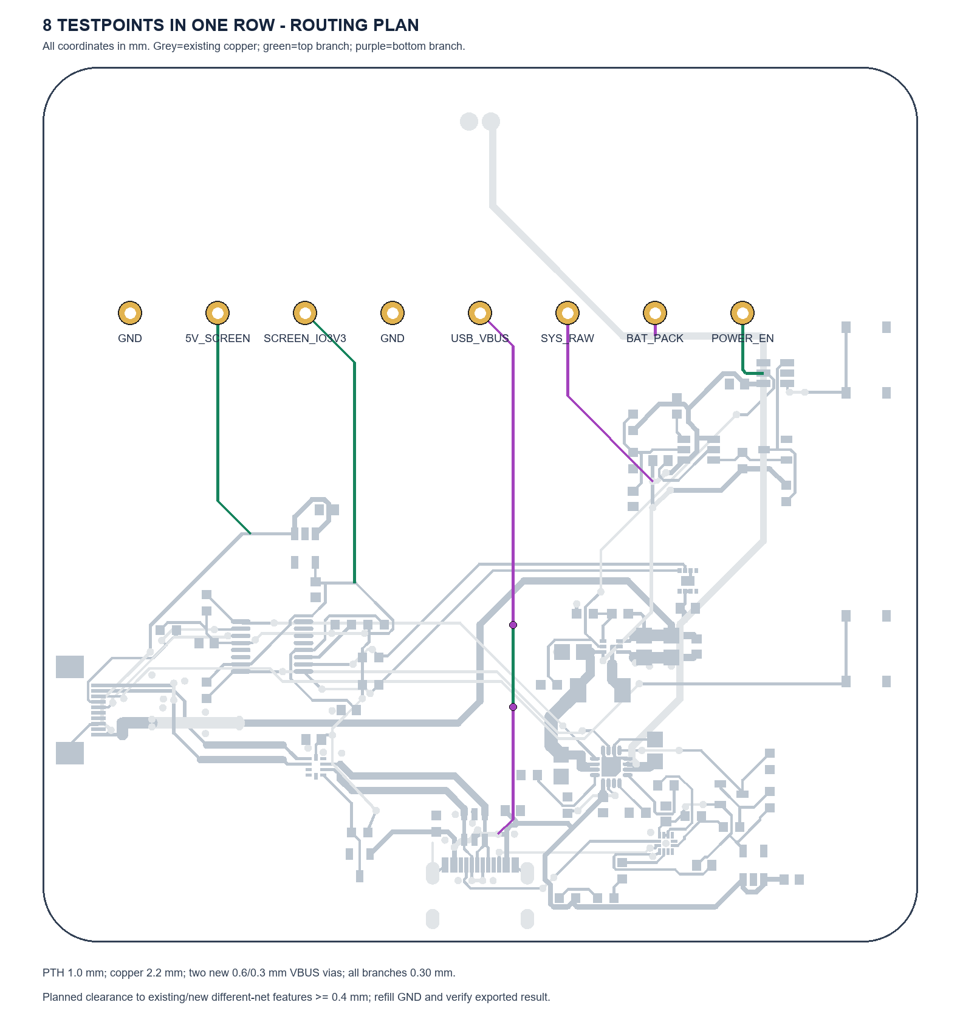
PCB Files/PlayerConsolePower/Testpoints-2026-10-15/testpoint-row-route-plan.png
