Ha22yX/Gridopoly/Mechanical/PlayerConsoleStandV2/revisions/R2_FPC60/README.md

# 玩家屏幕底座 V2 R2：60 mm 排线、分件打印

**2026-10-15修正：本版02屏幕支架的左安装耳根部存在不可可靠打印的微小搭接。请改用[R3加固支架](../R3_EAR_REINFORCED/README.md)。01连接板、03电池仓、04仓盖及05隔柱继续适用，无需重打。以下保留为R2装配及历史记录，原归档文件未覆盖。**

2026-10-15。按用户最新更正，屏幕自带排线按**约60 mm**设计，替代65 mm。用户要求适合H2D/PLA、结构简单、可分件打印，因此本版把平连接板、屏幕支架、电池仓、仓盖分开，用普通M3螺丝安装。**这是待打印和实物试装的候选，不是已完成实物适配的定版。**

R1较高的夹层电池结构不适合当前60 mm排线，保留作历史记录，不再作为这根排线的打印推荐。本版PCB和屏幕配合部位的电气/引脚定义不作修改。

## 打印哪些零件

项目历史交付：R2 [模型目录](../../deliverables/Gridopoly_Player_Stand_V2_R2_FPC60)、R2 [ZIP](../../deliverables/Gridopoly_Player_Stand_V2_R2_FPC60.zip)。02 支架须使用 [R3 加固版](../R3_EAR_REINFORCED/README.md)，本目录保留其余零件和原装配记录。每个STL都有一个毫米单位的独立3MF，保持100%比例；3MF只有零件几何，没有打印机、耗材、支撑或切片设置。

| 文件 | 数量 | 尺寸mm | 打印朝向 |
| --- | ---: | --- | --- |
| `01_Connection_Plate_R2` | 1 | 116×111×4 | 大平面朝下 |
| `02_Screen_Support_CW47_5_R2` | 1 | 74×50×41.8645 | 平脚朝下，圆环斜面朝上 |
| `03_Battery_Cradle_R2` | 1 | 84×17×39 | 2mm仓底朝下、仓口朝上 |
| `04_Battery_Lid_R2` | 1 | 69×22×4 | 外表大平面朝下、内凹面朝上 |
| `05_Spacer_6mm_R2` | 4 | Ø6×6，孔Ø3.6 | 端面贴床，孔竖直 |

仓盖打印时开口向上，装配时翻转，避免打印封闭的悬空顶板。连接板没有底部螺母凹槽；其排线口仅有小斜壁。屏幕支架保留用户已经打印试装成功的CW47.5接口，在切片预览中单独检查其定位销、斜面孔和小悬垂，不能据模型检查宣称所有细节必定免支撑。无需把PCB、屏幕、电池、螺丝或绑带参考件一起打印。

`preview-print-parts.png`是分件示意，`preview-assembly.png`是完整装配。`Gridopoly_Player_Stand_V2_R2_FPC60.blend`保留可编辑零件、参考硬件和两种尚未确认接触面方向的FPC包络。

## 结构与尺寸

沿用80×80mm、1.6mm厚的玩家供电PCB，四孔中心距70×70mm，打印孔Ø3.6mm，PCB原孔不变。四个PCB安装孔仍是整机的安装点。屏幕和电池仓分别用两个外耳与平连接板连接，便于单独替换和试配。

坐标以PCB中心为XY原点，USB-C朝前−Y，桌面Z=0：

| 项目 | 位置/尺寸 |
| --- | --- |
| PCB底/顶面 | Z8 / Z9.6mm |
| 连接板底/顶面 | Z15.6 / Z19.6mm；下方6mm间隔柱 |
| PCB四孔 | X=±35、Y=±35mm |
| 屏幕支架固定耳 | (−57,−18)、(7,15)mm |
| 电池仓固定耳 | (−37,52.5)、(37,52.5)mm |
| 屏幕安装中心 | (−25,−6,43.6)mm；倾角35°，CW47.5不变 |
| 电池净空间 | 60×13×37mm，电池沿56×10.3×34.5mm方向竖放 |
| 装配参考总外形 | 约116×118.25×87.47mm，含屏幕和软带示意 |

用户新图给出的LP103454成品包上限为**56×34.5×10.3mm**、引线50±3mm。本版把10.3mm厚边放在仓体前后方向，约34.5mm边竖直。电池底部留0.5mm薄垫、顶部约2mm间隙；盖子由刚性仓壁承托，不能通过勒紧绑带挤压软包。

电池线从左前开放角引出，参考路径约44.42mm，相对图示最短47mm仅余约2.58mm；线根和插合位置仍需实物核实。J3保留独立操作窗，绑带有专用穿槽，两者之间留隔梁。USB-C、左侧J2和右侧POWER/RST保持可接近的开口。

## 装配用件

| 用途 | 规格 | 数量 |
| --- | --- | ---: |
| 连接板→PCB→底脚 | M3×18，头下长度 | 4 |
| 屏幕支架/电池仓→连接板 | M3×12，头下长度 | 4 |
| 上方垫片 | M3，约0.5mm厚、外径约6.6mm | 8 |
| 分件安装螺母 | 普通M3六角螺母，约2.4mm厚 | 4 |
| PCB下面的绝缘底脚 | Ø6×8mm，M3贯通内螺纹，尼龙成品 | 4 |
| 仓盖固定 | 10mm宽、180–200mm长可调软绑带 | 1 |

M3×18在底脚中的名义啮合5.9mm；M3×12用于支架时穿出螺母约1.1mm，用于电池仓时约2.1mm。右侧支架螺丝位于PCB上方，尖端与PCB顶面的参考距离2.5mm，周围源XY数据没有器件本体；实际焊点和装配高度仍要检查。全部采用通孔和普通螺母，不需要热熔螺母或自攻塑料螺纹。

1. 先把屏幕支架和空电池仓装到平连接板上，每个两颗M3×12；从下面扶住普通螺母，轻拧固定。
2. 再通过原四孔，装6mm隔柱、PCB和8mm绝缘底脚，用四颗M3×18连接。此顺序便于操作分件螺母。
3. 不接电先试装屏幕和原排线。排线沿原槽、开放通道进入J2；应自然弯曲、不拉紧，也不把它夹在两个打印件之间。
4. 放入薄垫和电池，整理左前侧电池线，再装仓盖。绑带穿专用前槽、经过连接板后沿绕一圈固定盖子；只收紧至盖子不松脱。
5. 检查四孔、线材、按钮、插头与屏幕旋转空间后再进行通电功能检查。旧屏幕仍是重力定位，不是被四颗PCB螺丝锁住；搬动时拿底座。

## 60 mm 排线的实际边界

屏幕配合面比R1降低18mm，并平移靠近J2；分件后保持同一全局位置。设计中心线加**假定4mm插入段**总长约**56.843mm**，相对60mm名义余量约3.157mm。中心线两处弯曲采用R3，带边缘局部曲率更小，不是厂家允许弯曲半径证明。

尚未实测的量包括真正出线起点、金手指插入深度、带材厚度、接触面及逐针方向。两种末端方向都做了5mm宽、假定0.3mm厚的包络检查，**它们不是两种可以随便互换的接法**；预览显示较少扭转的一支，仅作空间说明，不能据此翻转J2引脚。真实排线能否留出松弛量，必须在打印件上确认，不能只凭56.843mm计算值认定装得上。

## 检查、来源与复现

独立检查文件为`parts-verification.json`和`assembly-verification.json`。前者检查导出的STL闭合、单一实体、朝向、体积、尺寸、退化面，验证旧接口保护区并回读3MF；后者检查打印件、PCB参考、紧固件、两种FPC包络及电池导线的相交。模型检查不代替实际切片、打印、装配、旋钮操作稳定性和温升测试。

PCB来源为`../../interfaces/player-power-2026-10-15/`中的RC6-TP机械接口，器件XY来自设计，器件高度仍为示意。旧CW47.5来自`Mechanical/PlayerConsoleStand/outputs/models/`；用户已确认其物理试装通过。本次只保留圆环/定位销/槽的配合区域，外围底板和环外出线通道有改动；原文件未覆盖。

`prepare.py`组织参数与Blender MCP生成任务，`geometry.py`构建分件，`route/`保存路径计算及其假设，`verify_parts.py`作独立导出检查，`verify_assembly.py`在保存副本中检查装配，`render_views.py`渲染预览，`package_delivery.py`封装经过验证的明确文件清单。本轮不操作PCB、固件、串口或共享Git索引。
