Ha22yX/Gridopoly/Mechanical/PlayerConsoleStandV2/revisions/R3_EAR_REINFORCED/README.md

# 玩家屏幕底座 V2 R3：安装耳加固

2026-10-15。用户在切片预览中指出左侧螺丝耳接近脱离支架。对实际R2 STL复查确认：排线通道切除了原连接根部的大部分材料，仅剩约0.167×0.157×0.225mm局部搭接。旧版虽然是拓扑连通实体，却不具备可可靠打印的连接。**停止使用R2的02屏幕支架，改用本版02；其余四种零件仍用R2。**

## 这次改了什么

左安装耳增加绕开排线槽的4mm厚宽底脚，右安装耳根部适当加宽。没有增加悬空加强肋。两个孔中心、孔径、安装高度、屏幕倾角以及CW47.5圆环/定位销/配合槽保持不变，原螺丝和连接板均可继续使用。

| 实际STL根部截面 | R2 | R3 |
| --- | ---: | ---: |
| 左耳根连接面积 | 0.01765mm² | 55.02723mm² |
| 左耳根贯穿4mm底厚的最小连续宽度 | 0mm | 12.3565mm |
| 右耳根连接面积 | 40mm² | 56mm² |
| 右耳根最小连续宽度 | 10mm | 14mm |

截面面积是几何测量，不是承载能力或强度倍数。R3尚未打印或实物试装。

## 需要打印哪个文件

项目交付目录：[Gridopoly_Player_Stand_V2_R3_EAR_REINFORCED](../../deliverables/Gridopoly_Player_Stand_V2_R3_EAR_REINFORCED)。可直接打开完整 Blender [装配](../../deliverables/Gridopoly_Player_Stand_V2_R3_EAR_REINFORCED/Gridopoly_Player_Stand_V2_R3_EAR_REINFORCED.blend)或下载归档 [ZIP](../../deliverables/Gridopoly_Player_Stand_V2_R3_EAR_REINFORCED.zip)。

图文装配参考：[6 页中文 PDF](assembly_guide/Gridopoly_Player_Stand_R3_Assembly_Guide_CN.pdf)。完整范围与 Git LFS 下载方式见[机械总入口](../../../README.md)。

- **只替换一件：[02_Screen_Support_CW47_5_R3.3mf](../../deliverables/Gridopoly_Player_Stand_V2_R3_EAR_REINFORCED/02_Screen_Support_CW47_5_R3.3mf)或同名STL，数量1。**外形74×50×41.8645mm。
- 01连接板、03电池仓、04仓盖、05隔柱与R2原文件逐字节相同；已经打印的无需重打。
- `Gridopoly_Player_Stand_V2_R3_EAR_REINFORCED.blend`为完整可编辑装配；PCB、屏幕、电池、线缆及螺丝是参考件，不打印。
- 3MF仅含毫米单位的单零件几何，不含打印机、耗材或支撑设置。按100%比例导入H2D，**平底脚朝下**，不要按装配斜面旋转贴床。

沿用PLA和0.20mm层高。加宽底脚从首层开始连续成形，没有新增悬空。屏幕本体保留旧版已试装接口，其定位销及斜面局部悬垂仍应在切片预览中检查，不能以网格检查代替切片检查。先打印这一件，确认耳根成形、孔位及装配后再装回屏幕。

## 装配仍沿用R2

支架孔中心为(−57,−18)、(7,15)mm，Ø3.6mm通孔，脚厚4mm，安装底面Z19.6mm。两颗M3×12螺丝、约0.5mm垫片及普通M3螺母不变。孔上方Ø7mm、50mm高的螺丝刀通道与支架无干涉。轻拧至贴合，不挤压PLA。

完整安装顺序、其他紧固件、6mm隔柱和电池仓说明见包内`Assembly_Instructions_R2.md`。其中02文件已被R3替代，其他参数继续适用。原PCB四孔、按钮、USB-C、J2位置和电气引脚不改动。电池按56×34.5×10.3mm包络，排线按用户约60mm长度；几何参考路径仍含假定插入段，实物排线松弛量仍需试装确认。

## 已完成的检查

- 新02为一个闭合实体，5256个三角面；非流形、退化、重复面和朝向错误均为0。
- 旧四件STL与R2源文件及冻结报告三方哈希一致；旧四件3MF字节不变，新02的3MF已回读验证。
- CW47.5保护区双向表面比较最大差约0.00000387mm；配合区保持。
- 根部截面单独从实际STL检查，避免重犯“连通就算足够”的错误；两个孔的中心和孔径另行核查。
- 1300组实体/紧固件参考、190组两种FPC方向包络、95组电池导线检查均无超过0.001mm³的碰撞；两孔螺丝刀空间通过。

器件高度、线缆出线和插入方式仍部分采用参考包络；上述检查不能代替真实PCB间隙、60mm排线试装、切片、承载、稳定性或温升测试。旧CW47.5屏幕接口曾通过用户试装，不等于整个新版底座已通过实物验证。

## 文件与复现

`prepare.py`复制冻结R2零件并组织Blender MCP任务；`geometry.py`只修改支架底脚，并清理底面布尔运算产生的共线碎面。`verify_parts.py`检查网格和配合面，`verify_ear_roots.py`检查实际根部截面，`update_assembly.py`在R2装配副本中替换支架并检查干涉。`render_support.py`渲染实际STL前后对比；`package_delivery.py`只打包明确清单中的最终文件。

R2原始模型和归档包未覆盖。本轮仅修改机械设计及相应说明，没有修改PCB、固件或共享Git索引。
