Ha22yX/Gridopoly/PCB Files/CornerModule/DC24-2026-09-21/SyncRepair/README.md

# 原理图/PCB重复导入修复记录

2026-09-21：用户发现反复导入仍列出J301等6件。现场PCB含194器件：每种新入口器件7份，另有USB1/U101/U102/U103/Q101/Q102残留。
新入口沿用了被删除PD器件的gge170–gge175唯一ID，造成关联冲突。之前仅检查导出源中的数量不足以证明原生导入一致，旧“同步完成”结论不完整。

本轮用原生器件API删除36个重复件和6个旧PD残留；两端为6件入口分配相同的全新DC24唯一ID并同步Channel ID，补齐新器件空参数。保存后现有152器件，无重复位号/唯一ID，原理图与PCB唯一ID及焊盘网络一致。

最终将6件器件描述统一，并保存关闭重开原理图/PCB，原生网表差异已清零。重开验证152件，无重复位号或唯一ID。原生DRC剩26项间距、51项未连接。尚未完成PCB布局布线或制造放行。不得将结构核对通过等同于原生同步通过。
最新源及证据见本目录，父目录旧快照保留追溯，新建入口应采用本目录唯一ID。
