Ha22yX/Gridopoly/Mechanical/PlayerConsoleStandV2/revisions/R2_FPC60/route/README.md

# FPC 60 mm 路径候选：R3 环外转弯

2026-10-15。用户最新量得屏幕出线至金手指末端约 **60 mm**，替代较早的65 mm。此目录只提供条件性几何路径和带状包络，**不是实物适配通过记录**，不操作或修改PCB、Blender场景或旧版交付。

## 结果

| 项目 | 数值 |
| --- | ---: |
| PCB顶面Z | 9.6 mm |
| 上支架底面Z | 15.6 mm |
| 旧楔体/屏幕配合中心的XY平移 | (-25, -9) mm |
| 沿旧槽保持直线至局部v | -20.5 mm |
| 两处中心线圆弧半径 | 3 mm |
| J2插口外水平直段 | 4 mm |
| 假定插入长度 | 4 mm |
| 出线至插口外部中心线长 | 52.842955 mm |
| 加插入段总长 | **56.842955 mm** |
| 相对用户约60 mm的名义余量 | **3.157045 mm** |
| 可用于分布扭转的下降直段 | 19.948965 mm |

该余量未扣除真实出线点差异、插入尺寸差异、实物测量误差和安装松弛要求。未建立这些误差的上限，不能把3.16 mm解释为已合格的装配裕量。尚需用实际排线无张力试装。

## 保留旧接口的定义

旧CW47.5坐标的 `v=-20.5` 指**第一圆弧开始的切线点**，不是尖折线交点。若误把它用作交点，R3会提前到约v=-19.07就开始转弯，进入外径40 mm圆环区域。

生成器迭代计算虚拟交点至v约-22.028，再构造R3圆弧，使真实曲率起点恰在v=-20.5。后续两种5 mm宽、0.3 mm示意厚的带状包络均保持在v≤-20.5；新通道允许区域采用更宽一点的 **v≤-20.25**。布尔切刀的端帽、倒圆及额外间隙必须另用该半空间裁剪，不能让刀具圆头反向越入旧接口。

## 文件与复用

- `build_fpc_route.py`：仅依赖Python标准库；运行后在同目录重生成JSON。输入集中在`PARAMETERS`。
- `fpc60-route.json`：解析式线段/圆弧、离散中心线和两组带宽轴。

JSON的 `centerline` 数组每项包含 `s_mm`、`center_xyz_mm`、`tangent_xyz`、`piece`。`s_mm` 是解析弧长，不是折线累计长度。离散折线较解析曲线短约0.000106 mm。

`pieces` 数组提供每段起止点、解析长度；圆弧另提供圆心、轴、角度、半径和虚拟交点。线段采样间距≤0.25 mm，圆弧角步长≤1°。

`ribbon_variants` 内两组 `samples` 与 `centerline` **按索引逐一对应**，包含宽度轴、法向、已施加扭角和两条边界。厚度包络可用：

`中心点 ± 2.5 × width_axis_xyz ± 0.15 × normal_xyz`

用于建模显示时，四个角点按同一顺序连接相邻截面；该体只作为装配参考，不是打印零件。

## 扭转与极性限制

初始宽轴采用旧槽的局部u方向，先平行运输，再在下降**直线段**中分布扭转。该直段首尾各留1 mm不分布扭转，内部用平滑变化；旧槽、两段R3圆弧及J2水平插入段不附加扭转。

| 几何分支 | 末端宽轴 | 末端法向 | 分布扭转 |
| --- | --- | --- | ---: |
| `end_normal_plus_Z` | +Y | +Z | -120.312° |
| `end_normal_minus_Z` | -Y | -Z | +59.688° |

这些法向是**几何定向**，不表示已确定金属接触面。较早108°只是另一条R2路径的估算，不能沿用到当前R3候选。

两分支都未确认实际触点面、排线第1根所在边与J2的逐针映射；没有默认选择其中任何一支。不能因为某个分支扭转较少就采用它，也不能据此镜像J2或改变已定义的`SCREEN_DM`第1脚。根任务需结合实物端面和现有PCB映射选定唯一正确的装配方向。

## 验证范围

生成器核对了切线连续、首段20.5 mm长度、J2外4 mm水平段、两个末端宽轴、带状表面v区域约束。两个解析圆弧的最小中心线半径3 mm，离散三点半径回算约3 mm。

**带边缘的最小采样曲率半径约2.303 mm，不能称整条带材都保持R3。** 精确数值分别保存在每个分支的`sampled_minimum_edge_curve_circumradius_mm`。这也不是材料允许弯曲半径证明。

该带状表面不模拟FPC拉伸、折痕、层间应力或可展性。5 mm宽、0.3 mm厚中，厚度纯属包络假设；R3也是设计假设，没有得到厂家最小弯曲半径保证。真实出线起点取旧接口v=0、法向0.35 mm；J2嘴中心(-40.4,-18.801,10.9)和插入4 mm均待实物核对。

本目录没有执行旧STL通道布尔、竖直后置电池仓设计、完整零件碰撞或打印验证；这些由主建模任务在装配中继续完成。
