Ha22yX/Gridopoly/Docs/firmware/debug-tools-pairing-rollout-2026-10-17.md

# 右键调试、配对稳定性、呼吸灯与玩家屏英文文案

更新：2026-10-17（America/New_York）。本记录区分源码、隔离测试、实际部署及用户目视；未完成项不继承旧版验收。

## 本轮范围与责任

- 服务器会话：网页右键修改玩家资金、可交易资产归属；配对短暂不完整扫描导致换 reader 的修复；持久化和接口回归。
- 格子会话：目的地绿色平滑呼吸、独立 LED 刷新、重复心跳保持相位，普通 V0.38 长边/角落候选。
- 玩家屏会话：重连/快照过期时隐藏旧配对目标，保留已绑定身份及草稿；全面检查系统中文文案、编码字符串和内嵌文字图片并改英文。用户自行填写的姓名不翻译，服务器网页继续中文。
- 主会话：源码审核、冻结文件校验、设备独占操作、部署和实体验收、设备台账及 Git 整合。

用户尚不能回忆配对异常时是否先出现成功提示，可稍后重现。本轮发现可复现机制，不把它直接等同于已经复现了该次现场全部经过。

## 已确认机制

1. 旧格子目的地灯效为 900 ms 周期内两次亮灭硬切换；主循环还会受到 RFID 扫描和 LCD 提交阻塞。V0.38 改为 2400 ms 平滑渐亮渐暗，LED 单独每 20 ms 调度，RMT 只由该任务使用。保留低亮缩放和最终每通道 16/255 上限。
2. 旧服务器遇到一次不完整扫描、去抖保留状态等 `fresh=false` 上报就立即清除 reader 的有效期限，随后可自动换格。修复保留最后完整有效扫描原有的有限期限；坏读数既不能用于绑定，也不能续期。新扫描、房间/会话、先空后放和已绑定 UID 检查仍保留。
3. 玩家屏断线后保留旧 Tag 快照；普通身份消息先恢复在线时，新的 Tag 快照尚未到达，可能暂时重新显示旧目标。玩家端已增加独立提示新鲜度约束，137 项主机回归通过，不清除合法绑定或外貌姓名草稿；源码已提交82e57e84，两种正常配置构建及四台部署均已完成，真实新局配对仍待验证。
4. 交易接收者旁的“已锁定”为 `kLockedMarkerMap` 位图，普通字符串扫描无法发现；改为英文 `LOCKED` 标签。41 处内置中文字符串已替换，含 UTF-8 转义和演示数据；真实 LVGL 回归141项通过，交易路径截图及标签尺寸已检查。完整旧布局检查器仍有基线失败，详见[玩家报告](player-tag-pair-freshness-2026-10-17.md)。

## COM10 单板 V0.38 实测

完整 MAC `A4:CB:8F:C1:E1:34`，角落板。烧录前 USB 身份与服务器 `moduleRole=corner` 一致，仍为 V0.37、ORDER map 0。首次 12 秒无复位 STATUS 窗口没有收到串口日志，保留该空记录，不记为运行检查通过。

本次使用普通角落候选，先核对 85 项冻结输入、四段 SHA 和分区，再由固定 esptool 5.3.1 在同一连接中核对 MAC、写入/校验及 watchdog-reset。没有 erase-all、NVS 初始化或游戏操作。

| 内容 | 结果 |
| --- | --- |
| 应用 SHA256 | `c94c31c5d7d12e3eef5a8adc221b7d7baaa898e9d1146741444bb26d82675cfd` |
| candidate SHA256 | `61f5fe0888c547cd994c30760327229adfd58da55e3605e5532c34abf6d85893` |
| sourceDigest | `db55626d006b8a36b4339e1c40b908108d96ac1beeed36ea4eefd4fc2965ad1a` |
| 启动后 | V0.38、LCD 8 MHz、rotation 2、HTTP 200，恢复 `CORNER-START` / map 0 |
| 图片缓存 | 默认图 requests 0、ready 0、RAM 0，上限 307200 字节保留 |
| LED 预览 | `LED DESTINATION 30`，本地限时覆盖；自动恢复 scene，随后 `LED AUTO`，串口关闭 |
| 用户确认 | “呼吸柔和，亮度和屏幕正常” |

调度统计首次观测已有 `max_gap_ms=383 / late_frames=2`，随后整个预览没有增加；RMT 完成计数从 1955 增至 3739，failed=0。该结果不代表每一帧严格不超过 20 ms，启动长间隔保留，不把驱动成功等同于光学验收。光学结论来自上述用户反馈。

冻结构建以已部署普通 V0.37 的 82 项输入为基础，只应用审阅的 LED 修改；不把共享树实验 RFID 路径混入正常固件。历史 V0.37 包保持。候选中的 Git base 不是本轮源码提交，实际内容由 sourceDigest、输入清单及应用 SHA 确定。

本机证据目录：`C:/Users/kicof/AppData/Local/GridopolyDebugPairingRuntime/`，包含 `com10-baseline.jsonl`、`v038-COM10-validation.json`、`v038-COM10-flash.json`、`v038-COM10-status.jsonl`、`v038-COM10-destination.jsonl`。候选及 host 结果位于 `C:/Users/kicof/AppData/Local/GridopolyTileTools/cue-pairing-v038-20261017/`。固件与本地运行记录不提交仓库。

## 服务器已部署

主会话核对最终 544 项冻结输入、二进制 SHA 与只含本轮修改的差异。2026-10-17 21:03 EDT 仅更新游戏服务：实际 PID1877597，应用 `81b79bec250b4cf3e52c9d315ea442c5cdabf4d6083005a344eadf9490de17cd`。旧程序及停服数据已备份，房间993580118保留，部署前后业务差异为空，402 项资源及 AP/服务配置哈希不变。

回读16模块在线/分配、ORDER唯一16闭环 ready、3屏在线；网页已有右键“调试：修改资金”和“调试：分配所有权”。右键只打开表单，确认后才写入；服务器校验房间/版本、对象与事务状态，写盘成功后发布。配对短暂不完整扫描保留有效期限的修复也已运行。完整测试、限制与证据见[服务器报告](server-debug-pairing-2026-10-17.md)。

用户先确认两种入口和表单正常，随后要求直接在现有右键菜单内修改。21:21 EDT已部署最终内联版 `fb03d800d45bd8759775404d792dcd9df88dd32893db6dad265fc63f23c9c7f7`，实际PID1890195；资金输入、所有者选择、保存和反馈均在原菜单，后台轮询保留草稿与焦点，API规则不变。部署前后房间与业务保持、402资源和AP配置未变；回读16在线/分配及ORDER ready，本次快照为2个玩家peer。用户明确确认 **“现在这样符合预期”**，最终交互验收通过。未注入线上调试写入来替代真实操作。

Git：格子 `c3a2b118`、服务器首版 `d3455140`、玩家源码/测试 `82e57e84` 和菜单内编辑 `ef8d3481` 已通过桌面 GitHub CLI 认证推送到 `origin/main`；本次设备部署记录另作定向提交。

## 四台玩家屏已升级并目视验收

用户补充接入另一台屏幕，完整USB/ROM MAC核对为原COM7 `dc:b4:d9:02:d1:dc`。主会话将该台纳入本次更新，未按“新屏”猜测新身份或重置NVS。2026-10-17 21:29～21:31 EDT依次完成COM7、COM27、COM28、COM29四段写入与读回校验；固定esptool5.3.1、同一连接核对MAC/16MB/现有分区、hard-reset，保留NVS及既有身份。每台写入前独立核对2146项冻结源码、候选SHA及配置。

| 设备 | 正常配置及应用SHA256 | 升级后有界采集 |
| --- | --- | --- |
| COM7 | 16MHz / `77af3c26585cd6baa2ecd487a81a278f8be31e19eccf76c6e7cabdabcd87a6b7` | 首次电量通信失败；用户手动重开/重接后6组有效，99%，约4.16V |
| COM27 | 16MHz / 同上 | 6组有效，82%，末样4.016V |
| COM28 | 16MHz / 同上 | 6组有效，83%，末样4.044V |
| COM29 | 12MHz / `efb60d8a7113a4fcb4b90a62d2497335575822060ad78cf6c42312a9e29ac047` | 6组有效，82%，末样4.035V |

四台均启用viewe-md80et-v10，保留独立电量采样、弧形电池、充电防抖、已有建房入口及按需素材功能。COM7首次启用这些后续功能；另外三台本轮电量/显示策略源码与先前已验收版一致。

COM7首次25秒被动采集（启动约6～31秒）读到桥接版本但 `InspectBridge` 返回 `55 7E 13 DF 66`；实际拒绝点为寄存器08不等于00，尚未进入电量计采样。原始失败保留，不能解释为电池电压为0或电量计已损坏。用户明确确认期间手动重开或重接；第二次采集读到新启动正常配置及99%。这是手动恢复，**不记为自动恢复**，08异常来源仍未定。没有为绕过校验写入07/08/09。

第二次四台并行被动采集30秒，各6组 `link=1/mv_ok=1/io_ok=1/e=0`，窗口内无重启日志、无串口错误，全部串口已关闭。用户确认COM7画面/电量正常；另外三台“画面、电量正常，LOCKED也正常”，完成本轮视觉与交易英文标记验收。用户姓名不翻译，网页继续中文；不将此验收扩大为COM28手写或全部动态性能通过。

21:33 EDT只读HTTP确认四台online/eligible，COM28/29/27仍席位1/2/3；COM7为seat0等待下一局纳入，未强行加入已冻结的三真人房间。room993580118保持，版本已随用户正常操作推进到131；16格在线、ORDER唯一16闭环ready。没有创建新局或注入资产/Tag/掷骰。

本机证据：`GridopolyPlayerBatteryRuntime/english-pairing-20261017-COM*-validation.json`、对应`-flash.json`，`english-pairing-first-20261017-COM7.*`、`english-pairing-four-20261017-COM*.log/.summary.json`；HTTP为 `GridopolyDebugPairingRuntime/four-player-english-post-deploy.json`。候选完整来源及测试见[玩家报告](player-tag-pair-freshness-2026-10-17.md)。

## 进行中与后续实机条件

- 前阶段仅COM10这1/16块更新V0.38，其他15块V0.37；用户一度要求稍后更新。随后第一批COM10/16/17/18改为普通V0.39旋转流星，三长边目视通过，COM10尾两灯旧新版均暗。第二批COM20～23已写入V0.39并目视通过；第三批COM11/24/25/26已写入同版并目视通过；第四批COM12～15已写验并目视通过，累计16/16板完成V0.39部署；现场反馈与逐板证据以[流星与分批记录](tile-meteor-cues-2026-10-17.md)为准，不将前阶段呼吸验收扩大为全灯无故障。
- 网页内联调试与服务器配对修复已部署 `fb03d800…`，room `993580118`。用户已确认菜单交互符合预期；未自动修改线上现金、归属、Tag、掷骰或新建对局。
- 四台玩家屏英文文案/配对提示固件已部署，画面、电量和LOCKED已获用户确认；COM7手动重开后恢复电量的边界如上。COM7/27/28使用16MHz，COM29继续使用12MHz。
- 真实开局逐人配对、短暂扫描波动下原格成功，以及真实掷骰目的地灯效仍需相应现场步骤；本地 LED 预览不能替代这些端到端结果。
