Ha22yX/Gridopoly/Mechanical/BoardBase/interfaces/pcb-interface-2026-10-15/reviews/connectors-review/JIN1-C32713265.pdf

m

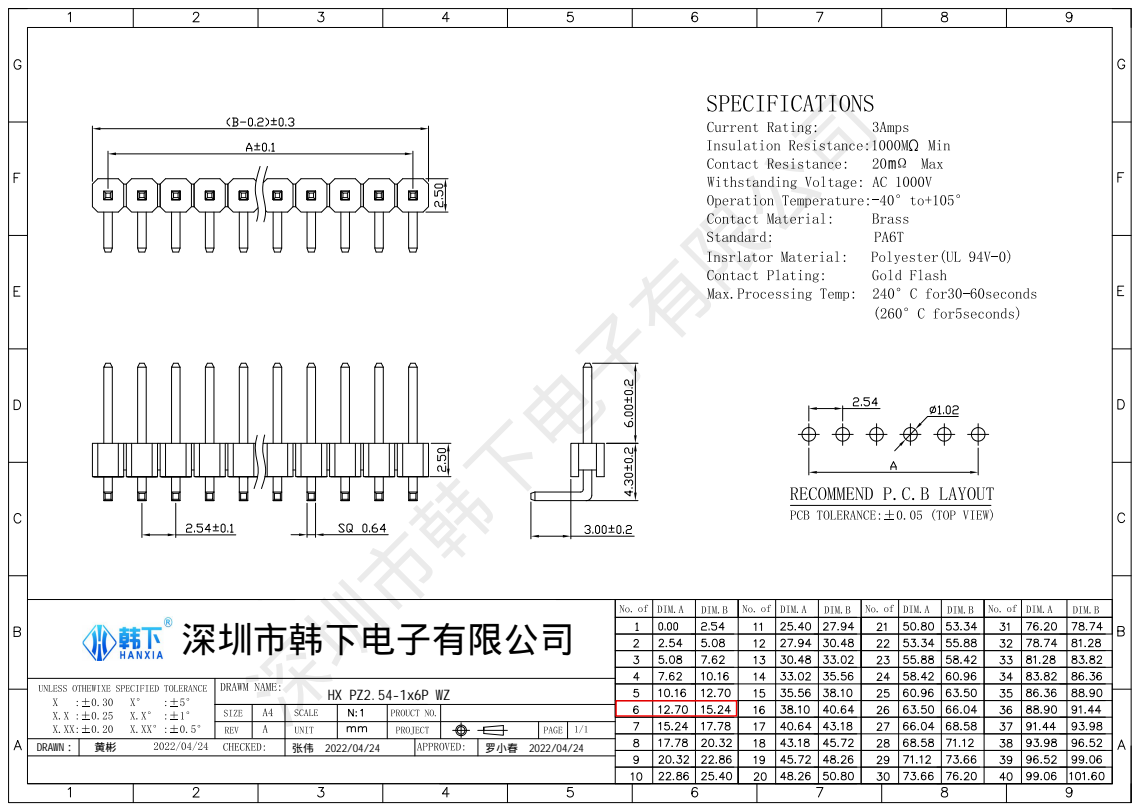
[picture p162: page 1]
DRAWN：; 罗小春 2022/04/24; 深圳市韩下电子有; 限公司; 深圳市韩下电子有限公司
