Ha22yX/Gridopoly/Mechanical/BoardBase/interfaces/pcb-interface-2026-10-15/reviews/connectors-review/JOUT1-C54973819.pdf

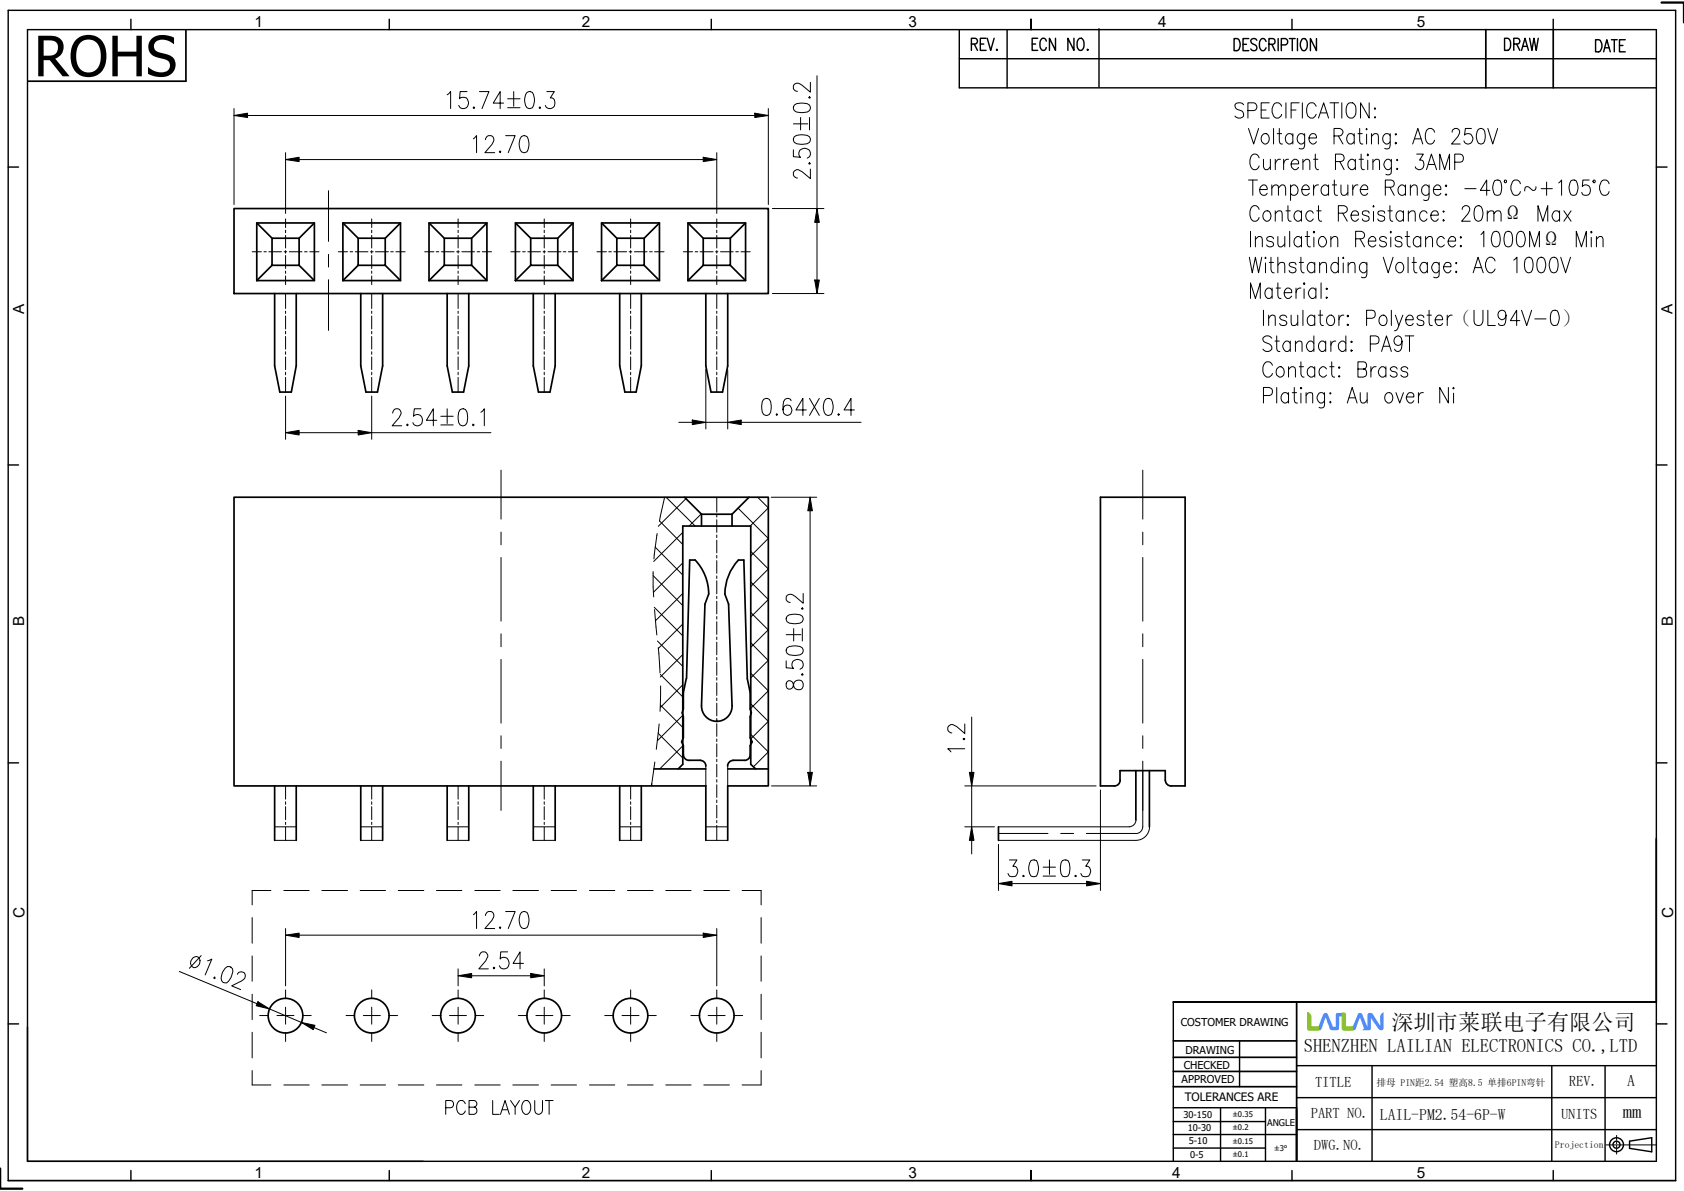
[picture p163: page 1]
B PART NO.; LAIL-PM2.54-6P-W TITLE; REV. UNITS; mm 深圳市莱联电子有限公司 SHENZHEN LAILIAN ELECTRONICS CO.,LTD A DWG.NO.; Projection ROHS; TOLERANCES ARE DRAWING CHECKED APPROVED 30-150 10-30 5-10 0-5; ±3° ANGLE COSTOMER DRAWING; 排母 PIN距2.54 塑高8.5 单排6PIN弯针 Ω Ω （
