Ha22yX/Gridopoly/PCB Files/PlayerConsolePower/ProductionReadiness-2026-10-14/j1-library-linked.pdf

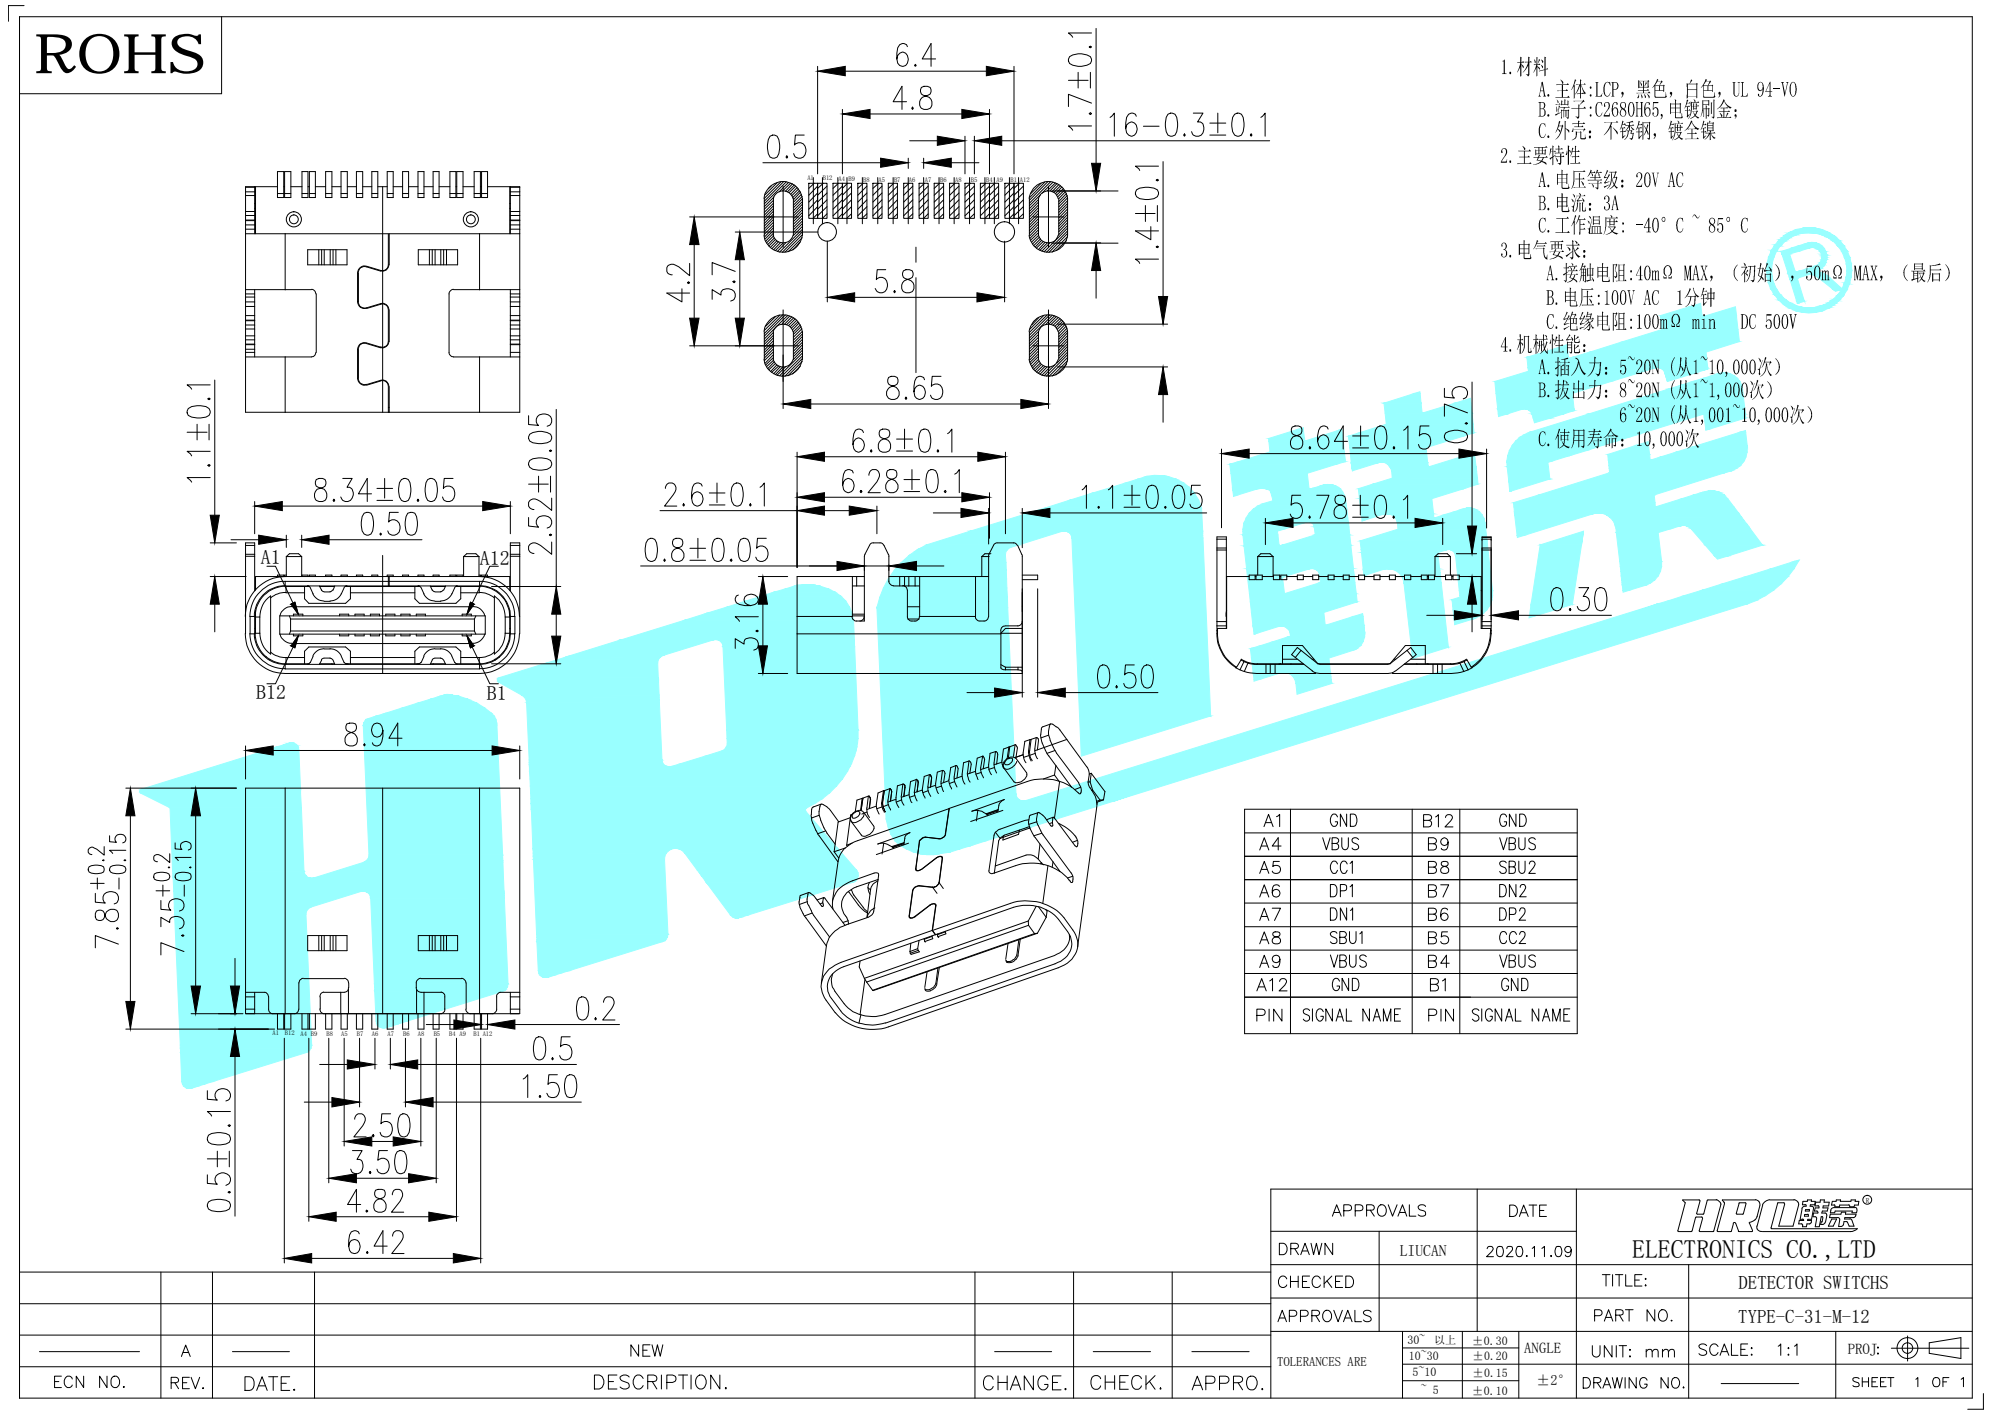
[picture p164: page 1]
