Ha22yX/Gridopoly/(list of files, drawings)

Other design files:
PCB Files/CornerModule/DC24-2026-09-21/SyncRepair/pcb-drc.json
PCB Files/CornerModule/LayoutCandidate-2026-09-21/corner-layout-candidate.dsn
PCB Files/PlayerConsolePower/BatShortAudit-2026-10-14/schematic-source-comparison.json
PCB Files/PlayerConsolePower/DesignDraft-2026-09-27/pcb-component-import.json
PCB Files/PlayerConsolePower/DesignDraft-2026-09-27/schematic-comprehensive-review.json
PCB Files/PlayerConsolePower/Layout-2026-09-27-RC3/schematic-drc.json
PCB Files/PlayerConsolePower/Layout-2026-09-27-RC4/schematic-drc.json
PCB Files/PlayerConsolePower/Layout-2026-09-27-RC4/schematic-netlist.json
PCB Files/PlayerConsolePower/Layout-2026-09-27-RC5/schematic-drc.json
PCB Files/PlayerConsolePower/Layout-2026-09-27/schematic-drc-final.json
PCB Files/PlayerConsolePower/Layout-2026-09-27/schematic-netlist.json
PCB Files/PlayerConsolePower/ProductionAudit-2026-09-27/schematic-netlist.json
PCB Files/PlayerConsolePower/ProductionAudit-2026-10-05/schematic-drc.json
PCB Files/PlayerConsolePower/ProductionAudit-2026-10-05/schematic-netlist.json
PCB Files/PlayerConsolePower/ProductionReadiness-2026-10-14/schematic-drc.json
PCB Files/PlayerConsolePower/ProductionReadiness-2026-10-14/schematic-netlist.json
PCB Files/PlayerConsolePower/Testpoints-2026-10-15/schematic-netlist-after.json
