Ha22yX/Gridopoly/Firmware/TileModule/src/main.cpp

#include <Arduino.h>
#include <SPI.h>
#include <Wire.h>
#include <driver/gpio.h>
#include <esp_system.h>
#include <esp_heap_caps.h>
#include <esp_mac.h>

#include <Adafruit_GFX.h>
#include <Adafruit_ST7789.h>

#include <algorithm>
#include <cctype>
#include <cstdint>
#include <cstdio>
#include <cstdlib>
#include <cstring>

#include "board_config.h"
#include "display_diff.h"
#include "order_link_io.h"
#include "module_profile.h"
#include "hitag_s_decoder.h"
#include "hitag_s_protocol.h"
#include "tag_presence_filter.h"
#include "tile_artwork.h"
#include "development_artwork.h"
#include "tile_connection_view.h"
#include "tile_model.h"
#include "tile_network.h"
#include "tile_ui_theme.h"
#include "ws2812_led.h"
#include "led_runtime.h"
#include "serial_command_line.h"
#include "rfid_diagnostics.h"

namespace {

using namespace gridopoly::tile;
using namespace gridopoly::tile::board;
using namespace gridopoly::tile::theme;

constexpr std::uint8_t kInaRegConfig = 0x00;
constexpr std::uint8_t kInaRegShuntVoltage = 0x01;
constexpr std::uint8_t kInaRegBusVoltage = 0x02;
constexpr std::uint8_t kInaRegPower = 0x03;
constexpr std::uint8_t kInaRegCurrent = 0x04;
constexpr std::uint8_t kInaRegCalibration = 0x05;
constexpr std::uint8_t kInaRegManufacturerId = 0xFE;
constexpr std::uint8_t kInaRegDieId = 0xFF;
constexpr std::uint16_t kInaConfig = 0x0527;
constexpr std::uint16_t kInaCalibration = 0x1400;

constexpr std::uint32_t kPowerSamplePeriodMs = 200;
constexpr std::uint32_t kUiRefreshPeriodMs = 500;
constexpr std::uint8_t kHtrcGetConfigPage = 0x04;
constexpr std::uint8_t kHtrcSetConfigPage = 0x40;
constexpr std::uint8_t kHtrcFieldOffPage1 = 0x01;
constexpr std::uint32_t kHtrcHalfCycleUs = 24;
constexpr std::uint32_t kHtrcGuardUs = 12;
constexpr std::uint32_t kHtrcSafeRewritePeriodMs = 1000;
constexpr std::uint8_t kHtrcGetSamplingTime = 0x02;
constexpr std::uint8_t kHtrcReadPhaseCommand = 0x08;
constexpr std::uint8_t kHtrcSetSamplingTime = 0x80;
constexpr std::uint8_t kHtrcReceiverPage0 = 0x0B;
constexpr std::uint8_t kHtrcFieldOnPage1 = 0x00;
constexpr std::uint8_t kHtrcClockPage3 = 0x00;
constexpr std::uint8_t kHtrcAntFailMask = 0x10;
constexpr std::uint32_t kHtrcFastHalfCycleUs = 2;
constexpr std::uint32_t kHtrcFastGuardUs = 1;
constexpr std::uint32_t kTagSearchPeriodMs = 400;
constexpr std::uint32_t kTagPresencePollPeriodMs = 250;
constexpr std::uint32_t kTagMultiPollPeriodMs = 500;
constexpr std::uint32_t kTagCaptureMs = 24;
constexpr std::uint32_t kTagMaximumFieldMs = 350;
constexpr std::uint32_t kTagInventoryWorkBudgetMs = 300;
constexpr std::uint32_t kTagInventoryCommandGuardUs = 1600;
constexpr std::size_t kTagInventoryPrefixCapacity = 32;
constexpr std::size_t kTagMaximumEdges = 1024;
constexpr std::uint8_t kHitagWritePulseCycles = 7;
constexpr std::uint32_t kHitagFieldResetMs = 6;
constexpr std::uint32_t kHitagFirstRequestUs = 3000;
constexpr std::uint32_t kHitagZeroIntervalUs = 160;
constexpr std::uint32_t kHitagOneIntervalUs = 224;
constexpr std::uint32_t kHitagEofSilenceUs = 304;
constexpr std::uint8_t kHitagUidRequestBits[] = {1U, 1U, 0U, 0U, 1U};
constexpr float kTagMinimumBusVoltageV = 4.65F;
constexpr float kTagMaximumTotalCurrentMa = 350.0F;
constexpr float kTagMaximumCurrentIncreaseMa = 180.0F;

enum class TagStatus : std::uint8_t {
  Scanning,
  NoTag,
  Present,
  Unstable,
  Fault,
};

struct PowerReading {
  bool present = false;
  bool configured = false;
  bool valid = false;
  float bus_voltage_v = 0.0F;
  float current_ma = 0.0F;
  float power_mw = 0.0F;
  float peak_current_ma = 0.0F;
  std::uint16_t manufacturer_id = 0;
  std::uint16_t die_id = 0;
};

struct TagEdge {
  std::uint32_t elapsed_us = 0;
  std::uint8_t level = 0;
};

struct TagAttempt {
  hitag_s::DecodeResult decoded{};
  bool safety_ok = false;
  bool field_off_ok = false;
  bool overflow = false;
  std::uint16_t edge_count = 0;
  std::uint16_t pulse_count = 0;
  std::uint32_t first_edge_us = 0;
  std::uint32_t field_duration_ms = 0;
};

struct TagResponseCapture {
  hitag_s::DecodeResult decoded{};
  bool overflow = false;
  std::uint16_t edge_count = 0;
  std::uint16_t pulse_count = 0;
  std::uint32_t first_edge_us = 0;
};

struct TagInventoryAttempt {
  hitag_s::UidSet tags{};
  bool safety_ok = false;
  bool field_off_ok = false;
  bool overflow = false;
  bool incomplete = false;
  std::uint8_t commands = 0;
  bool antenna_ok = false;
  std::uint32_t field_duration_ms = 0;
  float field_voltage_v = 0.0F;
  float field_current_ma = 0.0F;
  float baseline_current_ma = 0.0F;
};

SPIClass gDisplaySpi(FSPI);
class BoardST7789 : public Adafruit_ST7789 {
 public:
  using Adafruit_ST7789::Adafruit_ST7789;
  // commonInit calls this virtual method without a frequency. Keep every
  // initialization command at the recovery rate, including after a bad write.
  void begin(std::uint32_t = 0) override {
    Adafruit_ST77xx::begin(kDisplaySafeSpiFrequencyHz);
  }
};
BoardST7789 gDisplay(&gDisplaySpi, kLcdChipSelectPin,
                         kLcdDataCommandPin, kLcdResetPin);
// PSRAM holds composed pixels and the last completed submission. SPI always
// receives one aligned internal-RAM row, never a flash/PSRAM-backed long buffer.
class DisplayCanvas : public GFXcanvas16 {
 public:
  DisplayCanvas() : GFXcanvas16(kDisplayWidth, kDisplayHeight, false) {}
  bool allocate() {
    if (buffer != nullptr) return true;
    buffer = static_cast<std::uint16_t *>(heap_caps_malloc(
        kDisplayWidth * kDisplayHeight * sizeof(std::uint16_t),
        MALLOC_CAP_SPIRAM | MALLOC_CAP_8BIT));
    buffer_owned = true;
    return buffer != nullptr;
  }
  void release() {
    heap_caps_free(buffer);
    buffer = nullptr;
  }
};
DisplayCanvas gPageCanvas;
std::uint16_t *gSubmittedFrame = nullptr;
bool gSubmittedFrameValid = false;
bool gFramePending = false;
std::uint32_t gDisplayClockHz = kDisplaySpiFrequencyHz;
std::uint32_t gDisplayExperimentStartedMs = 0;
std::uint32_t gDisplayExperimentDurationMs = 0;
alignas(4) std::uint16_t gDisplayRow[kDisplayWidth]{};
struct DisplayMetrics {
  std::uint32_t frames = 0;
  std::uint32_t skipped = 0;
  std::uint32_t rectangles = 0;
  std::uint32_t pixels = 0;
  std::uint32_t full_frames = 0;
  std::uint32_t last_us = 0;
  std::uint32_t max_us = 0;
} gDisplayMetrics;

Adafruit_GFX &displaySurface() {
  return gSubmittedFrame != nullptr ? static_cast<Adafruit_GFX &>(gPageCanvas)
                                    : static_cast<Adafruit_GFX &>(gDisplay);
}

GFXcanvas16 gFooterCanvas(kDisplayWidth, 34);
TileNetworkClient gNetwork;
TileNetworkSnapshot gNetworkSnapshot{};
PowerReading gPower;
alignas(4) std::uint16_t gArtworkRow[160]{};
bool gDisplayReady = false;
bool gDiagnosticPage = false;
std::uint8_t gBacklightDuty = kBacklightDuty;
std::uint32_t gLastPowerSampleMs = 0;
std::uint32_t gLastUiRefreshMs = 0;
std::uint32_t gMovementCueStartedMs = 0;
std::uint32_t gPairingCueStartedMs = 0;
TagScanEvidence gTagScanEvidence{};
std::uint32_t gScanPairingRoom = 0, gScanPairingSession = 0;
std::uint32_t gLastHtrcSafeRewriteMs = 0;
bool gHtrcTransmitterSafe = false;
std::uint32_t gLastTagScanMs = 0;
TagStatus gTagStatus = TagStatus::Scanning;
hitag_s::Uid gConfirmedTagUids[hitag_s::kMaximumInventoryTags]{};
char gTagUids[hitag_s::kMaximumInventoryTags][9]{};
std::uint8_t gConfirmedTagCount = 0;
bool gConfirmedTagOverflow = false;
std::uint8_t gTagMissingEvidence[hitag_s::kMaximumInventoryTags]{};
std::uint8_t gTagPreferredSampling = 0;
bool gTagPreferredSamplingValid = false;
bool gTagUiDirty = false;
bool gTagNetworkPublishPending = false;
rfid_diagnostics::Trace gRfidDiagnostics;
rfid_diagnostics::ProbeBudget gRfidProbeBudget;
SerialCommandLine<64> gSerialLine;
DRAM_ATTR volatile TagEdge gTagEdges[kTagMaximumEdges]{};
DRAM_ATTR volatile std::uint16_t gTagEdgeCount = 0;
DRAM_ATTR volatile std::uint32_t gTagCaptureStartUs = 0;
DRAM_ATTR volatile bool gTagCaptureActive = false;
DRAM_ATTR volatile bool gTagCaptureOverflow = false;

std::uint16_t displayColor(Rgb color) {
  return rgb565(color.red, color.green, color.blue);
}

Rgb playerColor(std::uint8_t player) {
  if (player < 1 || player > kMaximumPlayers) {
    return {};
  }
  const Rgb888 color = kPlayerColors[player - 1U];
  return {color.red, color.green, color.blue};
}

const TileState &currentTileState() {
  return gNetworkSnapshot.tile;
}

void setSafeOutputs() {
  digitalWrite(kLcdBacklightPin, LOW);
  pinMode(kLcdBacklightPin, OUTPUT);
  digitalWrite(kLcdChipSelectPin, HIGH);
  pinMode(kLcdChipSelectPin, OUTPUT);
  digitalWrite(kLcdDataCommandPin, LOW);
  pinMode(kLcdDataCommandPin, OUTPUT);
  digitalWrite(kLcdResetPin, HIGH);
  pinMode(kLcdResetPin, OUTPUT);

  digitalWrite(kRs485DirectionPin, LOW);
  pinMode(kRs485DirectionPin, OUTPUT);
  digitalWrite(kOrderOutPin, LOW);
  pinMode(kOrderOutPin, OUTPUT);
  pinMode(kOrderInPin, INPUT);
  digitalWrite(kRfidClockPin, LOW);
  pinMode(kRfidClockPin, OUTPUT);
  digitalWrite(kRfidDataInPin, LOW);
  pinMode(kRfidDataInPin, OUTPUT);
  pinMode(kRfidDataOutPin, INPUT);
  digitalWrite(kWs2812DataPin, LOW);
  pinMode(kWs2812DataPin, OUTPUT);
}

void htrcDelay() {
  delayMicroseconds(kHtrcHalfCycleUs);
}

void htrcSerialReset() {
  // HTRC110 serial-interface reset: DIN low-to-high while SCLK is high.
  digitalWrite(kRfidClockPin, LOW);
  digitalWrite(kRfidDataInPin, LOW);
  delayMicroseconds(kHtrcGuardUs);
  digitalWrite(kRfidClockPin, HIGH);
  htrcDelay();
  digitalWrite(kRfidDataInPin, HIGH);
  htrcDelay();
  digitalWrite(kRfidClockPin, LOW);
  htrcDelay();
}

void htrcWriteBits(std::uint8_t value, std::uint8_t bit_count) {
  for (int bit = bit_count - 1; bit >= 0; --bit) {
    digitalWrite(kRfidDataInPin,
                 (value & (1U << bit)) != 0U ? HIGH : LOW);
    delayMicroseconds(kHtrcGuardUs);
    digitalWrite(kRfidClockPin, HIGH);
    htrcDelay();
    digitalWrite(kRfidClockPin, LOW);
    htrcDelay();
  }
}

std::uint8_t htrcReadBits(std::uint8_t bit_count) {
  std::uint8_t value = 0;
  digitalWrite(kRfidDataInPin, LOW);
  delayMicroseconds(kHtrcGuardUs);
  for (std::uint8_t bit = 0; bit < bit_count; ++bit) {
    digitalWrite(kRfidClockPin, HIGH);
    htrcDelay();
    value = static_cast<std::uint8_t>(
        (value << 1U) |
        (digitalRead(kRfidDataOutPin) == HIGH ? 1U : 0U));
    digitalWrite(kRfidClockPin, LOW);
    htrcDelay();
  }
  return value;
}

void htrcWriteCommand(std::uint8_t command) {
  htrcSerialReset();
  htrcWriteBits(command, 8);
  digitalWrite(kRfidDataInPin, LOW);
}

std::uint8_t htrcReadCommand(std::uint8_t command) {
  htrcSerialReset();
  htrcWriteBits(command, 8);
  return htrcReadBits(8);
}

bool forceHtrcTransmitterOff() {
  const std::uint8_t set_page1 = static_cast<std::uint8_t>(
      kHtrcSetConfigPage | (1U << 4U) | kHtrcFieldOffPage1);
  for (std::uint8_t attempt = 0; attempt < 3U; ++attempt) {
    htrcWriteCommand(set_page1);
    const std::uint8_t page1 = htrcReadCommand(
        static_cast<std::uint8_t>(kHtrcGetConfigPage | 1U));
    if ((page1 & 0x0FU) == kHtrcFieldOffPage1) {
      return true;
    }
    delay(1);
  }
  return false;
}

void htrcSetConfig(std::uint8_t page, std::uint8_t data) {
  htrcWriteCommand(static_cast<std::uint8_t>(
      kHtrcSetConfigPage | ((page & 0x03U) << 4U) | (data & 0x0FU)));
}

std::uint8_t htrcGetConfig(std::uint8_t page) {
  return htrcReadCommand(
      static_cast<std::uint8_t>(kHtrcGetConfigPage | (page & 0x03U)));
}

void htrcSetSampling(std::uint8_t value) {
  htrcWriteCommand(
      static_cast<std::uint8_t>(kHtrcSetSamplingTime | (value & 0x3FU)));
}

std::uint8_t htrcGetSampling() {
  return htrcReadCommand(kHtrcGetSamplingTime);
}

std::uint8_t htrcReadPhase() {
  return static_cast<std::uint8_t>(
      htrcReadCommand(kHtrcReadPhaseCommand) & 0x3FU);
}

void htrcFastSerialReset() {
  digitalWrite(kRfidClockPin, LOW);
  digitalWrite(kRfidDataInPin, LOW);
  delayMicroseconds(kHtrcFastGuardUs);
  digitalWrite(kRfidClockPin, HIGH);
  delayMicroseconds(kHtrcFastHalfCycleUs);
  digitalWrite(kRfidDataInPin, HIGH);
  delayMicroseconds(kHtrcFastHalfCycleUs);
  digitalWrite(kRfidClockPin, LOW);
  delayMicroseconds(kHtrcFastHalfCycleUs);
}

void htrcFastWriteBits(std::uint8_t value, std::uint8_t bit_count) {
  for (int bit = bit_count - 1; bit >= 0; --bit) {
    digitalWrite(kRfidDataInPin,
                 (value & (1U << bit)) != 0U ? HIGH : LOW);
    delayMicroseconds(kHtrcFastGuardUs);
    digitalWrite(kRfidClockPin, HIGH);
    delayMicroseconds(kHtrcFastHalfCycleUs);
    digitalWrite(kRfidClockPin, LOW);
    delayMicroseconds(kHtrcFastHalfCycleUs);
  }
}

void htrcFastSetConfig(std::uint8_t page, std::uint8_t data) {
  htrcFastSerialReset();
  htrcFastWriteBits(static_cast<std::uint8_t>(
                        kHtrcSetConfigPage | ((page & 0x03U) << 4U) |
                        (data & 0x0FU)),
                    8U);
  digitalWrite(kRfidDataInPin, LOW);
}

void htrcFastExitMode() {
  digitalWrite(kRfidDataInPin, LOW);
  digitalWrite(kRfidClockPin, HIGH);
  delayMicroseconds(kHtrcFastHalfCycleUs);
  digitalWrite(kRfidClockPin, LOW);
  delayMicroseconds(kHtrcFastHalfCycleUs);
}

void htrcEnterReadTag() {
  // READ_TAG (111) enters transparent mode on the third rising edge.
  htrcFastSerialReset();
  htrcFastWriteBits(0x07U, 3U);
  digitalWrite(kRfidDataInPin, LOW);
}

void waitUntilMicros(std::uint32_t target_us) {
  while (static_cast<std::int32_t>(micros() - target_us) < 0) {
  }
}

void htrcTriggerWritePulse() {
  digitalWrite(kRfidDataInPin, HIGH);
  delayMicroseconds(kHtrcFastGuardUs);
  digitalWrite(kRfidDataInPin, LOW);
}

bool htrcProgramWritePulseWidth(std::uint8_t carrier_cycles) {
  noInterrupts();
  htrcFastSerialReset();
  htrcFastWriteBits(static_cast<std::uint8_t>(0x10U | carrier_cycles), 8U);
  digitalWrite(kRfidDataInPin, LOW);
  delayMicroseconds(static_cast<std::uint32_t>(carrier_cycles) * 8U + 8U);
  htrcFastExitMode();
  interrupts();
  const std::uint8_t page1 = htrcGetConfig(1);
  return (page1 >> 4U) == carrier_cycles &&
         (page1 & 0x0FU) == kHtrcFieldOffPage1;
}

bool htrcSendHitagFrame(const std::uint8_t *bytes, std::uint8_t bit_count,
                        std::uint32_t first_boundary) {
  if (bytes == nullptr || bit_count == 0U ||
      bit_count > hitag_s::kMaximumReaderFrameBits) {
    return false;
  }
  htrcSetConfig(2, 0x09U);
  waitUntilMicros(first_boundary - 120U);

  noInterrupts();
  htrcFastSerialReset();
  htrcFastWriteBits(0x06U, 3U);
  waitUntilMicros(first_boundary);
  htrcTriggerWritePulse();
  std::uint32_t boundary = first_boundary;
  for (std::size_t index = 0; index < bit_count; ++index) {
    const std::uint8_t bit = hitag_s::bitAt(bytes, index);
    boundary += bit != 0U ? kHitagOneIntervalUs : kHitagZeroIntervalUs;
    waitUntilMicros(boundary);
    htrcTriggerWritePulse();
  }
  waitUntilMicros(boundary + kHitagEofSilenceUs);
  htrcFastExitMode();
  interrupts();

  // NXP fast-settling sequence before the tag response window.
  delayMicroseconds(150);
  htrcFastSetConfig(2, 0x0BU);
  delayMicroseconds(200);
  htrcFastSetConfig(2, 0x00U);
  return true;
}

bool htrcSendHitagUidRequest(std::uint32_t field_started_us) {
  // Preserve the V0.23 single-tag waveform byte-for-byte. The packed generic
  // sender above is reserved for variable-length AC SEQUENCE frames.
  htrcSetConfig(2, 0x09U);
  const std::uint32_t first_boundary =
      field_started_us + kHitagFirstRequestUs;
  waitUntilMicros(first_boundary - 120U);

  noInterrupts();
  htrcFastSerialReset();
  htrcFastWriteBits(0x06U, 3U);
  waitUntilMicros(first_boundary);
  htrcTriggerWritePulse();
  std::uint32_t boundary = first_boundary;
  for (const std::uint8_t bit : kHitagUidRequestBits) {
    boundary += bit != 0U ? kHitagOneIntervalUs : kHitagZeroIntervalUs;
    waitUntilMicros(boundary);
    htrcTriggerWritePulse();
  }
  waitUntilMicros(boundary + kHitagEofSilenceUs);
  htrcFastExitMode();
  interrupts();

  delayMicroseconds(150);
  htrcFastSetConfig(2, 0x0BU);
  delayMicroseconds(200);
  htrcFastSetConfig(2, 0x00U);
  return true;
}

void ARDUINO_ISR_ATTR captureTagEdge() {
  if (!gTagCaptureActive) {
    return;
  }
  const std::uint16_t index = gTagEdgeCount;
  if (index >= kTagMaximumEdges) {
    gTagCaptureOverflow = true;
    return;
  }
  gTagEdges[index].elapsed_us = micros() - gTagCaptureStartUs;
  gTagEdges[index].level = static_cast<std::uint8_t>(
      gpio_get_level(static_cast<gpio_num_t>(kRfidDataOutPin)) != 0 ? 1U : 0U);
  gTagEdgeCount = static_cast<std::uint16_t>(index + 1U);
}

bool verifyHtrcDigitalLink() {
  if (!forceHtrcTransmitterOff()) {
    return false;
  }
  const std::uint8_t original =
      static_cast<std::uint8_t>(htrcGetSampling() & 0x3FU);
  constexpr std::uint8_t kPattern = 0x2AU;
  htrcSetSampling(kPattern);
  const std::uint8_t pattern = htrcGetSampling();
  htrcSetSampling(original);
  const std::uint8_t restored = htrcGetSampling();
  return (pattern & 0x3FU) == kPattern &&
         (restored & 0x3FU) == original;
}

void printDisplayOrientation() {
  Serial.printf("[DISPLAY-ORIENTATION] rotation=%u degrees=%u width=%u height=%u canvas_rotation=%u footer_rotation=%u\r\n",
                static_cast<unsigned>(gDisplay.getRotation()),
                static_cast<unsigned>(gDisplay.getRotation()) * 90U,
                static_cast<unsigned>(gDisplay.width()),
                static_cast<unsigned>(gDisplay.height()),
                static_cast<unsigned>(gPageCanvas.getRotation()),
                static_cast<unsigned>(gFooterCanvas.getRotation()));
}

void initializeDisplay() {
  if (gSubmittedFrame == nullptr && gPageCanvas.allocate()) {
    gSubmittedFrame = static_cast<std::uint16_t *>(heap_caps_malloc(
        kDisplayWidth * kDisplayHeight * sizeof(std::uint16_t),
        MALLOC_CAP_SPIRAM | MALLOC_CAP_8BIT));
    if (gSubmittedFrame == nullptr) gPageCanvas.release();
  }
  gSubmittedFrameValid = false;
  // Only the controller rotates pixels. Rotating either canvas as well would
  // cancel the 180-degree turn for buffered pages or just their footer.
  gPageCanvas.setRotation(0);
  gFooterCanvas.setRotation(0);
  gPageCanvas.setTextWrap(false);
  Serial.printf("[DISPLAY] renderer=%s psram_free=%u internal_free=%u\r\n",
                gSubmittedFrame != nullptr ? "PSRAM_DIFF" : "DIRECT_FALLBACK",
                static_cast<unsigned>(heap_caps_get_free_size(MALLOC_CAP_SPIRAM)),
                static_cast<unsigned>(heap_caps_get_free_size(MALLOC_CAP_INTERNAL)));
  gDisplaySpi.begin(kLcdClockPin, kNoMisoPin, kLcdMosiPin, kLcdChipSelectPin);
  gDisplay.init(kDisplayWidth, kDisplayHeight, SPI_MODE0);
  Serial.printf("[DISPLAY] init_spi_hz=%u\r\n",
                spiClockDivToFrequency(gDisplaySpi.getClockDivider()));
  // MADCTL is controller configuration too: write it at the safe init rate,
  // before restoring the chosen normal or bounded experiment transfer rate.
  gDisplay.setRotation(kDisplayRotation);
  gDisplay.setSPISpeed(gDisplayClockHz);
  gDisplay.setTextWrap(false);
  gDisplay.fillScreen(ST77XX_BLACK);
  analogWrite(kLcdBacklightPin, gBacklightDuty);
  gDisplayReady = true;
  printDisplayOrientation();
}

void recoverDisplayController() {
  Serial.println(F("[DISPLAY] reinitializing ST7789 controller"));
  analogWrite(kLcdBacklightPin, 0);
  gDisplayReady = false;
  gDisplaySpi.end();
  delay(20);
  initializeDisplay();
}

bool inaWrite(std::uint8_t reg, std::uint16_t value) {
  Wire.beginTransmission(kIna226Address);
  Wire.write(reg);
  Wire.write(static_cast<std::uint8_t>(value >> 8U));
  Wire.write(static_cast<std::uint8_t>(value));
  return Wire.endTransmission() == 0;
}

bool inaRead(std::uint8_t reg, std::uint16_t &value) {
  Wire.beginTransmission(kIna226Address);
  Wire.write(reg);
  if (Wire.endTransmission(false) != 0 ||
      Wire.requestFrom(kIna226Address, static_cast<std::uint8_t>(2)) != 2) {
    return false;
  }
  value = static_cast<std::uint16_t>(Wire.read()) << 8U;
  value |= static_cast<std::uint16_t>(Wire.read());
  return true;
}

void initializePowerMonitor() {
  Wire.begin(kCurrentSdaPin, kCurrentSclPin, 400000U);
  delay(5);
  Wire.beginTransmission(kIna226Address);
  gPower.present = Wire.endTransmission() == 0;
  if (!gPower.present) {
    Serial.println(F("[INA226] not found at 0x40"));
    return;
  }
  std::uint16_t calibration = 0;
  const bool ids_ok = inaRead(kInaRegManufacturerId, gPower.manufacturer_id) &&
                      inaRead(kInaRegDieId, gPower.die_id);
  gPower.configured = ids_ok && gPower.manufacturer_id == 0x5449U &&
                      (gPower.die_id & 0xFFF0U) == 0x2260U &&
                      inaWrite(kInaRegConfig, kInaConfig) &&
                      inaWrite(kInaRegCalibration, kInaCalibration) &&
                      inaRead(kInaRegCalibration, calibration) &&
                      calibration == kInaCalibration;
  Serial.printf("[INA226] manufacturer=0x%04X die=0x%04X calibration=%s\r\n",
                gPower.manufacturer_id, gPower.die_id,
                gPower.configured ? "OK" : "FAIL");
}

void samplePower() {
  if (!gPower.configured) {
    gPower.valid = false;
    return;
  }
  std::uint16_t bus = 0;
  std::uint16_t shunt = 0;
  std::uint16_t current = 0;
  std::uint16_t power = 0;
  if (!inaRead(kInaRegBusVoltage, bus) || !inaRead(kInaRegShuntVoltage, shunt) ||
      !inaRead(kInaRegCurrent, current) || !inaRead(kInaRegPower, power)) {
    gPower.valid = false;
    return;
  }
  gPower.bus_voltage_v = static_cast<float>(bus) * 0.00125F;
  gPower.current_ma = static_cast<float>(static_cast<std::int16_t>(current)) * 0.1F;
  gPower.power_mw = static_cast<float>(power) * 2.5F;
  gPower.peak_current_ma = std::max(gPower.peak_current_ma, gPower.current_ma);
  gPower.valid = true;
  (void)shunt;
}

bool tagPowerSafe(const PowerReading &reading, float baseline_current_ma) {
  return reading.valid && reading.bus_voltage_v >= kTagMinimumBusVoltageV &&
         reading.current_ma <= kTagMaximumTotalCurrentMa &&
         reading.current_ma - baseline_current_ma <=
             kTagMaximumCurrentIncreaseMa;
}

rfid_diagnostics::Record rfidPowerRecord(const char *stage,
                                        const PowerReading &power,
                                        float baseline) {
  rfid_diagnostics::Record record;
  record.stage = stage;
  record.power_valid = power.valid;
  record.ina_configured = power.configured;
  record.voltage = power.bus_voltage_v;
  record.current = power.current_ma;
  record.baseline = baseline;
  return record;
}

// All diagnostic records, including inventory raw captures, are buffered until
// the scan has returned through its existing transmitter-off path. Never print
// during an RF field window, since serial backpressure would change its length.
struct RfidTraceScope {
  explicit RfidTraceScope(bool one_shot = false) {
    gRfidDiagnostics.begin(millis(), one_shot);
  }
  ~RfidTraceScope() {
    if (!gRfidDiagnostics.capturing()) return;
    Serial.printf("[RFID-DIAG] schema=1 trace=%lu rows=%u dropped=%u final_off=%d unknown=-1\r\n",
                  static_cast<unsigned long>(gRfidDiagnostics.sequence()),
                  static_cast<unsigned>(gRfidDiagnostics.size()),
                  static_cast<unsigned>(gRfidDiagnostics.dropped()),
                  gHtrcTransmitterSafe);
    for (std::size_t index = 0; index < gRfidDiagnostics.size(); ++index) {
      const auto &r = gRfidDiagnostics.at(index);
      Serial.printf("[RFID-DIAG] row=%u stage=%s digital=%d config=%d sampling_ok=%d antenna=%d off=%d overflow=%d safe=%d sample=%d field_ms=%d\r\n",
                    static_cast<unsigned>(index), r.stage, r.digital, r.config,
                    r.sampling_ok, r.antenna, r.field_off, r.overflow, r.safe,
                    r.sampling, r.field_ms);
      if (r.page_mask != 0)
        Serial.printf("[RFID-DIAG] row=%u page_mask=%02X pages=%02X,%02X,%02X,%02X\r\n",
                      static_cast<unsigned>(index), r.page_mask,
                      r.pages[0], r.pages[1], r.pages[2], r.pages[3]);
      if (r.power_valid != -1)
        Serial.printf("[RFID-DIAG] row=%u ina_configured=%d ina_valid=%d voltage=%.3f current=%.1f baseline=%.1f delta=%.1f\r\n",
                      static_cast<unsigned>(index), r.ina_configured, r.power_valid,
                      r.voltage, r.current, r.baseline, r.current - r.baseline);
      if (r.decode != -1 || r.overflow != -1)
        Serial.printf("[RFID-DIAG] row=%u edges=%u pulses=%u first_us=%lu decode=%d bits=%u collision=%u uid=%s\r\n",
                      static_cast<unsigned>(index), r.edges, r.pulses,
                      static_cast<unsigned long>(r.first_edge_us),
                      r.decode, r.bits, r.collision, r.uid);
    }
    gRfidDiagnostics.finish();
  }
};

void recordRfidRaw(const char *stage, std::uint8_t sampling,
                   const TagResponseCapture &capture) {
  rfid_diagnostics::Record record;
  record.stage = stage;
  record.sampling = sampling;
  record.overflow = capture.overflow;
  record.edges = capture.edge_count;
  record.pulses = capture.pulse_count;
  record.first_edge_us = capture.first_edge_us;
  record.decode = static_cast<int>(capture.decoded.status);
  record.bits = capture.decoded.decoded_bits;
  record.collision = capture.decoded.collision_bit;
  gRfidDiagnostics.add(record);
}

bool prepareHitagReader(const PowerReading &baseline, std::uint8_t &sampling,
                       rfid_diagnostics::AntennaPolicy policy = rfid_diagnostics::AntennaPolicy::Strict,
                       std::uint32_t *probe_field_ms = nullptr) {
  htrcSetConfig(3, kHtrcClockPage3);
  htrcSetConfig(0, kHtrcReceiverPage0);
  htrcSetConfig(2, 0x00U);
  htrcSetConfig(1, kHtrcFieldOnPage1);
  const std::uint32_t diagnostic_field_started = millis();
  gHtrcTransmitterSafe = false;
  delayMicroseconds(200);

  const std::uint8_t page0 = htrcGetConfig(0);
  const std::uint8_t page1 = htrcGetConfig(1);
  const std::uint8_t page2 = htrcGetConfig(2);
  const std::uint8_t page3 = htrcGetConfig(3);
  const bool config_ok = (page0 & 0x0FU) == kHtrcReceiverPage0 &&
                         (page1 & 0x0FU) == kHtrcFieldOnPage1 &&
                         (page2 & 0x0FU) == 0x00U &&
                         (page3 & 0x0FU) == kHtrcClockPage3;
  const bool antenna_ok = ((page2 | page3) & kHtrcAntFailMask) == 0U;
  rfid_diagnostics::Record config_record;
  config_record.stage = "prepare_config";
  config_record.config = config_ok;
  config_record.antenna = antenna_ok;
  config_record.page_mask = 0x0FU;
  config_record.pages[0] = page0;
  config_record.pages[1] = page1;
  config_record.pages[2] = page2;
  config_record.pages[3] = page3;
  if (!config_ok || !rfid_diagnostics::antennaAccepted(antenna_ok, policy)) {
    gHtrcTransmitterSafe = forceHtrcTransmitterOff();
    config_record.field_off = gHtrcTransmitterSafe;
    config_record.field_ms = millis() - diagnostic_field_started;
    if (probe_field_ms != nullptr) *probe_field_ms = config_record.field_ms;
    config_record.safe = false;
    gRfidDiagnostics.add(config_record);
    return false;
  }
  gRfidDiagnostics.add(config_record);

  std::uint16_t phase_sum = 0;
  constexpr std::uint8_t kPhaseSamples = 8;
  for (std::uint8_t index = 0; index < kPhaseSamples; ++index) {
    phase_sum = static_cast<std::uint16_t>(phase_sum + htrcReadPhase());
  }
  const std::uint8_t phase = static_cast<std::uint8_t>(
      (phase_sum + kPhaseSamples / 2U) / kPhaseSamples);
  sampling = static_cast<std::uint8_t>(
      ((static_cast<std::uint16_t>(phase) * 2U) + 0x3FU) & 0x3FU);
  htrcSetSampling(sampling);
  const bool sampling_ok = (htrcGetSampling() & 0x3FU) == sampling;

  htrcSetConfig(2, 0x0BU);
  delay(4);
  htrcSetConfig(2, 0x08U);
  delay(1);
  htrcSetConfig(2, 0x00U);
  // INA226 0x0527: nominal 35.2ms averaged conversion. Only the explicit
  // probe adds settling time; normal scan timing remains unchanged.
  if (policy == rfid_diagnostics::AntennaPolicy::ProbeOnce) delay(80);
  const std::uint8_t settled_page2 = htrcGetConfig(2);
  samplePower();
  const PowerReading field_power = gPower;
  const bool settled_ok = sampling_ok &&
                          rfid_diagnostics::antennaAccepted(
                              (settled_page2 & kHtrcAntFailMask) == 0U, policy) &&
                          (settled_page2 & 0x0FU) == 0x00U;
  gHtrcTransmitterSafe = forceHtrcTransmitterOff();
  auto settled_record = rfidPowerRecord("prepare_settled", field_power,
                                       baseline.current_ma);
  settled_record.sampling = sampling;
  settled_record.sampling_ok = sampling_ok;
  settled_record.page_mask = 0x04U;
  settled_record.pages[2] = settled_page2;
  settled_record.config = (settled_page2 & 0x0FU) == 0U;
  settled_record.antenna = (settled_page2 & kHtrcAntFailMask) == 0U;
  settled_record.field_off = gHtrcTransmitterSafe;
  settled_record.field_ms = millis() - diagnostic_field_started;
  if (probe_field_ms != nullptr) *probe_field_ms = settled_record.field_ms;
  const bool probe_time_ok = policy == rfid_diagnostics::AntennaPolicy::Strict ||
                            settled_record.field_ms <= static_cast<int>(kTagMaximumFieldMs);
  settled_record.safe = settled_ok && tagPowerSafe(field_power, baseline.current_ma) &&
                        gHtrcTransmitterSafe && probe_time_ok;
  gRfidDiagnostics.add(settled_record);
  if (!settled_ok || !tagPowerSafe(field_power, baseline.current_ma) ||
      !gHtrcTransmitterSafe || !probe_time_ok) {
    return false;
  }

  const bool pulse_width_ok =
      htrcProgramWritePulseWidth(kHitagWritePulseCycles);
  rfid_diagnostics::Record pulse_record;
  pulse_record.stage = "prepare_pulse";
  pulse_record.config = pulse_width_ok;
  gRfidDiagnostics.add(pulse_record);
  delay(kHitagFieldResetMs);
  return pulse_width_ok;
}

TagResponseCapture captureHitagResponse(std::uint8_t expected_bits) {
  TagResponseCapture response;
  if (expected_bits == 0U || expected_bits > 32U) {
    return response;
  }
  gTagCaptureActive = false;
  gTagEdgeCount = 0;
  gTagCaptureOverflow = false;
  attachInterrupt(digitalPinToInterrupt(kRfidDataOutPin), captureTagEdge,
                  CHANGE);
  gTagCaptureStartUs = micros();
  gTagCaptureActive = true;
  htrcEnterReadTag();
  const std::uint32_t capture_ms = expected_bits == 32U
                                       ? kTagCaptureMs
                                       : 6U + (expected_bits + 1U) / 2U;
  delay(capture_ms);
  const std::uint32_t capture_ended_us = micros() - gTagCaptureStartUs;
  gTagCaptureActive = false;
  detachInterrupt(digitalPinToInterrupt(kRfidDataOutPin));
  htrcFastExitMode();

  response.overflow = gTagCaptureOverflow;
  static hitag_s::Pulse pulses[kTagMaximumEdges]{};
  std::size_t pulse_count = 0;
  const std::uint16_t edge_count = gTagEdgeCount;
  response.edge_count = edge_count;
  response.first_edge_us = edge_count == 0U ? 0U : gTagEdges[0].elapsed_us;
  for (std::uint16_t index = 0;
       index + 1U < edge_count && pulse_count < kTagMaximumEdges; ++index) {
    const std::uint32_t duration =
        gTagEdges[index + 1U].elapsed_us - gTagEdges[index].elapsed_us;
    if (duration != 0U && duration <= 0xFFFFU) {
      pulses[pulse_count++] = {
          static_cast<std::uint16_t>(duration),
          gTagEdges[index].level != 0U};
    }
  }
  if (edge_count != 0U && pulse_count < kTagMaximumEdges) {
    const std::uint32_t duration =
        capture_ended_us - gTagEdges[edge_count - 1U].elapsed_us;
    if (duration != 0U && duration <= 0xFFFFU) {
      pulses[pulse_count++] = {
          static_cast<std::uint16_t>(duration),
          gTagEdges[edge_count - 1U].level != 0U};
    }
  }
  if (!response.overflow) {
    response.pulse_count = static_cast<std::uint16_t>(pulse_count);
    response.decoded =
        hitag_s::decodeAdvancedBits(pulses, pulse_count, expected_bits);
  }
  return response;
}

TagAttempt captureHitagAttempt(const PowerReading &baseline,
                               std::uint8_t sampling,
                               rfid_diagnostics::AntennaPolicy policy = rfid_diagnostics::AntennaPolicy::Strict) {
  TagAttempt attempt;
  htrcSetSampling(sampling);
  const std::uint8_t actual_sampling = htrcGetSampling();
  if ((actual_sampling & 0x3FU) != sampling) {
    attempt.field_off_ok = forceHtrcTransmitterOff();
    gHtrcTransmitterSafe = attempt.field_off_ok;
    rfid_diagnostics::Record record;
    record.stage = "capture_sampling";
    record.sampling = actual_sampling;
    record.sampling_ok = false;
    record.field_off = attempt.field_off_ok;
    gRfidDiagnostics.add(record);
    return attempt;
  }

  htrcSetConfig(1, kHtrcFieldOnPage1);
  gHtrcTransmitterSafe = false;
  const std::uint32_t field_started_us = micros();
  const std::uint32_t field_started_ms = millis();
  const std::uint8_t field_page1 = htrcGetConfig(1);
  if ((field_page1 & 0x0FU) != kHtrcFieldOnPage1) {
    attempt.field_off_ok = forceHtrcTransmitterOff();
    gHtrcTransmitterSafe = attempt.field_off_ok;
    rfid_diagnostics::Record record;
    record.stage = "capture_field";
    record.config = false;
    record.page_mask = 0x02U;
    record.pages[1] = field_page1;
    record.field_off = attempt.field_off_ok;
    record.field_ms = millis() - field_started_ms;
    attempt.field_duration_ms = record.field_ms;
    gRfidDiagnostics.add(record);
    return attempt;
  }

  htrcSendHitagUidRequest(field_started_us);
  gTagCaptureActive = false;
  gTagEdgeCount = 0;
  gTagCaptureOverflow = false;
  attachInterrupt(digitalPinToInterrupt(kRfidDataOutPin), captureTagEdge,
                  CHANGE);
  gTagCaptureStartUs = micros();
  gTagCaptureActive = true;
  htrcEnterReadTag();
  delay(kTagCaptureMs);
  const std::uint32_t capture_ended_us = micros() - gTagCaptureStartUs;
  gTagCaptureActive = false;
  detachInterrupt(digitalPinToInterrupt(kRfidDataOutPin));
  htrcFastExitMode();

  attempt.overflow = gTagCaptureOverflow;
  if (policy == rfid_diagnostics::AntennaPolicy::ProbeOnce && !attempt.overflow) {
    const auto elapsed = static_cast<std::uint32_t>(millis() - field_started_ms);
    if (elapsed < 80U) delay(80U - elapsed);
  }
  samplePower();
  const PowerReading field_power = gPower;
  const std::uint8_t final_page2 = htrcGetConfig(2);
  const bool antenna_ok = (final_page2 & kHtrcAntFailMask) == 0U &&
                          (final_page2 & 0x0FU) == 0x00U;
  attempt.field_off_ok = forceHtrcTransmitterOff();
  gHtrcTransmitterSafe = attempt.field_off_ok;
  const std::uint32_t field_duration_ms = millis() - field_started_ms;
  attempt.field_duration_ms = field_duration_ms;

  static hitag_s::Pulse pulses[kTagMaximumEdges]{};
  std::size_t pulse_count = 0;
  const std::uint16_t edge_count = gTagEdgeCount;
  attempt.edge_count = edge_count;
  attempt.first_edge_us = edge_count == 0U ? 0U : gTagEdges[0].elapsed_us;
  for (std::uint16_t index = 0;
       index + 1U < edge_count && pulse_count < kTagMaximumEdges; ++index) {
    const std::uint32_t duration =
        gTagEdges[index + 1U].elapsed_us - gTagEdges[index].elapsed_us;
    if (duration != 0U && duration <= 0xFFFFU) {
      pulses[pulse_count++] = {
          static_cast<std::uint16_t>(duration),
          gTagEdges[index].level != 0U};
    }
  }
  // Preserve the final AC2K run when it shares a level with receiver idle.
  if (edge_count != 0U && pulse_count < kTagMaximumEdges) {
    const std::uint32_t duration =
        capture_ended_us - gTagEdges[edge_count - 1U].elapsed_us;
    if (duration != 0U && duration <= 0xFFFFU) {
      pulses[pulse_count++] = {
          static_cast<std::uint16_t>(duration),
          gTagEdges[edge_count - 1U].level != 0U};
    }
  }

  attempt.safety_ok = rfid_diagnostics::captureAccepted(
      (final_page2 & 0x0FU) == 0U, antenna_ok,
      tagPowerSafe(field_power, baseline.current_ma), attempt.overflow,
      attempt.field_off_ok, field_duration_ms, policy);
  if (attempt.safety_ok) {
    attempt.pulse_count = static_cast<std::uint16_t>(pulse_count);
    attempt.decoded = hitag_s::decodeAdvancedUid(pulses, pulse_count);
  }
  auto record = rfidPowerRecord("capture_result", field_power, baseline.current_ma);
  record.sampling = sampling;
  record.sampling_ok = true;
  record.page_mask = 0x06U;
  record.pages[1] = field_page1;
  record.pages[2] = final_page2;
  record.config = (final_page2 & 0x0FU) == 0U;
  record.antenna = (final_page2 & kHtrcAntFailMask) == 0U;
  record.field_off = attempt.field_off_ok;
  record.field_ms = field_duration_ms;
  record.overflow = attempt.overflow;
  record.safe = attempt.safety_ok;
  record.edges = edge_count;
  record.pulses = static_cast<std::uint16_t>(pulse_count);
  record.first_edge_us = attempt.first_edge_us;
  // Unsafe captures are never decoded; -1 distinguishes that from NoResponse.
  record.decode = attempt.safety_ok ? static_cast<int>(attempt.decoded.status) : -1;
  record.bits = attempt.decoded.decoded_bits;
  record.collision = attempt.decoded.collision_bit;
  if (attempt.safety_ok && attempt.decoded.status == hitag_s::DecodeStatus::Present)
    hitag_s::formatUid(attempt.decoded.uid, record.uid);
  gRfidDiagnostics.add(record);
  return attempt;
}

void runRfidProbeOnce() {
  using rfid_diagnostics::AntennaPolicy;
  const std::uint32_t started = millis();
  if (!gRfidProbeBudget.claim(started)) {
    Serial.println(F("[RFID-PROBE] rejected=COOLDOWN cooldown_ms=60000 normal_mode=STRICT"));
    return;
  }
  const RfidTraceScope diagnostic_scope(true);
  hitag_s::Uid candidate{};
  unsigned confirmations = 0;
  bool confirmed = false;
  std::uint32_t previous_field_ms = 0;
  const auto perform = [&]() -> const char * {
    gHtrcTransmitterSafe = forceHtrcTransmitterOff();
    if (!gHtrcTransmitterSafe) return "INITIAL_OFF_FAILED";
    delay(80);  // Probe-only settled off baseline for the averaged INA reading.
    samplePower();
    const PowerReading baseline = gPower;
    const bool digital_ok = verifyHtrcDigitalLink();
    auto entry = rfidPowerRecord("probe_entry", baseline, baseline.current_ma);
    entry.digital = digital_ok;
    entry.safe = digital_ok && tagPowerSafe(baseline, baseline.current_ma);
    gRfidDiagnostics.add(entry);
    if (!entry.safe) return "ENTRY_UNSAFE";
    std::uint8_t sampling = 0;
    if (!prepareHitagReader(baseline, sampling, AntennaPolicy::ProbeOnce,
                            &previous_field_ms)) return "PREPARE_UNSAFE";
    const std::uint8_t samples[] = {
        sampling, static_cast<std::uint8_t>((sampling + 8U) & 0x3FU),
        static_cast<std::uint8_t>((sampling - 8U) & 0x3FU)};
    std::uint8_t selected_sampling = sampling;
    for (unsigned index = 0; index < rfid_diagnostics::ProbeBudget::kMaximumAttempts; ++index) {
      const auto rest = rfid_diagnostics::ProbeBudget::restMs(previous_field_ms);
      if (!gRfidProbeBudget.hasTime(millis(), rest + kTagMaximumFieldMs)) return "TIME_BUDGET";
      delay(rest);
      // Refresh baseline only while off and after the conservative rest period.
      samplePower();
      const PowerReading current_baseline = gPower;
      if (!tagPowerSafe(current_baseline, current_baseline.current_ma)) {
        auto record = rfidPowerRecord("probe_baseline_unsafe", current_baseline,
                                      current_baseline.current_ma);
        record.safe = false;
        gRfidDiagnostics.add(record);
        return "BASELINE_UNSAFE";
      }
      if (confirmations == 0) selected_sampling = samples[index % 3U];
      if (!gRfidProbeBudget.next(millis())) return "TIME_BUDGET";
      const TagAttempt attempt = captureHitagAttempt(
          current_baseline, selected_sampling, AntennaPolicy::ProbeOnce);
      previous_field_ms = attempt.field_duration_ms;
      if (!attempt.safety_ok || !gHtrcTransmitterSafe) return "CAPTURE_UNSAFE";
      if (attempt.decoded.status == hitag_s::DecodeStatus::Present &&
          hitag_s::hasHitagSProductIdentifier(attempt.decoded.uid)) {
        if (confirmations != 0 && !hitag_s::equalUid(candidate, attempt.decoded.uid))
          return "UID_MISMATCH";
        candidate = attempt.decoded.uid;
        if (++confirmations == 3) { confirmed = true; return "UID_CONFIRMED"; }
      }
    }
    return "ATTEMPT_LIMIT";
  };
  const char *reason = perform();
  // No publication or cached Tag/sampling updates anywhere in this path.
  // Every lambda return reaches this cleanup, including all safety failures.
  gHtrcTransmitterSafe = forceHtrcTransmitterOff();
  if (!gHtrcTransmitterSafe) { confirmed = false; reason = "FINAL_OFF_FAILED"; }
  // Include a final off interval before the normal scan can run again. The
  // 6s work budget excludes this off-only cooldown (150..1400ms for fields
  // within the 350ms guard; preserve fourfold rest even on an overrun).
  delay(rfid_diagnostics::ProbeBudget::restMs(previous_field_ms));
  gRfidProbeBudget.finish();
  char uid[9] = "--------";
  if (confirmed) hitag_s::formatUid(candidate, uid);
  Serial.printf("[RFID-PROBE] complete reason=%s attempts=%u confirmed=%d confirmations=%u uid=%s off=%d elapsed_ms=%lu published=NO normal_mode=STRICT\r\n",
                reason, gRfidProbeBudget.attempts(), confirmed, confirmations,
                uid, gHtrcTransmitterSafe,
                static_cast<unsigned long>(millis() - started));
  Serial.println(F("[RFID-PROBE] work_budget_ms=6000 baseline_off_wait_ms=80 prepare_extra_wait_ms=80 capture_field_min_ms=80 INA_average_nominal_ms=35.2 coil_peak=UNMEASURED"));
}

TagInventoryAttempt enumerateHitagTags(const PowerReading &baseline,
                                       std::uint8_t sampling) {
  TagInventoryAttempt attempt;
  htrcSetSampling(sampling);
  const std::uint8_t actual_sampling = htrcGetSampling();
  if ((actual_sampling & 0x3FU) != sampling) {
    attempt.field_off_ok = forceHtrcTransmitterOff();
    gHtrcTransmitterSafe = attempt.field_off_ok;
    rfid_diagnostics::Record record;
    record.stage = "inventory_sampling";
    record.sampling = actual_sampling;
    record.sampling_ok = false;
    record.field_off = attempt.field_off_ok;
    gRfidDiagnostics.add(record);
    return attempt;
  }

  htrcSetConfig(1, kHtrcFieldOnPage1);
  gHtrcTransmitterSafe = false;
  const std::uint32_t field_started_us = micros();
  const std::uint32_t field_started_ms = millis();
  const std::uint8_t field_page1 = htrcGetConfig(1);
  if ((field_page1 & 0x0FU) != kHtrcFieldOnPage1) {
    attempt.field_off_ok = forceHtrcTransmitterOff();
    gHtrcTransmitterSafe = attempt.field_off_ok;
    rfid_diagnostics::Record record;
    record.stage = "inventory_field";
    record.config = false;
    record.page_mask = 0x02U;
    record.pages[1] = field_page1;
    record.field_off = attempt.field_off_ok;
    record.field_ms = millis() - field_started_ms;
    gRfidDiagnostics.add(record);
    return attempt;
  }

  static hitag_s::UidPrefix prefixes[kTagInventoryPrefixCapacity]{};
  std::size_t prefix_count = 0;
  const auto add_full_uid = [&](const hitag_s::Uid &uid) {
    if (hitag_s::hasHitagSProductIdentifier(uid)) {
      (void)hitag_s::addUniqueUid(attempt.tags, uid);
    } else {
      attempt.incomplete = true;
    }
  };
  const auto branch_collision = [&](const hitag_s::UidPrefix &base,
                                    const hitag_s::DecodeResult &collision) {
    for (int branch = 1; branch >= 0; --branch) {
      hitag_s::UidPrefix extended;
      if (!hitag_s::extendPrefix(base, collision.uid,
                                 collision.collision_bit,
                                 static_cast<std::uint8_t>(branch),
                                 extended)) {
        attempt.incomplete = true;
        continue;
      }
      if (extended.bit_count == 32U) {
        add_full_uid(extended.uid);
      } else if (prefix_count < kTagInventoryPrefixCapacity) {
        prefixes[prefix_count++] = extended;
      } else {
        attempt.incomplete = true;
      }
    }
  };

  if (!htrcSendHitagUidRequest(field_started_us)) {
    attempt.incomplete = true;
  } else {
    ++attempt.commands;
    const TagResponseCapture root = captureHitagResponse(32U);
    recordRfidRaw("inventory_root", sampling, root);
    attempt.overflow = root.overflow;
    const hitag_s::UidPrefix empty_prefix{};
    if (root.decoded.status == hitag_s::DecodeStatus::Present) {
      add_full_uid(root.decoded.uid);
    } else if (root.decoded.status == hitag_s::DecodeStatus::Collision) {
      branch_collision(empty_prefix, root.decoded);
    } else if (root.decoded.status == hitag_s::DecodeStatus::Ambiguous) {
      attempt.incomplete = true;
    }
  }

  while (prefix_count != 0U && !attempt.overflow &&
         !attempt.tags.overflow) {
    if (static_cast<std::uint32_t>(millis() - field_started_ms) >=
        kTagInventoryWorkBudgetMs) {
      attempt.incomplete = true;
      break;
    }
    const hitag_s::UidPrefix prefix = prefixes[--prefix_count];
    hitag_s::BitBuffer command;
    if (!hitag_s::buildAnticollisionCommand(prefix, command)) {
      attempt.incomplete = true;
      break;
    }
    const std::uint32_t boundary = micros() + kTagInventoryCommandGuardUs;
    if (!htrcSendHitagFrame(command.bytes, command.bit_count, boundary)) {
      attempt.incomplete = true;
      break;
    }
    ++attempt.commands;
    const std::uint8_t remaining_bits =
        static_cast<std::uint8_t>(32U - prefix.bit_count);
    const TagResponseCapture response =
        captureHitagResponse(remaining_bits);
    recordRfidRaw("inventory_ac", sampling, response);
    attempt.overflow = attempt.overflow || response.overflow;
    if (response.decoded.status == hitag_s::DecodeStatus::Present) {
      add_full_uid(hitag_s::combinePrefixAndSuffix(
          prefix, response.decoded.uid, remaining_bits));
    } else if (response.decoded.status == hitag_s::DecodeStatus::Collision) {
      branch_collision(prefix, response.decoded);
    } else if (response.decoded.status == hitag_s::DecodeStatus::Ambiguous) {
      attempt.incomplete = true;
    }
  }
  if (prefix_count != 0U) {
    attempt.incomplete = true;
  }

  samplePower();
  const PowerReading field_power = gPower;
  const std::uint8_t final_page2 = htrcGetConfig(2);
  const bool antenna_ok = (final_page2 & kHtrcAntFailMask) == 0U &&
                          (final_page2 & 0x0FU) == 0x00U;
  attempt.antenna_ok = antenna_ok;
  attempt.field_voltage_v = field_power.bus_voltage_v;
  attempt.field_current_ma = field_power.current_ma;
  attempt.baseline_current_ma = baseline.current_ma;
  attempt.field_off_ok = forceHtrcTransmitterOff();
  gHtrcTransmitterSafe = attempt.field_off_ok;
  const std::uint32_t field_duration_ms = millis() - field_started_ms;
  attempt.field_duration_ms = field_duration_ms;
  attempt.safety_ok = !attempt.overflow && antenna_ok &&
                      attempt.field_off_ok &&
                      field_duration_ms <= kTagMaximumFieldMs &&
                      tagPowerSafe(field_power, baseline.current_ma);
  auto record = rfidPowerRecord("inventory_result", field_power, baseline.current_ma);
  record.sampling = sampling;
  record.sampling_ok = true;
  record.page_mask = 0x06U;
  record.pages[1] = field_page1;
  record.pages[2] = final_page2;
  record.config = (final_page2 & 0x0FU) == 0U;
  record.antenna = (final_page2 & kHtrcAntFailMask) == 0U;
  record.field_off = attempt.field_off_ok;
  record.field_ms = field_duration_ms;
  record.overflow = attempt.overflow;
  record.safe = attempt.safety_ok;
  gRfidDiagnostics.add(record);
  return attempt;
}

TileTagReaderState networkTagReaderState(TagStatus status) {
  switch (status) {
    case TagStatus::Present:
    case TagStatus::NoTag:
      return TileTagReaderState::Stable;
    case TagStatus::Fault:
      return TileTagReaderState::Fault;
    case TagStatus::Scanning:
    case TagStatus::Unstable:
      return TileTagReaderState::Scanning;
  }
  return TileTagReaderState::Fault;
}

void publishPendingTagObservation() {
  if (gTagNetworkPublishPending &&
      gNetwork.updateTagObservation(networkTagReaderState(gTagStatus),
                                    gTagUids, gConfirmedTagCount,
                                    gConfirmedTagOverflow, gTagScanEvidence)) {
    gTagNetworkPublishPending = false;
  }
}

void recordTagScan(bool complete) {
  if (++gTagScanEvidence.sequence == 0) ++gTagScanEvidence.sequence;
  gTagScanEvidence.completed_ms = millis();
  gTagScanEvidence.pairing_room_id = gScanPairingRoom;
  gTagScanEvidence.pairing_session_id = gScanPairingSession;
  gTagScanEvidence.complete = complete;
  gTagNetworkPublishPending = true;
}

void publishTagInventory(TagStatus status, const hitag_s::UidSet *tags,
                         std::uint8_t sampling,
                         std::uint8_t confirmations) {
  recordTagScan(false);
  // An incomplete collision tree is only an internal sample result. Keep the
  // last stable PRESENT/NO TAG state so the public UI never sticks on
  // UNSTABLE while the next clean scan is already pending.
  if (status == TagStatus::Unstable &&
      (gTagStatus == TagStatus::Present ||
       gTagStatus == TagStatus::NoTag)) {
    return;
  }

  hitag_s::UidSet filtered;
  const hitag_s::UidSet *effective_tags = tags;
  TagStatus effective_status = status;
  if (gTagStatus == TagStatus::Present && gConfirmedTagCount != 0U) {
    const bool reports_tags =
        status == TagStatus::Present && tags != nullptr && tags->count != 0U;
    bool loses_confirmed_uid = false;
    bool removal_confirmed = false;
    for (std::size_t index = 0; index < gConfirmedTagCount; ++index) {
      const bool observed =
          reports_tags && hitag_s::containsUid(*tags, gConfirmedTagUids[index]);
      loses_confirmed_uid = loses_confirmed_uid || !observed;
      gTagMissingEvidence[index] = tag_presence::updateMissingEvidence(
          gTagMissingEvidence[index], observed);
      removal_confirmed =
          removal_confirmed ||
          (!observed && tag_presence::removalConfirmed(
                            gTagMissingEvidence[index]));
    }
    if (loses_confirmed_uid && !removal_confirmed) {
      return;
    }
    if (loses_confirmed_uid) {
      // Remove only UIDs whose individual evidence crossed the threshold.
      // Another UID missed only in this scan remains in the stable set.
      for (std::size_t index = 0; index < gConfirmedTagCount; ++index) {
        if (!tag_presence::removalConfirmed(gTagMissingEvidence[index])) {
          (void)hitag_s::addUniqueUid(filtered, gConfirmedTagUids[index]);
        }
      }
      if (reports_tags) {
        for (std::size_t index = 0; index < tags->count; ++index) {
          (void)hitag_s::addUniqueUid(filtered, tags->uids[index]);
        }
        filtered.overflow = filtered.overflow || tags->overflow;
      }
      effective_status =
          filtered.count == 0U ? TagStatus::NoTag : TagStatus::Present;
      effective_tags = filtered.count == 0U ? nullptr : &filtered;
    }
  }

  std::uint8_t next_count = 0;
  bool next_overflow = false;
  if (effective_status == TagStatus::Present && effective_tags != nullptr &&
      effective_tags->count != 0U) {
    next_count = effective_tags->count;
    next_overflow = effective_tags->overflow;
  }
  // A retained UID awaiting removal evidence is display state, not fresh RF evidence.
  bool exact_inventory = effective_status == status;
  if (effective_tags != tags) exact_inventory = false;
  gTagScanEvidence.complete = exact_inventory && !next_overflow &&
      (status == TagStatus::Present || status == TagStatus::NoTag);
  bool changed = effective_status != gTagStatus ||
                 next_count != gConfirmedTagCount ||
                 next_overflow != gConfirmedTagOverflow;
  if (!changed) {
    for (std::size_t index = 0; index < next_count; ++index) {
      if (!hitag_s::equalUid(gConfirmedTagUids[index],
                             effective_tags->uids[index])) {
        changed = true;
        break;
      }
    }
  }
  if (!changed) {
    // The per-UID evidence was already advanced or recovered above. Do not
    // erase it just because the externally published set stayed the same.
    if (next_count != 0U) {
      gTagPreferredSampling = sampling;
      gTagPreferredSamplingValid = true;
    }
    return;
  }

  std::memset(gTagUids, 0, sizeof(gTagUids));
  std::memset(gTagMissingEvidence, 0, sizeof(gTagMissingEvidence));
  if (next_count != 0U) {
    gTagPreferredSampling = sampling;
    gTagPreferredSamplingValid = true;
    for (std::size_t index = 0; index < next_count; ++index) {
      gConfirmedTagUids[index] = effective_tags->uids[index];
      hitag_s::formatUid(effective_tags->uids[index], gTagUids[index]);
    }
  }
  gConfirmedTagCount = next_count;
  gConfirmedTagOverflow = next_overflow;
  gTagStatus = effective_status;
  if (changed) {
    // Local display state may advance even when the network mutex is busy.
    // Retry the latest complete inventory until it is accepted; an identical
    // later scan must not suppress a failed publication permanently.
    gTagNetworkPublishPending = true;
    publishPendingTagObservation();

    gTagUiDirty = true;
    const char *state = effective_status == TagStatus::Present
                            ? "PRESENT"
                            : effective_status == TagStatus::NoTag
                                  ? "NO_TAG"
                                  : effective_status == TagStatus::Unstable
                                        ? "UNSTABLE"
                                        : effective_status == TagStatus::Fault
                                              ? "FAULT"
                                              : "SCANNING";
    Serial.printf("[TAG] t=%lums state=%s type=HITAG_S256 count=%u%s uids=",
                  static_cast<unsigned long>(millis()), state,
                  static_cast<unsigned>(gConfirmedTagCount),
                  gConfirmedTagOverflow ? "+" : "");
    if (gConfirmedTagCount == 0U) {
      Serial.print(F("--------"));
    } else {
      for (std::size_t index = 0; index < gConfirmedTagCount; ++index) {
        Serial.printf("%s%s", index == 0U ? "" : ",", gTagUids[index]);
      }
    }
    Serial.printf(" consistent=%u sampling=0x%02X field_off=%s\r\n",
                  confirmations, sampling,
                  gHtrcTransmitterSafe ? "PASS" : "FAIL");
  }
}

void publishTagStatus(TagStatus status, const hitag_s::Uid *uid,
                      std::uint8_t sampling, std::uint8_t confirmations) {
  hitag_s::UidSet tags;
  if (status == TagStatus::Present && uid != nullptr) {
    (void)hitag_s::addUniqueUid(tags, *uid);
  }
  publishTagInventory(status, &tags, sampling, confirmations);
}

void scanHitagTag() {
  const RfidTraceScope diagnostic_scope;
  // Latch session at scan start. New HTTP pairing cannot bless an older cache.
  const bool pairing = pairingVisible(gNetworkSnapshot.pairing, millis());
  gScanPairingRoom = pairing ? gNetworkSnapshot.pairing.room_id : 0;
  gScanPairingSession = pairing ? gNetworkSnapshot.pairing.session_id : 0;
  samplePower();
  const PowerReading baseline = gPower;
  const bool digital_ok = verifyHtrcDigitalLink();
  auto entry_record = rfidPowerRecord("entry", baseline, baseline.current_ma);
  entry_record.digital = digital_ok;
  entry_record.safe = digital_ok && baseline.valid &&
                      baseline.bus_voltage_v >= kTagMinimumBusVoltageV &&
                      baseline.current_ma <= kTagMaximumTotalCurrentMa;
  gRfidDiagnostics.add(entry_record);
  if (!digital_ok || !baseline.valid ||
      baseline.bus_voltage_v < kTagMinimumBusVoltageV ||
      baseline.current_ma > kTagMaximumTotalCurrentMa) {
    gHtrcTransmitterSafe = forceHtrcTransmitterOff();
    publishTagStatus(TagStatus::Fault, nullptr, 0U, 0U);
    return;
  }

  std::uint8_t sampling = 0;
  if (!prepareHitagReader(baseline, sampling)) {
    publishTagStatus(TagStatus::Fault, nullptr, sampling, 0U);
    return;
  }

  const auto inventory_at_sampling = [&](std::uint8_t value) {
    hitag_s::UidSet combined;
    bool saw_incomplete = false;
    std::uint16_t command_count = 0;
    constexpr std::uint8_t kInventoryRounds = 3U;
    for (std::uint8_t round = 0; round < kInventoryRounds; ++round) {
      delay(kHitagFieldResetMs);
      const TagInventoryAttempt inventory =
          enumerateHitagTags(baseline, value);
      command_count = static_cast<std::uint16_t>(command_count +
                                                  inventory.commands);
      samplePower();
      if (!inventory.safety_ok || !gHtrcTransmitterSafe) {
        Serial.printf(
            "[TAG-INV] commands=%u count=%u safe=NO sampling=0x%02X duration=%lums voltage=%.3fV current=%.1fmA baseline=%.1fmA antenna=%s field_off=%s overflow=%s\r\n",
            static_cast<unsigned>(inventory.commands),
            static_cast<unsigned>(inventory.tags.count), value,
            static_cast<unsigned long>(inventory.field_duration_ms),
            inventory.field_voltage_v, inventory.field_current_ma,
            inventory.baseline_current_ma,
            inventory.antenna_ok ? "PASS" : "FAIL",
            inventory.field_off_ok ? "PASS" : "FAIL",
            inventory.overflow ? "YES" : "NO");
        publishTagStatus(TagStatus::Fault, nullptr, value, 0U);
        return true;
      }
      saw_incomplete = saw_incomplete || inventory.incomplete;
      combined.overflow = combined.overflow || inventory.tags.overflow;
      for (std::size_t index = 0; index < inventory.tags.count; ++index) {
        (void)hitag_s::addUniqueUid(combined, inventory.tags.uids[index]);
      }
      // Once the current known multi-tag cardinality has been recovered there
      // is no benefit in keeping the field active for another round.
      if (combined.count >= 2U &&
          combined.count >= gConfirmedTagCount && !inventory.incomplete) {
        break;
      }
    }
    if (combined.count != 0U && saw_incomplete) {
      publishTagStatus(TagStatus::Unstable, nullptr, value, 0U);
      return true;
    }
    if (combined.count != 0U) {
      publishTagInventory(TagStatus::Present, &combined, value, 1U);
      return true;
    }
    if (saw_incomplete) {
      Serial.printf(
          "[TAG-INV] commands=%u count=%u%s complete=NO sampling=0x%02X\r\n",
          static_cast<unsigned>(command_count), 0U,
          combined.overflow ? "+" : "", value);
      publishTagStatus(TagStatus::Unstable, nullptr, value, 0U);
      return true;
    }
    // A collision-shaped weak frame can be caused by a missed DOUT edge. If
    // both AC branches are empty, keep trying the remaining sampling phases
    // instead of allowing that false collision to abort normal single-tag
    // confirmation.
    return false;
  };

  if (gTagStatus == TagStatus::Present && gConfirmedTagCount > 1U &&
      gTagPreferredSamplingValid) {
    if (!inventory_at_sampling(gTagPreferredSampling)) {
      samplePower();
      publishTagStatus(TagStatus::NoTag, nullptr,
                       gTagPreferredSampling, 0U);
    }
    return;
  }

  // Once a UID is confirmed, poll the proven phase first and immediately try
  // the current phase window if it misses. Only a complete multi-phase miss
  // counts toward removal, preventing false NO TAG flashes from phase drift.
  if (gTagStatus == TagStatus::Present && gTagPreferredSamplingValid) {
    std::uint8_t presence_samples[8]{};
    std::size_t presence_sample_count = 0;
    const auto append_presence_sample = [&](std::uint8_t value) {
      for (std::size_t index = 0; index < presence_sample_count; ++index) {
        if (presence_samples[index] == value) {
          return;
        }
      }
      // Confirm twice at the same analogue phase; cross-phase matches can be
      // two different false SOF alignments.
      presence_samples[presence_sample_count++] = value;
      presence_samples[presence_sample_count++] = value;
    };
    append_presence_sample(gTagPreferredSampling);
    append_presence_sample(sampling);
    append_presence_sample(
        static_cast<std::uint8_t>((sampling + 8U) & 0x3FU));
    append_presence_sample(
        static_cast<std::uint8_t>((sampling - 8U) & 0x3FU));

    bool saw_ambiguous = false;
    bool saw_different_uid = false;
    hitag_s::DecodeResult presence_collision{};
    std::uint8_t presence_collision_count = 0;
    std::uint8_t presence_collision_sampling = sampling;
    const auto record_presence_collision = [&](const TagAttempt &value,
                                               std::uint8_t sample) {
      const bool matches =
          presence_collision_count != 0U &&
          presence_collision.collision_bit == value.decoded.collision_bit &&
          hitag_s::equalUidBits(presence_collision.uid, value.decoded.uid,
                                value.decoded.collision_bit);
      presence_collision = value.decoded;
      presence_collision_sampling = sample;
      presence_collision_count =
          static_cast<std::uint8_t>(matches ? presence_collision_count + 1U
                                            : 1U);
      return presence_collision_count >= 2U;
    };
    for (std::size_t index = 0; index < presence_sample_count; ++index) {
      const std::uint8_t presence_sampling = presence_samples[index];
      delay(kHitagFieldResetMs);
      const TagAttempt presence =
          captureHitagAttempt(baseline, presence_sampling);
      if (!presence.safety_ok || !gHtrcTransmitterSafe) {
        samplePower();
        publishTagStatus(TagStatus::Fault, nullptr, presence_sampling, 0U);
        return;
      }
      if (presence.decoded.status == hitag_s::DecodeStatus::Collision) {
        if (record_presence_collision(presence, presence_sampling)) {
          if (inventory_at_sampling(presence_collision_sampling)) {
            return;
          }
          presence_collision_count = 0U;
        }
        continue;
      }
      if (presence.decoded.status == hitag_s::DecodeStatus::Present) {
        if (hitag_s::equalUid(gConfirmedTagUids[0], presence.decoded.uid)) {
          samplePower();
          publishTagStatus(TagStatus::Present, &gConfirmedTagUids[0],
                           presence_sampling, 1U);
          return;
        }
        saw_different_uid = true;
        break;
      }
      saw_ambiguous = saw_ambiguous ||
                      presence.decoded.status ==
                          hitag_s::DecodeStatus::Ambiguous;
    }
    samplePower();
    if (!saw_different_uid) {
      publishTagStatus(saw_ambiguous ? TagStatus::Unstable
                                     : TagStatus::NoTag,
                       nullptr, gTagPreferredSampling, 0U);
      return;
    }
    // A different complete UID falls through to full confirmation below.
  }

  hitag_s::Uid candidate{};
  std::uint8_t present_count = 0;
  std::uint8_t attempt_count = 0;
  std::uint8_t selected_sampling = sampling;
  bool consistent = true;
  bool all_safe = true;
  bool ambiguous = false;
  hitag_s::DecodeResult collision{};
  std::uint8_t collision_count = 0;
  std::uint8_t collision_sampling = sampling;
  const auto record_collision = [&](const TagAttempt &value,
                                    std::uint8_t sample) {
    const bool matches =
        collision_count != 0U &&
        collision.collision_bit == value.decoded.collision_bit &&
        hitag_s::equalUidBits(collision.uid, value.decoded.uid,
                              value.decoded.collision_bit);
    collision = value.decoded;
    collision_sampling = sample;
    collision_count = static_cast<std::uint8_t>(
        matches ? collision_count + 1U : 1U);
    return collision_count >= 2U;
  };
  std::uint8_t sampling_candidates[8]{};
  std::size_t sampling_candidate_count = 0;
  const auto append_sampling = [&](std::uint8_t value) {
    for (std::size_t index = 0; index < sampling_candidate_count; ++index) {
      if (sampling_candidates[index] == value) {
        return;
      }
    }
    sampling_candidates[sampling_candidate_count++] = value;
    sampling_candidates[sampling_candidate_count++] = value;
  };
  if (gTagPreferredSamplingValid) {
    append_sampling(gTagPreferredSampling);
  }
  append_sampling(sampling);
  append_sampling(static_cast<std::uint8_t>((sampling + 8U) & 0x3FU));
  append_sampling(static_cast<std::uint8_t>((sampling - 8U) & 0x3FU));

  for (std::size_t index = 0;
       index < sampling_candidate_count && attempt_count < 8U; ++index) {
    const std::uint8_t candidate_sampling = sampling_candidates[index];
    delay(kHitagFieldResetMs);
    const TagAttempt attempt =
        captureHitagAttempt(baseline, candidate_sampling);
    ++attempt_count;
    if (!attempt.safety_ok) {
      all_safe = false;
      break;
    }
    if (attempt.decoded.status == hitag_s::DecodeStatus::Collision) {
      if (record_collision(attempt, candidate_sampling)) {
        if (inventory_at_sampling(collision_sampling)) {
          return;
        }
        collision_count = 0U;
      }
      continue;
    }
    if (attempt.decoded.status == hitag_s::DecodeStatus::Ambiguous) {
      ambiguous = true;
    } else if (attempt.decoded.status == hitag_s::DecodeStatus::Present) {
      candidate = attempt.decoded.uid;
      selected_sampling = candidate_sampling;
      present_count = 1U;
      ambiguous = false;
      break;
    }
  }

  // Three matching responses within five total attempts: one weak frame no
  // longer delays detection until the next polling cycle.
  while (present_count != 0U && present_count < 3U && all_safe &&
         attempt_count < 5U) {
    delay(kHitagFieldResetMs);
    const TagAttempt attempt =
        captureHitagAttempt(baseline, selected_sampling);
    ++attempt_count;
    if (!attempt.safety_ok) {
      all_safe = false;
      break;
    }
    if (attempt.decoded.status == hitag_s::DecodeStatus::Collision) {
      if (record_collision(attempt, selected_sampling)) {
        if (inventory_at_sampling(collision_sampling)) {
          return;
        }
        collision_count = 0U;
      }
      continue;
    }
    if (attempt.decoded.status == hitag_s::DecodeStatus::Ambiguous) {
      ambiguous = true;
    } else if (attempt.decoded.status == hitag_s::DecodeStatus::Present) {
      consistent = consistent && hitag_s::equalUid(candidate, attempt.decoded.uid);
      ++present_count;
    }
  }

  samplePower();
  if (!all_safe || !gHtrcTransmitterSafe) {
    publishTagStatus(TagStatus::Fault, nullptr, selected_sampling,
                     present_count);
  } else if (present_count == 3U && consistent && !ambiguous) {
    publishTagStatus(TagStatus::Present, &candidate, selected_sampling,
                     present_count);
  } else if (present_count != 0U || ambiguous) {
    publishTagStatus(TagStatus::Unstable, nullptr, selected_sampling,
                     present_count);
  } else {
    publishTagStatus(TagStatus::NoTag, nullptr, selected_sampling, 0U);
  }
}

led_scene::Input ledSceneInput() {
  led_scene::Input input;
  input.assigned = gNetworkSnapshot.assigned;
  input.link = gNetworkSnapshot.link;
  const auto &tile = currentTileState();
  input.ring_color = hasOwner(tile) ? playerColor(tile.owner_player) : tile.accent;
  input.occupied = tile.occupied_players != 0;
  input.movement = gNetworkSnapshot.movement.mode;
  input.movement_started_ms = gMovementCueStartedMs;
  input.pairing = gNetworkSnapshot.pairing;
  input.pairing_started_ms = gPairingCueStartedMs;
  return input;
}

void initializeLeds() {
  if (!beginLedRuntime()) Serial.println(F("[WS2812] ERROR worker_start_failed"));
}

void renderLedScene(std::uint32_t) {
  // Nonblocking value-copy only. The dedicated owner generates every frame,
  // including while the main loop is scanning RF or transferring LCD pixels.
  (void)submitLedScene(ledSceneInput());
}

void centeredText(const char *text, std::int16_t y, std::uint8_t size,
                  std::uint16_t foreground, std::uint16_t background) {
  displaySurface().setTextSize(size);
  displaySurface().setTextColor(foreground, background);
  std::int16_t x1 = 0;
  std::int16_t y1 = 0;
  std::uint16_t width = 0;
  std::uint16_t height = 0;
  displaySurface().getTextBounds(text, 0, y, &x1, &y1, &width, &height);
  const std::int16_t x = static_cast<std::int16_t>(
      std::max<std::int32_t>(0, (displaySurface().width() - width) / 2));
  displaySurface().setCursor(x, y);
  displaySurface().print(text);
}

void textAt(std::int16_t x, std::int16_t y, const char *text,
            std::uint8_t size, std::uint16_t foreground,
            std::uint16_t background = kPanel) {
  displaySurface().setTextSize(size);
  displaySurface().setTextColor(foreground, background);
  displaySurface().setCursor(x, y);
  displaySurface().print(text);
}

void footerTextAt(std::int16_t x, std::int16_t y, const char *text,
                  std::uint16_t foreground) {
  gFooterCanvas.setTextSize(1);
  gFooterCanvas.setTextColor(foreground, kBackground);
  gFooterCanvas.setCursor(x, y);
  gFooterCanvas.print(text);
}

void drawPanel(std::int16_t x, std::int16_t y, std::int16_t width,
               std::int16_t height, std::uint16_t border = kLine) {
  displaySurface().fillRoundRect(x, y, width, height, kCardRadius, kPanel);
  displaySurface().drawRoundRect(x, y, width, height, kCardRadius, border);
}
void formatMoney(char *buffer, std::size_t capacity, std::uint16_t amount) {
  std::snprintf(buffer, capacity, "$%u", static_cast<unsigned>(amount));
}

void drawArtwork(const TileState &state, std::uint16_t accent) {
  constexpr std::int16_t kImageX = 40;
  constexpr std::int16_t kImageY = 48;
  constexpr std::int16_t kImageSize = 160;
  constexpr std::int16_t kFrameX = 36;
  constexpr std::int16_t kFrameY = 44;
  constexpr std::int16_t kFrameSize = 168;
  displaySurface().fillRoundRect(kFrameX, kFrameY, kFrameSize, kFrameSize,
                         kArtworkRadius, kPanel);
  displaySurface().drawRoundRect(kFrameX, kFrameY, kFrameSize, kFrameSize,
                         kArtworkRadius, accent);
  displaySurface().drawRoundRect(kFrameX + 1, kFrameY + 1, kFrameSize - 2,
                         kFrameSize - 2, kArtworkRadius - 1, accent);

  // The lease pins RAM until the last row is copied. Worker writes only staging;
  // publication and LRU eviction run on this display task between render calls.
  auto remote = acquireDevelopmentArtwork(state);
  const TileArtwork developed{160, 160, remote.pixels()};
  const TileArtwork *artwork = remote.pixels() ? &developed : tileArtwork(state.artwork);
  if (artwork != nullptr && artwork->pixels != nullptr &&
      artwork->width == kImageSize && artwork->height == kImageSize) {
    if (gSubmittedFrame == nullptr) {
      gDisplay.startWrite();
      gDisplay.setAddrWindow(kImageX, kImageY, artwork->width, artwork->height);
    }
    for (std::uint16_t row = 0; row < artwork->height; ++row) {
      const std::uint16_t *source =
          artwork->pixels + static_cast<std::uint32_t>(row) * artwork->width;
      std::memcpy(gArtworkRow, source, artwork->width * sizeof(std::uint16_t));
      if (gSubmittedFrame != nullptr) {
        gPageCanvas.drawRGBBitmap(kImageX, kImageY + row, gArtworkRow,
                                  artwork->width, 1);
      } else {
        gDisplay.writePixels(gArtworkRow, artwork->width, true, false);
      }
    }
    if (gSubmittedFrame == nullptr) gDisplay.endWrite();
    return;
  }

  displaySurface().fillRect(kImageX, kImageY, kImageSize, kImageSize, kSelected);
  centeredText(state.tile_id, 109, 3, accent, kSelected);
  centeredText("ARTWORK PENDING", 142, 1, kMuted, kSelected);
}
void drawBuildingBadges(const TileState &state, std::int16_t x,
                        std::int16_t y, std::uint16_t accent) {
  if (state.kind != TileKind::Property || state.building_level == 0) {
    return;
  }
  for (std::uint8_t index = 0; index < 5; ++index) {
    const bool active = index < state.building_level;
    displaySurface().fillRect(static_cast<std::int16_t>(x + index * 11), y, 8,
                      index == 4 ? 9 : 7, active ? accent : kLine);
  }
}

void drawAssetStateCard(const TileState &state, std::uint16_t accent) {
  constexpr std::int16_t kCardX = 16;
  constexpr std::int16_t kCardY = 216;
  constexpr std::int16_t kCardWidth = 208;
  constexpr std::int16_t kCardHeight = 60;
  char amount[16];

  if (isOwnable(state.kind) && !hasOwner(state)) {
    drawPanel(kCardX, kCardY, kCardWidth, kCardHeight);
    textAt(28, 226, "PURCHASE PRICE", 1, kMuted);
    formatMoney(amount, sizeof(amount), state.purchase_price);
    textAt(28, 244, amount, 3, kYellow);
    return;
  }

  if (isOwnable(state.kind)) {
    const std::uint16_t owner_color =
        displayColor(playerColor(state.owner_player));
    drawPanel(kCardX, kCardY, kCardWidth, kCardHeight,
              state.mortgaged ? kRed : owner_color);
    displaySurface().fillCircle(29, 252, 4, state.mortgaged ? kRed : owner_color);
    textAt(28, 226, state.mortgaged ? "MORTGAGED" : "OWNED BY", 1,
           state.mortgaged ? kRed : kMuted);
    char fallback[20];
    const char *owner = state.owner_display_name;
    if (owner[0] == '\0') {
      std::snprintf(fallback, sizeof(fallback), "PLAYER %u", state.owner_player);
      owner = fallback;
    }
    textAt(40, 244, owner, 2, state.mortgaged ? kRed : owner_color);
    drawBuildingBadges(state, 157, 263, accent);
    return;
  }

  drawPanel(kCardX, kCardY, kCardWidth, kCardHeight);
  textAt(28, 226, tileKindLabel(state.kind), 1, kMuted);
  textAt(28, 244, state.status, 2,
         state.activity == TileActivity::PayFee ? kRed : accent);
  textAt(28, 263, state.detail, 1, kMuted);
}
void drawPowerFooter() {
  if (gFooterCanvas.getBuffer() == nullptr) {
    return;
  }
  gFooterCanvas.setTextWrap(false);
  gFooterCanvas.fillScreen(kBackground);
  gFooterCanvas.drawFastHLine(kOuterMargin, 0, 208, kLine);
  char tag[32];
  std::uint16_t tag_color = kYellow;
  if (gTagStatus == TagStatus::Present && gConfirmedTagCount != 0U) {
    const std::uint8_t display_index = static_cast<std::uint8_t>(
        (millis() / 1500U) % gConfirmedTagCount);
    if (gConfirmedTagCount == 1U) {
      std::snprintf(tag, sizeof(tag), "TAG  %s", gTagUids[0]);
    } else if (gConfirmedTagOverflow) {
      std::snprintf(tag, sizeof(tag), "TAGS %u+  %u/%u %s",
                    static_cast<unsigned>(gConfirmedTagCount),
                    static_cast<unsigned>(display_index + 1U),
                    static_cast<unsigned>(gConfirmedTagCount),
                    gTagUids[display_index]);
    } else {
      std::snprintf(tag, sizeof(tag), "TAGS %u  %u/%u %s",
                    static_cast<unsigned>(gConfirmedTagCount),
                    static_cast<unsigned>(display_index + 1U),
                    static_cast<unsigned>(gConfirmedTagCount),
                    gTagUids[display_index]);
    }
    tag_color = kGreen;
  } else if (gTagStatus == TagStatus::NoTag) {
    std::snprintf(tag, sizeof(tag), "TAG  NO TAG");
    tag_color = kMuted;
  } else if (gTagStatus == TagStatus::Unstable) {
    std::snprintf(tag, sizeof(tag), "TAG  UNSTABLE");
  } else if (gTagStatus == TagStatus::Fault) {
    std::snprintf(tag, sizeof(tag), "TAG  RFID ERROR");
    tag_color = kRed;
  } else {
    std::snprintf(tag, sizeof(tag), "TAG  SCANNING");
  }
  footerTextAt(kOuterMargin, 4, tag, tag_color);
  char left[32];
  if (gPower.valid) {
    std::snprintf(left, sizeof(left), "%.2FV  %.0FmA  %.2FW", gPower.bus_voltage_v,
                  gPower.current_ma, gPower.power_mw / 1000.0F);
  } else {
    std::snprintf(left, sizeof(left), "POWER N/A");
  }
  footerTextAt(kOuterMargin, 19, left, gPower.valid ? kMuted : kRed);
  const char *network = tileNetworkLabel(gNetworkSnapshot.link);
  std::uint16_t network_color = kYellow;
  if (gNetworkSnapshot.link == TileNetworkLink::OnlineAuto) {
    network_color = kGreen;
  } else if (gNetworkSnapshot.link == TileNetworkLink::OnlineManual) {
    network_color = kBlue;
  } else if (gNetworkSnapshot.link == TileNetworkLink::Fault) {
    network_color = kRed;
  }
  gFooterCanvas.setTextSize(1);
  std::int16_t x1 = 0;
  std::int16_t y1 = 0;
  std::uint16_t width = 0;
  std::uint16_t height = 0;
  gFooterCanvas.getTextBounds(network, 0, 19, &x1, &y1, &width, &height);
  footerTextAt(static_cast<std::int16_t>(224 - width), 19, network,
               network_color);
  if (gSubmittedFrame != nullptr) {
    gPageCanvas.drawRGBBitmap(0, 286, gFooterCanvas.getBuffer(), kDisplayWidth, 34);
  } else {
    gDisplay.drawRGBBitmap(0, 286, gFooterCanvas.getBuffer(), kDisplayWidth, 34);
  }
  gFramePending = true;
}
void drawConnectionProgress() {
  gFramePending = true;
  if (!gDisplayReady || gNetworkSnapshot.assigned) {
    return;
  }
  const TileConnectionView view = tileConnectionView(gNetworkSnapshot.link);
  const std::uint16_t accent = displayColor(view.accent);
  displaySurface().fillRect(0, 106, kDisplayWidth, 14, kBackground);
  char progress[5] = "   ";
  const std::uint8_t dot_count =
      static_cast<std::uint8_t>((millis() / 500U) % 4U);
  for (std::uint8_t index = 0; index < dot_count; ++index) {
    progress[index] = '.';
  }
  centeredText(progress, 110, 1, accent, kBackground);
}
void drawConnectionPage() {
  gFramePending = true;
  if (!gDisplayReady) {
    return;
  }
  const TileConnectionView view = tileConnectionView(gNetworkSnapshot.link);
  const std::uint16_t accent = displayColor(view.accent);
  displaySurface().fillScreen(kBackground);
  displaySurface().fillRect(0, 0, kDisplayWidth, 6, accent);
  textAt(kOuterMargin, 12, "GRIDOPOLY TILE MODULE", 1, kMuted, kBackground);

  centeredText(view.eyebrow, 48, 1, accent, kBackground);
  centeredText(view.title, 68, 2, kText, kBackground);
  centeredText(view.detail, 96, 1, kMuted, kBackground);

  drawConnectionProgress();

  drawPanel(16, 128, 208, 118, accent);
  textAt(28, 140, "CONNECTION", 1, kMuted);
  textAt(28, 157, tileNetworkLabel(gNetworkSnapshot.link), 2, accent);
  textAt(28, 184, "MODULE ID", 1, kMuted);
  textAt(28, 201,
         gNetworkSnapshot.module_id[0] == '\0'
             ? "IDENTIFYING..."
             : gNetworkSnapshot.module_id,
         1, kText);

  char transport[36];
  if (gNetworkSnapshot.http_status != 0) {
    std::snprintf(transport, sizeof(transport), "HTTP %d  RSSI %d DBM",
                  gNetworkSnapshot.http_status,
                  static_cast<int>(gNetworkSnapshot.rssi));
  } else {
    std::snprintf(transport, sizeof(transport), "HTTP PENDING");
  }
  textAt(28, 225, transport, 1, kMuted);
  centeredText("ASSIGNMENT COMES FROM SERVER", 266, 1, kMuted, kBackground);
  drawPowerFooter();
}
void drawTilePage() {
  gFramePending = true;
  if (!gDisplayReady) {
    return;
  }
  const TileState &state = currentTileState();
  const std::uint16_t accent = displayColor(state.accent);
  displaySurface().fillScreen(kBackground);

  // District color remains an accent regardless of ownership.
  displaySurface().fillRect(0, 0, kDisplayWidth, 6, accent);
  char eyebrow[40];
  std::snprintf(eyebrow, sizeof(eyebrow), "%s  TILE %02u", state.subtitle,
                state.map_index);
  textAt(kOuterMargin, 10, eyebrow, 1, accent, kBackground);

  const char *kind = tileKindLabel(state.kind);
  displaySurface().setTextSize(1);
  std::int16_t x1 = 0;
  std::int16_t y1 = 0;
  std::uint16_t width = 0;
  std::uint16_t height = 0;
  displaySurface().getTextBounds(kind, 0, 10, &x1, &y1, &width, &height);
  textAt(static_cast<std::int16_t>(224 - width), 10, kind, 1, kMuted,
         kBackground);

  centeredText(state.display_name, 25, 2, kText, kBackground);
  drawArtwork(state, accent);
  drawAssetStateCard(state, accent);
  drawPowerFooter();
}
void drawDiagnosticPage() {
  gFramePending = true;
  displaySurface().fillScreen(kBackground);
  displaySurface().fillRect(0, 0, kDisplayWidth, 39, kPanel);
  centeredText("TILE DIAGNOSTICS", 12, 2, kBlue, kPanel);
  drawPanel(12, 50, 216, 115, kBlue);
  textAt(22, 62, "DISPLAY", 1, kMuted);
  textAt(150, 62, gDisplayReady ? "OK" : "FAIL", 1,
         gDisplayReady ? kGreen : kRed);
  textAt(22, 84, "INA226", 1, kMuted);
  textAt(150, 84, gPower.configured ? "OK" : "FAIL", 1,
         gPower.configured ? kGreen : kRed);
  textAt(22, 106, "WS2812 RMT", 1, kMuted);
  const bool led_ready = ledRuntimeStatus().output.ready;
  textAt(150, 106, led_ready ? "OK" : "FAIL", 1, led_ready ? kGreen : kRed);
  textAt(22, 128, "RS485 DIR", 1, kMuted);
  textAt(150, 128, "SAFE LOW", 1, kGreen);
  textAt(22, 150, "ORDER OUT", 1, kMuted);
  textAt(150, 150, orderLinkObservation().output_pulled_low ? "PULSE LOW" : "RELEASED",
         1, kGreen);

  drawPanel(12, 178, 216, 94, kLine);
  char value[32];
  std::snprintf(value, sizeof(value), "BUS     %.3F V", gPower.bus_voltage_v);
  textAt(22, 191, value, 2, kText);
  std::snprintf(value, sizeof(value), "CURRENT %.1F MA", gPower.current_ma);
  textAt(22, 216, value, 2, kText);
  std::snprintf(value, sizeof(value), "PEAK    %.1F MA", gPower.peak_current_ma);
  textAt(22, 241, value, 2, kYellow);
  centeredText("TYPE DIAG TO RETURN", 294, 1, kMuted, kBackground);
}

void drawPairingPage() {
  gFramePending = true;
  displaySurface().fillScreen(kBackground);
  centeredText("TOKEN PAIRING", 28, 2, kText, kBackground);
  drawPanel(12, 65, 216, 178, kLine);
  char player[24];
  std::snprintf(player, sizeof(player), "PLAYER %u", gNetworkSnapshot.pairing.player_id);
  centeredText(player, 92, 3, kText, kPanel);
  // The panel font is ASCII. Player number remains authoritative for any name.
  char name[25]{};
  for (std::size_t i = 0; i < 24 && gNetworkSnapshot.pairing.player_name[i] != '\0'; ++i) {
    const unsigned char c = gNetworkSnapshot.pairing.player_name[i];
    name[i] = c >= 32 && c <= 126 ? static_cast<char>(c) : '?';
  }
  centeredText(name, 136, 1, kMuted, kPanel);
  centeredText(pairingInstruction(gNetworkSnapshot.pairing.state), 188, 1, kText, kPanel);
  centeredText("FOLLOW YOUR PLAYER SCREEN", 275, 1, kMuted, kBackground);
  drawPowerFooter();
}

void drawArtworkProbePage(const TileState &preview) {
  displaySurface().fillScreen(kBackground);
  centeredText("TEST ARTWORK - 30 SEC", 10, 1, kYellow, kBackground);
  drawArtwork(preview, kYellow);
  centeredText(preview.display_name, 218, 1, kMuted, kBackground);
  char level[32];
  std::snprintf(level, sizeof(level), "LEVEL %u  %s", preview.building_level,
                preview.building_level == 5 ? "HOTEL" : "HOUSES");
  centeredText(level, 235, 1, kYellow, kBackground);
  drawBuildingBadges(preview, 92, 252, kYellow);
  auto image = acquireDevelopmentArtwork(preview);
  centeredText(image.pixels() ? "RAM IMAGE READY" : "L0 FALLBACK / DOWNLOADING",
               270, 1, image.pixels() ? kGreen : kMuted, kBackground);
  drawPowerFooter();
}

void renderPage() {
  TileState preview;
  if (gDiagnosticPage) {
    drawDiagnosticPage();
    Serial.println(F("[DISPLAY] page=DIAGNOSTIC"));
  } else if (developmentArtworkPreview(preview)) {
    drawArtworkProbePage(preview);
  } else if (pairingVisible(gNetworkSnapshot.pairing, millis())) {
    drawPairingPage();
    Serial.printf("[DISPLAY] page=PAIRING state=%s player=%u\r\n",
                  tilePairingStateLabel(gNetworkSnapshot.pairing.state),
                  gNetworkSnapshot.pairing.player_id);
  } else if (gNetworkSnapshot.assigned) {
    drawTilePage();
    Serial.printf("[DISPLAY] page=TILE id=%s revision=%llu\r\n",
                  gNetworkSnapshot.tile.tile_id,
                  static_cast<unsigned long long>(
                      gNetworkSnapshot.assignment_revision));
  } else {
    drawConnectionPage();
    Serial.printf("[DISPLAY] page=CONNECTION state=%s\r\n",
                  tileNetworkLabel(gNetworkSnapshot.link));
  }
}

struct DisplaySink {
  bool write(std::uint16_t x, std::uint16_t y, std::uint16_t width,
             std::uint16_t height, const std::uint16_t *frame,
             std::uint16_t stride) {
    gDisplay.startWrite();
    gDisplay.setAddrWindow(x, y, width, height);
    for (std::uint16_t row = y; row < y + height; ++row) {
      std::memcpy(gDisplayRow, frame + static_cast<std::size_t>(row) * stride + x,
                  width * sizeof(std::uint16_t));
      gDisplay.writePixels(gDisplayRow, width, true, false);
    }
    gDisplay.endWrite();
    // Write-only LCD: this records completed SPI submission, not panel readback.
    return true;
  }
};

void presentPage() {
  if (!gFramePending || !gDisplayReady) return;
  gFramePending = false;
  if (gSubmittedFrame == nullptr) return;
  const std::uint32_t started = micros();
  DisplaySink sink;
  const DisplayTransfer transfer = presentDisplayFrame(
      gPageCanvas.getBuffer(), gSubmittedFrame, kDisplayWidth, kDisplayHeight,
      !gSubmittedFrameValid, sink);
  gSubmittedFrameValid = transfer.complete;
  gDisplayMetrics.last_us = micros() - started;
  gDisplayMetrics.max_us = std::max(gDisplayMetrics.max_us,
                                   gDisplayMetrics.last_us);
  if (transfer.pixels == 0) {
    ++gDisplayMetrics.skipped;
  } else {
    ++gDisplayMetrics.frames;
    gDisplayMetrics.pixels += transfer.pixels;
    gDisplayMetrics.rectangles += transfer.rectangles;
    if (transfer.pixels == kDisplayWidth * kDisplayHeight) {
      ++gDisplayMetrics.full_frames;
    }
  }
  if (transfer.pixels >= 16'000U) {
    Serial.printf("[DISPLAY-FRAME] spi_hz=%u actual_hz=%u pixels=%u rectangles=%u rows=%u..%u submit_us=%u full=%s\r\n",
                  gDisplayClockHz,
                  spiClockDivToFrequency(gDisplaySpi.getClockDivider()),
                  transfer.pixels, transfer.rectangles, transfer.first_row,
                  transfer.end_row, gDisplayMetrics.last_us,
                  transfer.pixels == kDisplayWidth * kDisplayHeight ? "YES" : "NO");
  }
}

void restoreSafeDisplay() {
  gDisplayExperimentDurationMs = 0;
  gDisplayClockHz = kDisplaySafeSpiFrequencyHz;
  gDiagnosticPage = false;
  // A failed high-rate command could have changed MADCTL/COLMOD as well as
  // pixels. Restore the controller's known configuration at the safe rate.
  recoverDisplayController();
  renderPage();
  Serial.printf("[DISPLAY-CLOCK] restored_hz=%u page=TILE_OR_CONNECTION\r\n",
                gDisplayClockHz);
}

void recoverAndRenderPage() {
  recoverDisplayController();
  renderPage();
}

void printLedStatus() {
  const auto runtime = ledRuntimeStatus();
  const auto &status = runtime.output;
  Serial.printf("[WS2812-STATUS] ready=%s mode=%s remaining_ms=%lu pin=%d count=%u clock_hz=%lu reset_us=%u requested_rgb=%u,%u,%u attempted=%lu completed=%lu failed=%lu stage=%s driver_error=%d stop_error=%d worker=%s period_ms=%lu max_gap_ms=%lu late_frames=%lu optical_verified=NO\r\n",
                status.ready ? "YES" : "NO", ws2812::modeName(runtime.mode),
                static_cast<unsigned long>(runtime.remaining_ms),
                kWs2812DataPin, static_cast<unsigned>(kWs2812Count),
                static_cast<unsigned long>(status.clock_hz), ws2812::kResetUs,
                runtime.requested.red, runtime.requested.green, runtime.requested.blue,
                static_cast<unsigned long>(status.attempted),
                static_cast<unsigned long>(status.completed),
                static_cast<unsigned long>(status.failed), status.stage,
                status.driver_error, status.stop_error, runtime.worker ? "YES" : "NO",
                static_cast<unsigned long>(led_scene::kFrameMs),
                static_cast<unsigned long>(runtime.max_gap_ms),
                static_cast<unsigned long>(runtime.late_frames));
  Serial.printf("[WS2812-FRAME] pattern=%s limit=%u peak_index=%u peak_channel=%u pixel0=requested_rgb pixels=",
                runtime.pattern == led_scene::FrameKind::Meteor ? "meteor" : "ordinary",
                led_scene::channelLimit(runtime.pattern), runtime.peak_index, runtime.peak_channel);
  for (unsigned i = 0; i < kWs2812Count; ++i)
    Serial.printf("%s%u,%u,%u", i ? ";" : "", runtime.pixels[i].red,
                  runtime.pixels[i].green, runtime.pixels[i].blue);
  Serial.println();
}

void printStatus() {
  Serial.println(F("[RFID-DIAG] build=stage2 strict=YES probe=EXPLICIT_ONCE"));
  printLedStatus();
  printDevelopmentArtworkStatus();
  Serial.printf("[PAIRING] active=%s state=%s room=%lu session=%lu revision=%lu player=%u scan_seq=%lu fresh=%s\r\n",
                pairingVisible(gNetworkSnapshot.pairing, millis()) ? "YES" : "NO",
                tilePairingStateLabel(gNetworkSnapshot.pairing.state),
                static_cast<unsigned long>(gNetworkSnapshot.pairing.room_id),
                static_cast<unsigned long>(gNetworkSnapshot.pairing.session_id),
                static_cast<unsigned long>(gNetworkSnapshot.pairing.revision),
                gNetworkSnapshot.pairing.player_id,
                static_cast<unsigned long>(gTagScanEvidence.sequence),
                tagScanFresh(gTagScanEvidence, millis()) ? "YES" : "NO");
  const OrderLinkObservation order = orderLinkObservation();
  Serial.printf("[ORDER] boot=%016llX tx_seq=%u upstream=%016llX rx_seq=%u valid=%s age_ms=%u input=%s out=%s timer=%s accepted=%u rejected=%u timing_drops=%u\r\n",
                static_cast<unsigned long long>(order.boot_id), order.tx_sequence,
                static_cast<unsigned long long>(order.upstream.boot_id),
                order.upstream.sequence, order.valid ? "YES" : "NO", order.age_ms,
                order.stuck_low ? "stuckLow" : order.receiving ? "receiving" : "idle",
                order.output_pulled_low ? "LOW" : "RELEASED",
                order.timer_ready ? "OK" : "FAIL", order.accepted, order.rejected,
                order.timing_drops);
  Serial.printf("[DISPLAY-CLOCK] requested_hz=%u actual_hz=%u experiment_ms=%u firmware=%s\r\n",
                gDisplayClockHz,
                spiClockDivToFrequency(gDisplaySpi.getClockDivider()),
                gDisplayExperimentDurationMs, kFirmwareVersion);
  printDisplayOrientation();
  Serial.printf("[DISPLAY-PERF] renderer=%s frames=%u skipped=%u rectangles=%u pixels=%u full=%u last_us=%u max_us=%u\r\n",
                gSubmittedFrame != nullptr ? "PSRAM_DIFF" : "DIRECT_FALLBACK",
                gDisplayMetrics.frames, gDisplayMetrics.skipped,
                gDisplayMetrics.rectangles, gDisplayMetrics.pixels,
                gDisplayMetrics.full_frames, gDisplayMetrics.last_us,
                gDisplayMetrics.max_us);
  if (gNetworkSnapshot.assigned) {
    const TileState &state = currentTileState();
    Serial.printf("[TILE] source=%s id=%s map=%u artwork=%s kind=%s activity=%s owner=%u owner_name=%s buildings=%u\r\n",
                  gNetworkSnapshot.source, state.tile_id,
                  static_cast<unsigned>(state.map_index), artworkKey(state.artwork),
                  tileKindLabel(state.kind), tileActivityLabel(state.activity),
                  state.owner_player, state.owner_display_name,
                  state.building_level);
  } else {
    Serial.println(F("[TILE] assignment=NONE waiting_for_server=YES"));
  }
  Serial.printf("[NET] state=%s module=%s device=%s assigned=%s server_revision=%llu assignment_revision=%llu http=%d rssi=%d\r\n",
                tileNetworkLabel(gNetworkSnapshot.link),
                gNetworkSnapshot.module_id, gNetworkSnapshot.device_id,
                gNetworkSnapshot.assigned ? "YES" : "NO",
                static_cast<unsigned long long>(gNetworkSnapshot.server_revision),
                static_cast<unsigned long long>(gNetworkSnapshot.assignment_revision),
                gNetworkSnapshot.http_status,
                static_cast<int>(gNetworkSnapshot.rssi));
  if (gPower.valid) {
    Serial.printf("[POWER] %.3fV %.1fmA %.3fW peak=%.1fmA\r\n",
                  gPower.bus_voltage_v, gPower.current_ma,
                  gPower.power_mw / 1000.0F, gPower.peak_current_ma);
  }
  Serial.printf("[HTRC110] TXDIS=%s\r\n",
                gHtrcTransmitterSafe ? "1/OFF" : "UNKNOWN/FAIL");
  Serial.printf("[TAG-STATUS] state=%u count=%u%s uids=",
                static_cast<unsigned>(gTagStatus),
                static_cast<unsigned>(gConfirmedTagCount),
                gConfirmedTagOverflow ? "+" : "");
  if (gConfirmedTagCount == 0U) {
    Serial.print(F("--------"));
  } else {
    for (std::size_t index = 0; index < gConfirmedTagCount; ++index) {
      Serial.printf("%s%s", index == 0U ? "" : ",", gTagUids[index]);
    }
  }
  Serial.println();
  Serial.printf("[MOVE] cue=%s player=%u revision=%llu\r\n",
                tileMovementCueLabel(gNetworkSnapshot.movement.mode),
                static_cast<unsigned>(gNetworkSnapshot.movement.player_id),
                static_cast<unsigned long long>(
                    gNetworkSnapshot.movement.revision));
}
void printHelp() {
  Serial.println(F("Commands:"));
  Serial.println(F("  DIAG              toggle hardware diagnostics page"));
  Serial.println(F("  REDRAW            reset ST7789 and redraw current page"));
  Serial.println(F("  DISPLAY SPEED hz seconds  bounded SPI experiment (5..300 s)"));
  Serial.println(F("  DISPLAY FRAME     submit complete current page without reset"));
  Serial.println(F("  DISPLAY SAFE      restore board-safe speed and normal page"));
  Serial.println(F("  RESTART           restart ESP32-S3 for boot timing test"));
  Serial.println(F("  BRIGHTNESS 0..255 set LCD backlight PWM"));
  Serial.println(F("  LED STATUS        print driver and requested-pixel state"));
  Serial.println(F("  LED DESTINATION|DEPARTURE|PAIRING 1..30  meteor preview, auto restore"));
  Serial.println(F("  LED PAIRING-SUCCESS|PAIRING-CLEAR 1..30  local pairing cue preview"));
  Serial.println(F("  LED OFF|RED|GREEN|BLUE seconds  local override, 1..30 s, level 8"));
  Serial.println(F("  LED AUTO          restore normal game lighting immediately"));
  Serial.println(F("  STATUS            print current state and power"));
  Serial.println(F("  ART PROBE key 1..5  local artwork preview, expires after 30 s"));
  Serial.println(F("  ART STOP|STATUS   restore authoritative page / RAM cache status"));
  Serial.println(F("  RFID DEBUG ON|OFF 30s bounded RFID stage diagnostics"));
  Serial.println(F("  RFID PROBE ONCE   local read-only ANTFAIL probe; 60s cooldown"));
  Serial.println(F("  HELP              print this list"));
}

void uppercase(char *text) {
  while (*text != '\0') {
    *text = static_cast<char>(std::toupper(static_cast<unsigned char>(*text)));
    ++text;
  }
}

void processCommand(char *command) {
  while (*command == ' ') {
    ++command;
  }
  uppercase(command);
  if (std::strncmp(command, "ART", 3) == 0) {
    if (developmentArtworkCommand(command, millis())) {
      gDiagnosticPage = false;
      serviceDevelopmentArtwork(gNetworkSnapshot.assigned ? &currentTileState() : nullptr, millis());
      renderPage();
    }
  } else if (std::strncmp(command, "LED", 3) == 0) {
    const auto led_command = ws2812::parseCommand(command);
    if (!led_command.valid) {
      Serial.println(F("ERR: LED STATUS, LED AUTO, or LED OFF|RED|GREEN|BLUE|DESTINATION|DEPARTURE|PAIRING|PAIRING-SUCCESS|PAIRING-CLEAR 1..30"));
      return;
    }
    if (!led_command.status_only && !submitLedCommand(led_command, millis()))
      Serial.println(F("ERR: LED command queue unavailable"));
    printLedStatus();
  } else if (std::strncmp(command, "DISPLAY SPEED ", 14) == 0) {
    unsigned long hz = 0;
    unsigned long seconds = 0;
    char extra = 0;
    if (std::sscanf(command + 14, "%lu %lu %c", &hz, &seconds, &extra) == 2 &&
        validDisplayClockExperiment(hz, seconds)) {
      gDisplayClockHz = hz;
      gDisplayExperimentStartedMs = millis();
      gDisplayExperimentDurationMs = seconds * 1000U;
      gDisplay.setSPISpeed(gDisplayClockHz);
      Serial.printf("[DISPLAY-CLOCK] experiment_hz=%u duration_ms=%u\r\n",
                    gDisplayClockHz, gDisplayExperimentDurationMs);
    } else {
      Serial.println(F("ERR: speed must be 8000000/16000000/20000000/26666667/32000000/40000000 Hz, 5..300 s"));
    }
  } else if (std::strcmp(command, "DISPLAY SAFE") == 0) {
    restoreSafeDisplay();
  } else if (std::strcmp(command, "DISPLAY FRAME") == 0) {
    gSubmittedFrameValid = false;
    renderPage();
  } else if (std::strcmp(command, "DIAG") == 0) {
    gDiagnosticPage = !gDiagnosticPage;
    renderPage();
  } else if (std::strcmp(command, "REDRAW") == 0) {
    recoverAndRenderPage();
  } else if (std::strcmp(command, "RESTART") == 0) {
    Serial.println(F("[BOOT] software restart requested"));
    Serial.flush();
    delay(50);
    ESP.restart();
  } else if (std::strncmp(command, "BRIGHTNESS ", 11) == 0) {
    const unsigned long value = std::strtoul(command + 11, nullptr, 10);
    if (value <= 255) {
      gBacklightDuty = static_cast<std::uint8_t>(value);
      analogWrite(kLcdBacklightPin, gBacklightDuty);
      Serial.printf("[DISPLAY] backlight=%u/255\r\n", gBacklightDuty);
    } else {
      Serial.println(F("ERR: brightness must be 0..255"));
    }
  } else if (std::strcmp(command, "STATUS") == 0) {
    printStatus();
  } else if (std::strcmp(command, "RFID DEBUG ON") == 0) {
    gRfidDiagnostics.enable(millis());
    Serial.println(F("[RFID] diagnostics=ON schema=1 duration_ms=30000 interval_ms=1000 strict=YES"));
  } else if (std::strcmp(command, "RFID DEBUG OFF") == 0) {
    gRfidDiagnostics.disable();
    Serial.println(F("[RFID] diagnostics=OFF"));
  } else if (std::strcmp(command, "RFID PROBE ONCE") == 0) {
    runRfidProbeOnce();
  } else if (std::strcmp(command, "HELP") == 0 || std::strcmp(command, "?") == 0) {
    printHelp();
  } else if (*command != '\0') {
    Serial.println(F("ERR: unknown command; type HELP"));
  }
}

void pollSerial() {
  while (Serial.available() > 0) {
    const char character = static_cast<char>(Serial.read());
    const auto result = gSerialLine.feed(character);
    if (result == SerialLineResult::Line) processCommand(gSerialLine.data());
    else if (result == SerialLineResult::TooLong)
      Serial.println(F("ERR: command too long; entire line discarded"));
  }
}

}  // namespace

void setup() {
  setSafeOutputs();
  std::uint8_t factory_mac[6]{};
  char display_device_id[18]{};
  if (esp_read_mac(factory_mac, ESP_MAC_WIFI_STA) == ESP_OK) {
    std::snprintf(display_device_id, sizeof(display_device_id),
                  "%02x:%02x:%02x:%02x:%02x:%02x", factory_mac[0], factory_mac[1],
                  factory_mac[2], factory_mac[3], factory_mac[4], factory_mac[5]);
  }
  gDisplayClockHz = displaySpiFrequencyForDevice(display_device_id);
  // The HTRC110 powers up with TXDIS=0. Wait for its 4 MHz oscillator, then
  // explicitly disable and verify the coil driver before slower peripherals.
  delay(15);
  gHtrcTransmitterSafe = forceHtrcTransmitterOff();
  gLastHtrcSafeRewriteMs = millis();
  Serial.begin(kSerialBaud);
  // Never use zero here: ESP32-S3 HWCDC underflows its retry counter when
  // the USB host is present but no monitor drains a full TX ring. Diagnostic
  // output must be dropped after a few milliseconds, never block networking.
  Serial.setTxTimeoutMs(5);
  Serial.printf("[BOOT] reset_reason=%d\r\n",
                static_cast<int>(esp_reset_reason()));
  Serial.printf("[HTRC110] TXDIS=1 verify=%s\r\n",
                gHtrcTransmitterSafe ? "PASS" : "FAIL");
  initializeDisplay();
  initializePowerMonitor();
  initializeLeds();
  samplePower();
  const std::uint32_t now = millis();
  gLastTagScanMs = now - kTagSearchPeriodMs;
  gNetwork.begin();
  beginDevelopmentArtwork();
  const bool order_ready = initializeOrderLink();
  Serial.printf("[ORDER] timer=%s period_ms=6000 ttl_ms=15000 gate=LOW_RELEASE\r\n",
                order_ready ? "OK" : "FAIL");
  (void)gNetwork.consume(gNetworkSnapshot);
  renderPage();
  presentPage();
  renderLedScene(now);

  Serial.println();
  Serial.printf("GRIDOPOLY TILE MODULE %s - ROLE AND TOKEN PAIRING\r\n", kFirmwareVersion);
  Serial.println(F("RS485 disabled; ORDER physical beacon and Wi-Fi/HTTP assignment enabled."));
  Serial.printf("[PROFILE] role=%s profile=%s firmware=%s\r\n",
                moduleRoleLabel(kModuleRole), kModuleProfile, kFirmwareVersion);
  printHelp();
  printStatus();
}

void loop() {
  const std::uint32_t now = millis();
  pollSerial();
  if (gNetworkSnapshot.pairing.active && !pairingVisible(gNetworkSnapshot.pairing, now)) {
    gNetworkSnapshot.pairing = {};
    gNetworkSnapshot.movement = {};
    renderPage();
    renderLedScene(now);
  }
  if (displayExperimentExpired(millis(), gDisplayExperimentStartedMs,
                               gDisplayExperimentDurationMs)) {
    restoreSafeDisplay();
  }
  publishPendingTagObservation();
  if (static_cast<std::uint32_t>(now - gLastHtrcSafeRewriteMs) >=
      kHtrcSafeRewritePeriodMs) {
    gLastHtrcSafeRewriteMs = now;
    const bool was_safe = gHtrcTransmitterSafe;
    gHtrcTransmitterSafe = forceHtrcTransmitterOff();
    if (!gHtrcTransmitterSafe && was_safe) {
      Serial.println(F("[HTRC110] ERROR: TXDIS readback failed"));
    }
  }
  const std::uint32_t tag_scan_period = gTagStatus == TagStatus::Present
                                            ? (gConfirmedTagCount > 1U
                                                   ? kTagMultiPollPeriodMs
                                                   : kTagPresencePollPeriodMs)
                                            : kTagSearchPeriodMs;
  if (static_cast<std::uint32_t>(now - gLastTagScanMs) >= tag_scan_period) {
    gLastTagScanMs = now;
    scanHitagTag();
    if (gTagUiDirty && gDisplayReady && !gDiagnosticPage) {
      drawPowerFooter();
      gTagUiDirty = false;
    }
  }


  TileNetworkSnapshot next_network;
  if (gNetwork.consume(next_network)) {
    const bool page_changed =
        pairingChanged(next_network.pairing, gNetworkSnapshot.pairing) ||
        next_network.assigned != gNetworkSnapshot.assigned ||
        (next_network.assigned
             ? std::memcmp(&next_network.tile, &gNetworkSnapshot.tile,
                           sizeof(TileState)) != 0
             : (next_network.link != gNetworkSnapshot.link ||
                next_network.http_status != gNetworkSnapshot.http_status ||
                next_network.rssi != gNetworkSnapshot.rssi ||
                std::strcmp(next_network.module_id,
                            gNetworkSnapshot.module_id) != 0));
    const bool movement_changed = movementContextChanged(next_network, gNetworkSnapshot);
    const std::uint32_t cue_now = millis();
    if (led_scene::pairingContextChanged(next_network.pairing, gNetworkSnapshot.pairing, cue_now)) {
      gPairingCueStartedMs = cue_now;
    }
    gNetworkSnapshot = next_network;
    if (movement_changed) {
      gMovementCueStartedMs = cue_now;
    }
    if (page_changed && !gDiagnosticPage) {
      // Keep the working controller session; page composition never clears
      // the physical panel. Transport/cue revisions alone do not repaint it.
      renderPage();
    } else if (!gDiagnosticPage) {
      drawPowerFooter();
    }
    renderLedScene(now);
    printStatus();
  }

  if (static_cast<std::uint32_t>(now - gLastPowerSampleMs) >= kPowerSamplePeriodMs) {
    gLastPowerSampleMs = now;
    samplePower();
  }
  if (static_cast<std::uint32_t>(now - gLastUiRefreshMs) >= kUiRefreshPeriodMs) {
    gLastUiRefreshMs = now;
    if (gDiagnosticPage) {
      drawDiagnosticPage();
    } else if (developmentArtworkProbeActive()) {
      // An unassigned module still has a complete TEST preview; do not draw
      // the connection-page progress stripe over its artwork.
      drawPowerFooter();
    } else if (!gNetworkSnapshot.assigned &&
               !pairingVisible(gNetworkSnapshot.pairing, now)) {
      // The connection page is fully redrawn only when its semantic network
      // state changes. At 8 MHz a full-screen refresh every 500 ms produced a
      // clearly visible top-to-bottom wipe. Animate only the tiny progress
      // region and update the fixed footer here.
      drawConnectionProgress();
      drawPowerFooter();
    } else {
      drawPowerFooter();
    }
  }
  if (serviceDevelopmentArtwork(gNetworkSnapshot.assigned ? &currentTileState() : nullptr, millis()) &&
      !gDiagnosticPage) renderPage();
  presentPage();
  delay(1);
}
