Ha22yX/Gridopoly/Firmware/PlayerConsole/PlayerConsole.ino

#include <Arduino.h>
#include <esp_display_panel.hpp>
#include <esp_attr.h>
#include <esp_rom_sys.h>
#include <esp_system.h>
#include "display_diagnostic.h"
#if (defined(GRIDOPOLY_SELF_TEST) && GRIDOPOLY_SELF_TEST == 1) || GRIDOPOLY_DISPLAY_DIAGNOSTIC
#include <esp_heap_caps.h>
#endif
#include <lvgl.h>
#include <new>
#include <cstring>

#include "app_config.h"
#include "app_state.h"
#include "battery_hardware.h"
#include "demo_transport.h"
#include "espnow_player_transport.h"
#include "hardware_input.h"
#include "input_dispatch.h"
#include "touch_trace.h"
#include "logic_tests.h"
#include "lvgl_v8_port.h"
#include "rom_console_stream.h"
#include "remote_avatar_cache.h"
#include "remote_tile_cache.h"
#include "ui_renderer.h"
#if GRIDOPOLY_BATTERY_ENABLED
#include "ui_battery.h"
#endif
#include "wifi_udp_player_transport.h"

#if GRIDOPOLY_SELF_TEST == 1
extern "C" void gridopoly_set_row_clip(bool enabled);
extern "C" void gridopoly_set_large_circle_cache(bool enabled);
// The complete renderer and reducer suites intentionally share one Arduino test task.
// Keep their large protocol fixtures away from the production task budget.
SET_LOOP_TASK_STACK_SIZE(32 * 1024);
#endif

#ifndef BOARD_HAS_PSRAM
#error "Gridopoly Player Console requires PSRAM"
#endif

#if !defined(ARDUINO_USB_MODE) || ARDUINO_USB_MODE != 1
#error "Use ESP32-S3 Hardware CDC/JTAG USB mode"
#endif

using namespace esp_panel::drivers;
using namespace esp_panel::board;

namespace {

AppState app;
#if GRIDOPOLY_BATTERY_ENABLED
UiBattery batteryUi;
#endif
bool inputTraceEnabled = false;
uint32_t inputTraceDeadlineMs = 0;
uint32_t inputTraceUsbDropped = 0;

void writeInputDiagnostic(const char *line, int length)
{
    // Serial has a zero TX timeout. Drop diagnostics under backpressure rather
    // than delaying input; capacity alone cannot promise host-side delivery.
    if (length > 0 && length < 256 && Serial.availableForWrite() >= length &&
        Serial.write(reinterpret_cast<const uint8_t *>(line), length) == static_cast<size_t>(length)) return;
    if (inputTraceUsbDropped != UINT32_MAX) ++inputTraceUsbDropped;
}

void printInputStatus(uint32_t nowMs)
{
    const auto stats = hardwareInputStatistics();
    char line[256];
    const int length = snprintf(line, sizeof(line),
        "GRIDOPOLY_INPUT_STATUS ms=%lu samples=%lu gap_us=%lu max_gap_us=%lu steps=%lu pos=%lu neg=%lu invalid=%lu queue_drop=%lu queue=%u trace_drop=%lu tx_drop=%lu\n",
        static_cast<unsigned long>(nowMs), static_cast<unsigned long>(stats.samples),
        static_cast<unsigned long>(stats.lastSampleGapUs), static_cast<unsigned long>(stats.maxSampleGapUs),
        static_cast<unsigned long>(stats.decodedSteps), static_cast<unsigned long>(stats.positiveSteps),
        static_cast<unsigned long>(stats.negativeSteps), static_cast<unsigned long>(stats.invalidTransitions),
        static_cast<unsigned long>(stats.inputQueueDropped), stats.queueEntries,
        static_cast<unsigned long>(stats.droppedTraces), static_cast<unsigned long>(inputTraceUsbDropped));
    writeInputDiagnostic(line, length);
}

#if GRIDOPOLY_DISPLAY_DIAGNOSTIC
void serviceDisplayDiagnostic(uint32_t nowMs)
{
    static DisplayDiagnosticWindow window;
    if (!window.sampleDue(nowMs)) return;
    // Snapshot only; never force a refresh, request a frame ticket or alter UI.
    if (!lvgl_port_lock(0)) return;
    const UiRendererTestStats renderer = uiRendererGetTestStats();
    const LvglDisplayDiagnostics display = lvgl_port_display_diagnostics();
    const unsigned page = static_cast<unsigned>(app.page);
    lvgl_port_unlock();
    char line[300];
    const int length = snprintf(line, sizeof(line),
        "GRIDOPOLY_DISPLAY_DIAG ms=%lu done=%u pclk_requested=%lu sdk=%s page=%u rebuild=%lu incremental=%lu flush=%lu switch_fail=%lu frame_complete=%lu internal=%u largest=%u\n",
        static_cast<unsigned long>(nowMs), window.finished ? 1u : 0u,
        static_cast<unsigned long>(kDisplayRequestedPclkHz), esp_get_idf_version(), page,
        static_cast<unsigned long>(renderer.rebuildRenders),
        static_cast<unsigned long>(renderer.incrementalRenders),
        static_cast<unsigned long>(display.flushes),
        static_cast<unsigned long>(display.switchFailures),
        static_cast<unsigned long>(display.frameCompletions),
        static_cast<unsigned>(heap_caps_get_free_size(MALLOC_CAP_INTERNAL | MALLOC_CAP_8BIT)),
        static_cast<unsigned>(heap_caps_get_largest_free_block(MALLOC_CAP_INTERNAL | MALLOC_CAP_8BIT)));
    // Never wait on an absent/slow USB host. Missing samples are not zero counts.
    if (length > 0 && length < static_cast<int>(sizeof(line)) &&
        Serial.availableForWrite() >= length) {
        Serial.write(reinterpret_cast<const uint8_t *>(line), length);
    }
}
#endif

void serviceInputTrace(uint32_t nowMs)
{
    // Explicit, bounded diagnostics only. Serial commands never change input
    // events, decoder state, identity drafts or authoritative game state.
    static char line[32]{};
    static uint8_t length = 0;
    static bool overflow = false;
    for (uint8_t count = 0; count < sizeof(line) && Serial.available() > 0; ++count) {
        const char ch = static_cast<char>(Serial.read());
        if (ch == '\r') continue;
        if (ch != '\n') {
            if (length + 1 < sizeof(line) && !overflow) line[length++] = ch;
            else overflow = true;
            continue;
        }
        line[length] = '\0';
        if (!overflow && std::strcmp(line, "TOUCH TRACE ON") == 0) {
            touchTraceStart(nowMs);
        } else if (!overflow && std::strcmp(line, "TOUCH TRACE OFF") == 0) {
            touchTraceStop(nowMs);
        } else if (!overflow && std::strcmp(line, "BATTERY TRACE ON") == 0) {
            const bool enabled = batteryHardwareTraceStart(nowMs);
            Serial.printf("GP_BAT_TRACE enabled=%u ms=%lu window_ms=120000\n",
                          enabled ? 1u : 0u, static_cast<unsigned long>(nowMs));
        } else if (!overflow && std::strcmp(line, "BATTERY TRACE OFF") == 0) {
            batteryHardwareTraceStop();
            Serial.printf("GP_BAT_TRACE enabled=0 ms=%lu window_ms=0\n",
                          static_cast<unsigned long>(nowMs));
        } else if (!overflow && std::strcmp(line, "INPUT TRACE ON") == 0) {
            printInputStatus(nowMs);
            hardwareInputClearDiagnostics();
            inputTraceEnabled = true;
            inputTraceDeadlineMs = nowMs + 90000u;
            Serial.printf("GRIDOPOLY_INPUT_TRACE enabled=1 ms=%lu duration_ms=90000\n",
                          static_cast<unsigned long>(nowMs));
        } else if (!overflow && std::strcmp(line, "INPUT TRACE OFF") == 0) {
            inputTraceEnabled = false;
            printInputStatus(nowMs);
            Serial.printf("GRIDOPOLY_INPUT_TRACE enabled=0 ms=%lu reason=command\n",
                          static_cast<unsigned long>(nowMs));
        } else if (!overflow && std::strcmp(line, "INPUT STATUS") == 0) {
            printInputStatus(nowMs);
        }
        length = 0;
        overflow = false;
    }
    if (inputTraceEnabled && static_cast<int32_t>(nowMs - inputTraceDeadlineMs) >= 0) {
        inputTraceEnabled = false;
        printInputStatus(nowMs);
        Serial.printf("GRIDOPOLY_INPUT_TRACE enabled=0 ms=%lu reason=deadline\n",
                      static_cast<unsigned long>(nowMs));
    }
    HardwareInputDiagnostic diagnostic{};
    for (uint8_t count = 0; count < 16 && hardwareInputPollDiagnostic(diagnostic); ++count) {
        if (!inputTraceEnabled) continue;
        char output[256];
        const int outputLength = snprintf(output, sizeof(output),
            "GRIDOPOLY_ROTARY_RAW ms=%lu raw=%u stable=%u step=%d invalid_total=%lu dropped=%lu queue=%u gap_us=%lu max_gap_us=%lu queue_drop=%lu tx_drop=%lu\n",
            static_cast<unsigned long>(diagnostic.timestampMs), diagnostic.rawPhases,
            diagnostic.stablePhases, diagnostic.emittedStep,
            static_cast<unsigned long>(diagnostic.invalidTransitions),
            static_cast<unsigned long>(diagnostic.droppedTraces), diagnostic.queueEntries,
            static_cast<unsigned long>(diagnostic.sampleGapUs),
            static_cast<unsigned long>(diagnostic.maxSampleGapUs),
            static_cast<unsigned long>(diagnostic.inputQueueDropped),
            static_cast<unsigned long>(inputTraceUsbDropped));
        writeInputDiagnostic(output, outputLength);
    }
}
#if GRIDOPOLY_PLAYER_TRANSPORT == GRIDOPOLY_TRANSPORT_WIFI_UDP
WifiUdpPlayerTransport transport;
#elif GRIDOPOLY_PLAYER_TRANSPORT == GRIDOPOLY_TRANSPORT_ESPNOW
EspNowPlayerTransport transport;
#else
DemoTransport transport;
#endif
// Render submission and presentation are distinct events. Keep the ticket tied
// to the semantic page so a delayed flush cannot acknowledge a newer movement.
void renderAppFrame(uint32_t nowMs)
{
    static uint32_t ticket = 0, room = 0, version = 0, auction = 0;
    static uint8_t target = 0xFF;
    static ScreenPage page = ScreenPage::Home;
    const bool barrierPage = app.nav.current.page == ScreenPage::MoveGuide ||
                             app.nav.current.page == ScreenPage::Auction;
    const bool same = barrierPage && page == app.nav.current.page &&
        room == app.authorityRoomId && version == app.stateVersion &&
        target == app.rollTarget && auction == app.auctionGeneration;
    if (same && ticket != 0 && lvgl_port_frame_ticket_presented(ticket)) {
        const bool firstMoveFrame = page == ScreenPage::MoveGuide &&
            !app.movementCueFramePresented && !app.rollAnimating;
        appNotifyFramePresented(app, nowMs);
        if (firstMoveFrame && app.movementCueFramePresented) {
            Serial.printf("GRIDOPOLY_CUE presented room=%lu version=%lu target=%u ticket=%lu ms=%lu\n",
                static_cast<unsigned long>(room), static_cast<unsigned long>(version), target,
                static_cast<unsigned long>(ticket), static_cast<unsigned long>(nowMs));
        }
    }
    uiRendererRender(app, nowMs);
#if GRIDOPOLY_BATTERY_ENABLED
    const auto batterySnapshot = batteryHardwareStatus(0);
    const uint32_t batteryNowMs = millis(); // after the worker snapshot, including its timestamps
    uiBatteryRender(batteryUi, batterySnapshot, batteryNowMs);
#endif
    if (!same || ticket == 0) {
        page = app.nav.current.page;
        room = app.authorityRoomId;
        version = app.stateVersion;
        target = app.rollTarget;
        auction = app.auctionGeneration;
        ticket = barrierPage ? lvgl_port_request_frame_ticket() : 0;
    }
}

bool ready = false;
bool lvglReady = false;
bool avatarSetupCacheHeld = false;
constexpr uint16_t kRgbBounceBufferRows = 40;
static_assert(480 % kRgbBounceBufferRows == 0 &&
              (480 / kRgbBounceBufferRows) % 2 == 0,
              "RGB bounce rows must divide the panel into an even number of blocks");

bool pageUsesRemoteTileArtwork(ScreenPage page)
{
    return page == ScreenPage::Home || page == ScreenPage::AssetDetail || page == ScreenPage::Build ||
           page == ScreenPage::MoveGuide || page == ScreenPage::TileEvent ||
           page == ScreenPage::CardReveal || page == ScreenPage::Purchase ||
           page == ScreenPage::Auction;
}

bool pageUsesRemoteAvatarArtwork(ScreenPage page)
{
    return page == ScreenPage::AvatarSetup || page == ScreenPage::PlayerReady ||
           page == ScreenPage::PlayerDetail || page == ScreenPage::Trade;
}

#if GRIDOPOLY_SELF_TEST == 1
constexpr size_t kTestCapacity = 16384;
constexpr uint32_t kCarouselPerfTransitionMs = 220;
constexpr uint32_t kCarouselPerfMinFrames = 6;
constexpr uint32_t kCarouselPerfMinFps = 24;
constexpr uint32_t kCarouselPerfMaxGapMs = 42;
constexpr uint32_t kPerfMaxFirstFrameMs = 80;
constexpr uint32_t kCarouselPerfObserveMs = 320;
constexpr uint32_t kCarouselPerfRetargetMs = 80;
constexpr uint32_t kCenterListPerfTransitionMs = 200;
constexpr uint32_t kCenterListPerfRetargetMs = 160;
constexpr uint32_t kCenterListPerfRequiredCoverageMs =
    kCenterListPerfTransitionMs + 2 * kCenterListPerfRetargetMs;
constexpr uint32_t kCenterListPerfMinSteadyIntervals = 10;
constexpr uint32_t kCenterListPerfColdMaxGapMs = 60;
// Anti-tearing can finish a second framebuffer sync after the first flush callback.
constexpr uint32_t kPerfSceneQuietMs = 250;
constexpr uint32_t kPerfSceneTimeoutMs = 2500;
constexpr uint32_t kPerfRevisionStride = 16;
constexpr uint8_t kPerfTraceCapacity = 16;
constexpr uint32_t kSelfTestCheckpointMagic = 0x47525034;
char testBuffer[kTestCapacity] = {};
RomConsoleStream testOutput(testBuffer, sizeof(testBuffer));

struct SelfTestCheckpoint {
    uint32_t magic;
    uint32_t inverseMagic;
    uint32_t componentPassed;
    uint32_t inverseComponentPassed;
};

RTC_NOINIT_ATTR SelfTestCheckpoint selfTestCheckpoint;

struct CarouselPerfResult {
    uint32_t frames = 0;
    uint32_t fps = 0;
    uint32_t firstFrameMs = 0;
    uint32_t maxGapMs = 0;
    uint32_t coverageMs = 0;
    uint32_t steadyIntervals = 0;
    uint32_t steadyFps = 0;
    uint32_t steadyCoverageMs = 0;
    uint16_t gaps[kPerfTraceCapacity]{};
    uint16_t renderTimes[kPerfTraceCapacity]{};
    uint32_t pixelCounts[kPerfTraceCapacity]{};
    uint32_t submitUs[kPerfTraceCapacity]{}, waitUs[kPerfTraceCapacity]{};
    uint32_t copyUs[kPerfTraceCapacity]{}, rectUs[kPerfTraceCapacity]{}, glyphUs[kPerfTraceCapacity]{};
    GridopolyDrawProfile drawProfiles[kPerfTraceCapacity]{};
    uint8_t traceCount = 0;
    uint32_t incrementalRenders = 0;
    uint32_t rebuildRenders = 0;
    bool passed = false;
};

enum class PerfScenario : uint8_t {
    WaitingForward,
    WaitingReverseWrap,
    MyTurnFive,
    Retarget,
    SwipeEvent,
    AssetsListCold,
    AssetsListWarm,
};

struct CarouselPerfProbe {
    volatile bool armed = false;
    volatile uint32_t startedMs = 0;
    volatile uint32_t requiredCoverageMs = 0;
    volatile uint32_t previousFrameMs = 0;
    volatile uint32_t lastFrameMs = 0;
    volatile uint32_t frames = 0;
    volatile uint32_t firstFrameMs = 0;
    volatile uint32_t maxGapMs = 0;
    volatile uint16_t gaps[kPerfTraceCapacity]{};
    volatile uint16_t renderTimes[kPerfTraceCapacity]{};
    volatile uint32_t pixelCounts[kPerfTraceCapacity]{};
    volatile uint32_t submitUs[kPerfTraceCapacity]{}, waitUs[kPerfTraceCapacity]{};
    volatile uint32_t copyUs[kPerfTraceCapacity]{}, rectUs[kPerfTraceCapacity]{}, glyphUs[kPerfTraceCapacity]{};
    // Written/read while holding the LVGL mutex; no callback serial output.
    GridopolyDrawProfile drawProfiles[kPerfTraceCapacity]{};
    void (*previousMonitor)(lv_disp_drv_t *, uint32_t, uint32_t) = nullptr;
};

struct SceneSettleProbe {
    volatile bool watching = false;
    volatile uint32_t frames = 0;
    volatile uint32_t lastFrameMs = 0;
    void (*previousMonitor)(lv_disp_drv_t *, uint32_t, uint32_t) = nullptr;
};

CarouselPerfProbe carouselPerfProbe{};
SceneSettleProbe sceneSettleProbe{};
uint32_t perfRevisionSeed = 1000;

constexpr bool carouselPerfMeetsGate(uint32_t frames, uint32_t fps,
                                     uint32_t maxGapMs, uint32_t coverageMs,
                                     uint32_t requiredCoverageMs = kCarouselPerfTransitionMs,
                                     uint32_t firstFrameMs = 0)
{
    return frames >= kCarouselPerfMinFrames && fps >= kCarouselPerfMinFps &&
           firstFrameMs <= kPerfMaxFirstFrameMs &&
           maxGapMs <= kCarouselPerfMaxGapMs &&
           requiredCoverageMs >= kCarouselPerfTransitionMs &&
           coverageMs >= requiredCoverageMs;
}

constexpr bool centerListPerfMeetsGate(uint32_t steadyIntervals, uint32_t steadyFps,
                                       uint32_t maxGapMs, uint32_t coverageMs,
                                       uint32_t firstFrameMs = 0,
                                       uint32_t maxAllowedGapMs = kCarouselPerfMaxGapMs)
{
    return steadyIntervals >= kCenterListPerfMinSteadyIntervals &&
           steadyFps >= kCarouselPerfMinFps &&
           firstFrameMs <= kPerfMaxFirstFrameMs &&
           maxGapMs <= maxAllowedGapMs &&
           coverageMs >= kCenterListPerfRequiredCoverageMs;
}

constexpr bool perfCoverageReached(uint32_t nowMs, uint32_t startedMs,
                                   uint32_t requiredCoverageMs)
{
    return nowMs - startedMs >= requiredCoverageMs;
}

static_assert(carouselPerfMeetsGate(6, 24, 42, 220), "carousel performance boundary must pass");
static_assert(!carouselPerfMeetsGate(5, 24, 42, 220), "carousel frame count must span the transition");
static_assert(!carouselPerfMeetsGate(6, 23, 42, 220), "carousel FPS floor must be enforced");
static_assert(!carouselPerfMeetsGate(6, 24, 43, 220), "carousel frame gap ceiling must be enforced");
static_assert(!carouselPerfMeetsGate(6, 24, 42, 220, 220, 81),
              "carousel first-frame latency ceiling must be enforced");
static_assert(!carouselPerfMeetsGate(6, 24, 42, 219), "carousel measurement must span 220ms");
static_assert(carouselPerfMeetsGate(8, 24, 42, 300, 300),
              "retarget performance boundary must span both visible transitions");
static_assert(centerListPerfMeetsGate(10, 24, 42, 520),
              "center-list performance boundary must pass");
static_assert(!centerListPerfMeetsGate(9, 24, 42, 520),
              "center-list steady interval floor must be enforced");
static_assert(!centerListPerfMeetsGate(10, 23, 42, 520),
              "center-list steady FPS floor must be enforced");
static_assert(centerListPerfMeetsGate(10, 24, 60, 520, 80,
                                     kCenterListPerfColdMaxGapMs),
              "center-list cold exposure has an explicit bounded gap");
static_assert(!centerListPerfMeetsGate(10, 24, 61, 520, 80,
                                      kCenterListPerfColdMaxGapMs),
              "center-list cold exposure gap ceiling must be enforced");
static_assert(!centerListPerfMeetsGate(10, 24, 42, 520, 81),
              "center-list first-frame latency ceiling must be enforced");
static_assert(kPerfRevisionStride > 2,
              "each performance scene needs revisions beyond its input sequence");
static_assert(!perfCoverageReached(219, 0, 220),
              "performance probe must remain armed before full transition coverage");
static_assert(perfCoverageReached(220, 0, 220),
              "performance probe must stop at exact transition coverage");
static_assert(perfCoverageReached(0x00000020U, 0xfffffff0U, 48),
              "performance probe coverage must remain wrap safe");

void carouselPerfMonitor(lv_disp_drv_t *driver, uint32_t renderMs, uint32_t pixelCount)
{
    if (carouselPerfProbe.armed && pixelCount > 0) {
        const uint32_t nowMs = millis();
        const uint32_t gapMs = nowMs - carouselPerfProbe.previousFrameMs;
        carouselPerfProbe.previousFrameMs = nowMs;
        carouselPerfProbe.lastFrameMs = nowMs;
        if (carouselPerfProbe.frames == 0) {
            carouselPerfProbe.firstFrameMs = gapMs;
        } else if (gapMs > carouselPerfProbe.maxGapMs) {
            carouselPerfProbe.maxGapMs = gapMs;
        }
        if (carouselPerfProbe.frames < kPerfTraceCapacity) {
            const uint8_t index = static_cast<uint8_t>(carouselPerfProbe.frames);
            carouselPerfProbe.gaps[index] = static_cast<uint16_t>(gapMs);
            carouselPerfProbe.renderTimes[index] = static_cast<uint16_t>(renderMs);
            carouselPerfProbe.pixelCounts[index] = pixelCount;
            carouselPerfProbe.submitUs[index] = lvgl_port_last_submit_us();
            carouselPerfProbe.waitUs[index] = lvgl_port_last_wait_us();
            const LvglRenderTimings timings = lvgl_port_last_render_timings();
            carouselPerfProbe.copyUs[index] = timings.copyUs;
            carouselPerfProbe.rectUs[index] = timings.rectUs;
            carouselPerfProbe.glyphUs[index] = timings.glyphUs;
            carouselPerfProbe.drawProfiles[index] = timings.details;
        }
        ++carouselPerfProbe.frames;
        if (perfCoverageReached(nowMs, carouselPerfProbe.startedMs,
                                carouselPerfProbe.requiredCoverageMs)) {
            carouselPerfProbe.armed = false;
        }
    }
    if (carouselPerfProbe.previousMonitor != nullptr) {
        carouselPerfProbe.previousMonitor(driver, renderMs, pixelCount);
    }
}

class CarouselPerfMonitorGuard {
public:
    bool install(lv_disp_t *target)
    {
        if (installed_ || target == nullptr || target->driver == nullptr ||
            target->driver->monitor_cb == carouselPerfMonitor) {
            return false;
        }
        display = target;
        carouselPerfProbe.previousMonitor = display->driver->monitor_cb;
        carouselPerfProbe.armed = true;
        installed_ = true;
        display->driver->monitor_cb = carouselPerfMonitor;
        return true;
    }

    bool restore()
    {
        carouselPerfProbe.armed = false;
        if (!installed_) return true;
        const bool ownsMonitor = display != nullptr && display->driver != nullptr &&
                                 display->driver->monitor_cb == carouselPerfMonitor;
        if (ownsMonitor) {
            display->driver->monitor_cb = carouselPerfProbe.previousMonitor;
        }
        display = nullptr;
        installed_ = false;
        return ownsMonitor;
    }

    ~CarouselPerfMonitorGuard() { restore(); }

private:
    lv_disp_t *display = nullptr;
    bool installed_ = false;
};

void sceneSettleMonitor(lv_disp_drv_t *driver, uint32_t renderMs, uint32_t pixelCount)
{
    if (sceneSettleProbe.watching && pixelCount > 0) {
        sceneSettleProbe.lastFrameMs = millis();
        ++sceneSettleProbe.frames;
    }
    if (sceneSettleProbe.previousMonitor != nullptr) {
        sceneSettleProbe.previousMonitor(driver, renderMs, pixelCount);
    }
}

bool waitForStablePerfScene(lv_disp_t *display)
{
    const uint32_t startedMs = millis();
    bool stable = false;
    while (millis() - startedMs < kPerfSceneTimeoutMs) {
        bool animationsRunning = true;
        if (lvgl_port_lock(100)) {
            animationsRunning = lv_anim_count_running() != 0;
            lvgl_port_unlock();
        }

        const uint32_t nowMs = millis();
        const uint32_t completedFrames = sceneSettleProbe.frames;
        const uint32_t lastFrameMs = sceneSettleProbe.lastFrameMs;
        if (completedFrames > 0 && !animationsRunning &&
            nowMs - lastFrameMs >= kPerfSceneQuietMs) {
            stable = true;
            break;
        }
        delay(5);
    }

    if (!lvgl_port_lock(-1)) return false;
    sceneSettleProbe.watching = false;
    if (display != nullptr && display->driver != nullptr &&
        display->driver->monitor_cb == sceneSettleMonitor) {
        display->driver->monitor_cb = sceneSettleProbe.previousMonitor;
    } else {
        stable = false;
    }
    lvgl_port_unlock();
    return stable;
}

bool preparePerfScenario(AppState &state, PerfScenario scenario)
{
    if (!lvgl_port_lock(1000)) return false;
    lv_disp_t *display = lv_disp_get_default();
    if (display == nullptr || display->driver == nullptr ||
        display->refr_timer == nullptr ||
        display->driver->monitor_cb == carouselPerfMonitor ||
        display->driver->monitor_cb == sceneSettleMonitor) {
        lvgl_port_unlock();
        return false;
    }

    const uint32_t nowMs = millis();
    sceneSettleProbe.previousMonitor = display->driver->monitor_cb;
    sceneSettleProbe.frames = 0;
    sceneSettleProbe.lastFrameMs = nowMs;
    sceneSettleProbe.watching = true;
    display->driver->monitor_cb = sceneSettleMonitor;
    appInit(state, nowMs);
    state.toastUntilMs = 0;
    state.nav = NavigationState{};
    if (scenario == PerfScenario::AssetsListCold ||
        scenario == PerfScenario::AssetsListWarm) {
        state.nav.current = NavigationEntry{ScreenPage::Assets, 0, 0};
        state.page = ScreenPage::Assets;
        state.focus = 0;
        state.assetListIndex = 0;
    } else {
        state.homePhase = scenario == PerfScenario::MyTurnFive ||
                                  scenario == PerfScenario::Retarget
                              ? HomePhase::MyTurn
                              : HomePhase::Waiting;
        state.turnsUntilYou = state.homePhase == HomePhase::MyTurn ? 0 : 3;
        state.nav.current = NavigationEntry{ScreenPage::Home, 0, 0};
        state.page = ScreenPage::Home;
        state.focus = 0;
    }
    perfRevisionSeed += kPerfRevisionStride;
    state.revision = perfRevisionSeed;
    uiRendererRender(state, nowMs);
    lv_timer_ready(display->refr_timer);
    lvgl_port_unlock();
    return waitForStablePerfScene(display);
}

bool retargetCarouselFixture(AppState &state, int8_t delta = 1)
{
    if (!lvgl_port_lock(1000)) return false;
    const uint32_t nowMs = millis();
    appHandleInput(state, InputEvent{InputKind::Rotate, delta, nowMs}, nowMs);
    uiRendererRender(state, nowMs);
    lvgl_port_unlock();
    return true;
}

CarouselPerfResult runCarouselPerfFixture(AppState &state, PerfScenario scenario)
{
    CarouselPerfResult result{};
    CarouselPerfMonitorGuard monitorGuard;
    if (!preparePerfScenario(state, scenario)) return result;
    if (!lvgl_port_lock(1000)) return result;
    lv_disp_t *display = lv_disp_get_default();
    if (display == nullptr || display->driver == nullptr ||
        display->driver->monitor_cb == carouselPerfMonitor) {
        lvgl_port_unlock();
        return result;
    }

    carouselPerfProbe.frames = 0;
    carouselPerfProbe.firstFrameMs = 0;
    carouselPerfProbe.maxGapMs = 0;
    uiRendererResetTestStats();
    carouselPerfProbe.startedMs = millis();
    carouselPerfProbe.requiredCoverageMs = scenario == PerfScenario::Retarget
        ? kCarouselPerfTransitionMs + kCarouselPerfRetargetMs
        : (scenario == PerfScenario::AssetsListCold ||
           scenario == PerfScenario::AssetsListWarm
               ? kCenterListPerfRequiredCoverageMs
               : kCarouselPerfTransitionMs);
    carouselPerfProbe.previousFrameMs = carouselPerfProbe.startedMs;
    carouselPerfProbe.lastFrameMs = carouselPerfProbe.startedMs;
    if (!monitorGuard.install(display)) {
        lvgl_port_unlock();
        return result;
    }
    if (scenario == PerfScenario::WaitingReverseWrap) {
        appHandleInput(
            state,
            InputEvent{InputKind::Rotate, -1, carouselPerfProbe.startedMs},
            carouselPerfProbe.startedMs
        );
    } else if (scenario == PerfScenario::SwipeEvent) {
        appHandleUiEvent(
            state, UiEvent{UiEventKind::ListNext, 0}, carouselPerfProbe.startedMs
        );
    } else {
        appHandleInput(
            state,
            InputEvent{InputKind::Rotate, 1, carouselPerfProbe.startedMs},
            carouselPerfProbe.startedMs
        );
    }
    uiRendererRender(state, carouselPerfProbe.startedMs);
    lvgl_port_unlock();

    bool scenarioCompleted = true;
    if (scenario == PerfScenario::Retarget) {
        delay(kCarouselPerfRetargetMs);
        scenarioCompleted = retargetCarouselFixture(state);
    } else if (scenario == PerfScenario::AssetsListCold ||
               scenario == PerfScenario::AssetsListWarm) {
        delay(kCenterListPerfRetargetMs);
        scenarioCompleted = retargetCarouselFixture(state);
        delay(kCenterListPerfRetargetMs);
        scenarioCompleted = retargetCarouselFixture(state) && scenarioCompleted;
    }
    delay(kCarouselPerfObserveMs);

    if (!lvgl_port_lock(1000)) return result;
    scenarioCompleted = monitorGuard.restore() && scenarioCompleted;
    result.frames = carouselPerfProbe.frames;
    result.firstFrameMs = carouselPerfProbe.firstFrameMs;
    result.maxGapMs = carouselPerfProbe.maxGapMs;
    result.coverageMs = carouselPerfProbe.lastFrameMs - carouselPerfProbe.startedMs;
    result.traceCount = static_cast<uint8_t>(
        result.frames < kPerfTraceCapacity ? result.frames : kPerfTraceCapacity
    );
    for (uint8_t index = 0; index < result.traceCount; ++index) {
        result.gaps[index] = carouselPerfProbe.gaps[index];
        result.renderTimes[index] = carouselPerfProbe.renderTimes[index];
        result.pixelCounts[index] = carouselPerfProbe.pixelCounts[index];
        result.submitUs[index] = carouselPerfProbe.submitUs[index];
        result.waitUs[index] = carouselPerfProbe.waitUs[index];
        result.copyUs[index] = carouselPerfProbe.copyUs[index];
        result.rectUs[index] = carouselPerfProbe.rectUs[index];
        result.glyphUs[index] = carouselPerfProbe.glyphUs[index];
        result.drawProfiles[index] = carouselPerfProbe.drawProfiles[index];
    }
    const UiRendererTestStats rendererStats = uiRendererGetTestStats();
    result.incrementalRenders = rendererStats.incrementalRenders;
    result.rebuildRenders = rendererStats.rebuildRenders;
    lvgl_port_unlock();

    if (result.coverageMs > 0) {
        result.fps = result.frames * 1000U / result.coverageMs;
    }
    if (result.frames > 1 && result.coverageMs > result.firstFrameMs) {
        result.steadyIntervals = result.frames - 1;
        result.steadyCoverageMs = result.coverageMs - result.firstFrameMs;
        result.steadyFps = result.steadyIntervals * 1000U / result.steadyCoverageMs;
    }
    const bool incrementalOnly = result.incrementalRenders > 0 &&
                                 result.rebuildRenders == 0;
    if (scenario == PerfScenario::AssetsListCold ||
        scenario == PerfScenario::AssetsListWarm) {
        const uint32_t maxAllowedGap = scenario == PerfScenario::AssetsListCold
            ? kCenterListPerfColdMaxGapMs : kCarouselPerfMaxGapMs;
        result.passed = scenarioCompleted && incrementalOnly && centerListPerfMeetsGate(
            result.steadyIntervals, result.steadyFps,
            result.maxGapMs, result.coverageMs,
            result.firstFrameMs, maxAllowedGap
        );
    } else {
        const uint32_t requiredCoverage = scenario == PerfScenario::Retarget
            ? kCarouselPerfTransitionMs + kCarouselPerfRetargetMs
            : kCarouselPerfTransitionMs;
        result.passed = scenarioCompleted && incrementalOnly && carouselPerfMeetsGate(
            result.frames, result.fps, result.maxGapMs, result.coverageMs,
            requiredCoverage, result.firstFrameMs
        );
    }
    return result;
}

void printPerfResult(const char *marker, const CarouselPerfResult &result)
{
    esp_rom_printf(
        "%s frames=%u fps=%u first_frame_ms=%u max_gap_ms=%u coverage_ms=%u incremental=%u rebuild=%u %s\n",
        marker,
        static_cast<unsigned>(result.frames),
        static_cast<unsigned>(result.fps),
        static_cast<unsigned>(result.firstFrameMs),
        static_cast<unsigned>(result.maxGapMs),
        static_cast<unsigned>(result.coverageMs),
        static_cast<unsigned>(result.incrementalRenders),
        static_cast<unsigned>(result.rebuildRenders),
        result.passed ? "PASS" : "FAIL"
    );
    esp_rom_printf("%s DIAG", marker);
    for (uint8_t index = 0; index < result.traceCount; ++index) {
        esp_rom_printf(
            " [%u:%u/%u s=%lu w=%lu c=%lu r=%lu g=%lu]",
            static_cast<unsigned>(result.gaps[index]),
            static_cast<unsigned>(result.renderTimes[index]),
            static_cast<unsigned>(result.pixelCounts[index]),
            static_cast<unsigned long>(result.submitUs[index]),
            static_cast<unsigned long>(result.waitUs[index]),
            static_cast<unsigned long>(result.copyUs[index]),
            static_cast<unsigned long>(result.rectUs[index]),
            static_cast<unsigned long>(result.glyphUs[index])
        );
    }
    esp_rom_printf("\n");
    for (uint8_t index = 0; index < result.traceCount; ++index) {
        const GridopolyDrawProfile &p = result.drawProfiles[index];
        esp_rom_printf("%s DRAW frame=%u bg=%lu img=%lu border=%lu outline=%lu shadow=%lu mask_init=%lu mask_calc=%lu hit=%lu miss=%lu calls=%lu peak_us=%lu area=%d,%d,%d,%d clip=%d,%d,%d,%d radius=%d bw=%d sw=%d opa=%u flush_dropped=%u",
            marker, index, (unsigned long)p.bgUs, (unsigned long)p.bgImageUs,
            (unsigned long)p.borderUs, (unsigned long)p.outlineUs, (unsigned long)p.shadowUs,
            (unsigned long)p.maskInitUs, (unsigned long)p.maskCalcUs,
            (unsigned long)p.maskHits, (unsigned long)p.maskMisses, (unsigned long)p.rectCalls,
            (unsigned long)p.peakRectUs, p.peakArea.x1, p.peakArea.y1, p.peakArea.x2, p.peakArea.y2,
            p.peakClip.x1, p.peakClip.y1, p.peakClip.x2, p.peakClip.y2,
            p.peakRadius, p.peakBorder, p.peakShadow, p.peakOpacity, p.flushDropped);
        for (uint8_t region = 0; region < p.flushCount; ++region) {
            const lv_area_t &a = p.flushAreas[region];
            esp_rom_printf(" flush=%d,%d,%d,%d", a.x1, a.y1, a.x2, a.y2);
        }
        esp_rom_printf("\n");
    }
    if (result.steadyIntervals > 0) {
        esp_rom_printf(
            "%s STEADY intervals=%u fps=%u coverage_ms=%u\n",
            marker,
            static_cast<unsigned>(result.steadyIntervals),
            static_cast<unsigned>(result.steadyFps),
            static_cast<unsigned>(result.steadyCoverageMs)
        );
    }
}
#endif

void fault(const char *code)
{
    ready = false;
    Serial.printf("Gridopoly fault: %s\n", code);
    if (!lvglReady || !lvgl_port_lock(-1)) return;
    uiRendererShowFault(code);
    lvgl_port_unlock();
}

} // namespace

void setup()
{
    Serial.begin(115200);
    Serial.setTxTimeoutMs(0);
    delay(200);

#if GRIDOPOLY_SELF_TEST == 1
    const bool resumedComponentPhase =
        esp_reset_reason() == ESP_RST_SW &&
        selfTestCheckpoint.magic == kSelfTestCheckpointMagic &&
        selfTestCheckpoint.inverseMagic == ~kSelfTestCheckpointMagic &&
        selfTestCheckpoint.componentPassed <= 1 &&
        selfTestCheckpoint.inverseComponentPassed == ~selfTestCheckpoint.componentPassed;
    if (!resumedComponentPhase) {
        // The uploader releases native USB after this boot has already started.
        delay(3000);
        testOutput.reset();
        const bool cleanStart = !lv_is_initialized();
        const bool componentTestsPassed = runLvglComponentTests(testOutput);
        const bool cleanObjects = lv_disp_get_next(nullptr) == nullptr &&
                                  lv_indev_get_next(nullptr) == nullptr;
        const bool componentPhasePassed = cleanStart && componentTestsPassed && cleanObjects;
        testOutput.printf(
            "[%s] fake-display component phase releases every display and input\n",
            cleanObjects ? "PASS" : "FAIL"
        );
        selfTestCheckpoint.componentPassed = componentPhasePassed ? 1U : 0U;
        selfTestCheckpoint.inverseComponentPassed = ~selfTestCheckpoint.componentPassed;
        selfTestCheckpoint.inverseMagic = ~kSelfTestCheckpointMagic;
        selfTestCheckpoint.magic = kSelfTestCheckpointMagic;
        esp_rom_printf("%s\n", testOutput.data());
        esp_rom_printf("COMPONENT TESTS %s\n", componentPhasePassed ? "PASS" : "FAIL");
        delay(100);
        esp_restart();
        while (true) delay(1000);
    }

    const bool componentPassed = selfTestCheckpoint.componentPassed == 1U;
    selfTestCheckpoint.magic = 0;
    selfTestCheckpoint.inverseMagic = 0;
    selfTestCheckpoint.componentPassed = 0;
    selfTestCheckpoint.inverseComponentPassed = 0;
    testOutput.reset();
    resetLogicTestFailure();
    const bool cleanBeforePure = !lv_is_initialized();
    esp_rom_printf("SELFTEST STACK before_pure configured=%u highwater=%lu\n",
                   static_cast<unsigned>(getArduinoLoopTaskStackSize()),
                   static_cast<unsigned long>(uxTaskGetStackHighWaterMark(nullptr)));
    const bool pureTestsPassed = runPureLogicTests(testOutput);
    esp_rom_printf("SELFTEST STACK after_pure highwater=%lu pure=%u\n",
                   static_cast<unsigned long>(uxTaskGetStackHighWaterMark(nullptr)),
                   pureTestsPassed ? 1U : 0U);
    const bool cleanAfterPure = !lv_is_initialized();
    const bool purePassed = cleanBeforePure && pureTestsPassed && cleanAfterPure;
    testOutput.printf(
        "[%s] pure logic leaves LVGL uninitialized before physical port setup\n",
        cleanBeforePure && cleanAfterPure ? "PASS" : "FAIL"
    );
#endif

    Board *board = new (std::nothrow) Board();
    if (board == nullptr || !board->init()) { fault("BOARD_INIT"); return; }
#if LVGL_PORT_AVOID_TEARING_MODE
    auto lcd = board->getLCD();
    lcd->configFrameBufferNumber(LVGL_PORT_DISP_BUFFER_NUM);
#if ESP_PANEL_DRIVERS_BUS_ENABLE_RGB && CONFIG_IDF_TARGET_ESP32S3
    auto lcdBus = lcd->getBus();
    if (lcdBus->getBasicAttributes().type == ESP_PANEL_BUS_TYPE_RGB) {
#if GRIDOPOLY_DISPLAY_PCLK_HZ != 0
        if (!static_cast<BusRGB *>(lcdBus)->configRGB_FreqHz(kDisplayRequestedPclkHz)) {
            fault("RGB_CLOCK_CONFIG"); return;
        }
#endif
        // The board default is ten rows. Keeping forty rows in internal SRAM
        // reduces RGB scan starvation risk during sustained Wi-Fi/PSRAM traffic.
        static_cast<BusRGB *>(lcdBus)->configRGB_BounceBufferSize(
            lcd->getFrameWidth() * kRgbBounceBufferRows
        );
    }
#endif
#endif
    if (!board->begin()) { fault("BOARD_BEGIN"); return; }

    // Touch and pixels share the same mechanically corrected coordinate system.
    if (!lvgl_port_init(board->getLCD(), board->getTouch())) { fault("LVGL_INIT"); return; }
    lvglReady = true;
    if (!hardwareInputBegin()) { fault("INPUT_INIT"); return; }

    const uint32_t startedMs = millis();
#if GRIDOPOLY_BATTERY_ENABLED
    batteryHardwareBegin(startedMs);
#endif
    appInit(app, startedMs, GRIDOPOLY_PLAYER_TRANSPORT != GRIDOPOLY_TRANSPORT_DEMO);
    Serial.printf("GRIDOPOLY_PLAYER_BUILD movement_cue=17 compiled=%s %s\n", __DATE__, __TIME__);
    transport.begin(startedMs);
#if GRIDOPOLY_PLAYER_TRANSPORT == GRIDOPOLY_TRANSPORT_WIFI_UDP
    remoteTileCacheBegin();
    remoteAvatarCacheBegin();
#endif
    if (!lvgl_port_lock(-1)) { fault("LVGL_LOCK"); return; }
    const bool rendererReady = uiRendererBegin();
    if (rendererReady) {
        const uint32_t renderedMs = millis();
        renderAppFrame(renderedMs);
    }
    lvgl_port_unlock();
    if (!rendererReady) { fault("UI_INIT"); return; }

#if GRIDOPOLY_SELF_TEST == 1
    // Leave enough time to attach a monitor after the uploader resets native USB.
    delay(12000);
    // One diagnostic boot keeps the outer cull enabled and compares the
    // bounded large-radius cache. Serial output follows both suites.
    const size_t resultBytes = sizeof(CarouselPerfResult) * 14;
    auto *perfResults = static_cast<CarouselPerfResult *>(
        heap_caps_malloc(resultBytes, MALLOC_CAP_SPIRAM | MALLOC_CAP_8BIT));
    if (perfResults == nullptr) { fault("PERF_RESULTS_ALLOC"); return; }
    for (uint8_t slot = 0; slot < 14; ++slot) {
        new (&perfResults[slot]) CarouselPerfResult{};
    }
    CarouselPerfResult *outerClipBaseline = perfResults;
    esp_rom_printf("SELFTEST PERF STORAGE bytes=%u internal_free=%u internal_largest=%u psram_free=%u\n",
        static_cast<unsigned>(resultBytes),
        static_cast<unsigned>(heap_caps_get_free_size(MALLOC_CAP_INTERNAL | MALLOC_CAP_8BIT)),
        static_cast<unsigned>(heap_caps_get_largest_free_block(MALLOC_CAP_INTERNAL | MALLOC_CAP_8BIT)),
        static_cast<unsigned>(heap_caps_get_free_size(MALLOC_CAP_SPIRAM)));

    const PerfScenario baselineScenarios[] = {
        PerfScenario::WaitingForward, PerfScenario::WaitingReverseWrap,
        PerfScenario::MyTurnFive, PerfScenario::Retarget, PerfScenario::SwipeEvent,
        PerfScenario::AssetsListCold, PerfScenario::AssetsListWarm
    };
    if (!lvgl_port_lock(-1)) { heap_caps_free(perfResults); fault("LVGL_PROFILE_LOCK"); return; }
    gridopoly_profile_outer_clip_enabled = true;
    gridopoly_set_row_clip(true);
    gridopoly_set_large_circle_cache(false);
    lvgl_port_unlock();
    for (uint8_t scene = 0; scene < 7; ++scene) {
        outerClipBaseline[scene] = runCarouselPerfFixture(app, baselineScenarios[scene]);
    }
    if (!lvgl_port_lock(-1)) { heap_caps_free(perfResults); fault("LVGL_PROFILE_LOCK"); return; }
    gridopoly_profile_outer_clip_enabled = true;
    gridopoly_set_row_clip(true);
    gridopoly_set_large_circle_cache(true);
    lvgl_port_unlock();
    CarouselPerfResult &waitingForward = perfResults[7];
    CarouselPerfResult &waitingReverseWrap = perfResults[8];
    CarouselPerfResult &myTurnFive = perfResults[9];
    CarouselPerfResult &retarget = perfResults[10];
    CarouselPerfResult &swipeEvent = perfResults[11];
    CarouselPerfResult &assetsListCold = perfResults[12];
    CarouselPerfResult &assetsListWarm = perfResults[13];
    waitingForward = runCarouselPerfFixture(
        app, PerfScenario::WaitingForward
    );
    waitingReverseWrap = runCarouselPerfFixture(
        app, PerfScenario::WaitingReverseWrap
    );
    myTurnFive = runCarouselPerfFixture(
        app, PerfScenario::MyTurnFive
    );
    retarget = runCarouselPerfFixture(
        app, PerfScenario::Retarget
    );
    swipeEvent = runCarouselPerfFixture(
        app, PerfScenario::SwipeEvent
    );
    assetsListCold = runCarouselPerfFixture(
        app, PerfScenario::AssetsListCold
    );
    assetsListWarm = runCarouselPerfFixture(
        app, PerfScenario::AssetsListWarm
    );
    const bool livePerfPassed = waitingForward.passed && waitingReverseWrap.passed &&
                                myTurnFive.passed && retarget.passed &&
                                swipeEvent.passed && assetsListCold.passed &&
                                assetsListWarm.passed;
    const bool passed = purePassed && componentPassed && livePerfPassed;
    esp_rom_printf("SELFTEST PERF VARIANTS outer_clip=1 row_clip=1 split_limit=50 baseline_large_cache=0 candidate_large_cache=1\n");
    const char *baselineMarkers[] = {
        "BASELINE CAROUSEL PERF WAIT_FWD", "BASELINE CAROUSEL PERF WAIT_WRAP_REV",
        "BASELINE CAROUSEL PERF MYTURN_5", "BASELINE CAROUSEL PERF RETARGET",
        "BASELINE CAROUSEL PERF SWIPE_EVENT", "BASELINE LIST PERF ASSETS_SCROLL_COLD",
        "BASELINE LIST PERF ASSETS_SCROLL_WARM"
    };
    for (uint8_t scene = 0; scene < 7; ++scene) {
        printPerfResult(baselineMarkers[scene], outerClipBaseline[scene]);
    }
    esp_rom_printf("%s\n", testOutput.data());
    printPerfResult("CAROUSEL PERF WAIT_FWD", waitingForward);
    printPerfResult("CAROUSEL PERF WAIT_WRAP_REV", waitingReverseWrap);
    printPerfResult("CAROUSEL PERF MYTURN_5", myTurnFive);
    printPerfResult("CAROUSEL PERF RETARGET", retarget);
    printPerfResult("CAROUSEL PERF SWIPE_EVENT", swipeEvent);
    printPerfResult("LIST PERF ASSETS_SCROLL_COLD", assetsListCold);
    printPerfResult("LIST PERF ASSETS_SCROLL_WARM", assetsListWarm);
    for (uint8_t slot = 0; slot < 14; ++slot) perfResults[slot].~CarouselPerfResult();
    heap_caps_free(perfResults);
    perfResults = nullptr;
    esp_rom_printf("SELFTEST SUMMARY pure=%u component=%u perf=%u clean_before=%u clean_after=%u\n",
                   purePassed ? 1U : 0U, componentPassed ? 1U : 0U,
                   livePerfPassed ? 1U : 0U, cleanBeforePure ? 1U : 0U,
                   cleanAfterPure ? 1U : 0U);
    esp_rom_printf("SELFTEST FIRST FAILURE %s\n", firstLogicTestFailure());
    esp_rom_printf("%s\n", passed ? "SELFTEST PASS" : "SELFTEST FAILED");
    if (!passed) while (true) delay(1000);
#endif

    ready = true;
    Serial.printf("Gridopoly Player Console ready; mechanical=%d firmware=%d\n",
                  kMechanicalCorrectionDeg, kFirmwareRotationDeg);
}

void loop()
{
    if (!ready) { delay(5); return; }
    const uint32_t nowMs = millis();
    TransportCommand command{};
    TransportEvent transportEvent{};
    serviceInputTrace(nowMs);
    touchTraceService(millis()); // bounded USB writes outside the LVGL lock
#if GRIDOPOLY_BATTERY_ENABLED
    batteryHardwareTick(millis());
#endif
    dispatchInputBatch(hardwareInputPoll, [&](const InputEvent &input) {
        const uint8_t beforeCommands = app.commandCount;
        const ScreenPage beforePage = app.page;
        const uint8_t beforeFocus = app.focus;
        const bool beforeEditing = app.identity.editingValue;
        const TransportAvatarRecipe beforeRecipe = app.identity.draftRecipe;
        appHandleInput(app, input, nowMs);
        // Per-detent diagnostics are opt-in, like the raw phase trace. Avoid
        // filling USB CDC with two lines per step during normal play.
        if (!inputTraceEnabled) return;
        Serial.printf(
            "GRIDOPOLY_INPUT kind=%u delta=%d page=%u focus=%u queued=%u auth=%u catalog=%u pending=%04x input_ms=%lu consumed_ms=%lu\n",
            static_cast<unsigned>(input.kind), input.delta, static_cast<unsigned>(app.page),
            app.focus, static_cast<unsigned>(app.commandCount - beforeCommands),
            app.authorityOnline ? 1u : 0u, app.boardCatalogCompatible ? 1u : 0u,
            app.pendingCommandMask, static_cast<unsigned long>(input.timestampMs),
            static_cast<unsigned long>(millis())
        );
        if (beforePage == ScreenPage::AvatarSetup || app.page == ScreenPage::AvatarSetup) {
            const TransportAvatarRecipe &after = app.identity.draftRecipe;
            Serial.printf(
                "GRIDOPOLY_AVATAR_INPUT input_ms=%lu consumed_ms=%lu delta=%d focus=%u->%u editing=%u->%u recipe=%u/%u/%u/%u/%u->%u/%u/%u/%u/%u\n",
                static_cast<unsigned long>(input.timestampMs), static_cast<unsigned long>(millis()),
                input.delta, beforeFocus, app.focus, beforeEditing ? 1u : 0u,
                app.identity.editingValue ? 1u : 0u,
                beforeRecipe.hairPresetId, beforeRecipe.hairColorId, beforeRecipe.facePresetId,
                beforeRecipe.skinToneId, beforeRecipe.outfitPresetId,
                after.hairPresetId, after.hairColorId, after.facePresetId,
                after.skinToneId, after.outfitPresetId);
        }
    });

    if (lvgl_port_lock(-1)) {
        // Apply the physical button request before newer queued touch actions.
        uiRendererServiceHandwriting(app, millis());
        TouchAction action = TouchAction::None;
        while (uiRendererPollTouch(action)) {
            const uint8_t beforeCommands = app.commandCount;
            appHandleTouch(app, action, nowMs);
            uiRendererServiceHandwriting(app, millis());
            Serial.printf(
                "GRIDOPOLY_TOUCH action=%u page=%u focus=%u queued=%u auth=%u catalog=%u pending=%04x\n",
                static_cast<unsigned>(action), static_cast<unsigned>(app.page), app.focus,
                static_cast<unsigned>(app.commandCount - beforeCommands),
                app.authorityOnline ? 1u : 0u, app.boardCatalogCompatible ? 1u : 0u,
                app.pendingCommandMask
            );
        }
        // Controller samples are captured by the LVGL input callback. A loop
        // timestamp taken before waiting for this lock can shorten letter idle.
        uiRendererServiceHandwriting(app, millis());
        lvgl_port_unlock();
    }

    while (appPollCommand(app, command)) {
        Serial.printf(
            "GRIDOPOLY_COMMAND dequeue kind=%u request=%lu app_version=%lu\n",
            static_cast<unsigned>(command.kind), static_cast<unsigned long>(command.requestId),
            static_cast<unsigned long>(command.stateVersion)
        );
        transport.send(command, nowMs);
    }
    transport.tick(nowMs);
    while (transport.poll(transportEvent)) appHandleTransportEvent(app, transportEvent, nowMs);
    // Timer callbacks may enqueue a press after the loop's initial clock read.
    // A pending release must be consumed before elapsed time can trigger a hold.
    appTick(app, millis(), hardwareInputPending());
#if GRIDOPOLY_PLAYER_TRANSPORT == GRIDOPOLY_TRANSPORT_WIFI_UDP
    if (appIdentityActive(app)) {
        avatarSetupCacheHeld = true;
    }
    if (app.page == ScreenPage::AvatarLoading) {
        remoteAvatarCachePreload(app.identity.draftRecipe);
        const RemoteAvatarPreloadProgress progress = remoteAvatarCachePreloadProgress();
        appUpdateAvatarPreloadProgress(app, progress.readyCount,
                                       progress.totalCount, progress.complete);
    } else if (app.page == ScreenPage::AvatarSetup) {
        remoteAvatarCacheRequestPreview(app.identity.draftRecipe);
    }
    const bool tileArtworkChanged = remoteTileCacheConsumeUpdate();
    const bool avatarArtworkChanged = remoteAvatarCacheConsumeUpdate();
    if ((tileArtworkChanged && pageUsesRemoteTileArtwork(app.page)) ||
        (avatarArtworkChanged && pageUsesRemoteAvatarArtwork(app.page))) {
        uiRendererInvalidateArtwork();
    }
#endif

    if (lvgl_port_lock(-1)) {
        // The reducer and input callbacks can advance timestamps while this
        // loop waits. Render after the lock with a clock no older than them.
        renderAppFrame(millis());
#if GRIDOPOLY_PLAYER_TRANSPORT == GRIDOPOLY_TRANSPORT_WIFI_UDP
        // The previous page's LVGL objects must be gone before their source
        // pixels are released. Workers defer setup cleanup while composing.
        if (!appIdentityActive(app) && avatarSetupCacheHeld) {
            remoteAvatarCacheReleaseSetup();
            avatarSetupCacheHeld = false;
        }
        if (app.page == ScreenPage::AvatarLoading || app.page == ScreenPage::AvatarSetup) {
            remoteAvatarCacheReleaseFinals();
        }
#endif
        lvgl_port_unlock();
    }
#if GRIDOPOLY_DISPLAY_DIAGNOSTIC
    serviceDisplayDiagnostic(millis());
#endif
    delay(2);
}
