Ha22yX/Gridopoly/Firmware/PlayerConsole/app_state.cpp

#include "app_state.h"

#include "app_config.h"
#include "demo_data.h"

#include <GridopolyCore.h>
#include <GridopolyProtocol.h>
#include <algorithm>
#include <cstring>
#include <limits.h>

namespace {

constexpr uint32_t kActionConfirmPosition = 1u << 1;
constexpr uint32_t kActionRoll = 1u << 0;
constexpr uint32_t kActionBuy = 1u << 2;
constexpr uint32_t kActionDecline = 1u << 3;
constexpr uint32_t kActionEndTurn = 1u << 4;
constexpr uint32_t kActionMortgage = 1u << 5;
constexpr uint32_t kActionUnmortgage = 1u << 6;
constexpr uint32_t kActionBuild = 1u << 7;
constexpr uint32_t kActionSellBuilding = 1u << 8;
constexpr uint32_t kActionTrade = 1u << 9;
constexpr uint32_t kActionPayDebt = 1u << 11;
constexpr uint32_t kActionDeclareBankruptcy = 1u << 12;
constexpr uint32_t kActionAuctionBid = 1u << 13;
constexpr uint32_t kActionAuctionPass = 1u << 14;
constexpr uint32_t kActionAuctionReady = 1u << 15;
constexpr uint32_t kActionCardContinue = 1u << 16;
constexpr uint32_t kDiceResultAnimationMs = 1900u;
constexpr uint32_t kDiceResultHoldMs = 700u;
constexpr uint32_t kExtraRollRewardMs = 2000u;
constexpr uint32_t kArrivalConfirmedHoldMs = 1200u;
constexpr uint32_t kCardDrawMinMs = 1400u;
constexpr uint32_t kCardResultSettleMs = 250u;
constexpr uint32_t kRollFailureHoldMs = 1200u;
constexpr uint32_t kEndTurnExitMs = 320u;
constexpr uint32_t kEndTurnMinimumPresentationMs = 1200u;
constexpr uint32_t kAuctionIntroMs = 1800u;
constexpr uint32_t kAuctionResultMs = 3000u;
constexpr uint32_t kPlayerDetailRequestTimeoutMs = 4500u;
constexpr uint32_t kPendingActionRecoveryMs = 8000u;
constexpr uint32_t kActivityBannerMs = 2800u;
constexpr uint8_t kHairPresetCount = 10;
constexpr uint8_t kHairColorCount = 20;
constexpr uint8_t kFacePresetCount = 10;
constexpr uint8_t kSkinToneCount = 8;
constexpr uint8_t kOutfitPresetCount = 10;
constexpr uint8_t kDebtContinuationReleaseHoldAndMove =
    static_cast<uint8_t>(gridopoly::core::DebtContinuation::ReleaseHoldAndMove);
constexpr uint8_t kDebtPaymentFee = static_cast<uint8_t>(gridopoly::core::EventKind::FeePaid);
constexpr uint8_t kDebtPaymentRent = static_cast<uint8_t>(gridopoly::core::EventKind::RentPaid);
constexpr uint8_t kDebtPaymentCard = static_cast<uint8_t>(gridopoly::core::EventKind::CardApplied);
constexpr uint8_t kTradeFlagSelfConfirmed = 1u << 0;
constexpr uint8_t kTradeFlagSelfLastEdited = 1u << 3;
constexpr uint8_t kTradeFlagTerminal = 1u << 5;
constexpr bool kTradeBackendAvailable =
    GRIDOPOLY_PLAYER_TRANSPORT != GRIDOPOLY_TRANSPORT_ESPNOW;

bool auctionOpening(const AppState &state)
{
    return (state.auctionFlags & 0x03u) == 0x03u ||
           (state.availableActions & kActionAuctionReady) != 0;
}

bool auctionKeyMatches(uint32_t generation, uint8_t assetIndex,
                       uint32_t expectedGeneration, uint8_t expectedAssetIndex)
{
    return generation != 0 && generation == expectedGeneration &&
           assetIndex != 0xFF && assetIndex == expectedAssetIndex;
}

bool auctionGenerationIsNewer(uint32_t candidate, uint32_t reference)
{
    return reference == 0 || static_cast<int32_t>(candidate - reference) > 0;
}

bool auctionProjectionIsOlder(const AppState &state, const TransportEvent &event)
{
    if (event.kind != TransportEventKind::AuthoritySnapshotApplied ||
        event.phase != AuthorityPhase::AwaitAuction ||
        (event.auctionFlags & 0x01u) == 0 || event.auctionGeneration == 0 ||
        state.seenAuctionGeneration == 0) {
        return false;
    }
    if (auctionKeyMatches(event.auctionGeneration, event.auctionAssetIndex,
                          state.completedAuctionGeneration,
                          state.completedAuctionAssetIndex)) {
        return true;
    }
    if (auctionKeyMatches(event.auctionGeneration, event.auctionAssetIndex,
                          state.seenAuctionGeneration, state.seenAuctionAssetIndex)) {
        return false;
    }
    return !auctionGenerationIsNewer(event.auctionGeneration,
                                     state.seenAuctionGeneration);
}

bool currentAuctionCompleted(const AppState &state)
{
    return auctionKeyMatches(state.auctionGeneration, state.auctionAssetIndex,
                             state.completedAuctionGeneration,
                             state.completedAuctionAssetIndex);
}

void clearAuctionRoomLifecycle(AppState &state)
{
    state.auctionPresentation = AuctionPresentationPhase::None;
    state.auctionPresentationUntilMs = 0;
    state.auctionResultAssetIndex = 0xFF;
    state.auctionWinnerPlayerId = 0;
    state.auctionResultAmount = 0;
    state.auctionAssetIndex = 0xFF;
    state.auctionCurrentBidderId = 0;
    state.auctionHighestBidderId = 0;
    state.auctionPassedMask = 0;
    state.auctionFlags = 0;
    state.auctionReadyMask = 0;
    state.auctionRequiredReadyMask = 0;
    state.auctionCurrentBid = 0;
    state.auctionMinimumBid = 0;
    state.auctionGeneration = 0;
    state.seenAuctionGeneration = 0;
    state.seenAuctionAssetIndex = 0xFF;
    state.completedAuctionGeneration = 0;
    state.completedAuctionAssetIndex = 0xFF;
    state.auctionReadyAttemptGeneration = 0;
    state.auctionReadyAttemptAssetIndex = 0xFF;
    state.auctionPassed = false;
}

void clearTradeRoomLifecycle(AppState &state)
{
    state.tradeOffer = TradeOfferState{};
    state.tradeGiveAssetMask = 0;
    state.tradeAmount = 0;
    state.tradeAssetListIndex = 0;
    state.tradeEntryMode = TradeEntryMode::HomeEditable;
    state.tradeReceiverPickerOpen = false;
    state.tradeReceiverPickerIndex = 0;
}

void clearActivityRoomLifecycle(AppState &state)
{
    state.activity = ActivityState{};
    state.activityListIndex = 0;
    state.lastGameEvent = TransportGameEvent{};
}

void clearCardPresentationState(AppState &state)
{
    state.cardPresentation = CardPresentationPhase::None;
    state.cardStartedMs = 0;
    state.cardRevealAtMs = 0;
    state.cardEventSequence = 0;
    state.pendingCardFlags = 0;
    state.cardIndex = 0;
    state.cardFlags = 0;
    state.cardTargetPlayerId = 0;
    state.cardTargetPosition = 0;
    state.cardOutcome = 0;
    state.cardInstanceId = 0;
    state.cardCatalogId = 0;
    state.cardEffectId = 0;
    state.cardAmount = 0;
    state.cardChance = false;
    state.cardResultValid = false;
    state.cardPresentationAcknowledged = false;
    state.cardEffectApplied = false;
}

void clearCardRoomLifecycle(AppState &state)
{
    clearCardPresentationState(state);
    state.seenCardInstanceId = 0;
    state.seenCardDrawEventSequence = 0;
    state.completedCardInstanceId = 0;
    state.completedCardDrawEventSequence = 0;
}

void clearExtraRollRoomLifecycle(AppState &state)
{
    state.extraRollPresentation = ExtraRollPresentationPhase::None;
    state.extraRollRewardStartedMs = 0;
    state.extraRollRewardUntilMs = 0;
    state.extraRollStreak = 0;
    state.extraRollDieA = 0;
    state.extraRollDieB = 0;
}

bool isIdentityPage(ScreenPage page)
{
    return page == ScreenPage::TagPairing ||
           page == ScreenPage::AvatarLoading || page == ScreenPage::AvatarSetup ||
           page == ScreenPage::NameReview ||
           page == ScreenPage::NameHandwriting || page == ScreenPage::PlayerReady;
}

bool tagPairAcceptsToken(const TransportTagPairSnapshot &pair)
{
    return pair.state == TransportTagPairState::ClearRequired ||
           pair.state == TransportTagPairState::AwaitingTag ||
           pair.state == TransportTagPairState::AlreadyBound ||
           pair.state == TransportTagPairState::MultipleTags;
}

bool tagPairPromptExpired(const AppState &state, uint32_t nowMs)
{
    return state.identity.tagPairPromptMaxAgeMs != 0 &&
           static_cast<uint32_t>(nowMs - state.identity.tagPairReceivedAtMs) >=
               state.identity.tagPairPromptMaxAgeMs;
}

void invalidateTagPairPrompt(AppState &state)
{
    state.identity.tagPairSnapshotFresh = false;
    state.identity.tagPairSuccessUntilMs = 0;
}

void clearIdentityRoomLifecycle(AppState &state)
{
    state.identity = IdentityState{};
}

bool cardDrawKeyMatches(uint16_t instanceId, uint32_t drawEventSequence,
                        uint16_t expectedInstanceId,
                        uint32_t expectedDrawEventSequence)
{
    return instanceId != 0 && drawEventSequence != 0 &&
           instanceId == expectedInstanceId &&
           drawEventSequence == expectedDrawEventSequence;
}

HomePhase presentedHomePhase(const AppState &state)
{
    if (state.endTurnPresentation == EndTurnPresentationPhase::Exiting) {
        return HomePhase::MyTurnEnd;
    }
    if (state.endTurnPresentation == EndTurnPresentationPhase::WaitingHold) {
        return HomePhase::Waiting;
    }
    return state.homePhase;
}

void clearEndTurnPresentation(AppState &state)
{
    state.endTurnPresentation = EndTurnPresentationPhase::None;
    state.endTurnPresentationStartedMs = 0;
    state.endTurnPresentationUntilMs = 0;
    state.endTurnAccepted = false;
}

void touchRevision(AppState &state)
{
    ++state.revision;
}

bool isOrdinaryPage(ScreenPage page);

bool activityEventVisible(uint8_t kind)
{
    switch (kind) {
        case 2:  // TurnStarted
        case 3:  // DiceRolled
        case 5:  // MoveCompleted
        case 6:  // PassedStart
        case 7:  // PurchaseOffered
        case 8:  // AssetPurchased
        case 9:  // RentPaid
        case 10: // FeePaid
        case 11: // CardApplied
        case 12: // SentToHold
        case 13: // ReleasedFromHold
        case 14: // AssetMortgaged
        case 15: // AssetUnmortgaged
        case 16: // BuildingChanged
        case 17: // AuctionSettled
        case 18: // PlayerBankrupt
        case 19: // TurnEnded
        case 20: // GameFinished
        case 21: // TradeSettled
        case 22: // AuctionStarted
        case 23: // AuctionBid
        case 24: // AuctionPassed
        case 25: // DebtOpened
        case 26: // DebtPaid
        case 28: // TradeCreated
        case 29: // TradeUpdated
        case 30: // TradeClosed
            return true;
        default:
            return false;
    }
}

bool activityPresentationSuppressed(const AppState &state)
{
    return !state.authorityOnline || state.nav.current.page == ScreenPage::Activity ||
           !isOrdinaryPage(state.nav.current.page) || state.modal.kind != ModalKind::None ||
           state.tradeReceiverPickerOpen || state.buttonHeld ||
           state.inlineEditField != InlineEditField::None ||
           state.endTurnPresentation == EndTurnPresentationPhase::Exiting;
}

ActivityEntry *activityEntryAt(AppState &state, uint8_t newestFirstIndex)
{
    if (newestFirstIndex >= state.activity.count) return nullptr;
    const uint8_t index = static_cast<uint8_t>(
        (state.activity.head + kActivityCapacity - 1u - newestFirstIndex) %
        kActivityCapacity
    );
    return &state.activity.entries[index];
}

const ActivityEntry *activityEntryAt(const AppState &state, uint8_t newestFirstIndex)
{
    if (newestFirstIndex >= state.activity.count) return nullptr;
    const uint8_t index = static_cast<uint8_t>(
        (state.activity.head + kActivityCapacity - 1u - newestFirstIndex) %
        kActivityCapacity
    );
    return &state.activity.entries[index];
}

bool dismissActivityBanner(AppState &state);
void dismissModal(AppState &state);

bool eventTouchesSelfOwnedAsset(const AppState &state,
                                const TransportGameEvent &event)
{
    if (state.selfSeatId == 0 || event.actorId == state.selfSeatId) {
        return false;
    }

    uint8_t assetIndex = event.assetIndex;
    // MoveCompleted carries the destination tile in amount rather than an
    // asset index. Resolve it through the current board so the arrival banner
    // itself can identify a self-owned destination before rent follows.
    if (assetIndex == 0xFF && event.kind == 5 && event.amount >= 0) {
        const gridopoly::core::BoardDefinition *board =
            gridopoly::core::BoardCatalog::findBySize(state.boardSize);
        if (board != nullptr && event.amount < board->tileCount) {
            assetIndex = board->tiles[event.amount].assetIndex;
        }
    }
    if (assetIndex == 0xFF) return false;

    // Rent/debt projections identify the creditor even if the matching
    // Authority projection is still one datagram behind the GameEvent.
    if ((event.kind == 9 || event.kind == 25 || event.kind == 26) &&
        event.targetId == state.selfSeatId) {
        return true;
    }

    return state.fullAuthoritySnapshotValid &&
           assetIndex < state.authorityAssetCount &&
           state.authorityAssets[assetIndex].ownerId == state.selfSeatId;
}

void appendActivity(AppState &state, const TransportEvent &event, uint32_t nowMs)
{
    if (!activityEventVisible(event.gameEvent.kind) || event.gameEvent.actorId == 0 ||
        event.gameEvent.actorId == state.selfSeatId) {
        return;
    }

    // Sequence de-duplication happens before this function. Therefore a
    // resync record that reaches here is still new to this console, not a
    // duplicate. The HUD is a latest-event surface: keep every record in the
    // history ring while the newest one immediately replaces the old banner.
    for (uint8_t row = 0; row < state.activity.count; ++row) {
        ActivityEntry *pending = activityEntryAt(state, row);
        if (pending != nullptr) pending->announced = true;
    }
    dismissActivityBanner(state);

    ActivityEntry &entry = state.activity.entries[state.activity.head];
    entry.event = event.gameEvent;
    entry.selfOwnedAsset = eventTouchesSelfOwnedAsset(state, event.gameEvent);
    entry.announced = state.nav.current.page == ScreenPage::Activity;
    state.activity.head = static_cast<uint8_t>(
        (state.activity.head + 1u) % kActivityCapacity
    );
    if (state.activity.count < kActivityCapacity) ++state.activity.count;

    if (!entry.announced && !activityPresentationSuppressed(state)) {
        entry.announced = true;
        state.activity.bannerSequence = entry.event.sequence;
        state.activity.bannerUntilMs = nowMs + kActivityBannerMs;
    }
}

bool dismissActivityBanner(AppState &state)
{
    if (state.activity.bannerSequence == 0 && state.activity.bannerUntilMs == 0) return false;
    state.activity.bannerSequence = 0;
    state.activity.bannerUntilMs = 0;
    return true;
}

bool acknowledgeActivityPresentation(AppState &state)
{
    bool changed = dismissActivityBanner(state);
    for (uint8_t row = 0; row < state.activity.count; ++row) {
        ActivityEntry *entry = activityEntryAt(state, row);
        if (entry == nullptr || entry->announced) continue;
        entry->announced = true;
        changed = true;
    }
    return changed;
}

bool startNextActivityBanner(AppState &state, uint32_t nowMs)
{
    if (state.activity.bannerSequence != 0 || activityPresentationSuppressed(state)) return false;
    for (uint8_t row = 0; row < state.activity.count; ++row) {
        ActivityEntry *entry = activityEntryAt(state, row);
        if (entry == nullptr || entry->announced) continue;
        entry->announced = true;
        state.activity.bannerSequence = entry->event.sequence;
        state.activity.bannerUntilMs = nowMs + kActivityBannerMs;
        for (uint8_t olderRow = static_cast<uint8_t>(row + 1);
             olderRow < state.activity.count; ++olderRow) {
            ActivityEntry *older = activityEntryAt(state, olderRow);
            if (older != nullptr) older->announced = true;
        }
        return true;
    }
    return false;
}

bool transportInterruptsInlineEditing(const AppState &state, const TransportEvent &event)
{
    if (state.page == ScreenPage::Build && state.inlineEditField == InlineEditField::BuildProperty &&
        !event.resync && (event.kind == TransportEventKind::StateSnapshotApplied ||
                          event.kind == TransportEventKind::AuthoritySnapshotApplied)) return false;
    if (event.kind == TransportEventKind::GameEventReceived ||
        event.kind == TransportEventKind::RosterSnapshotApplied) {
        return false;
    }
    if ((event.kind == TransportEventKind::PlayerCardDrawn ||
         event.kind == TransportEventKind::PlayerCardEffectApplied) &&
        event.cardPlayerId != state.selfSeatId) {
        return false;
    }
    return event.kind != TransportEventKind::None;
}

bool hasReachedDeadline(uint32_t nowMs, uint32_t deadlineMs)
{
    return static_cast<int32_t>(nowMs - deadlineMs) >= 0;
}

bool arrivalFlowLocked(const AppState &state)
{
    if (state.nav.current.page == ScreenPage::DiceStage) {
        return state.rollAnimating || state.rollResolved || state.rollFailed;
    }
    if (state.nav.current.page == ScreenPage::MoveGuide && state.moveArrivalPending) return true;
    if (state.nav.current.page == ScreenPage::TileEvent) {
        return state.authorityPhase == AuthorityPhase::AwaitDebt &&
               !state.landingEventAcknowledged;
    }
    return state.nav.current.page == ScreenPage::CardReveal &&
           (state.cardPresentation == CardPresentationPhase::Drawing ||
            state.cardPresentation == CardPresentationPhase::Revealed);
}

bool validDice(uint8_t dieA, uint8_t dieB)
{
    return dieA >= 1 && dieA <= 6 && dieB >= 1 && dieB <= 6;
}

bool releaseHoldDebt(const AppState &state)
{
    return state.authorityPhase == AuthorityPhase::AwaitDebt &&
           state.debtContinuation == kDebtContinuationReleaseHoldAndMove;
}

bool resyncContinuesCurrentRoll(const AppState &state, const TransportEvent &event,
                                bool roomChanged)
{
    if (roomChanged || event.kind != TransportEventKind::StateSnapshotApplied ||
        !event.resync || event.selfSeatId == 0 ||
        event.activePlayerId != event.selfSeatId) {
        return false;
    }
    // A doubles reward is a local one-shot continuation of the completed roll.
    // Repeated compact resyncs must not navigate away before its local display
    // deadline, otherwise the state remains Reward but the dedicated page is
    // no longer reachable.
    if (state.nav.current.page == ScreenPage::ExtraRollReward &&
        state.extraRollPresentation == ExtraRollPresentationPhase::Reward) {
        return event.phase == AuthorityPhase::AwaitRoll;
    }
    const bool presentationActive = state.rollAnimating || state.rollResolved ||
        state.rollPresentationComplete ||
        state.moveArrivalPending || state.nav.current.page == ScreenPage::DiceStage ||
        state.nav.current.page == ScreenPage::MoveGuide ||
        state.nav.current.page == ScreenPage::TileEvent;
    if (!presentationActive) return false;
    if (event.phase == AuthorityPhase::AwaitMoveConfirm && event.pendingTarget != 0xFF) {
        return state.rollTarget == 0xFF || state.rollTarget == event.pendingTarget;
    }
    // The server may resend the already-applied landing state while the local
    // confirmation is still being read. Preserve that same checkpoint/deadline;
    // a different position or phase must still rebuild from authority.
    if (state.nav.current.page == ScreenPage::MoveGuide && state.moveArrivalPending &&
        state.moveArrivalConfirmed && state.rollTarget != 0xFF &&
        event.playerPosition == state.rollTarget && event.phase == state.authorityPhase) {
        return true;
    }
    // StateSnapshot does not carry DebtContinuation. Preserve an in-flight
    // hold-release roll using the last full Authority projection until the
    // matching full projection refreshes the metadata.
    return event.phase == AuthorityPhase::AwaitDebt &&
           (releaseHoldDebt(state) || state.nav.current.page == ScreenPage::TileEvent ||
            (state.nav.current.page == ScreenPage::MoveGuide && state.moveArrivalPending));
}

void markRollResolved(AppState &state, uint8_t dieA, uint8_t dieB, uint32_t nowMs)
{
    if (!validDice(dieA, dieB) || state.rollResolved) return;
    if (!state.rollAnimating) {
        state.rollAnimating = true;
        state.rollStartedMs = nowMs;
    }
    state.dieA = dieA;
    state.dieB = dieB;
    state.rolledSteps = static_cast<uint8_t>(dieA + dieB);
    if (dieA == dieB) {
        if (state.extraRollPresentation != ExtraRollPresentationPhase::Ready) {
            state.extraRollPresentation = ExtraRollPresentationPhase::Pending;
        }
        state.extraRollRewardStartedMs = 0;
        state.extraRollRewardUntilMs = 0;
        state.extraRollDieA = dieA;
        state.extraRollDieB = dieB;
    } else {
        clearExtraRollRoomLifecycle(state);
    }
    if (state.rolledSteps == 0) return;
    if (!state.rollResolved) {
        state.rollResolved = true;
        state.rollRevealPresented = false;
        state.rollResolvedMs = nowMs;
        const uint32_t settledAtMs = state.rollStartedMs + kDiceResultAnimationMs;
        state.rollRevealMs = hasReachedDeadline(nowMs, settledAtMs) ? nowMs : settledAtMs;
    }
    state.rollFailed = false;
    state.rollFailedUntilMs = 0;
}

void noteArrivalTarget(AppState &state, uint8_t target)
{
    if (target == 0xFF) return;
    if (!state.moveArrivalPending || state.rollTarget != target) {
        state.landingEventAcknowledged = false;
    }
    state.rollTarget = target;
    state.moveArrivalPending = true;
}

bool isOrdinaryPage(ScreenPage page)
{
    switch (page) {
        case ScreenPage::Home:
        case ScreenPage::Assets:
        case ScreenPage::AssetDetail:
        case ScreenPage::Build:
        case ScreenPage::Players:
        case ScreenPage::PlayerDetail:
        case ScreenPage::PlayerAssets:
        case ScreenPage::PlayerFinance:
        case ScreenPage::Activity:
        case ScreenPage::Trade:
        case ScreenPage::TradeAssetSelect:
        case ScreenPage::TradeOffer:
        case ScreenPage::DemoLab:
        case ScreenPage::Debt:
            return true;
        case ScreenPage::DiceStage:
        case ScreenPage::ExtraRollReward:
        case ScreenPage::MoveGuide:
        case ScreenPage::TileEvent:
        case ScreenPage::CardReveal:
        case ScreenPage::DebtAssets:
        case ScreenPage::Bankruptcy:
        case ScreenPage::Purchase:
        case ScreenPage::Auction:
        case ScreenPage::AvatarLoading:
        case ScreenPage::TagPairing:
        case ScreenPage::GameOver:
        case ScreenPage::Spectator:
        case ScreenPage::WaitingForGame:
        case ScreenPage::AvatarSetup:
        case ScreenPage::NameReview:
        case ScreenPage::NameHandwriting:
        case ScreenPage::PlayerReady:
            return false;
    }
    return false;
}

bool isDebtAssetScreen(ScreenPage page)
{
    return page == ScreenPage::DebtAssets;
}

bool isInteractiveListPage(ScreenPage page)
{
    return isOrdinaryPage(page) || isDebtAssetScreen(page) ||
           page == ScreenPage::Purchase || page == ScreenPage::Auction ||
           page == ScreenPage::MoveGuide || page == ScreenPage::TileEvent ||
           page == ScreenPage::CardReveal || page == ScreenPage::AvatarSetup ||
           page == ScreenPage::NameReview || page == ScreenPage::NameHandwriting;
}

bool clearInlineEditing(AppState &state)
{
    if (state.inlineEditField == InlineEditField::None) return false;
    state.inlineEditField = InlineEditField::None;
    return true;
}

InlineEditField focusedTradeField(const AppState &state)
{
    if (state.nav.current.page != ScreenPage::Trade) return InlineEditField::None;
    if (appTradeReceiverLocked(state)) {
        return state.nav.current.focus == 1 ? InlineEditField::TradeAmount
                                            : InlineEditField::None;
    }
    if (state.nav.current.focus == 2) return InlineEditField::TradeAmount;
    return InlineEditField::None;
}

uint8_t tradeReceiverCandidateCount(const AppState &state)
{
    return state.playerCount > 1 ? static_cast<uint8_t>(state.playerCount - 1) : 0;
}

uint8_t tradeReceiverCandidateAt(const AppState &state, uint8_t candidateIndex)
{
    uint8_t ordinal = 0;
    for (uint8_t playerIndex = 0; playerIndex < state.playerCount; ++playerIndex) {
        if (playerIndex == static_cast<uint8_t>(state.selfSeatId - 1)) continue;
        if (ordinal++ == candidateIndex) return playerIndex;
    }
    return 0xFF;
}

void closeTradeReceiverPicker(AppState &state)
{
    if (!state.tradeReceiverPickerOpen) return;
    state.tradeReceiverPickerOpen = false;
    state.buttonHeld = false;
    state.holdActionConsumed = false;
    touchRevision(state);
}

void openTradeReceiverPicker(AppState &state)
{
    if (appTradeReceiverLocked(state)) return;
    const uint8_t count = tradeReceiverCandidateCount(state);
    if (count == 0) return;
    uint8_t selected = 0;
    for (uint8_t candidate = 0; candidate < count; ++candidate) {
        if (tradeReceiverCandidateAt(state, candidate) == state.tradeReceiver) {
            selected = candidate;
            break;
        }
    }
    clearInlineEditing(state);
    state.tradeReceiverPickerIndex = selected;
    state.tradeReceiverPickerOpen = true;
    state.buttonHeld = false;
    state.holdActionConsumed = false;
    touchRevision(state);
}

void commitTradeReceiverPicker(AppState &state)
{
    if (!state.tradeReceiverPickerOpen) return;
    const uint8_t count = tradeReceiverCandidateCount(state);
    if (state.tradeReceiverPickerIndex >= count) {
        closeTradeReceiverPicker(state);
        return;
    }
    const uint8_t candidate = tradeReceiverCandidateAt(
        state, state.tradeReceiverPickerIndex
    );
    if (candidate != 0xFF) state.tradeReceiver = candidate;
    closeTradeReceiverPicker(state);
}

uint8_t tradeAssetFocus(const AppState &state)
{
    return appTradeReceiverLocked(state) ? 0 : 1;
}

uint8_t tradeSubmitFocus(const AppState &state)
{
    return appTradeReceiverLocked(state) ? 2 : 3;
}

uint8_t contentCount(const AppState &state, ScreenPage page)
{
    switch (page) {
        case ScreenPage::Home: {
            HomeAction actions[5]{};
            return appHomeActions(state, actions);
        }
        case ScreenPage::Build: return 2;
        case ScreenPage::Assets: return appVisibleAssetCount(state);
        case ScreenPage::AssetDetail: return appAssetDetailActionCount(state);
        case ScreenPage::Players: return state.playerCount;
        case ScreenPage::PlayerDetail:
            if (state.playerDetail.loadState == PlayerDetailLoadState::Ready) return 4;
            return state.playerDetail.loadState == PlayerDetailLoadState::Loading ? 0 : 1;
        case ScreenPage::PlayerAssets: return state.playerDetail.assetCount;
        case ScreenPage::PlayerFinance: return state.playerDetail.financialRecordCount;
        case ScreenPage::Activity: return state.activity.count;
        case ScreenPage::Trade: return appTradeReceiverLocked(state) ? 3 : 4;
        case ScreenPage::TradeAssetSelect: return appTradeAssetCount(state);
        case ScreenPage::TradeOffer: return appTradeOfferActionCount(state);
        case ScreenPage::DemoLab: return 6;
        case ScreenPage::Debt: return 1;
        case ScreenPage::DiceStage:
            return 0;
        case ScreenPage::ExtraRollReward:
            return 1;
        case ScreenPage::MoveGuide: return 1;
        case ScreenPage::TileEvent: return 1;
        case ScreenPage::CardReveal:
            return state.cardPresentation == CardPresentationPhase::Revealed ? 1 : 0;
        case ScreenPage::DebtAssets: return appVisibleAssetCount(state);
        case ScreenPage::Bankruptcy: return 1;
        case ScreenPage::Purchase: return 2;
        case ScreenPage::Auction:
            return state.auctionPresentation == AuctionPresentationPhase::Live &&
                           !auctionOpening(state) &&
                           !state.auctionPassed && state.decisionPlayerId == state.selfSeatId &&
                           (state.availableActions & kActionAuctionPass) != 0 ? 2 : 0;
        case ScreenPage::AvatarLoading:
        case ScreenPage::WaitingForGame: return 0;
        case ScreenPage::TagPairing: return appTagPairCanManage(state) ? 2 : 0;
        case ScreenPage::GameOver:
        case ScreenPage::Spectator: return 0;
        case ScreenPage::AvatarSetup: return static_cast<uint8_t>(AvatarEditField::Count);
        case ScreenPage::NameReview: return 3;
        case ScreenPage::NameHandwriting: return 2;
        case ScreenPage::PlayerReady: return 0;
    }
    return 0;
}

uint8_t &listAnchor(AppState &state, ScreenPage page)
{
    switch (page) {
        case ScreenPage::Assets: return state.assetListIndex;
        case ScreenPage::Players: return state.playerListIndex;
        case ScreenPage::PlayerAssets: return state.playerAssetListIndex;
        case ScreenPage::PlayerFinance: return state.playerFinanceListIndex;
        case ScreenPage::Activity: return state.activityListIndex;
        case ScreenPage::TradeAssetSelect: return state.tradeAssetListIndex;
        case ScreenPage::DemoLab: return state.demoListIndex;
        case ScreenPage::Debt:
        case ScreenPage::DebtAssets: return state.debtListIndex;
        default: return state.nav.current.listAnchor;
    }
}

uint8_t listAnchor(const AppState &state, ScreenPage page)
{
    switch (page) {
        case ScreenPage::Assets: return state.assetListIndex;
        case ScreenPage::Players: return state.playerListIndex;
        case ScreenPage::PlayerAssets: return state.playerAssetListIndex;
        case ScreenPage::PlayerFinance: return state.playerFinanceListIndex;
        case ScreenPage::Activity: return state.activityListIndex;
        case ScreenPage::TradeAssetSelect: return state.tradeAssetListIndex;
        case ScreenPage::DemoLab: return state.demoListIndex;
        case ScreenPage::Debt:
        case ScreenPage::DebtAssets: return state.debtListIndex;
        default: return state.nav.current.listAnchor;
    }
}

void syncLegacyState(AppState &state)
{
    state.page = state.nav.current.page;
    state.focus = state.nav.current.focus;
}

void saveCurrentListAnchor(AppState &state)
{
    state.nav.current.listAnchor = listAnchor(state, state.nav.current.page);
}

void restoreListAnchor(AppState &state)
{
    const uint8_t count = contentCount(state, state.nav.current.page);
    if (count == 0) return;
    uint8_t anchor = state.nav.current.listAnchor;
    if (anchor >= count) anchor = count - 1;
    listAnchor(state, state.nav.current.page) = anchor;
}

void setFocus(AppState &state, uint8_t focus)
{
    state.nav.current.focus = focus;
    // Authority refreshes resume the identity page from this local focus.
    if (isIdentityPage(state.nav.current.page)) state.identity.focus = focus;
    const uint8_t count = contentCount(state, state.nav.current.page);
    if (state.nav.current.page != ScreenPage::Home && focus < count) {
        listAnchor(state, state.nav.current.page) = focus;
        state.nav.current.listAnchor = focus;
    }
    syncLegacyState(state);
    touchRevision(state);
}

void pulseListBoundary(AppState &state, int16_t delta)
{
    state.boundaryPulseDirection = delta < 0 ? -1 : 1;
    ++state.boundaryPulseRevision;
    touchRevision(state);
}

bool pushPage(AppState &state, ScreenPage page, uint8_t focus = 0)
{
    if (state.nav.depth >= sizeof(state.nav.stack) / sizeof(state.nav.stack[0])) return false;
    clearInlineEditing(state);
    state.tradeReceiverPickerOpen = false;
    saveCurrentListAnchor(state);
    state.nav.stack[state.nav.depth++] = state.nav.current;
    state.nav.current = NavigationEntry{page, focus, focus};
    const uint8_t count = contentCount(state, page);
    if (page != ScreenPage::Home && count != 0 && focus < count) {
        listAnchor(state, page) = focus;
    }
    syncLegacyState(state);
    touchRevision(state);
    return true;
}

void openActivity(AppState &state)
{
    if (state.activity.count == 0 || state.nav.current.page == ScreenPage::Activity) return;
    if (!pushPage(state, ScreenPage::Activity, 0)) return;
    for (uint8_t row = 0; row < state.activity.count; ++row) {
        ActivityEntry *entry = activityEntryAt(state, row);
        if (entry != nullptr) entry->announced = true;
    }
    dismissActivityBanner(state);
    touchRevision(state);
}

void openDemoLab(AppState &state)
{
    if (state.nav.depth >= sizeof(state.nav.stack) / sizeof(state.nav.stack[0])) return;
    pushPage(state, ScreenPage::DemoLab);
}

void replaceForcedPage(AppState &state, ScreenPage page)
{
    clearInlineEditing(state);
    state.nav.current = NavigationEntry{page, 0, 0};
    syncLegacyState(state);
    touchRevision(state);
}

void resetHome(AppState &state, uint8_t focus = 0)
{
    clearInlineEditing(state);
    state.nav = NavigationState{};
    state.nav.current = NavigationEntry{ScreenPage::Home, focus, 0};
    syncLegacyState(state);
    touchRevision(state);
}

void showToast(AppState &state, const char *message, uint32_t nowMs);

// Authority and animation updates can insert/remove Home actions. Preserve the
// action identity in both the visible menu and existing navigation stack.
struct HomeNavigationGuard {
    AppState &state;
    uint32_t nowMs;
    NavigationState before;
    HomeAction actions[5]{};
    uint8_t count;
    HomeNavigationGuard(AppState &s, uint32_t now) : state(s), nowMs(now), before(s.nav), count(appHomeActions(s, actions)) {}
    ~HomeNavigationGuard() {
        if (state.nav.current.page == ScreenPage::Build) {
            const bool changedContext = state.buildRoomId != state.authorityRoomId ||
                state.buildBoardSize != state.boardSize || state.buildOriginPosition != state.position;
            const bool invalidGroup = state.authorityOnline && appBuildSnapshotCurrent(state) &&
                !appBuildContextCurrent(state);
            if (changedContext || invalidGroup) {
                resetHome(state);
                showToast(state, "BUILD CONTEXT CHANGED", nowMs);
            } else if (!state.authorityOnline && state.inlineEditField == InlineEditField::BuildProperty) {
                clearInlineEditing(state);
            }
        }
        HomeAction current[5]{};
        const uint8_t currentCount = appHomeActions(state, current);
        if (count == currentCount && std::equal(actions, actions + count, current)) return;
        auto remap = [&](NavigationEntry &entry, const NavigationEntry &old) {
            if (entry.page != ScreenPage::Home || old.page != ScreenPage::Home ||
                entry.focus != old.focus || old.focus >= count) return;
            uint8_t fallback = 0;
            for (uint8_t i = 0; i < currentCount; ++i) {
                if (current[i] == actions[old.focus]) { entry.focus = i; return; }
                if (current[i] == HomeAction::Assets) fallback = i;
            }
            entry.focus = fallback;
        };
        remap(state.nav.current, before.current);
        for (uint8_t i = 0; i < state.nav.depth && i < before.depth; ++i) remap(state.nav.stack[i], before.stack[i]);
        syncLegacyState(state);
        touchRevision(state);
    }
};

uint8_t selfDoublesStreak(const AppState &state)
{
    for (uint8_t index = 0; index < state.playerCount && index < 6; ++index) {
        if (state.authorityPlayers[index].playerId == state.selfSeatId) {
            return state.authorityPlayers[index].doublesStreak;
        }
    }
    return 0;
}

void finishExtraRollReward(AppState &state)
{
    state.extraRollPresentation = ExtraRollPresentationPhase::Ready;
    state.extraRollRewardStartedMs = 0;
    state.extraRollRewardUntilMs = 0;
    resetHome(state, 0);
}

bool applyExtraRollAuthority(AppState &state, bool resync, uint32_t nowMs)
{
    const uint8_t streak = selfDoublesStreak(state);
    const bool ready = state.activePlayerId == state.selfSeatId &&
        state.authorityPhase == AuthorityPhase::AwaitRoll && streak != 0 &&
        (state.availableActions & kActionRoll) != 0;
    if (!ready) return false;

    state.extraRollStreak = streak;
    if (state.extraRollPresentation == ExtraRollPresentationPhase::Reward) {
        return true;
    }
    if (state.extraRollPresentation == ExtraRollPresentationPhase::Pending) {
        state.extraRollPresentation = ExtraRollPresentationPhase::Reward;
        state.extraRollRewardStartedMs = nowMs;
        state.extraRollRewardUntilMs = nowMs + kExtraRollRewardMs;
        replaceForcedPage(state, ScreenPage::ExtraRollReward);
        return true;
    }
    if (resync) {
        state.extraRollPresentation = ExtraRollPresentationPhase::Ready;
        state.extraRollRewardStartedMs = 0;
        state.extraRollRewardUntilMs = 0;
        if (state.nav.current.page != ScreenPage::Home) resetHome(state, 0);
        return true;
    }
    if (state.extraRollPresentation == ExtraRollPresentationPhase::None) {
        state.extraRollPresentation = ExtraRollPresentationPhase::Ready;
        if (!isOrdinaryPage(state.nav.current.page)) resetHome(state, 0);
    }
    return true;
}

void presentTradeOfferPage(AppState &state)
{
    clearInlineEditing(state);
    if (state.nav.current.page == ScreenPage::Home) {
        pushPage(state, ScreenPage::TradeOffer);
        return;
    }
    if (state.nav.current.page != ScreenPage::TradeOffer) {
        state.nav.current = NavigationEntry{ScreenPage::TradeOffer, 0, 0};
    } else {
        state.nav.current.focus = 0;
    }
    syncLegacyState(state);
    touchRevision(state);
}

void showToast(AppState &state, const char *message, uint32_t nowMs)
{
    state.toast = message;
    state.toastUntilMs = nowMs + 1800;
    touchRevision(state);
}

uint32_t legalDebtAssetMask(const AppState &state)
{
    uint32_t mask = state.debt.eligibleMask;
    const uint8_t count = state.fullAuthoritySnapshotValid ? state.authorityAssetCount : kAssetCount;
    for (uint8_t index = 0; index < count; ++index) {
        const bool locked = state.fullAuthoritySnapshotValid
            ? state.authorityAssets[index].ownerId != state.selfSeatId
            : kAssets[index].ruleLocked;
        if (appAssetMortgaged(state, index) || appAssetBuildingLevel(state, index) != 0 || locked) {
            mask &= ~(static_cast<uint32_t>(1u) << index);
        }
    }
    return mask;
}

int32_t saturateInt32(int64_t value)
{
    if (value > INT32_MAX) return INT32_MAX;
    if (value < INT32_MIN) return INT32_MIN;
    return static_cast<int32_t>(value);
}

int32_t unmortgageCost(const AppState &state, uint8_t assetIndex)
{
    const int64_t mortgageValue = appAssetMortgageValue(state, assetIndex);
    return saturateInt32(mortgageValue + (mortgageValue + 9) / 10);
}

uint8_t commandIndex(TransportCommandKind kind)
{
    return static_cast<uint8_t>(kind);
}

uint32_t commandMask(TransportCommandKind kind)
{
    return static_cast<uint32_t>(1u << commandIndex(kind));
}

bool queueCommand(AppState &state, TransportCommandKind kind, uint32_t transactionId, uint32_t nowMs,
                   uint32_t assetMask = 0, uint8_t targetPosition = 0,
                   uint8_t assetIndex = 0xFF, int32_t argument = 0,
                   uint8_t targetPlayerId = 0)
{
    if (appAwaitingGame(state) || appTagPairBlocksIdentity(state) || state.authorityPhase == AuthorityPhase::GameOver ||
        appSelfBankrupt(state)) return false;
    const uint8_t index = commandIndex(kind);
    const uint32_t mask = commandMask(kind);
    if (!state.authorityOnline || !state.boardCatalogCompatible || state.commandCount == 4 ||
        (state.pendingCommandMask & mask) != 0) return false;

    TransportCommand &command = state.commandQueue[state.commandTail];
    command = TransportCommand{};
    command.kind = kind;
    command.requestId = state.nextRequestId++;
    command.stateVersion = state.stateVersion;
    command.transactionId = transactionId;
    command.clientTimeMs = nowMs;
    command.assetMask = assetMask;
    command.assetIndex = assetIndex;
    command.argument = argument;
    command.targetPosition = targetPosition;
    command.targetPlayerId = targetPlayerId;
    state.commandTail = static_cast<uint8_t>((state.commandTail + 1) % 4);
    ++state.commandCount;
    state.pendingCommandMask |= mask;
    state.pendingRequestIds[index] = command.requestId;
    if (kind == TransportCommandKind::PayNow) state.pendingPayNowStartedMs = nowMs;
    return true;
}

TransportCommandKind tradeCommandKind(TransportTradeOperation operation)
{
    switch (operation) {
        case TransportTradeOperation::Query: return TransportCommandKind::TradeQuery;
        case TransportTradeOperation::Create: return TransportCommandKind::TradeCreate;
        case TransportTradeOperation::Update: return TransportCommandKind::TradeUpdate;
        case TransportTradeOperation::Confirm: return TransportCommandKind::TradeConfirm;
        case TransportTradeOperation::Reject: return TransportCommandKind::TradeReject;
        case TransportTradeOperation::Cancel: return TransportCommandKind::TradeCancel;
    }
    return TransportCommandKind::TradeQuery;
}

uint32_t tradePendingMask()
{
    return commandMask(TransportCommandKind::TradeQuery) |
           commandMask(TransportCommandKind::TradeCreate) |
           commandMask(TransportCommandKind::TradeUpdate) |
           commandMask(TransportCommandKind::TradeConfirm) |
           commandMask(TransportCommandKind::TradeReject) |
           commandMask(TransportCommandKind::TradeCancel);
}

bool queueTradeCommand(AppState &state, TransportTradeOperation operation, uint32_t nowMs,
                       uint8_t targetPlayerId, uint32_t selfAssetMask,
                       int32_t selfCash, uint32_t counterpartyAssetMask,
                       int32_t counterpartyCash, uint32_t tradeId,
                       uint16_t revision)
{
    const TransportCommandKind kind = tradeCommandKind(operation);
    const uint8_t index = commandIndex(kind);
    const bool mutation = operation != TransportTradeOperation::Query;
    if (!state.authorityOnline || !state.boardCatalogCompatible ||
        (mutation && (!state.authoritySnapshotValid || state.stateVersion == 0)) ||
        state.commandCount == 4 ||
        (state.pendingCommandMask & tradePendingMask()) != 0) {
        return false;
    }

    TransportCommand &command = state.commandQueue[state.commandTail];
    command = TransportCommand{};
    command.kind = kind;
    command.requestId = state.nextRequestId++;
    command.stateVersion = state.stateVersion;
    command.clientTimeMs = nowMs;
    command.assetMask = selfAssetMask;
    command.counterpartyAssetMask = counterpartyAssetMask;
    command.argument = selfCash;
    command.counterpartyArgument = counterpartyCash;
    command.tradeId = tradeId;
    command.tradeRevision = revision;
    command.tradeOperation = operation;
    command.targetPlayerId = targetPlayerId;
    state.commandTail = static_cast<uint8_t>((state.commandTail + 1) % 4);
    ++state.commandCount;
    state.pendingCommandMask |= commandMask(kind);
    state.pendingRequestIds[index] = command.requestId;
    return true;
}

void clearPendingRequest(AppState &state, uint32_t requestId)
{
    if (requestId == 0) return;
    for (uint8_t index = 0;
         index < sizeof(state.pendingRequestIds) / sizeof(state.pendingRequestIds[0]);
         ++index) {
        if (state.pendingRequestIds[index] != requestId) continue;
        state.pendingRequestIds[index] = 0;
        if (index == commandIndex(TransportCommandKind::PayNow)) {
            state.pendingPayNowStartedMs = 0;
        }
        state.pendingCommandMask &= ~(static_cast<uint32_t>(1u) << index);
        return;
    }
}

void clearPendingKind(AppState &state, TransportCommandKind kind)
{
    const uint8_t index = commandIndex(kind);
    state.pendingRequestIds[index] = 0;
    if (kind == TransportCommandKind::PayNow) state.pendingPayNowStartedMs = 0;
    state.pendingCommandMask &= ~commandMask(kind);
}

void clearPendingTradeRequests(AppState &state)
{
    clearPendingKind(state, TransportCommandKind::TradeQuery);
    clearPendingKind(state, TransportCommandKind::TradeCreate);
    clearPendingKind(state, TransportCommandKind::TradeUpdate);
    clearPendingKind(state, TransportCommandKind::TradeConfirm);
    clearPendingKind(state, TransportCommandKind::TradeReject);
    clearPendingKind(state, TransportCommandKind::TradeCancel);
}

bool requestPlayerDetail(AppState &state, uint32_t nowMs)
{
    const uint8_t playerId = static_cast<uint8_t>(state.selectedPlayer + 1);
    state.playerDetail = PlayerDetailState{};
    state.playerDetail.loadState = PlayerDetailLoadState::Loading;
    state.playerDetail.playerId = playerId;
    state.playerDetail.requestedAtMs = nowMs;
    state.playerAssetListIndex = 0;
    state.playerFinanceListIndex = 0;
    if (!queueCommand(state, TransportCommandKind::PlayerDetailRequest, 0, nowMs,
                      0, 0, 0xFF, 0, playerId)) {
        state.playerDetail.loadState = PlayerDetailLoadState::Failed;
        touchRevision(state);
        return false;
    }
    state.playerDetail.requestId =
        state.pendingRequestIds[commandIndex(TransportCommandKind::PlayerDetailRequest)];
    touchRevision(state);
    return true;
}

void clearStaleSubmissions(AppState &state)
{
    state.pendingCommandMask = 0;
    for (uint32_t &requestId : state.pendingRequestIds) requestId = 0;
    state.pendingPayNowStartedMs = 0;
    state.modal.submitting = false;
    state.identity.pendingRequestId = 0;
}

bool queueIdentityRequest(AppState &state, TransportIdentityOperation operation,
                          uint32_t nowMs)
{
    const bool mutation = operation != TransportIdentityOperation::Query;
    if (mutation && appTagPairBlocksIdentity(state)) return false;
    const TransportCommandKind kind = TransportCommandKind::IdentityRequest;
    const uint8_t index = commandIndex(kind);
    const uint32_t mask = commandMask(kind);
    if (!state.authorityOnline || state.commandCount == 4 ||
        (state.pendingCommandMask & mask) != 0 ||
        (mutation && (state.stateVersion == 0 || state.identity.ownSeatRevision == 0))) {
        return false;
    }

    TransportCommand &command = state.commandQueue[state.commandTail];
    command = TransportCommand{};
    command.kind = kind;
    command.requestId = state.nextRequestId++;
    command.stateVersion = mutation ? state.stateVersion : 0;
    command.clientTimeMs = nowMs;
    command.identityOperation = operation;
    command.identitySeatRevision = state.identity.ownSeatRevision;
    command.avatarRecipe = state.identity.draftRecipe;
    strncpy(command.identityName, state.identity.draftName,
            sizeof(command.identityName) - 1);
    command.identityName[sizeof(command.identityName) - 1] = '\0';
    command.targetPlayerId = state.selfSeatId;
    state.commandTail = static_cast<uint8_t>((state.commandTail + 1) % 4);
    ++state.commandCount;
    state.pendingCommandMask |= mask;
    state.pendingRequestIds[index] = command.requestId;
    state.identity.pendingRequestId = command.requestId;
    return true;
}

void showIdentityPage(AppState &state, ScreenPage page, uint8_t focus = 0)
{
    clearInlineEditing(state);
    state.tradeReceiverPickerOpen = false;
    dismissModal(state);
    dismissActivityBanner(state);
    state.nav.depth = 0;
    memset(state.nav.stack, 0, sizeof(state.nav.stack));
    state.nav.current = NavigationEntry{page, focus, 0};
    state.identity.focus = focus;
    syncLegacyState(state);
}

uint8_t wrapIdentityValue(uint8_t current, int16_t delta, uint8_t maximum)
{
    if (maximum == 0 || delta == 0) return current;
    int32_t value = current == 0 ? 1 : current;
    value = (value - 1 + delta) % maximum;
    if (value < 0) value += maximum;
    return static_cast<uint8_t>(value + 1);
}

uint8_t randomAvatarValue(uint32_t &randomState, uint8_t maximum)
{
    randomState ^= randomState << 13;
    randomState ^= randomState >> 17;
    randomState ^= randomState << 5;
    return static_cast<uint8_t>(randomState % maximum + 1u);
}

void randomizeAvatarDraft(AppState &state, uint32_t nowMs)
{
    uint32_t &randomState = state.identity.avatarRandomState;
    if (randomState == 0) {
        randomState = nowMs ^ state.authorityRoomId ^
            (static_cast<uint32_t>(state.selfSeatId) << 24) ^ 0x9E3779B9u;
        if (randomState == 0) randomState = 0xA341316Cu;
    }
    const TransportAvatarRecipe previous = state.identity.draftRecipe;
    TransportAvatarRecipe &recipe = state.identity.draftRecipe;
    recipe.hairPresetId = randomAvatarValue(randomState, kHairPresetCount);
    recipe.hairColorId = randomAvatarValue(randomState, kHairColorCount);
    recipe.facePresetId = randomAvatarValue(randomState, kFacePresetCount);
    recipe.skinToneId = randomAvatarValue(randomState, kSkinToneCount);
    recipe.outfitPresetId = randomAvatarValue(randomState, kOutfitPresetCount);
    // A press always offers a new combination; individual fields may repeat.
    if (recipe.hairPresetId == previous.hairPresetId &&
        recipe.hairColorId == previous.hairColorId &&
        recipe.facePresetId == previous.facePresetId &&
        recipe.skinToneId == previous.skinToneId &&
        recipe.outfitPresetId == previous.outfitPresetId) {
        recipe.hairPresetId = wrapIdentityValue(recipe.hairPresetId, 1, kHairPresetCount);
    }
    state.identity.editingValue = false;
    state.identity.draftDirty = true;
    touchRevision(state);
}

void applyIdentityDraftDelta(AppState &state, int16_t delta)
{
    if (delta == 0) return;

    switch (static_cast<AvatarEditField>(state.nav.current.focus)) {
        case AvatarEditField::HairPreset:
            state.identity.draftRecipe.hairPresetId = wrapIdentityValue(
                state.identity.draftRecipe.hairPresetId, delta, kHairPresetCount);
            break;
        case AvatarEditField::HairColor:
            state.identity.draftRecipe.hairColorId = wrapIdentityValue(
                state.identity.draftRecipe.hairColorId, delta, kHairColorCount);
            break;
        case AvatarEditField::FacePreset:
            state.identity.draftRecipe.facePresetId = wrapIdentityValue(
                state.identity.draftRecipe.facePresetId, delta, kFacePresetCount);
            break;
        case AvatarEditField::SkinTone:
            state.identity.draftRecipe.skinToneId = wrapIdentityValue(
                state.identity.draftRecipe.skinToneId, delta, kSkinToneCount);
            break;
        case AvatarEditField::OutfitPreset:
            state.identity.draftRecipe.outfitPresetId = wrapIdentityValue(
                state.identity.draftRecipe.outfitPresetId, delta, kOutfitPresetCount);
            break;
        case AvatarEditField::Confirm:
        case AvatarEditField::Random:
        case AvatarEditField::Count:
            return;
    }
    state.identity.draftDirty = true;
    touchRevision(state);
}

void applyIdentitySnapshot(AppState &state, const TransportEvent &event,
                           uint32_t nowMs)
{
    if (event.selfSeatId != 0) state.selfSeatId = event.selfSeatId;
    state.identity.authorityPhase = event.identityPhase;
    state.identity.lastResult = event.identityResult;
    state.identity.revision = event.identityRevision;
    state.identity.seatCount = event.identitySeatCount > 6 ? 6 : event.identitySeatCount;
    state.identity.humanMask = event.identityHumanMask;
    state.identity.avatarReadyMask = event.identityAvatarReadyMask;
    state.identity.nameReadyMask = event.identityNameReadyMask;
    state.identity.readyMask = event.identityReadyMask;
    state.identity.onlineMask = event.identityOnlineMask;
    state.identity.selfStage = event.identitySelfStage;
    if (event.identityPhase == TransportIdentityPhase::TagPairing) {
        state.identity.tagPairRequired = true;
    }
    if (event.identity != nullptr) {
        memcpy(state.identity.seats, event.identity->seats,
               sizeof(state.identity.seats));
        if (state.rosterSnapshotValid) {
            for (uint8_t index = 0; index < state.identity.seatCount; ++index) {
                strncpy(state.identity.seats[index].name, state.rosterNames[index], 16);
                state.identity.seats[index].name[16] = '\0';
            }
        }
    }

    const uint8_t selfIndex = state.selfSeatId == 0
        ? 0xFF : static_cast<uint8_t>(state.selfSeatId - 1);
    if (selfIndex < state.identity.seatCount) {
        const TransportIdentitySeat &self = state.identity.seats[selfIndex];
        state.identity.ownSeatRevision = self.seatRevision;
        if (!state.identity.draftInitialized) {
            state.identity.draftRecipe = normalizedTransportAvatarRecipe(self.recipe);
            state.identity.confirmedRecipe = state.identity.draftRecipe;
            state.identity.draftInitialized = true;
            state.identity.draftDirty = false;
        }
    }

    const uint32_t identityRequestId =
        state.pendingRequestIds[commandIndex(TransportCommandKind::IdentityRequest)];
    if (event.requestId != 0 && event.requestId == identityRequestId) {
        clearPendingRequest(state, event.requestId);
        state.identity.pendingRequestId = 0;
        if (event.identityResult != TransportIdentityResult::Ok) {
            state.identity.phase = IdentityClientPhase::AvatarEditing;
            showToast(state,
                      event.identityResult == TransportIdentityResult::DuplicateName
                          ? "NAME ALREADY IN USE"
                          : "SETUP CHANGED - TRY AGAIN",
                      nowMs);
        }
    }

    if (appTagPairBlocksIdentity(state)) {
        state.identity.phase = IdentityClientPhase::TagPairing;
        state.identity.editingValue = false;
        state.identity.avatarEditOverride = false;
        showIdentityPage(state, ScreenPage::TagPairing,
                         state.page == ScreenPage::TagPairing && state.focus < 2
                             ? state.focus : 0);
        return;
    }

    if (event.identityPhase == TransportIdentityPhase::Inactive ||
        event.identityPhase == TransportIdentityPhase::Active) {
        state.identity.phase = IdentityClientPhase::Inactive;
        state.identity.countdownDeadlineMs = 0;
        state.identity.avatarEditOverride = false;
        if (isIdentityPage(state.nav.current.page)) resetHome(state, 0);
        return;
    }

    if (selfIndex >= state.identity.seatCount) return;
    const uint8_t selfBit = static_cast<uint8_t>(1u << selfIndex);
    const TransportIdentitySeat &self = state.identity.seats[selfIndex];
    const bool seatProvesAvatarReady =
        (self.flags & gridopoly::protocol::IdentitySeatAvatarFinal) != 0;
    const bool seatProvesNameReady =
        (self.flags & gridopoly::protocol::IdentitySeatNameFinal) != 0;
    const bool rawStageProvesAvatarReady =
        event.identitySelfStage <= 6 && event.identitySelfStage >= static_cast<uint8_t>(
            gridopoly::protocol::IdentitySeatStage::NameSetup);
    const bool rawStageProvesNameReady =
        event.identitySelfStage <= 6 && event.identitySelfStage >= static_cast<uint8_t>(
            gridopoly::protocol::IdentitySeatStage::Ready);
    const bool stageProvesAvatarReady =
        event.identityPhase == TransportIdentityPhase::AwaitName ||
        event.identityPhase == TransportIdentityPhase::Ready ||
        event.identityPhase == TransportIdentityPhase::Countdown;
    const bool stageProvesNameReady =
        event.identityPhase == TransportIdentityPhase::Ready ||
        event.identityPhase == TransportIdentityPhase::Countdown;
    const bool avatarReady = (state.identity.avatarReadyMask & selfBit) != 0 ||
                             seatProvesAvatarReady || rawStageProvesAvatarReady ||
                             stageProvesAvatarReady;
    const bool nameReady = (state.identity.nameReadyMask & selfBit) != 0 ||
                           seatProvesNameReady || rawStageProvesNameReady ||
                           stageProvesNameReady;

    // Completion snapshots are authoritative even when the immediate response
    // was lost. Clear the stale local request before selecting the next page.
    if ((avatarReady &&
         (state.identity.phase == IdentityClientPhase::AvatarEditing ||
          state.identity.phase == IdentityClientPhase::AvatarSubmitting)) ||
        (nameReady && state.identity.phase == IdentityClientPhase::NameSubmitting)) {
        clearPendingKind(state, TransportCommandKind::IdentityRequest);
        state.identity.pendingRequestId = 0;
    }

    if (!avatarReady) {
        state.identity.avatarEditOverride = false;
        state.identity.phase = state.identity.pendingRequestId != 0 ||
                                       event.identityPhase == TransportIdentityPhase::GeneratingAvatar
                                   ? IdentityClientPhase::AvatarSubmitting
                                   : (state.identity.avatarAssetsReady
                                          ? IdentityClientPhase::AvatarEditing
                                          : IdentityClientPhase::AvatarLoading);
        showIdentityPage(state,
                         state.identity.phase == IdentityClientPhase::AvatarLoading
                             ? ScreenPage::AvatarLoading : ScreenPage::AvatarSetup,
                         state.identity.focus < static_cast<uint8_t>(AvatarEditField::Count)
                             ? state.identity.focus : 0);
        return;
    }

    state.identity.confirmedRecipe = normalizedTransportAvatarRecipe(
        state.identity.seats[selfIndex].recipe);
    if (!state.identity.draftDirty) {
        state.identity.draftRecipe = state.identity.confirmedRecipe;
    }
    if (!nameReady) {
        if (state.identity.avatarEditOverride &&
            (state.nav.current.page == ScreenPage::AvatarLoading ||
             state.nav.current.page == ScreenPage::AvatarSetup)) {
            if (state.nav.current.page == ScreenPage::AvatarSetup) {
                state.identity.phase = IdentityClientPhase::AvatarEditing;
            }
            return;
        }
        state.identity.avatarEditOverride = false;
        if (state.identity.phase != IdentityClientPhase::NameHandwriting) {
            state.identity.phase = state.identity.pendingRequestId != 0
                ? IdentityClientPhase::NameSubmitting : IdentityClientPhase::NameReview;
            showIdentityPage(state, ScreenPage::NameReview,
                             state.identity.focus < 3 ? state.identity.focus : 0);
        }
        return;
    }

    state.identity.phase = event.identityPhase == TransportIdentityPhase::Countdown
        ? IdentityClientPhase::Countdown : IdentityClientPhase::Ready;
    state.identity.countdownDeadlineMs =
        event.identityPhase == TransportIdentityPhase::Countdown ? event.deadlineMs : 0;
    showIdentityPage(state, ScreenPage::PlayerReady, 0);
}

void resumeIdentityAfterPairing(AppState &state, uint32_t nowMs)
{
    TransportEvent identity{};
    identity.selfSeatId = state.selfSeatId;
    identity.identityPhase = state.identity.authorityPhase;
    identity.identityRevision = state.identity.revision;
    identity.identitySeatCount = state.identity.seatCount;
    identity.identityHumanMask = state.identity.humanMask;
    identity.identityAvatarReadyMask = state.identity.avatarReadyMask;
    identity.identityNameReadyMask = state.identity.nameReadyMask;
    identity.identityReadyMask = state.identity.readyMask;
    identity.identityOnlineMask = state.identity.onlineMask;
    identity.identitySelfStage = state.identity.selfStage;
    applyIdentitySnapshot(state, identity, nowMs);
}

bool reconcileCompletedAvatarSubmission(AppState &state)
{
    if (appTagPairBlocksIdentity(state)) return false;
    if ((state.nav.current.page != ScreenPage::AvatarLoading &&
         state.nav.current.page != ScreenPage::AvatarSetup) ||
        state.identity.avatarEditOverride ||
        state.selfSeatId == 0) {
        return false;
    }

    const uint8_t selfIndex = static_cast<uint8_t>(state.selfSeatId - 1);
    if (selfIndex >= state.identity.seatCount) return false;
    const uint8_t selfBit = static_cast<uint8_t>(1u << selfIndex);
    const TransportIdentitySeat &self = state.identity.seats[selfIndex];
    const bool avatarReady =
        (state.identity.avatarReadyMask & selfBit) != 0 ||
        (self.flags & gridopoly::protocol::IdentitySeatAvatarFinal) != 0;
    if (!avatarReady) return false;

    clearPendingKind(state, TransportCommandKind::IdentityRequest);
    state.identity.pendingRequestId = 0;
    state.identity.editingValue = false;
    state.identity.confirmedRecipe = normalizedTransportAvatarRecipe(self.recipe);
    if (!state.identity.draftDirty) {
        state.identity.draftRecipe = state.identity.confirmedRecipe;
    }

    const bool nameReady =
        (state.identity.nameReadyMask & selfBit) != 0 ||
        (self.flags & gridopoly::protocol::IdentitySeatNameFinal) != 0;
    if (!nameReady) {
        state.identity.phase = IdentityClientPhase::NameReview;
        showIdentityPage(state, ScreenPage::NameReview, 0);
    } else {
        state.identity.phase =
            state.identity.authorityPhase == TransportIdentityPhase::Countdown
                ? IdentityClientPhase::Countdown : IdentityClientPhase::Ready;
        showIdentityPage(state, ScreenPage::PlayerReady, 0);
    }
    return true;
}

bool isDebtMortgageCompletion(const AppState &state, const TransportEvent &event)
{
    const uint8_t mortgageIndex = commandIndex(TransportCommandKind::MortgageBatchRequest);
    return state.modal.kind == ModalKind::DebtMortgageConfirm && state.modal.submitting &&
           event.requestId != 0 && event.requestId == state.debt.submittedMortgageRequestId &&
           event.requestId == state.pendingRequestIds[mortgageIndex] &&
           event.transactionId == state.debt.transactionId &&
           event.assetMask == state.debt.submittedMortgageMask;
}

bool isVoluntaryMortgageCompletion(const AppState &state, const TransportEvent &event)
{
    const uint8_t mortgageIndex = commandIndex(TransportCommandKind::MortgageBatchRequest);
    return state.modal.kind == ModalKind::VoluntaryMortgage && state.modal.submitting &&
           event.requestId != 0 && event.requestId == state.pendingRequestIds[mortgageIndex] &&
           (state.modal.transactionId == 0 || event.transactionId == state.modal.transactionId) &&
           event.assetMask == (static_cast<uint32_t>(1u) << state.selectedAsset);
}

bool isGenericModalCompletion(const AppState &state, const TransportEvent &event)
{
    if (event.kind != TransportEventKind::CommandCompleted ||
        event.requestId == 0 || !state.modal.submitting) {
        return false;
    }
    if (state.modal.kind == ModalKind::CollectRent) {
        return event.requestId ==
            state.pendingRequestIds[commandIndex(TransportCommandKind::ClaimRent)];
    }
    if (state.modal.kind == ModalKind::VoluntaryUnmortgage) {
        return event.requestId ==
            state.pendingRequestIds[commandIndex(TransportCommandKind::UnmortgageRequest)];
    }
    if (state.modal.kind == ModalKind::DebtSellBuildingConfirm ||
        state.modal.kind == ModalKind::SellBuildingGroupConfirm) {
        return event.requestId ==
            state.pendingRequestIds[commandIndex(TransportCommandKind::SellBuildingRequest)];
    }
    return false;
}

bool isActiveModalRequest(const AppState &state, uint32_t requestId)
{
    if (requestId == 0 || !state.modal.submitting) return false;
    switch (state.modal.kind) {
        case ModalKind::CollectRent:
            return requestId ==
                state.pendingRequestIds[commandIndex(TransportCommandKind::ClaimRent)];
        case ModalKind::TradeCreate:
        case ModalKind::TradeAction:
            return requestId == state.pendingRequestIds[
                commandIndex(tradeCommandKind(state.modal.tradeOperation))];
        case ModalKind::ForcedPayment:
            return requestId ==
                state.pendingRequestIds[commandIndex(TransportCommandKind::PayNow)];
        case ModalKind::VoluntaryMortgage:
            return requestId ==
                state.pendingRequestIds[commandIndex(TransportCommandKind::MortgageBatchRequest)];
        case ModalKind::VoluntaryUnmortgage:
            return requestId ==
                state.pendingRequestIds[commandIndex(TransportCommandKind::UnmortgageRequest)];
        case ModalKind::DebtMortgageConfirm:
            return requestId == state.debt.submittedMortgageRequestId &&
                   requestId == state.pendingRequestIds[
                       commandIndex(TransportCommandKind::MortgageBatchRequest)];
        case ModalKind::DebtSellBuildingConfirm:
        case ModalKind::SellBuildingGroupConfirm:
            return requestId == state.pendingRequestIds[
                commandIndex(TransportCommandKind::SellBuildingRequest)];
        case ModalKind::None:
            return false;
    }
    return false;
}

bool isForcedPaymentCompletion(const AppState &state, const TransportEvent &event)
{
    return event.kind == TransportEventKind::PaymentCompleted &&
           state.modal.kind == ModalKind::ForcedPayment && state.modal.submitting &&
           event.requestId != 0 &&
           event.requestId ==
               state.pendingRequestIds[commandIndex(TransportCommandKind::PayNow)] &&
           (state.modal.transactionId == 0 ||
            event.transactionId == state.modal.transactionId);
}

bool isMatchingBankruptcyResolution(const AppState &state, const TransportEvent &event)
{
    return event.kind == TransportEventKind::BankruptcyResolved && state.debt.bankruptcyPending &&
           state.debt.transactionId != 0 &&
           event.transactionId == state.debt.transactionId;
}

void showModal(AppState &state, ModalKind kind, bool cancelAllowed, const char *title,
               const char *counterparty, const char *purpose, int32_t amount, uint32_t transactionId,
               uint32_t deadlineMs,
               TransportTradeOperation tradeOperation = TransportTradeOperation::Create)
{
    state.modal = ModalState{};
    state.modal.kind = kind;
    state.modal.focus = ModalFocus::Confirm;
    state.modal.cancelAllowed = cancelAllowed;
    state.modal.transactionId = transactionId;
    state.modal.deadlineMs = deadlineMs;
    state.modal.amount = amount;
    state.modal.title = title;
    state.modal.counterparty = counterparty;
    state.modal.purpose = purpose;
    state.modal.tradeOperation = tradeOperation;
    state.buttonHeld = false;
    state.holdActionConsumed = false;
    touchRevision(state);
}

void dismissModal(AppState &state)
{
    state.modal = ModalState{};
    state.buttonHeld = false;
    state.holdActionConsumed = false;
    touchRevision(state);
}

void enterBankruptcy(AppState &state)
{
    dismissModal(state);
    replaceForcedPage(state, ScreenPage::Bankruptcy);
}

void back(AppState &state)
{
    if (state.tradeReceiverPickerOpen) {
        closeTradeReceiverPicker(state);
        return;
    }
    if (state.modal.kind != ModalKind::None) {
        if (state.modal.cancelAllowed && !state.modal.submitting &&
            state.modal.focus == ModalFocus::Cancel) {
            dismissModal(state);
        }
        return;
    }
    if (!appCanNavigateBack(state)) return;
    const ScreenPage leavingPage = state.nav.current.page;
    clearInlineEditing(state);
    state.nav.current = state.nav.stack[--state.nav.depth];
    if (leavingPage == ScreenPage::PlayerDetail) {
        clearPendingKind(state, TransportCommandKind::PlayerDetailRequest);
        state.playerDetail = PlayerDetailState{};
        state.playerAssetListIndex = 0;
        state.playerFinanceListIndex = 0;
    }
    restoreListAnchor(state);
    syncLegacyState(state);
    touchRevision(state);
}

void submitModal(AppState &state, uint32_t nowMs)
{
    if (state.modal.submitting) return;
    switch (state.modal.kind) {
        case ModalKind::CollectRent:
            if (queueCommand(state, TransportCommandKind::ClaimRent, state.modal.transactionId, nowMs)) {
                state.modal.submitting = true;
            }
            return;
        case ModalKind::ForcedPayment:
            if (state.modal.focus == ModalFocus::ResolveAssets) {
                showModal(state, ModalKind::DebtMortgageConfirm, false, "Resolve assets", "City Bank",
                          "Mortgage assets", state.modal.amount, state.modal.transactionId, 0);
            } else if (queueCommand(state, TransportCommandKind::PayNow, state.modal.transactionId, nowMs)) {
                state.modal.submitting = true;
            }
            return;
        case ModalKind::VoluntaryMortgage:
            if (queueCommand(state, TransportCommandKind::MortgageBatchRequest, state.modal.transactionId, nowMs,
                             static_cast<uint32_t>(1u << state.selectedAsset))) {
                state.modal.submitting = true;
            }
            return;
        case ModalKind::VoluntaryUnmortgage:
            if (queueCommand(state, TransportCommandKind::UnmortgageRequest,
                             state.modal.transactionId, nowMs, 0, 0,
                             state.selectedAsset)) {
                state.modal.submitting = true;
            }
            return;
        case ModalKind::TradeCreate:
            {
                const bool updating = state.modal.tradeOperation == TransportTradeOperation::Update;
                const uint32_t otherAssets = updating
                    ? state.tradeOffer.counterpartyAssetMask : 0;
                const int32_t otherCash = updating
                    ? state.tradeOffer.counterpartyGivesCash : 0;
                const uint32_t tradeId = updating ? state.tradeOffer.tradeId : 0;
                const uint16_t revision = updating ? state.tradeOffer.revision : 0;
                if (queueTradeCommand(state, state.modal.tradeOperation, nowMs,
                                      static_cast<uint8_t>(state.tradeReceiver + 1),
                                      state.tradeGiveAssetMask, state.tradeAmount,
                                      otherAssets, otherCash, tradeId, revision)) {
                    state.modal.submitting = true;
                } else {
                    showToast(state, state.stateVersion == 0
                                         ? "WAITING FOR GAME SYNC"
                                         : "TRADE REQUEST ALREADY PENDING", nowMs);
                }
            }
            return;
        case ModalKind::TradeAction:
            if (queueTradeCommand(state, state.modal.tradeOperation, nowMs,
                                  state.tradeOffer.counterpartyId, 0, 0, 0, 0,
                                  state.tradeOffer.tradeId,
                                  state.tradeOffer.revision)) {
                state.modal.submitting = true;
            } else {
                showToast(state, state.stateVersion == 0
                                     ? "WAITING FOR GAME SYNC"
                                     : "TRADE REQUEST ALREADY PENDING", nowMs);
            }
            return;
        case ModalKind::DebtMortgageConfirm:
            if (appDebtCanConfirm(state) &&
                queueCommand(state, TransportCommandKind::MortgageBatchRequest, state.debt.transactionId, nowMs,
                             state.debt.selectedMask)) {
                state.modal.submitting = true;
                state.debt.submittedMortgageRequestId =
                    state.pendingRequestIds[commandIndex(TransportCommandKind::MortgageBatchRequest)];
                state.debt.submittedMortgageMask = state.debt.selectedMask;
            }
            return;
        case ModalKind::DebtSellBuildingConfirm:
            if (appDebtBuildingSaleEligible(state, state.selectedAsset) &&
                queueCommand(state, TransportCommandKind::SellBuildingRequest,
                             state.debt.transactionId, nowMs, 0, 0,
                             state.selectedAsset)) {
                state.modal.submitting = true;
            }
            return;
        case ModalKind::SellBuildingGroupConfirm: {
            if (!appBuildingGroupSaleEligible(state, state.selectedAsset)) {
                dismissModal(state);
                showToast(state, "SALE NO LONGER AVAILABLE", nowMs);
                return;
            }
            const int32_t proceeds = appBuildingGroupSaleProceeds(state, state.selectedAsset);
            if (proceeds != state.modal.amount) {
                state.modal.amount = proceeds;
                showToast(state, "AMOUNT CHANGED - REVIEW AGAIN", nowMs);
                return;
            }
            if (queueCommand(state, TransportCommandKind::SellBuildingRequest,
                             state.modal.transactionId, nowMs, 0, 0,
                             state.selectedAsset, 1)) {
                state.modal.submitting = true;
            }
            return;
        }
        case ModalKind::None:
            return;
    }
}

void presentPostArrivalState(AppState &state, uint32_t nowMs);

void activate(AppState &state, uint32_t nowMs)
{
    if (state.modal.kind != ModalKind::None) return;
    if (state.nav.current.page == ScreenPage::Home &&
        state.endTurnPresentation != EndTurnPresentationPhase::None) return;

    const ScreenPage page = state.nav.current.page;
    const uint8_t focus = state.nav.current.focus;
    if (appFocusIsFooter(state)) {
        if (page == ScreenPage::DebtAssets && appDebtCanConfirm(state)) {
            showModal(state, ModalKind::DebtMortgageConfirm, false, "Confirm mortgages", "City Bank",
                      "Mortgage selected assets", appDebtSelectedProceeds(state), state.debt.transactionId, 0);
            return;
        }
        back(state);
        return;
    }

    switch (page) {
        case ScreenPage::Home: {
            HomeAction actions[5]{};
            const uint8_t count = appHomeActions(state, actions);
            if (focus >= count) return;
            const HomeAction action = actions[focus];
            if (action == HomeAction::Dice || action == HomeAction::ExtraRoll ||
                action == HomeAction::EndTurn) {
                if (action == HomeAction::EndTurn) {
                    if (queueCommand(state, TransportCommandKind::EndTurnRequest, 0, nowMs)) {
                        state.endTurnPresentation = EndTurnPresentationPhase::Exiting;
                        state.endTurnPresentationStartedMs = nowMs;
                        state.endTurnPresentationUntilMs =
                            nowMs + kEndTurnMinimumPresentationMs;
                        state.endTurnAccepted = false;
                        state.nav.current.focus = 0;
                        syncLegacyState(state);
                        touchRevision(state);
                    }
                    return;
                }
                if (queueCommand(state, TransportCommandKind::RollRequest, 0, nowMs)) {
                    clearExtraRollRoomLifecycle(state);
                    clearCardPresentationState(state);
                    state.rollOrigin = state.position;
                    state.rollTarget = 0xFF;
                    state.dieA = 0;
                    state.dieB = 0;
                    state.rolledSteps = 0;
                    state.rollStartedMs = nowMs;
                    state.rollResolvedMs = 0;
                    state.rollRevealMs = 0;
                    state.rollFailedUntilMs = 0;
                    state.arrivalContinueAtMs = 0;
                    state.rollAnimating = true;
                    state.rollResolved = false;
                    state.rollRevealPresented = false;
                    state.rollPresentationComplete = false;
                    state.rollFailed = false;
                    state.moveArrivalPending = false;
                    state.moveArrivalConfirmed = false;
                    state.landingEventAcknowledged = false;
                    replaceForcedPage(state, ScreenPage::DiceStage);
                    showToast(state, "ROLL REQUEST SENT", nowMs);
                }
                return;
            }
            if (action == HomeAction::Build) {
                const uint8_t asset = appHomeBuildAsset(state);
                if (asset == 0xFF || !state.authorityOnline || !appBuildSnapshotCurrent(state)) {
                    showToast(state, state.authorityOnline ? "WAITING FOR CURRENT STATE" : "OFFLINE", nowMs);
                    return;
                }
                state.buildAnchorAsset = state.selectedAsset = asset;
                state.buildOriginPosition = state.position;
                state.buildBoardSize = state.boardSize;
                state.buildRoomId = state.authorityRoomId;
                pushPage(state, ScreenPage::Build, 1);
            } else if (action == HomeAction::Assets) pushPage(state, ScreenPage::Assets);
            else if (action == HomeAction::Players) pushPage(state, ScreenPage::Players);
            else if (action == HomeAction::Trade) {
                if (!kTradeBackendAvailable) {
                    showToast(state, "TRADE REQUIRES WI-FI SERVER", nowMs);
                    return;
                }
                state.tradeEntryMode = TradeEntryMode::HomeEditable;
                if (state.playerCount > 1 &&
                    (state.tradeReceiver >= state.playerCount ||
                     state.tradeReceiver == static_cast<uint8_t>(state.selfSeatId - 1))) {
                    state.tradeReceiver = static_cast<uint8_t>(state.selfSeatId % state.playerCount);
                }
                state.tradeGiveAssetMask = 0;
                state.tradeAmount = 0;
                state.tradeAssetListIndex = 0;
                pushPage(state, ScreenPage::Trade);
            }
            return;
        }
        case ScreenPage::Build: {
            if (!appBuildContextCurrent(state)) {
                showToast(state, state.authorityOnline ? "WAITING FOR CURRENT STATE" : "OFFLINE", nowMs);
                return;
            }
            if (focus == 0) {
                state.inlineEditField = state.inlineEditField == InlineEditField::BuildProperty
                    ? InlineEditField::None : InlineEditField::BuildProperty;
                touchRevision(state);
                return;
            }
            clearInlineEditing(state);
            const char *reason = appAssetBuildReason(state, state.selectedAsset);
            if (reason) { showToast(state, reason, nowMs); return; }
            if (queueCommand(state, TransportCommandKind::BuildRequest, 0, nowMs,
                             0, 0, state.selectedAsset)) showToast(state, "BUILDING...", nowMs);
            return;
        }
        case ScreenPage::Assets:
            state.selectedAsset = appVisibleAssetIndex(state, focus);
            pushPage(state, ScreenPage::AssetDetail);
            return;
        case ScreenPage::AssetDetail:
            {
                const AssetDetailAction action = appAssetDetailActionAt(state, focus);
                if (!appAssetDetailActionEnabled(state, action)) {
                    showToast(state, "ACTION NOT AVAILABLE", nowMs);
                    return;
                }
                if (action == AssetDetailAction::Build ||
                    action == AssetDetailAction::SellBuilding) {
                    if (action == AssetDetailAction::SellBuilding &&
                        state.authorityPhase == AuthorityPhase::AwaitDebt) {
                        showModal(state, ModalKind::DebtSellBuildingConfirm, true,
                                  "SELL ONE LEVEL", "CITY BANK", "ONE BUILDING LEVEL ONLY",
                                  appDebtBuildingSaleProceeds(state, state.selectedAsset),
                                  state.debt.transactionId, 0);
                        return;
                    }
                    const TransportCommandKind kind = action == AssetDetailAction::Build
                        ? TransportCommandKind::BuildRequest
                        : TransportCommandKind::SellBuildingRequest;
                    if (queueCommand(state, kind, 0, nowMs, 0, 0, state.selectedAsset)) {
                        showToast(state, action == AssetDetailAction::Build
                                             ? "BUILDING..." : "SELLING BUILDING...", nowMs);
                    }
                    return;
                }
                if (action == AssetDetailAction::SellBuildingGroup) {
                    showModal(state, ModalKind::SellBuildingGroupConfirm, true,
                              "SELL WHOLE GROUP", "CITY BANK",
                              "ALL BUILDINGS IN THIS COLOR GROUP",
                              appBuildingGroupSaleProceeds(state, state.selectedAsset),
                              state.authorityPhase == AuthorityPhase::AwaitDebt
                                  ? state.debt.transactionId : 0, 0);
                    return;
                }
                if (action == AssetDetailAction::Trade) {
                    if (!kTradeBackendAvailable) {
                        showToast(state, "TRADE REQUIRES WI-FI SERVER", nowMs);
                        return;
                    }
                    state.tradeEntryMode = TradeEntryMode::HomeEditable;
                    if (state.playerCount > 1 &&
                        (state.tradeReceiver >= state.playerCount ||
                         state.tradeReceiver == static_cast<uint8_t>(state.selfSeatId - 1))) {
                        state.tradeReceiver =
                            static_cast<uint8_t>(state.selfSeatId % state.playerCount);
                    }
                    state.tradeGiveAssetMask = static_cast<uint32_t>(1u) << state.selectedAsset;
                    state.tradeAmount = 0;
                    state.tradeAssetListIndex = 0;
                    pushPage(state, ScreenPage::Trade);
                    return;
                }
                if (appAssetMortgaged(state, state.selectedAsset)) {
                    showModal(state, ModalKind::VoluntaryUnmortgage, true,
                              "CONFIRM REDEEM", "CITY BANK",
                              appAssetDisplayName(state, state.selectedAsset),
                              unmortgageCost(state, state.selectedAsset), 0, 0);
                    return;
                }
                showModal(state, ModalKind::VoluntaryMortgage, true,
                          "CONFIRM MORTGAGE", "CITY BANK",
                          appAssetDisplayName(state, state.selectedAsset),
                          appAssetMortgageValue(state, state.selectedAsset), 0, 0);
            }
            return;
        case ScreenPage::Players:
            state.selectedPlayer = focus;
            if (pushPage(state, ScreenPage::PlayerDetail)) requestPlayerDetail(state, nowMs);
            return;
        case ScreenPage::PlayerDetail:
            if (state.playerDetail.loadState != PlayerDetailLoadState::Ready) {
                if (state.playerDetail.loadState != PlayerDetailLoadState::Loading) {
                    requestPlayerDetail(state, nowMs);
                }
                return;
            }
            if (focus == 0) {
                pushPage(state, ScreenPage::PlayerAssets);
            } else if (focus == 1) {
                pushPage(state, ScreenPage::PlayerFinance);
            } else if (focus == 2) {
                if (!kTradeBackendAvailable) {
                    showToast(state, "TRADE REQUIRES WI-FI SERVER", nowMs);
                    return;
                }
                if (state.selectedPlayer == static_cast<uint8_t>(state.selfSeatId - 1)) {
                    showToast(state, "CHOOSE ANOTHER PLAYER", nowMs);
                    return;
                }
                state.tradeReceiver = state.selectedPlayer;
                state.tradeEntryMode = TradeEntryMode::PlayerLocked;
                state.tradeGiveAssetMask = 0;
                state.tradeAmount = 0;
                state.tradeAssetListIndex = 0;
                pushPage(state, ScreenPage::Trade);
            } else {
                state.nav.current.focus = 0;
                syncLegacyState(state);
                requestPlayerDetail(state, nowMs);
            }
            return;
        case ScreenPage::PlayerAssets:
        case ScreenPage::PlayerFinance:
        case ScreenPage::Activity:
            return;
        case ScreenPage::Trade:
            {
                if (!appTradeReceiverLocked(state) && focus == 0) {
                    openTradeReceiverPicker(state);
                    return;
                }
                const InlineEditField field = focusedTradeField(state);
                if (field != InlineEditField::None) {
                    state.inlineEditField = state.inlineEditField == field
                                                ? InlineEditField::None
                                                : field;
                    touchRevision(state);
                } else if (focus == tradeAssetFocus(state)) {
                    pushPage(state, ScreenPage::TradeAssetSelect);
                } else if (focus == tradeSubmitFocus(state)) {
                    if (state.tradeGiveAssetMask == 0 && state.tradeAmount == 0) {
                        showToast(state, "ADD ASSETS OR CASH", nowMs);
                        return;
                    }
                    showModal(state, ModalKind::TradeCreate, true, "SEND TRADE",
                              appPlayerDisplayName(state, state.tradeReceiver),
                              state.tradeEntryMode == TradeEntryMode::CounterLocked
                                  ? "COUNTER OFFER" : "ASSETS AND CASH",
                              state.tradeAmount, 0, 0,
                              state.tradeEntryMode == TradeEntryMode::CounterLocked
                                  ? TransportTradeOperation::Update
                                  : TransportTradeOperation::Create);
                }
            }
            return;
        case ScreenPage::TradeAssetSelect:
            {
                const uint8_t assetIndex = appTradeAssetIndex(state, focus);
                if (!appTradeAssetEligible(state, assetIndex)) {
                    showToast(state, "SELL BUILDINGS OR REDEEM FIRST", nowMs);
                    return;
                }
                state.tradeGiveAssetMask ^= static_cast<uint32_t>(1u) << assetIndex;
                touchRevision(state);
            }
            return;
        case ScreenPage::TradeOffer:
            if (!state.tradeOffer.active) {
                back(state);
                return;
            }
            if ((state.tradeOffer.flags & kTradeFlagSelfLastEdited) != 0) {
                if (focus == 0) {
                    showModal(state, ModalKind::TradeAction, true, "CANCEL OFFER",
                              appPlayerDisplayName(
                                  state, static_cast<uint8_t>(state.tradeOffer.counterpartyId - 1)),
                              "WITHDRAW CURRENT OFFER", 0, state.tradeOffer.tradeId, 0,
                              TransportTradeOperation::Cancel);
                }
                return;
            }
            if ((state.tradeOffer.flags & kTradeFlagSelfConfirmed) != 0) return;
            if (focus == 0) {
                showModal(state, ModalKind::TradeAction, true, "ACCEPT TRADE",
                          appPlayerDisplayName(
                              state, static_cast<uint8_t>(state.tradeOffer.counterpartyId - 1)),
                          "RECEIVE OFFER", state.tradeOffer.selfGivesCash,
                          state.tradeOffer.tradeId, 0,
                          TransportTradeOperation::Confirm);
            } else if (focus == 1) {
                state.tradeEntryMode = TradeEntryMode::CounterLocked;
                state.tradeReceiver = static_cast<uint8_t>(state.tradeOffer.counterpartyId - 1);
                state.tradeGiveAssetMask = state.tradeOffer.selfAssetMask;
                state.tradeAmount = state.tradeOffer.selfGivesCash;
                state.tradeAssetListIndex = 0;
                pushPage(state, ScreenPage::Trade);
            } else if (focus == 2) {
                showModal(state, ModalKind::TradeAction, true, "REJECT TRADE",
                          appPlayerDisplayName(
                              state, static_cast<uint8_t>(state.tradeOffer.counterpartyId - 1)),
                          "DECLINE CURRENT OFFER", 0, state.tradeOffer.tradeId, 0,
                          TransportTradeOperation::Reject);
            }
            return;
        case ScreenPage::DemoLab:
            if (focus == 0) { state.homePhase = HomePhase::Waiting; state.turnsUntilYou = 3; resetHome(state, 3); }
            else if (focus == 1) { state.homePhase = HomePhase::NextPlayer; state.turnsUntilYou = 1; resetHome(state, 3); }
            else if (focus == 2) { state.homePhase = HomePhase::MyTurn; state.turnsUntilYou = 0; resetHome(state, 4); }
            else if (focus == 3) showModal(state, ModalKind::CollectRent, true, "COLLECT RENT", "Flint",
                                            "Neon Harbor rent", 120, 0, nowMs + 20000);
            else if (focus == 4) showModal(state, ModalKind::ForcedPayment, false, "PAYMENT DUE", "Cyan",
                                            "Sky Plaza rent", 175, 0, nowMs + 10000);
            else replaceForcedPage(state, ScreenPage::DebtAssets);
            return;
        case ScreenPage::Debt:
            pushPage(state, ScreenPage::Assets);
            return;
        case ScreenPage::DebtAssets:
            {
                const uint8_t assetIndex = appVisibleAssetIndex(state, focus);
                state.selectedAsset = assetIndex;
                if (appDebtBuildingSaleEligible(state, assetIndex) ||
                    appBuildingGroupSaleEligible(state, assetIndex)) {
                    pushPage(state, ScreenPage::AssetDetail);
                    setFocus(state, appDebtBuildingSaleEligible(state, assetIndex) ? 2 : 3);
                } else if (appAssetBuildingLevel(state, assetIndex) != 0) {
                    showToast(state, "SELL EVENLY ACROSS GROUP", nowMs);
                } else if (appDebtAssetEligible(state, assetIndex)) {
                    state.debt.selectedMask ^= static_cast<uint32_t>(1u) << assetIndex;
                    touchRevision(state);
                } else {
                    showToast(state, "ASSET NOT AVAILABLE", nowMs);
                }
            }
            return;
        case ScreenPage::DiceStage:
            return;
        case ScreenPage::ExtraRollReward:
            finishExtraRollReward(state);
            return;
        case ScreenPage::MoveGuide:
            if (state.moveArrivalConfirmed) {
                state.arrivalContinueAtMs = nowMs;
                return;
            }
            if ((state.availableActions & kActionConfirmPosition) != 0 &&
                queueCommand(state, TransportCommandKind::MoveManualConfirmRequest,
                             0, nowMs, 0, state.rollTarget)) {
                showToast(state, "CHECKING POSITION", nowMs);
            }
            return;
        case ScreenPage::TileEvent:
            state.landingEventAcknowledged = true;
            presentPostArrivalState(state, nowMs);
            return;
        case ScreenPage::CardReveal:
            if (state.cardPresentation == CardPresentationPhase::Revealed &&
                state.cardResultValid && state.cardInstanceId != 0 &&
                (state.availableActions & kActionCardContinue) != 0) {
                if (queueCommand(state, TransportCommandKind::CardContinueRequest,
                                 state.cardInstanceId, nowMs, 0, 0, 0xFF,
                                 static_cast<int32_t>(state.cardInstanceId))) {
                    state.cardPresentationAcknowledged = true;
                    state.cardPresentation = CardPresentationPhase::Settling;
                    state.pendingCardFlags = 0x0Fu;
                    syncLegacyState(state);
                    touchRevision(state);
                }
            }
            return;
        case ScreenPage::Purchase:
            if (focus == 0 && (state.availableActions & kActionBuy) != 0) {
                if (queueCommand(state, TransportCommandKind::BuyRequest, 0, nowMs)) {
                    showToast(state, "PURCHASING...", nowMs);
                } else {
                    showToast(state, state.authorityOnline ? "REQUEST ALREADY PENDING"
                                                           : "RECONNECTING...", nowMs);
                }
            } else if (focus == 1 && (state.availableActions & kActionDecline) != 0) {
                if (queueCommand(state, TransportCommandKind::DeclinePurchaseRequest, 0, nowMs)) {
                    showToast(state, "STARTING AUCTION", nowMs);
                } else {
                    showToast(state, state.authorityOnline ? "REQUEST ALREADY PENDING"
                                                           : "RECONNECTING...", nowMs);
                }
            } else {
                showToast(state, "ACTION NOT AVAILABLE", nowMs);
            }
            return;
        case ScreenPage::Auction:
            if (state.auctionPresentation != AuctionPresentationPhase::Live) return;
            if (focus == 0 && (state.availableActions & kActionAuctionBid) != 0) {
                if (queueCommand(state, TransportCommandKind::AuctionBidRequest, 0, nowMs,
                                 0, 0, state.auctionAssetIndex,
                                 state.auctionMinimumBid)) {
                    showToast(state, "BID SENT", nowMs);
                }
            } else if (focus == 1 && (state.availableActions & kActionAuctionPass) != 0) {
                if (queueCommand(state, TransportCommandKind::AuctionPassRequest, 0, nowMs,
                                 0, 0, state.auctionAssetIndex)) {
                    state.auctionPassed = true;
                    showToast(state, "PASSING BID", nowMs);
                }
            }
            return;
        case ScreenPage::Bankruptcy:
            if ((state.availableActions & kActionDeclareBankruptcy) != 0) {
                if (queueCommand(state, TransportCommandKind::DeclareBankruptcyRequest,
                                 0, nowMs)) {
                    state.debt.bankruptcyPending = true;
                    showToast(state, "DECLARING BANKRUPTCY", nowMs);
                }
            }
            return;
        case ScreenPage::AvatarSetup:
            if (state.identity.phase == IdentityClientPhase::AvatarSubmitting) return;
            if (focus == static_cast<uint8_t>(AvatarEditField::Random)) {
                randomizeAvatarDraft(state, nowMs);
                return;
            }
            if (focus < static_cast<uint8_t>(AvatarEditField::Confirm)) {
                state.identity.editingValue = !state.identity.editingValue;
                touchRevision(state);
                return;
            }
            state.identity.editingValue = false;
            if (queueIdentityRequest(state, TransportIdentityOperation::ConfirmAvatar,
                                     nowMs)) {
                state.identity.avatarEditOverride = false;
                state.identity.phase = IdentityClientPhase::AvatarSubmitting;
                touchRevision(state);
            } else {
                showToast(state, state.authorityOnline ? "WAITING FOR SETUP SYNC"
                                                       : "RECONNECTING...", nowMs);
            }
            return;
        case ScreenPage::NameReview:
            if (state.identity.phase == IdentityClientPhase::NameSubmitting) return;
            if (focus == 0) {
                state.identity.phase = IdentityClientPhase::NameHandwriting;
                state.identity.handwritingDoneRequested = false;
                state.identity.handwritingDeleteRequested = false;
                state.identity.focus = 0;
                showIdentityPage(state, ScreenPage::NameHandwriting, 0);
                touchRevision(state);
            } else if (focus == 1) {
                if (state.identity.draftName[0] == '\0') {
                    showToast(state, "WRITE A NAME FIRST", nowMs);
                    return;
                }
                if (queueIdentityRequest(state, TransportIdentityOperation::ConfirmName,
                                         nowMs)) {
                    state.identity.phase = IdentityClientPhase::NameSubmitting;
                    touchRevision(state);
                } else {
                    showToast(state, state.authorityOnline ? "WAITING FOR SETUP SYNC"
                                                           : "RECONNECTING...", nowMs);
                }
            } else {
                state.identity.avatarEditOverride = true;
                state.identity.focus = 0;
                if (state.identity.avatarAssetsReady) {
                    state.identity.phase = IdentityClientPhase::AvatarEditing;
                    showIdentityPage(state, ScreenPage::AvatarSetup, 0);
                } else {
                    state.identity.phase = IdentityClientPhase::AvatarLoading;
                    showIdentityPage(state, ScreenPage::AvatarLoading, 0);
                }
                touchRevision(state);
            }
            return;
        case ScreenPage::NameHandwriting:
            if (focus == 0) {
                state.identity.handwritingDeleteRequested = true;
                state.identity.handwritingDoneRequested = false;
            } else {
                // The LVGL owner must finish/cancel the current ink first.
                state.identity.handwritingDoneRequested = true;
            }
            touchRevision(state);
            return;
        case ScreenPage::TagPairing:
            appRequestTagPair(state, focus == 0 ? TransportTagPairOperation::Retry
                                               : TransportTagPairOperation::Cancel, nowMs);
            return;
        case ScreenPage::GameOver:
        case ScreenPage::Spectator:
        case ScreenPage::WaitingForGame:
            return;
        case ScreenPage::PlayerReady:
            return;
    }
}

void beginPress(AppState &state, uint32_t nowMs)
{
    state.buttonHeld = true;
    state.buttonDownMs = nowMs;
    state.holdActionConsumed = false;
    if (state.modal.kind != ModalKind::None && !state.modal.submitting &&
        (state.modal.focus == ModalFocus::Confirm ||
         state.modal.focus == ModalFocus::ResolveAssets)) {
        state.modal.holding = true;
        state.modal.holdStartMs = nowMs;
    }
}

void endPress(AppState &state, uint32_t nowMs)
{
    if (!state.buttonHeld) return;
    const uint32_t heldMs = nowMs - state.buttonDownMs;
    bool consumed = state.holdActionConsumed;
    state.buttonHeld = false;
    if (state.modal.kind != ModalKind::None) {
        const bool canSubmit = state.modal.holding && !state.modal.submitting &&
            (state.modal.focus == ModalFocus::Confirm ||
             state.modal.focus == ModalFocus::ResolveAssets);
        if (!consumed && canSubmit && heldMs >= kConfirmHoldMs) {
            state.holdActionConsumed = true;
            consumed = true;
            submitModal(state, nowMs);
        }
        state.modal.holding = false;
        if (!consumed && heldMs <= kShortPressMaxMs && state.modal.cancelAllowed &&
            state.modal.focus == ModalFocus::Cancel) {
            dismissModal(state);
        }
        return;
    }
    if (consumed) return;
    if (heldMs <= kShortPressMaxMs) activate(state, nowMs);
    else if (heldMs >= kBackPressMs && heldMs < kHomePressMs && isOrdinaryPage(state.nav.current.page)) back(state);
}

void moveFocus(AppState &state, int16_t delta)
{
    if (state.tradeReceiverPickerOpen) {
        const uint8_t count = tradeReceiverCandidateCount(state);
        if (count == 0 || delta == 0) return;
        const uint8_t focusCount = static_cast<uint8_t>(count + 1);
        int32_t next = static_cast<int32_t>(state.tradeReceiverPickerIndex) + delta;
        while (next < 0) next += focusCount;
        next %= focusCount;
        state.tradeReceiverPickerIndex = static_cast<uint8_t>(next);
        touchRevision(state);
        return;
    }
    if (state.modal.kind != ModalKind::None) {
        if (delta != 0 && state.modal.cancelAllowed && !state.modal.submitting) {
            state.modal.focus = state.modal.focus == ModalFocus::Confirm ? ModalFocus::Cancel : ModalFocus::Confirm;
            touchRevision(state);
        }
        return;
    }
    if (state.nav.current.page == ScreenPage::AvatarSetup &&
        state.identity.editingValue) {
        applyIdentityDraftDelta(state, delta);
        return;
    }
    if (state.nav.current.page == ScreenPage::Build &&
        state.inlineEditField == InlineEditField::BuildProperty) {
        if (!appBuildContextCurrent(state)) return;
        const uint8_t count = appBuildGroupCount(state);
        if (count == 0) return;
        int32_t index = 0;
        while (index < count && appBuildGroupAssetAt(state, index) != state.selectedAsset) ++index;
        index = (index + delta) % count;
        if (index < 0) index += count;
        state.selectedAsset = appBuildGroupAssetAt(state, index);
        touchRevision(state);
        return;
    }
    if (state.nav.current.page == ScreenPage::Trade &&
        state.inlineEditField != InlineEditField::None) {
        if (delta == 0) return;
        if (state.inlineEditField == InlineEditField::TradeReceiver) {
            if (appTradeReceiverLocked(state)) return;
            const int32_t direction = delta < 0 ? -1 : 1;
            int32_t receiver = state.tradeReceiver;
            for (int16_t step = 0; step < std::abs(delta); ++step) {
                do {
                    receiver += direction;
                    receiver %= state.playerCount;
                    if (receiver < 0) receiver += state.playerCount;
                } while (state.playerCount > 1 &&
                         receiver == static_cast<int32_t>(state.selfSeatId - 1));
            }
            state.tradeReceiver = static_cast<uint8_t>(receiver);
        } else if (state.inlineEditField == InlineEditField::TradeAmount) {
            int64_t amount = static_cast<int64_t>(state.tradeAmount) +
                             static_cast<int64_t>(delta) * 50;
            if (amount < 0) amount = 0;
            if (amount > state.money) amount = state.money;
            state.tradeAmount = static_cast<int32_t>(amount);
        }
        touchRevision(state);
        return;
    }
    const uint8_t count = appFocusCount(state);
    if (count == 0 || delta == 0 || !isInteractiveListPage(state.nav.current.page)) return;

    if (state.nav.current.page == ScreenPage::AssetDetail) {
        const int16_t direction = delta < 0 ? -1 : 1;
        int16_t next = state.nav.current.focus;
        for (int16_t step = 0; step < std::abs(delta); ++step) {
            do {
                next += direction;
            } while (next >= 0 && next < 4 &&
                     !appAssetDetailActionVisible(
                         state, appAssetDetailActionAt(state, static_cast<uint8_t>(next))));
            if (next < 0 || next >= count) {
                pulseListBoundary(state, delta);
                return;
            }
        }
        setFocus(state, static_cast<uint8_t>(next));
        return;
    }

    const int32_t requested = static_cast<int32_t>(state.nav.current.focus) + delta;
    int32_t next = requested;
    if (state.nav.current.page == ScreenPage::Home) {
        while (next < 0) next += count;
        next %= count;
    } else {
        if (next < 0) next = 0;
        if (next >= count) next = count - 1;
        if (next == state.nav.current.focus && next != requested) {
            pulseListBoundary(state, delta);
            return;
        }
    }
    setFocus(state, static_cast<uint8_t>(next));
}

void selectListItem(AppState &state, int16_t item, uint32_t nowMs)
{
    if (!isInteractiveListPage(state.nav.current.page) || state.nav.current.page == ScreenPage::Home) return;
    const uint8_t content = appPageContentCount(state);
    if (item < 0 || item >= content) return;
    if ((state.nav.current.page == ScreenPage::Trade || state.nav.current.page == ScreenPage::Build) &&
        state.inlineEditField != InlineEditField::None &&
        state.nav.current.focus != static_cast<uint8_t>(item)) {
        clearInlineEditing(state);
        setFocus(state, static_cast<uint8_t>(item));
        return;
    }
    if (state.nav.current.focus == static_cast<uint8_t>(item)) activate(state, nowMs);
    else setFocus(state, static_cast<uint8_t>(item));
}

void selectFooter(AppState &state, uint32_t nowMs)
{
    if (state.nav.current.page == ScreenPage::Home ||
        !isInteractiveListPage(state.nav.current.page)) return;
    const uint8_t footerFocus = contentCount(state, state.nav.current.page);
    if (state.nav.current.focus != footerFocus) {
        clearInlineEditing(state);
        setFocus(state, footerFocus);
        return;
    }
    activate(state, nowMs);
}

uint8_t turnsBeforeSelf(const TransportEvent &event)
{
    if (event.selfSeatId == 0 || event.activePlayerId == 0 ||
        event.playerCount == 0 || event.activePlayerId == event.selfSeatId) return 0;
    uint8_t turns = 0;
    uint8_t seat = event.activePlayerId;
    for (uint8_t checked = 0; checked < event.playerCount; ++checked) {
        if (seat == event.selfSeatId) break;
        bool bankrupt = false;
        for (uint8_t index = 0; index < event.playerCount; ++index) {
            if (event.players[index].playerId == seat) {
                bankrupt = (event.players[index].flags & 0x02u) != 0;
                break;
            }
        }
        if (!bankrupt) ++turns;
        seat = static_cast<uint8_t>(seat % event.playerCount + 1);
    }
    return turns;
}

void presentDebtAuthorityState(AppState &state, uint32_t nowMs)
{
    state.rollAnimating = false;
    state.debt.amountDue = state.debtAmount;
    state.debt.cashBefore = state.money;
    const uint8_t assetCount = state.fullAuthoritySnapshotValid
        ? state.authorityAssetCount : kAssetCount;
    state.debt.eligibleMask = (state.availableActions & kActionMortgage) != 0
        ? (assetCount >= 32 ? 0xFFFFFFFFu : ((1u << assetCount) - 1u)) : 0;
    state.debt.selectedMask &= legalDebtAssetMask(state);
    if ((state.availableActions & kActionPayDebt) != 0) {
        if (state.modal.kind == ModalKind::None) {
            const bool holdRelease = releaseHoldDebt(state);
            const char *title = holdRelease ? "RELEASE FEE" : "PAYMENT REQUIRED";
            const char *counterparty = state.debtCreditorId == 0
                ? "CITY BANK" : appPlayerNameById(state, state.debtCreditorId);
            const char *purpose = "SETTLE DEBT";
            if (holdRelease) purpose = "RELEASE FROM HOLD";
            else if (state.debtPaymentEvent == kDebtPaymentRent) purpose = "PAY RENT";
            else if (state.debtPaymentEvent == kDebtPaymentFee) purpose = "CITY FEE";
            else if (state.debtPaymentEvent == kDebtPaymentCard) purpose = "CARD PAYMENT";
            showModal(state, ModalKind::ForcedPayment, false, title, counterparty,
                      purpose, state.debtAmount, state.stateVersion, 0);
        }
        return;
    }
    if ((state.modal.kind == ModalKind::DebtSellBuildingConfirm ||
         state.modal.kind == ModalKind::SellBuildingGroupConfirm) &&
        state.modal.submitting) return;
    // Keep the debt asset's explicit single/group choices open during heartbeat
    // projections. Its Back button still returns to the forced debt list.
    if (state.nav.current.page == ScreenPage::AssetDetail && state.nav.depth != 0 &&
        state.nav.stack[state.nav.depth - 1].page == ScreenPage::DebtAssets) return;
    if ((state.availableActions & kActionDeclareBankruptcy) != 0) {
        if (state.nav.current.page != ScreenPage::Bankruptcy) {
            replaceForcedPage(state, ScreenPage::Bankruptcy);
        }
    } else if (state.nav.current.page != ScreenPage::DebtAssets) {
        replaceForcedPage(state, ScreenPage::DebtAssets);
    }
}

void clearRollFlow(AppState &state)
{
    state.rollAnimating = false;
    state.rollResolved = false;
    state.rollRevealPresented = false;
    state.rollPresentationComplete = false;
    state.rollFailed = false;
    state.rollRevealMs = 0;
    state.rollFailedUntilMs = 0;
    state.arrivalContinueAtMs = 0;
    state.moveArrivalPending = false;
    state.moveArrivalConfirmed = false;
    clearCardPresentationState(state);
}

void setCardResult(AppState &state, uint8_t deckId, uint8_t cardIndex,
                   uint8_t flags, uint16_t instanceId, uint16_t catalogId,
                   uint16_t effectId, int32_t amount, uint8_t targetPlayerId,
                   uint8_t targetPosition, uint32_t eventSequence)
{
    state.cardChance = deckId == 1;
    state.cardIndex = cardIndex;
    state.cardFlags = flags;
    state.cardInstanceId = instanceId;
    state.cardCatalogId = catalogId;
    state.cardEffectId = effectId;
    state.cardAmount = amount;
    state.cardTargetPlayerId = targetPlayerId;
    state.cardTargetPosition = targetPosition;
    state.cardEventSequence = eventSequence;
    state.cardResultValid = instanceId != 0 && deckId >= 1 && deckId <= 2 && cardIndex < 8;
}

void beginCardPresentation(AppState &state, uint32_t nowMs, bool restoreWithoutAnimation)
{
    if (!state.cardResultValid) return;
    state.cardPresentationAcknowledged = false;
    state.cardEffectApplied = false;
    state.cardStartedMs = nowMs;
    if (restoreWithoutAnimation) {
        state.cardPresentation = CardPresentationPhase::Revealed;
        state.cardRevealAtMs = 0;
    } else {
        state.cardPresentation = CardPresentationPhase::Drawing;
        state.cardRevealAtMs = nowMs + kCardDrawMinMs;
    }
    replaceForcedPage(state, ScreenPage::CardReveal);
}

void applyPendingCardProjection(AppState &state, const TransportEvent &event, uint32_t nowMs)
{
    const bool ownPendingCard = (event.pendingCardFlags & 0x01u) != 0 &&
        event.pendingCardPlayerId == state.selfSeatId;
    if (!ownPendingCard) {
        state.pendingCardFlags = event.pendingCardFlags;
        return;
    }

    const bool completedCard = cardDrawKeyMatches(
        event.pendingCardInstanceId, event.pendingCardDrawEventSequence,
        state.completedCardInstanceId, state.completedCardDrawEventSequence);
    if (completedCard) return;
    state.pendingCardFlags = event.pendingCardFlags;

    const bool seenCard = cardDrawKeyMatches(
        event.pendingCardInstanceId, event.pendingCardDrawEventSequence,
        state.seenCardInstanceId, state.seenCardDrawEventSequence);
    const bool sameInstance = state.cardResultValid &&
        state.cardInstanceId == event.pendingCardInstanceId;
    setCardResult(state, event.pendingCardDeckId, event.pendingCardIndex,
                  event.resync ? gridopoly::protocol::PlayerCardFlagReplay : 0,
                  event.pendingCardInstanceId, event.pendingCardCatalogId,
                  event.pendingCardEffectId, event.pendingCardDisplayAmount,
                   event.pendingCardTargetPlayerId, event.pendingCardTargetPosition,
                   event.pendingCardDrawEventSequence);
    if (!seenCard) {
        state.seenCardInstanceId = event.pendingCardInstanceId;
        state.seenCardDrawEventSequence = event.pendingCardDrawEventSequence;
    }

    const bool settlement = (event.pendingCardFlags & 0x0Fu) == 0x0Fu;
    if (settlement) {
        state.cardPresentationAcknowledged = true;
        state.cardPresentation = CardPresentationPhase::Settling;
        state.cardRevealAtMs = 0;
        if (event.resync || state.nav.current.page == ScreenPage::CardReveal) {
            replaceForcedPage(state, ScreenPage::CardReveal);
        }
        return;
    }

    const bool arrivalCheckpointVisible = state.nav.current.page == ScreenPage::DiceStage ||
                                          state.nav.current.page == ScreenPage::MoveGuide;
    if (event.resync) {
        beginCardPresentation(state, nowMs, true);
    } else if (!seenCard && !sameInstance && !arrivalCheckpointVisible &&
               state.authorityPhase == AuthorityPhase::AwaitCard) {
        beginCardPresentation(state, nowMs, false);
    }
}

void applyPlayerCardPresentation(AppState &state, const TransportEvent &event, uint32_t nowMs)
{
    if (event.cardInstanceId == 0) return;
    if (event.kind == TransportEventKind::PlayerCardEffectApplied &&
        event.cardPlayerId != state.selfSeatId) return;
    const bool sameInstance = state.cardResultValid &&
                              state.cardInstanceId == event.cardInstanceId;
    if (event.kind == TransportEventKind::PlayerCardEffectApplied) {
        if (event.cardInstanceId == state.completedCardInstanceId) return;
        const bool knownInstance = sameInstance ||
            event.cardInstanceId == state.seenCardInstanceId;
        if (!knownInstance) return;
    } else {
        const bool completedCard = cardDrawKeyMatches(
            event.cardInstanceId, event.cardEventSequence,
            state.completedCardInstanceId, state.completedCardDrawEventSequence);
        const bool duplicateDraw = cardDrawKeyMatches(
            event.cardInstanceId, event.cardEventSequence,
            state.seenCardInstanceId, state.seenCardDrawEventSequence);
        if (completedCard || duplicateDraw) return;
    }
    if (sameInstance && event.cardEventSequence < state.cardEventSequence) return;
    setCardResult(state, event.cardDeckId, event.cardIndex, event.cardFlags,
                  event.cardInstanceId, event.cardCatalogId, event.cardEffectId,
                  event.cardAmount, event.cardTargetPlayerId,
                  event.cardTargetPosition, event.cardEventSequence);

    if (event.kind == TransportEventKind::PlayerCardEffectApplied) {
        state.completedCardInstanceId = event.cardInstanceId;
        state.completedCardDrawEventSequence = state.seenCardDrawEventSequence;
        state.cardOutcome = event.cardOutcome;
        state.cardEffectApplied = true;
        state.pendingCardFlags = 0;
        clearPendingKind(state, TransportCommandKind::CardContinueRequest);
        if (state.nav.current.page == ScreenPage::CardReveal) {
            state.cardPresentation = CardPresentationPhase::Settling;
        }
        touchRevision(state);
        return;
    }

    state.seenCardInstanceId = event.cardInstanceId;
    state.seenCardDrawEventSequence = event.cardEventSequence;
    state.pendingCardFlags = 0x03u;
    state.cardOutcome = 0;
    if (event.resync) {
        // Authority v3 follows this private replay and decides Revealed versus Settling.
        touchRevision(state);
        return;
    }
    const bool replay = event.resync ||
                        (event.cardFlags & gridopoly::protocol::PlayerCardFlagReplay) != 0;
    if (replay) {
        if (state.cardPresentation != CardPresentationPhase::Settling) {
            beginCardPresentation(state, nowMs, true);
        }
    } else if (state.cardPresentation == CardPresentationPhase::Drawing) {
        const uint32_t minimumReveal = state.cardStartedMs + kCardDrawMinMs;
        state.cardRevealAtMs = hasReachedDeadline(nowMs, minimumReveal)
            ? nowMs + kCardResultSettleMs : minimumReveal;
    } else if (state.nav.current.page != ScreenPage::DiceStage &&
               state.nav.current.page != ScreenPage::MoveGuide) {
        beginCardPresentation(state, nowMs, false);
    }
    touchRevision(state);
}

bool landingPaymentEventNeeded(const AppState &state)
{
    if (state.landingEventAcknowledged || !state.moveArrivalConfirmed ||
        state.decisionPlayerId != state.selfSeatId ||
        state.authorityPhase != AuthorityPhase::AwaitDebt || releaseHoldDebt(state) ||
        state.debtPaymentEvent == kDebtPaymentCard) {
        return false;
    }
    if (state.debtPaymentEvent == kDebtPaymentRent ||
        state.debtPaymentEvent == kDebtPaymentFee) {
        return true;
    }
    const ArrivalKind arrival = appArrivalKind(state);
    if (arrival == ArrivalKind::Fee) return true;
    if (arrival != ArrivalKind::Asset) return false;
    const uint8_t ownerId = appArrivalOwnerId(state);
    return ownerId != 0 && ownerId != state.selfSeatId;
}

void presentPostArrivalState(AppState &state, uint32_t nowMs)
{
    const ArrivalKind arrival = appArrivalKind(state);
    const bool cardArrival = arrival == ArrivalKind::CityEvent ||
                             arrival == ArrivalKind::CivicFund;
    if (cardArrival && !state.cardPresentationAcknowledged) {
        if (state.cardPresentation == CardPresentationPhase::None) {
            state.cardPresentation = CardPresentationPhase::Drawing;
            state.cardStartedMs = nowMs;
            state.cardRevealAtMs = state.cardResultValid ? nowMs + kCardDrawMinMs : 0;
            if (!state.cardResultValid) state.cardChance = arrival == ArrivalKind::CityEvent;
        }
        replaceForcedPage(state, ScreenPage::CardReveal);
        return;
    }
    const bool ownTurn = state.activePlayerId == state.selfSeatId;
    const bool ownDecision = state.decisionPlayerId == state.selfSeatId;
    if (landingPaymentEventNeeded(state)) {
        replaceForcedPage(state, ScreenPage::TileEvent);
        return;
    }
    clearRollFlow(state);
    if (ownTurn && state.authorityPhase == AuthorityPhase::AwaitPurchase) {
        replaceForcedPage(state, ScreenPage::Purchase);
    } else if (state.authorityPhase == AuthorityPhase::AwaitAuction) {
        replaceForcedPage(state, ScreenPage::Auction);
    } else if (ownDecision && state.authorityPhase == AuthorityPhase::AwaitDebt) {
        presentDebtAuthorityState(state, nowMs);
    } else if (ownTurn && state.authorityPhase == AuthorityPhase::AwaitMoveConfirm) {
        state.moveArrivalPending = true;
        state.moveArrivalConfirmed = false;
        replaceForcedPage(state, ScreenPage::MoveGuide);
    } else {
        resetHome(state, 0);
    }
}

void finishDicePresentation(AppState &state, uint32_t nowMs)
{
    state.rollAnimating = false;
    if (releaseHoldDebt(state)) {
        state.rollPresentationComplete = true;
        presentDebtAuthorityState(state, nowMs);
        return;
    }
    if (state.moveArrivalPending && state.rollTarget != 0xFF) {
        replaceForcedPage(state, ScreenPage::MoveGuide);
        if (state.moveArrivalConfirmed) {
            state.arrivalContinueAtMs = nowMs + kArrivalConfirmedHoldMs;
        }
    } else {
        presentPostArrivalState(state, nowMs);
    }
}

void beginAuctionIntro(AppState &state, uint32_t nowMs)
{
    state.auctionPresentation = AuctionPresentationPhase::Intro;
    state.auctionPresentationUntilMs = nowMs + kAuctionIntroMs;
    state.auctionResultAssetIndex = 0xFF;
    state.auctionWinnerPlayerId = 0;
    state.auctionResultAmount = 0;
    state.auctionPassed = false;
    state.auctionReadyAttemptGeneration = 0;
    state.auctionReadyAttemptAssetIndex = 0xFF;
}
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
