Ha22yX/Gridopoly/Firmware/PlayerConsole/battery_hardware.h

#pragma once
#include "battery_board_config.h"
#include "battery_telemetry.h"

void batteryHardwareBegin(uint32_t nowMs);
void batteryHardwareTick(uint32_t nowMs);
// Main-task diagnostics only: no worker/UART/gauge reinitialization or evidence reset.
bool batteryHardwareTraceStart(uint32_t nowMs);
void batteryHardwareTraceStop();
gridopoly::player_console::BatteryStatus batteryHardwareStatus(uint32_t nowMs);
