Ha22yX/Gridopoly/Firmware/PlayerConsole/transport_types.h

#pragma once

#include <stdint.h>
#include "avatar_catalog_config.h"
#include "tag_pair_types.h"

enum class TransportCommandKind : uint8_t {
    RollRequest,
    PayNow,
    ClaimRent,
    TradeQuery,
    TradeCreate,
    TradeUpdate,
    TradeConfirm,
    TradeReject,
    TradeCancel,
    MortgageBatchRequest,
    MoveManualConfirmRequest,
    BuyRequest,
    DeclinePurchaseRequest,
    EndTurnRequest,
    UnmortgageRequest,
    BuildRequest,
    SellBuildingRequest,
    DeclareBankruptcyRequest,
    AuctionBidRequest,
    AuctionPassRequest,
    AuctionReadyRequest,
    PlayerDetailRequest,
    CardContinueRequest,
    IdentityRequest,
    MovementCueReadyRequest,
    TagPairRequest,
};

enum class TransportEventKind : uint8_t {
    None,
    ConnectionLost,
    StateSnapshotApplied,
    AuthoritySnapshotApplied,
    RosterSnapshotApplied,
    GameEventReceived,
    RollResult,
    MoveGuidanceStarted,
    RfidPositionConfirmed,
    RfidPositionRejected,
    PaymentRequired,
    PaymentCompleted,
    DebtResolutionRequired,
    MortgageBatchCompleted,
    BankruptcyResolved,
    CommandCompleted,
    CommandRejected,
    PlayerDetailReceived,
    PlayerCardDrawn,
    PlayerCardEffectApplied,
    TradeResponseReceived,
    IdentitySnapshotReceived,
    MovementCueRetryRequested, // Local recovery event; does not alter the wire.
    TagPairSnapshotReceived,
    JoinStatusChanged, // Local authenticated admission status; no wire change.
};

enum class TransportJoinStatus : uint8_t {
    Inactive,
    Connecting,
    WaitingForNewGame,
    Syncing,
};

inline bool transportEventAdvancesAppliedStateVersion(
    TransportEventKind kind, bool identitySetupActive)
{
    if (kind == TransportEventKind::IdentitySnapshotReceived) return true;
    return !identitySetupActive &&
           kind == TransportEventKind::AuthoritySnapshotApplied;
}

enum class TransportIdentityOperation : uint8_t {
    Query = 1,
    ConfirmAvatar = 2,
    ConfirmName = 3,
};

inline bool identitySnapshotCompletesPendingOperation(
    TransportIdentityOperation operation, uint8_t selfPlayerId,
    uint8_t avatarReadyMask, uint8_t nameReadyMask)
{
    if (selfPlayerId == 0 || selfPlayerId > 6) return false;
    const uint8_t selfBit = static_cast<uint8_t>(1u << (selfPlayerId - 1u));
    if (operation == TransportIdentityOperation::ConfirmAvatar) {
        return (avatarReadyMask & selfBit) != 0;
    }
    if (operation == TransportIdentityOperation::ConfirmName) {
        return (nameReadyMask & selfBit) != 0;
    }
    return false;
}

enum class TransportIdentityPhase : uint8_t {
    Inactive = 0,
    AwaitAvatar = 1,
    GeneratingAvatar = 2,
    AwaitName = 3,
    Ready = 4,
    Countdown = 5,
    Active = 6,
    TagPairing = 7,
};

enum class TransportIdentityResult : uint8_t {
    Ok = 0,
    InvalidRequest = 1,
    Unauthorized = 2,
    StateVersionStale = 3,
    SeatRevisionStale = 4,
    CatalogMismatch = 5,
    InvalidRecipe = 6,
    InvalidName = 7,
    DuplicateName = 8,
    NotAllowed = 9,
    RequestIdConflict = 10,
    AvatarGenerationFailed = 11,
};

struct TransportAvatarRecipe {
    uint16_t catalogVersion = kAvatarDefaultCatalogVersion;
    uint8_t hairPresetId = 1;
    uint8_t hairColorId = 1;
    uint8_t facePresetId = 1;
    uint8_t skinToneId = 1;
    uint8_t outfitPresetId = 1;
};

inline TransportAvatarRecipe normalizedTransportAvatarRecipe(
    const TransportAvatarRecipe &source)
{
    TransportAvatarRecipe normalized = source;
    if (!avatarCatalogSupported(normalized.catalogVersion)) {
        normalized.catalogVersion = kAvatarDefaultCatalogVersion;
    }
    if (normalized.hairPresetId < 1 || normalized.hairPresetId > 10) {
        normalized.hairPresetId = 1;
    }
    if (normalized.hairColorId < 1 || normalized.hairColorId > 20) {
        normalized.hairColorId = 1;
    }
    if (normalized.facePresetId < 1 || normalized.facePresetId > 10) {
        normalized.facePresetId = 1;
    }
    if (normalized.skinToneId < 1 || normalized.skinToneId > 8) {
        normalized.skinToneId = 1;
    }
    if (normalized.outfitPresetId < 1 || normalized.outfitPresetId > 10) {
        normalized.outfitPresetId = 1;
    }
    return normalized;
}

struct TransportIdentitySeat {
    uint16_t seatRevision = 0;
    uint16_t avatarRevision = 0;
    uint64_t avatarCacheTag = 0;
    TransportAvatarRecipe recipe{};
    uint8_t playerId = 0;
    uint8_t flags = 0;
    uint8_t colorIndex = 0;
    char name[17]{};
};

struct TransportIdentityPayload {
    TransportIdentitySeat seats[6]{};
};

enum class TransportError : uint8_t {
    None,
    InsufficientCash,
    AssetChanged,
    StaleState,
    ActionNotAllowed,
};

enum class TransportTradeOperation : uint8_t {
    Query = 1,
    Create = 2,
    Update = 3,
    Confirm = 4,
    Reject = 5,
    Cancel = 6,
};

enum class TransportTradeStatus : uint8_t {
    None = 0,
    Offered = 1,
    Countered = 2,
    Settled = 3,
    Rejected = 4,
    Cancelled = 5,
    Expired = 6,
    Invalidated = 7,
};

enum class TransportTradeResult : uint8_t {
    Ok = 0,
    NoActiveTrade = 1,
    InvalidRequest = 2,
    Unauthorized = 3,
    StateVersionStale = 4,
    RevisionStale = 5,
    ParticipantBusy = 6,
    RuleViolation = 7,
    NotEnoughCash = 8,
    AssetUnavailable = 9,
    Expired = 10,
    RequestIdConflict = 11,
};

enum class AuthorityPhase : uint8_t {
    Lobby = 0,
    AwaitRoll = 1,
    AwaitMoveConfirm = 2,
    AwaitPurchase = 3,
    AwaitAuction = 4,
    AwaitDebt = 5,
    TurnEnd = 6,
    GameOver = 7,
    AwaitCard = 8,
};

struct AuthorityPlayerSummary {
    uint8_t playerId = 0;
    uint8_t position = 0;
    int32_t cash = 0;
    uint8_t flags = 0;
    uint8_t failedHoldRolls = 0;
    uint8_t doublesStreak = 0;
};

struct AuthorityAssetSummary {
    uint8_t ownerId = 0;
    uint8_t buildingLevel = 0;
    uint8_t flags = 0;
};

struct TransportGameEvent {
    uint32_t sequence = 0;
    uint8_t kind = 0;
    uint8_t actorId = 0;
    uint8_t targetId = 0;
    uint8_t assetIndex = 0xFF;
    int32_t amount = 0;
    uint32_t detail = 0;
};

constexpr uint8_t kPlayerDetailAssetCapacity = 28;
constexpr uint8_t kPlayerFinanceCapacity = 10;

struct TransportPlayerAsset {
    uint8_t assetIndex = 0xFF;
    uint8_t state = 0;  // bits0-2 building level, bit3 mortgaged.
};

struct TransportFinancialRecord {
    uint32_t sequence = 0;
    int32_t amount = 0;  // Signed from the requested player's perspective.
    uint8_t kind = 0;
    uint8_t counterpartyId = 0;
    uint8_t assetIndex = 0xFF;
    uint8_t flags = 0;
};

struct TransportPlayerDetailPayload {
    TransportPlayerAsset assets[kPlayerDetailAssetCapacity]{};
    TransportFinancialRecord financialRecords[kPlayerFinanceCapacity]{};
};

struct TransportCommand {
    TransportCommandKind kind{};
    uint32_t requestId = 0;
    uint32_t stateVersion = 0;
    uint32_t transactionId = 0;
    uint32_t clientTimeMs = 0;
    uint32_t assetMask = 0;
    uint32_t counterpartyAssetMask = 0;
    int32_t argument = 0;
    int32_t counterpartyArgument = 0;
    uint32_t tradeId = 0;
    uint16_t tradeRevision = 0;
    TransportTradeOperation tradeOperation = TransportTradeOperation::Query;
    TransportIdentityOperation identityOperation = TransportIdentityOperation::Query;
    uint32_t identitySeatRevision = 0;
    TransportAvatarRecipe avatarRecipe{};
    char identityName[17]{};
    uint8_t assetIndex = 0xFF;
    uint8_t targetPosition = 0;
    uint8_t targetPlayerId = 0;
    // Append local metadata so existing aggregate command initializers stay valid.
    uint32_t roomId = 0; // Not an additional wire field.
    TransportTagPairOperation tagPairOperation = TransportTagPairOperation::Query;
    uint32_t tagPairSessionId = 0;
    uint32_t tagPairRevision = 0;
};
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
