Ha22yX/Gridopoly/(commit log)

2026-07-26 docs: add ESP32-S3 minimum system design
2026-07-29 docs: update current hardware pin map
2026-07-30 hardware: save current EasyEDA board revision
2026-08-02 chore: track player console firmware baseline
2026-08-06 docs: specify web board owner badges
2026-08-11 feat: integrate authority server and player console
    [partitions.csv]
2026-09-08 checkpoint(tile): preserve V0.27 firmware and hardware test sources
    Preserve previously untracked firmware, embedded artwork and hardware test sources. Reconstruct the pre-V0.28 four-file baseline from the reviewed change patch in the index only; retain the current verified working tree. Exclude build caches and local credentials.
2026-09-08 fix(tile): retry pending tag reports after cache contention
    Keep the latest complete tag report pending until the network cache accepts it. Cover lock failure and unchanged inventories with host regressions. Native 37 checks and formal ESP32 build passed; COM6 upload verified. Physical tag and cross-device movement acceptance remain pending.
    [extract_fixture.py, firmware_boundaries.cpp, main.cpp, tile_network.cpp, tile_network.h]
2026-09-08 checkpoint(player): preserve Action17 candidate and pending UI work
    Save the reviewed integrated source snapshot, including pre-existing avatar, handwriting and rotary changes, with movement cue recovery and frame presentation tests. Native 26 cases, static checks and three firmware builds pass. Full device SelfTest, frame performance and end-to-end arrival acceptance remain pending; COM7 runs the restored original production firmware.
2026-09-08 docs(tile): record joint capture prerequisites and remaining blockers
2026-09-08 fix(player): keep Wi-Fi stack alive during reconnect
    Remove the STA channel preference and replace full Wi-Fi shutdown with rate-limited reconnect requests. Add bounded event diagnostics and device timestamps. Production build and mocked recovery boundaries pass; the candidate paired back into the existing room on COM7. Recovery after a future link loss and end-to-end movement still need device verification.
    [wifi_udp_player_transport.cpp, wifi_udp_player_transport.h]
2026-09-08 fix(tile): compose frames and submit only changed display regions
    [display_diff.cpp, display_diff.h, extract_fixture.py, firmware_boundaries.cpp, main.cpp]
2026-09-09 fix(tile): validate faster page transfer with independent safe recovery
    [board_config.h, display_diff.cpp, display_diff.h, extract_fixture.py, firmware_boundaries.cpp, main.cpp]
2026-09-09 fix(player): decode rotary Gray transitions without directional bias
    [hardware_input.cpp, hardware_input.h, logic_tests.cpp, rotary_input_filter.h, rotary_input_tests.h, test-rotary-input.cpp]
2026-09-09 fix(player): synchronize avatar previews and reduce redundant border drawing
    [PlayerConsole.ino, analyze-frame-timing.py, app_state.cpp, avatar_preview_buffers.h, lvgl_v8_port.cpp, lvgl_v8_port.h, movement_cue_app_tests.h, remote_avatar_cache.cpp]
2026-09-09 docs: record built player fixes and pending device acceptance
2026-09-09 perf(player): skip masks for opaque interior background updates
    [remote_avatar_cache.cpp, test-border-render.c]
2026-09-09 perf(player): cull rounded border corners and profile frame spikes
2026-09-09 perf(player): skip clipped mask rows and store diagnostics in PSRAM
    [PlayerConsole.ino]
2026-09-10 fix(player): keep RGB bounce refill and drawing on the same core
    [lvgl_v8_port.h]
2026-09-10 docs: record display rollback and current network verification limits
2026-09-10 feat(web): show ORDER chain placement and manual anchors
2026-09-10 feat(server): derive tile assignments from physical ORDER chains
2026-09-10 docs: record deployed ORDER protocol and two-board verification
2026-09-21 fix(pcb): convert corner module standalone pads to native vias
2026-09-21 fix(pcb): optimize corner power layout and antenna routing
2026-09-21 docs(hardware): plan USB-C PD 24V supply for 24 tiles
2026-09-21 feat(hardware): draw corner USB-C PD to 24V bus schematic
    [BOM-stock.csv]
2026-09-21 fix(hardware): review PD24 thresholds and connector rating
    [BOM-stock.csv]
2026-09-21 feat(hardware): redesign corner PD input for 0-60W load range
    [BOM-stock.csv]
2026-09-21 feat(hardware): add compact module branch hotplug protection
    [BOM-stock.csv]
2026-09-21 chore(hardware): normalize exported power design text files
    [BOM-stock.csv]
2026-09-21 docs(hardware): verify existing long-board power component identities
2026-09-21 fix(hardware): improve PD loop margin and record power integrity limits
    [BOM-stock.csv]
2026-09-21 feat(hardware): connect corner PD configuration to ESP32 I2C
    [BOM-stock.csv]
2026-09-21 docs: consolidate PCB variants, power design and firmware roadmap
2026-09-22 docs(hardware): audit direct 24V power schematics with netlist evidence
2026-09-22 docs(hardware): verify connector alignment and flag closed-ring data topology
2026-09-22 docs: align hardware handoff with direct 24V design
2026-09-26 feat(release): package verified board profiles and safely flash explicit inventories
2026-09-26 docs: track batch game candidates and remaining physical acceptance
2026-09-26 feat(server): coordinate closed boards and durable automatic player onboarding
2026-09-26 fix(player): set touch polling period through LVGL input driver
2026-09-26 docs: record rotary trace repair and verified player deployment
2026-09-27 docs(hardware): freeze player battery schematic and telemetry contract
2026-09-27 chore(hardware): preserve exact schematic evidence bytes on checkout
2026-09-27 feat(player): add opt-in battery telemetry and passive status display
2026-09-27 feat(hardware): import battery board components with reversed J2 mapping
2026-09-27 docs(player): record verified battery firmware and hardware handoff
2026-09-27 fix(hardware): correct power and reset switch internal contact wiring
2026-09-27 feat(hardware): archive routed player battery PCB manufacturing candidate
2026-09-27 fix(hardware): reduce USB layer crossings in player power PCB
2026-09-27 docs(hardware): record standard SMT assembly decision
2026-09-27 fix(hardware): align battery labels and archive player PCB RC3 audit
2026-09-28 feat(hardware): replace player battery wire pads with JST PH connector
2026-09-28 docs: refresh current project baselines, deployment records and remaining work
2026-09-28 hardware: archive RC5 battery polarity and synchronize current documentation
2026-10-05 docs(hardware): archive ordered player power board review and arrival checks
2026-10-15 docs(hardware): record unresolved battery input short on delivered boards
2026-10-15 docs(hardware): identify battery short in supplied fabrication package
2026-10-15 fix(tile): meet WS2812B V6 timing and report LED transmission failures
2026-10-15 chore(archives): version completed mechanical and PCB evidence
2026-10-15 docs(mechanical): archive modular stand for 60 mm FPC
2026-10-15 docs: reconcile display recovery and portable AP capacity plan
2026-10-15 feat(tile): add bounded RFID fault diagnostics and local UID probe
2026-10-15 fix(deploy): configure portable USB hotspot and verify startup
    Keep the existing Gridopoly SSID and subnet on the identified MT7612U adapter. Handle iw frequency output and reviewed derived regulatory domains, and restore AP services across USB rename events. Record 20-client registration, the 16-tile ring, actual Pi reboot recovery and bounded stability checks.
2026-10-15 feat(mechanical): add full16 frame and reinforce player stand mounting ears
2026-10-15 docs(mechanical): archive model inventory and illustrated assembly guide
2026-10-15 docs: reconcile all development threads and current acceptance status
2026-10-16 fix(tile): dim LED scenes and enforce output brightness ceiling
2026-10-16 fix(tile): rotate LCD 180 degrees and restore orientation at safe SPI speed
2026-10-16 Add on-demand RAM artwork for tile buildings
    Keep default tile images embedded, download verified building levels with bounded RAM and retry backoff, and limit server asset transfers. Record server deployment, first-board cache verification, and two completed tile update batches.
2026-10-16 Record V0.37 rollout and visual acceptance on all 16 tiles
    Track all four batches, restored ring assignments, RAM cache evidence, and the user-confirmed display and LED checks. Preserve transient heartbeat connection-loss observations as unresolved diagnostics.
2026-10-16 Add level-aware player artwork caching with bounded RAM
    Validate cache ownership, retry policy and CRC handling with host regressions; build frozen 16 MHz and 12 MHz candidates without flashing player devices.
2026-10-17 Add contextual home building and battery-enabled player profiles
2026-10-17 fix(player): sample battery UART independently of UI work
2026-10-17 docs: reconcile player battery rollout and handwriting investigation
2026-10-17 docs: record COM28 battery recovery after full power cycle
2026-10-17 feat(player): add curved battery icon with charge fill and status
2026-10-17 fix(player): keep curved battery terminal inside its draw bounds
2026-10-17 fix(player): debounce charging icon using fresh sample evidence
2026-10-18 docs: record three-screen battery UI rollout and warm-restart investigation
2026-10-18 docs: record battery warm restart rollout and device acceptance
2026-10-18 Add rotating meteor tile cues and record four-board rollout
2026-10-18 Document second four-board V0.39 rollout and visual acceptance
2026-10-18 Record third V0.39 tile batch with ten-LED visual acceptance
2026-10-18 Add persistent player input statistics and bounded battery trace commands
2026-10-18 Preserve sampled short rotary phases before confirming detents
2026-10-18 docs: distinguish battery register snapshots from current measurements
2026-10-18 Unify avatar artwork and improve setup controls
    Add a versioned avatar catalog with a shared neck, registered face geometry,
    front-facing outfits, explicit skin masks, and corrected hair fitting.
    Keep existing V1 recipes and deployment defaults compatible.
    Add a smaller RANDOM action below CONFIRM for local appearance previews.
    Retain name-review controls across background updates so selected buttons
    no longer replay their entry fade. Preserve handwriting and input behavior.
    Include asset tooling, cross-end checks, UI regression coverage, and updated
    documentation. Hardware rollout and physical-screen acceptance remain separate.
2026-10-18 Record four-screen avatar V2 rollout and power-cycle recovery
2026-10-19 feat(web): add persistent English and Chinese debug panel switch
2026-10-19 fix(web): show building artwork and mirror board order
